povdoigt/SP-02/PMI/repport_FinalVersion/PMI_ET2_rapport.tex

\documentclass{article}

\usepackage{graphicx}
\usepackage[a4paper, total={6.5in, 10in}, margin=2cm]{geometry}
\usepackage{tgpagella}
\usepackage[T1]{fontenc}
\usepackage[french]{babel}
\usepackage{hyphenat}
\usepackage{fancybox}
\usepackage{fancyhdr}
\usepackage{float}
\hyphenation{mate-mática recu-perar}
\usepackage{pifont}
\usepackage{tikz,tikz-3dplot}
\usepackage{listings}
\usepackage{etoolbox}
\usepackage{lmodern}
% \usepackage{array}
\usepackage[table]{xcolor}
\usepackage[utf8]{inputenc}
% \usepackage[dvipsnames]{xcolor}
\usepackage{transparent}
\usetikzlibrary{shapes.geometric}
\usetikzlibrary{shapes.symbols}
\usetikzlibrary{decorations.pathreplacing}
\usepackage{caption}
\usepackage{subcaption}
\usepackage{cprotect}
\usepackage{tabularx}
\usepackage{pdfpages}
\usepackage{lastpage}
\usepackage{titlesec}
\usepackage[colorlinks=true, linkcolor=black, citecolor=black]{hyperref}
\usepackage{dirtree}
\usepackage{wrapfig}
\usepackage{lipsum}
\usepackage{cancel}
\usepackage{chngcntr}
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
        {Ä}{{\"A}}1  {Ë}{{\"E}}1  {Ï}{{\"I}}1 {Ö}{{\"O}}1  {Ü}{{\"U}}1
        {â}{{\^a}}1  {ê}{{\^e}}1  {î}{{\^i}}1 {ô}{{\^o}}1  {û}{{\^u}}1
        {Â}{{\^A}}1  {Ê}{{\^E}}1  {Î}{{\^I}}1 {Ô}{{\^O}}1  {Û}{{\^U}}1
        {œ}{{\oe}}1  {Œ}{{\OE}}1  {æ}{{\ae}}1 {Æ}{{\AE}}1  {ß}{{\ss}}1
        {ç}{{\c c}}1 {Ç}{{\c C}}1 {ø}{{\o}}1  {Ø}{{\O}}1   {å}{{\r a}}1
        {Å}{{\r A}}1 {ã}{{\~a}}1  {õ}{{\~o}}1 {Ã}{{\~A}}1  {Õ}{{\~O}}1
        {ñ}{{\~n}}1  {Ñ}{{\~N}}1  {¿}{{?`}}1  {¡}{{!`}}1
        {°}{{\textdegree}}1 {º}{{\textordmasculine}}1 {ª}{{\textordfeminine}}1
        % {0}{{{\color{F}0}}}1
        % {1}{{{\color{F}1}}}1 {2}{{{\color{F}2}}}1 {3}{{{\color{F}3}}}1
        % {4}{{{\color{F}4}}}1 {5}{{{\color{F}5}}}1 {6}{{{\color{F}6}}}1
        % {7}{{{\color{F}7}}}1 {8}{{{\color{F}8}}}1 {9}{{{\color{F}9}}}1
        {=}{{{\color{A}$=$}}}1
        {==}{{{\color{A}$=\joinrel=$}}}1
        {<=}{{{\color{A}$\leq$}}}1
        {>=}{{{\color{A}$\geq$}}}1
        {!=}{{{\color{A}$\neq$}}}1
        {:=}{{{\color{A}:=}}}1
    }
}

\newtcbox{\mybox}[1][black]{
    on line, 
    arc=0pt, 
    outer arc=0pt, 
    colback=white,
    colframe=#1,
    boxsep=0pt, left=2pt, right=2pt, top=2pt, bottom=2pt, boxrule=2pt
}

% glossary
\makenoidxglossaries

\input{glossary.tex}

% \addbibresource{biblio.bib}

\titleclass{\subsubsubsection}{straight}[\subsection]

\newcounter{subsubsubsection}[subsubsection]
\renewcommand\thesubsubsubsection{\thesubsubsection.\arabic{subsubsubsection}}
\renewcommand\theparagraph{\thesubsubsubsection.\arabic{paragraph}} % optional; useful if paragraphs are to be numbered

\titleformat{\subsubsubsection}
  {\normalfont\normalsize\bfseries}{\thesubsubsubsection}{1em}{}
\titlespacing*{\subsubsubsection}
{0pt}{3.25ex plus 1ex minus .2ex}{1.5ex plus .2ex}

\title{
    \huge \textbf{ET2} : Perspective d'expérience d'un système de séparation d'étages de fusée par
    aérofreinage \\ \vspace{0.2cm}
    \large Projet \textbf{SP-02}, fusée bi-étage, AéroIPSA 2025-2026 \\
}

\makeatletter
\newcommand\footnoteref[1]{\protected@xdef\@thefnmark{\ref{#1}}\@footnotemark}
\def\toclevel@subsubsubsection{4}
\def\l@subsubsubsection{\@dottedtocline{4}{7em}{4em}}
\def\@maketitle{
    \begin{center}
    \begin{tabular}{>{\raggedright\arraybackslash}m{0.5\textwidth}
        >{\raggedleft\arraybackslash}m{0.5\textwidth}}
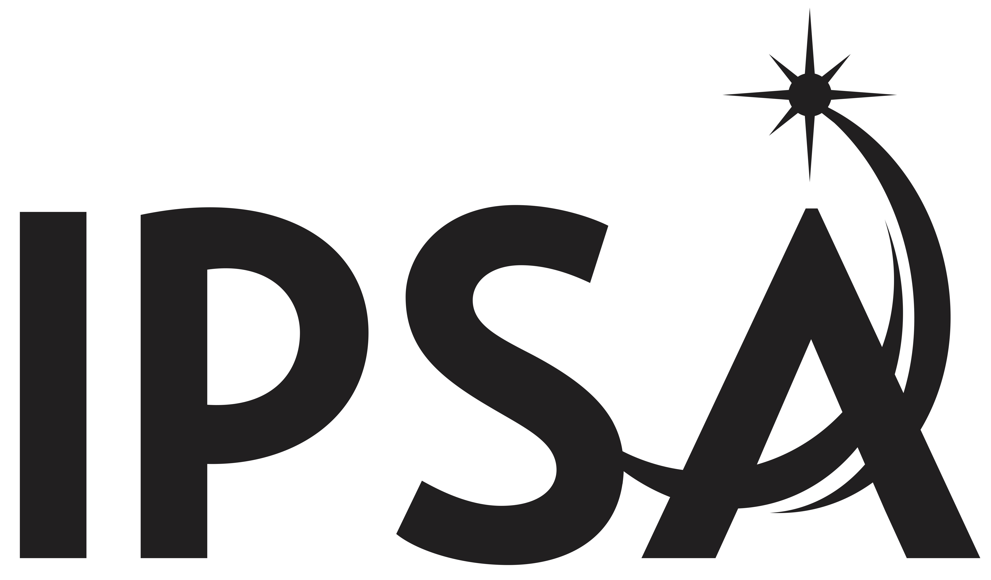
[picture p1: PMI/repport_FinalVersion/figures/IPSA_LOGO_SS-BASELINE-2021_NOIR.png]
        \vspace{-2cm} &
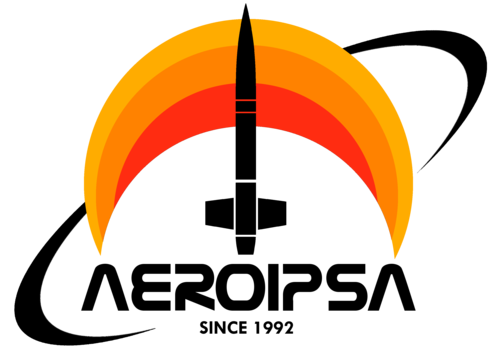
[picture p2: PMI/repport_FinalVersion/figures/AEROIPSA.png]
        \vspace{-2cm}
    \end{tabular}
    \begin{tabular}{m{0.6\textwidth}>{\raggedleft\arraybackslash}m{0.4\textwidth}}
        \acrlong{IPSA} & AéroIPSA \\
        63 bvd de Brandbourg & 63 bvd de Brandbourg \\
        94200 Ivry-sur-Seine & 94200 Ivry-sur-Seine
    \end{tabular}
    \end{center}
    \begin{flushright}
        {\rule{\larg}{1mm}}\\
        \vspace{3mm}
        \@title
        \vspace{2mm}
        {\rule{\larg}{1mm}}\\
    \end{flushright}
    \vspace{-2cm}
    \begin{figure}[h]
        \centering
        \rotatebox{-75}{
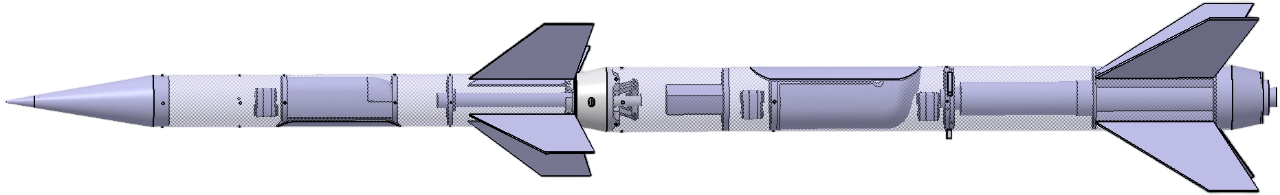
[picture p3: PMI/repport_FinalVersion/figures/catia_alpha_beta.png]
            
        }
        % \caption{Image to be placed on the title page}
    \end{figure}
    \vspace{-2.5cm}
    \begin{tabular}{>{\raggedright\arraybackslash}m{0.5\textwidth}
        >{\raggedleft\arraybackslash}m{0.5\textwidth}}
        Rédacteurs du document :        & \\
        % \hspace{1cm} - AMARANTI Malo    & \\
        \hspace{1cm} - PAILLARD Alexis  & \\
        \hspace{1cm} - PICHON Lucas     & \\
        \hspace{1cm} - LE CAM Maxens    & \\
        \hspace{1cm} - PEIX Guillaume   & \\
        Tuteur :                        & \\
        \hspace{1cm} - ABASSI Wafik     & Janvier 2025 \\
        \hline
    \end{tabular}
}
\makeatother

\setcounter{secnumdepth}{4}
\setcounter{tocdepth}{4}

\counterwithin{figure}{section}
\AtBeginDocument{\numberwithin{lstlisting}{section}}

\pagenumbering{gobble}

\begin{document}

\pagestyle{fancy}
\pagenumbering{arabic}
\fancyhf{} % sets both header and footer to nothing
\renewcommand{\headrulewidth}{0pt} % removes horizontal line
\renewcommand{\sectionmark}[1]{\markright{#1}}
\renewcommand{\subsectionmark}[1]{}
% \fancyhead[R]{\vspace{2cm}\rightmark}
% \fancyhead[R]{\vspace{2cm}\rightmark}
\fancyfoot[L]{\thepage/\pageref{LastPage}} 

%Header and footer images
\AddToShipoutPictureBG{%
  \AtPageUpperLeft{%
    \makebox(\paperwidth,0)[lt]{}%
  }
  \AtPageLowerLeft{%
    \makebox(\paperwidth,0)[rb]{}%
  }%
}

\maketitle
\thispagestyle{empty}

\newpage

\

\newpage

\input{sections/remerciement.tex}

\newpage
\tableofcontents
\newpage

\input{sections/synthese.tex}
\input{sections/Introduction.tex}
\input{sections/1_Contexte/main.tex}
\input{sections/2_Conception/main.tex}
\input{sections/3_Methode/main.tex}
\input{sections/4_Resultas/main.tex}
\input{sections/5_Realisation/main.tex}
\input{sections/Conclusion.tex}
\input{sections/resume.tex}

\newpage

\addcontentsline{toc}{section}{\protect\numberline{}Liste des figures}
\listoffigures

\addcontentsline{toc}{section}{\protect\numberline{}Liste des tableaux}
\listoftables

\newpage

\addcontentsline{toc}{section}{\protect\numberline{}Références}
\bibliographystyle{ieeetr}
\bibliography{biblio}

\newpage

\addcontentsline{toc}{section}{\protect\numberline{}Glossaires et acronymes}
\setglossarystyle{listgroup}
\printnoidxglossaries

\newpage

\appendix
\input{sections/annexe.tex}

\newpage

\end{document}
