povdoigt/SP-02/RAPPORT/DOSSIER SUIVI/sections/annexe.tex

\includepdf[page=-, angle=90, scale=2, offset=0 -100, pagecommand={
    \section{Synoptique de l'ensemble de la fusée}
    \label{subsec:synoptique_fusee}
    \subsection{Deuxième étage}
}]{figures/annexe/SP02_2_STAGE_2.drawio.pdf}

\includepdf[page=-, angle=90, scale=2, offset=0 -20, pagecommand={
    \subsection{Premier étage}
}]{figures/annexe/SP02_2_STAGE_1.drawio.pdf}

\includepdf[page=1, angle=90, scale=.75, offset=0 -20, pagecommand={
    \section{Plan mécaniques}
    \label{subsec:plan_aerofreins}
    \subsection{Plan mécanique de l'ensemble aérofreins}
}]{figures/annexe/MECA/SP02_ALPHA_AF_BLOC_DRAW.pdf}
\includepdf[page=2-, angle=90, scale=.85, pagecommand={}]{figures/annexe/MECA/SP02_ALPHA_AF_BLOC_DRAW.pdf}

\includepdf[page=1, angle=90, scale=.75, offset=0 -20, pagecommand={
    \subsection{Plan mécanique de la séparation inter-étage}
    \label{subsec:plan_separation}
    \subsubsection{Deuxième étage}
}]{figures/annexe/MECA/Beta_sepa_principale.pdf}
\includepdf[page=2-, angle=90, scale=.85, pagecommand={}]{figures/annexe/MECA/Beta_sepa_principale.pdf}

\includepdf[page=-, angle=90, scale=.75, offset=0 -20, pagecommand={
    \subsection{Plan mécanique du crochet de trappe}
    \label{subsec:plan_crochet_trappe}
}]{figures/annexe/MECA/Beta_crochet_trappe.pdf}

\includepdf[page=-, angle=180, scale=.75, offset=0 -20, pagecommand={
    \subsection{Plan mécanique du système de maintien de la pointe de coiffe}
    \label{subsec:plan_maintien_pointe_coiffe}
}]{figures/annexe/MECA/Beta_maintien_pointe_coiffe.pdf}

\includepdf[page=-, angle=90, scale=.75, offset=0 -20, pagecommand={
    \subsection{Plan mécanique de la pointe de coiffe}
    \label{subsec:plan_pointe_coiffe}
}]{figures/annexe/MECA/Beta_pointe_coiffe.pdf}

\includepdf[page=1, angle=90, scale=.8, offset=0 -10, pagecommand={
    \section{Schématiques électriques}
    \label{subsec:schema_elecs}
}]{figures/annexe/ELEC/Schematic_APEX_LE_RETOUR_2026-03-23.pdf}
\includepdf[page=2-, angle=90, scale=.85, pagecommand={}]{figures/annexe/ELEC/Schematic_APEX_LE_RETOUR_2026-03-23.pdf}
\includepdf[page=-, angle=90, scale=.85, pagecommand={}]{figures/annexe/ELEC/Schematic_SP02_APEX_EX_2026-03-23.pdf}
\includepdf[page=-, angle=90, scale=.85, pagecommand={}]{figures/annexe/ELEC/Schematic_SP02_PITOT_2026-03-23.pdf}
\includepdf[page=-, angle=90, scale=.85, pagecommand={}]{figures/annexe/ELEC/Schematic_SP02_CAMERA_2026-03-23.pdf}
\includepdf[page=-, angle=90, scale=.85, pagecommand={}]{figures/annexe/ELEC/Schematic_SP02_sequenceur_Maxou_2026-03-23.pdf}
\includepdf[page=-, angle=90, scale=.85, pagecommand={}]{figures/annexe/ELEC/Schematic_SP02_IHM_2_2026-03-23.pdf}
\includepdf[page=-, angle=90, scale=.85, pagecommand={}]{figures/annexe/ELEC/Schematic_SP02_Allumage_4_main_2026-04-27.pdf}
\includepdf[page=-, angle=90, scale=.85, pagecommand={}]{figures/annexe/ELEC/Schematic_SP02_Allumage_2_Condo_2026-03-23.pdf}
\includepdf[page=-, angle=90, scale=.85, pagecommand={}]{figures/annexe/ELEC/Schematic_SP02_CONNECTION_SEPA_2026-03-23.pdf}
\includepdf[page=-, angle=90, scale=.85, pagecommand={}]{figures/annexe/ELEC/Schematic_SP02_ROUTEUR_2026-03-23.pdf}
