povdoigt/SP-02/PMI/repport_FinalVersion/sections/2_Conception/3_Electroniques.tex

\subsection{Système de séquencement et de commandes électroniques}

\subsubsection{Choix des actionneurs}

Les fonctions de commande liées au déploiement des aérofreins et à l’actionnement des mécanismes du lanceur SP-02 reposent sur
l’utilisation de servomoteurs. Le choix de ces actionneurs conditionne directement l’architecture d’alimentation, la précision
de commande et la robustesse globale du système.\\

\begin{minipage}{0.3\textwidth}
    \centering
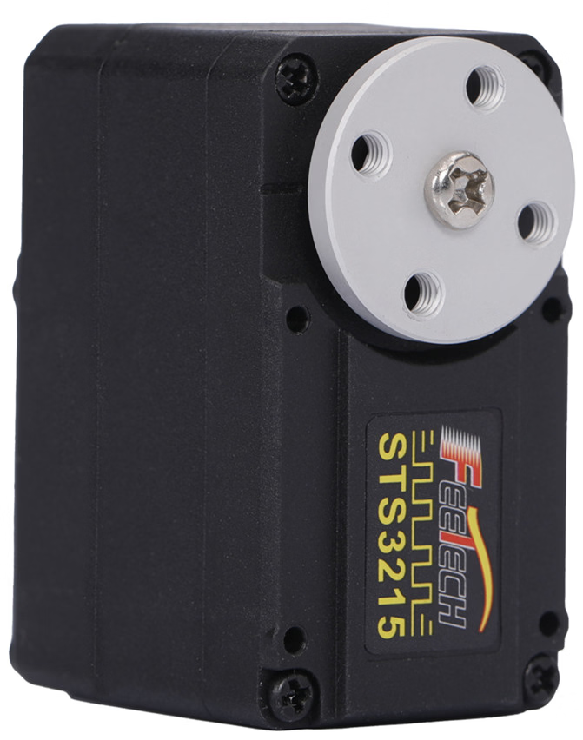
[picture p4: PMI/repport_FinalVersion/figures/Sts3215.png]
    
    \captionof{figure}{Servomoteur STS3215}
    \label{fig:sts3215}
\end{minipage}
\hfill
\begin{minipage}{0.65\textwidth}
    Les servomoteurs STS3215 ont été retenus comme un compromis adapté aux besoins du projet en termes de coût, de couple
    disponible et de capacités de contrôle. Leur couple maximal de 19,5 kg.cm offre une marge confortable vis-à-vis des efforts
    attendus, tout en autorisant différents modes de fonctionnement.\\

    Les STS3215 intègrent une électronique de commande avancée incluant des capteurs internes de tension, de courant et de
    température, permettant la surveillance de leur état de fonctionnement et l’estimation indirecte du couple fourni et donc
    également du couple résistant. Cette fonctionnalité permet notamment de détecter les blocage. Par exemple, pour le cas des
    aérofreins, la détection d'un blocage lors de l'initialisation de la fusée permettrait de détecter la plage de déploiement
    minimal et maximal des aérofreins et donc d'étalonner le système.\\

    La communication s’effectue via une interface numérique de type Half-\acrshort{UART} \footnotemark basée sur
    des registres internes, les servomoteurs étant adressables et pouvant ainsi être chaînés sur une même ligne de communication.
\end{minipage}

\vspace{0.5cm}

Enfin, ces servomoteurs proposent plusieurs modes de fonctionnement, notamment un mode de contrôle en position basé sur un
encodeur magnétique multi-tours offrant une précision inférieure au degré, ainsi qu’un mode de contrôle en vitesse permettant
un fonctionnement en rotation continue. Cette polyvalence en fait une solution particulièrement adaptée aux exigences du projet.

\footnotetext{Le Half-\acrshort{UART} est une interface série asynchrone utilisant une seule ligne de données pour la
transmission et la réception de données.}

\subsubsection{Séquenceurs}

Les deux étages de la fusée SP-02 sont chacun équipés d’un séquenceur embarqué identique, développé pour gérer de manière
autonome l’ensemble des événements critiques du vol et assurer la conformité au \acrshort{CDC}\cite{CDC_BiEtage}. Cette
architecture commune facilite la fabrication, les essais et la maintenance, tout en permettant une configuration logicielle
propre à chaque étage.\\

\begin{minipage}{0.45\textwidth}
    Chaque séquenceur assure notamment :
    \begin{itemize}
        \item la détection du décollage via la coupure de la boucle \textit{jack} ;
        \item le démarrage du chronomètre interne servant de référence aux fenêtres temporelles ;
        \item le pilotage du système de récupération (parachute, trappe) ;
        \item la supervision de la séparation inter-étage et l’inhibition des actions en cas d’anomalie.
    \end{itemize}

    Le séquenceurs du première étage devra en plus se charger :
    \begin{itemize}
        \item du pilotage du système d'aérofreins ;
        \item du déverrouillage du mécanisme de séparation ;
    \end{itemize}

    Le séquenceur du second étage devra quant à lui gérer :
    \begin{itemize}
        \item de la détection de l'attitude de la fusée ;
        \item de l'allumage du moteur du second étage.
    \end{itemize}
\end{minipage}
\hfill
\begin{minipage}{0.5\textwidth}
    \centering
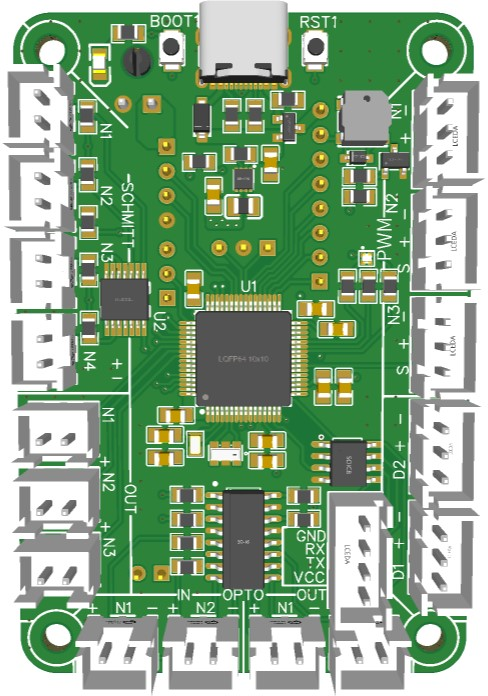
[picture p5: PMI/repport_FinalVersion/figures/sequenceur_easyeda.jpg]
    
    \captionof{figure}{Prototype de séquenceur embarqué}
    \label{fig:sequenceur_photo}
\end{minipage}

\newpage

\subsubsubsection{Architecture matérielle}

Les séquenceurs s’appuient sur une carte électronique dédiée intégrant un microcontrôleur STM32F072R8T6, choisi pour sa
robustesse, sa faible consommation et la variété de ses interfaces (UART, timers, GPIO). \\

La carte intègre :
\begin{itemize}
    \item un régulateur abaisseur 3,3~V (TPS62172) alimentant l’ensemble de la logique~;
    \item une liaison UART dédiée à la centrale inertielle WT901B ;
    \item une ligne half-duplex pour le pilotage des servomoteurs Feetech\footnote{La communication est réalisée sur une ligne
    \textit{DATA} unique, protégée par buffers SN74LVC1G125/126 pour la commutation TX/RX. Trois sorties PWM restent
    disponibles en cas d’utilisation de servomoteurs classiques.} ;
    \item plusieurs sorties logiques optocouplées destinées aux déclenchements sécurisés (caméras, cartes expériences) ;
    \item une entrée isolée assurant la détection du décollage via la boucle \textit{jack} ;
    \item un connecteur dédié à la carte IHM (commande d’alimentation, armement, indicateurs RGB) ;
    \item six entrées conditionnées par portes à hystérésis de type \textit{Schmitt trigger}, utilisées pour la détection
    d’événements discrets tels que décollage, séparation et signaux de capteurs mécaniques.
\end{itemize}

\subsubsubsection*{Choix du microcontrôleur}
Le STM32F072R8T6 a été sélectionné pour ses caractéristiques techniques adaptées aux exigences du projet :
\begin{itemize}
    \item architecture ARM Cortex-M0 32 bits, offrant une puissance de calcul suffisante pour la gestion des séquences et
    le traitement des données inertielle ;
    \item faible consommation énergétique, essentielle pour les opérations prolongées en vol ;
    \item large gamme d’interfaces de communication (UART, SPI, I2C, GPIO), facilitant l’intégration avec les capteurs et
    actionneurs embarqués ;
    \item 64~kB de mémoire flash et 16~kB de RAM, permettant le stockage du firmware et des données critiques. \\
\end{itemize}

Aussi, ayant déjà travaillé avec cette famille de microcontrôleurs sur des projets antérieurs, l’équipe dispose d’une expertise
solide pour le développement et le débogage du firmware.

\subsubsubsection*{Portes à hystérésis}
Les portes à hystérésis permettent de stabiliser les signaux provenant des capteurs sujets aux rebonds ou aux perturbations
(vibrations, variations rapides de tension). Elles assurent également la mise en forme des signaux transmis d’un étage à
l’autre, notamment via les connecteurs intégrés dans le mécanisme de séparation.

\subsubsubsection*{Boucles électriques inter-étages}
Chaque étage intègre une boucle électrique traversant physiquement l’autre étage. Lors de la séparation mécanique, ces deux
boucles sont automatiquement rompues, fournissant une confirmation physique et indépendante de la séparation. L’état de ces
boucles est traité par des portes à hystérésis, garantissant une détection franche et insensible aux vibrations ou aux
micro-perturbations rencontrées durant le vol.

\subsubsubsection*{Double circuit de détection de décollage}
Les deux séquenceurs sont connectés au même connecteur \textit{jack} 4-pins de décollage, mais sur deux circuits indépendants,
afin d’assurer une synchronisation parfaite tout en préservant l’isolation électrique entre étages. Ce choix permet de limiter
les risques de défaillance croisée et garantit que les deux chronomètres internes démarrent à $t=0$ exactement au même instant.

\newpage

\subsubsubsection{Principes de fonctionnement}

Le fonctionnement repose sur une succession d’états décrits dans le logigramme de chaque séquenceur, cadencés par un
chronomètre démarré au décollage.

\begin{figure}[h!]
    \centering
    \begin{subfigure}{0.48\linewidth}
        \centering
        
        \caption{1er étage}
    \end{subfigure}
    \begin{subfigure}{0.48\linewidth}
        \centering
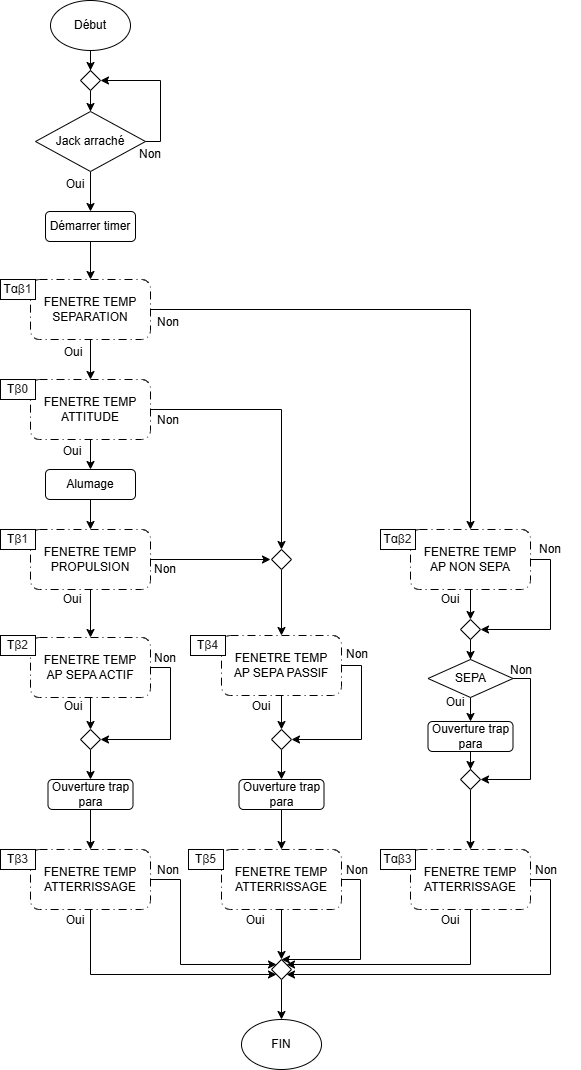
[picture p6: PMI/repport/figures/Sequenceur2.drawio.png]
        
        \caption{2e étage}
    \end{subfigure}
    \caption{Schémas fonctionnels des séquenceurs des deux étages}
\end{figure}

Une grande partie des événements critiques sont mesurés en utilisant une technique de fenêtrage temporelle. Chaque événement
est associé à une fenêtre temporelle définie par deux bornes ($T_{min}$, $T_{max}$). Si l’événement attendu n’est pas détecté
avant la fin de la fenêtre alors une procédure différente de celle nominale sera emprunter. Par exemple, si la séparation
inter-étage n’est pas détectée avant $T_{\alpha\beta1_{max}}$, le séquenceur du second étage n’allumera pas son moteur.\\

Voici les principaux évènements surveillés et partagés par les deux séquenceurs :
\begin{itemize}
    \item $T_0$ : instant du décollage ;
    \item $T_{\alpha\beta0}$ : fin de la propulsion du premier étage ;
    \item $T_{\alpha\beta1}$ : séparation inter-étage ;
    \item $T_{\alpha\beta2}$ : apogée de l'ensemble du lanceur sans séparation ;
    \item $T_{\alpha\beta3}$ : atterrissage de l'ensemble du lanceur sans séparation.\\
\end{itemize}

Voici les principaux évènements surveillés par le séquenceur du premier étage :
\begin{itemize}
    \item $T_{\alpha0}$ : apogée du premier étage seul si séparation ;
    \item $T_{\alpha1}$ : atterrissage du premier étage seul si séparation.\\
\end{itemize}

Voici les principaux évènements surveillés par le séquenceur du second étage :
\begin{itemize}
    \item $T_{\beta0}$ : allumage du moteur du second étage si séparation ;
    \item $T_{\beta1}$ : date de mesure de la confirmation d’allumage du moteur du second étage ;
    \item $T_{\beta2}$ : apogée du second étage seul si séparation et allumage confirmé ;
    \item $T_{\beta3}$ : atterrissage du second étage seul si séparation et allumage confirmé ;
    \item $T_{\beta4}$ : apogée du second étage seul si séparation et allumage non confirmé ;
    \item $T_{\beta5}$ : atterrissage du second étage seul si séparation et allumage non confirmé.\\
\end{itemize}

\subsubsubsection{Robustesse du système et immunité aux perturbations}

Les entrées critiques sont isolées et conditionnées (optocoupleurs, portes à hystérésis), garantissant la stabilité des signaux
malgré les vibrations, les parasites haute fréquence et les variations rapides de tension.

Les masses numérique, analogique et puissance sont séparées, et les sorties critiques isolées empêchent tout retour de
perturbation vers le microcontrôleur. Cette architecture assure une excellente fiabilité des déclenchements durant les phases
de propulsion, de séparation et de récupération.

\subsubsubsection{Conception PCB}

La conception du PCB suit une méthodologie stricte destinée à minimiser les effets EMI : séparation des plans de masse numérique
et de puissance, retour de courant maîtrisé, longueurs de pistes critiques réduites, boucles de masse minimisées, et isolements
renforcés autour des signaux sensibles. Les composants de commutation (buffers, optocoupleurs, transistors) sont positionnés de
manière à réduire les couplages parasites et à garantir une immunité maximale.

\newpage
