povdoigt/SP-02/RAPPORT/DOSSIER SUIVI/sections/ch4_meca/subsec3_premier_etage.tex

\subsection{Structure du premier étage}
\label{subsec:premier_etage}

\subsubsection{Flèche}
\label{subsubsec:premier_etage}
À la suite de la conception, nous avons pu réaliser les tubes de la structure porteuse de la fusée. Nous avons procédé à un test
de flèche sur les tubes afin de nous assurer de la bonne tenue mécanique de ces derniers. Pour le tube du premier étage, nous
avons encastré le tube comme si tenu par le propulseur et réalisé les tests comme au \gls{C'Space}.\\

Afin de déterminer la force à appliquer à un mètre, on calcule le couple créé par le poids de la fusée au niveau de la base de
l’étage inférieur.

\begin{figure}[h!]
    \centering
    \begin{tikzpicture}
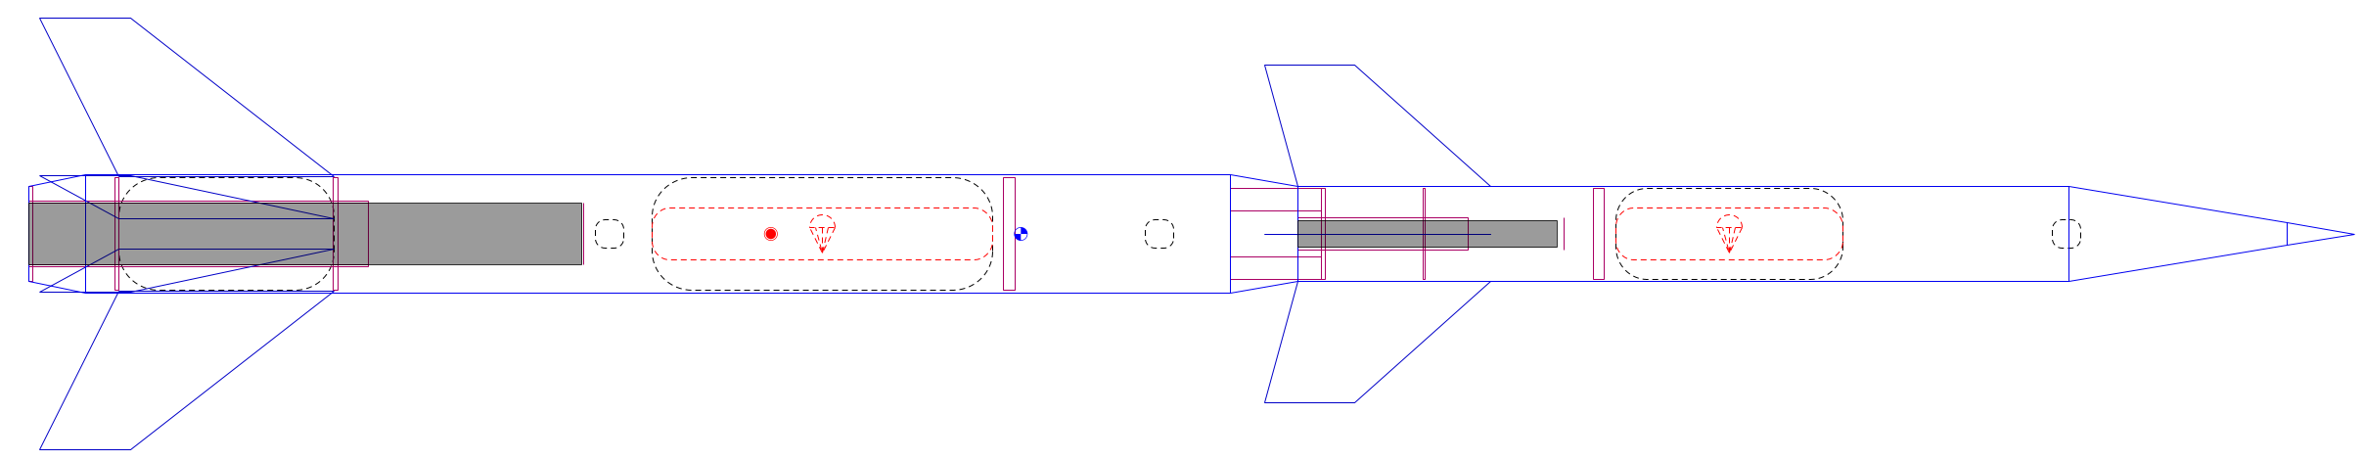
[picture p7: RAPPORT/DOSSIER SUIVI/figures/SP_ork_malo.png]
        \node at (0,0) {};

        \node (y_lbl)  at (-6.95, +0.500) {\textbf{y}};
        \node (x_lbl)  at (-6.70, -0.205) {\textbf{x}};
        \node (Cz_fbl) at (-6.60, +0.250) {\textbf{$C_z$}};
        \node (P_lbl)  at (-0.85, +1.000) {\textbf{P}};
        \node (F_lbl)  at (+6.00, +1.000) {\textbf{F}};

        \draw[red, <-, line width=1] (-7.200, +0.5) -- (-7.200, +0.0);
        \draw[red, <-, line width=1] (x_lbl.north)  -- (-7.200, +0.0);
        \draw[red, ->, line width=1] (+5.800, +1.0) -- (+5.800, +0.3);
        \draw[red, ->, line width=1] (-1.080, +1.0) -- (-1.080, +0.3);
        \draw[red, ->] (-6.7, 0) arc (0:90:.5cm);
        \draw [<->, > = stealth, black] (-7.2, -0.75) -- (-1.080, -0.75) node [midway, fill = white] {0,880m} ;
        \draw [<->, > = stealth, black] (-7.2, -1.25) -- (+5.800, -1.25) node [midway, fill = white] {1,800m} ;
    \end{tikzpicture}
    \caption{Schéma de calcul du couple exercé au niveau de la base du premier étage}
    \label{fig:placeholder}
\end{figure}

\begin{align*}
    P &= 9,81 \times 7,327 = 71,878\ N \\
    F &= 9,81 \times 0,8 = 7,848\ N\\
    \\
    C_Z &= 0,880 \times  (- P) + 1,800 \times (- F) \\
    &= 0,880 \times (- 71,878) + 1,800 \times (-7,848) \\
    &= -77,379\ N\cdotp m
\end{align*}
On a donc un couple de $-77,379\ N\cdotp m$, ce qui équivaut a :
$$\frac{|-77,379|}{9,81} = m_{test} \approx 7,888\ kg$$
$m_{test}$ étant la valeur de la masse à appliqués à un mètre du point d'encastrement pour reproduire le même couple.
Notre estimation de masse étant approximative, nous avons décidé d’arrondir la charge $m_{test}$ à $10\ kg$.

\begin{table}[h!]
    \centering
    \begin{tabular}{|c|c|c|}
        \hline
        Positionnement & Flèche statique & Flèche dynamique \\ \hline
        Patins à 0° & 0mm & 1mm \\ \hline
        Patins à 90° & 0mm & 1,5mm \\ \hline
        Patins à 180° & 0mm & 1mm \\ \hline
        Patins à 270° & 0mm & 2mm \\ \hline
        \end{tabular}
    \caption{Résultats des tests de flèche du tube du premier étage}
\end{table}

Les résultats montrent une flèche maximale de 0 mm en statique et 2 mm en dynamique pour une longueur de 1 m de tube. Cela 
correspond à une flèche relative de 0 \% en statique et 0,2 \% en dynamique, ce qui est largement en dessous de la limite de
1 \% imposée par le \gls{CDC} \cite[p.~32]{CDC_BiEtage}

\newpage

\subsubsection{Fabrication et collage du bloc propulsion avec ailerons}
Le bloc propulsion de SP-02 reprend la même architecture générale que celle définie pour SP-01, à savoir quatre ailerons en
fibre de verre fixés sur un tube porte-moteur intégré dans le fuselage. Le rétreint arrière est de nouveau utilisé pour
optimiser la réduction de traînée, mais le système de maintien du propulseur évolue : la vis latérale utilisée sur SP-01 est
remplacée par une bague filetée venant se visser à l’arrière du tube porte-moteur, assurant un appui axial direct sur le
propulseur. Cette modification permet de conserver la même géométrie extérieure tout en simplifiant la transmission des efforts
axiaux et en maintenant la compatibilité avec le format moteur retenu.\\

\begin{figure}[h!]
    \centering
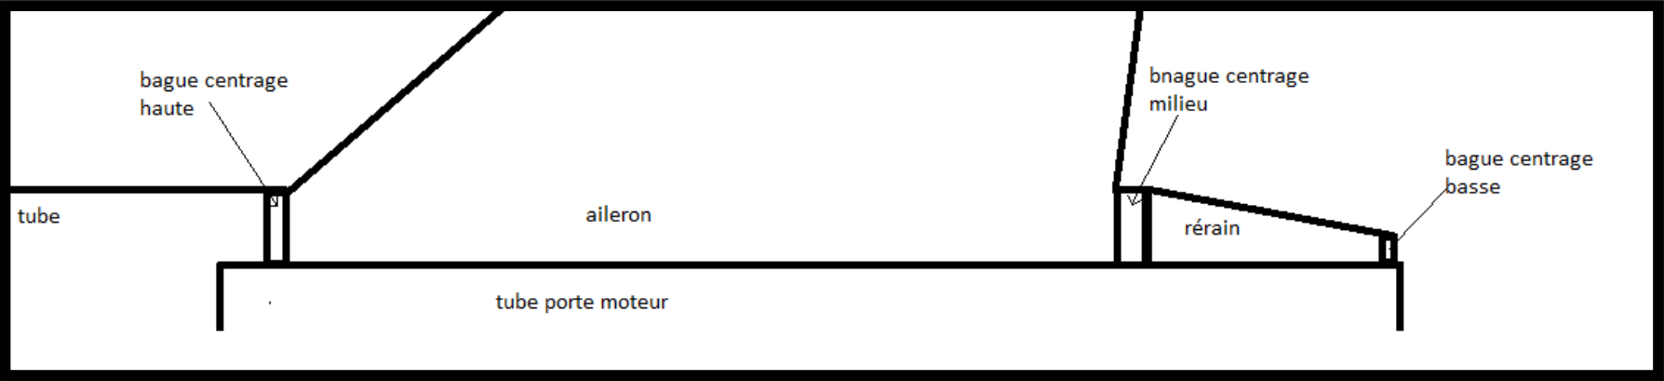
[picture p8: RAPPORT/DOSSIER SUIVI/figures/schema1_SP-01.PNG]
    
    \caption{Procédé de collage ailerons/tube porte-moteur}
    \label{fig:collage_aileronsSP01}
\end{figure}

Le tube porte-moteur de SP-02, déjà fabriqué, reprend exactement le même principe de géométrie et de construction que celui
utilisé pour SP-01. Réalisé à partir d’un moulage sur casing Pro-54, il possède un diamètre identique au standard attendu et
conserve une longueur réduite par rapport au casing d’origine afin d’optimiser la masse tout en maintenant une rigidité
suffisante pour supporter l’ensemble du bloc propulsion. Les ailerons seront ensuite collés à la résine époxy sur ce tube déjà
réalisé, ainsi que sur les deux bagues de centrage, de manière à reproduire fidèlement la configuration mécanique utilisée
précédemment et à assurer une continuité dans l’intégration structurelle du bloc propulsion.\\

\begin{figure}[h!]
    \centering
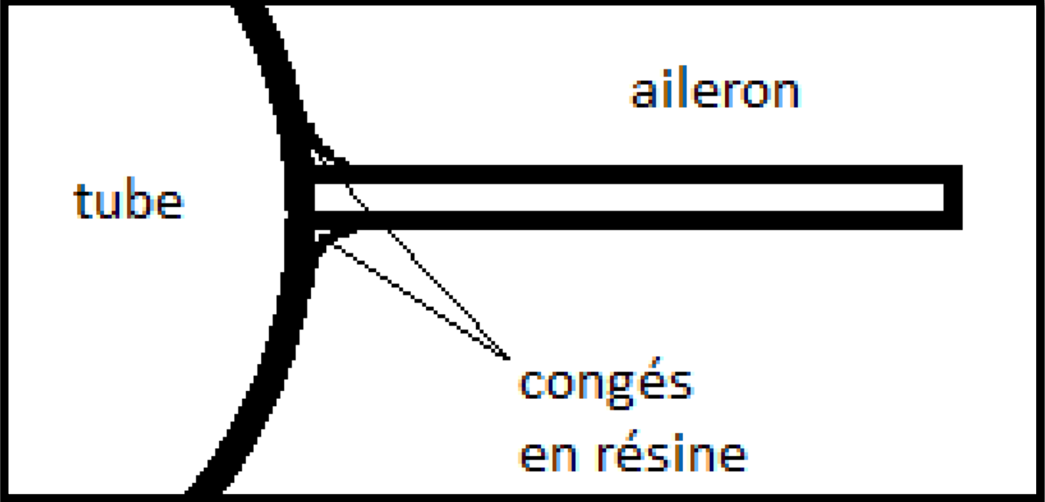
[picture p9: RAPPORT/DOSSIER SUIVI/figures/schema3_SP-01.PNG]
    
    \caption{Procédé de collage ailerons/structure avec congés en résine}
    \label{fig:collage2_aileronsSP01}
\end{figure}

Enfin, SP-02 reprend également la logique de finition appliquée sur SP-01 : des perçages seront réalisés en amont et en aval
des ailerons afin de garantir une diffusion homogène de la résine dans la zone d’assemblage, et des congés en résine seront
appliqués sur les jonctions extérieures pour assurer une transition aérodynamique lisse. Cette étape permet également de fermer
proprement les points d’injection tout en assurant une finition aérodynamique cohérente avec le modèle précédent.\\

\newpage

\subsubsection{Maintien du Pro54}
À la suite de discussions en \acrshort{RCE}-1 et \acrshort{RCE}-2, nous avions conçu deux méthodes de fixation pour le Pro54 pour laisser le choix
aux pyrotechniciens selon leur préférence (dépendamment de la rampe utilisée pour le lancement):
\begin{itemize}
    \item Une bague se vissant autour du propulseur (pas de vis 62mm) avec un serrage à la main (et clé si nécessaire) -- et
    visible en bleu sur l'image,
    \item Deux loquets à tourner à la main pour le maintien du propulseur -- visibles en rouge sur l'image.\\
\end{itemize}

Pour des raisons de faisabilité et de robustesse, nous avons opté pour la seconde méthode -- les deux loquets -- facilitant 
l'opérabilité du système. En effet, cette dernière ne nécessite pas de devoir tenir une pièce devant la tuyère du propulseur, mais 
également toutes les pièces du système sont déjà en position sur la structure de l'étage, et sont plus simples à usiner.
Les deux loquets devront être vissés si utilisés, mais ne requièrent pas de changement de pièce dans l'assemblage.
\begin{figure}[H]
    \centering
    \begin{subfigure}{0.38\textwidth} % Réduire légèrement pour éviter le débordement
        \centering
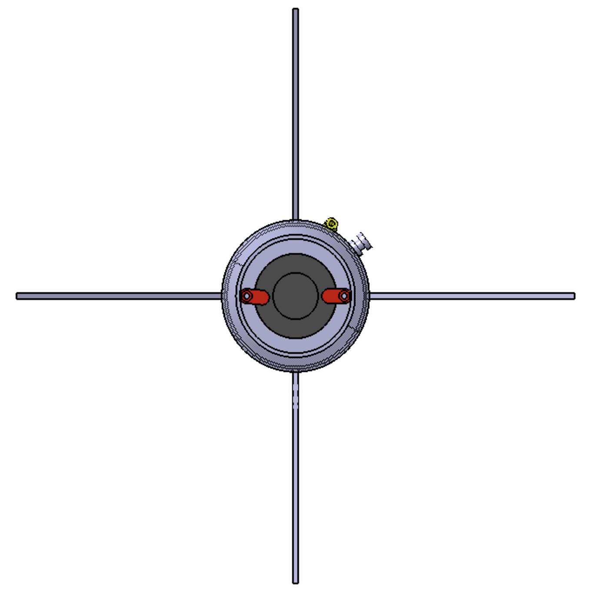
[picture p10: RAPPORT/DOSSIER SUIVI/figures/maintien3_pro54.png]
        
        \caption{Vue de dessous} % Ajoute une légende si nécessaire
        \label{fig:maintien3}
    \end{subfigure}
    \begin{subfigure}{0.38\textwidth}
        \centering
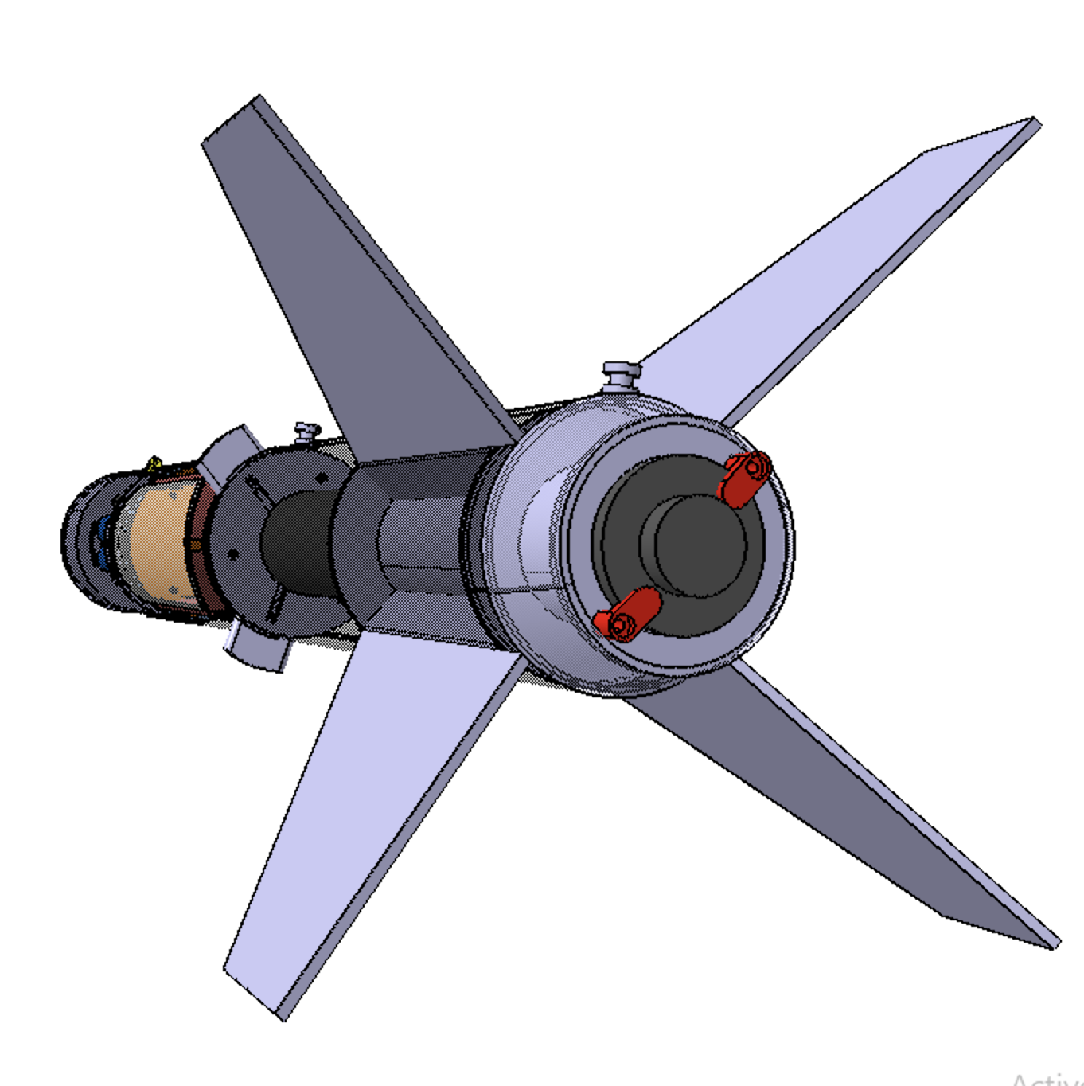
[picture p11: RAPPORT/DOSSIER SUIVI/figures/maintien4_pro54.png]
        
        \caption{Vue trimétrique} % Ajoute une légende si nécessaire
        \label{fig:maintien4}
    \end{subfigure}
    \caption{Méthodes de fixation du Pro54}
    \label{fig:fixation_pro54}
\end{figure}

\subsubsection{Aérofreins}
La place disponible dans le premier étage étant très limitée, nous avons opté pour un système d'aérofreins de type "plaque
déployable". Ce système est composé de deux bagues en aluminium 7075 de 7 mm d'épaisseur et du même diamètre que l'intérieur du
fuselage. Entre les deux plaques, un système de bielles permet de déployer les aérofreins à l'aide d'un servo-moteur.\\

\begin{minipage}{0.5\textwidth}
    \centering
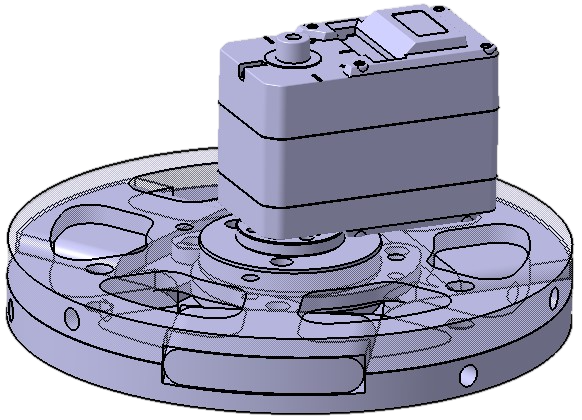
[picture p12: RAPPORT/DOSSIER SUIVI/figures/Catia_AF_1.png]
    
    \captionof{figure}{Système d'aérofrein d'SP-02 sur \acrshort{CATIA}}
    \label{fig:aerofrein_SP02}
\end{minipage}
\hfill
\begin{minipage}{0.4\textwidth}
    Une vue du système d'aérofreins d'SP-02 est présentée à la figure \ref{fig:aerofrein_SP02}. Chaque bague est vissée au corps
    de la fusée par 4 vis M4, soit 8 vis M4 pour le système complet tout, réparties uniformément. Les deux bagues sont vissées
    entre elles par 3 vis M5. Cela permet de maximiser la rigidité du système et de transmettre les efforts aérodynamiques à la
    structure principale de la fusée. Les aérofreins à proprement parler sont constitués de plaques en \gls{POMc} de 7 mm
    d'épaisseur fixés entre les deux bagues à l'intéreur de rainures usinées dans chaque bague.
\end{minipage}

\begin{minipage}{0.34\textwidth}
    La figure \ref{fig:aerofrein_SP02_ouvert_ferme} montre les deux positions possibles des aérofreins. Le déploiement se fait à
    l'aide d'un servo-moteur placé à l'intérieur du fuselage et relié aux plaques par des bièles. Une rotation de 120° des plaques
    permet de passer de la position fermée à la position ouverte.
\end{minipage}
\hfill
\begin{minipage}{0.65\textwidth}
    \begin{figure}[H]
        \centering
        \begin{subfigure}{.49\textwidth}
            \centering
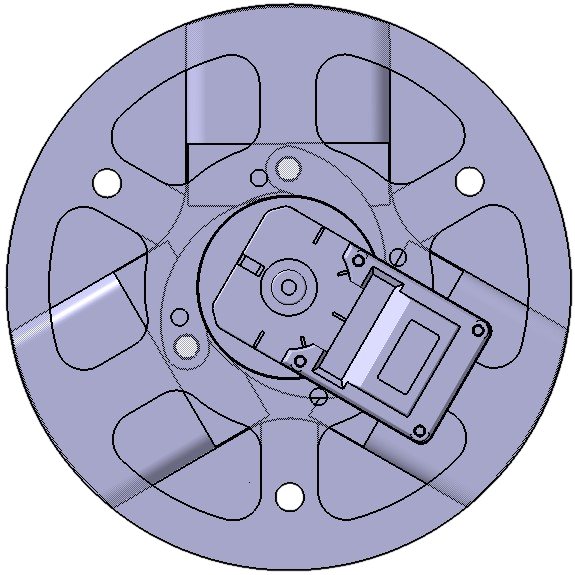
[picture p13: RAPPORT/DOSSIER SUIVI/figures/Catia_AF_2.png]
            
            \caption{fermé}
        \end{subfigure}
        \begin{subfigure}{.49\textwidth}
            \centering
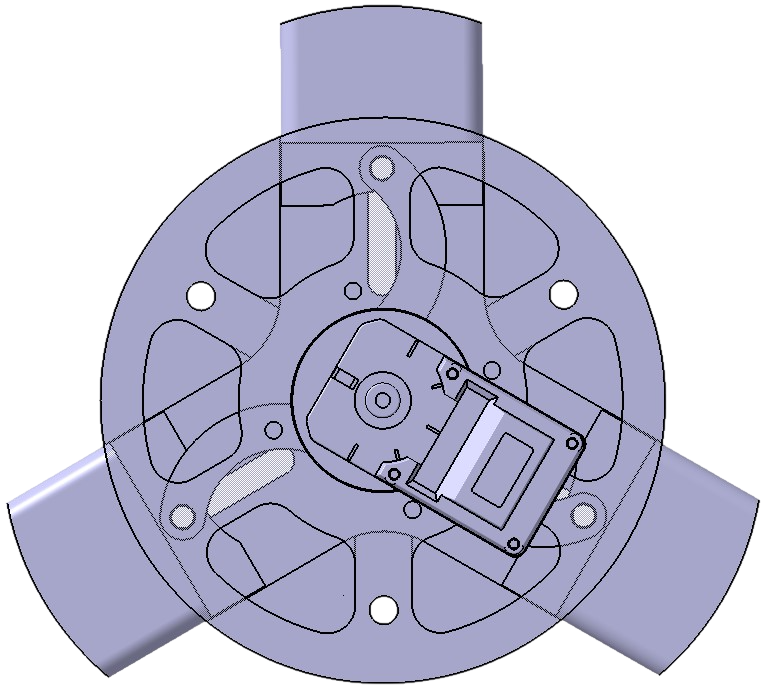
[picture p14: RAPPORT/DOSSIER SUIVI/figures/Catia_AF_3.png]
            
            \caption{ouvert}
        \end{subfigure}
        \caption{Position des aérofreins d'SP-02}
        \label{fig:aerofrein_SP02_ouvert_ferme}
    \end{figure}
\end{minipage}

\vfill

\begin{minipage}{0.55\textwidth}
    \centering
    \begin{tikzpicture}
        
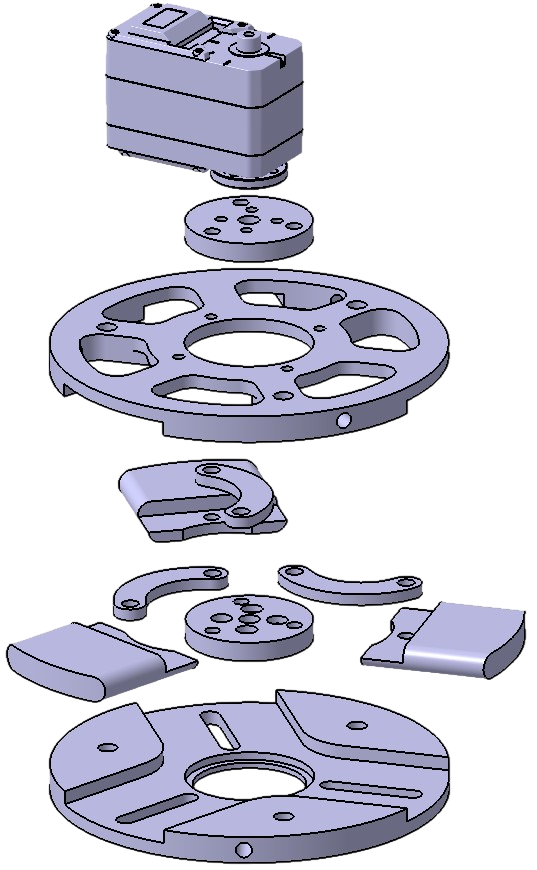
[picture p15: RAPPORT/DOSSIER SUIVI/figures/Catia_AF_4.png]
        \node at (0, 0) {};

        % \draw[help lines, step=1cm] (-3.5,-6) grid (6, 6);
        % \draw[help lines, step=0.5cm, lightgray] (-3.5,-6) grid (6, 6);
        % \draw[line width=2] (-3.5, +0.0) -- (+6.0, +0.0);
        % \draw[line width=2] (+0.0, -6.0) -- (+0.0, +6.0);

        \node (moteur_lbl)      at (+4.50, +4.50) {\textbf{Servo-moteur}};
        \node (rondelle1_lbl)   at (+4.50, +2.75) {\textbf{Rondelle 1}};
        \node (bague_haut_lbl)  at (+4.50, +1.75) {\textbf{Bague supérieure}};
        \node (rondelle2_lbl)   at (+4.50, +0.00) {\textbf{Rondelle 2}};
        \node (bielle_lbl)      at (+4.50, -1.00) {\textbf{Bielles (x3)}};
        \node (aerofrein_lbl)   at (+4.50, -2.00) {\textbf{Aérofreins (x3)}};
        \node (bague_bas_lbl)   at (+4.50, -4.00) {\textbf{Bague inférieure}};

        \draw [red, ->, line width=1.5] (moteur_lbl.west)     -- (-0.50, +4.50);
        \draw [red, ->, line width=1.5] (rondelle1_lbl.west)  -- (-0.25, +2.75);
        \draw [red, ->, line width=1.5] (bague_haut_lbl.west) -- (+1.50, +1.75);
        \draw [red, ->, line width=1.5] (rondelle2_lbl.west)  -- (+0.00, -1.50) -- (-0.25, -2.25);
        \draw [red, ->, line width=1.5] (bielle_lbl.west)     -- (+1.50, -2.00);
        \draw [red, ->, line width=1.5] (aerofrein_lbl.west)  -- (+2.50, -2.50);
        \draw [red, ->, line width=1.5] (bague_bas_lbl.west)  -- (+2.00, -4.00);

    \end{tikzpicture}
    \captionof{figure}{Vu éclatée du système d'aérofrein d'SP-02}
    \label{fig:aerofrein_SP02_eclate}
\end{minipage}
\hfill
\begin{minipage}{0.35\textwidth}
    La figure \ref{fig:aerofrein_SP02_eclate} présente une vue éclatée du système d'aérofrein. On y distingue les deux bagues
    en aluminium, les aérofreins en \gls{POMc}, les bielles de liaison en aluminium, les rondelles de maintien en \gls{POMc} et
    le servo-moteur. Le choix du matériau pour les aérofreins et les rondelles s'est porté sur le \gls{POMc} en raison de sa
    forte résistance mécanique, de sa facilité d'usinage et de son faible coefficient de frottement avec l'aluminium, ce qui
    réduit l'effort nécessaire pour le déploiement des aérofreins.\\

    La \acrshort{CAO} sur \acrshort{CATIA} nous indique une masse totale du système (servo-moteur inclus) de 360 g. Ce poids
    a été pris en compte dans la masse totale du premier étage tout comme dans le calcul de son centre de masse.\\
    
    La plus grande partie des pièces seront usinées au \gls{Skylab}. Seuls les aérofreins seront commandés à un fournisseur
    externe au vu de la complexité de leur forme nécessitant une fraiseuse 5 axes.
\end{minipage}

\vfill

\newpage

\subsubsection{Définition du système d'ouverture/parachute}
\label{subsec:defpara}

Dans l'objectif de récupération de chaque étage, nous devons définir et valider nos deux systèmes de sauvegarde des lanceurs.
Ceux-ci sont définis par des trappes latérales actionnées par un servomoteur chacun.\\

Le tableau suivant récapitule les règles du \acrshort{CDC} nous concernant (règles concernant les ralentisseurs pilotés non
présentes) et devant faire l'objet d'une validation technique.

\begin{table}[h!]
    \centering
    \begin{tabular}{|p{1.2cm}|p{4cm}|p{10cm}|}
        \hline
        Règles & Type & Détails du \acrshort{CDC} \\ \hline
        REC1  & Système récupération & Chaque étage doit être équipé d’un système ralentisseur fiable permettant de réduire sa vitesse de descente. L’éjection du/des ralentisseurs doit être franche. \\ \hline
        REC2  & Système récupération & Les systèmes ralentisseurs des étages et de tout autre élément éjecté doivent permettre une arrivée au sol à une vitesse verticale comprise entre 5 m/s et 15 m/s, y compris dans le cas dégradé où les deux étages ne se sont pas séparés. \\ \hline
        REC3  & Cohérence du système & Les instants de déploiement des systèmes ralentisseurs doivent être compatibles avec l’expérience menée par le club. \\ \hline
        REC4  & Séparation transversale & Non utilisé. \\ \hline
        REC5  & Séparation latérale & La case contenant le système de récupération doit rester opérationnelle lorsqu’elle supporte en compression longitudinale une force : $F = 2 \times \text{Accélération}{\text{Max}} \times M_{\text{sup}}$ (numériquement, l’accélération en m/s$^2$ et la masse en kg donnent $F$ en newtons). \\ \hline
        REC6  & Assemblage trappe & En position fermée, la porte latérale ne doit pas dépasser du profil de l’étage. \\ \hline
        REC7  & Tenue en torsion & La porte ne doit pas s’ouvrir ou se bloquer lorsqu’on applique un couple de torsion de 1 N·m entre le haut et le bas de l’étage. \\ \hline
        REC8  & Vibrations & L’accélération et les vibrations de la fusée ne doivent pas modifier le fonctionnement des systèmes de récupération. \\ \hline
        REC9  & Tenue mécanique globale & Les systèmes de récupération utilisés doivent auparavant avoir été testés avec succès. \\ \hline
        REC10 & Solidité du parachute & Les ralentisseurs doivent être suffisamment solides pour résister au choc à l’ouverture. \\ \hline
        REC11 & Anneau anti-torche & Dans le cas de l’utilisation d’un parachute, celui-ci doit être équipé d’un anneau anti-torche (également appelé glisseur). \\ \hline
    \end{tabular}
    \caption{Règles de dimensionnement des systèmes de récupération issues du \acrshort{CDC} \gls{Fusex} \cite[p.~36-42]{CDC_BiEtage}}
\end{table}

La contrainte imposée par le \acrshort{CDC} est une vitesse de redescente comprise entre 5 et 15m/s pour les trois
configurations (étage 1, étage 2 et non séparé). De par les dimensions des deux étages, le premier sera en charge du retour
sous parachute de l'ensemble non séparé.
\begin{equation}
\begin{aligned}
    V_d &= \sqrt{\frac{2 M g}{\rho_0 C_x S}} \
    %V_d &= \sqrt{\frac{2 \times 7.2 \times 9.81}{1.3 \times 1 \times 0.65}}
\end{aligned}
\end{equation}

Avec la règle REC2, nous devons dimensionner les deux parachutes pour les cas suivants :

\begin{table}[h!]
    \centering
    \begin{tabular}{|c|c|c|c|}
        \hline
        Cas d'étude & Pas de séparation & Étage 1 & Étage 2 \\ \hline
        Masse de l'ensemble & 7,327kg & 4,431kg & 2,895kg \\ \hline
        Dimensions du parachute utilisé & a=b=360mm & a=b=360mm & a=b=310mm \\ \hline
        Vitesse sous parachute & 13,1 m/s & 9,2 m/s & 10,7 m/s \\ \hline
    \end{tabular}
\end{table}

La forme des parachutes utilisés sera de type croix, avec a et b les valeurs d'un carré de la croix. De plus, l'ensemble du
parachute devra résister à l'ouverture.
\begin{equation}
\begin{aligned}
    F &= 2 \times Acc{max} \times K{safety} \times M_{sup} \\
    F &= 2 \times 9,7 \times 1,5 \times 3,055 \\
    F &= 88,90 N \\
\end{aligned}
\end{equation}

Le parachute sera fixé à la bague principale du bloc parachute dont cette dernière sera réalisée en aluminium 7075-T6 et fixée
au tube par 3 vis CBLX M5x12mm, qui, d'après nos tests, restent conformes à REC5. L'ensemble des règles REC6 à REC8 concernant la
bonne tenue de la trappe latérale seront confirmées de par la forme du réceptacle du parachute avec des rebords pour le bon
maintien de la trappe avec le tube ainsi que son usinage pour avoir aucun jeu lors du test en torsion. \\

L'utilisation d'un émérillon en acier inoxydable de diamètre 8mm permettra une tenue maximale en traction de 2943 N, pour être
conforme à REC10 et un anneau anti-torche pour confirmer REC11. Enfin, une batterie de tests (filmés) sera réalisée pour confirmer REC9.\\

Le système d’ouverture — une brique technologique déjà développée et validée sur SP-01 — se compose d’un servomoteur et d’un
crochet assurant le verrouillage de la trappe. En plaçant le servomoteur à la verticale, avec un axe de rotation aligné sur
l’axe de roulis de la fusée, on améliore son efficacité au décollage : il est moins sollicité en cas d’infiltration d’air dans
la trappe et lors de l’ouverture.

\begin{figure}[H]
    \centering
    \begin{subfigure}{0.26\textwidth} % Réduire légèrement pour éviter le débordement
        \centering
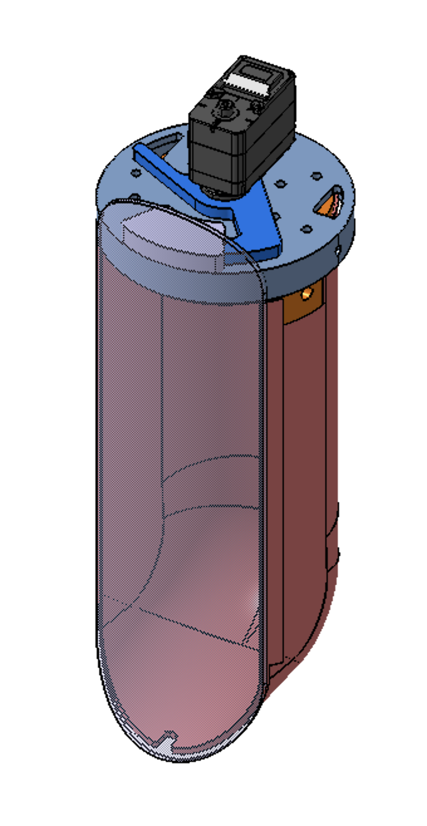
[picture p16: RAPPORT/DOSSIER SUIVI/figures/para_etage1-1.png]
        
        \caption{Position verrouillée}
        \label{fig:para_etage1-1}
    \end{subfigure}
    \begin{subfigure}{0.26\textwidth}
        \centering
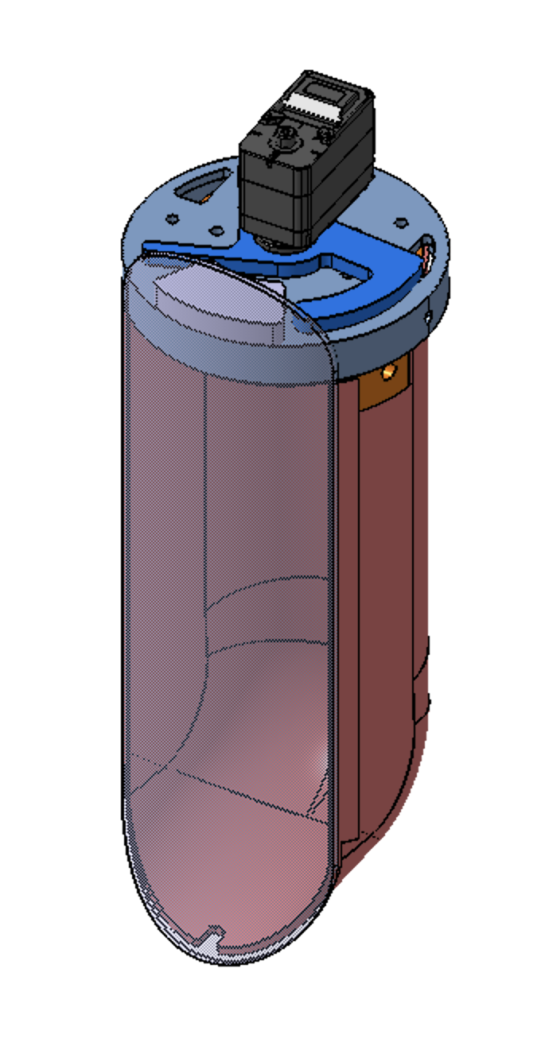
[picture p17: RAPPORT/DOSSIER SUIVI/figures/para_etage1-2.png]
        
        \caption{Servomoteur à mi-course}
        \label{fig:para_etage1-2}
    \end{subfigure}
    \begin{subfigure}{0.26\textwidth} % Réduire légèrement pour éviter le débordement
        \centering
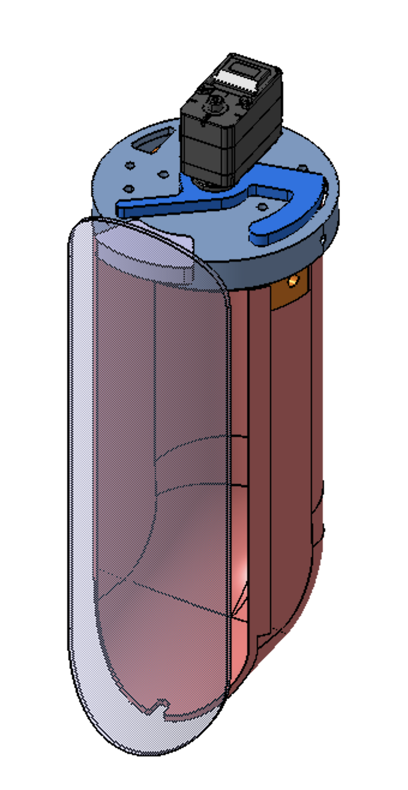
[picture p18: RAPPORT/DOSSIER SUIVI/figures/para_etage1-3.png]
        
        \caption{Position ouverte}
        \label{fig:para_etage1-3}
    \end{subfigure}
    \caption{Bloc parachute du premier étage sur \acrshort{CATIA}}
    \label{fig:para_etage1_SP02}
\end{figure}

\newpage
