povdoigt/SP-02/RAPPORT/DOSSIER SUIVI/sections/ch5_elec/subsec2_sequenceurs.tex

\subsection{Séquenceurs}

Les deux étages de la fusée SP-02 sont chacun équipés d’un séquenceur embarqué identique, développé pour gérer de manière
autonome l’ensemble des événements critiques du vol et assurer la conformité au \acrshort{CDC} Fusex. Cette architecture
commune facilite la fabrication, les essais et la maintenance, tout en permettant une configuration logicielle propre à chaque
étage.\\

\begin{figure}[h!]
    \centering
    \begin{subfigure}{0.45\textwidth}
        \centering
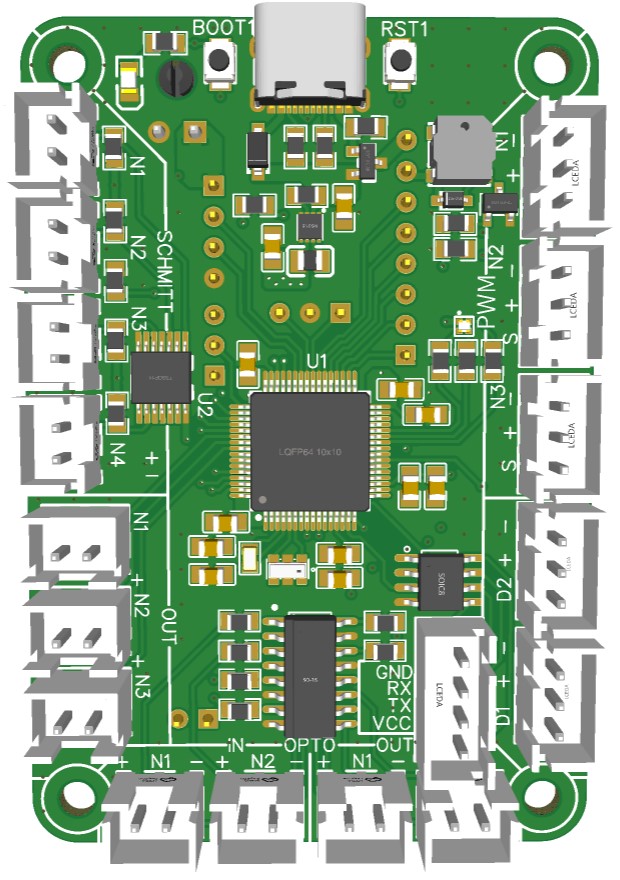
[picture p19: RAPPORT/DOSSIER SUIVI/figures/PCB_Sequenceur_front.jpg]
        
        \caption{face avant}
    \end{subfigure}
    \hfill
    \begin{subfigure}{0.45\textwidth}
        \centering
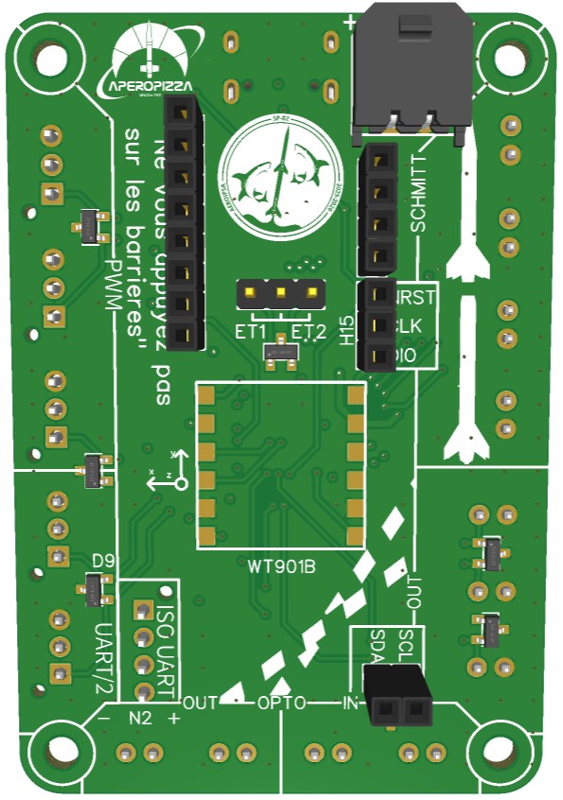
[picture p20: RAPPORT/DOSSIER SUIVI/figures/PCB_Sequenceur_back.jpg]
        
        \caption{face arrière}
    \end{subfigure}
    \caption{Rendu 3D de la carte séquenceur}
\end{figure}

\hspace*{-\parindent}%
\begin{minipage}{0.60\textwidth}
    \noindent Chaque séquenceur assure notamment :
    \begin{itemize}
        \item la détection du décollage via la coupure de la boucle \textit{jack} ;
        \item le démarrage du chronomètre interne servant de référence aux fenêtres temporelles ;
        \item le pilotage du système de récupération (parachute, trappe) ;
        \item la supervision de la séparation inter-étage et l’inhibition des actions en cas d’anomalie. \\
    \end{itemize}

    Le séquenceurs du première étage devra en plus se charger :
    \begin{itemize}
        \item du pilotage du système d'aérofreins ;
        \item du déverrouillage du mécanisme de séparation. \\
    \end{itemize}

    Le séquenceur du second étage devra quant à lui gérer :
    \begin{itemize}
        \item de la détection de l'attitude de la fusée ;
        \item de l'allumage du moteur du second étage.
    \end{itemize}
\end{minipage}
\hfill
\begin{minipage}{0.4\textwidth}
    \begin{figure}[H]
        \centering
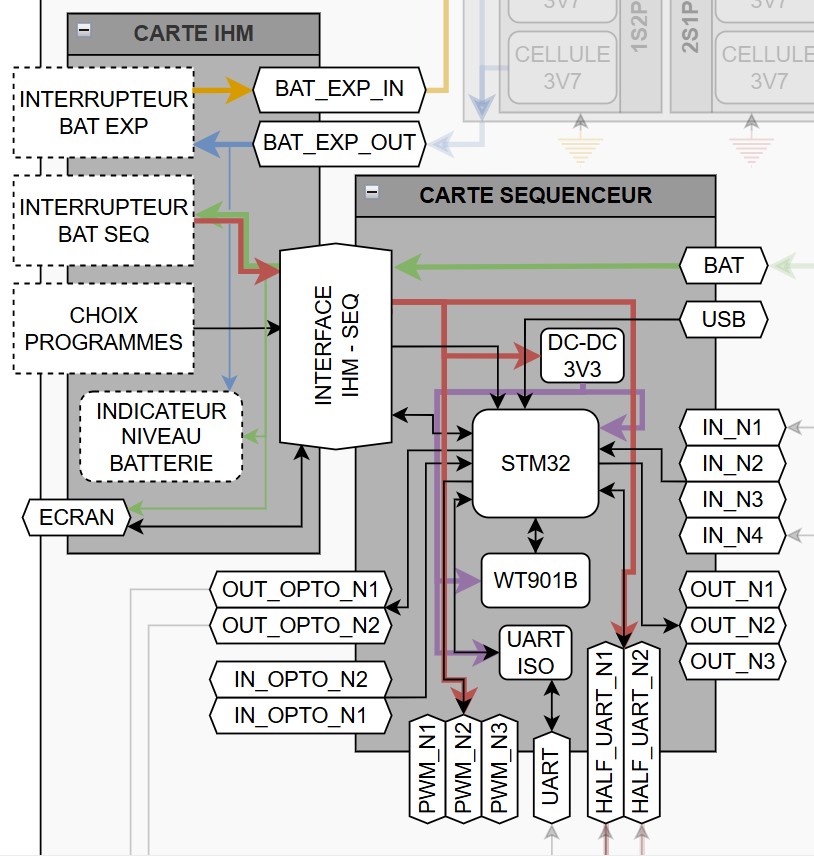
[picture p21: RAPPORT/DOSSIER SUIVI/figures/synopsis_sequ.jpg]
        
        \caption{Zoom sur le séquenceur et interface}
        \label{fig:schema_synopsis}
    \end{figure}
\end{minipage}

\vspace{0.5cm}

[TEXT EXPLICATIF DU SYNOPTIQUE]

\newpage

\subsubsection{Architecture matérielle}

Les séquenceurs s’appuient sur une carte électronique dédiée intégrant un microcontrôleur STM32F072R8T6, choisi pour sa
robustesse, sa faible consommation et la variété de ses interfaces (UART, timers, GPIO). \\

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

\subsubsubsection*{Choix du microcontrôleur}
Le STM32F072R8T6 a été sélectionné pour ses caractéristiques techniques adaptées aux exigences du projet :
\begin{itemize}
    \item architecture ARM Cortex-M0 32 bits, offrant une puissance de calcul suffisante pour la gestion des séquences et
    le traitement des données inertielle ;
    \item faible consommation énergétique, essentielle pour les opérations prolongées en vol ;
    \item large gamme d’interfaces de communication (UART, SPI, I2C, GPIO), facilitant l’intégration avec les capteurs et
    actionneurs embarqués ;
    \item 64~kB de mémoire flash et 16~kB de RAM, permettant le stockage du firmware et des données critiques. \\
\end{itemize}

Aussi, ayant déjà travaillé avec cette famille de microcontrôleurs sur des projets antérieurs, l’équipe dispose d’une expertise
solide pour le développement et le débogage du firmware.

\subsubsubsection*{Portes à hystérésis}
Les portes à hystérésis permettent de stabiliser les signaux provenant des capteurs sujets aux rebonds ou aux perturbations
(vibrations, variations rapides de tension). Elles assurent également la mise en forme des signaux transmis d’un étage à
l’autre, notamment via les connecteurs intégrés dans le mécanisme de séparation.

\subsubsubsection*{Boucles électriques inter-étages}
Chaque étage intègre une boucle électrique traversant physiquement l’autre étage. Lors de la séparation mécanique, ces deux
boucles sont automatiquement rompues, fournissant une confirmation physique et indépendante de la séparation. L’état de ces
boucles est traité par des portes à hystérésis, garantissant une détection franche et insensible aux vibrations ou aux
micro-perturbations rencontrées durant le vol.

\subsubsubsection*{Double circuit de détection de décollage}
Les deux séquenceurs sont connectés au même connecteur \textit{jack} 4-pins de décollage, mais sur deux circuits indépendants,
afin d’assurer une synchronisation parfaite tout en préservant l’isolation électrique entre étages. Ce choix permet de limiter
les risques de défaillance croisée et garantit que les deux chronomètres internes démarrent à $t=0$ exactement au même instant.

\subsubsection{Principes de fonctionnement}

Le fonctionnement repose sur une succession d’états décrits dans le logigramme de chaque séquenceur, cadencés par un
chronomètre démarré au décollage.

\begin{figure}[h!]
    \centering
    \begin{subfigure}{0.48\linewidth}
        \centering
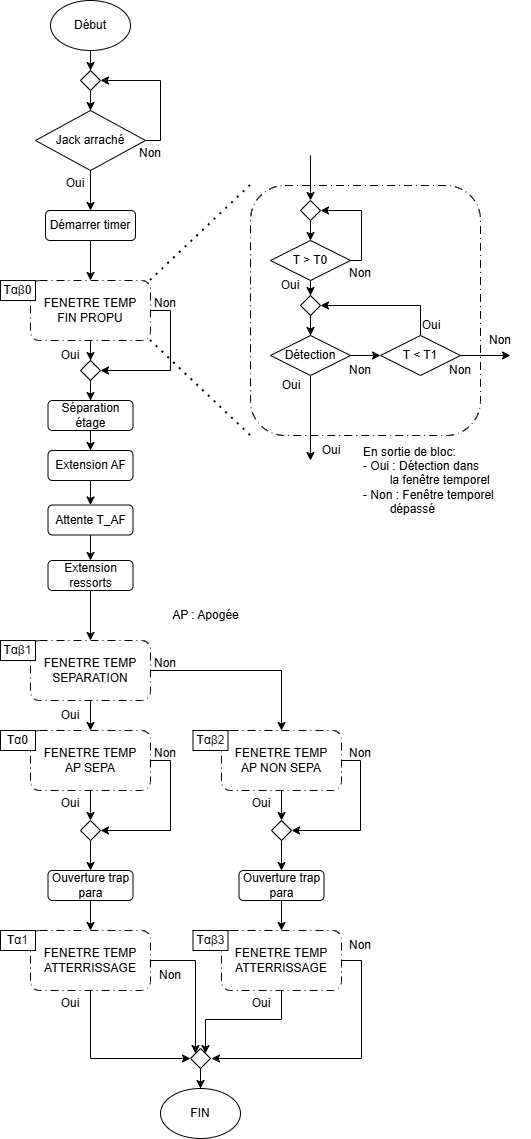
[picture p22: RAPPORT/DOSSIER SUIVI/figures/Sequenceur1.drawio.png]
        
        \caption{1er étage}
    \end{subfigure}
    \begin{subfigure}{0.48\linewidth}
        \centering
        
        \caption{2e étage}
    \end{subfigure}
    \caption{Schémas fonctionnels des séquenceurs des deux étages}
\end{figure}

\newpage

Voici les principaux évènements surveillés et partagés par les deux séquenceurs :
\begin{itemize}
    \item $T0$ : instant du décollage ;
    \item $T_{\alpha\beta0}$ : fin de la propulsion du premier étage ;
    \item $T_{\alpha\beta1}$ : séparation inter-étage ;
    \item $T_{\alpha\beta2}$ : apogée de l'ensemble du lanceur sans séparation ;
    \item $T_{\alpha\beta3}$ : atterrissage de l'ensemble du lanceur sans séparation.\\
\end{itemize}

Voici les principaux évènements surveillés par le séquenceur du premier étage :
\begin{itemize}
    \item $T_{\alpha0}$ : apogée du premier étage seul si séparation ;
    \item $T_{\alpha1}$ : atterrissage du premier étage seul si séparation.\\
\end{itemize}

Voici les principaux évènements surveillés par le séquenceur du second étage :
\begin{itemize}
    \item $T_{\beta0}$ : allumage du moteur du second étage si séparation ;
    \item $T_{\beta1}$ : date de mesure de la confirmation d’allumage du moteur du second étage ;
    \item $T_{\beta2}$ : apogée du second étage seul si séparation et allumage confirmé ;
    \item $T_{\beta3}$ : atterrissage du second étage seul si séparation et allumage confirmé ;
    \item $T_{\beta4}$ : apogée du second étage seul si séparation et allumage non confirmé ;
    \item $T_{\beta5}$ : atterrissage du second étage seul si séparation et allumage non confirmé.\\
\end{itemize}

\subsubsection{Robustesse du système et immunité aux perturbations}

Les entrées critiques sont isolées et conditionnées (optocoupleurs, portes à hystérésis), garantissant la stabilité des signaux
malgré les vibrations, les parasites haute fréquence et les variations rapides de tension.

Les masses numérique, analogique et puissance sont séparées, et les sorties critiques isolées empêchent tout retour de
perturbation vers le microcontrôleur. Cette architecture assure une excellente fiabilité des déclenchements durant les phases
de propulsion, de séparation et de récupération.

\subsubsection{Conception PCB}

La conception du PCB suit une méthodologie stricte destinée à minimiser les effets EMI : séparation des plans de masse numérique
et de puissance, retour de courant maîtrisé, longueurs de pistes critiques réduites, boucles de masse minimisées, et isolements
renforcés autour des signaux sensibles. Les composants de commutation (buffers, optocoupleurs, transistors) sont positionnés de
manière à réduire les couplages parasites et à garantir une immunité maximale.

\newpage
