povdoigt/SP-02/RAPPORT/DOSSIER SUIVI/sections/ch5_elec/subsec5_camera.tex

\subsection{Caméra embarquée}
\label{subsec:camera}

\newpage
