povdoigt/SP-02/PMI/repport/sections/ch4_meca/subsec3_premier_etage.tex

\subsection{Structure du premier étage}
\label{subsec:premier_etage}

\subsubsection{Flèche}
\label{subsubsec:premier_etage}
À la suite de la conception, nous avons pu réaliser les tubes de la structure porteuse de la fusée. Nous avons procédé à un test
de flèche sur les tubes afin de nous assurer de la bonne tenue mécanique de ces derniers. Pour le tube du premier étage, nous
avons encastré le tube comme si tenu par le propulseur et réalisé les tests comme au \gls{C'Space}.\\

Afin de déterminer la force à appliquer à un mètre, on calcule le couple créé par le poids de la fusée au niveau de la base de
l’étage inférieur.

\begin{figure}[h!]
    \centering
    \begin{tikzpicture}
        \node at (0,0) {};

        \node (y_lbl)  at (-6.95, +0.500) {\textbf{y}};
        \node (x_lbl)  at (-6.70, -0.205) {\textbf{x}};
        \node (Cz_fbl) at (-6.60, +0.250) {\textbf{$C_z$}};
        \node (P_lbl)  at (-0.85, +1.000) {\textbf{P}};
        \node (F_lbl)  at (+6.00, +1.000) {\textbf{F}};

        \draw[red, <-, line width=1] (-7.200, +0.5) -- (-7.200, +0.0);
        \draw[red, <-, line width=1] (x_lbl.north)  -- (-7.200, +0.0);
        \draw[red, ->, line width=1] (+5.800, +1.0) -- (+5.800, +0.3);
        \draw[red, ->, line width=1] (-1.080, +1.0) -- (-1.080, +0.3);
        \draw[red, ->] (-6.7, 0) arc (0:90:.5cm);
        \draw [<->, > = stealth, black] (-7.2, -0.75) -- (-1.080, -0.75) node [midway, fill = white] {0,880m} ;
        \draw [<->, > = stealth, black] (-7.2, -1.25) -- (+5.800, -1.25) node [midway, fill = white] {1,800m} ;
    \end{tikzpicture}
    \caption{Schéma de calcul du couple exercé au niveau de la base du premier étage}
    \label{fig:placeholder}
\end{figure}

\begin{align*}
    P &= 9,81 \times 7,327 = 71,878\ N \\
    F &= 9,81 \times 0,8 = 7,848\ N\\
    \\
    C_Z &= 0,880 \times  (- P) + 1,800 \times (- F) \\
    &= 0,880 \times (- 71,878) + 1,800 \times (-7,848) \\
    &= -77,379\ N\cdotp m
\end{align*}
On a donc un couple de $-77,379\ N\cdotp m$, ce qui équivaut a :
$$\frac{|-77,379|}{9,81} = m_{test} \approx 7,888\ kg$$
$m_{test}$ étant la valeur de la masse à appliqués à un mètre du point d'encastrement pour reproduire le même couple.
Notre estimation de masse étant approximative, nous avons décidé d’arrondir la charge $m_{test}$ à $10\ kg$.

\begin{table}[h!]
    \centering
    \begin{tabular}{|c|c|c|}
        \hline
        Positionnement & Flèche statique & Flèche dynamique \\ \hline
        Patins à 0° & 0mm & 1mm \\ \hline
        Patins à 90° & 0mm & 1,5mm \\ \hline
        Patins à 180° & 0mm & 1mm \\ \hline
        Patins à 270° & 0mm & 2mm \\ \hline
        \end{tabular}
    \caption{Résultats des tests de flèche du tube du premier étage}
\end{table}

Les résultats montrent une flèche maximale de 0 mm en statique et 2 mm en dynamique pour une longueur de 1 m de tube. Cela 
correspond à une flèche relative de 0 \% en statique et 0,2 \% en dynamique, ce qui est largement en dessous de la limite de
1 \% imposée par le \gls{CDC} \cite[p.~32]{CDC_BiEtage}

\newpage

\subsubsection{Fabrication et collage du bloc propulsion avec ailerons}
Le bloc propulsion de SP-02 reprend la même architecture générale que celle définie pour SP-01, à savoir quatre ailerons en
fibre de verre fixés sur un tube porte-moteur intégré dans le fuselage. Le rétreint arrière est de nouveau utilisé pour
optimiser la réduction de traînée, mais le système de maintien du propulseur évolue : la vis latérale utilisée sur SP-01 est
remplacée par une bague filetée venant se visser à l’arrière du tube porte-moteur, assurant un appui axial direct sur le
propulseur. Cette modification permet de conserver la même géométrie extérieure tout en simplifiant la transmission des efforts
axiaux et en maintenant la compatibilité avec le format moteur retenu.\\

\begin{figure}[h!]
    \centering
    
    \caption{Procédé de collage ailerons/tube porte-moteur}
    \label{fig:collage_aileronsSP01}
\end{figure}

Le tube porte-moteur de SP-02, déjà fabriqué, reprend exactement le même principe de géométrie et de construction que celui
utilisé pour SP-01. Réalisé à partir d’un moulage sur casing Pro-54, il possède un diamètre identique au standard attendu et
conserve une longueur réduite par rapport au casing d’origine afin d’optimiser la masse tout en maintenant une rigidité
suffisante pour supporter l’ensemble du bloc propulsion. Les ailerons seront ensuite collés à la résine époxy sur ce tube déjà
réalisé, ainsi que sur les deux bagues de centrage, de manière à reproduire fidèlement la configuration mécanique utilisée
précédemment et à assurer une continuité dans l’intégration structurelle du bloc propulsion.\\

\begin{figure}[h!]
    \centering
    
    \caption{Procédé de collage ailerons/structure avec congés en résine}
    \label{fig:collage2_aileronsSP01}
\end{figure}

Enfin, SP-02 reprend également la logique de finition appliquée sur SP-01 : des perçages seront réalisés en amont et en aval
des ailerons afin de garantir une diffusion homogène de la résine dans la zone d’assemblage, et des congés en résine seront
appliqués sur les jonctions extérieures pour assurer une transition aérodynamique lisse. Cette étape permet également de fermer
proprement les points d’injection tout en assurant une finition aérodynamique cohérente avec le modèle précédent.\\

\newpage

\subsubsection{Maintien du Pro54}
Nous avons opté pour deux méthodes de fixation pour le Pro54 -- après discussion en \acrshort{RCE}-1 -- pour laisser le choix
aux pyrotechniciens selon leur préférence (dépendamment de la rampe utilisée pour le lancement):
\begin{itemize}
    \item Une bague se vissant autour du propulseur (pas de vis 62mm) avec un serrage à la main (et clé si nécessaire) -- et
    visible en bleu sur l'image,
    \item Deux loquets à tourner à la main pour le maintien du propulseur -- visibles en rouge sur l'image.
\end{itemize}

Les deux loquets devront être vissés si utilisés, mais ne requièrent pas de changement de pièce dans l'assemblage.
\begin{figure}[h!]
    \centering
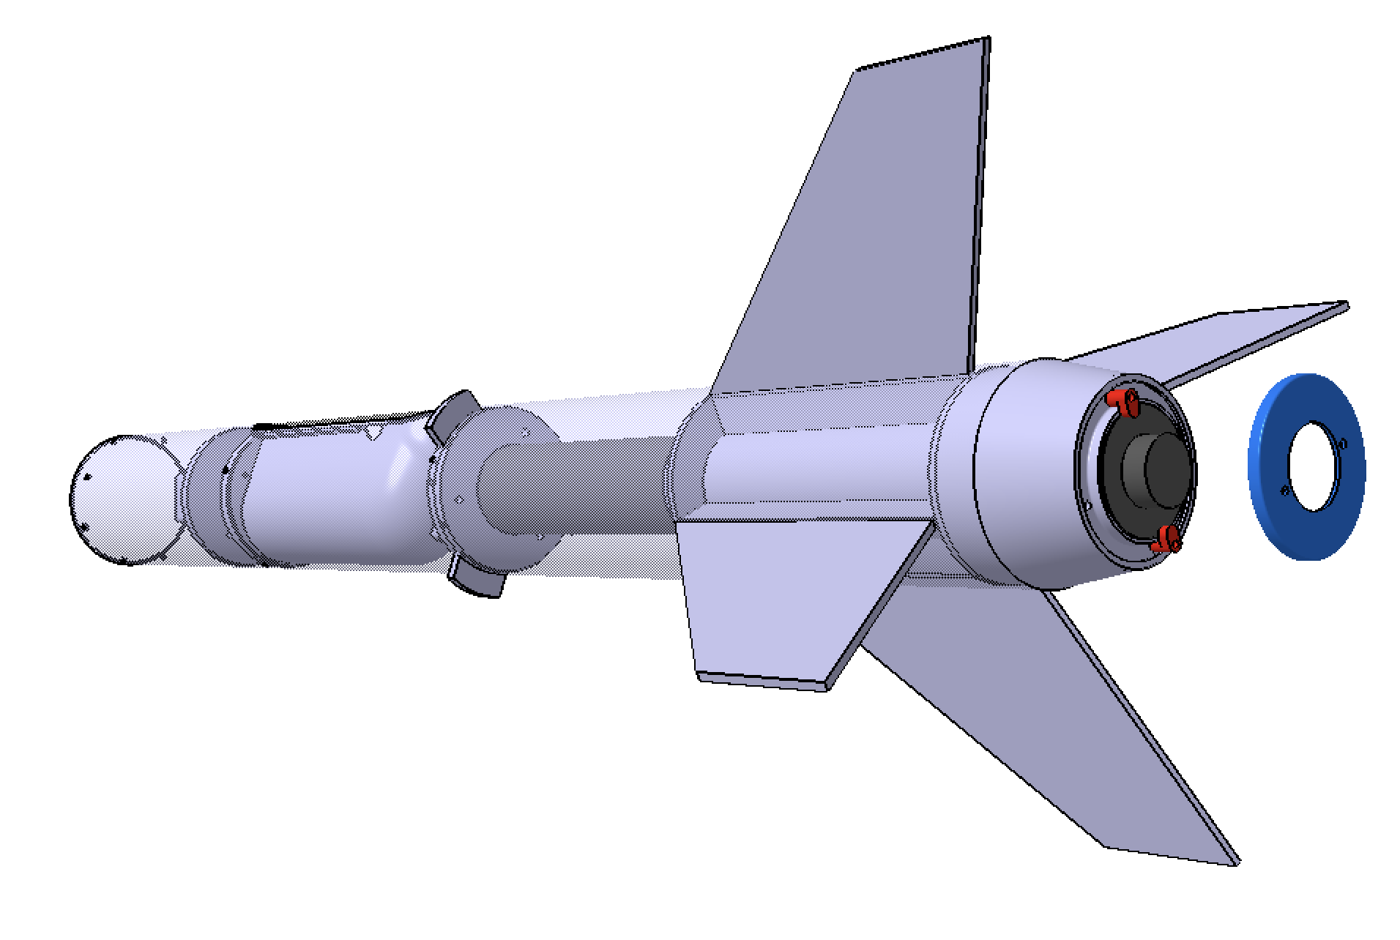
[picture p35: PMI/repport/figures/maintien2_pro54.png]
    
    \caption{Méthodes de fixation du Pro54}
    \label{fig:fixation_pro54}
\end{figure}

\subsubsection{Aérofreins}

\subsubsubsection{Définition du système d'aérofreins}

La place disponible dans le premier étage étant très limitée, nous avons opté pour un système d'aérofreins de type "plaque
déployable". Ce système est composé de deux bagues en aluminium 7075 de 7 mm d'épaisseur et du même diamètre que l'intérieur du
fuselage. Entre les deux plaques, un système de bielles permet de déployer les aérofreins à l'aide d'un servo-moteur.\\

\begin{minipage}{0.5\textwidth}
    \centering
    
    \captionof{figure}{Système d'aérofrein d'SP-02 sur \acrshort{CATIA}}
    \label{fig:aerofrein_SP02}
\end{minipage}
\hfill
\begin{minipage}{0.4\textwidth}
    Une vue du système d'aérofreins d'SP-02 est présentée à la figure \ref{fig:aerofrein_SP02}. Chaque bague est vissée au corps
    de la fusée par 4 vis M4, soit 8 vis M4 pour le système complet tout, réparties uniformément. Les deux bagues sont vissées
    entre elles par 3 vis M5. Cela permet de maximiser la rigidité du système et de transmettre les efforts aérodynamiques à la
    structure principale de la fusée. Les aérofreins à proprement parler sont constitués de plaques en \gls{POMc} de 7 mm
    d'épaisseur fixés entre les deux bagues à l'intéreur de rainures usinées dans chaque bague.
\end{minipage}

\begin{minipage}{0.34\textwidth}
    La figure \ref{fig:aerofrein_SP02_ouvert_ferme} montre les deux positions possibles des aérofreins. Le déploiement se fait à
    l'aide d'un servo-moteur placé à l'intérieur du fuselage et relié aux plaques par des bièles. Une rotation de 120° des plaques
    permet de passer de la position fermée à la position ouverte.
\end{minipage}
\hfill
\begin{minipage}{0.65\textwidth}
    \begin{figure}[H]
        \centering
        \begin{subfigure}{.49\textwidth}
            \centering
            
            \caption{fermé}
        \end{subfigure}
        \begin{subfigure}{.49\textwidth}
            \centering
            
            \caption{ouvert}
        \end{subfigure}
        \caption{Position des aérofreins d'SP-02}
        \label{fig:aerofrein_SP02_ouvert_ferme}
    \end{figure}
\end{minipage}

\vfill

\begin{minipage}{0.55\textwidth}
    \centering
    \begin{tikzpicture}
        
        \node at (0, 0) {};

        % \draw[help lines, step=1cm] (-3.5,-6) grid (6, 6);
        % \draw[help lines, step=0.5cm, lightgray] (-3.5,-6) grid (6, 6);
        % \draw[line width=2] (-3.5, +0.0) -- (+6.0, +0.0);
        % \draw[line width=2] (+0.0, -6.0) -- (+0.0, +6.0);

        \node (moteur_lbl)      at (+4.50, +4.50) {\textbf{Servo-moteur}};
        \node (rondelle1_lbl)   at (+4.50, +2.75) {\textbf{Rondelle 1}};
        \node (bague_haut_lbl)  at (+4.50, +1.75) {\textbf{Bague supérieure}};
        \node (rondelle2_lbl)   at (+4.50, +0.00) {\textbf{Rondelle 2}};
        \node (bielle_lbl)      at (+4.50, -1.00) {\textbf{Bielles (x3)}};
        \node (aerofrein_lbl)   at (+4.50, -2.00) {\textbf{Aérofreins (x3)}};
        \node (bague_bas_lbl)   at (+4.50, -4.00) {\textbf{Bague inférieure}};

        \draw [red, ->, line width=1.5] (moteur_lbl.west)     -- (+1.50, +4.50);
        \draw [red, ->, line width=1.5] (rondelle1_lbl.west)  -- (-0.25, +2.75);
        \draw [red, ->, line width=1.5] (bague_haut_lbl.west) -- (+1.50, +1.75);
        \draw [red, ->, line width=1.5] (rondelle2_lbl.west)  -- (+0.00, -1.25) -- (-0.25, -2.00);
        \draw [red, ->, line width=1.5] (bielle_lbl.west)     -- (+1.50, -1.50);
        \draw [red, ->, line width=1.5] (aerofrein_lbl.west)  -- (+2.00, -2.50);
        \draw [red, ->, line width=1.5] (bague_bas_lbl.west)  -- (+2.00, -4.00);

    \end{tikzpicture}
    \captionof{figure}{Vu éclatée du système d'aérofrein d'SP-02}
    \label{fig:aerofrein_SP02_eclate}
\end{minipage}
\hfill
\begin{minipage}{0.35\textwidth}
    La figure \ref{fig:aerofrein_SP02_eclate} présente une vue éclatée du système d'aérofrein. On y distingue les deux bagues
    en aluminium, les aérofreins en \gls{POMc}, les bielles de liaison en aluminium, les rondelles de maintien en \gls{POMc} et
    le servo-moteur. Le choix du matériau pour les aérofreins et les rondelles s'est porté sur le \gls{POMc} en raison de sa
    forte résistance mécanique, de sa facilité d'usinage et de son faible coefficient de frottement avec l'aluminium, ce qui
    réduit l'effort nécessaire pour le déploiement des aérofreins.\\

    La \acrshort{CAO} sur \acrshort{CATIA} nous indique une masse totale du système (servo-moteur inclus) de 360 g. Ce poids
    a été pris en compte dans la masse totale du premier étage tout comme dans le calcul de son centre de masse.\\
    
    La plus grande partie des pièces seront usinées au \gls{Skylab}. Seuls les aérofreins seront commandés à un fournisseur
    externe au vu de la complexité de leur forme nécessitant une fraiseuse 5 axes.
\end{minipage}

\vspace{1cm}

L'ensemble des plans mécaniques du système d'aérofreins est disponible en annexe \ref{subsec:plan_aerofreins}.

\vfill

\newpage

\subsubsubsection{Modélisation de la cinématique des aérofreins}

La figure \ref{fig:cinematique_aerofrein} illustre la cinématique du système d'aérofreins.

\vfill

\begin{figure}[h!]
    \centering
    \begin{tikzpicture}
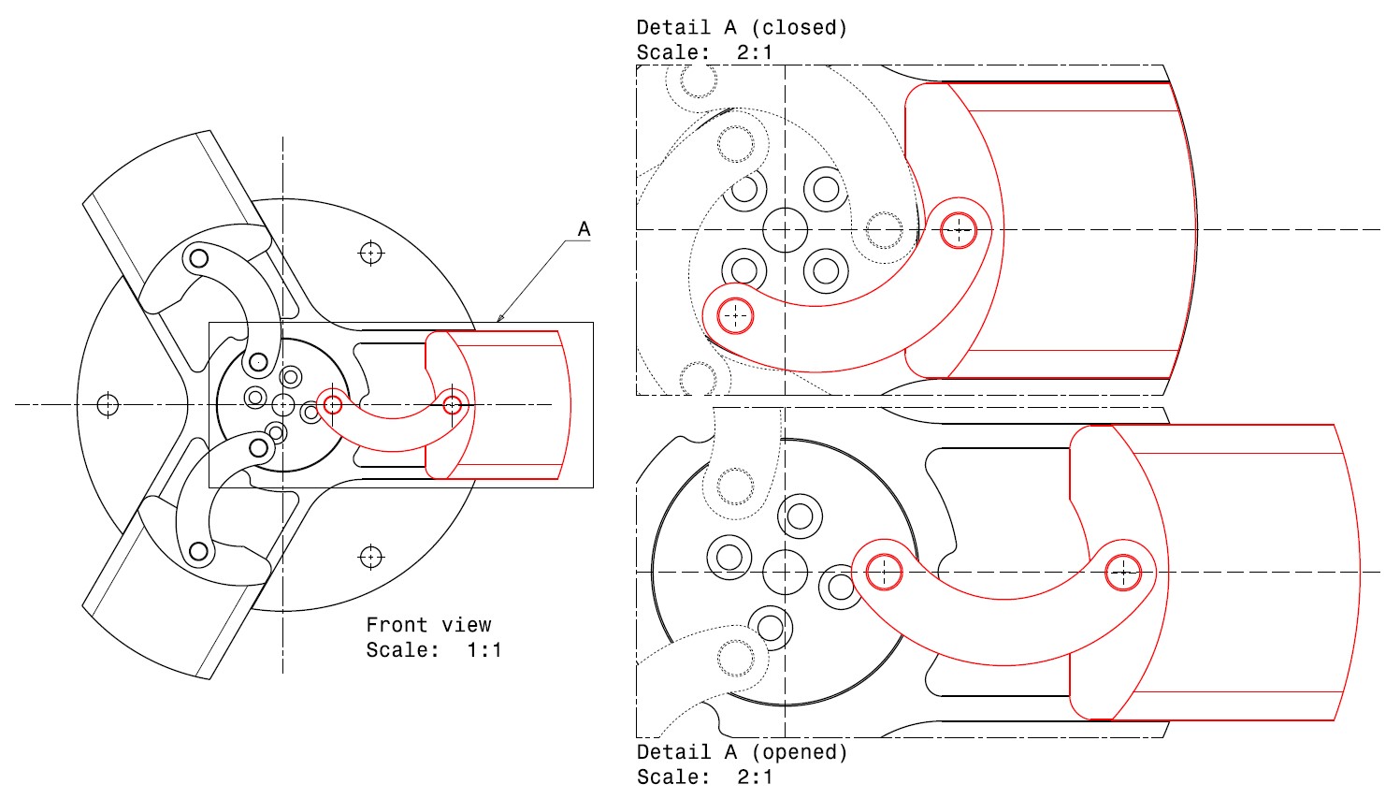
[picture p36: PMI/repport/figures/Schema_AF.jpg]
        \node at (0, 0) {};

        % \draw[help lines, step=1cm] (-8, -4) grid (8, 4);
        % \draw[help lines, step=0.5cm, lightgray] (-8, -4) grid (8, 4);
        % \draw[line width=2] (-8.0, +0.0) -- (+8.0, +0.0);
        % \draw[line width=2] (+0.0, -4.0) -- (+0.0, +4.0);

        % Add half of transparency to the background image
        \filldraw[white, opacity=0.6] (-1, -4.5) rectangle (8, 4.5);

        \node (OA) at (0.98, 1.94) {};
        \node (OA_lbl) at (1.25, 2.25) {\textbf{O}};

        \node (AA) at (0.405, 0.955) {};
        \node (AA_lbl) at (0.25, 0.75) {\textbf{A}};

        \node (BA) at (2.965, 1.94) {};
        \node (BA_lbl) at (3.25, 2.25) {\textbf{B}};

        \draw[circle, dotted, line width=1.5] (OA) circle (1.1405);

        \draw[line width=1.5, red, <->] (OA.center) -- (AA.center) node [midway, above left] {\textbf{R}};
        \draw[line width=1.5, blue, <->] (AA.center) -- (BA.center) node [midway, below] {\textbf{L}};

        \draw (1.3, 1.94) arc (0:-120:0.3cm) node [midway, right] {\textbf{$\theta$}};

        \node (OB) at (0.965, -1.97) {};
        \node (OB_lbl) at (0.75, -1.75) {\textbf{O}};

        \node (AB) at (2.11, -1.97) {};
        \node (AB_lbl) at (2.5, -1.5) {\textbf{A}};

        \node (BB) at (4.845, -1.97) {};
        \node (BB_lbl) at (5.15, -1.75) {\textbf{B}};

        \draw[circle, dotted, line width=1.5] (OB) circle (1.145);

        \draw[line width=1.5, red, <->] (OB.center) -- (AB.center) node [midway, below] {\textbf{R}};
        \draw[line width=1.5, blue, <->] (AB.center) -- (BB.center) node [midway, below] {\textbf{L}};

        \draw[line width=1.5, <->] (5.4, -3.8) -- (7.4, -3.8) node [midway, below] {\textbf{D}};

        % Add i, j units vectors
        \draw[->, line width=1.5] (-1.0, -3.5) -- (-0.0, -3.5) node [midway, above] {\textbf{i}};
        \draw[->, line width=1.5] (-1.0, -3.5) -- (-1.0, -2.5) node [midway, left] {\textbf{j}};

    \end{tikzpicture}
    \caption{Schéma de la cinématique des aérofreins}
    \label{fig:cinematique_aerofrein}
\end{figure}

\vfill

La cinématique du système d'aérofreins est définie par trois paramètres principaux : la longueur caractéristique des bielles
($AB = L$), la distance entre l'axe de rotation des aérofreins et le point de fixation des bielles ($OA = R$), et l'angle de
rotation de ce point ($\widehat{AOB}=\theta$).\\

\vfill

D'après la formule d'Al Kashi, on peut exprimer la distance $OB$ en fonction de ces paramètres :
\begin{align}
    AB^2    &= OA^2 + OB^2 - 2 \cdot OA \cdot OB \cdot \cos(\theta) \\
    L^2     &= R^2 + OB^2 - 2 R \cdot OB \cdot \cos(\theta) \\
    0       &= OB^2 - 2 R \cos(\theta) \cdot OB + (R^2 - L^2) \\
    OB      &= \frac{2 R \cos(\theta) \pm \sqrt{(2 R \cos(\theta))^2 - 4 (R^2 - L^2)}}{2} \\
            &= R \cos(\theta) \pm \sqrt{R^2 \cos^2(\theta) - (R^2 - L^2)} \\
            &= R \cos(\theta) \pm \sqrt{L^2 - R^2 \sin^2(\theta)}
\end{align}

\vfill

\newpage

Pour le cas $OB = R \cos(\theta) - \sqrt{L^2 - R^2 \sin^2(\theta)}$, on remarque que:
\begin{align}
    0 &\leq OB\\
    0 &\leq R \cos(\theta) - \sqrt{L^2 - R^2 \sin^2(\theta)}\\
    \sqrt{L^2 - R^2 \sin^2(\theta)} &\leq R \cos(\theta) \\
    L^2 - R^2 \sin^2(\theta) &\leq R^2 \cos^2(\theta) \\
    L^2 &\leq R^2 (\sin^2(\theta) + \cos^2(\theta)) \\
    L^2 &\leq R^2 \\
    L &\leq R
\end{align}

Or, dans notre cas, $L > R$. Nous rejetons donc cette solution et retenons :

\begin{equation}
    OB = R \cos(\theta) + \sqrt{L^2 - R^2 \sin^2(\theta)}
\end{equation}

La distance $D$ est donnée par la différence entre $OB$ et le rayon de l'extérieur de la fusée $R_{fusee}$ :

\begin{equation}
    \boxed{D = R \cos(\theta) + \sqrt{L^2 - R^2 \sin^2(\theta)} - R_{fusee}}
\end{equation}

\subsubsubsection{Simulation de résistance mécanique des aérofreins}

\newpage

\subsubsubsection{Performance aérodynamique des aérofreins}

\newpage

\subsubsection{Définition du système d'ouverture/parachute}
\label{subsec:defpara}

Dans l'objectif de récupération de chaque étage, nous devons définir et valider nos deux systèmes de sauvegarde des lanceurs.
Ceux-ci sont définis par des trappes latérales actionnées par un servomoteur chacun.\\

Le tableau suivant récapitule les règles du \acrshort{CDC} nous concernant (règles concernant les ralentisseurs pilotés non
présentes) et devant faire l'objet d'une validation technique.

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

La contrainte imposée par le \acrshort{CDC} est une vitesse de redescente comprise entre 5 et 15m/s pour les trois
configurations (étage 1, étage 2 et non séparé). De par les dimensions des deux étages, le premier sera en charge du retour
sous parachute de l'ensemble non séparé.
\begin{equation}
\begin{aligned}
    V_d &= \sqrt{\frac{2 M g}{\rho_0 C_x S}} \
    %V_d &= \sqrt{\frac{2 \times 7.2 \times 9.81}{1.3 \times 1 \times 0.65}}
\end{aligned}
\end{equation}

Avec la règle REC2, nous devons dimensionner les deux parachutes pour les cas suivants :

\begin{table}[h!]
    \centering
    \begin{tabular}{|c|c|c|c|}
        \hline
        Cas d'étude & Pas de séparation & Étage 1 & Étage 2 \\ \hline
        Masse de l'ensemble & 7,327kg & 4,431kg & 2,895kg \\ \hline
        Dimensions du parachute utilisé & a=b=360mm & a=b=360mm & a=b=310mm \\ \hline
        Vitesse sous parachute & 13,1 m/s & 9,2 m/s & 10,7 m/s \\ \hline
    \end{tabular}
\end{table}

La forme des parachutes utilisés sera de type croix, avec a et b les valeurs d'un carré de la croix. De plus, l'ensemble du
parachute devra résister à l'ouverture.
\begin{equation}
\begin{aligned}
    F &= 2 \times Acc{max} \times K{safety} \times M_{sup} \\
    F &= 2 \times 9,7 \times 1,5 \times 3,055 \\
    F &= 88,90 N \\
\end{aligned}
\end{equation}

Le parachute sera fixé à la bague principale du bloc parachute dont cette dernière sera réalisée en aluminium 7075-T6 et fixée
au tube par 3 vis CBLX M5x12mm, qui, d'après nos tests, restent conformes à REC5. L'ensemble des règles REC6 à REC8 concernant la
bonne tenue de la trappe latérale seront confirmées de par la forme du réceptacle du parachute avec des rebords pour le bon
maintien de la trappe avec le tube ainsi que son usinage pour avoir aucun jeu lors du test en torsion. \\

L'utilisation d'un émérillon en acier inoxydable de diamètre 8mm permettra une tenue maximale en traction de 2943 N, pour être
conforme à REC10 et un anneau anti-torche pour confirmer REC11. Enfin, une batterie de tests (filmés) sera réalisée pour confirmer REC9.\\

Le système d’ouverture — une brique technologique déjà développée et validée sur SP-01 — se compose d’un servomoteur et d’un
crochet assurant le verrouillage de la trappe. En plaçant le servomoteur à la verticale, avec un axe de rotation aligné sur
l’axe de roulis de la fusée, on améliore son efficacité au décollage : il est moins sollicité en cas d’infiltration d’air dans
la trappe et lors de l’ouverture.

\begin{figure}[h!]
    \centering
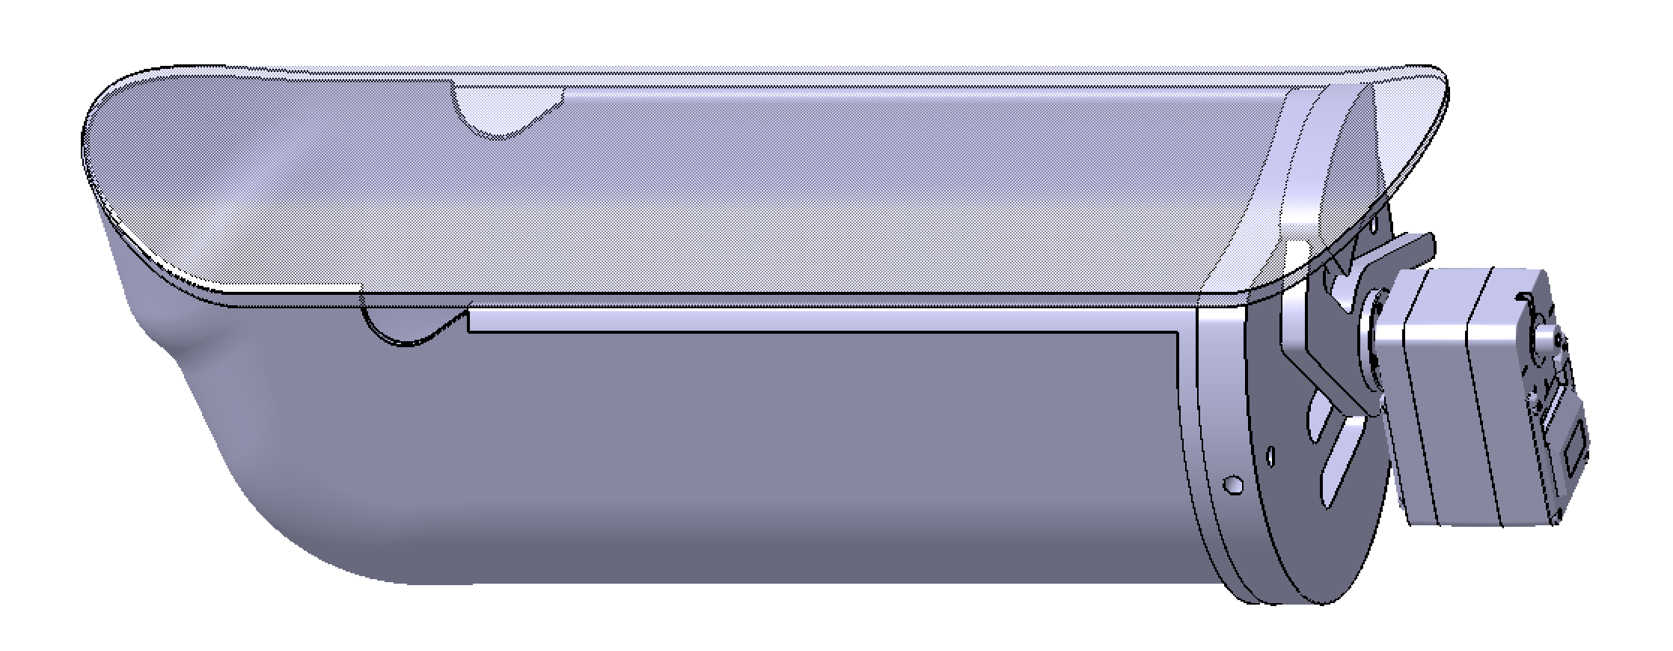
[picture p37: PMI/repport/figures/para_etage1.png]
    
    \caption{Bloc parachute du premier étage sur \acrshort{CATIA}}
    \label{fig:para1_SP02}
\end{figure} 

\newpage
