povdoigt/SP-02/PMI/repport/sections/ch6_experience/subsec3_elec.tex

\subsection{Intrumentalisation de SP-02}

\subsubsection{Détail de la chaine de mesure}

\subsubsection{Test de la chaine de mesure}
