povdoigt/SP-02/PMI/repport/sections/ch4_meca/subsec5_second_etage.tex

\subsection{Structure du second étage}
\label{subsec:second_etage}

\subsubsection{Flèche}
\label{subsubsec:second_etage}
Pour le tube du second étage de 80mm interne et 2mm d'épaisseur, nous avons mesuré une petite flèche sur deux côtés opposés mais
assez négligeable.\\

Le test dynamique sera réalisé dès que possible.

\begin{table}[h!]
\centering
\begin{tabular}{|c|c|c|}
\hline
Positionnement & Flèche statique & Flèche dynamique \\ \hline
Patins à 0° & 0mm & À tester \\ \hline
Patins à 90° & 0.5mm & À tester \\ \hline
Patins à 180° & 0mm & À tester \\ \hline
Patins à 270° & -0.5mm & À tester \\ \hline
\end{tabular}
\end{table}

\subsubsection{Fabrication et collage des ailerons}
Les ailerons sont fabriqués à partir d'une plaque de fibre de verre achetée dans le commerce, dans laquelle il est possible de
découper les 4 ailerons aux dimensions souhaitées à la \acrshort{CNC}, afin d'obtenir des ailerons strictement identiques. Un
ponçage méticuleux est ensuite réalisé sur les surfaces des 4 pièces et accroître l'adhérence de la fibre résinée et donc
l'efficacité du collage.\\

La méthode a été testée et approuvée sur la \gls{Minif} \textit{Arcturus} lancée au \gls{C'Space} 2024 et sur la \gls{Fusex}
\textit{Fast Forward} \cite{FF} lancée à \acrshort{FAR} aux États-Unis. Celle-ci consite à coller nos ailerons sur la surface
extérieur du tube de l'étage à l'aide de résine époxy, puis de la création des congés pour accroître la tenue sans découper de
fentes dans ce dernier. Cette méthode présente l'avantage de ne pas fragiliser la structure du tube. Cependant, elle nécessite
de renforcer la fixation des ailerons sur le tube en ajoutant des renforts en composite, sous forme de couches supplémentaires
de fibre de verre.

\begin{figure}[h!]
    \centering
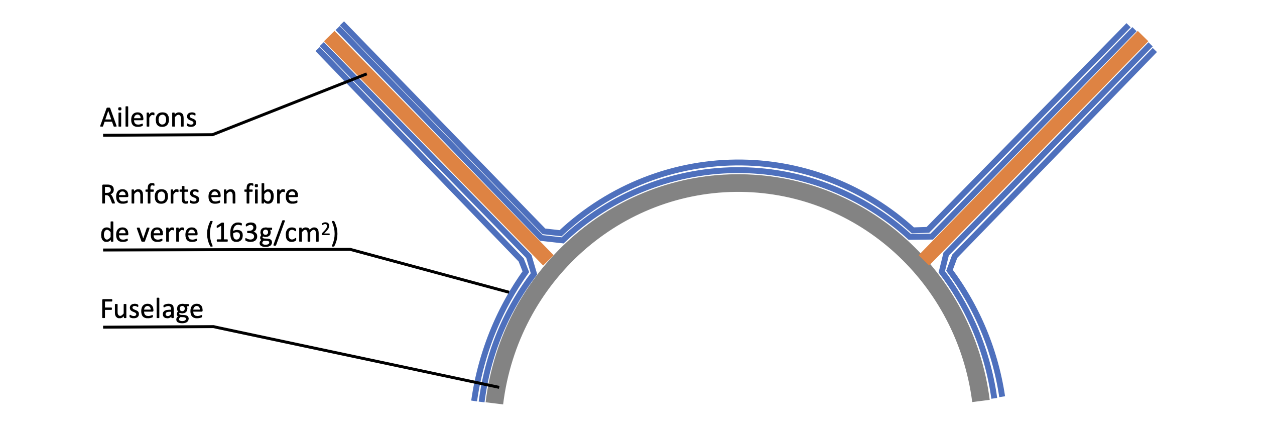
[picture p38: PMI/repport/figures/collage_ailerons_arcturus.png]
     % Remplacez par le nom de votre fichier image
    \caption{Illustration du collage des ailerons sur le tube de la mini-fusée \textit{Arcturus}.}
    \label{fig:collage_ailerons_arcturus}
\end{figure}

\newpage

\subsubsection{Définition du système d'ouverture/parachute}
\label{subsec:def_para2}
En suivant les mêmes contraintes du \acrshort{CDC}, la définition du bloc parachute du second étage reprend les mêmes principes
que celui du premier. Toutefois, seulement la taille et la fixation du parachute changera :

\begin{table}[h!]
\centering
\begin{tabular}{|c|c|c|c|}
\hline
Cas d'étude &  Étage 2 passif & Étage 2 actif \\ \hline
Masse de l'ensemble & 2,895kg & 3,055kg \\ \hline
Dimensions du parachute utilisé & a=b=310mm &a=b=310mm \\ \hline
Vitesse sous parachute & 9,7 m/s & 10,0 m/s\\ \hline
\end{tabular}
\end{table}

Le parachute sera accroché sur la bague inférieure du bloc parachute afin que la fusée retombe sur la coiffe et non directement 
sur les ailerons et le système de séparation afin de limiter certains dégâts lors de la redescente.
\begin{figure}[h!]
    \centering
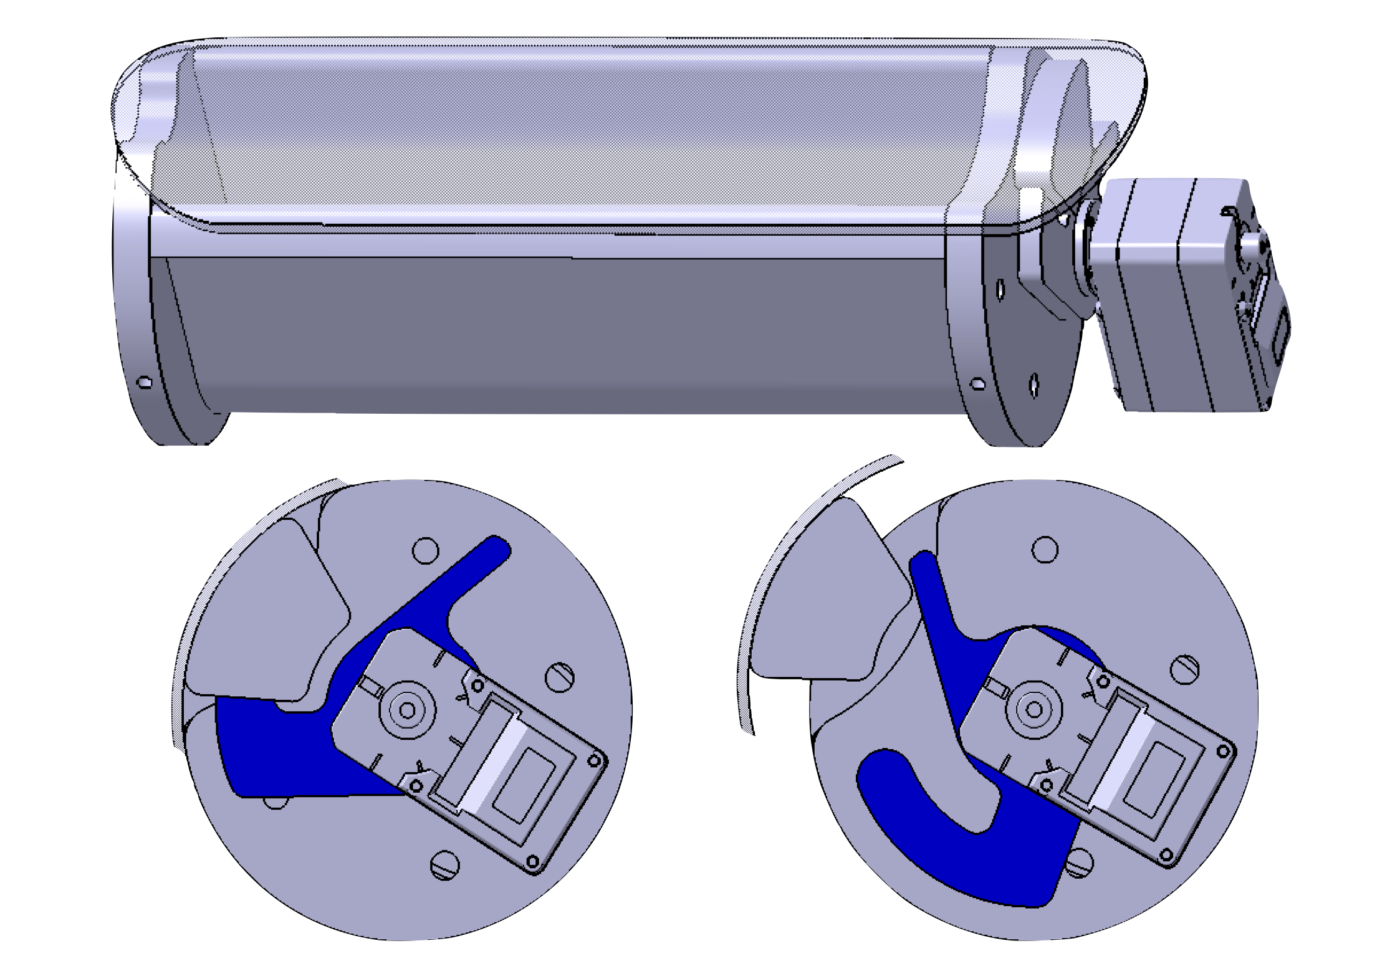
[picture p39: PMI/repport/figures/para_etage2.png]
    
    \caption{Bloc parachute du second étage sur \acrshort{CATIA}}
    \label{fig:para_etage2}
\end{figure}

\newpage
