povdoigt/SP-02/RAPPORT/PRESENTATION PROJET/Présentation-SP02-AGO2025 (1).pptx

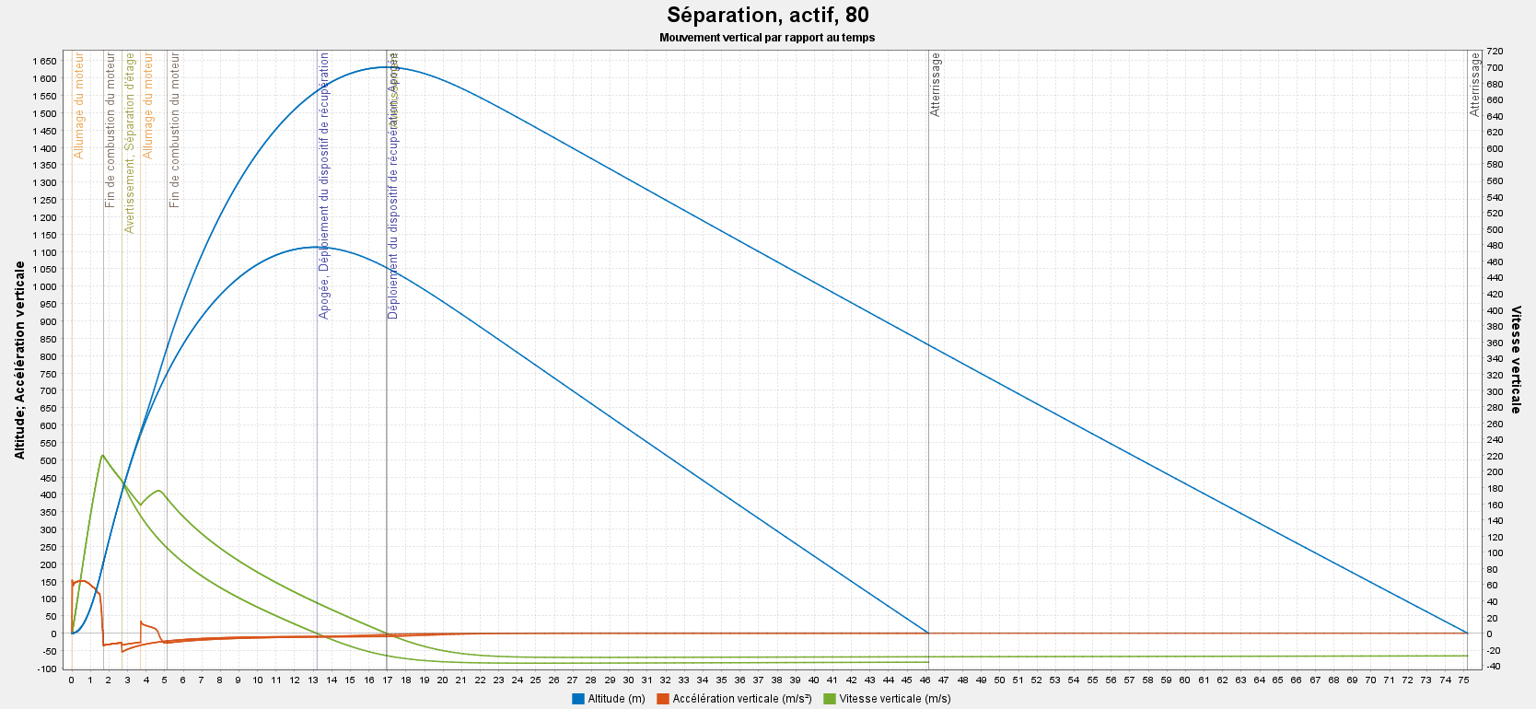
[picture p40: figure]

SP-02

- Fusée expérimentale biétage
  1. Module de séparation avec aérofreins réalisé en PMI (Projet Master Innovation)
  2. Réalisation de deux fusées avec Pro-54/Pro-24
  3. Capteurs, électronique embarquée…
  4. Cansat : former les nouveaux membres

2,10m

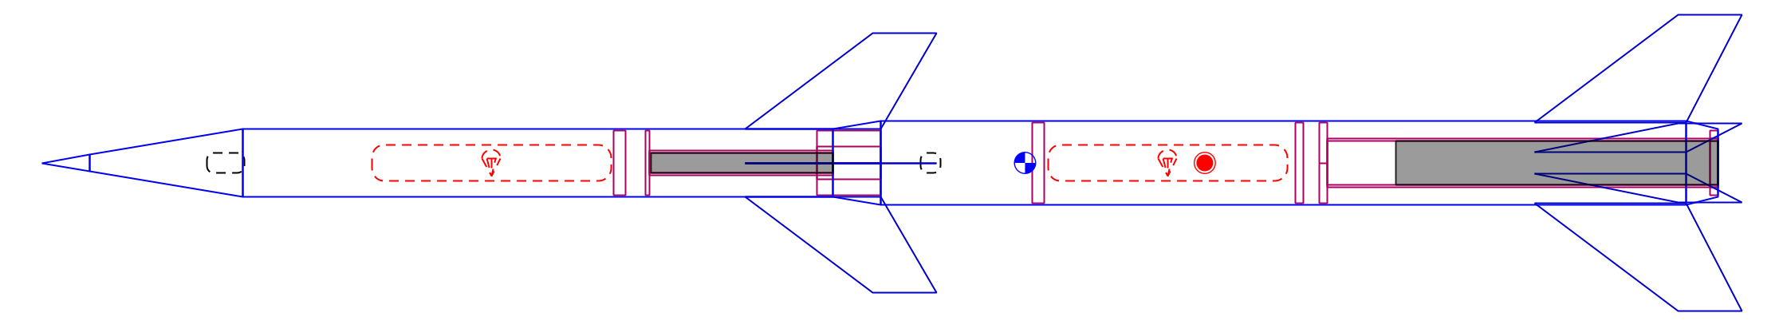
[picture p41: figure]
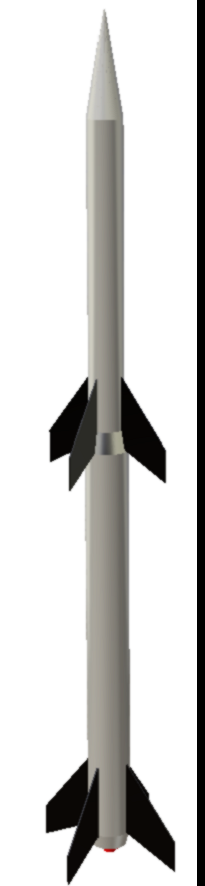
[picture p42: figure]
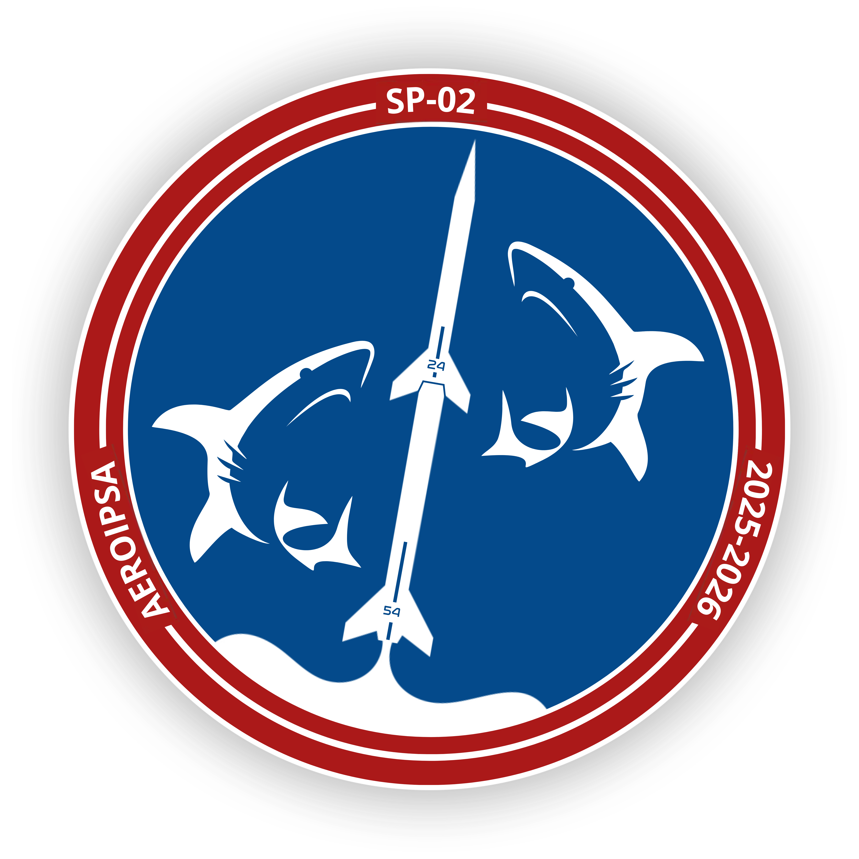
[picture p43: figure]

- 2-stage experimental rocket
  1. Separation module with airbrakes built in PMI (Master Innovation Project)
  2. Realization of two rockets with Pro-54/Pro-24
  3. Sensors, on-board electronics...
  4. Cansat: Training new members

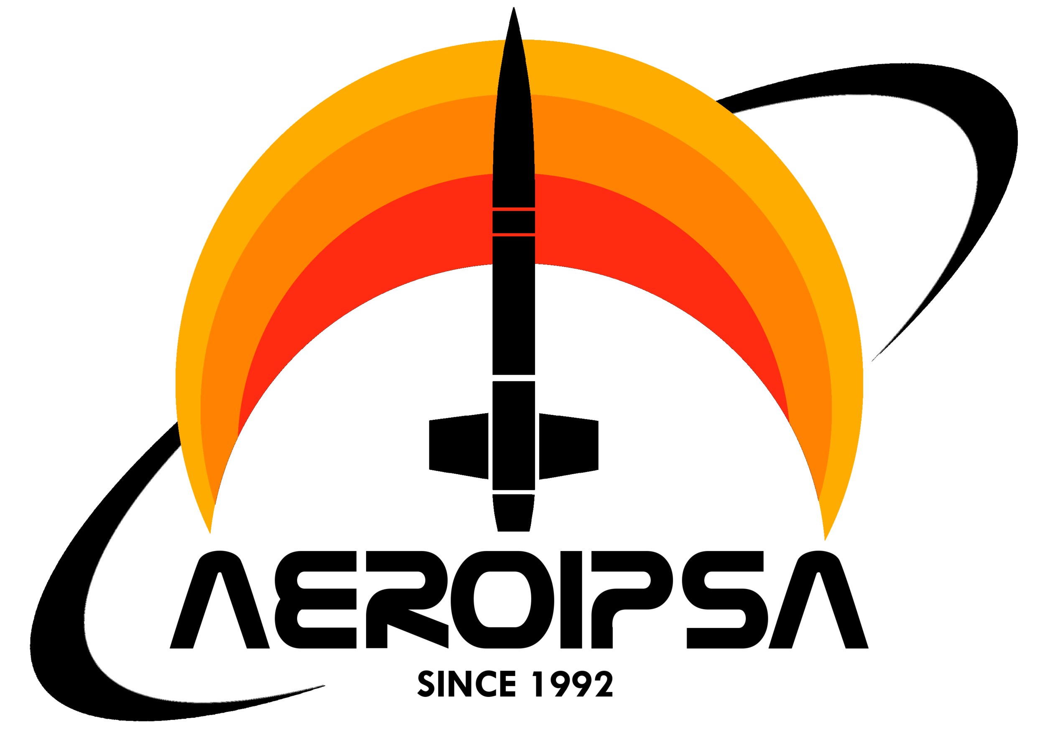
[picture p44: figure]

## SP-02

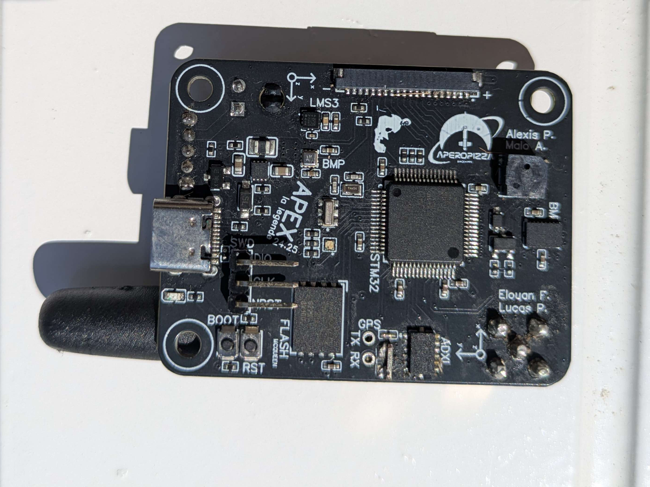
[picture p45: figure]

- Réalisation du projet
  - Tâches sur l’ensemble de l’année pour tout le monde
  - Projet ouvert à toutes et tous
  - Équipe complète entre 15 et 20 membres

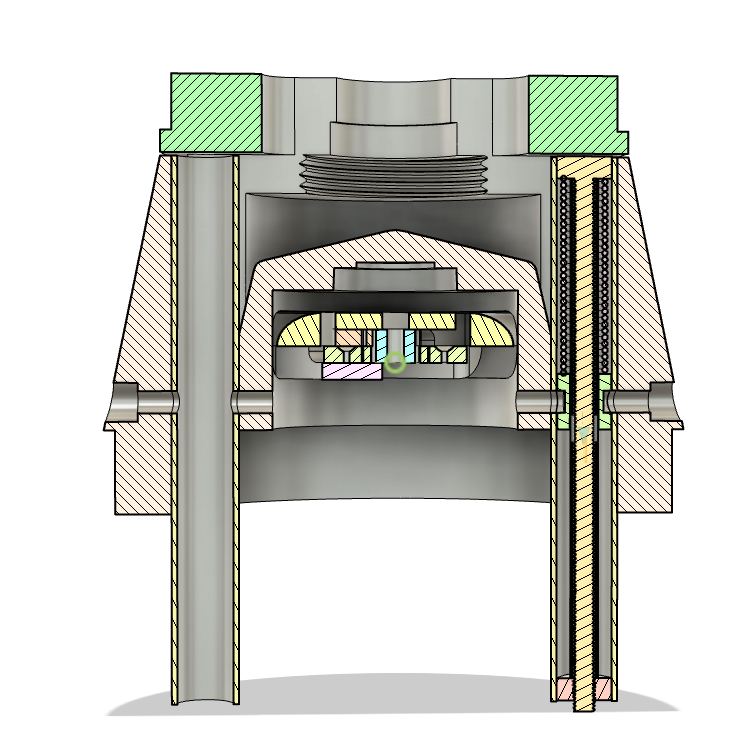
[picture p46: figure]

- Project implementation
  - Year-round tasks for everyone
  - Project open to all students
  - Full team of 15 to 20 members

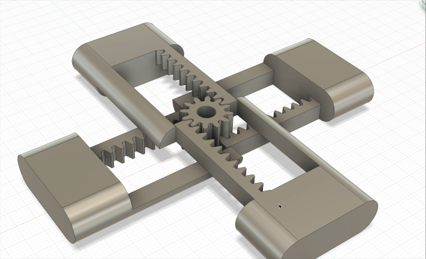
[picture p47: figure]
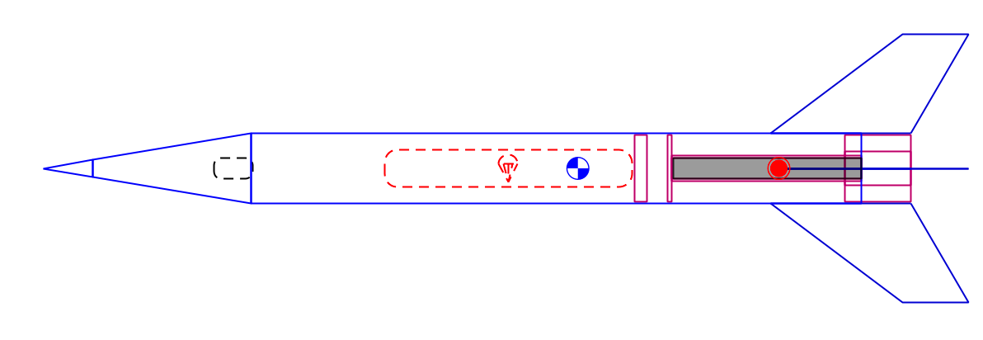
[picture p48: figure]
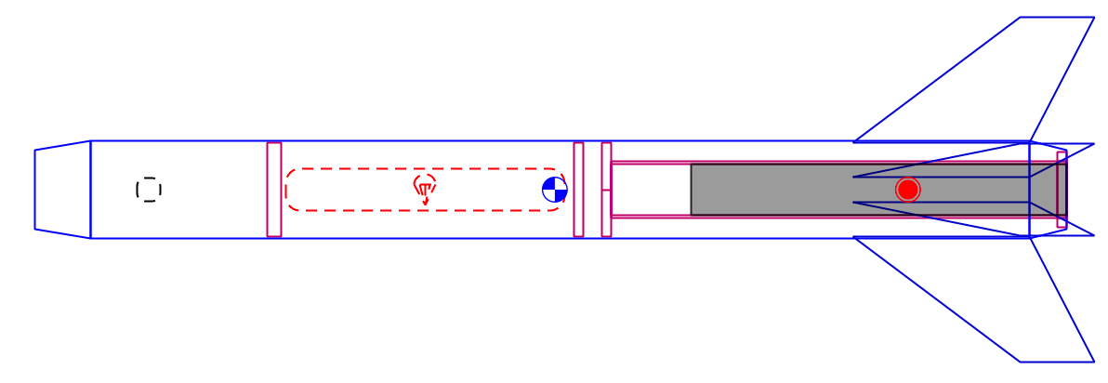
[picture p49: figure]
