povdoigt/SP-02/SYSTEME.pptx

CANSAT

MESURES

CTRL AF

CAMERA

SEQUENCEUR

TRAPPE PARA

(jack)

MOTEUR

ALLUMEUR

SEQUENCEUR

SEPA CANSAT

INTERFACE CANSAT

CAMERA

MESURES

AERO
FREIN

SEPA

TRAPPE PARA

## Slide 2

SEQ_2E

SEQ_2E
