povdoigt/SP-02/PMI/PMI_ET2_pres.pdf

# PMI

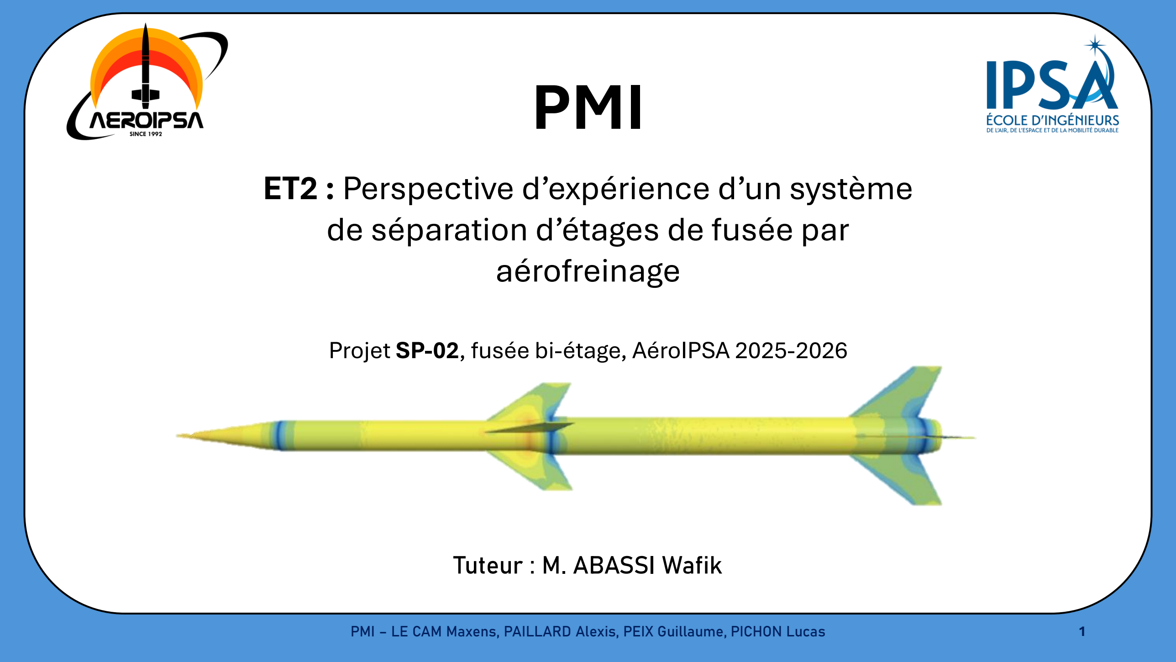
[picture p62: page 1]

## Tuteur : M. ABASSI Wafik

PMI – LE CAM Maxens, PAILLARD Alexis, PEIX Guillaume, PICHON Lucas | 1

# ET2 : Perspective d’expérience d’un système de séparation d’étages de fusée par aérofreinage

# Projet SP-02, fusée bi-étage, AéroIPSA 2025-2026

# Contexte - État de l’art - Notre proposition - Le projet SP-02 Objectifs Conception - Aérofreins - Séparation APEX Études - Aérodynamique CFD - Structurelle FEM

2

# Sommaire

PMI – LE CAM Maxens, PAILLARD Alexis, PEIX Guillaume, PICHON Lucas

# Contexte État de l’art

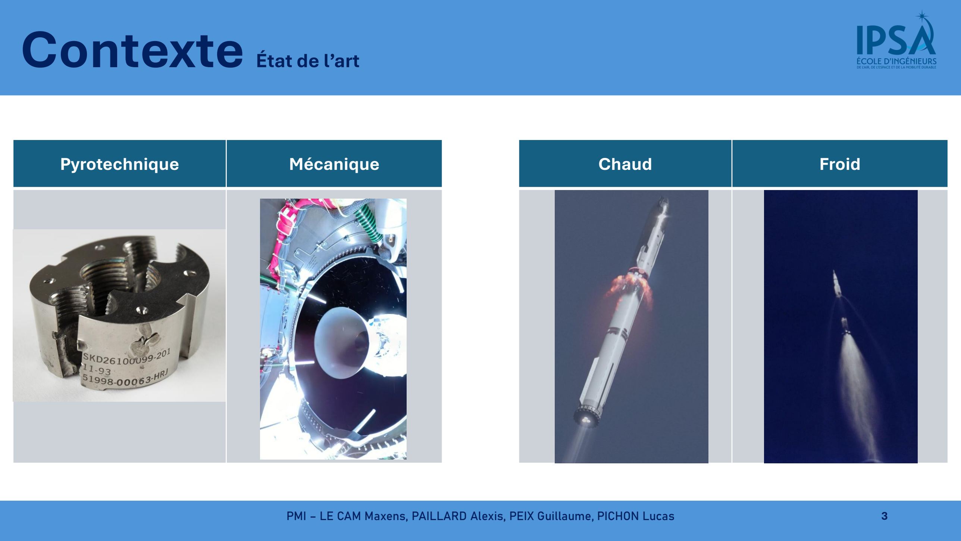
[picture p63: page 3]

3

Pyrotechnique | Mécanique | Chaud | Froid

5

# Contexte Notre proposition

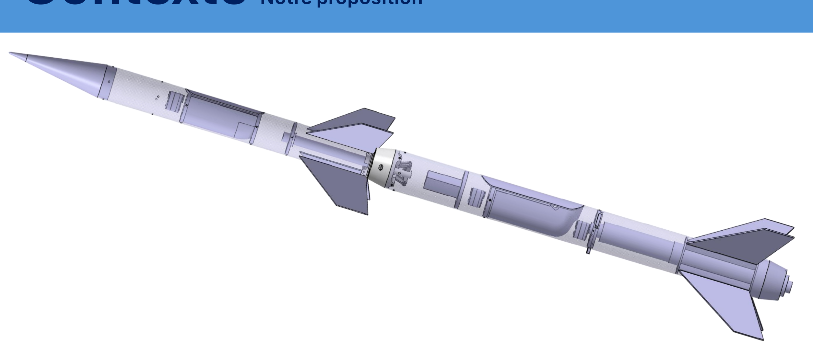
[picture p64: figure]

6

# Contexte Notre proposition

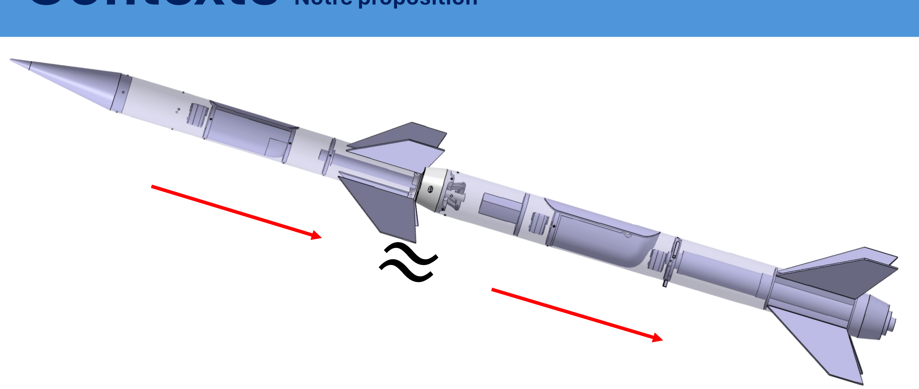
[picture p65: figure]

7

# Contexte Notre proposition

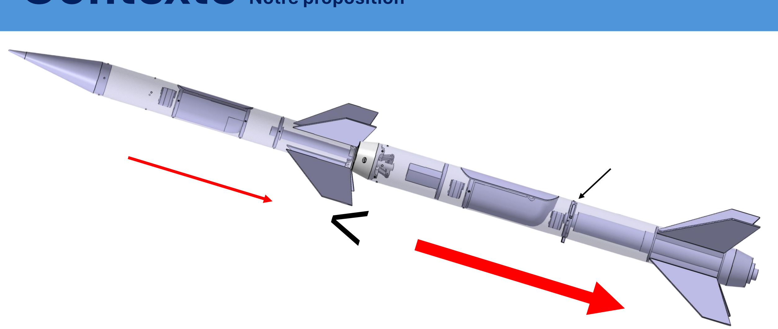
[picture p66: figure]

# Contexte Notre proposition

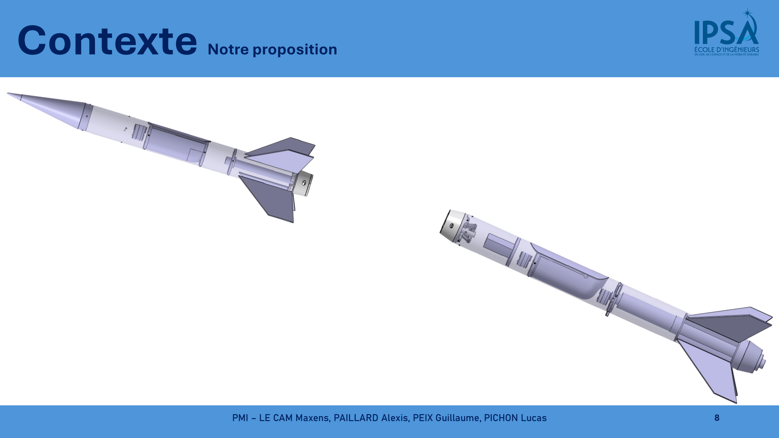
[picture p67: page 7]

PMI – LE CAM Maxens, PAILLARD Alexis, PEIX Guillaume, PICHON Lucas | 8

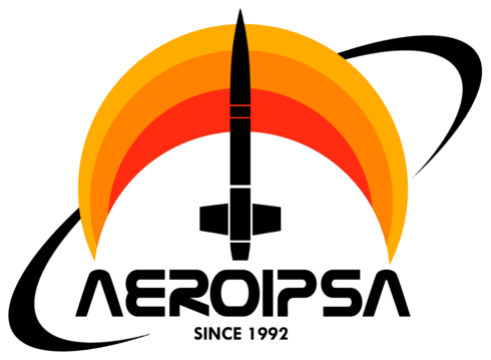
[picture p68: figure]
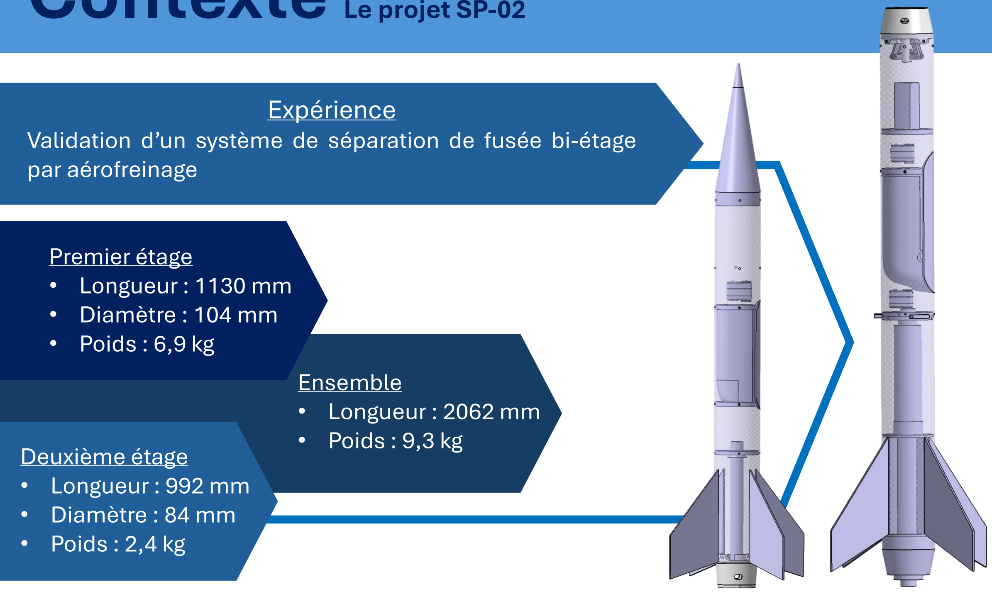
[picture p69: figure]
Expérience; par aérofreinage; Ensemble • Longueur : 2062 mm • Poids : 9,3 kg; Premier étage • Longueur : 1130 mm • Diamètre : 104 mm • Poids : 6,9 kg; Deuxième étage • Longueur : 992 mm • Diamètre : 84 mm • Poids : 2,4 kg

# Validation d’un système de séparation de fusée bi-étage

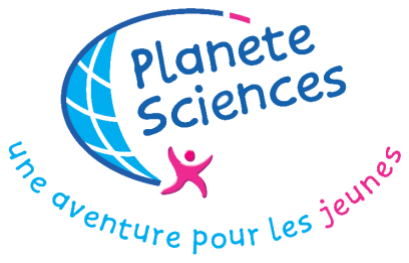
[picture p70: figure]
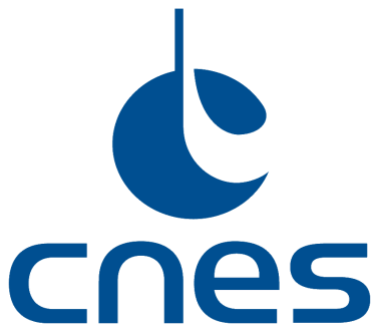
[picture p71: figure]

9

# Contexte Le projet SP-02

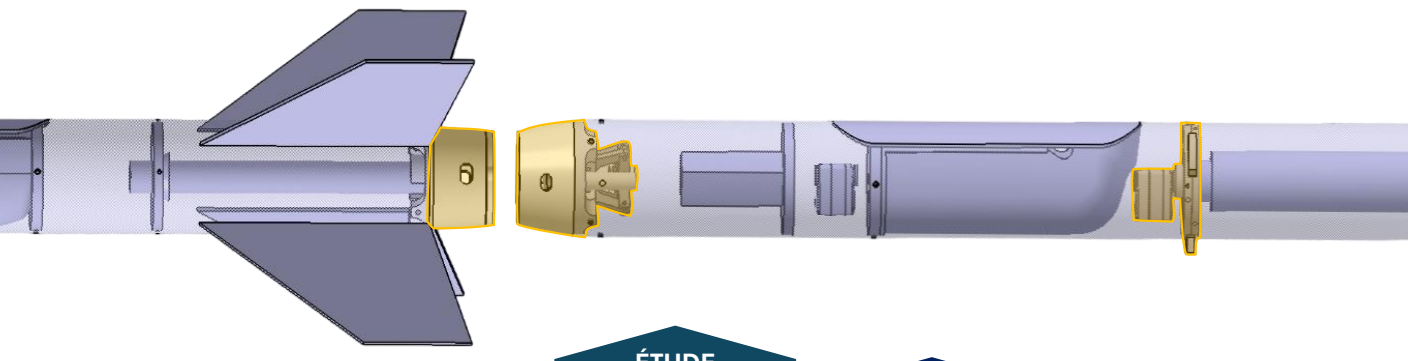
[picture p72: figure]

# CONCEPTION ELECTRONIQUE

# ÉTUDE AERODYNAMIQUE

# Objectifs

# CONCEPTION

MECANIQUE | ÉTUDE
| STRUCTURELLE
PMI – LE CAM Maxens, PAILLARD Alexis, PEIX Guillaume, PICHON Lucas | 10

# CONCEPTION Aérofreins

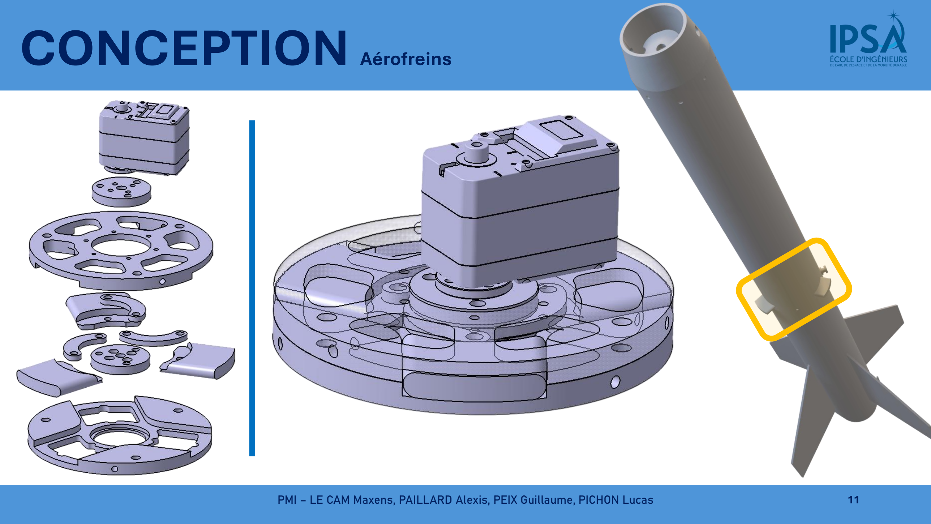
[picture p73: page 10]

PMI – LE CAM Maxens, PAILLARD Alexis, PEIX Guillaume, PICHON Lucas | 11

# CONCEPTION Aérofreins

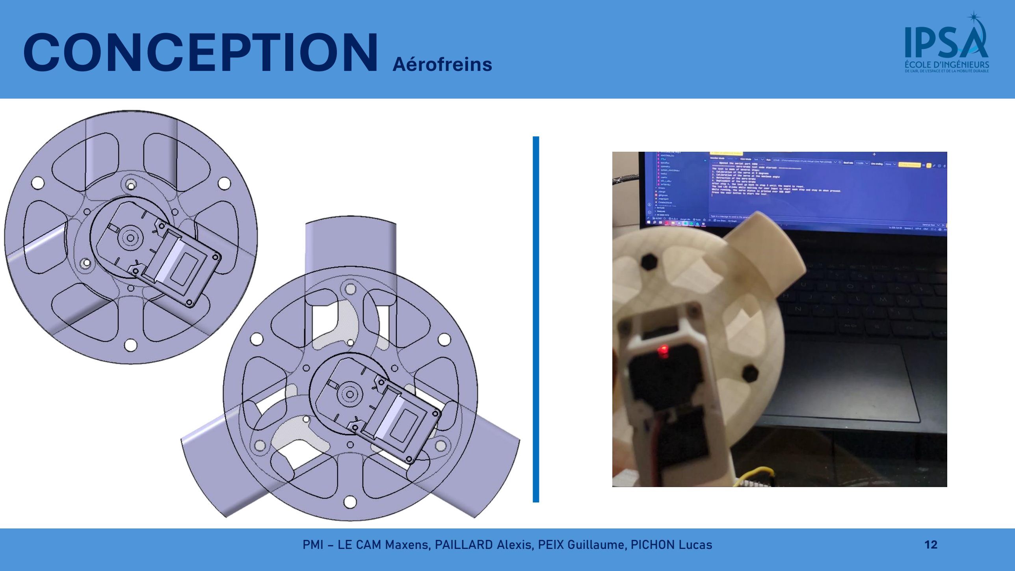
[picture p74: page 11]

PMI – LE CAM Maxens, PAILLARD Alexis, PEIX Guillaume, PICHON Lucas | 12

# CONCEPTION Séparation

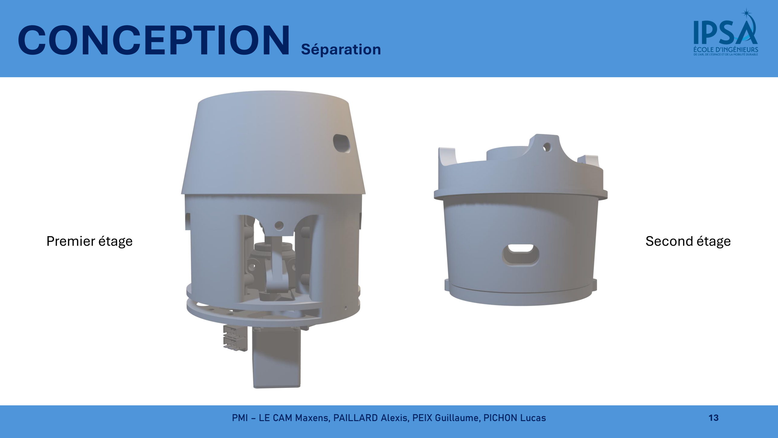
[picture p75: page 12]

PMI – LE CAM Maxens, PAILLARD Alexis, PEIX Guillaume, PICHON Lucas | 13
Premier étage | Second étage

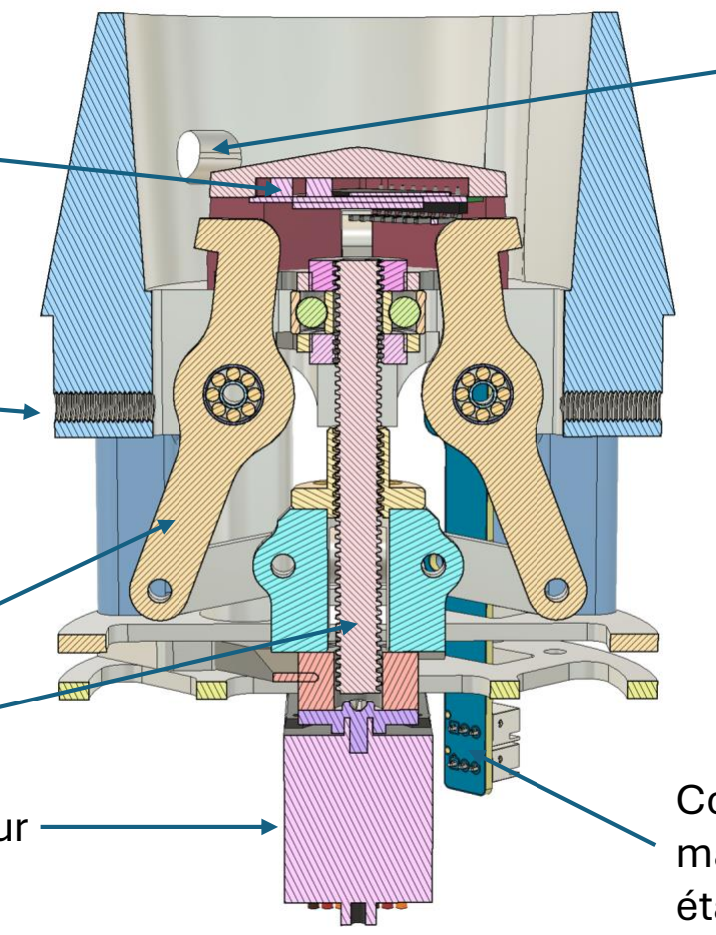
[picture p76: figure]
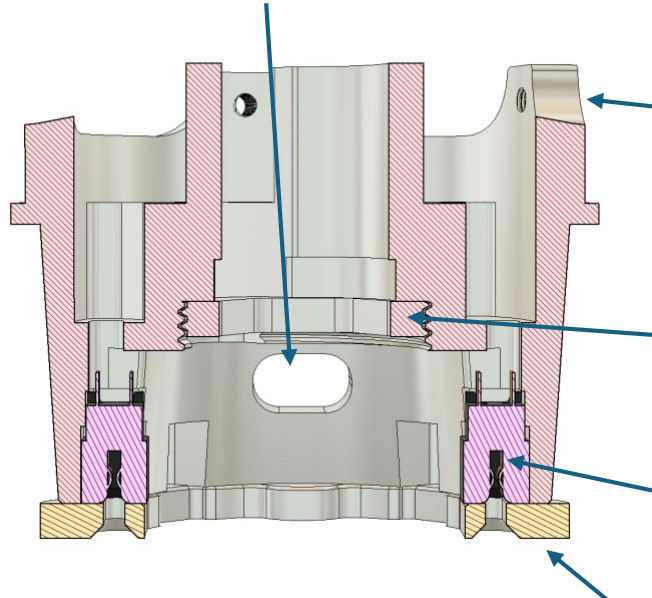
[picture p77: figure]

PMI – LE CAM Maxens, PAILLARD Alexis, PEIX Guillaume, PICHON Lucas | 14

# CONCEPTION Séparation

## Points d’attaches avec la structure

## Servo moteur

## Loquets

## Bague de retenue des étages

## Bague de retenue moteur

## Points d’attaches avec la structure

## Connecteurs femelle élec inter-étages

## Caméra

## Connecteurs males élec inter-étages

## Vis sans fin

## Évent en cas d’allumage intempestif du moteur

# APEX

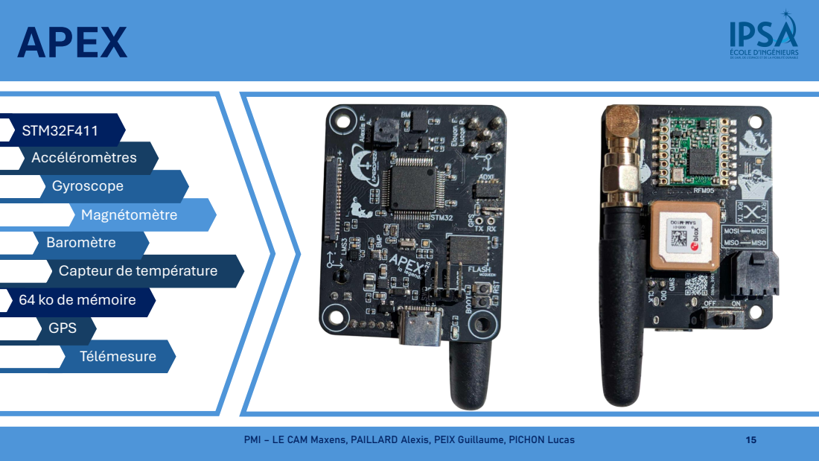
[picture p78: page 14]
Télémesure; GPS; 64 ko de mémoire; Capteur de température; Baromètre; Magnétomètre; Gyroscope; PMI – LE CAM Maxens, PAILLARD Alexis, PEIX Guillaume, PICHON Lucas; Accéléromètres; STM32F411

# APEX

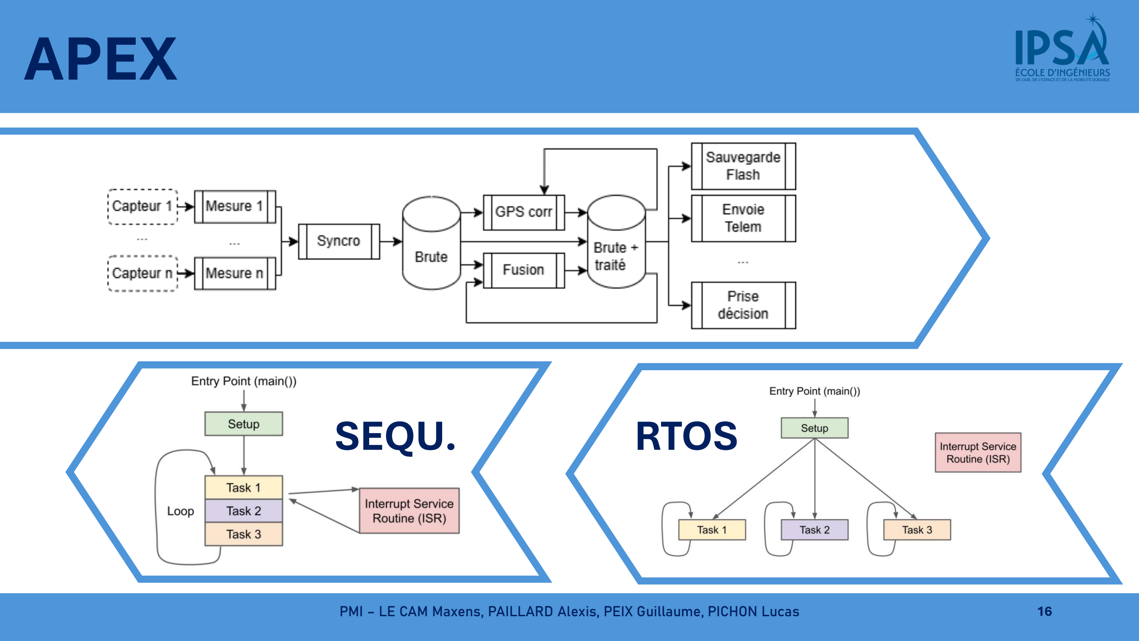
[picture p79: page 15]

PMI – LE CAM Maxens, PAILLARD Alexis, PEIX Guillaume, PICHON Lucas | 16
SEQU. | RTOS

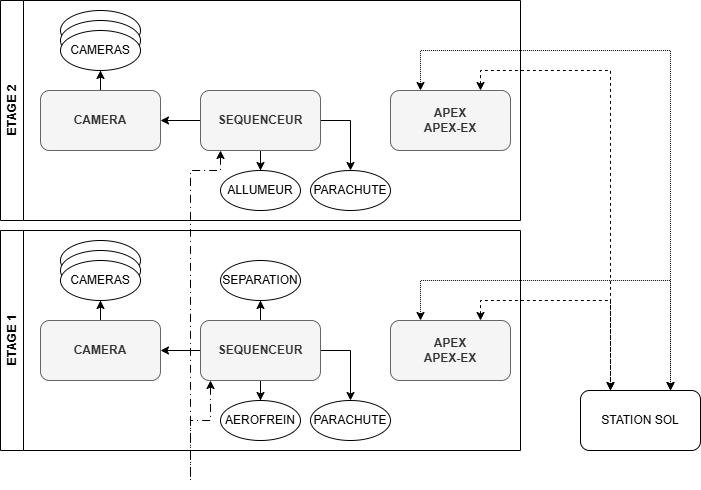
[picture p80: figure]
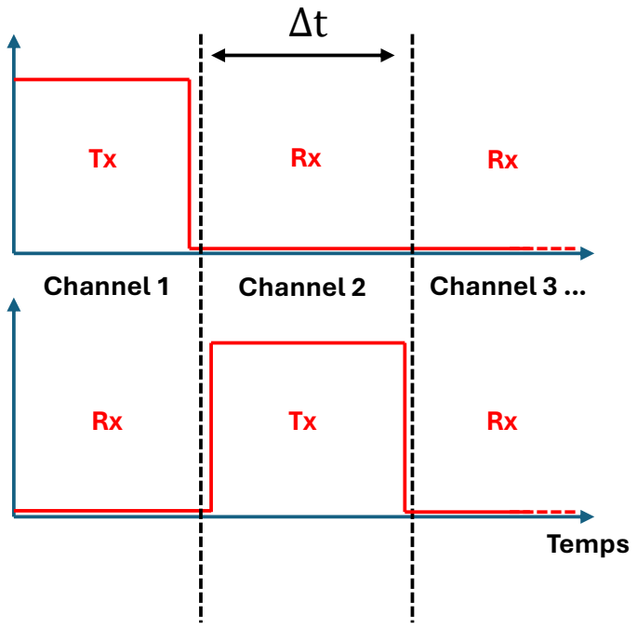
[picture p81: figure]
Channel 1; Channel 2; Channel 3 …; Temps

PMI – LE CAM Maxens, PAILLARD Alexis, PEIX Guillaume, PICHON Lucas | 17

# APEX

### Puissance

# APEX

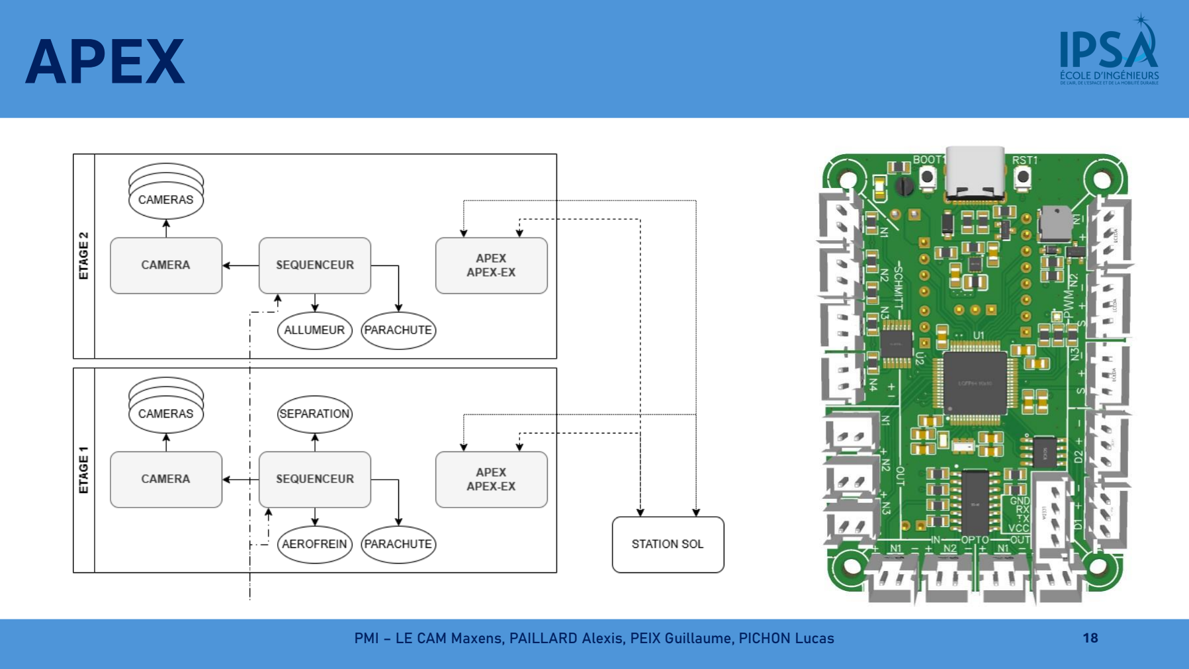
[picture p82: page 17]

PMI – LE CAM Maxens, PAILLARD Alexis, PEIX Guillaume, PICHON Lucas | 18

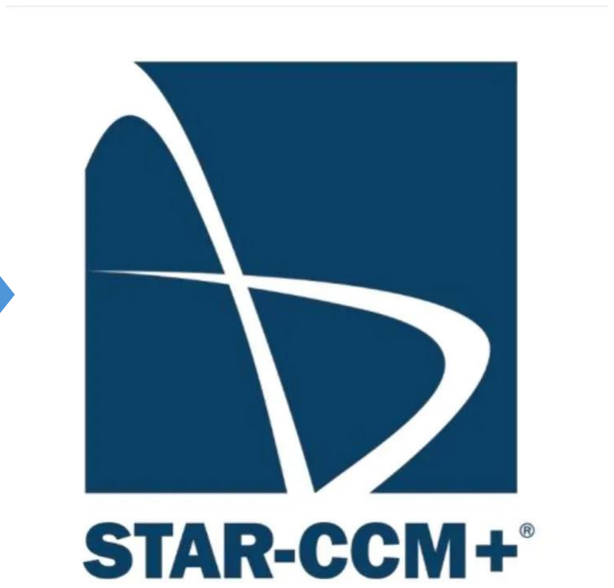
[picture p83: figure]

19

# Pourquoi réaliser une analyse CFD ?

# Nous voulons : - Évaluer le comportement aérodynamique - Quantifier l’effet des aérofreins - Valider la faisabilité avant expérimentation

# Comment ? En analysant l’influence du taux d’ouverture des AF sur la traînée

# La CFD est un outil de validation de concept

# ÉTUDE Aérodynamique

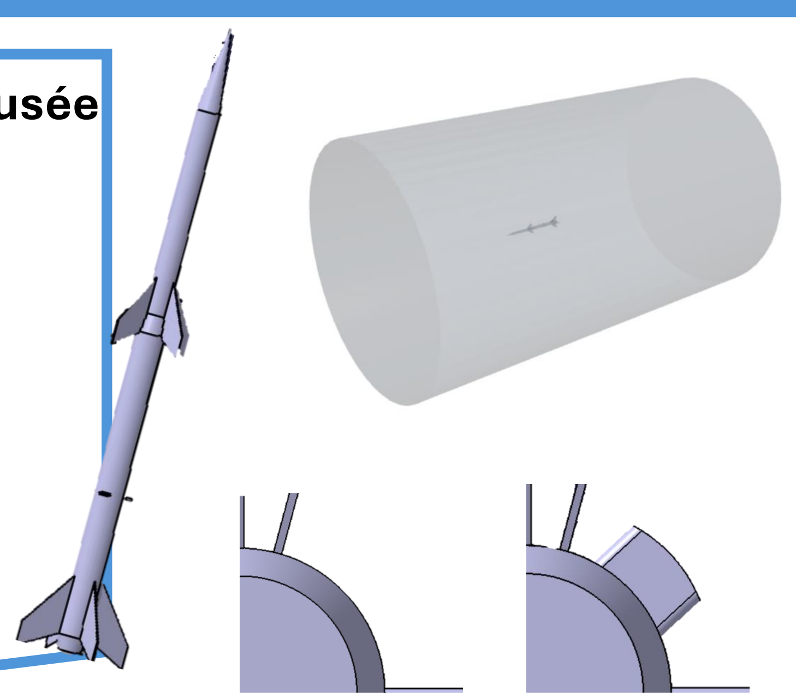
[picture p84: figure]

20

# - Maquette CAO simplifiée

# - Suppression des irrégularités (sillons, défauts de fabrication)

# - Géométrie fidèle aux dimensions globales

# - Réduction du temps de calcul

# - Résultats aérodynamiques non dénaturés

# Modélisation de la maquette de la fusée

# ÉTUDE Aérodynamique

21

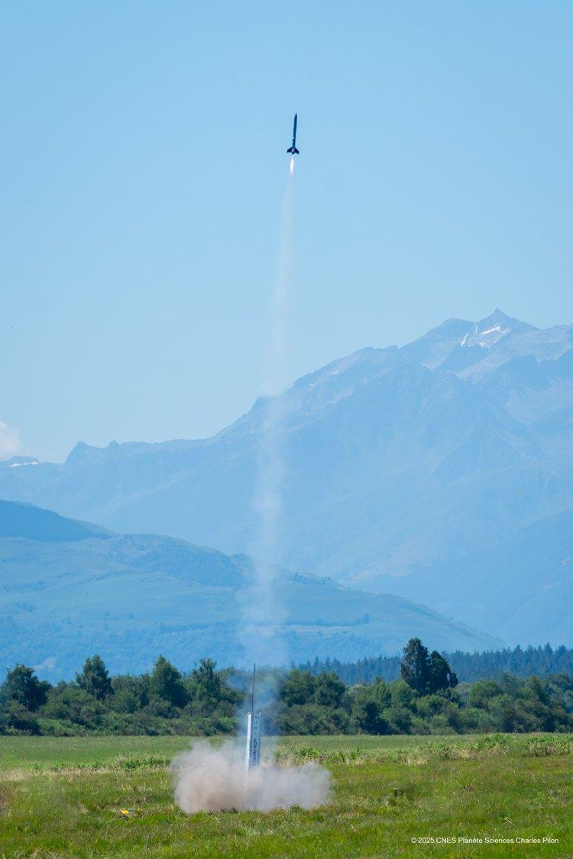
[picture p85: figure]

# Hypothèses de vol : Vitesse : 191,9 m/s Régime subsonique

# Conditions atmosphériques : Pression : 0,915 bar Densité atmosphérique : 1,12 kg·m⁻³ Température : 282,15 K

# Modélisation de l’environnement et conditions de vol

# ÉTUDE Aérodynamique

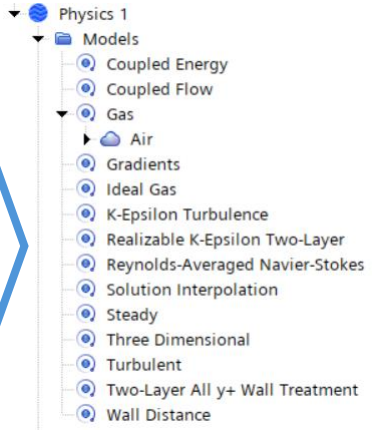
[picture p86: figure]

22

# Équations résolues : - Navier–Stokes moyennées (RANS)

# Hypothèses : - écoulement turbulent - incompressible / faiblement compressible

# Modèle de turbulence : - k–ε réalisable, two-layer

# Choix d’un calcul stationnaire (steady) :

- recherche d’efforts moyens,

# - non prise en compte des fluctuations instationnaires

# Description du modèle physique CFD

# ÉTUDE Aérodynamique

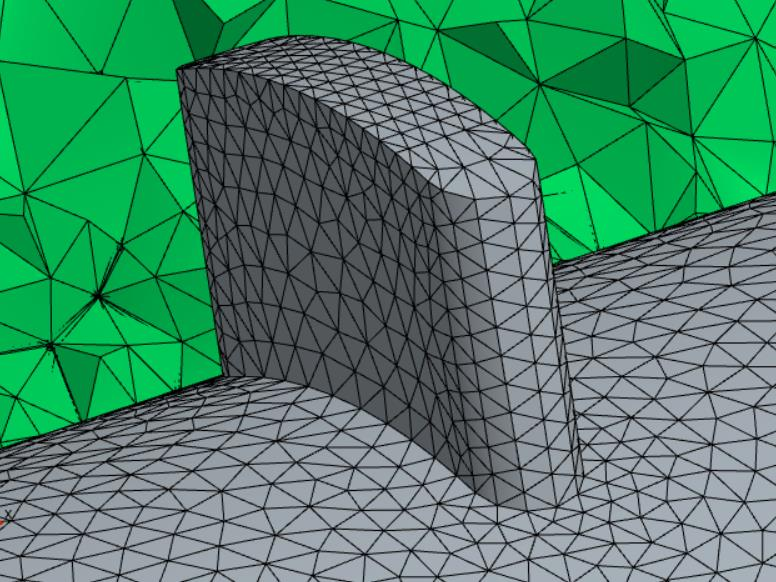
[picture p87: figure]
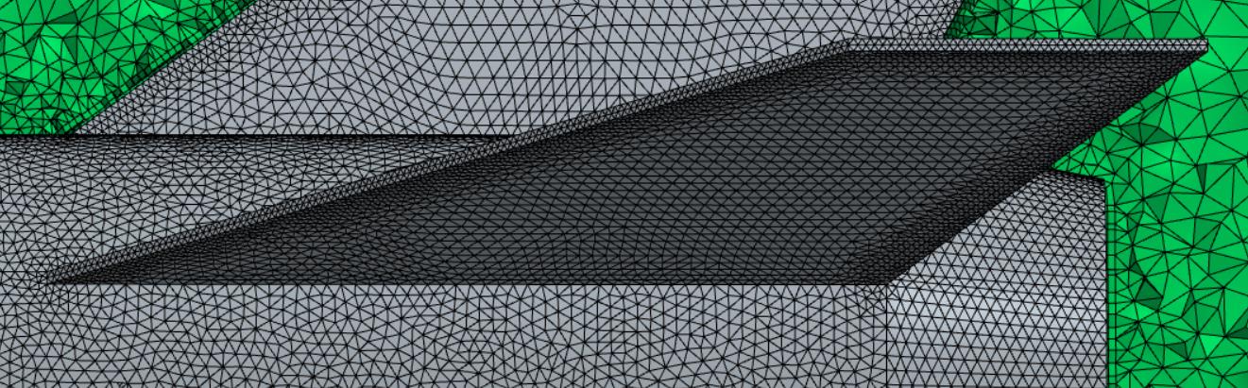
[picture p88: figure]

23

# Domaine d’étude : - cylindre (14 m de long, 4 m de rayon) - taille suffisante pour éviter l’influence des bords

# Maillage : - raffinement local autour de la fusée - maillage plus fin au niveau des aérofreins et des ailerons

# Custom Controls : - contrôle de la taille des mailles - surface growth rate = 1,15

# Nombre total de cellules ≈ 4,6 millions

# Géométrie du domaine et stratégie de maillage

# ÉTUDE Aérodynamique

# Résultats et Interprétation

# ÉTUDE Aérodynamique

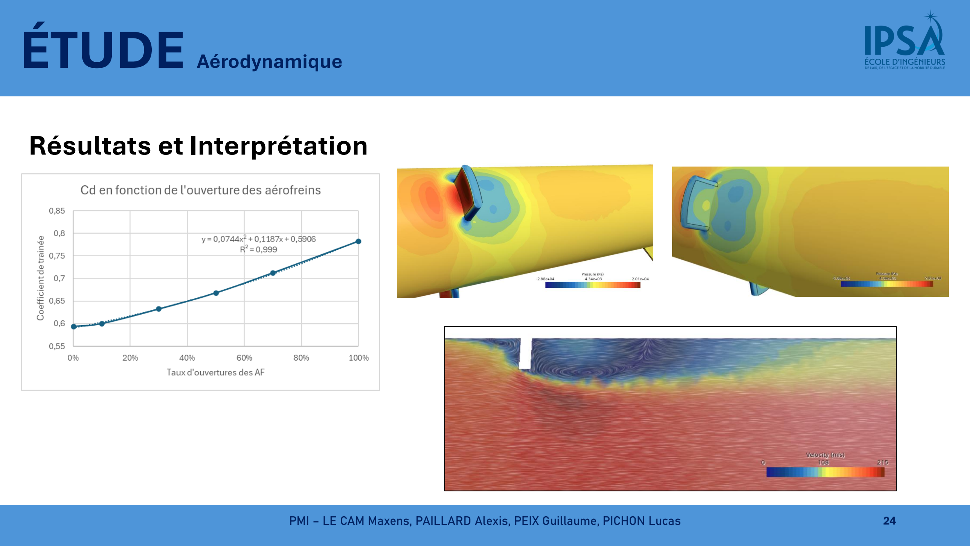
[picture p89: page 23]

24

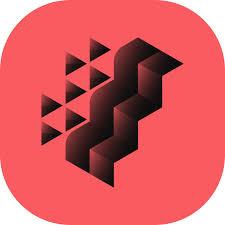
[picture p90: figure]

25

# Pourquoi réaliser une étude FEM ?

# Nous voulons : - Déterminer les zones susceptibles de casser - Valider la conception du système

# Comment ? En définissant les forces appliquées et vérification par simulation numérique

# ÉTUDE Structurelle

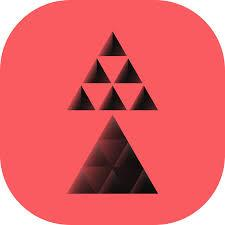
[picture p91: figure]

Patran | Nastran

# Définition des pièces d’étude

# ÉTUDE Structurelle

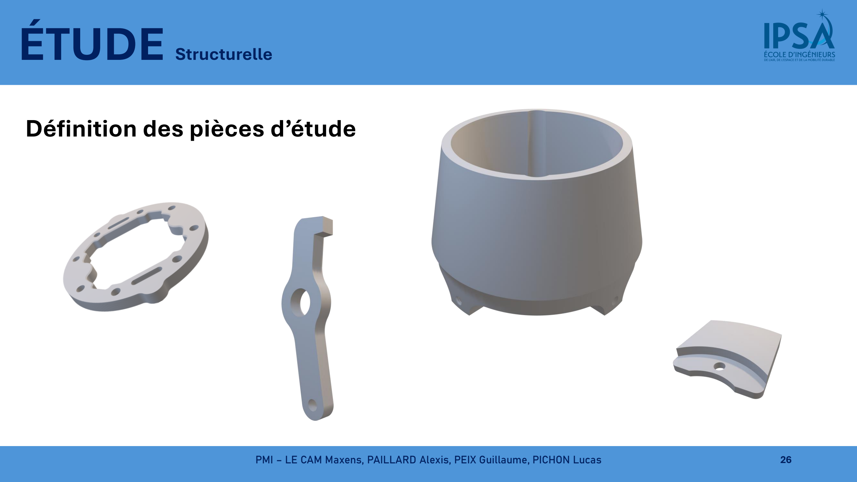
[picture p92: page 25]

26

# Définition des paramètres de simulation

# ÉTUDE Structurelle

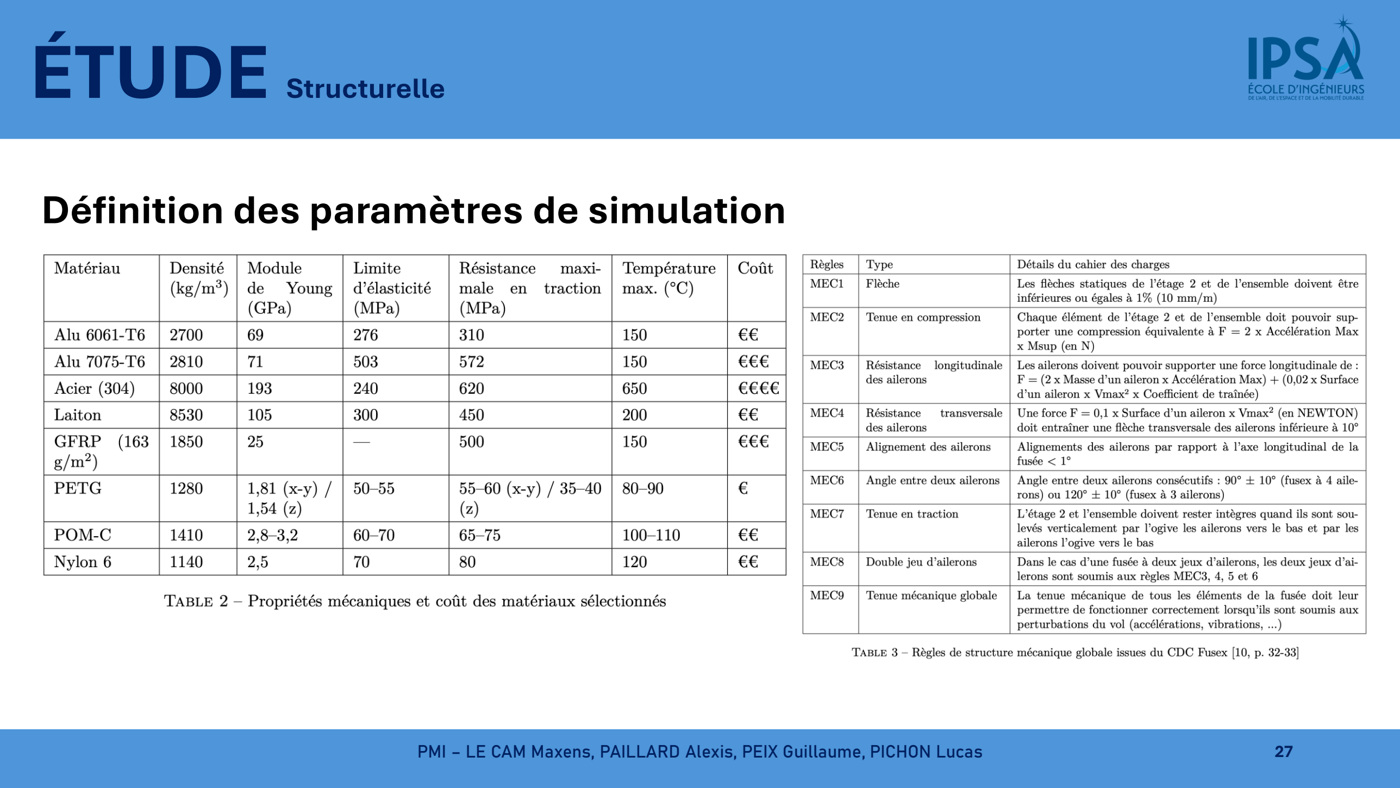
[picture p93: page 26]

27

# Simulations numériques

# ÉTUDE Structurelle

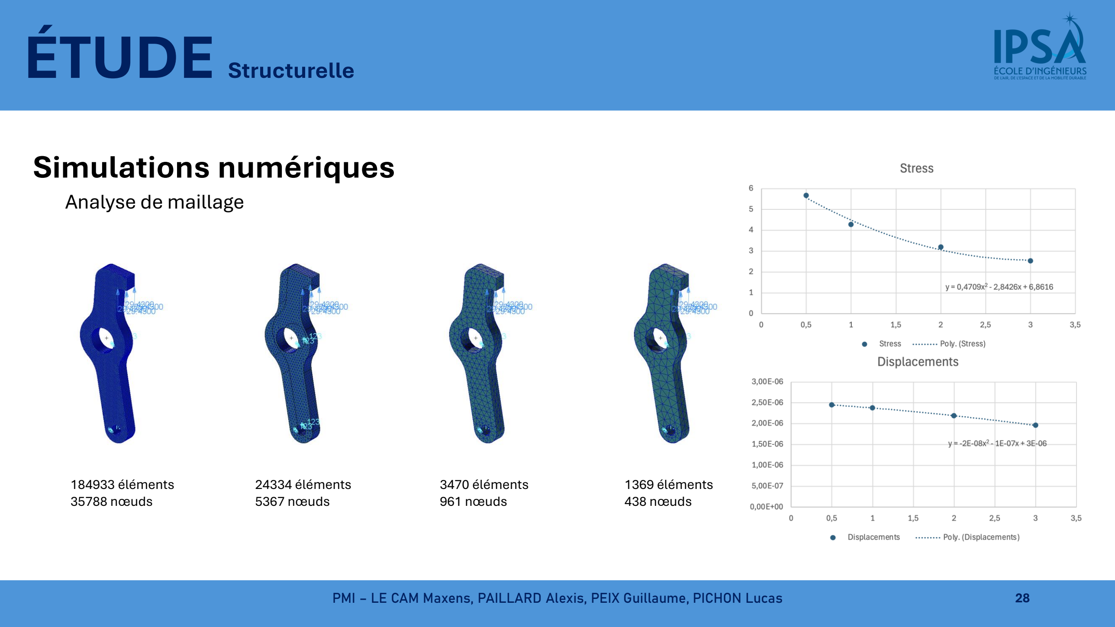
[picture p94: page 27]

28

### 3470 éléments 961 nœuds

### 24334 éléments 5367 nœuds

### 1369 éléments 438 nœuds

# Analyse de maillage

### 184933 éléments 35788 nœuds

# Simulations numériques

# ÉTUDE Structurelle

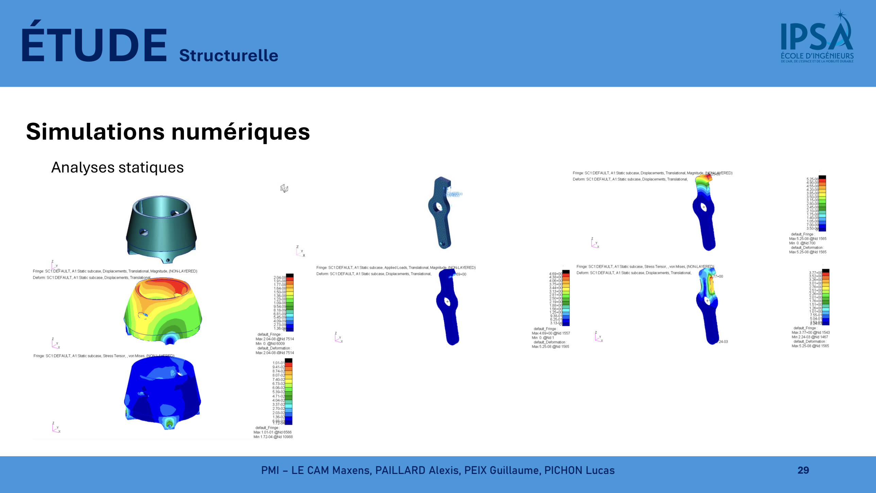
[picture p95: page 28]

29

# Analyses statiques

30

# Simulations numériques

# ÉTUDE Structurelle

# Analyses modales

fm,n =

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
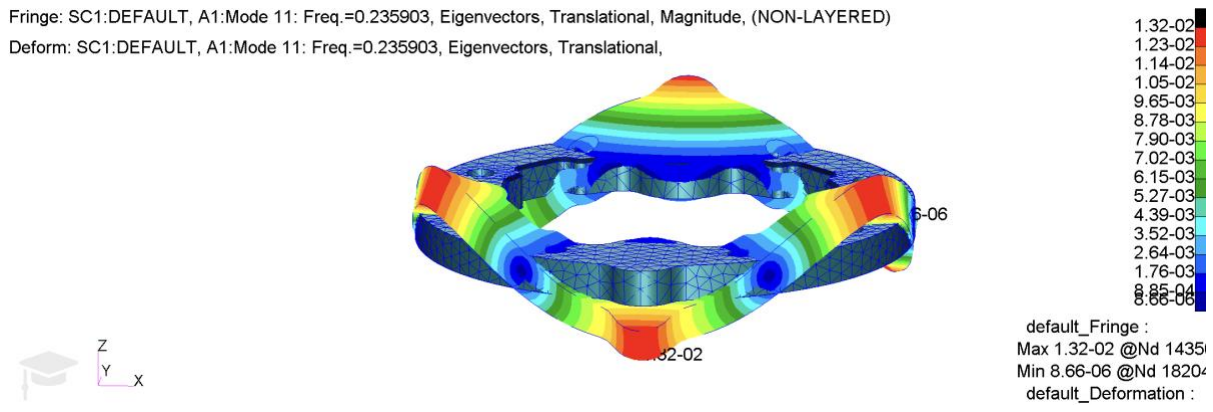
[picture p96: figure]

# Conclusion

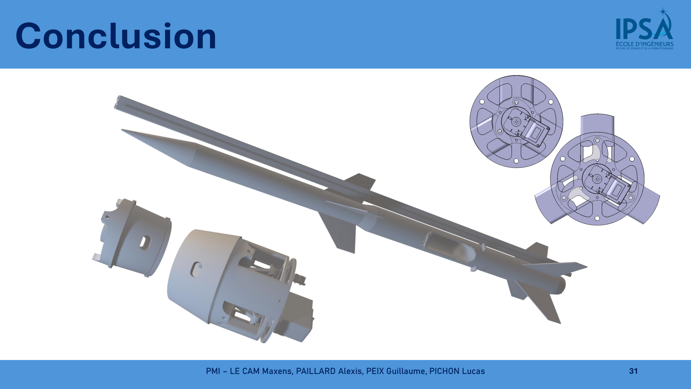
[picture p97: page 30]

PMI – LE CAM Maxens, PAILLARD Alexis, PEIX Guillaume, PICHON Lucas | 31
