povdoigt/SP-02/RAPPORT/PRESENTATION PROJET/alpha.xlsx

Sheet: Stabilito
 |  | STABILITO |  |  |  |  |  |  |  | Language/Langue | Français
 |  | Stabilité de fusée à ailerons |  |  |  |  |  |  |  |  | Plusieurs diamètres.
 |  |  |  |  |  |  |  |  |  |  | Transition A |  | Transition B
 |  | Remplir les cases jaunes |  |  |  |  |  |  |  | Longueur 'L' | 60 mm |  | 40 mm
 |  | Fusée |  |  |  |  |  |  |  | Diamètre 'D1' | 84 mm |  | 104 mm
 | Nom | SP02 |  |  |  |  |  |  |  | Diamètre 'D2' | 104 mm |  | 84 mm
 | Club | L'AéroIPSA |  |  |  |  |  |  |  | Implantation 'x' | 1 mm |  | 1060 mm
 | Matricule | FX | 0 | FX0
 | Type | Fusée expérimentale. |  |  |  |  |  |  |  |  | Propu plein | Propu vide |  | Sans propu |  |  | Propulseur
 | Masse | 4759 g | avec propu vide |  |  |  |  |  |  | Masse propu | 1.632 kg | 0.65 kg |  | - |  | Haut | 612 mm
 | Centre de Masse | 368 mm | avec propu vide |  |  |  |  |  |  | CdM propu | 250 mm | 240 mm |  | - |  | Longueur | 488 mm
 | Longueur totale | 1110 mm |  |  |  |  |  |  |  | Masse fusée | 5.741 kg | 4.759 kg |  | 4.109 kg |  | Bas | 1100 mm
 | Diamètre Réf. | 104 mm |  |  |  |  |  |  |  | CdM fusée | 453.6310747 mm | 368 mm |  | 291.4363592 mm
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
