povdoigt/SP-02/RAPPORT/PRESENTATION PROJET/alpha_beta.xlsx

Sheet: Stabilito
 |  | STABILITO |  |  |  |  |  |  |  | Language/Langue | Français
 |  | Stabilité de fusée à ailerons |  |  |  |  |  |  |  |  | Plusieurs diamètres.
 |  |  |  |  |  |  |  |  |  |  | Transition A |  | Transition B
 |  | Remplir les cases jaunes |  |  |  |  |  |  |  | Longueur 'L' | 60 mm |  | 40 mm
 |  | Fusée |  |  |  |  |  |  |  | Diamètre 'D1' | 84 mm |  | 104 mm
 | Nom | SP02 |  |  |  |  |  |  |  | Diamètre 'D2' | 104 mm |  | 84 mm
 | Club | L'AéroIPSA |  |  |  |  |  |  |  | Implantation 'x' | 990 mm |  | 2060 mm
 | Matricule | FX | 0 | FX0
 | Type | Fusée expérimentale. |  |  |  |  |  |  |  |  | Propu plein | Propu vide |  | Sans propu |  |  | Propulseur
 | Masse | 8080 g | sans propu |  |  |  |  |  |  | Masse propu | 1.632 kg | 0.65 kg |  | - |  | Haut | 1602 mm
 | Centre de Masse | 1100 mm | sans propu |  |  |  |  |  |  | CdM propu | 250 mm | 240 mm |  | - |  | Longueur | 488 mm
 | Longueur totale | 2100 mm |  |  |  |  |  |  |  | Masse fusée | 9.712 kg | 8.73 kg |  | 8.08 kg |  | Bas | 2090 mm
 | Diamètre Réf. | 97.33333333 mm |  |  |  |  |  |  |  | CdM fusée | 1226.365733 mm | 1155.246277 mm |  | 1100 mm
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
