povdoigt/SP-02/RAPPORT/PRESENTATION PROJET/beta.xlsx

Sheet: Stabilito
 |  | STABILITO |  |  |  |  |  |  |  | Language/Langue | Français
 |  | Stabilité de fusée à ailerons |  |  |  |  |  |  |  |  | Plusieurs diamètres.
 |  |  |  |  |  |  |  |  |  |  | Transition A |  | Transition B
 |  | Remplir les cases jaunes |  |  |  |  |  |  |  | Longueur 'L' | 0 mm |  | 0 mm
 |  | Fusée |  |  |  |  |  |  |  | Diamètre 'D1' | 0 mm |  | 0 mm
 | Nom | SP02-Alpha |  |  |  |  |  |  |  | Diamètre 'D2' | 0 mm |  | 0 mm
 | Club | L'AéroIPSA |  |  |  |  |  |  |  | Implantation 'x' | 0 mm |  | 0 mm
 | Matricule | MF | 0 | MF0
 | Type | Minifusée |  |  |  |  |  |  |  |  | Propu plein | Propu vide |  | Sans propu |  |  | Propulseur
 | Masse | 3321 g | sans propu |  |  |  |  |  |  | Masse propu | 0.1599 kg | 0.0843 kg |  | - |  | Haut | 762 mm
 | Centre de Masse | 645 mm | sans propu |  |  |  |  |  |  | CdM propu | 114 mm | 114 mm |  | - |  | Longueur | 228 mm
 | Longueur totale | 1050 mm |  |  |  |  |  |  |  | Masse fusée | 3.4809 kg | 3.4053 kg |  | 3.321 kg |  | Bas | 990 mm
 | Diamètre Réf. | 84 mm |  |  |  |  |  |  |  | CdM fusée | 655.6113074 mm | 650.718527 mm |  | 645 mm
 |  |  |  |  |  |  |  |  |  |  |  |  |  |  |  |  | Ailerons bas
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
