povdoigt/SP-02/IMPRESSION/impression_top_secret _V2/README.txt

Il faut imprimer :
- x1 SP02_ALPHA_SEPA_PRINCIPAL
- x2 SP02_ALPHA_SEPA_ROULETTE
- x1 SP02_ALPHA_SEPA_COUPLEUR
- x3 SP02_ALPHA_SEPA_LOQUET_PRINCIPAL
- x3 SP02_ALPHA_SEPA_LOQUET_RESSORT
- x3 SP02_ALPHA_SEPA_TIGE_RESSORT
- x3 SP02_ALPHA_SEPA_RONDELLE_RESSORT
- x1 SP02_BETA_SEPA_PRINCIPAL_v2
- x1 SP02_BETA_BAGUE_PROPU

le tout en une fois, 10% de remplissage "grille" et avec supports et bordures

j'ai fait un g_code aussi, normalement il est bon maiiiiiiiiis on ne sait jamais
