povdoigt/SP-02/RAPPORT/DOSSIER SUIVI/sections/Introduction.tex

\section*{Introduction}
\addcontentsline{toc}{section}{\protect\numberline{}Introduction}
\label{sec:introduction}

Ce document constitue le document de définition du projet SP-02, développé par l’association AéroIPSA au sein de l’école
d’ingénieurs \acrshort{IPSA}. Il s’inscrit dans le cadre de la participation de l’association à la campagne nationale de
lancements \gls{C'Space} 2026, organisée par le \acrfull{CNES} et l’association \gls{Planète Sciences}, et répond aux exigences
du \acrfull{CDC} applicable aux \gls{Fusex} bi-étages \cite{CDC_BiEtage}.\\

Le projet SP-02 a pour objectif la conception, la réalisation, la qualification et le lancement d’une \gls{Fusex} bi-étage
intégrant deux axes principaux :
\begin{itemize}
    \item La mise en œuvre et la caractérisation d’une séparation inter-étage par freinage aérodynamique, envisagée comme
    alternative aux systèmes pyrotechniques ou autre mécanisme lourd comme des ressorts ou des systèmes pnematiques.
    \item La validation d’une architecture avionique embarquée dédiée à la mesure et à la télémesure des paramètres de vol
    (accélération, attitude, pression, altitude), ainsi qu’à la gestion des séquences critiques du lanceur.\\
\end{itemize}

Ce projet s’inscrit également dans un cadre académique : une partie de ses travaux est menée dans le cadre du \acrfull{PMI}
intitulé « Perspective d’expérience d’un système de séparation d’étages de fusée par aérofreinage ». Ce volet, encadré par
l'\acrshort{IPSA}, se concentre sur la conception, la modélisation et la validation expérimentale du système de séparation et
d’aérofreinage. Il constitue la composante scientifique et pédagogique du projet, tandis que le programme associatif SP-02 en
assure l’intégration globale et la mise en œuvre expérimentale jusqu’au vol.\\

Au-delà de la démonstration technique en vol, SP-02 constitue un support de formation et de mise en pratique des compétences des
étudiants dans les domaines de la mécanique, de l’électronique, du logiciel embarqué et de la gestion de projet. Le développement
du lanceur suit une démarche d’ingénierie système complète : définition des besoins, analyse fonctionnelle, conception mécanique
et électronique, intégration logicielle, essais et validation. Cette approche permet d’aborder l’ensemble des aspects techniques
du développement d’un lanceur bi-étage — structure, propulsion, récupération, avionique et sécurité — tout en respectant les
procédures de sûreté et de qualité imposées par le \acrshort{CNES} et \gls{Planète Sciences}.\\

L'association AéroIPSA a choisi ce projet comme projet de \gls{Fusex} principale pour la campagne 2026.\\

Le présent dossier synthétise l’état d’avancement du projet à la date de rédaction. Il est organisé comme suit :
\begin{enumerate}
    \item Présentation du contexte général du projet, le club AéroIPSA, l’équipe, le financement et la planification.
    \item Détail de l’analyse de sûreté de fonctionnement, la méthodologie retenue et les actions correctives associées.
    \item Description de la structure mécanique des deux étages et des systèmes de récupération.
    \item Description des systèmes électroniques présents tels que les séquenceurs, la ligne de mise à feu et l’expérience
    embarquée.
    \item Présentation de la matrice de validation vis-à-vis du \acrshort{CDC} et du registre des tests réalisés ou
    prévus.
\end{enumerate}

\newpage
