povdoigt/SP-02/RAPPORT/DOSSIER SUIVI/sections/ch5_elec/main.tex

\section{Electronique}
\label{sec:electronique}

Cette section présente les différents éléments électroniques embarqués à bord de la fusée SP-02. Nous y aborderons :
\begin{enumerate}
    \item La présentation générale du système électronique.
    \item Les séquenceurs.
    \item La ligne de mise à feu du moteur du deuxième étage.
    \item Les cartes d'expérience APEX et APEXeX.
    \item Le système de caméras embarquées.
    \item Les systèmes d'alimentation électriques.
\end{enumerate}

\input{sections/ch5_elec/subsec1_presentation.tex}
\input{sections/ch5_elec/subsec2_sequenceurs.tex}
\input{sections/ch5_elec/subsec3_ligne_mise_a_feu.tex}
\input{sections/ch5_elec/subsec4_apex.tex}
\input{sections/ch5_elec/subsec5_camera.tex}
\input{sections/ch5_elec/subsec6_Alimentation.tex}

\newpage
