povdoigt/SP-02/PMI/repport_FinalVersion/sections/2_Conception/main.tex

\section{Conception des systèmes de séparation et d’aérofrein}
\label{sec:conception}

\input{sections/2_Conception/1_Aerofrein.tex}
\input{sections/2_Conception/2_Separation.tex}
\input{sections/2_Conception/3_Electroniques.tex}
