povdoigt/SP-02/RAPPORT/DOSSIER SUIVI/sections/ch3_meca/subsec4_sys_sepa.tex

\subsection{Système de séparation}
\label{sec:sys_sepa}
