povdoigt/SP-02/PMI/repport/sections/annexe.tex

\includepdf[page=1, angle=90, scale=.75, offset=0 -40, pagecommand={
    \section{Annexes}
    \label{sec:annexes}
    \subsection{Plan mécaniques}
    \label{subsec:plan_aerofreins}
    \subsubsection{Plan mécanique de l'ensemble aérofreins}
}]{figures/SP02_ALPHA_AF_BLOC_DRAW.pdf}
\includepdf[page=2-, angle=90, scale=.85, pagecommand={}]{figures/SP02_ALPHA_AF_BLOC_DRAW.pdf}

\includepdf[page=1, angle=90, scale=.75, offset=0 -20, pagecommand={
    \subsubsection{Plan mécanique de la séparation inter-étage}
    \label{subsec:plan_separation}
}]{figures/Beta_sepa_principale_Calque_1.pdf}
\includepdf[page=2-, angle=90, scale=.85, pagecommand={}]{figures/Beta_sepa_principale_Calque_1.pdf}

\includepdf[page=-, angle=90, scale=.75, offset=0 -20, pagecommand={
    \subsubsection{Plan mécanique du crochet de trappe}
    \label{subsec:plan_crochet_trappe}
}]{figures/Beta_crochet_trappe.pdf}

\includepdf[page=-, angle=180, scale=.75, offset=0 -20, pagecommand={
    \subsubsection{Plan mécanique du système de maintien de la pointe de coiffe}
    \label{subsec:plan_maintien_pointe_coiffe}
}]{figures/Beta_maintien_pointe_coiffe.pdf}

\includepdf[page=-, angle=90, scale=.75, offset=0 -20, pagecommand={
    \subsubsection{Plan mécanique de la pointe de coiffe}
    \label{subsec:plan_pointe_coiffe}
}]{figures/Beta_pointe_coiffe.pdf}
