povdoigt/SP-02/PMI/repport_FinalVersion/sections/1_Contexte/3_Presentation_SP02.tex

\subsection{Présentation du lanceur SP02}
\label{sec:presentation_SP02}

\subsubsection{Cadre de lancement : le C’Space et ses contraintes}

Le développement du lanceur SP-02 s’inscrit dans le cadre de la campagne nationale \gls{C'Space}, organisée par
\gls{Planète Sciences} avec le soutien du \acrfull{CNES}. Cette campagne constitue aujourd’hui le principal, et pratiquement
l’unique, cadre de lancement accessible en France pour des projets de fusées expérimentales étudiantes. Elle fournit un
environnement réglementé permettant la réalisation d’essais en vol, sous réserve du respect d’un cahier des charges technique et
de sûreté particulièrement structurant.\\

La participation au \gls{C'Space} implique la conformité à un \acrfull{CDC} exigeant, couvrant notamment les aspects de sécurité
sol et vol, la robustesse des architectures retenues, la maîtrise des risques et la justification détaillée des choix techniques.
Les systèmes critiques du lanceur, en particulier ceux liés à la séparation d’étages, doivent ainsi faire l’objet d’analyses
documentées, d’essais préalables et d’une traçabilité complète. Certaines solutions, bien que pertinentes d’un point de vue
théorique ou industriel, peuvent se révéler difficilement compatibles avec ce cadre, notamment en raison des contraintes
réglementaires associées à l’utilisation de dispositifs pyrotechniques ou de mécanismes complexes.\\

Ce contexte impose également des contraintes fortes sur la philosophie de conception du lanceur. Le véhicule doit être
suffisamment simple et robuste pour garantir un niveau de sûreté acceptable, tout en restant instrumentable et exploitable du
point de vue expérimental. La reproductibilité des essais, la capacité à analyser les événements de vol et la récupération des
données constituent des critères déterminants dans l’évaluation des projets par les instances de suivi.\\

Ainsi, le cadre du \gls{C'Space} ne se limite pas à une opportunité de lancement, mais constitue un élément structurant de la
conception du lanceur SP-02. Les choix architecturaux retenus résultent directement de ce compromis entre exigences
réglementaires, contraintes opérationnelles et objectifs expérimentaux. La section suivante présente l’architecture générale du
lanceur SP-02, telle qu’elle a été définie pour répondre à ces contraintes tout en servant de support à l’étude de la séparation
d’étages assistée par aérofreinage.

\begin{figure}[h!]
    \centering
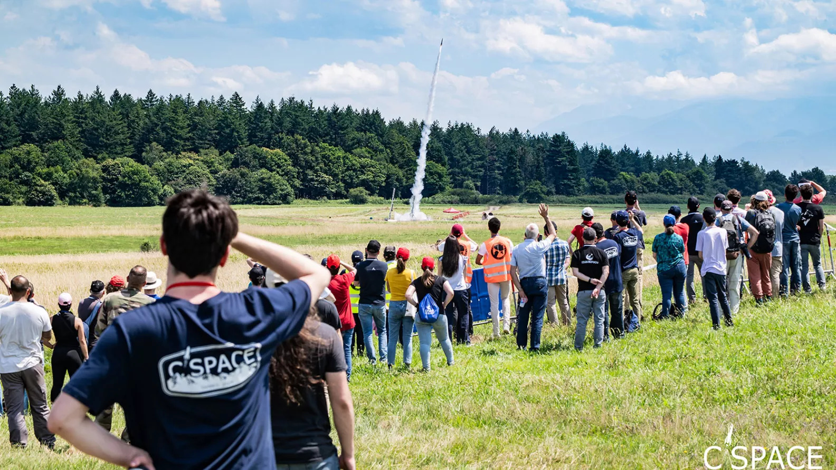
[picture p106: PMI/repport_FinalVersion/figures/cspace-2024-1.jpg]
    
    \caption{Décollage d'une fusée expérimentale au C'Space 2024. \copyright CNES/C'Space/Thomas Labois}
\end{figure}

\subsubsection{Objectif du lanceur SP-02}

La fusée SP-02 a été conçue comme un vecteur expérimental dédié, dont l’objectif principal est de générer des conditions de vol
représentatives d’un lanceur expérimental multi-étages, tout en permettant l’intégration, l’activation et l’observation de
plusieurs expériences embarquées directement liées à la séparation d’étages. À ce jour, l’association AéroIPSA dispose d’une
expérience limitée dans le domaine des lanceurs multi-étages. Le développement de SP-02 constitue ainsi un premier jalon visant
à acquérir des connaissances techniques et méthodologiques dans ce domaine, au bénéfice des membres de l’association.\\

Les expériences embarquées ont pour objectif principal de caractériser la séparation et d’en évaluer l’efficacité. Elles incluent
notamment la mise en place d’une capacité de mesure de la dynamique de séparation au moyen d’accéléromètres embarqués sur chaque
étage, complétée par une caméra embarquée permettant une observation visuelle de l’événement. Ces dispositifs s’inscrivent dans
une chaîne de mesure plus globale, intégrant un ensemble de capteurs distribués et reposant sur des fréquences d’acquisition
élevées et maîtrisées, afin de garantir la cohérence temporelle des données enregistrées et leur exploitation en temps réel.\\

Par ailleurs, SP-02 intègre une chaîne de télécommunication inter-étages et sol, destinée à assurer le suivi de l’état de chaque
étage durant le vol. Cette chaîne repose sur deux technologies complémentaires : une liaison à haut débit utilisant une
modulation \acrshort{GFSK}, destinée au transfert d’un volume important de données, et une liaison à plus bas débit basée sur la
technologie \acrshort{LORA}, principalement dédiée à la transmission de la dernière position \acrshort{GPS} de chaque étage. Les
deux systèmes de communication s’appuient sur le \acrfull{TDMP}, permettant l’utilisation d’une même fréquence par technologie
pour les deux étages, tout en garantissant une synchronisation temporelle et une absence de collision.\\

Dans le cadre du présent PMI, SP-02 constitue ainsi un support expérimental réaliste et instrumenté, permettant d’évaluer non
seulement la faisabilité d’un système de séparation par aérofreinage, mais également la capacité à mesurer, synchroniser et
transmettre des données exploitables lors d’un événement critique du vol, sans faire de la fusée elle-même l’objet central de
l’étude.

\subsubsection{Architecture générale du lanceur SP-02}

L’architecture repose sur une organisation claire en deux étages. Le premier étage assure la phase propulsive initiale et
constitue le support principal de l’expérience de séparation, en embarquant les dispositifs aérodynamiques étudiés. Le second
étage est un étage propulsif à part entière, permettant à la fois l’étude du comportement relatif lors de la séparation et la
poursuite du vol après celle-ci. Son intégration implique des fonctions spécifiques de commande et de sécurité liées à l’allumage
moteur, qui seront détaillées ultérieurement. Les architectures mécanique et électronique du lanceur SP-02 sont présentées dans
les sections suivantes, dans la mesure strictement nécessaire à la compréhension du principe étudié et des analyses menées par
la suite.

\subsubsubsection{Architecture mécanique}

Le premier étage du lanceur SP-02, d’une longueur totale de 1130 mm et d’un diamètre de 104 mm, est propulsé par un moteur
à ergole solide K570 - Pro54-5G, d'une poussée moyenne de 572 N, d'temps de combustion de 3.61~s et donc d'une impulsion totale de
2070 Ns, c'est un moteur de classe K. Le premier étage intègre également 4 surfaces aérodynamiques (ailerons) pour la stabilité en
vol, ainsi que 3 aérofreins déployables destinés à générer l’effort de séparation placé au dessus du moteur. Viens ensuite le bloc
de parachute assurant la récupération du premier étage, suivi du bloc électronique contenant l’ensemble des cartes de commande et
d’acquisition. Enfin, la partie haute du premier étage se caractérise par le système de séparation.

\begin{figure}[h!]
    \centering
    \begin{tikzpicture}
    
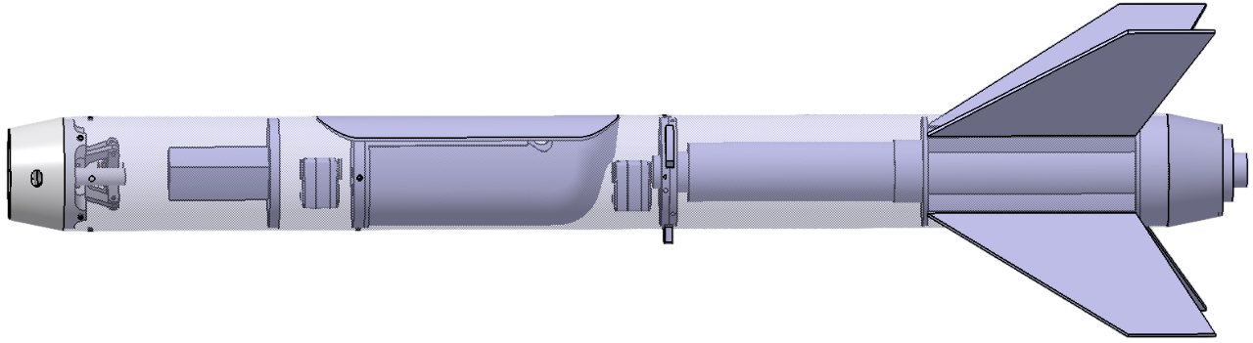
[picture p107: PMI/repport/figures/catia_alpha.png]
        \node at (0, 0) {};
        
        \node (retreint_lbl)   at (+8.00, +2.5) {\textbf{Rétreint}};
        \node (bloc_propu_lbl) at (+4.30, +2.3) {\textbf{Bloc propulsion}};
        \node (propu_lbl)      at (+2.00, +1.5) {\textbf{Pro54-5G}};
        \node (aileron_lbl)    at (+2.00, -1.5) {\textbf{Ailerons (x4)}};
        \node (af_lbl)         at (+0.00, +2.3) {\textbf{Aérofreins (x3)}};
        \node (bloc_para_lbl)  at (-2.00, +1.5) {\textbf{Bloc parachute}};
        \node (bloc_elec_lbl)  at (-6.00, +2.3) {\textbf{Bloc électronique}};
        \node (bloc_sepa_lbl)  at (-6.00, -1.5) {\textbf{Bloc séparation}};

        \node (bloc_propu_box) at (+5.10, 0.00) [minimum width=35mm, minimum height=18mm, rectangle, line width=2, draw=red] {};
        
        \draw[red, ->, line width=1.5] (retreint_lbl.south)   -- (+7.20, +0.60);
        \draw[red, ->, line width=1.5] (bloc_propu_lbl.south) -- (bloc_propu_box.140);
        \draw[red, ->, line width=1.5] (propu_lbl.south)      -- (+2.20, +0.00);
        \draw[red, ->, line width=1.5] (aileron_lbl.east)     -- (+6.50, -1.50);
        \draw[red, ->, line width=1.5] (af_lbl.south)         -- (+0.30, +0.60);
        \draw[red, ->, line width=1.5] (bloc_para_lbl.south)  -- (-2.00, +0.00);
        \draw[red, ->, line width=1.5] (bloc_elec_lbl.south)  -- (-5.30, +0.00);
        \draw[red, ->, line width=1.5] (bloc_sepa_lbl.north)  -- (-7.30, +0.00);

    \end{tikzpicture}
    \caption{Vue du premier étage sur \acrshort{CATIA}}
    \label{fig:sp02_s1_ork}
\end{figure}

\newpage

Le second étage, d’une longueur totale de 992 mm et d’un diamètre de 84 mm, est propulsé par un moteur 144G150 - Pro24-6G de la
même gamme que le moteur du premier étage. Il développe une poussée moyenne de 147~N pour un temps de combustion de 0.969~s, soit
une poussée totale de 144~Ns, c'est un moteur de classe G. Le second étage intègre une coiffe conique en tête faite en fibre de
verre et une pointe en aluminium, ainsi que 4 ailerons pour la stabilité en vol. Le bloc parachute assure la récupération de
l’étage, tandis que le bloc électronique contient les mêmes cartes que le premier étage afin de faciliter le développement. La
partie basse du second étage est quant à elle dédiée à l’interface de séparation avec le premier étage.

\begin{figure}[h]
    \centering
    \begin{tikzpicture}
    
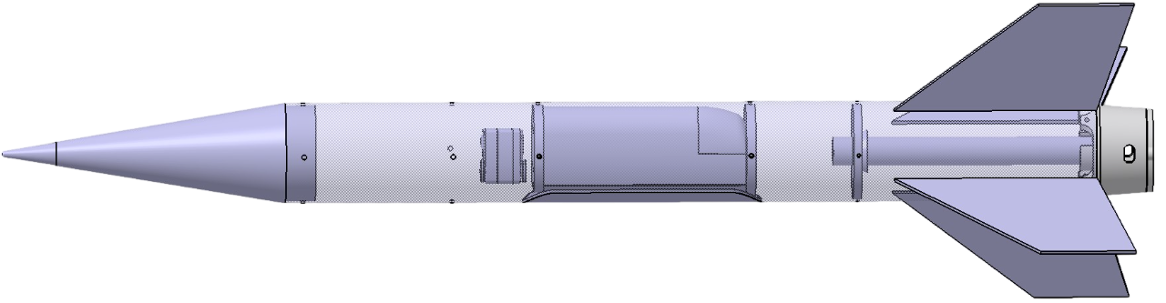
[picture p108: PMI/repport/figures/catia_beta.png]
        \node at (0, 0) {};
        
        \node (bloc_sepa_lbl)   at (+8.00, +2.5) {\textbf{Interface de séparation}};
        \node (propu_lbl)       at (+4.30, +2.3) {\textbf{Pro24-6G}};
        \node (bague_propu_lbl) at (+3.00, +1.5) {\textbf{bague de centrage}};
        \node (aileron_lbl)     at (+2.00, -1.5) {\textbf{Ailerons (x4)}};
        \node (bloc_para_lbl)   at (+1.00, +2.3) {\textbf{Bloc parachute}};
        \node (bloc_elec_lbl)   at (-2.00, +1.5) {\textbf{Bloc électronique}};
        \node (coiffe_lbl)      at (-5.00, +2.3) {\textbf{Coiffe conique}};
        \node (pointe_alu_lbl)  at (-6.00, -1.5) {\textbf{Pointe aluminium}};

        \draw[red, ->, line width=1.5] (bloc_sepa_lbl.south)    -- (+7.40, +0.60);
        \draw[red, ->, line width=1.5] (propu_lbl.south)        -- (+5.20, +0.00);
        \draw[red, ->, line width=1.5] (bague_propu_lbl.south)  -- (+3.70, +0.00);
        \draw[red, ->, line width=1.5] (aileron_lbl.east)       -- (+6.50, -1.00);
        \draw[red, ->, line width=1.5] (bloc_para_lbl.south)    -- (+0.30, +0.60);
        \draw[red, ->, line width=1.5] (bloc_elec_lbl.south)    -- (-2.50, +0.00);
        \draw[red, ->, line width=1.5] (coiffe_lbl.south)       -- (-5.30, +0.00);
        \draw[red, ->, line width=1.5] (pointe_alu_lbl.north)   -- (-7.30, +0.00);

    \end{tikzpicture}
    \caption{Vue du second étage sur \acrshort{CATIA}}
    \label{fig:sp02_s2_ork}
\end{figure}

L'ensemble du lanceur SP-02 présente une longueur totale de 2062 mm et une masse théorique au décollage d'environs 9.3 kg, dont
6.9 kg pour le premier étage et 2.4 kg pour le second étage. 

\begin{figure}[h!]
    \centering
    \rotatebox{-45}{}
    \caption{Vue d'ensemble du lanceur SP-02 sur \acrshort{CATIA}}
    \label{fig:sp02_ork}
\end{figure}

\newpage

\subsubsubsection{Architecture électronique et instrumentation}

Le système électronique embarqué du lanceur SP-02 est conçu pour assurer la gestion des fonctions critiques de vol, la collecte
et la transmission des données expérimentales, ainsi que la synchronisation temporelle entre les différents capteurs et modules
de communication. L’architecture électronique repose sur la répartition des différentes fonctions en trois modules principaux
par étage :

\begin{itemize}
    \item \textbf{Séquenceur de vol :} Responsable de la gestion des phases de vol, du déclenchement des événements critiques
    (séparation, ouverture des aérofreins, allumage moteur du second étage, déploiement des parachutes) et de la supervision
    globale du système.
    \item \textbf{APEX / APEX-EX :} Cartes d’acquisition de données embarquées, assurant la collecte des mesures issues des
    capteurs (inertiels, pression, température, GPS, etc.) ainsi que la télécommunication avec le sol et entre les étages.
    \item \textbf{Module caméra :} Système permettant la gestion des différentes caméras embarquées, incluant la caméra
    permettant l’observation visuelle de la séparation d’étages.
\end{itemize}

\begin{figure}[h!]
    \centering
    
    \caption{Schéma fonctionnel simplifié du système électroniques de la fusée SP-02}
    \label{fig:SP02_electroniques_simple}
\end{figure}

Attardons-nous plus en détail sur le module APEX / APEX-EX, qui constitue le cœur du système de validation expérimentale de la
séparation d’étages.\\

Le projet APEX\cite{APEX} correspond à une plateforme électronique développée au sein de l’association AéroIPSA afin de fournir
une solution générique et réutilisable pour l’acquisition de données, la gestion temporelle des mesures et la télécommunication
dans le cadre de projets de fusées expérimentales. Son développement a débuté l’année précédente, avec pour objectif de disposer
d’une architecture modulaire, robuste et adaptée aux contraintes d'un vol de fusée expérimentale.\\

APEX s’inscrit dans la continuité d’un projet plus ancien, nommé \emph{Unknown}\footnote{Le rapport du projet Unknown est
dispon en annexe du rapport dU projet de fusée expérimental SP-01\cite{SP01}}, qui constituait une première tentative de
centralisation des fonctions d’acquisition et de communication embarquées. Les retours d’expérience issus de ce projet ont
permis d’orienter la conception d’APEX vers une architecture plus structurée, mieux instrumentée et pensée dès l’origine pour la
synchronisation temporelle des données et l’intégration de multiples capteurs dans le but d'un vecteur d'expérience
multi-étages.\\

\newpage

Dans le cadre du projet SP-02, la carte APEX est complétée par une extension spécifique, nommée APEX-EX. Cette extension a
été développée afin de répondre aux besoins expérimentaux propres à la séparation d’étages. Elle permet notamment
l’intégration d’un module de communication à plus haute puissance dédié à la liaison \acrshort{GFSK}, ainsi que l’ajout de ports
de connexion supplémentaires pour des capteurs spécifiques ou des modules annexes. L’ensemble APEX / APEX-EX forme ainsi une
chaîne cohérente d’acquisition, de synchronisation et de transmission des données, spécifiquement adaptée aux objectifs
expérimentaux du lanceur SP-02.\\

Dans le cadre du présent \acrshort{PMI}, l’accent sera mis sur l'architecture logiciel, les différents cartes électroniques
étant vu, analogue à ce que la fusée représente pour les différens livrables mécaniques, comme un support d'expérimentation pour
les logiciels développés.

\subsubsection{Phase de vol}

Le vol de la fusée SP-02 se déroule selon six phases successives représentées dans la figure suivante. Ce découpage permet
d’identifier clairement les séquences critiques du lanceur et de situer la phase de séparation d’étages dans le contexte global
du vol.

\begin{figure}[h!]
    \centering
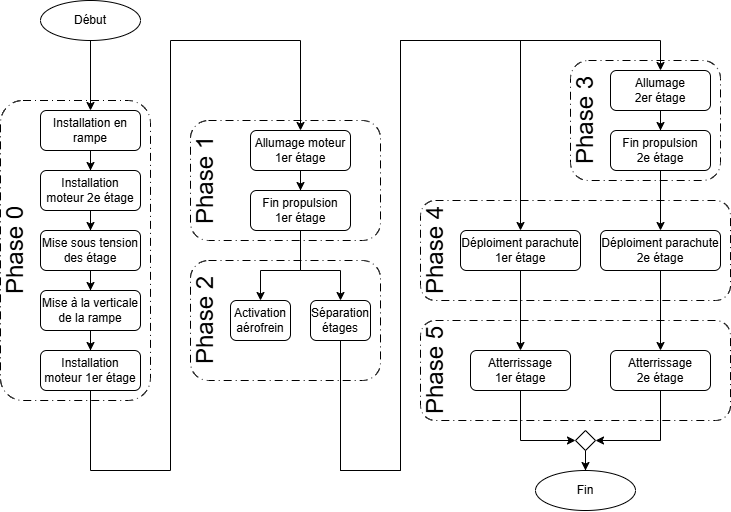
[picture p109: PMI/repport_FinalVersion/figures/Phase_vol.drawio.png]
    
    \caption{Phases de vol du lanceur SP-02}
    \label{fig:phases_vol_sp02}
\end{figure}

On distingue ainsi les phases suivantes :
\begin{itemize}
    \item \textbf{Phase 0 :} Préparation et mise en condition du système.
    \item \textbf{Phase 1 :} Propulsion et ascension du premier étage.
    \item \textbf{Phase 2 :} Séparation des étages.
    \item \textbf{Phase 3 :} Allumage et propulsion du second étage.
    \item \textbf{Phase 4 :} Ouverture des parachutes et descente des étages.
    \item \textbf{Phase 5 :} Atterrissage et récupération des étages.
\end{itemize}

\newpage
