povdoigt/SP-02/PMI/repport_FinalVersion/sections/3_Methode/3_Elec.tex

\subsection{Processus expérimental physique}

\subsubsection{Chaîne de mesure APEX : Acquisition et transmission de données inertielle}

Le module APEX est composé d’une seule carte électronique de forme rectangulaire sur laquelle sont soudés tous les composants
nécessaires à son fonctionnement. Il est conçu pour être compact permettant une intégration facile dans une fusée ou cansat et
est alimenté par une batterie LiPo 3.7V. Il est équipé de plusieurs capteurs dont un \acrshort{GPS}, d’une interfaces de
communication physique, d’une mémoire flash pour le stockage des données, d’un module de télécommunication compatible avec les
protocole \acrshort{LORA} et \acrshort{GFSK} ainsi que d’un microcontrôleur STM32F411RETx de STMicroelectronics. Le module est
programmé en C.

\begin{figure}[h]
    \centering
    \begin{subfigure}{0.48\textwidth}
        \centering
\begin{tikzpicture}
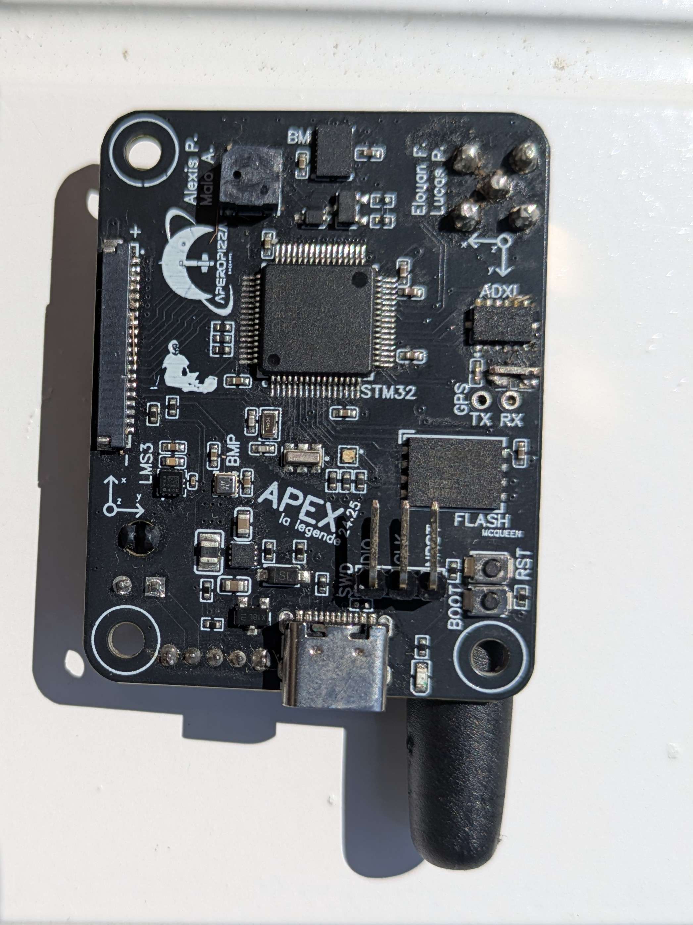
[picture p123: PMI/repport/figures/APEX_FRONT.jpg]
    \node at (0, 0) {};

    \node (BMI_lbl) at (-4.00, +3.5) {BMI088};
    \node (Buz_lbl) at (-3.90, +3.0) {Buzzer};
    \node (ADX_lbl) at (-4.10, +2.5) {ADXL370};
    \node (STM_lbl) at (-3.90, +2.0) {STM32};
    \node (Con_lbl) at (-4.25, +1.5) {Connecteur};
    \node (W25_lbl) at (-4.30, +1.0) {W25Q512JV};
    \node (RGB_lbl) at (-4.30, +0.5) {LED RGB 0};
    \node (LSM_lbl) at (-4.35,  0.0) {LSM303AGR};
    \node (BMP_lbl) at (-4.00, -0.5) {BMP380};
    \node (SWD_lbl) at (-4.05, -1.0) {Pin SWD};
    \node (PW0_lbl) at (-4.15, -1.6) {Régulateur};
    \node (PW1_lbl) at (-4.10, -1.9) {de tension};
    \node (USB_lbl) at (-3.85, -2.5) {USB C};
    \node (LED_lbl) at (-4.15, -3.0) {LED PWR};
    \node (ATN_lbl) at (-4.00, -3.5) {Antenne};

    \node (BMI_box) at (-0.10, +2.50) [minimum width=03mm, minimum height=05mm, rectangle, fill=red, fill opacity=0.2] {};
    \node (Buz_box) at (-0.75, +2.30) [minimum width=05mm, minimum height=05mm, rectangle, fill=red, fill opacity=0.2] {};
    \node (ADX_box) at (+1.20, +1.10) [minimum width=05mm, minimum height=04mm, rectangle, fill=red, fill opacity=0.2] {};
    \node (STM_box) at (-0.25, +1.15) [minimum width=10mm, minimum height=10mm, rectangle, fill=red, fill opacity=0.2] {};
    \node (Con_box) at (-1.80, +0.95) [minimum width=04mm, minimum height=18mm, rectangle, fill=red, fill opacity=0.2] {};
    \node (W25_box) at (+0.90, -0.10) [minimum width=09mm, minimum height=06mm, rectangle, fill=red, fill opacity=0.2] {};
    \node (RGB_box) at (+0.01, +0.05) [minimum width=01mm, minimum height=01mm, rectangle, fill=red, fill opacity=0.2] {};
    \node (LSM_box) at (-1.40, -0.15) [minimum width=01mm, minimum height=01mm, rectangle, fill=red, fill opacity=0.2] {};
    \node (BMP_box) at (-0.97, -0.18) [minimum width=01mm, minimum height=01mm, rectangle, fill=red, fill opacity=0.2] {};
    \node (SWD_box) at (+0.45, -0.70) [minimum width=08mm, minimum height=08mm, rectangle, fill=red, fill opacity=0.2] {};
    \node (PW0_box) at (-0.70, -0.88) [minimum width=12mm, minimum height=10mm, rectangle, fill=red, fill opacity=0.2] {};
    \node (USB_box) at (-0.08, -1.60) [minimum width=09mm, minimum height=08mm, rectangle, fill=red, fill opacity=0.2] {};
    \node (LED_box) at (+0.60, -1.62) [minimum width=01mm, minimum height=05mm, rectangle, fill=red, fill opacity=0.2] {};
    \node (ATN_box) at (+0.90, -2.60) [minimum width=08mm, minimum height=13mm, rectangle, fill=red, fill opacity=0.2] {};

    \draw[red, ->] (BMI_lbl.0) -- (BMI_box.center);
    \draw[red, ->] (Buz_lbl.0) -- (Buz_box.center);
    \draw[red, ->] (ADX_lbl.0) -- (ADX_box.center);
    \draw[red, ->] (STM_lbl.0) -- (STM_box.center);
    \draw[red, ->] (Con_lbl.0) -- (Con_box.center);
    \draw[red, ->] (W25_lbl.0) -- (W25_box.center);
    \draw[red, ->] (RGB_lbl.0) -- (RGB_box.center);
    \draw[red, ->] (LSM_lbl.0) -- (LSM_box.center);
    \draw[red, ->] (BMP_lbl.0) -- (BMP_box.center);
    \draw[red, ->] (SWD_lbl.0) -- (SWD_box.center);
    \draw[red, ->] (PW0_lbl.-10) -- (PW0_box.center);
    \draw[red, ->] (USB_lbl.0) -- (USB_box.center);
    \draw[red, ->] (LED_lbl.0) -- (LED_box.center);
    \draw[red, ->] (ATN_lbl.0) -- (ATN_box.center);

\end{tikzpicture}
        \caption{Face avant du module APEX}
        \label{fig:apex_front}
    \end{subfigure}
    \begin{subfigure}{0.48\textwidth}
        \centering
\begin{tikzpicture}
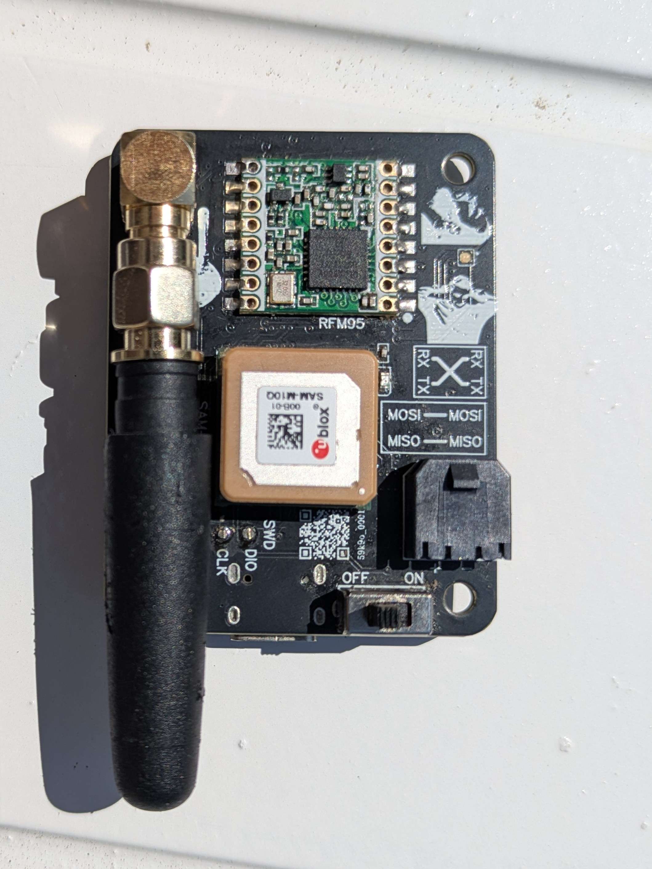
[picture p124: PMI/repport/figures/APEX_BACK.jpg]
    \node at (0, 0) {};

    \node (RFM_lbl) at (3.80, +3.0) {RFM95W};
    \node (RBG_lbl) at (4.00, +2.0) {LED RGB 1};
    \node (GPS_lbl) at (3.95, +1.0) {SAM M10Q};
    \node (ANT_lbl) at (3.65,  0.0) {Antenne};
    \node (BT0_lbl) at (3.85, -0.8) {Connecteur};
    \node (BT1_lbl) at (3.60, -1.2) {batterie};
    \node (SW0_lbl) at (3.50, -2.0) {Switch};
    \node (SW1_lbl) at (4.10, -2.4) {d'alimentation};
    \node (SW2_lbl) at (3.60, -2.8) {batterie};

    \node (RFM_box) at (-0.05, +1.70) [minimum width=15mm, minimum height=15mm, rectangle, fill=red, fill opacity=0.2] {};
    \node (RBG_box) at (+1.19, +1.51) [minimum width=01mm, minimum height=01mm, rectangle, fill=red, fill opacity=0.2] {};
    \node (GPS_box) at (-0.23, +0.06) [minimum width=14mm, minimum height=14mm, rectangle, fill=red, fill opacity=0.2] {};
    \node (ANT_box) at (-1.40, -0.30) [minimum width=10mm, minimum height=60mm, rectangle, fill=red, fill opacity=0.2] {};
    \node (BT0_box) at (+1.16, -0.65) [minimum width=10mm, minimum height=10mm, rectangle, fill=red, fill opacity=0.2] {};
    \node (SW0_box) at (+0.55, -1.50) [minimum width=09mm, minimum height=05mm, rectangle, fill=red, fill opacity=0.2] {};

    \draw[red, ->] (RFM_lbl.180) -- (RFM_box.center);
    \draw[red, ->] (RBG_lbl.180) -- (RBG_box.center);
    \draw[red, ->] (GPS_lbl.180) -- (GPS_box.center);
    \draw[red, ->] (ANT_lbl.180) -- (ANT_box.center);
    \draw[red, ->] (BT0_lbl.-170) -- (BT0_box.center);
    \draw[red, ->] (SW1_lbl.180) -- (SW0_box.center);
\end{tikzpicture}
        \caption{Face arrière du module APEX}
        \label{fig:apex_back}
    \end{subfigure}
    \caption{Module APEX}
    \label{fig:apex}
\end{figure}

\subsubsubsection{Architecture logicielle de la chaîne de mesure}

L’architecture logicielle retenue pour la chaîne de mesure APEX repose sur une approche de type \emph{pipeline orienté données}
(\emph{data-driven}), conçue pour garantir la robustesse du système sous contraintes temps réel et faciliter l’intégration
progressive de nouveaux capteurs ou traitements. Le principe général de circulation des données est illustré par le logigramme
présenté en figure~\ref{fig:APEX_pipeline}.

\begin{figure}[h!]
    \centering
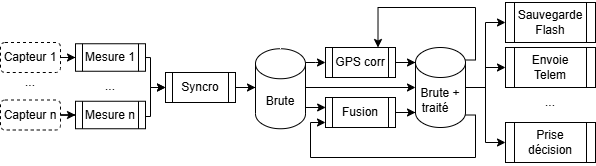
[picture p125: PMI/repport_FinalVersion/figures/apex_bes/APX_algo_simplifie.drawio.png]
    
    \caption{Architecture logicielle de la chaîne de mesure APEX}
    \label{fig:APEX_pipeline}
\end{figure}

Les différents capteurs embarqués sont acquis de manière indépendante, puis leurs mesures sont synchronisées temporellement
afin de produire des données brutes cohérentes. Cette synchronisation s’appuie sur un mécanisme d’horodatage commun,
garantissant l’alignement temporel entre capteurs hétérogènes et assurant la traçabilité des données lors des phases dynamiques
du vol, en particulier au moment de la séparation.\\

L’architecture distingue ensuite deux niveaux fonctionnels. Un premier niveau correspond à l’acquisition et à la mise à
disposition de données brutes synchronisées. Un second niveau, optionnel, regroupe des traitements de plus haut niveau tels que
des corrections, des filtrages ou des opérations de fusion multi-capteurs, produisant des données dites traitées, destinées à
l’exploitation, à l’enregistrement ou à la transmission.\\

Les échanges de données entre les différentes briques logicielles reposent sur le concept de \emph{data topics}. Chaque tâche
publie ses résultats dans un topic dédié, tandis que les tâches consommatrices accèdent aux données sans dépendance directe
vis-à-vis de l’exécution du producteur. Cette approche permet de découpler fortement les fonctions d’acquisition, de traitement
et de sortie, limitant les effets du jitter temporel et améliorant la robustesse globale du système.\\

L’architecture autorise ainsi la coexistence de plusieurs sorties en parallèle, telles que l’enregistrement en mémoire non
volatile et la transmission par télécommunication, sans perturber la chaîne d’acquisition principale. Un bloc de prise de
décision est également représenté comme une extension possible de l’architecture, notamment pour le déclenchement d’événements
ou l’activation d’actionneurs. Toutefois, dans le cadre du projet SP-02, APEX est principalement utilisé comme une chaîne
d’acquisition et de télémesure, et non comme un système de contrôle autonome.\\

Les fréquences d’exécution des différentes tâches sont paramétrables, avec une cadence d’acquisition inertielle cible de l’ordre
de 100~Hz et une fréquence de mise à jour des données transmises supérieure à 10~Hz, assurant un compromis entre finesse de
mesure et suivi temps réel depuis le segment sol.

\subsubsubsection{Choix d’une approche temps réel embarquée}

\subsubsubsection*{Justification d’une approche temps réel}
La chaîne de mesure APEX repose sur une approche logicielle temps réel afin de garantir un comportement
prévisible lors d’événements dynamiques critiques, tels que la séparation d’étages. Dans un système
séquentiel classique basé sur une boucle principale monolithique, l’exécution d’une opération lente peut
retarder l’ensemble des fonctions et introduire des variations temporelles difficiles à maîtriser. Une
approche temps réel permet au contraire de structurer l’exécution autour de contraintes temporelles
explicites.

\subsubsubsection*{Décomposition fonctionnelle en tâches}
Le recours à un système d’exploitation temps réel (RTOS) permet de décomposer l’application en tâches
indépendantes correspondant aux principales fonctions du système : acquisition des capteurs,
traitement des données, enregistrement et télécommunication. Chaque tâche dispose de son propre
contexte d’exécution et est planifiée selon des règles de priorité et de périodicité. Cette organisation
facilite l’exécution concurrente des fonctions et s’inscrit naturellement dans une architecture orientée
données, où les blocs fonctionnels échangent des informations sans dépendre directement de leur ordre
d’exécution.

\subsubsubsection*{Gestion des cadences et du jitter}
L’approche temps réel permet de dissocier les cadences d’exécution des différentes fonctions du système.
Les tâches d’acquisition inertielle sont exécutées de manière périodique à une fréquence élevée,
typiquement de l’ordre de 100~Hz, afin de capturer les phénomènes transitoires associés à la séparation.
Les tâches de télécommunication sont quant à elles exécutées à une fréquence plus faible, supérieure à
10~Hz, suffisante pour assurer un suivi temps réel depuis le sol. Cette dissociation permet de limiter
l’impact du jitter temporel et d’éviter qu’une tâche lente ne perturbe l’acquisition des données critiques.

\subsubsubsection*{Contraintes d’accès aux périphériques}
Certaines contraintes matérielles imposent l’utilisation de mécanismes de type \emph{polling} pour l’accès
à certains périphériques, en l’absence de lignes d’interruption dédiées. Dans ce contexte, l’ordonnancement
temps réel permet d’en borner l’impact en maîtrisant la durée et la fréquence des accès. L’utilisation de
ressources partagées, telles que les bus de communication, est explicitement coordonnée afin de garantir
l’intégrité des transactions et la cohérence des échanges avec les périphériques critiques.

\subsubsubsection*{Gestion déterministe des ressources}
Afin de préserver un comportement prévisible, la gestion des ressources logicielles repose sur des
allocations principalement statiques. Les tâches et leurs contextes d’exécution sont associés à des
ressources mémoire préallouées, garantissant une empreinte mémoire bornée et reproductible. Des
mécanismes de réservoirs d’objets préalloués permettent de conserver une certaine flexibilité dans la
création et la terminaison des tâches, sans introduire d’allocation dynamique non maîtrisée. Cette
approche contribue à la robustesse du système dans un contexte de vol expérimental à tentative unique.

\subsubsubsection*{Apports et compromis de l’approche retenue}
L’adoption d’une approche temps réel constitue un compromis entre complexité logicielle et maîtrise du
comportement temporel. Elle permet de structurer la chaîne de mesure APEX de manière robuste et
prévisible, tout en offrant la flexibilité nécessaire à l’intégration de nouvelles fonctions expérimentales
et à l’évolution du système.

\subsubsubsection{Gestion des flux de données et concept de data topics}

La chaîne de mesure APEX repose sur une gestion structurée des flux de données, visant à découpler les
fonctions d’acquisition, de traitement et de sortie, tout en garantissant la cohérence temporelle et
l’exploitabilité des mesures. Cette organisation est fondée sur le concept de \emph{data topics}, qui
constitue un élément central de l’architecture logicielle retenue.\\

Un data topic peut être défini comme un conteneur de données partagé, représentant une grandeur ou un
ensemble cohérent de grandeurs mesurées ou calculées à un instant donné. Chaque tâche productrice
publie ses résultats dans un topic dédié, tandis que les tâches consommatrices accèdent aux données sans
dépendance directe vis-à-vis de l’exécution du producteur. Ce mécanisme permet de dissocier
temporellement les différentes briques fonctionnelles du système.\\

Dans le cadre de la chaîne de mesure inertielle, les données issues des capteurs sont ainsi publiées sous
forme de topics correspondant aux mesures brutes synchronisées. Ces topics peuvent ensuite être
consommés par des tâches de traitement appliquant des corrections, des filtrages ou des opérations de
fusion multi-capteurs, produisant à leur tour des topics de données traitées. Cette structuration explicite
des flux facilite la compréhension, l’évolution et la validation de la chaîne de mesure.\\

\begin{figure}[h!]
    \centering
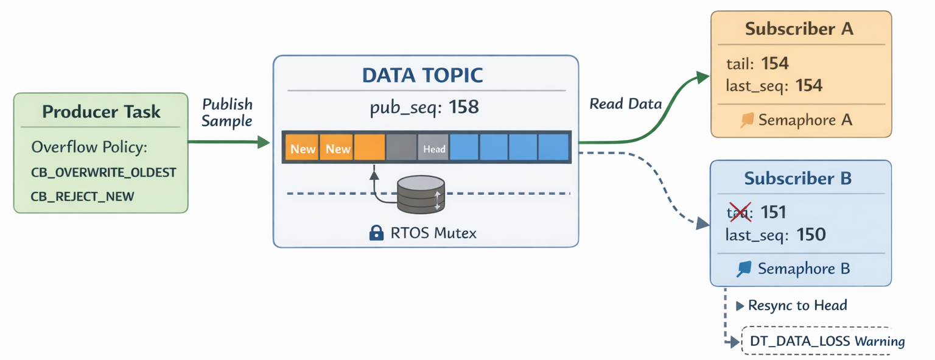
[picture p126: PMI/repport_FinalVersion/figures/Schema_datatopic.png]
    
    \caption{Concept de data topics dans la chaîne de mesure APEX}
    \label{fig:data_topics}
\end{figure}

Sur le plan de l’exécution, les data topics sont implémentés de manière à permettre un accès non bloquant
aux données les plus récentes. Les consommateurs peuvent ainsi récupérer le dernier échantillon
disponible, indépendamment des éventuelles variations de fréquence ou de jitter des tâches productrices.
Cette propriété est particulièrement importante dans un contexte temps réel, où la priorité est donnée à
la continuité de l’acquisition et à la robustesse globale du système.\\

L’utilisation de data topics contribue également à la scalabilité de l’architecture. De nouvelles tâches
peuvent être ajoutées en s’abonnant à des topics existants, sans modification de la chaîne d’acquisition
initiale. Cette approche facilite l’intégration progressive de nouvelles fonctions expérimentales, telles
que des traitements supplémentaires ou des sorties spécifiques, tout en limitant les risques de
régression sur les fonctions existantes.\\

Enfin, cette gestion des flux de données constitue un prérequis pour la mise en œuvre des sorties
multiples de la chaîne de mesure, qu’il s’agisse de l’enregistrement en mémoire non volatile, de la
télécommunication ou de l’exploitation ultérieure des données. Elle assure la continuité entre
l’acquisition des phénomènes physiques, leur structuration logicielle et leur transmission vers les
différents moyens d’analyse.

\subsubsubsection{Chaîne de télécommunication et synchronisation inter-étages}

La chaîne de télécommunication constitue l’interface entre la chaîne de mesure embarquée et le segment
sol, ainsi qu’un moyen d’échange d’informations entre les deux étages du lanceur après la séparation.
Son rôle principal est d’assurer la transmission de données exploitables en vol, tout en garantissant une
robustesse suffisante face aux contraintes radio et aux incertitudes liées au déroulement de la mission.\\

Afin de répondre à des besoins de nature différente, deux modes de communication complémentaires
sont mis en œuvre. Une liaison à plus haut débit, basée sur une modulation de type GFSK, est utilisée
pour la transmission de données expérimentales nécessitant une bande passante plus importante. En
parallèle, une liaison à plus bas débit reposant sur la technologie LoRa est dédiée à la transmission
d’informations essentielles, telles que la dernière position GPS connue de chaque étage, dans une
logique de robustesse et de portée maximale.\\

Ces deux modes de communication sont implémentés à partir d’un même transcepteur radio, permettant
de basculer dynamiquement entre les technologies selon les besoins expérimentaux. Cette approche
limite la complexité matérielle tout en offrant une grande flexibilité dans la gestion des flux de données
transmis.\\

La gestion des échanges radio s’appuie sur un protocole de type \acrfull{TDMP}, assurant une synchronisation
temporelle des communications entre les différents nœuds du
système. Ce protocole permet l’utilisation d’une même fréquence par technologie pour les deux étages,
tout en évitant les collisions et en garantissant une répartition maîtrisée des fenêtres de transmission.
Il s’inscrit dans la continuité de la synchronisation temporelle mise en œuvre au niveau de la chaîne de
mesure, et contribue à la cohérence globale des données transmises.\\

La chaîne de télécommunication est ainsi conçue comme une extension naturelle de la chaîne de mesure
APEX. Elle permet d’assurer un suivi temps réel de l’expérience depuis le sol, tout en sécurisant la
récupération des informations critiques. Dans le cadre du projet SP-02, elle participe pleinement à la
validation expérimentale du principe de séparation étudié, sans constituer un objectif de performance
radio en tant que tel.

\newpage

\subsubsection{Caméra embarquée}
\label{sec:camera_embarquee}

% \providecommand{\remarqueicon}{%
% \tikz[baseline=-0.7ex]\node[draw=blue, fill=blue!10, circle, line width=0.6pt, inner sep=1.1pt]
% {\textcolor{blue}{\scriptsize\bfseries !}};%
% }
% \providecommand{\remarque}[1]{\noindent\remarqueicon\ \textbf{Remarque :} #1\par\vspace{0.15cm}}

Afin d’exploiter la phase de séparation inter-étages et de faciliter l’analyse post-vol, une instrumentation vidéo
redondante est intégrée à bord. La stratégie retenue combine des caméras autonomes dédiées à la captation
multi-angles et une caméra orientée vers la zone de séparation, visant l’extraction d’une information cinématique
simple lors des premières secondes de divergence relative.

\subsubsubsection{Caméra orientée séparation (Arducam).}
L’étage inférieur embarque une caméra \textit{Arducam 12 MP} dédiée à l’observation de la zone de séparation,
orientée vers le moteur du deuxième étage. Cette caméra est exploitée comme un capteur d’analyse : l’objectif
est d’estimer, de façon approchée, la vitesse relative entre les deux étages au moment de la séparation tant que
le deuxième étage reste dans le champ de vision.

Le microntroleur\textit{XIAO ESP32-C3} de l’étage inférieur assure l’acquisition et l’enregistrement du flux vidéo sur carte
microSD en temps réel, est n'est pas stockée dans la mémoire vive limitée du micocontroleur. Cette architecture vise à garantir
la récupération des données même en
cas de vol balistique.

\begin{figure}[H]
    \centering
    \begin{subfigure}[b]{0.62\textwidth}
        \centering
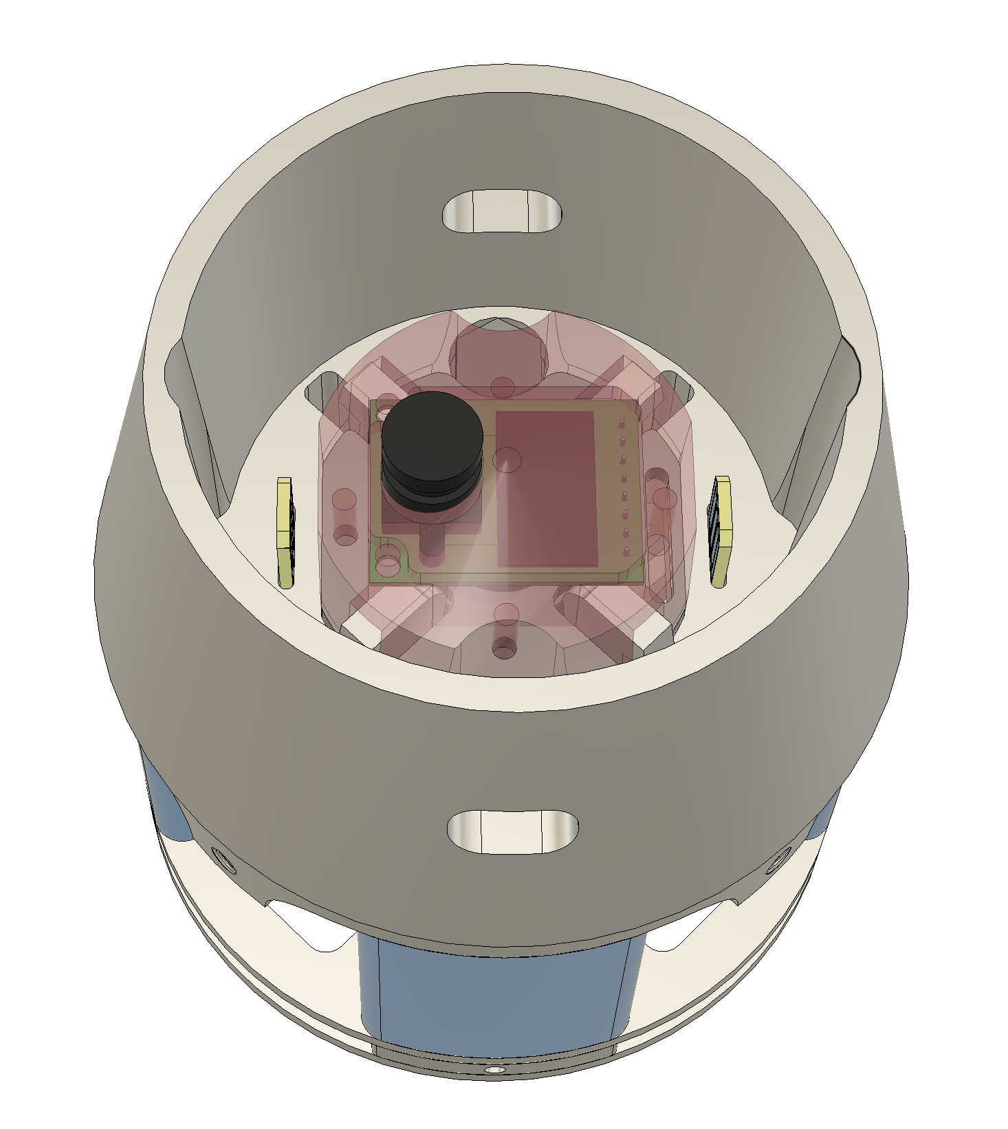
[picture p127: PMI/repport_FinalVersion/figures/Capture_decran_2026-01-23_a_14.50.47.png]
        
        \caption{Intégration de la caméra Arducam et de son support dans la structure.}
        \label{fig:arducam_integration_cao}
    \end{subfigure}
    \hfill
    \begin{subfigure}[b]{0.34\textwidth}
        \centering
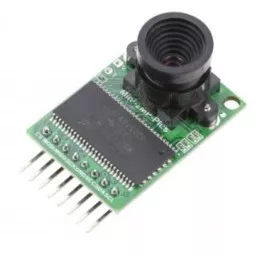
[picture p128: PMI/repport_FinalVersion/figures/mini-module-camera-arducam-shield-ov2640-2mp-kubii.png]
        
        \caption{Module caméra Arducam.}
        \label{fig:arducam_module}
    \end{subfigure}
    \caption{Caméra dédiée séparation : intégration et module.}
    \label{fig:arducam_sep}
\end{figure}

\subsubsubsection{Principe d’estimation de la vitesse relative.}
L’exploitation repose sur un calcul d’ordre 1 à partir de la vidéo :
\begin{itemize}
    \item la fréquence d’enregistrement ($f_{\mathrm{img}}$) est connue ;
    \item des éléments de dimensions connues visibles dans la jupe du deuxième étage servent de référence d’échelle
    (conversion pixels $\rightarrow$ longueur) ;
    \item le déplacement apparent d’un motif (ou d’un bord) entre deux images successives fournit une distance
    $\Delta s$ sur l’intervalle $\Delta t = 1/f_{\mathrm{img}}$ ;
    \item l’estimation de la vitesse relative s’écrit alors $v_{\mathrm{rel}} \approx \Delta s \, f_{\mathrm{img}}$.
\end{itemize}
Cette méthode vise un ordre de grandeur exploitable pour qualifier la cinématique de séparation (cohérence et
répétabilité), sans chercher une reconstruction complète de trajectoire.

\subsubsubsection{RunCam embarquées (multi-angles).}
Chaque étage embarque deux caméras \textit{RunCam Thumb Pro} afin de multiplier les points de vue et de sécuriser l’exploitation
vidéo en cas d’occultation partielle (rotation, vibrations, masquage local). Les RunCam enregistrent directement sur carte
microSD, rendant la captation indépendante de la télémétrie. Le déclenchement et le pilotage (démarrage/arrêt, modes) sont
réalisés par une liaison UART, commandée par un microcontrôleur \textit{XIAO ESP32-C3} présent dans chaque étage. qui recoit un
ordre de délanchement depuis le séquanceur par un changment d'état sur, cette ligne ed commade du séquenceur est protégé grace à
l'utilisation d'un optoculoupleur pour que la xiao  ne puisse pas atteindre le séquenceur lors d'un dysfonctionnement où de
surtension.

\begin{figure}[H]
    \centering
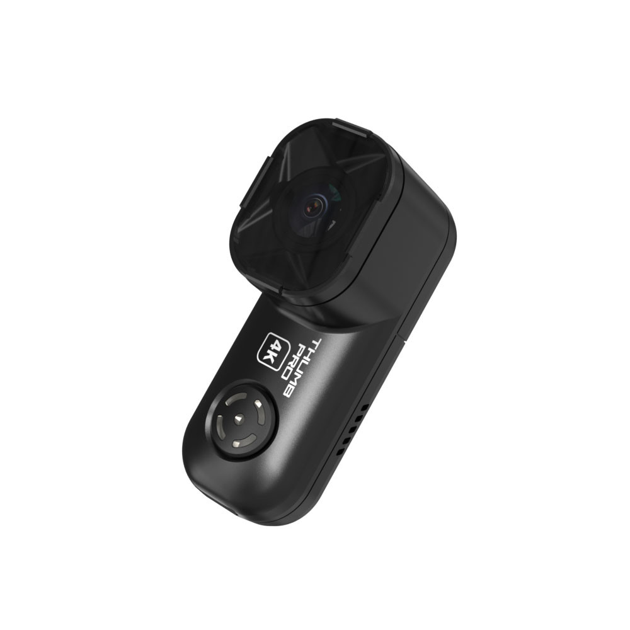
[picture p129: PMI/repport_FinalVersion/figures/002__91896.jpg]
    
    \caption{Caméra RunCam Thumb Pro utilisée pour la captation embarquée.}
    \label{fig:runcam_thumb_pro}
\end{figure}

\subsubsection{APEX BES : Banc d’essai pour la validation de la chaîne APEX}
\label{sec:333_banc_test_apex}

La validation de la chaîne de mesure et de transmission d’APEX s’appuie sur un banc d’essai dédié, développé pour reproduire au
sol des profils de mouvement représentatifs et répétables. Le cœur de ce travail est la conception et la fabrication de deux
véhicules d’essai capables d’exécuter une trajectoire de type parabolique (au sens du profil cinématique visé), afin de
solliciter l’acquisition inertielle et la transmission radio dans un cadre maîtrisé. La capture vidéo en vue zénithale est
utilisée comme \textit{référence externe} pour comparer et interpréter les mesures issues d’APEX. Le proejt APEX BES (Banc d’Essai
SP-02) constitue ainsi un sous-système d’essai complet, permettant de valider la chaîne APEX dans des conditions proches de celles
rencontrées en vol.

\subsubsubsection*{Objectif de l’essai}
Le banc vise à :
\begin{itemize}
    \item \textbf{générer une cinématique reproductible} (profil de déplacement et changements de régime identifiables),
    \item \textbf{valider la chaîne APEX} (acquisition \acrshort{IMU}, enregistrement, transmission et affichage station sol),
    \item \textbf{corréler les mesures} APEX avec une trajectoire « vraie » reconstruite par suivi vidéo, afin de disposer
    d’un outil d’analyse pour qualifier la cohérence globale (ordre de grandeur, synchronisation, détectabilité).
\end{itemize}

\subsubsubsection*{Conception et réalisation des véhicules d’essai}
Deux véhicules ont été conçus et fabriqués spécifiquement pour ce banc. Ils servent de supports instrumentés pour embarquer
l’électronique APEX, tout en permettant d’imposer une trajectoire et des excitations dynamiques contrôlées. Les choix de
conception visent à garantir :
\begin{itemize}
    \item une \textbf{répétabilité} des essais (géométrie et masse connues, comportement stable),
    \item une \textbf{facilité d’intégration} des cartes (fixations, accessibilité, protection),
    \item une \textbf{cinématique exploitable} (accélérations et rotations suffisamment marquées pour émerger du bruit).
\end{itemize}
Au-delà d’un simple support, ces véhicules constituent un sous-système d’essai à part entière : leur fabrication a permis de
maîtriser les interfaces mécaniques (montage des cartes, passage câbles, rigidité locale) et de disposer d’un moyen autonome
pour reproduire des scénarios de mouvement.

\begin{figure}[h!]
    \centering
    \begin{subfigure}{0.48\linewidth}
        \centering
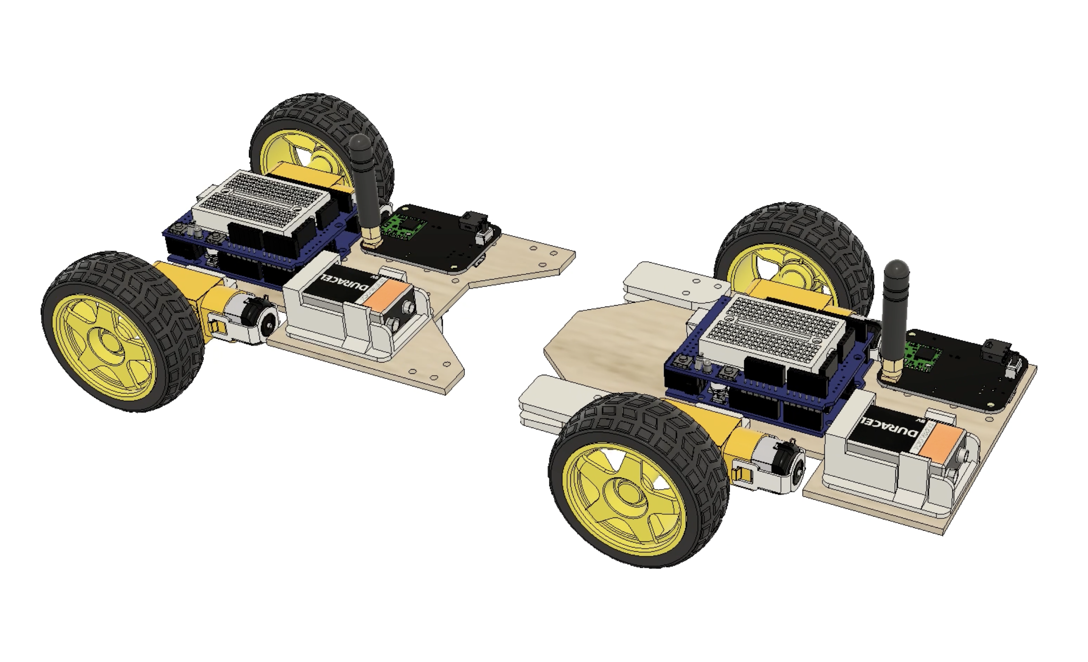
[picture p130: PMI/repport_FinalVersion/figures/apex_bes/Capture d’écran 2026-01-17 à 10.09.12.png]
        
        \caption{Vue de dessus (séparés)}
    \end{subfigure}
    \hfill
    \begin{subfigure}{0.48\linewidth}
        \centering
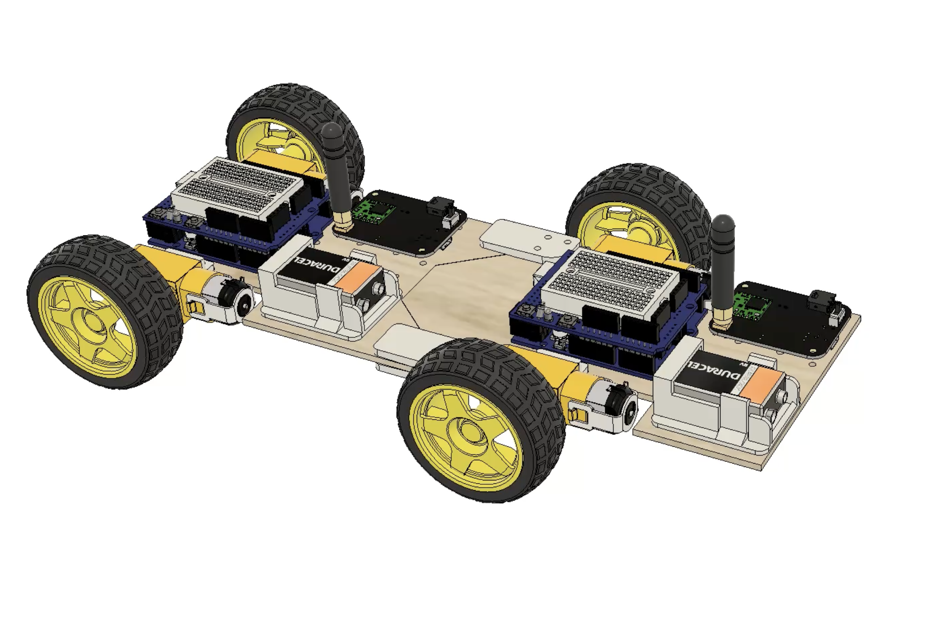
[picture p131: PMI/repport_FinalVersion/figures/Capture d’écran 2026-01-17 à 14.48.38.png]
        
        \caption{Vue de dessus (assemblée)}
    \end{subfigure}
    \begin{subfigure}{0.48\linewidth}
        \centering
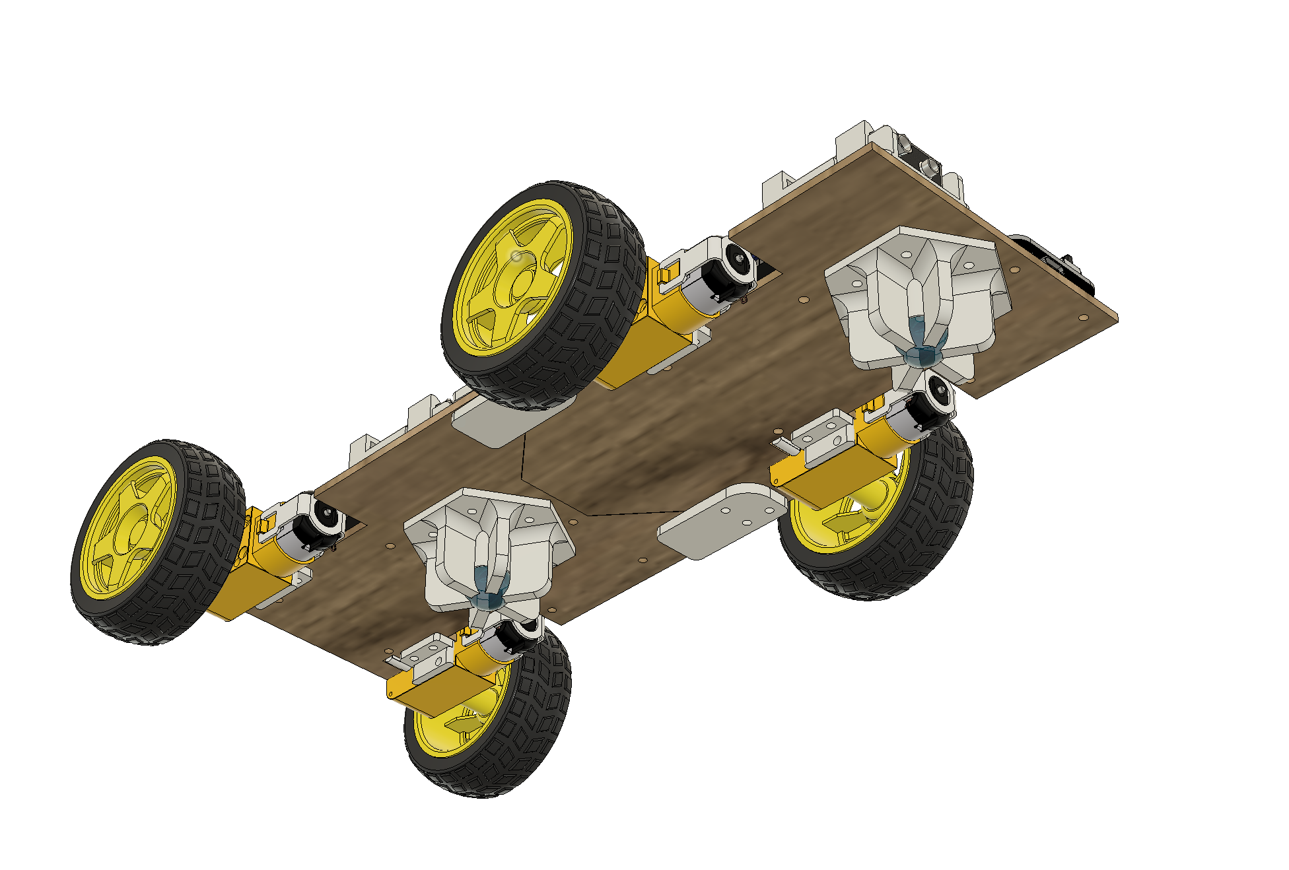
[picture p132: PMI/repport_FinalVersion/figures/apex_bes/Capture d’écran 2026-01-17 à 10.29.32.png]
        
        \caption{Vues de dessus, bille utilisé pour avoir une liverté de mouvement sur l’axe gauche droite.}
    \end{subfigure}
    \caption{Vues de la modélisation 3D des véhicules d’essai APEX BES}
    \label{fig:vessels_cad_views}
\end{figure}

\newpage

\subsubsubsection*{Protocole d’essai}
Les essais sont conduits sur une fenêtre temporelle commune en enregistrant simultanément : (i) les données APEX (\acrshort{IMU},
télémesure) et (ii) une vidéo zénithale permettant de reconstruire la trajectoire. Le déroulement est le suivant :
\begin{enumerate}
    \item mise en place des véhicules et vérification des intégrations APEX,
    \item calibration de la scène (repère sol et échelle pixel $\rightarrow$ mètre),
    \item exécution de la trajectoire par les véhicules (profil parabolique visé) et enregistrement,
    \item traitement des données vidéo (trajectoire puis dérivation) et extraction des courbes APEX,
    \item alignement temporel et comparaison des grandeurs.
\end{enumerate}

\subsubsubsection*{Trajectoire de référence par capture vidéo}
La capture vidéo (vue zénithale) fournit une référence géométrique externe. La trajectoire est obtenue en suivant les positions
$(x(t),y(t))$ des véhicules puis en appliquant la conversion d’échelle. Les vitesses et accélérations sont calculées par
dérivation numérique sur un pas $\Delta t$ correspondant à la cadence caméra :
\[
v_x(t) \simeq \frac{x(t+\Delta t)-x(t)}{\Delta t}, \qquad
a_x(t) \simeq \frac{v_x(t+\Delta t)-v_x(t)}{\Delta t}
\]
(analogues pour $y$). Un lissage léger peut être appliqué à la trajectoire avant dérivation afin de limiter l’amplification du
bruit, tout en conservant la dynamique utile.

\subsubsubsection*{Alignement temporel}
Les données APEX et la vidéo ne partagent pas la même horloge. L’alignement est réalisé à partir d’un événement commun
identifiable (démarrage de mouvement, arrêt net, ou excitation volontaire générant un pic). Cette étape conditionne la lisibilité
des comparaisons, en particulier sur les dérivées (accélérations).

\newpage

\begin{figure}[h!]
    \begin{subfigure}{0.48\linewidth}
        \centering
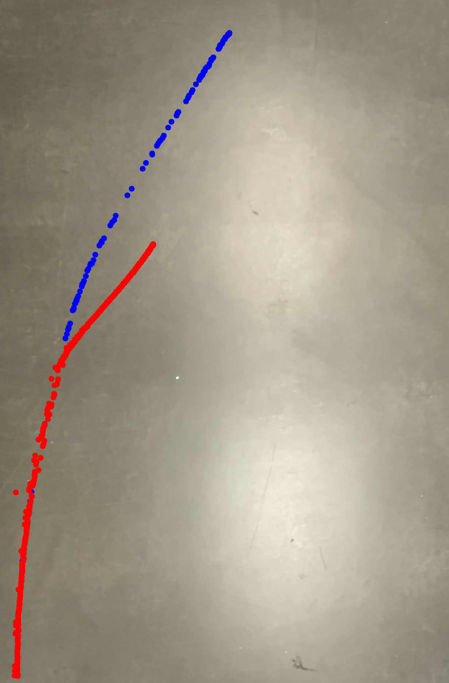
[picture p133: PMI/repport_FinalVersion/figures/apex_bes/debug_overlay.png]
        
        \caption{Superposition de suivi sur la vidéo enregistrée. Les points colorés correspondent aux positions de marqueur détectées utilisées pour reconstruire les trajectoires.}
        \label{fig:traj_xy}        
    \end{subfigure}
    \hfill
    \begin{subfigure}{0.48\linewidth}
        \centering
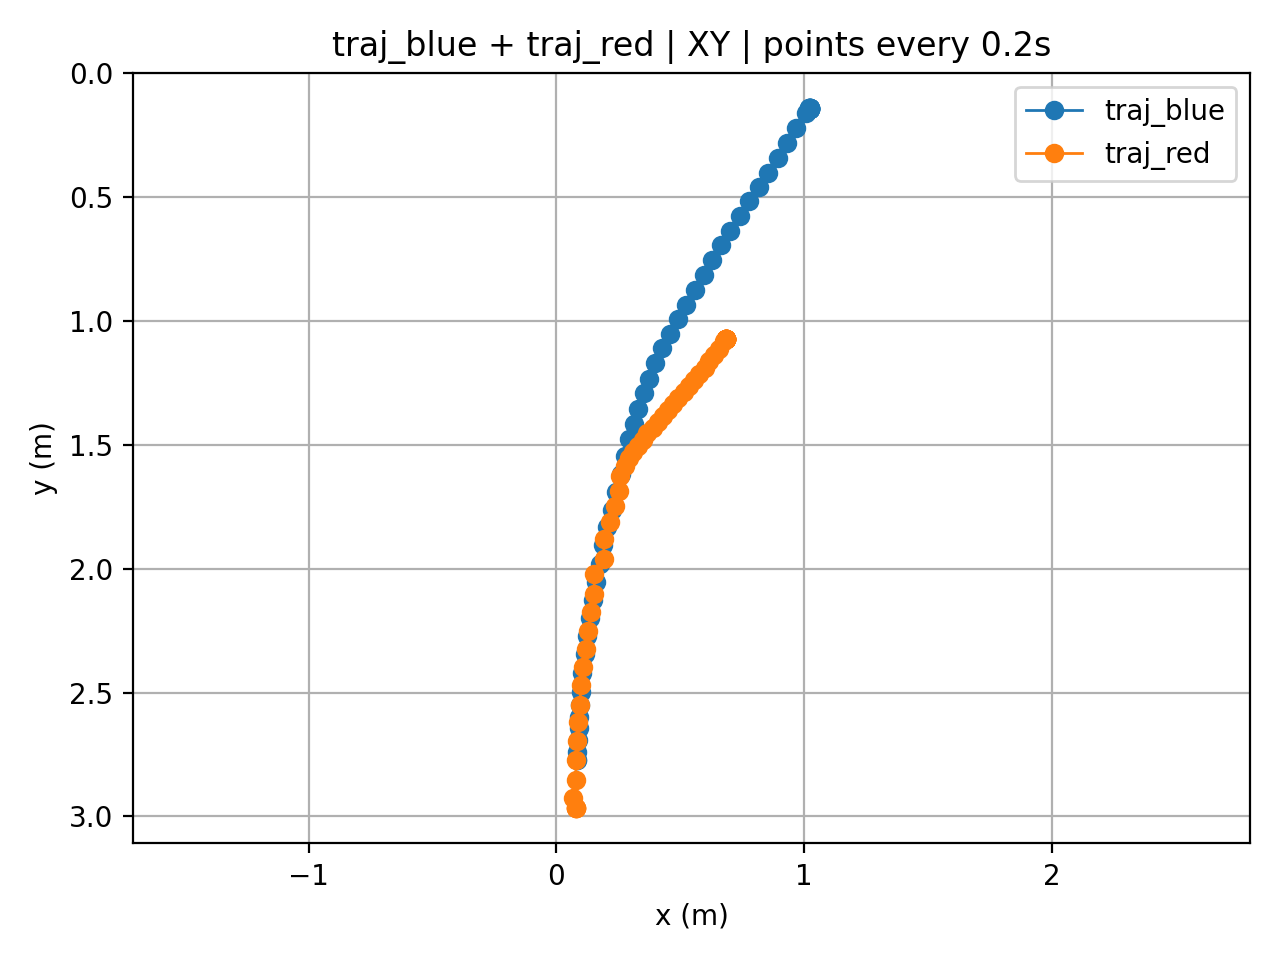
[picture p134: PMI/repport_FinalVersion/figures/apex_bes/traj_blue_traj_red_xy_dt0.200.png]
        
        \caption{Trajectoires XY reconstruites des deux véhicules dans le cadre de référence du sol (points tous les 0,2~s). La divergence après la séparation est clairement visible.}
        \label{fig:overlay_video}
    \end{subfigure}
    \caption{Extrait des résultats d’analyse vidéo pour la reconstruction des trajectoires de référence}
\end{figure}

\newpage
