povdoigt/SP-02/PMI/repport/sections/ch3_stabilite_gabarits/main.tex

\section{Stabilité et gabarits}
\label{sec:stabilite}

L'analyse de la stabilité de la fusée est cruciale pour garantir un vol sûr, prévisible et contrôlé. Dans cette section, nous
détaillerons l'étude effectuée pour évaluer les marges de stabilité de l'ensemble de SP-02 et de chaque étage individuellement.

\input{sections/ch3_stabilite_gabarits/subsec1_stabilite.tex}
\input{sections/ch3_stabilite_gabarits/subsec2_gabarits.tex}
\input{sections/ch3_stabilite_gabarits/subsec3_simulation.tex}

\newpage
