povdoigt/SP-02/PMI/repport/sections/ch3_stabilite_gabarits/subsec3_simulation.tex

\subsection{Simulation de la performance aérodynamique de la fusée}
\label{subsec:simulation_performance}
