povdoigt/SP-02/PMI/repport/sections/ch6_experience/main.tex

\section{Expérience du projet SP-02}

L'expérience du projet SP-02 se concentre sur l'étude aérodynamique de la séparation inter-étages par aérofreinage d'une
fusée bi-étage ainsi que de la tenue mécanique de plusieurs de ses sous-systèmes critiques. Deux volets d'étude principaux
sont abordés dans cette section :
\begin{itemize}
    \item la prédiction pré-vol des grandeurs aérodynamiques et mécaniques par simulation numérique \acrshort{CFD} et
    \acrshort{FEM},
    \item la construction de l'expérience embarquée destinée à valider ces prédictions en vol réel,
\end{itemize} 

\input{sections/ch6_experience/subsec1_aero.tex}
\input{sections/ch6_experience/subsec2_meca.tex}
\input{sections/ch6_experience/subsec3_elec.tex}

\newpage
