povdoigt/SP-02/PMI/repport/sections/ch6_experience/subsec1_aero.tex

\subsection{Prédiction des performances aérodynamiques}

\newpage
