povdoigt/SP-02/PMI/repport/sections/ch6_experience/subsec2_meca.tex

\subsection{Prédiction des performances mécaniques}

\newpage
