povdoigt/SP-02/PMI/repport_FinalVersion/sections/1_Contexte/main.tex

\section{Contexte et cadre de l'étude}
\label{sec:context}

La séparation d’étages constitue un événement critique du vol d’un lanceur multi-étages, dont la réussite conditionne directement
la poursuite nominale de la mission. Dans le cas des lanceurs expérimentaux et des fusées sondes, cette problématique s’inscrit
dans un contexte spécifique, marqué par des contraintes fortes de simplicité, de fiabilité, de coût et de cadre réglementaire,
qui distinguent ces systèmes des lanceurs orbitaux industriels.\\

Cette première partie vise à établir le cadre technique et conceptuel nécessaire à l’étude menée dans le cadre du PMI. Elle
présente tout d’abord les enjeux généraux liés à la séparation d’étages, puis propose une synthèse des principaux principes et
solutions existantes, afin de situer l’approche explorée au regard de l’état de l’art. Les limites rencontrées par ces solutions
dans le contexte des lanceurs expérimentaux sont ensuite discutées, permettant de justifier l’intérêt d’une étude dédiée à une
séparation assistée par l’aérofreinage.\\

Enfin, cette partie introduit le lanceur SP-02 en tant que système hôte de l’étude. Cette présentation est volontairement
synthétique et se limite aux éléments géométriques, structurels et aérodynamiques nécessaires à la compréhension des hypothèses
de modélisation retenues. Elle ne constitue pas une description exhaustive du projet SP-02, mais définit le cadre réaliste dans
lequel s’insèrent les analyses développées dans les sections suivantes.

\input{sections/1_Contexte/1_Problematique.tex}
\input{sections/1_Contexte/2_Etat_art.tex}
\input{sections/1_Contexte/3_Presentation_SP02.tex}
\input{sections/1_Contexte/4_Objectifs.tex}
