povdoigt/SP-02/PMI/repport/sections/ch1_generalites/subsec2_pres_equipe.tex

\subsection{Présentation de l'équipe}
\label{subsec:pres_equipe}

Le projet SP-02 réunit une équipe multidisciplinaire issue de plusieurs promotions de l’\acrshort{IPSA}, associant des étudiants
de niveaux Bachelor 1, 2, 3, cycle préparatoire A1, et cycle ingénieur A3, 4 et 5. Elle combine des compétences en mécanique,
électronique et logiciel embarqué, des étudiants inscrits au \acrshort{PMI}, des membres du club ayant déjà participé à des
projets de fusées expérimentales et des nouveaux arrivants motivés par le défi technique et humain que représente SP-02.\\

Parmi les 17 membres inscrits au projet, on compte :
\begin{itemize}
    \item 1 chef de projet : Malo Amaranti ;
    \item 2 co-chefs de projet : Lucas Pichon et Alexis Paillard ;
    \item 6 membres expérimentés du club AéroIPSA, ayant déjà participé à des projets ;
\end{itemize}
