povdoigt/SP-02/PMI/repport/sections/ch5_elec/subsec2_ligne_mise_a_feu.tex

\subsection{Ligne de mise à feu}
\label{subsec:ligne_mise_a_feu}

La ligne de mise à feu est conçue pour assurer l'allumage fiable et sécurisé du moteur de la fusée SP-02. Elle comprend
deux optocoupleurs servant à isolé chaque partie de la ligne de mise à feu, ainsi qu'un système de sécurité "shunt" pour éviter
tout allumage accidentel.\\

\begin{figure}[h!]
    \centering
    
    \caption{Schéma électrique de la ligne de mise à feu}
    \label{fig:schema_ligne_mise_a_feu}
\end{figure}

\newpage
