povdoigt/SP-02/PMI/repport/sections/ch1_generalites/subsec5_financement_partenaires.tex

\subsection{Financement et partenaires}
\label{subsec:financement_partenaires}

Le financement du projet repose sur plusieurs contributions :
\begin{itemize}
    \item AéroIPSA : budget associatif alloué aux projets techniques ;
    \item \acrshort{IPSA} : soutien académique via la demande de budget \acrshort{PMI} couvrant les dépenses liées à la
    conception et à l’usinage du système de séparation ;
    \item Partenaires industriels : entreprises de fabrication de pièces usinées et fournisseurs de composants électroniques ;
    \item Contributions internes : mise à disposition d’équipements et de consommables par le laboratoire \gls{Skylab}.\\
\end{itemize}

Le budget global estimé du projet SP-02 s’élève à $\approx 3\ 000$ €, dont $\approx600$ € spécifiquement dédiés au volet
académique \acrshort{PMI}. Les dépenses sont réparties entre les composants structurels (tubes, bagues, pièces CAO usinées),
électroniques (capteurs, alimentation, télémesure) et actionneurs (servomoteurs, système aérofrein).
