povdoigt/SP-02/PMI/repport/sections/ch4_meca/main.tex

\section{Structure mécanique}
\label{sec:structure_meca}

% Le projet SP-02 a été défini comme une fusée bi-étage avec réduction de diamètre -- passant de 104mm pour notre premier étage à
% 84mm pour le second -- pour accroître notre stabilité globale. La longueur totale de la fusée est 2,10 m.\\

% En souhaitant développer ce nouveau lanceur bi-étage, nous avons pour objectif de pérenniser nos processus de fabrication et de
% validation menés au cours de nos précédents projets, et améliorés depuis. L'objectif de cette partie est donc de démontrer
% l'efficience de nos procédés tout en expliquant l'architecture définie pour nos deux étages.

\input{sections/ch4_meca/subsec1_generalite.tex}
\input{sections/ch4_meca/subsec2_choix_materiaux.tex}
\input{sections/ch4_meca/subsec3_premier_etage.tex}
\input{sections/ch4_meca/subsec4_sys_sepa.tex}
\input{sections/ch4_meca/subsec5_second_etage.tex}
\input{sections/ch4_meca/subsec6_rampe.tex}
\newpage
