povdoigt/SP-02/PMI/repport/sections/ch5_elec/main.tex

\section{Electronique}
\label{sec:electronique}

Voici le schéma fonctionnel de l'électronique embarquée à bord de la fusée SP-02 :

\begin{figure}[h]
    \centering
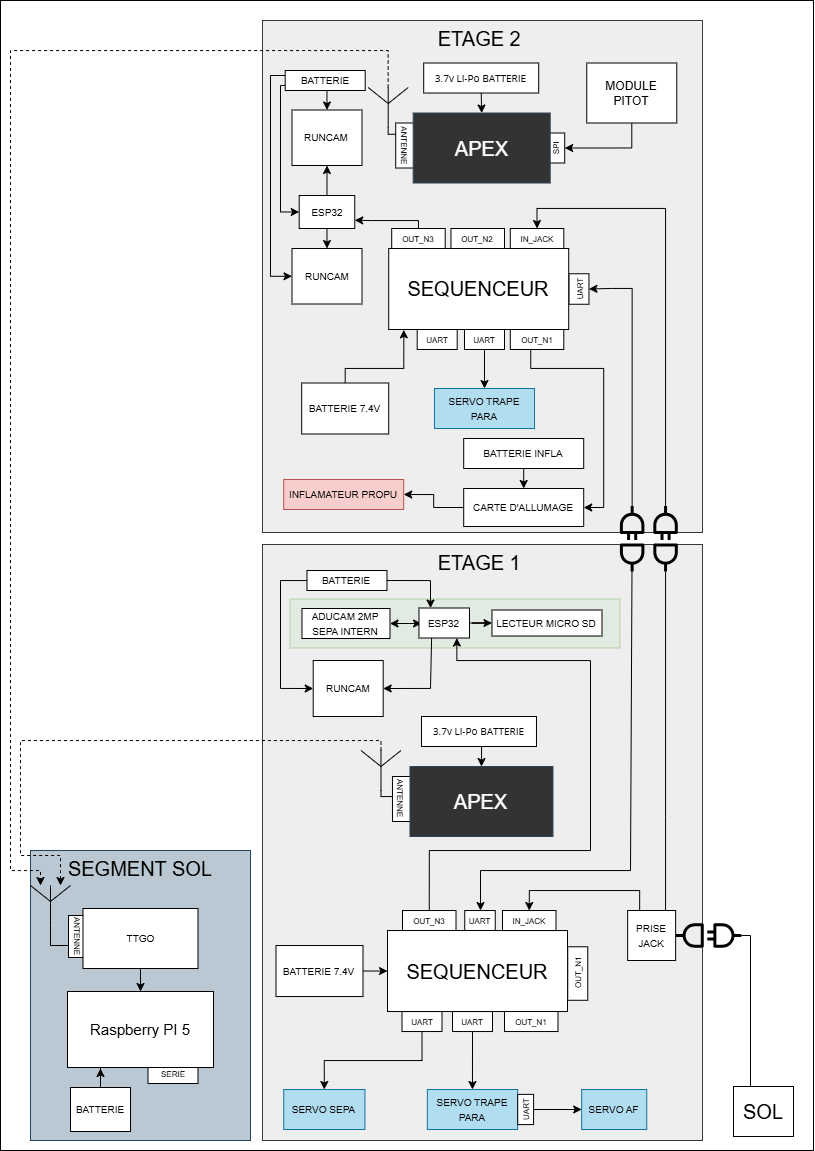
[picture p158: PMI/repport/figures/SP02.drawio.png]
    
    \caption{Schéma fonctionnel de l'électronique embarquée}
    \label{fig:schema_fonctionnel_electronique}
\end{figure}

\input{sections/ch5_elec/subsec1_sequenceurs.tex}
\input{sections/ch5_elec/subsec2_ligne_mise_a_feu.tex}
\input{sections/ch5_elec/subsec3_experience.tex}

\newpage
