povdoigt/SP-02/PMI/repport/sections/ch1_generalites/main.tex

\section{Généralités}
\label{sec:generalites}

Ce chapitre présente le cadre général du projet SP-02, depuis l’organisation du club AéroIPSA jusqu’à la planification des
travaux. Il expose la structure de l’équipe, les objectifs techniques et académiques, les moyens de financement et la
répartition des responsabilités nécessaires à la bonne conduite du projet.\\

\input{sections/ch1_generalites/subsec1_pres_club.tex}
\input{sections/ch1_generalites/subsec2_pres_equipe.tex}
\input{sections/ch1_generalites/subsec3_def_projet.tex}
\input{sections/ch1_generalites/subsec4_retour_exp.tex}
\input{sections/ch1_generalites/subsec5_financement_partenaires.tex}
\input{sections/ch1_generalites/subsec6_planification.tex}

\newpage
