povdoigt/SP-02/PMI/repport_FinalVersion/PMI_ET2_rapport.pdf

Institut Polytechnique des Sciences Avancées | AéroIPSA
63 bvd de Brandbourg | 63 bvd de Brandbourg
94200 Ivry-sur-Seine | 94200 Ivry-sur-Seine

# ET2 : Perspective d’expérience d’un système de séparation d’étages de fusée par aérofreinage


Projet SP-02, fusée bi-étage, AéroIPSA 2025-2026

Rédacteurs du document :
- PAILLARD Alexis
- PICHON Lucas
- LE CAM Maxens
- PEIX Guillaume
Tuteur :
- ABASSI Wafik | Janvier 2025

## Remerciements

TABLE DES MATIÈRES

## Table des matières

Introduction | 7
1 Contexte et cadre de l’étude | 8
2 Conception des systèmes de séparation et d’aérofrein | 19
3 Méthodologie | 22
4 Résultat | 23
5 Emsemble des réalisations | 25
Conclusion | 28
Liste des figures | 29
Liste des tableaux | 29
Références | 30
Glossaires et acronymes | 31
A Annexes | 32

TABLE DES MATIÈRES

TABLE DES MATIÈRES
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
