povdoigt/SP-02/ARCHI/SP02_2.drawio.png

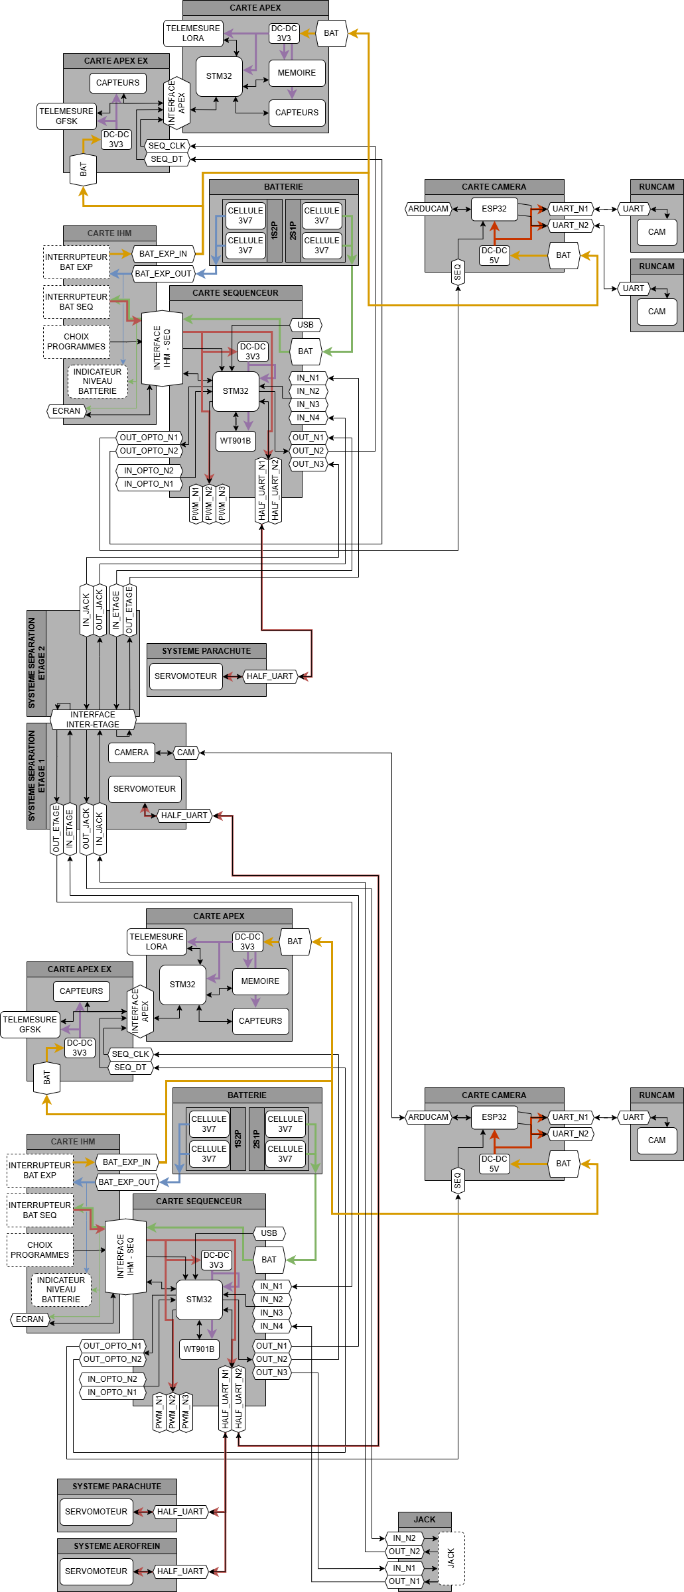
ARCHI/SP02_2.drawio.png
