povdoigt/SP-02/ARCHI/SP02_system.jpg

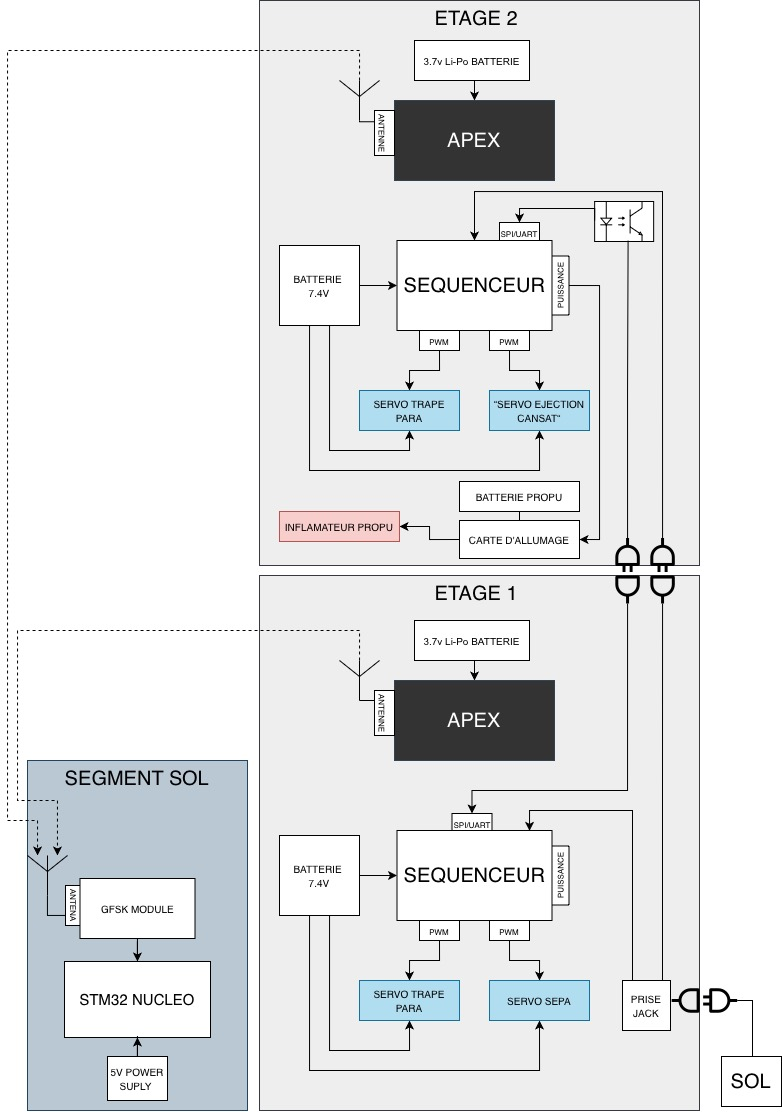
ARCHI/SP02_system.jpg
