povdoigt/SP-02/ELEC/OSKOUR.png

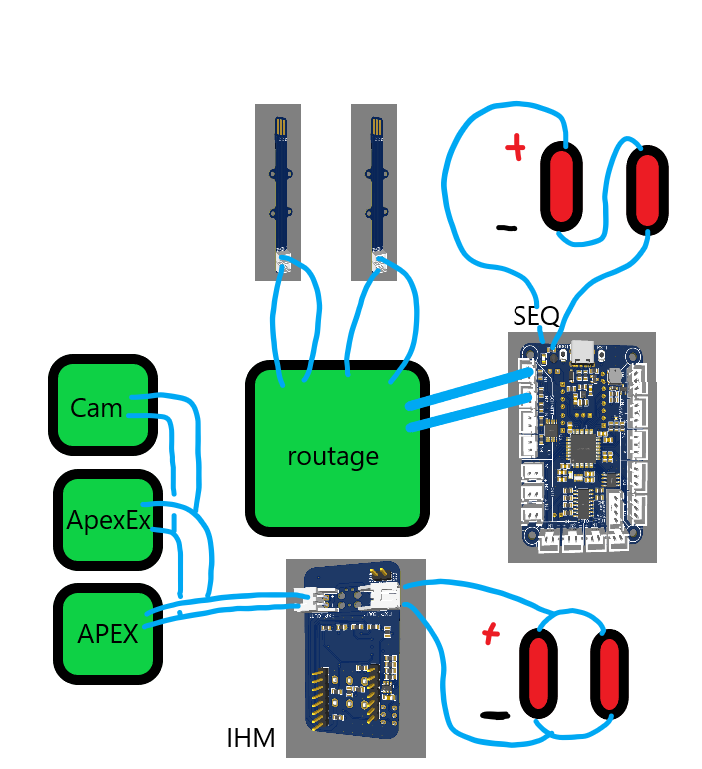
ELEC/OSKOUR.png
