povdoigt/SP-02/OPENROCKET/simu/sp02_v3_24_3g.png

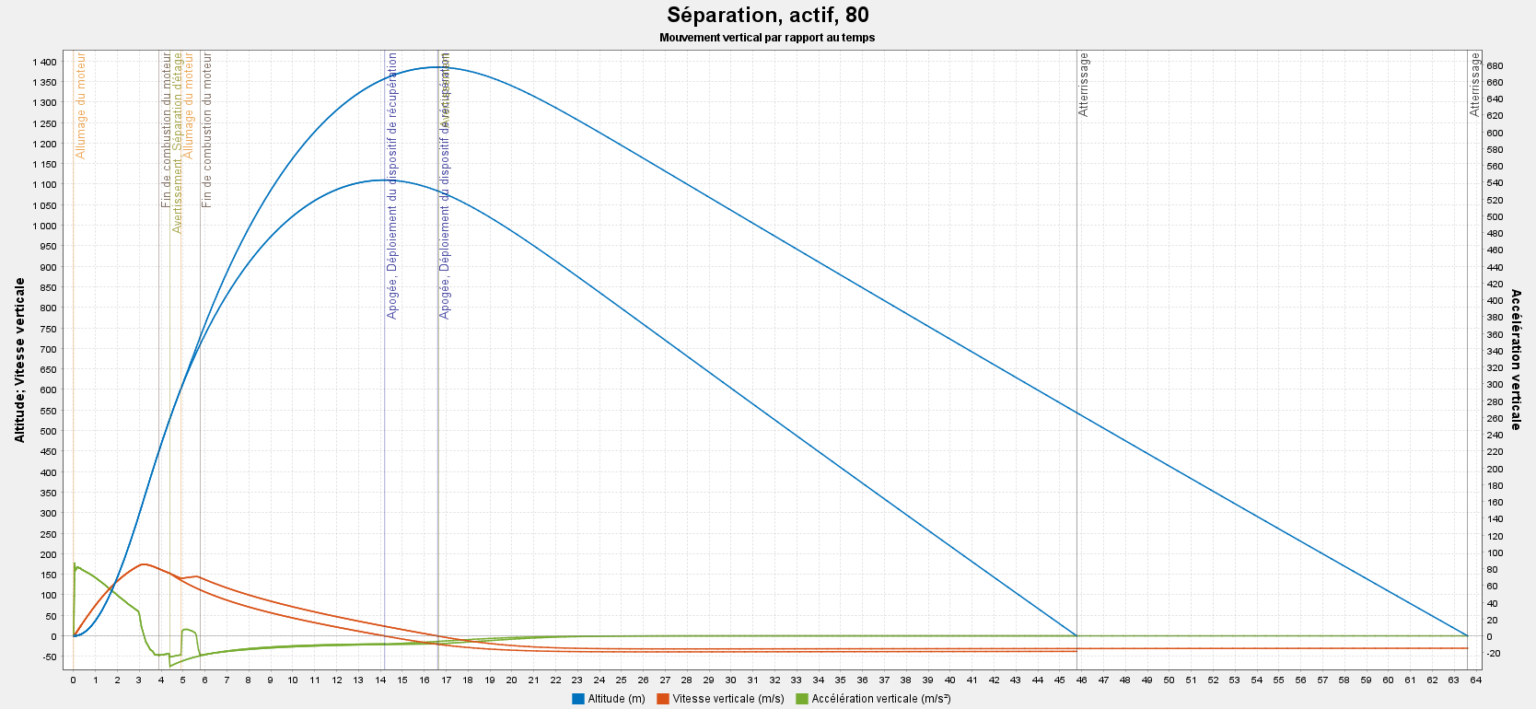
OPENROCKET/simu/sp02_v3_24_3g.png
