povdoigt/SP-02/OPENROCKET/simu/sp02_v3_38.png

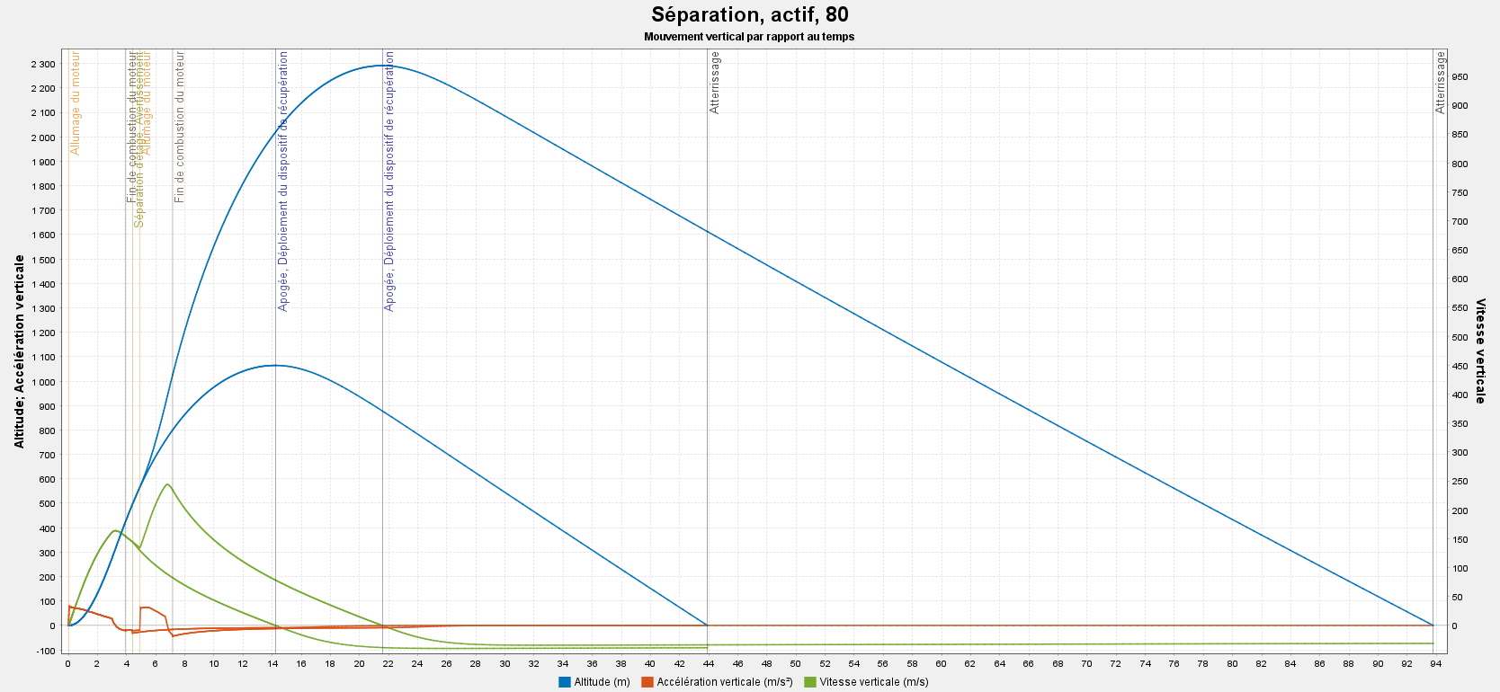
OPENROCKET/simu/sp02_v3_38.png
