povdoigt/SP-02/OPENROCKET/simu/sp02_v3_54_570.png

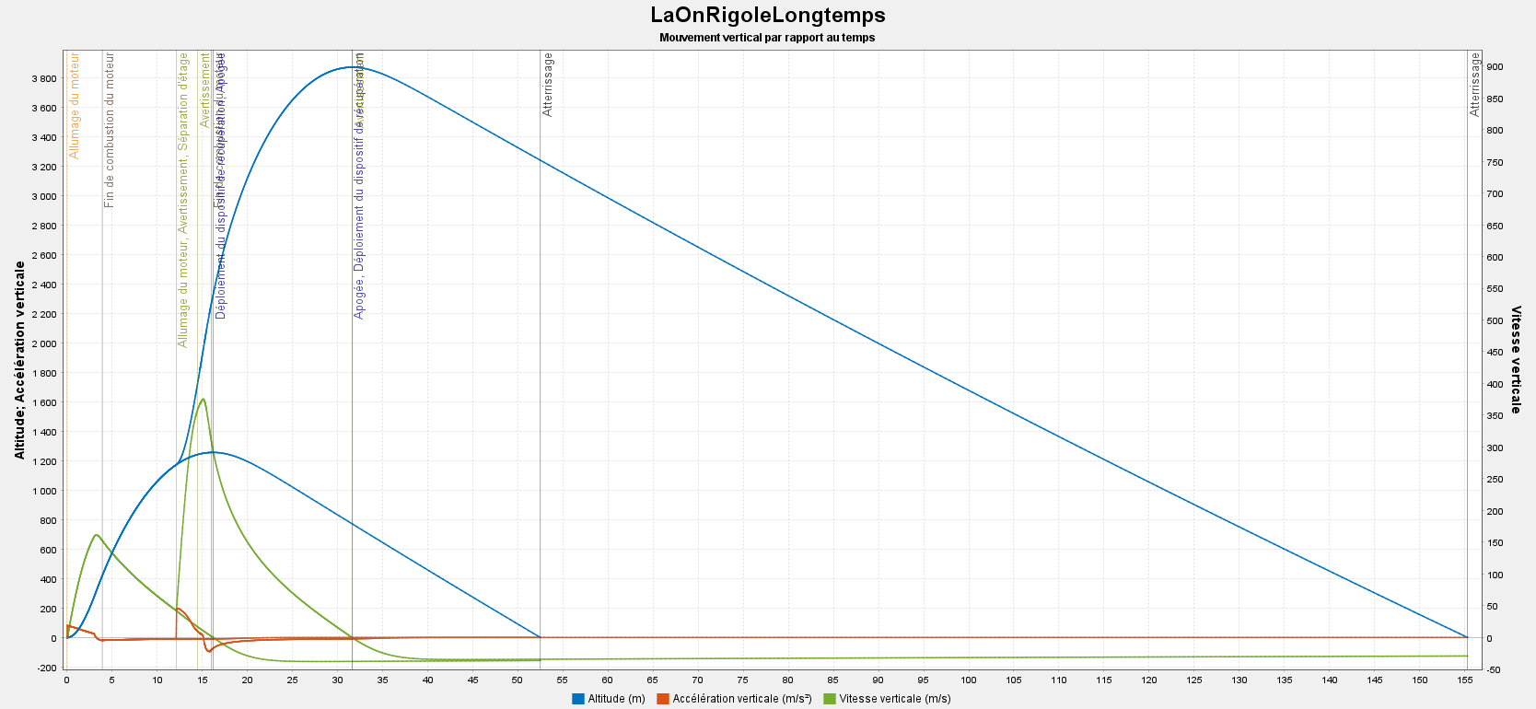
OPENROCKET/simu/sp02_v3_54_570.png
