povdoigt/SP-02/OPENROCKET/simu/sp02_v3_54_1200.png

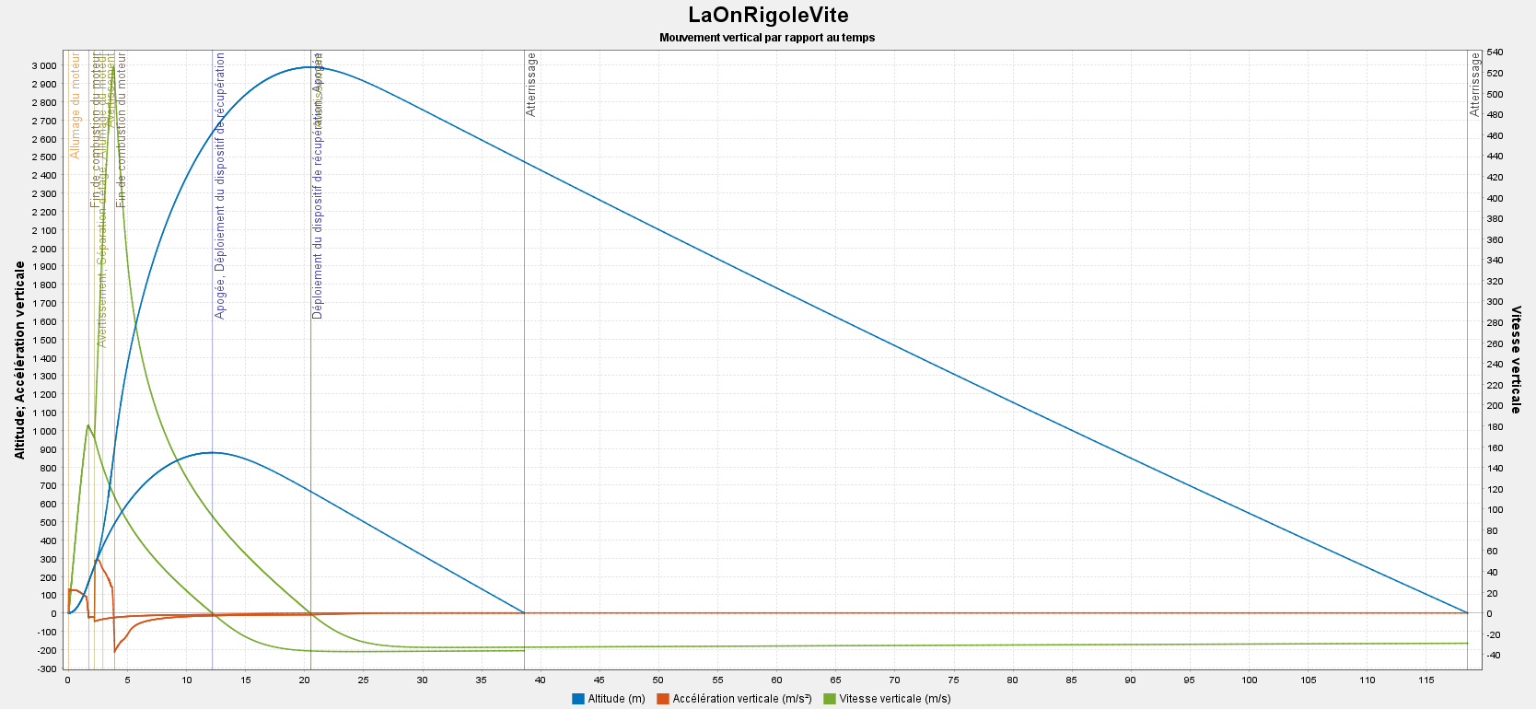
OPENROCKET/simu/sp02_v3_54_1200.png
