povdoigt/SP-02/PMI/repport/figures/alpha.png

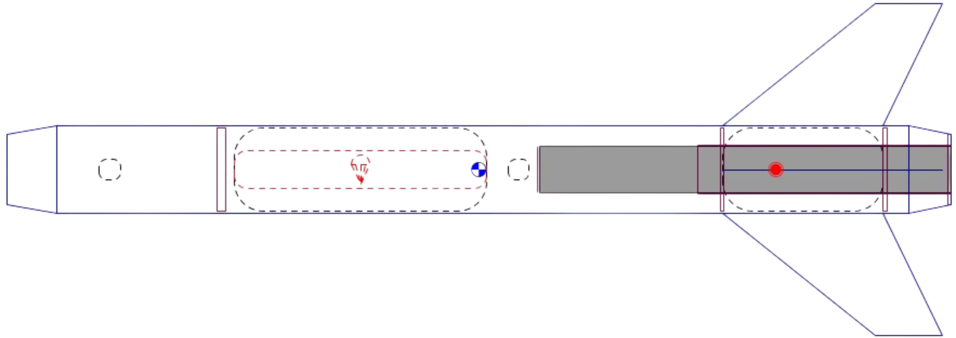
PMI/repport/figures/alpha.png
