povdoigt/SP-02/PMI/repport/figures/beta.jpg

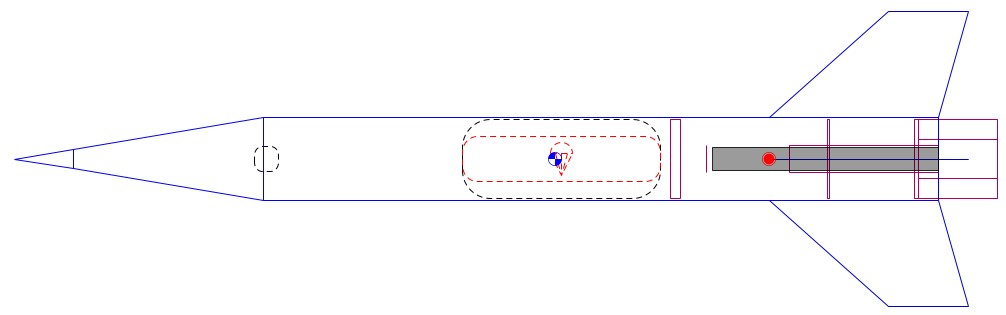
PMI/repport/figures/beta.jpg
