povdoigt/SP-02/PMI/repport/figures/beta.png

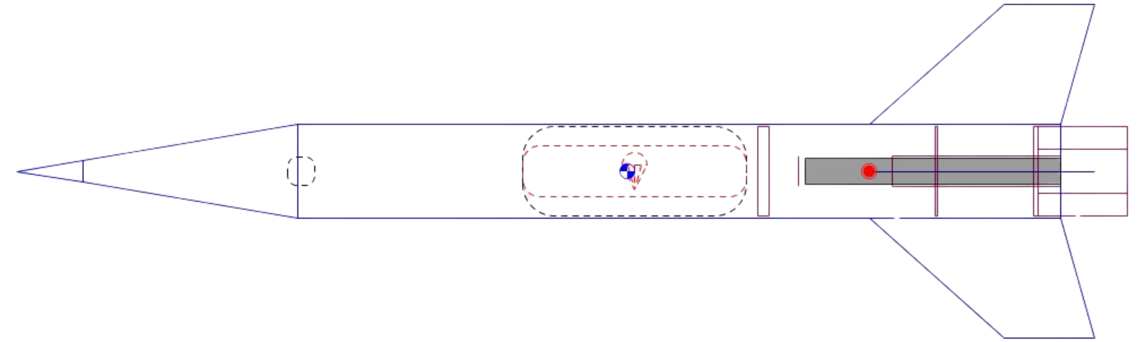
PMI/repport/figures/beta.png
