povdoigt/SP-02/PMI/repport/figures/IMG_2012.png

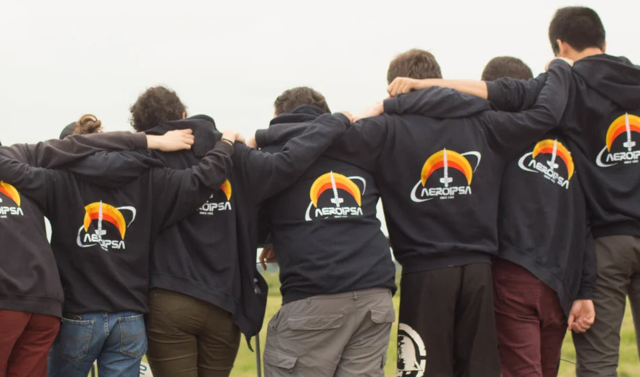
PMI/repport/figures/IMG_2012.png
