povdoigt/SP-02/PMI/repport/figures/Schematic_SP02_Allumage_2025-11-30.png

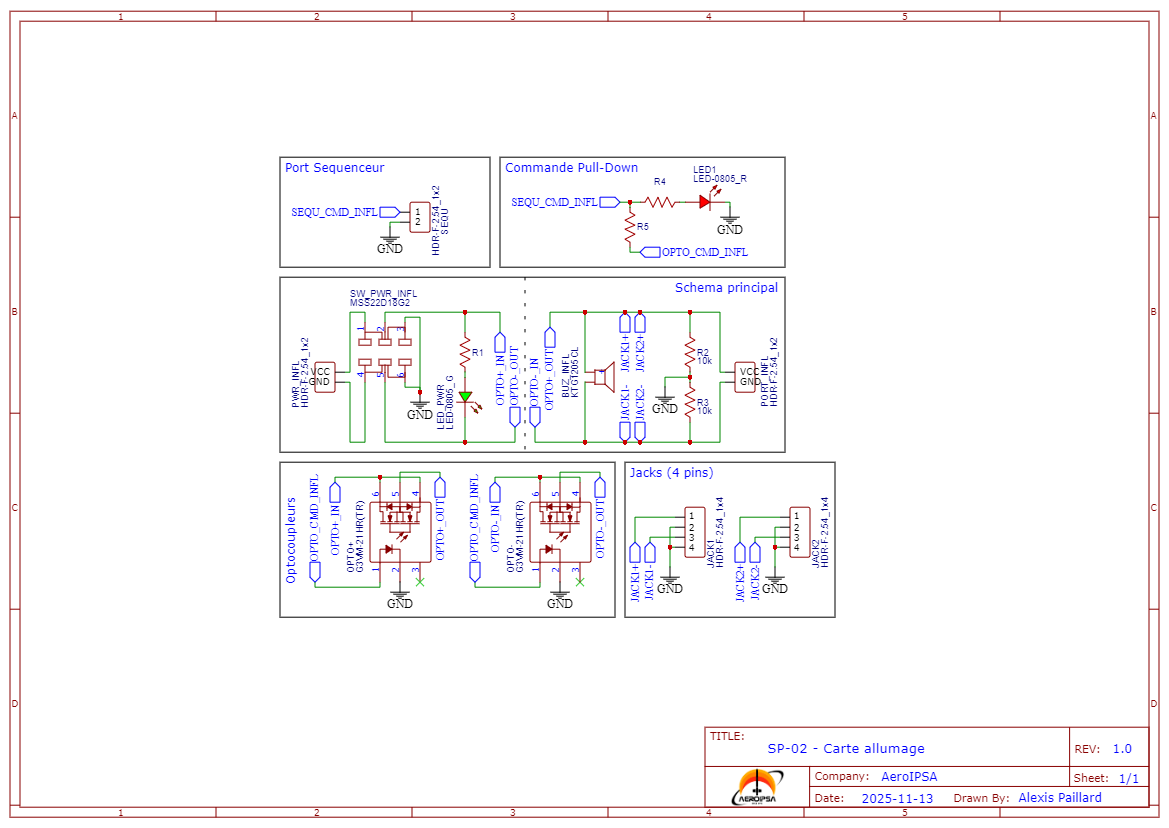
PMI/repport/figures/Schematic_SP02_Allumage_2025-11-30.png
