povdoigt/SP-02/PMI/repport/figures/SP01.png

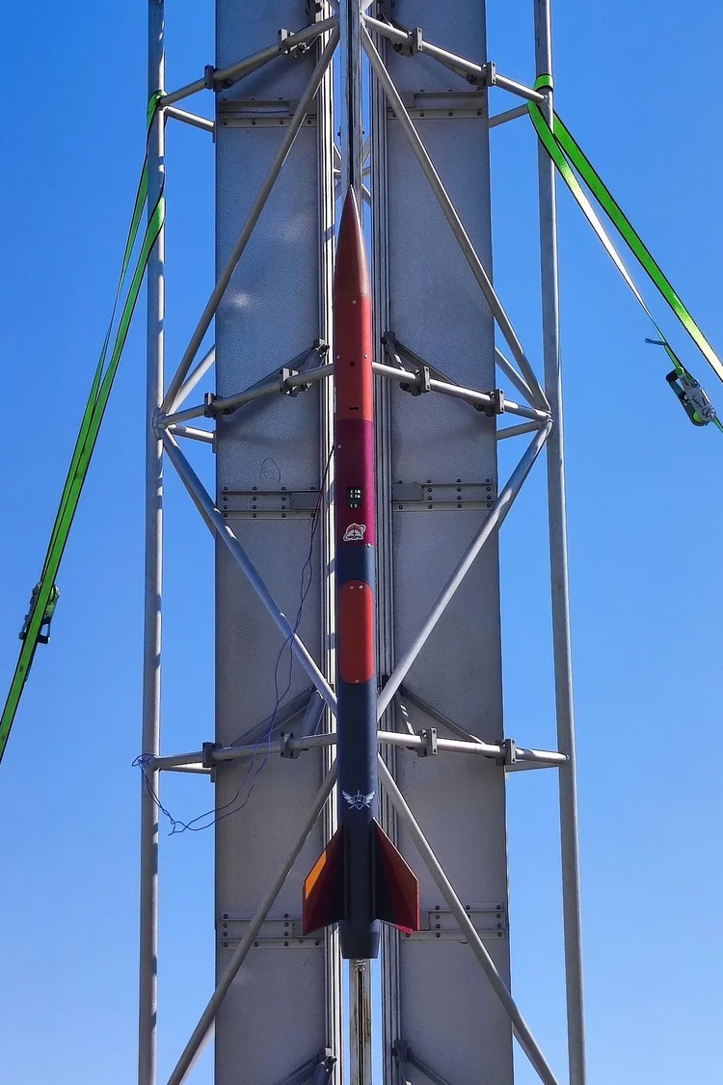
PMI/repport/figures/SP01.png
