povdoigt/SP-02/PMI/repport_FinalVersion/figures/20260126_120936.jpg

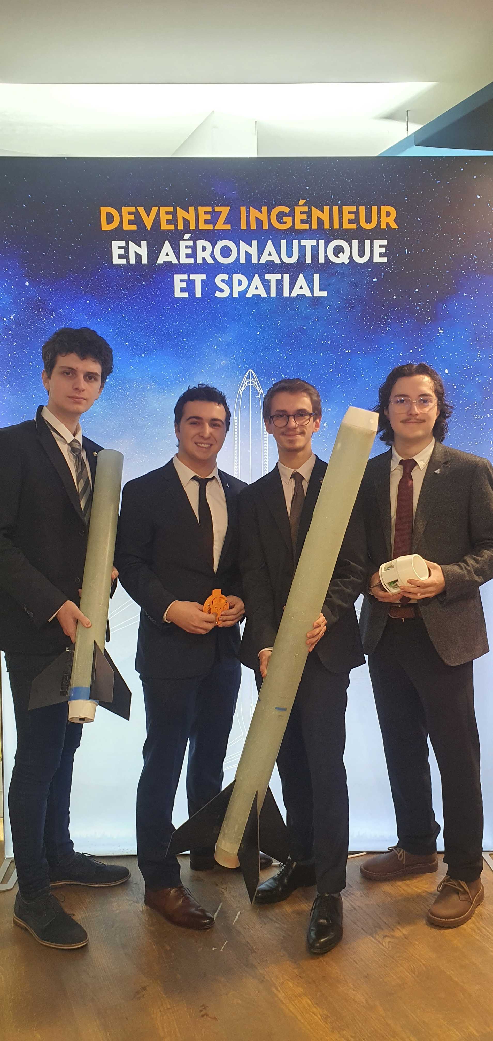
PMI/repport_FinalVersion/figures/20260126_120936.jpg
