povdoigt/SP-02/PMI/repport_FinalVersion/figures/20260128_190731.jpg

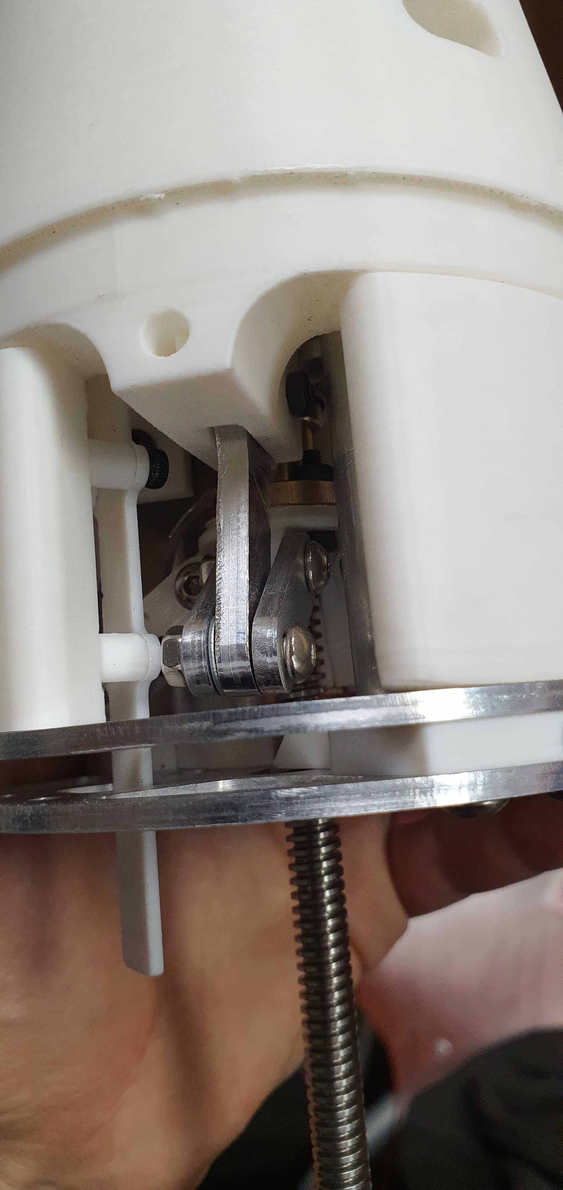
PMI/repport_FinalVersion/figures/20260128_190731.jpg
