povdoigt/SP-02/PMI/repport_FinalVersion/figures/20260128_190736.jpg

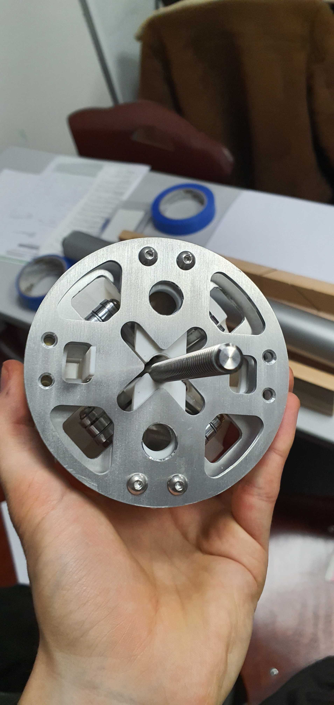
PMI/repport_FinalVersion/figures/20260128_190736.jpg
