povdoigt/SP-02/PMI/repport_FinalVersion/figures/allpied_loades.png

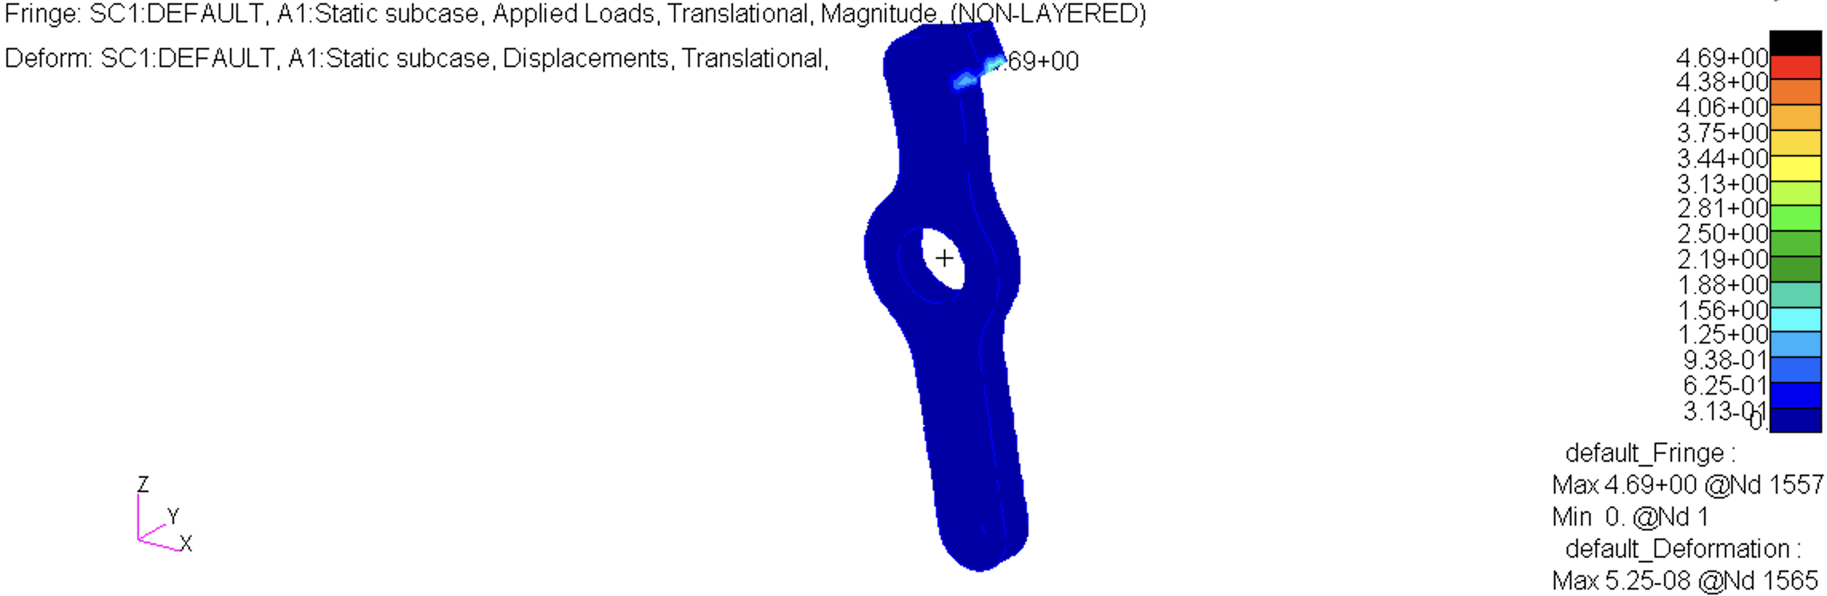
PMI/repport_FinalVersion/figures/allpied_loades.png
