povdoigt/SP-02/PMI/repport_FinalVersion/figures/apex_bes/APEX_BACK.png

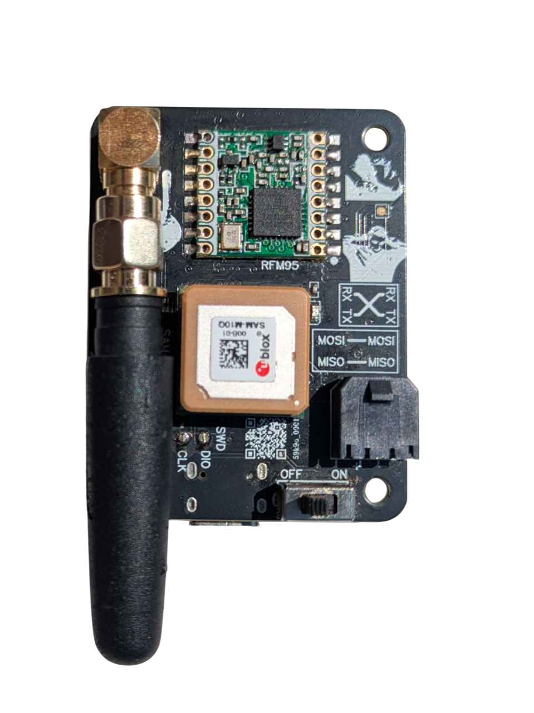
PMI/repport_FinalVersion/figures/apex_bes/APEX_BACK.png
