povdoigt/SP-02/PMI/repport_FinalVersion/figures/apex_bes/APEX_FRONT.png

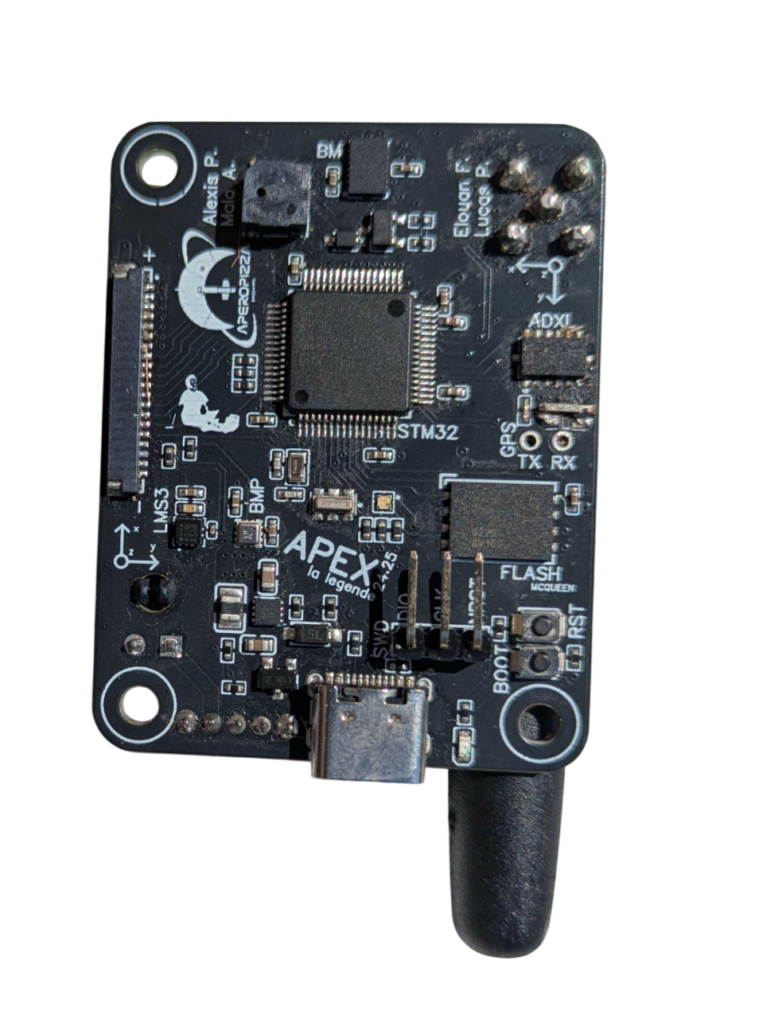
PMI/repport_FinalVersion/figures/apex_bes/APEX_FRONT.png
