povdoigt/SP-02/PMI/repport_FinalVersion/figures/apex_bes/Capture d’écran 2026-01-08 à 18.46.22.png

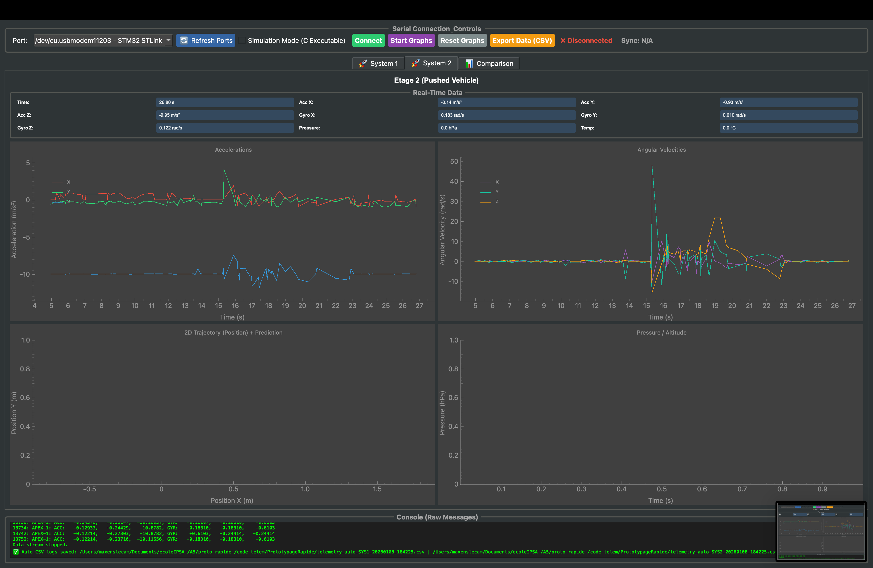
PMI/repport_FinalVersion/figures/apex_bes/Capture d’écran 2026-01-08 à 18.46.22.png
