povdoigt/SP-02/PMI/repport_FinalVersion/figures/apex_bes/Capture d’écran 2026-01-17 à 10.32.52.png

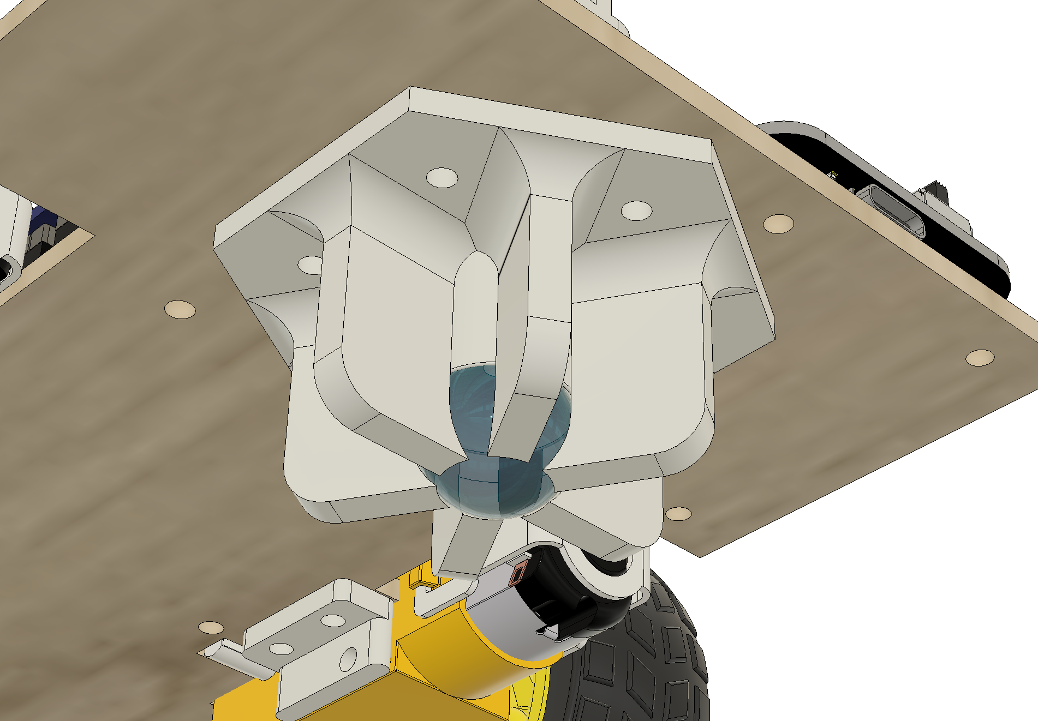
PMI/repport_FinalVersion/figures/apex_bes/Capture d’écran 2026-01-17 à 10.32.52.png
