povdoigt/SP-02/PMI/repport_FinalVersion/figures/apex_bes/robot_proto_draw.png

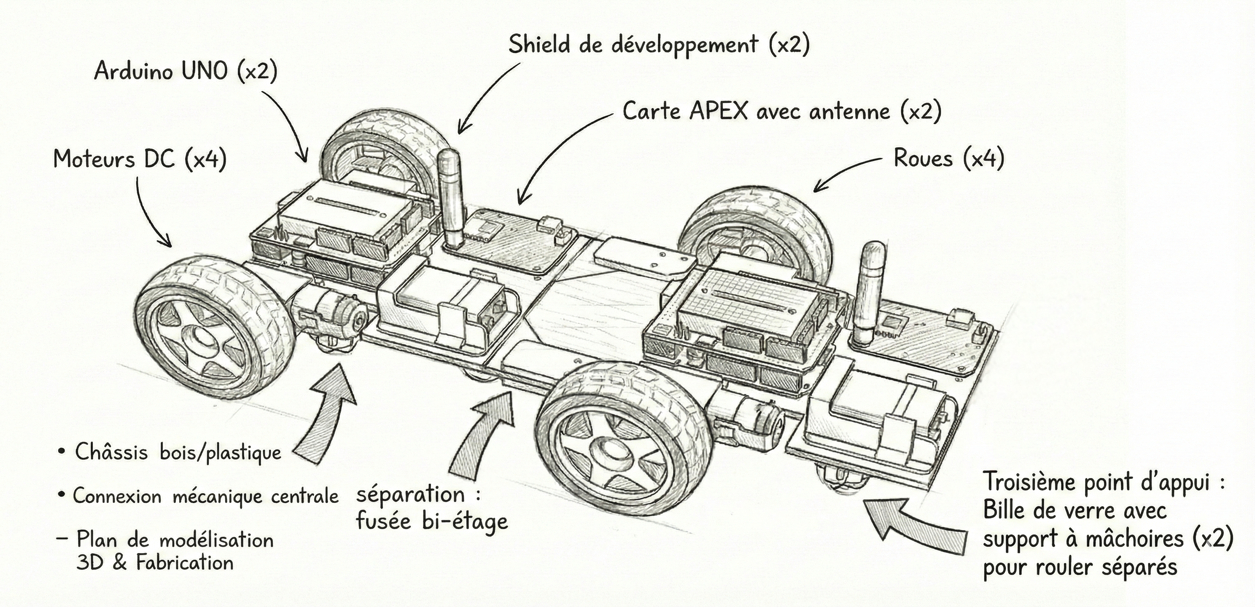
PMI/repport_FinalVersion/figures/apex_bes/robot_proto_draw.png
