povdoigt/SP-02/PMI/repport_FinalVersion/figures/apex_bes/superposition_temps.png

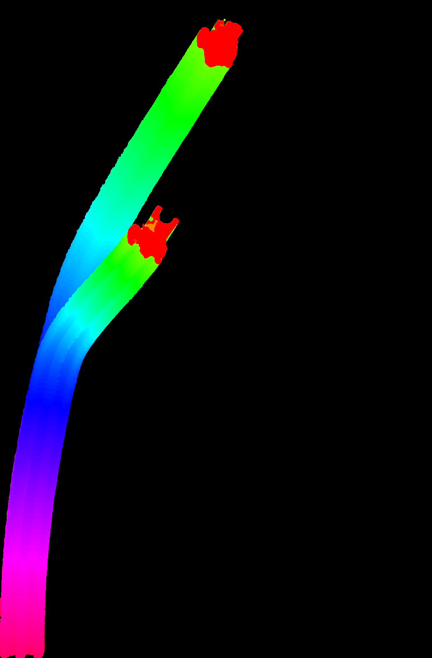
PMI/repport_FinalVersion/figures/apex_bes/superposition_temps.png
