povdoigt/SP-02/PMI/repport_FinalVersion/figures/APX_algo_simplifie.jpg

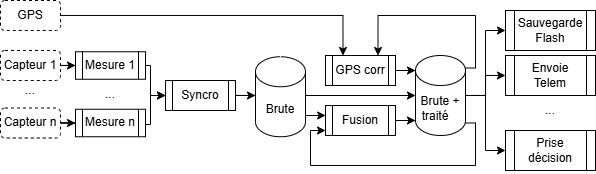
PMI/repport_FinalVersion/figures/APX_algo_simplifie.jpg
