povdoigt/SP-02/RAPPORT/DOSSIER SUIVI/figures/allumage_matlab.jpg

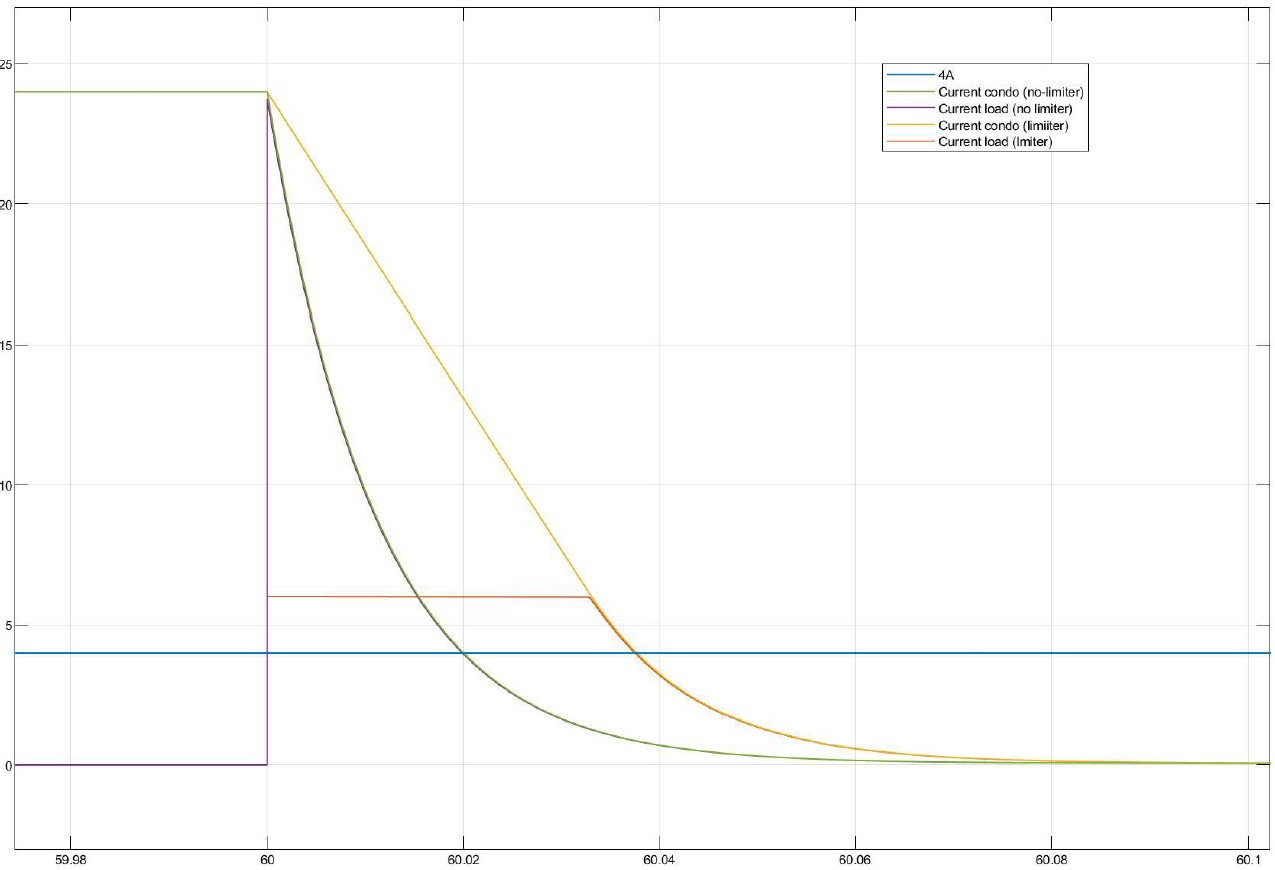
RAPPORT/DOSSIER SUIVI/figures/allumage_matlab.jpg
