povdoigt/SP-02/RAPPORT/DOSSIER SUIVI/figures/matlab_allumage.jpg

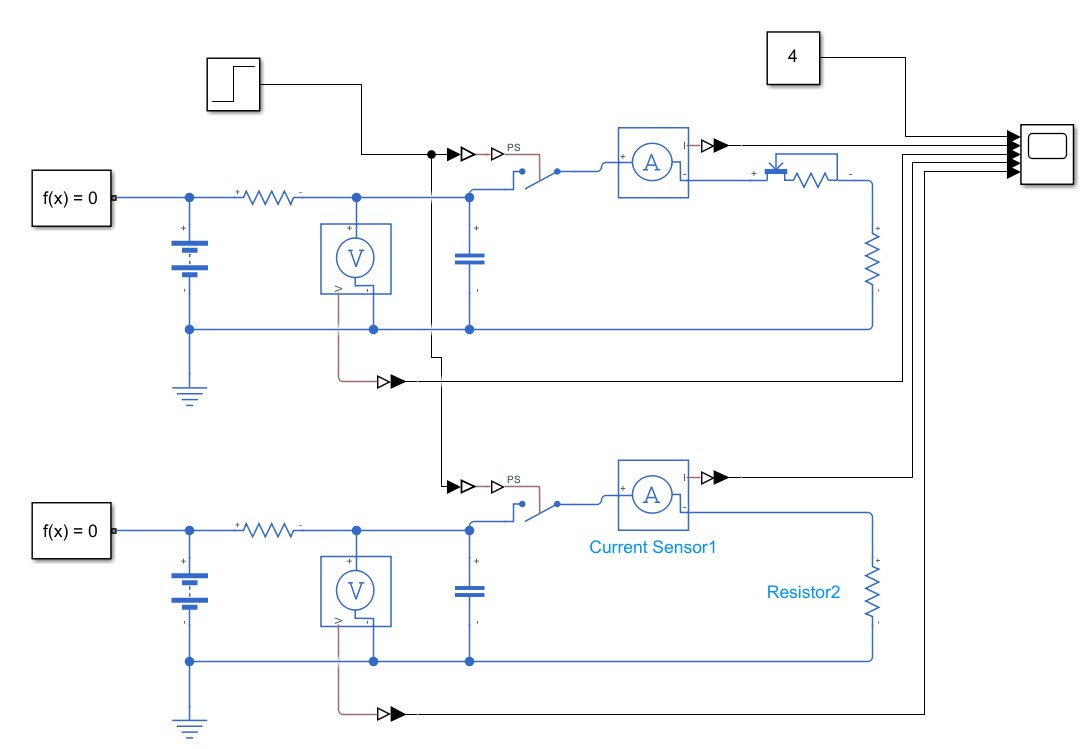
RAPPORT/DOSSIER SUIVI/figures/matlab_allumage.jpg
