povdoigt/SP-02/RAPPORT/DOSSIER SUIVI/figures/PCB_Alumage_condo.jpg

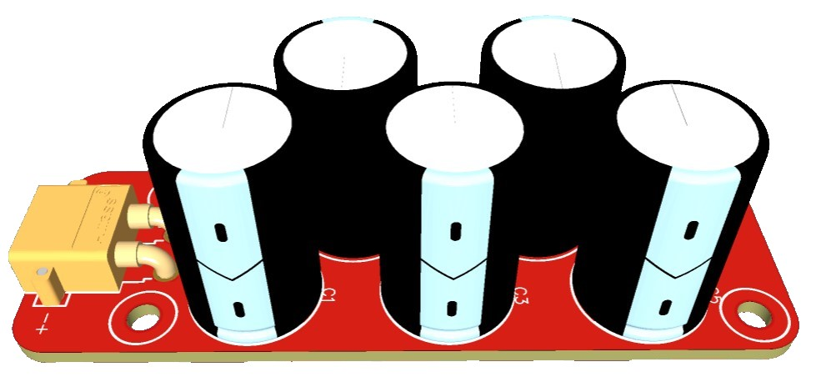
RAPPORT/DOSSIER SUIVI/figures/PCB_Alumage_condo.jpg
