povdoigt/SP-02/RAPPORT/PRESENTATION PROJET/balistico.png

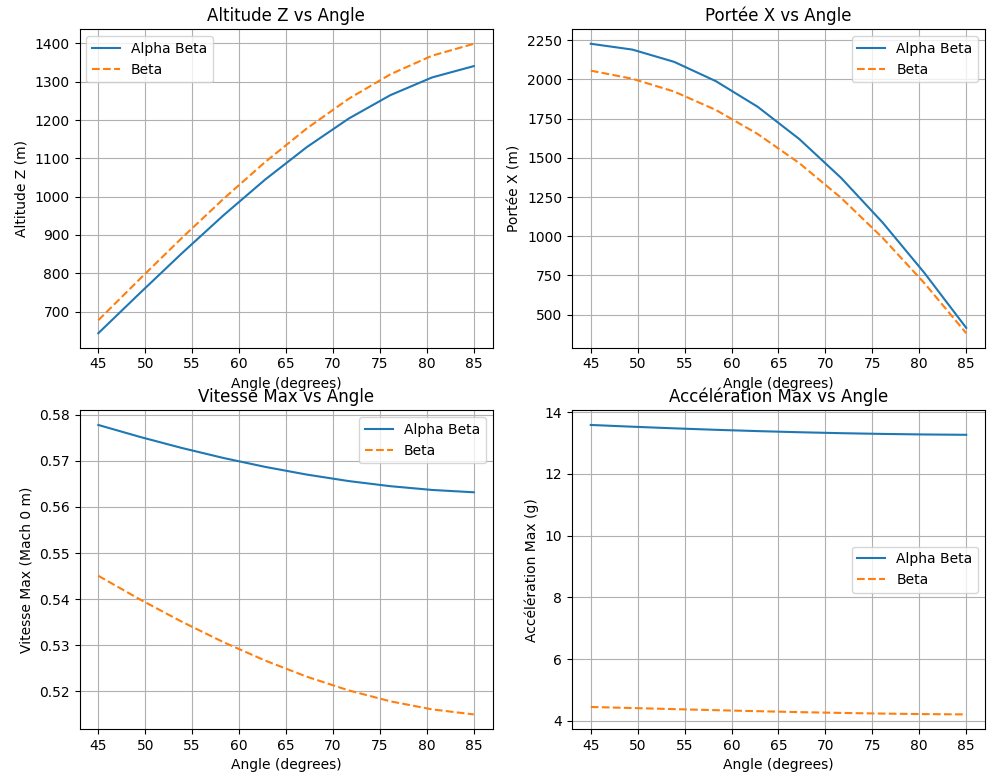
RAPPORT/PRESENTATION PROJET/balistico.png
