povdoigt/SP-02/STABTRAJ/sp02_v3_38/porteex_vs_angle_rampe.png

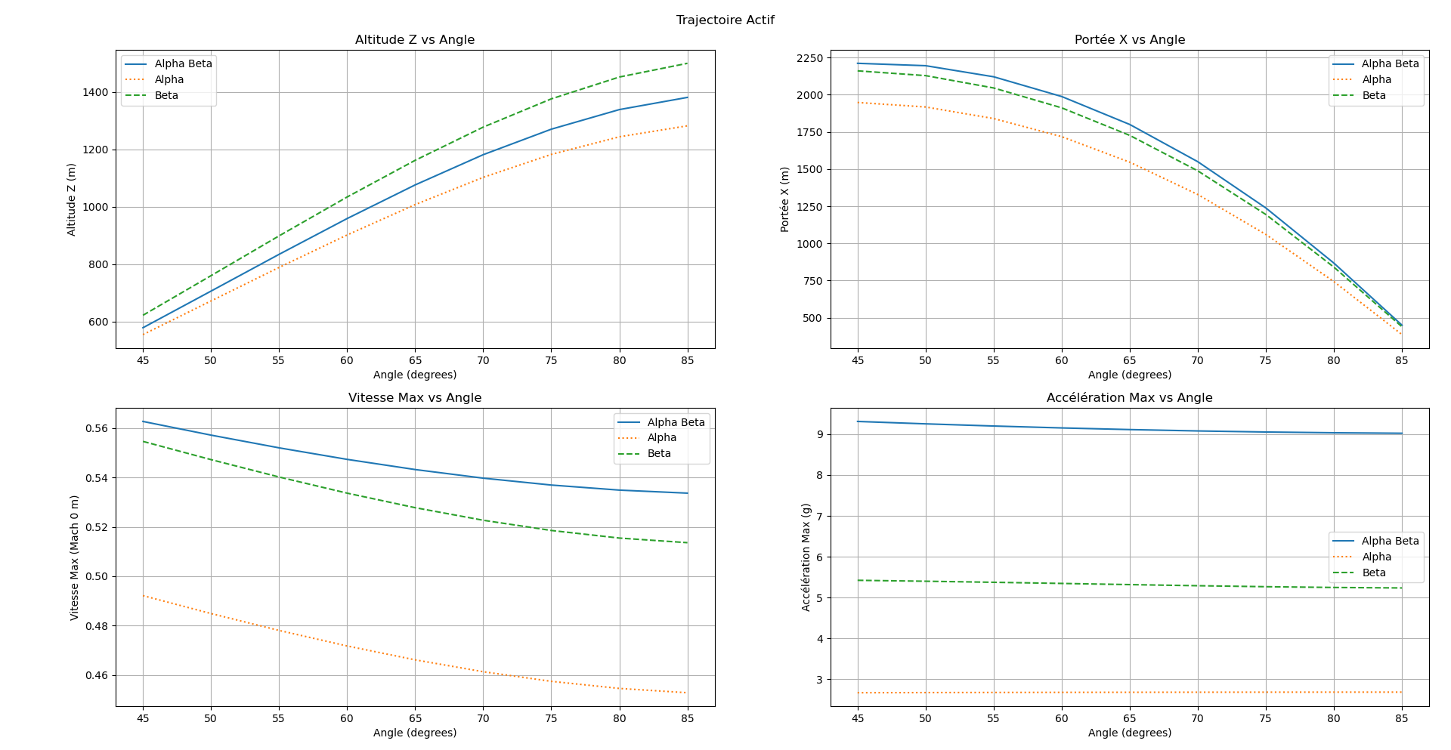
STABTRAJ/sp02_v3_38/porteex_vs_angle_rampe.png
