povdoigt/SP-02/STABTRAJ/sp02_v3_38/stabilite_DREF.png

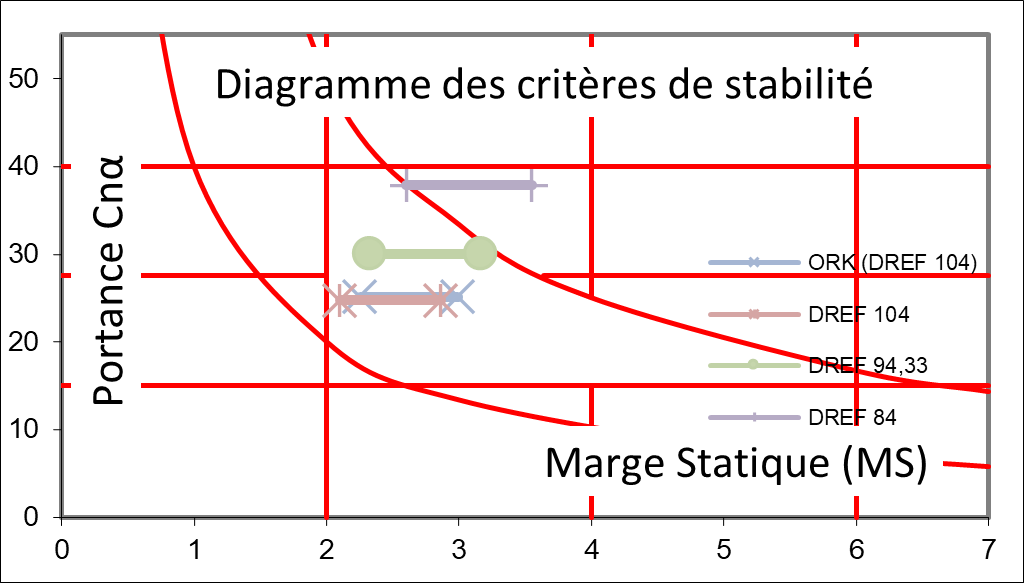
STABTRAJ/sp02_v3_38/stabilite_DREF.png
