povdoigt/SP-02/STABTRAJ/sp02_v3_38/traj.jpg

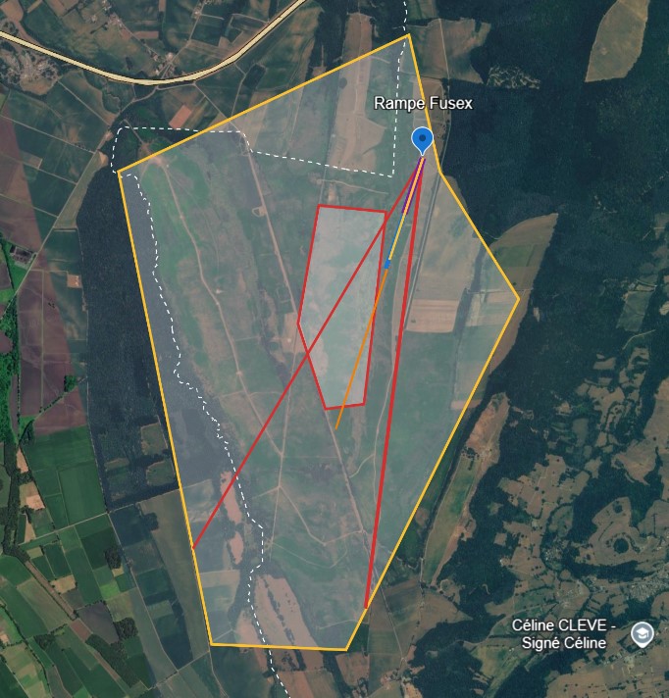
STABTRAJ/sp02_v3_38/traj.jpg
