povdoigt/SP-02/STABTRAJ/sp02_v3_38/Alpha/alpha.xlsx

Sheet: Stabilito
 |  | STABILITO |  |  |  |  |  |  |  | Language/Langue | Français
 |  | Stabilité de fusée à ailerons |  |  |  |  |  |  |  |  | Plusieurs diamètres.
 |  |  |  |  |  |  |  |  |  |  | Transition A |  | Transition B
 |  | Remplir les cases jaunes |  |  |  |  |  |  |  | Longueur 'L' | 60 mm |  | 50 mm
 |  | Fusée |  |  |  |  |  |  |  | Diamètre 'D1' | 84 mm |  | 104 mm
 | Nom | SP02 |  |  |  |  |  |  |  | Diamètre 'D2' | 104 mm |  | 84 mm
 | Club | L'AéroIPSA |  |  |  |  |  |  |  | Implantation 'x' | 1 mm |  | 1070 mm
 | Matricule | FX | 0 | FX0
 | Type | Fusée expérimentale. |  |  |  |  |  |  |  |  | Propu plein | Propu vide |  | Sans propu |  |  | Propulseur
 | Masse | 4341 g | sans propu |  |  |  |  |  |  | Masse propu | 1.685 kg | 0.652 kg |  | - |  | Haut | 632 mm
 | Centre de Masse | 493 mm | sans propu |  |  |  |  |  |  | CdM propu | 250 mm | 240 mm |  | - |  | Longueur | 488 mm
 | Longueur totale | 1120 mm |  |  |  |  |  |  |  | Masse fusée | 6.026 kg | 4.993 kg |  | 4.341 kg |  | Bas | 1120 mm
 | Diamètre Réf. | 104 mm |  |  |  |  |  |  |  | CdM fusée | 601.7728178 mm | 542.4908872 mm |  | 493 mm
 |  |  |  |  |  |  |  |  |  |  |  |  |  |  |  |  | Ailerons bas
 |  | Propulseur |  |  |  |  |  |  |  |  | XCp |  | Cnα |  |  | Haut | 860 mm
 | Type | Barasinga (Pro54-5G C) |  |  |  |  |  |  |  | Coiffe | 0.6666666667 mm |  | 1.3 |  |  | Emplanture | 210 mm
 | Position du bas | 1120 mm |  |  |  |  |  |  |  | Ailerons | 977.3563218 mm |  | 14.9 |  |  | Bas | 1070 mm
 |  |  |  |  |  |  |  |  |  | Ail bas entier | 977.3563218 mm |  | 14.9
 |  | Coiffe |  |  |  |  |  |  |  | Ailerons haut | 0 mm |  | 0.0
 | Forme | Conique (droite) |  |  |  |  |  |  |  | Partie masquée | 0 mm |  | 0.0
 | Hauteur | 1 mm |  |  |  |  |  |  |  | Transition A | 32.06382979 mm |  | 0.7
 | Diamètre | 84 mm |  |  |  |  |  |  |  | Transition B | 1094.113475 mm |  | -0.7
 |  |  |  | M
 |  | Ailerons | Ailerons haut |  | 2026-04-04 | Min | Résultats |  | Max
 |  | Mono-empennage |  | 210 | Finesse | 10 | 10.8 |  | 35
 | Emplanture 'm' | 210 mm | 180 mm | 111.3793103 | Portance | 15 | 16.2 | 16.2 | 40
 | Saumon 'n' | 80 mm | 80 mm | 140.3448276 | MargeStat. | 2 D | 2.42 D | 2.99 D | 6 D
 | Flèche 'p' | 185 mm | 160 mm | 110 | Couple | 40 | 39.2 | 48.4 | 100 |  |  |  |  |  |  | Ailerons trop petits ou trop haut /CdM !
 | Envergure 'E' | 145 mm | 110 mm | 4 | XCp |  | 853.1418257 mm | 853.1418257 mm
 | Epaisseur 'ep' | 4 mm | 4 mm | 4 | MS /L |  | 22.44366142% L | 27.73669094% L
 | Nombre | 4 | 4 | 1070 |  |  | INSTABLE
 | Position du bas | 1070 mm | 1250 mm | 104
 | Diamètre | 104 mm | 104 mm | 142.7840224
 | Ligne mi-corde f | 188.2153022 mm | 155.5634919 mm
 | Commentaire libre : |  |  |  |  |  |  |  |  | Checksum : | propu OK | fichier initial |  |  | v3.4.5
 |  |  |  |  |  |  |  |  |  | Maintenant que votre fusée est stable, vérifiez sa trajectoire via la feuille | Trajecto
 | Textes pour les listes déroulantes et graphiques :
 | Français
 | English
 | Fusée à eau
 | Microfusée
 | Minifusée
 | Fusée expérimentale.
 | ,Minif Tests
 | sans propu
 | avec propu vide
 | avec propu plein
 | Parabolique (arrondie)
 | Ogivale (pointue)
 | Conique (droite)
 | Mono-empennage
 | Bi-empennage
 | Fusée mono-diamètre,
 | Plusieurs diamètres.
 | Diagramme des critères de stabilité
 | Marge Statique (MS)
 | Portance Cnα
 | Données pour les graphiques :
 |  | X longi | Y latéral | - Y latéral
 | Ogive | -1 | 0 | 0
 | Ogive | -1 | 42 | -42
 | chmt1 pt1 | -1 | 42 | -42
 | chmt1 pt2 | -61 | 52 | -52
 | chmt2 pt1 | -1070 | 52 | -52
 | chmt2 pt2 | -1120 | 42 | -42
 | culot | -1120 | 42 | -42
 | culot | -1120 | 0 | 0
 | aileron pt1 | -860 | 52 | -52
 | aileron pt2 | -1045 | 197 | -197
 | aileron pt3 | -1125 | 197 | -197
 | aileron pt4 | -1070 | 52 | -52
 | aileron pt1 | -860 | 52 | -52
 | Envergure | -1162.333333 | -197
 | env milieu | -1162.333333 | -124.5
 | env pt4 | -1162.333333 | -52
 | Emplanture | -860 | 253
 | empl milieu | -965 | 253
 | empl pt4 | -1070 | 253
 | Flèche | -860 | -234.3333333
 | flèche milieu | -952.5 | -234.3333333
 | flèche pt2 | -1045 | -234.3333333
 | Saumon | -1045 | -253
 | saumon milieu | -1085 | -253
 | saumon pt3 | -1125 | -253
 | Xcg plein | -601.7728178 | 0
 | Xcg vide | -542.4908872 | 0
 | Xcp | -853.1418257 | 0
 | Xcp | -853.1418257 | 112.3452515
 | Xcp0 | -853.1418257 | 112.3452515
 | Xcp0 | -853.1418257 | 0
 | Marge Statique | -572.1318525 | -253
 | MS milieu | -712.6368391 | -253
 | MS Xcp | -853.1418257 | -253
 | canard pt1 | 0 | 0 | 0
 | canard pt2 | 0 | 0 | 0
 | canard pt3 | 0 | 0 | 0
 | canard pt4 | 0 | 0 | 0
 | canard pt1 | 0 | 0 | 0
 | masquage pt1 | 0 | 0 | 0
 | masquage pt2 | 0 | 0 | 0
 | masquage pt3 | 0 | 0 | 0
 | masquage pt4 | 0 | 0 | 0
 | masquage pt1 | 0 | 0 | 0
 | cadre | -1136.25 | 373.3333333
 | cadre | -1136.25 | -373.3333333
 | propu pt1 | -632 | -27
 | propu pt2 | -632 | 27
 | propu pt3 | -1120 | 27
 | propu pt4 | -1120 | -27
 | propu pt5 | -632 | -27 |  | conique | ogive | parabole
 | Pointe | 0 | 0 | 0 | 0 | 0 | 0
 | Ogive | -0.1 | 4.2 | -4.2 | 4.2 | 8.4 | 21
 | Ogive | -0.25 | 10.5 | -10.5 | 10.5 | 21 | 29.4
 | Ogive | -0.5 | 21 | -21 | 21 | 31.5 | 36.96
 | Ogive | -0.75 | 31.5 | -31.5 | 31.5 | 37.8 | 39.9
 | Ogive | -1 | 42 | -42 | 42 | 42 | 42
 | MS (X) | Cna (Y) | MS (X) | Cna (Y)
 | 0 | 15 | 0.5 | 80
 | 7 | 15 | 1 | 40
 | 0 | 40 | 2 | 20
 | 7 | 40 | 3 | 13.33333333
 | 2 | 0 | 5 | 8
 | 2 | 55 | 7 | 5.714285714
 | 6 | 0 | 1 | 100
 | 6 | 55 | 2 | 50
 | 2.42 | 16.20 | 3 | 33.33333333
 | 2.42 | 16.20 | 4 | 25
 | 2.99 | 16.20 | 6 | 16.66666667
 | 2.99 | 16.20 | 7 | 14.28571429
 | 2.42 | 16.20
 | 0 | 27.5
 | 2 | 27.5
 | 3.636363636 | 27.5
 | 7 | 27.5
 | 4 | 0
 | 4 | 15
 | 4 | 25
 | 4 | 55
 | Verification moteur | TRUE
 | H20 | FALSE
 | Fusex | TRUE
 | micro | FALSE
 | minif N | FALSE
 | Minif RC | FALSE
 | Minif Test | FALSE
module rocket(){
module aileron(diam, m, n, p, e, ep, nb, pos, masque = true){
depha = masque ? 0 : 45 ;
for (angle = [0 : 360/nb : 360] ){
translate ([-diam*sin(angle+depha), diam*cos(angle+depha), pos-m]) {
rotate( [0, 0, angle+depha] ){
polyhedron
(points = [
[+ep, 0, 0], [+ep, 0, m], [+ep, e, p+n], [+ep, e, p],
[-ep, 0, 0], [-ep, 0, m], [-ep, e, p+n], [-ep, e, p]
],
triangles = [
[0, 2, 1], [0, 2, 3], //carre +
[4, 6, 5], [4, 6, 7], //carre -
[0, 5, 1], [0, 5, 4],
[1, 6, 2], [1, 6, 5],
[2, 7, 3], [2, 7, 6],
[0, 7, 3], [0, 7, 4]
]
);
}
}
}
}
module coiffe(diam, hauteur, resolution = 20.0){
pas = hauteur/resolution;
for (x = [0: pas : hauteur] ){
translate( [0, 0, x+pas] ){
cylinder(pas, pow(x, 1.0/2.0), pow(x+pas, 1.0/2.0), false);
}
}
}
//--------------------------------coiffe
if (coiffe_type == "conique"){
cylinder(coiffe_hauteur, 0, coiffe_diametre, false);
}
//--------------------------------corps
if (plusieur_diametres == false){
translate ([0, 0, coiffe_hauteur]) {
cylinder(longeur_total-coiffe_hauteur, coiffe_diametre, coiffe_diametre, false);
}
} else {
//Premier cylindre
translate ([0, 0, coiffe_hauteur]) {
cylinder(diam_A_X_implantation-coiffe_hauteur, coiffe_diametre, coiffe_diametre, false);
}
//Premier chanvrin
translate ([0, 0, diam_A_X_implantation]) {
cylinder(diam_A_L_longeur, diam_A_D1_diametre, diam_A_D2_diametre, false);
}
//Second cylindre
translate ([0, 0, diam_A_X_implantation+diam_A_L_longeur]) {
cylinder(diam_B_X_implantation-(diam_A_X_implantation+diam_A_L_longeur), diam_A_D2_diametre, diam_B_D1_diametre, false);
}
//Second chanvrin
translate ([0, 0, diam_B_X_implantation]) {
cylinder(diam_B_L_longeur, diam_B_D1_diametre, diam_B_D2_diametre, false);
}
//Troisieme cylindre
translate ([0, 0, diam_B_X_implantation + diam_B_L_longeur]) {
cylinder(longeur_total-(diam_B_X_implantation + diam_B_L_longeur), diam_B_D2_diametre, diam_B_D2_diametre, false);
}
}
//--------------------------------ailerons
aileron(coiffe_diametre, aileron_m_emplature,
aileron_n_saumon,
aileron_p_fleche,
aileron_e_envergure,
aileron_epaisseur,
aileron_nombre,
aileron_position_bas);
if (bi_empennage == true){
aileron(coiffe_diametre, aileron_sup_m_emplature,
aileron_sup_n_saumon,
aileron_sup_p_fleche,
aileron_sup_e_envergure,
aileron_sup_epaisseur,
aileron_sup_nombre,
aileron_sup_position_bas,
aileron_sup_masque);
}
}
rocket();

Sheet: Trajecto
 |  | TRAJECTO
 |  | Trajectographie de fusée
 |  | Remplir les cases jaunes
 |  | Fusée
 | Nom | SP02
 | Club | L'AéroIPSA
 | Matricule | FX0
 | Masse totale | 6.026 kg
 | Propulseur | Barasinga (Pro54-5G C)
 |  | Traînée Aérdynamique
 | Surface Réf. | 0.010815 m²
 | Cx | 0.6
 |  | Rampe de Lancement
 | Longueur | 4 m
 | Élévation | 80 °
 | Altitude | 0 m
 |  | DescenteSousParachute |  |  |  | 2026-04-04 | Temps | Altitude z | Portée x | Vitesse | Accélération | Efforts
 |  | Fusée | 0 satellite |  | Sortie de Rampe |  |  |  |  | 100.8 m/s
 | Masse | 4.993 kg | 1 kg |  | Vit max & Acc max |  |  |  |  | 302.0454776 m/s | 131.7551938 m/s²
 | Dépotage | N/A |  |  | Largage du satellite |  | 4.7 s | 1120.967521 m | 223.0394183 m | 219.1268438 m/s |  | 2941.0 N
 | Ouverture para | 16.4 s | 4.7 s |  | Culmination, Apogée |  | 17.4 s | 2142.363162 m | 581.9257827 m | 21.71381107 m/s
 | Type de para | Croix |  |  | Ouverture parachute fusée |  | 16.4 s | 2137.256866 m | 560.0563181 m | 24.22333924 m/s |  | 172.7 N
 | Surface para | 0.48 m² | 0.1 m² |  | Impact balistique |  | 43.9 s | ~0 m | 928.2092619 m | 111.6 m/s |  | 31077.82774 J
 | Cx parachute | 1 | 1
 | Vitesse du vent | 5 m/s | 5 m/s
 | Vitesse descente | 12.9 m/s | 12.7 m/s
 | Durée descente | 165.6689717 s | 88.57508388 s |  |  |  | Pour localiser la fusée
 | Durée du vol | 182.0689717 s | 93.27508388 s |  | Couleur fuselage/coiffe |  | Brun/Orange…
 | Déport latéral | ±828.3448586 m | ±442.8754194 m |  | Couleur parachute fusée |  | Rouge… |  |  |  |  |  | fichier initial
 |  |  |  |  | Couleur parachute satellite |  | Jaune |  |  |  |  |  | propu OK
 | Commentaire libre : |  |  |  |  |  |  |  |  |  |  |  | v3.4.5
Calcul de la surface d'un parachute |  |  |  |  | Résultats détaillés |  | Temps | Altitude z | Portée x | Vitesse | Accélération | Angle
 |  |  |  |  |  |  | s | m | m | m/s | m/s² | °
 |  |  |  |  | Décollage |  | 0 | 0 | 0 | 100 | - | 80
 | Bord 'a' |  |  |  | Sortie de Rampe |  | 0.03 | 2.96 | 0.52 | 100.8 | 57.9 | 80.0
 | 310 mm |  |  |  | Vit max & Acc max |  | - | - | - | 302.0454776 | 131.8 | -
 | Coté 'b' |  |  |  | Fin de Propulsion |  | 3.6 | 854.9765422 | 166.9475166 | 279.0773742 | 66.8 | 78.3
 | 310 mm |  |  |  | Culmination, Apogée |  | 17.4 | 2142.363162 | 581.9257827 | 21.71381107 | 9.8 | 0.5
 | Surface para |  |  |  | Impact balistique |  | 43.9 | ~0 | 928.2092619 | 111.5731109 | 0.4 | -87.7
 | 0.48 m² |  |  |  | Ouverture parachute fusée |  | 16.4 | 2137.256866 | 560.0563181 | 24.22333924 | 10.0 | 24.6
 |  |  |  |  | Impact fusée sous para. |  | 182.0689717 | ~0 | -268 | 1388 | 12.90076738 | 9.8 | -
 |  |  |  |  | Largage du satellite |  | 4.7 | 1120.967521 | 223.0394183 | 219.1268438 | 45.3 | 77.8
 | Rayon exterieur |  |  |  | Impact du satellite |  | 93.27508388 | ~0 | -220 | 666 | 12.65556262 | 9.8 | -
 | 299 mm
 | Rayon intérieur
 | 29 mm
 | Surface para
 | 0.28 m²
 | Vitesse de descente sous parachute :
 | Textes pour les listes déroulantes et graphiques :
 |  |  |  |  | N/A | Délais dépotage |  | Rond
 | 0 satellite |  |  |  | -9.0 s | -9 |  | Croix
 | 1 satellite |  |  |  | -7.0 s | -7 |  | Autre
 | Phase ascendante |  |  |  | -5.0 s | -5
 | Descente balistique |  |  |  | -3.0 s | -3
 | Fusée sous parachute |  |  |  | 0.0 s | -0
 |  |  |  |  | autre
 | Trajectoire (x z)
 | Portée x [m]
 | Temps [s]
 | Altitude z / Temps | 16.4
 | T_para =
 | Données pour les graphiques :
 | xz max | xz max
 | 2142.363162 | 2142.363162
 | x para | z para
 | 560.0563181 | 2137.256866
 | 560.0563181 | 1068.628433
 | 560.0563181 | 0
 | 613.4877397 | 106.8628433
 | 560.0563181 | 0
 | 506.6248964 | 106.8628433
 | 560.0563181 | 0
 | t para | z para
 | 16.4 | 2137.256866
 | 99.2 | 1068.628433 |  | 1 | vertical
 | 182.1 | 0 |  | 1 | horizontal
 | 180.3 | 75.15767907 |  |  | flèches
 | 182.1 | 0 |  | 1s | 4.39
 | 175.9 | 28.1545349 |  | t/T | 0.91
 | 182.1 | 0 |  | z/Z | 1.00
 | x sat | z sat
 | FALSE | FALSE
 | FALSE | FALSE
 | FALSE | FALSE
 | FALSE | FALSE
 | FALSE | FALSE
 | FALSE | FALSE
 | FALSE | FALSE
 | t sat | z sat
 | FALSE | FALSE
 | 0.0 | 0
 | FALSE | FALSE
 | FALSE | FALSE
 | FALSE | FALSE
 | FALSE | FALSE |  | t/T | 0.89
 | FALSE | FALSE |  | z/Z | 0.44
 | t | z | x
 | 4.1 | 1068.628433 | 140.0140795
 | 30.65 | 1071.181581 | 812.7814355
 | z_triomphe | x_triomphe | Arc de triomphe
 | #N/A | 0 | 581.9257827 |  | Arc de triomphe
 | #N/A | 23 | 604.9257827 |  | 581.9257827
 | #N/A | 23 | 604.9257827 |  | 558.9257827
 | #N/A | 0 | 581.9257827 |  | 558.9257827
 | #N/A | 23 | 604.9257827 |  | 581.9257827
 | #N/A | 23 | 604.9257827 |  | 558.9257827
 | #N/A | 8 | 589.9257827 |  | 558.9257827
 | #N/A | 8 | 589.9257827 |  | 573.9257827
 | #N/A | 23 | 604.9257827 |  | 573.9257827
 | #N/A | 8 | 589.9257827 |  | 558.9257827
 | #N/A | 7.6 | 589.5257827 |  | 573.9257827
 | #N/A | 6.8 | 588.7257827 |  | 574.3257827
 | #N/A | 6 | 587.9257827 |  | 575.1257827
 | #N/A | 5 | 586.9257827 |  | 575.9257827
 | #N/A | 3.8 | 585.7257827 |  | 576.9257827
 | #N/A | 0 | 581.9257827 |  | 578.1257827
 |  |  |  |  | 581.9257827
 | z_Eiffel | x_Eiffel | Tour Eiffel
 | 324 | 0 | 581.9257827 |  | Tour Eiffel
 | 300 | 0 | 581.9257827 |  | 581.9257827
 | 280 | 10 | 591.9257827 |  | 581.9257827
 | 280 | 0 | 581.9257827 |  | 571.9257827
 | 280 | 10 | 591.9257827 |  | 581.9257827
 | 200 | 13 | 594.9257827 |  | 571.9257827
 | 160 | 17 | 598.9257827 |  | 568.9257827
 | 115 | 20 | 601.9257827 |  | 564.9257827
 | 90 | 25 | 606.9257827 |  | 561.9257827
 | 57 | 30 | 611.9257827 |  | 556.9257827
 | 40 | 36 | 617.9257827 |  | 551.9257827
 | 20 | 48 | 629.9257827 |  | 545.9257827
 | 0.5 | 62 | 643.9257827 |  | 533.9257827
 | 0.5 | 37 | 618.9257827 |  | 519.9257827
 | 15 | 30 | 611.9257827 |  | 544.9257827
 | 30 | 15 | 596.9257827 |  | 551.9257827
 | 37 | 0 | 581.9257827 |  | 566.9257827
 | 67 | 0 | 581.9257827 |  | 581.9257827
 | 67 | 17 | 598.9257827 |  | 581.9257827
 | 100 | 11 | 592.9257827 |  | 564.9257827
 | 100 | 0 | 581.9257827 |  | 570.9257827
 |  |  |  |  | 581.9257827

Sheet: Courbes
Notes :
Ces courbes représentent la trajectoire de la fusée dans l'hypothèse d'une descente balistique (sans ouverture du parachute).
L'accélération longitudinale gravitationnelle définit le mouvement (dérivée de la vitesse) : Acc = (Poussee - Traînée ± Poids) / m
La charge ''non-gravitationnelle'' vue par un capteur d'accélération (masse-ressort) est : Charge = (Poussée - Traînée) / m
Exemples : Si Poussée = Poids, Vitesse constante, Acc nulle, Charge = 1G ; En chute libre, Acc = -1G, Charge = 0
Textes pour les graphiques :
Traînée
Poussée
Poids
Accélération longitudinale
Charge vue par un capteur
Vitesse
Vitesse [m/s]
Altitude
Portée
Temps [s]

Sheet: Propu
Moteur sélectionné | Ligne
Barasinga (Pro54-5G C) | 279 | I_total | 2058.4 N.s | ISP | 203.1206673 s | MpropuPlein | 1.685 kg | m_poudre | 1.033 kg | MpropuVide | 0.652 kg | XpropuPlein | 250 mm | XpropuVide | 240 mm | Longueur | 488 mm | Diamètre | 54 mm | Type | Fusex | Combustion | 0.0 s | Dépotage | 0
Temps (en s) | 0 | 0.05 | 0.5 | 1 | 1.5 | 2 | 2.5 | 2.97 | 3.2 | 3.47 | 3.59 | 3.59 | 3.59 | 3.59 | 3.59 | 3.59 | 3.59 | 3.59 | 3.59 | 3.59 | 3.59 | 3.59 | 3.59 | 1000
Poussée (en N) | 0 | 893 | 798 | 739 | 659 | 586 | 513 | 417 | 225 | 67 | 0 | 0 | 0 | 0 | 0 | 0 | 0 | 0 | 0 | 0 | 0 | 0 | 0 | 0
H2O
H2O 1.5L 300g 6bar | 26 | I_total | 9.8 N.s | ISP | 3.3 s | MpropuPlein | 0.3 kg | M_éjecté | 0.3 kg | M_burnout | 0 kg | XpropuPlein | 60 mm | XpropuVide | 150 mm | Longueur | 300 mm | Diamètre | 90 mm | Type | H2O
Temps (en s) | 0 | 0.001 | 0.02 | 0.038 | 0.04 | 0.04 | 0.04 | 0.04 | 0.04 | 0.04 | 0.04 | 0.04 | 0.04 | 0.04 | 0.04 | 0.04 | 0.04 | 0.04 | 0.04 | 0.04 | 0.04 | 0.04 | 0.04 | 1000
Poussée (en N) | 0 | 310 | 250 | 212 | 0 | 0 | 0 | 0 | 0 | 0 | 0 | 0 | 0 | 0 | 0 | 0 | 0 | 0 | 0 | 0 | 0 | 0 | 0 | 0
I_total_i (en N.s) | 0.2 | 5.3 | 4.2 | 0.2 | 0 | 0 | 0 | 0 | 0 | 0 | 0 | 0 | 0 | 0 | 0 | 0 | 0 | 0 | 0 | 0 | 0 | 0 | 0
H2O 1.5L 450g 6bar | 31 | I_total | 13.8 N.s | ISP | 3.1 s | MpropuPlein | 0.45 kg | M_éjecté | 0.45 kg | M_burnout | 0 kg | XpropuPlein | 90 mm | XpropuVide | 150 mm | Longueur | 300 mm | Diamètre | 90 mm | Type | H2O
Temps (en s) | 0 | 0.001 | 0.02 | 0.04 | 0.061 | 0.062 | 0.062 | 0.062 | 0.062 | 0.062 | 0.062 | 0.062 | 0.062 | 0.062 | 0.062 | 0.062 | 0.062 | 0.062 | 0.062 | 0.062 | 0.062 | 0.062 | 0.062 | 1000
Poussée (en N) | 0 | 310 | 245 | 200 | 167 | 0 | 0 | 0 | 0 | 0 | 0 | 0 | 0 | 0 | 0 | 0 | 0 | 0 | 0 | 0 | 0 | 0 | 0 | 0
I_total_i (en N.s) | 0.2 | 5.3 | 4.5 | 3.9 | 0.1 | 0 | 0 | 0 | 0 | 0 | 0 | 0 | 0 | 0 | 0 | 0 | 0 | 0 | 0 | 0 | 0 | 0 | 0
H2O 1.5L 600g 6bar | 36 | I_total | 17.1 N.s | ISP | 2.9 s | MpropuPlein | 0.6 kg | M_éjecté | 0.6 kg | M_burnout | 0 kg | XpropuPlein | 120 mm | XpropuVide | 150 mm | Longueur | 300 mm | Diamètre | 90 mm | Type | H2O
Temps (en s) | 0 | 0.001 | 0.02 | 0.04 | 0.06 | 0.08 | 0.088 | 0.089 | 0.089 | 0.089 | 0.089 | 0.089 | 0.089 | 0.089 | 0.089 | 0.089 | 0.089 | 0.089 | 0.089 | 0.089 | 0.089 | 0.089 | 0.089 | 1000
Poussée (en N) | 0 | 310 | 240 | 190 | 157 | 133 | 125 | 0 | 0 | 0 | 0 | 0 | 0 | 0 | 0 | 0 | 0 | 0 | 0 | 0 | 0 | 0 | 0 | 0
I_total_i (en N.s) | 0.2 | 5.2 | 4.3 | 3.5 | 2.9 | 1 | 0.1 | 0 | 0 | 0 | 0 | 0 | 0 | 0 | 0 | 0 | 0 | 0 | 0 | 0 | 0 | 0 | 0
H2O 1.5L 750g 6bar | 41 | I_total | 19.4 N.s | ISP | 2.6 s | MpropuPlein | 0.75 kg | M_éjecté | 0.75 kg | M_burnout | 0 kg | XpropuPlein | 150 mm | XpropuVide | 150 mm | Longueur | 300 mm | Diamètre | 90 mm | Type | H2O
Temps (en s) | 0 | 0.001 | 0.02 | 0.04 | 0.06 | 0.08 | 0.1 | 0.123 | 0.124 | 0.124 | 0.124 | 0.124 | 0.124 | 0.124 | 0.124 | 0.124 | 0.124 | 0.124 | 0.124 | 0.124 | 0.124 | 0.124 | 0.124 | 1000
Poussée (en N) | 0 | 310 | 230 | 175 | 140 | 118 | 100 | 85 | 0 | 0 | 0 | 0 | 0 | 0 | 0 | 0 | 0 | 0 | 0 | 0 | 0 | 0 | 0 | 0
I_total_i (en N.s) | 0.2 | 5.1 | 4 | 3.1 | 2.6 | 2.2 | 2.1 | 0.0425 | 0 | 0 | 0 | 0 | 0 | 0 | 0 | 0 | 0 | 0 | 0 | 0 | 0 | 0 | 0
H2O 2.0L 400g 6bar | 46 | I_total | 12.9 N.s | ISP | 3.3 s | MpropuPlein | 0.5 kg | M_éjecté | 0.4 kg | M_burnout | 0.1 kg | XpropuPlein | 60 mm | XpropuVide | 150 mm | Longueur | 300 mm | Diamètre | 98 mm | Type | H2O
Temps (en s) | 0 | 0.001 | 0.02 | 0.04 | 0.05 | 0.051 | 0.051 | 0.051 | 0.051 | 0.051 | 0.051 | 0.051 | 0.051 | 0.051 | 0.051 | 0.051 | 0.051 | 0.051 | 0.051 | 0.051 | 0.051 | 0.051 | 0.051 | 1000
Poussée (en N) | 0 | 310 | 264 | 230 | 213 | 0 | 0 | 0 | 0 | 0 | 0 | 0 | 0 | 0 | 0 | 0 | 0 | 0 | 0 | 0 | 0 | 0 | 0 | 0
I_total_i (en N.s) | 0.2 | 5.5 | 4.9 | 2.2 | 0.1 | 0 | 0 | 0 | 0 | 0 | 0 | 0 | 0 | 0 | 0 | 0 | 0 | 0 | 0 | 0 | 0 | 0 | 0
H2O 2.0L 600g 6bar | 51 | I_total | 18.1 N.s | ISP | 3.1 s | MpropuPlein | 0.7 kg | M_éjecté | 0.6 kg | M_burnout | 0.1 kg | XpropuPlein | 90 mm | XpropuVide | 150 mm | Longueur | 300 mm | Diamètre | 98 mm | Type | H2O
Temps (en s) | 0 | 0.001 | 0.02 | 0.04 | 0.06 | 0.08 | 0.081 | 0.081 | 0.081 | 0.081 | 0.081 | 0.081 | 0.081 | 0.081 | 0.081 | 0.081 | 0.081 | 0.081 | 0.081 | 0.081 | 0.081 | 0.081 | 0.081 | 1000
Poussée (en N) | 0 | 310 | 260 | 220 | 190 | 167 | 0 | 0 | 0 | 0 | 0 | 0 | 0 | 0 | 0 | 0 | 0 | 0 | 0 | 0 | 0 | 0 | 0 | 0
I_total_i (en N.s) | 0.2 | 5.4 | 4.8 | 4.1 | 3.6 | 0.1 | 0 | 0 | 0 | 0 | 0 | 0 | 0 | 0 | 0 | 0 | 0 | 0 | 0 | 0 | 0 | 0 | 0
H2O 2.0L 800g 6bar | 56 | I_total | 22.6 N.s | ISP | 2.9 s | MpropuPlein | 0.9 kg | M_éjecté | 0.8 kg | M_burnout | 0.1 kg | XpropuPlein | 120 mm | XpropuVide | 150 mm | Longueur | 300 mm | Diamètre | 98 mm | Type | H2O
Temps (en s) | 0 | 0.001 | 0.02 | 0.04 | 0.06 | 0.08 | 0.1 | 0.117 | 0.118 | 0.118 | 0.118 | 0.118 | 0.118 | 0.118 | 0.118 | 0.118 | 0.118 | 0.118 | 0.118 | 0.118 | 0.118 | 0.118 | 0.118 | 1000
Poussée (en N) | 0 | 310 | 250 | 210 | 180 | 156 | 140 | 125 | 0 | 0 | 0 | 0 | 0 | 0 | 0 | 0 | 0 | 0 | 0 | 0 | 0 | 0 | 0 | 0
I_total_i (en N.s) | 0.2 | 5.3 | 4.6 | 3.9 | 3.4 | 3 | 2.3 | 0.1 | 0 | 0 | 0 | 0 | 0 | 0 | 0 | 0 | 0 | 0 | 0 | 0 | 0 | 0 | 0
H2O 2.0L 1000g 6bar | 61 | I_total | 25.9 N.s | ISP | 2.6 s | MpropuPlein | 1.1 kg | M_éjecté | 1 kg | M_burnout | 0.1 kg | XpropuPlein | 150 mm | XpropuVide | 150 mm | Longueur | 300 mm | Diamètre | 98 mm | Type | H2O
Temps (en s) | 0 | 0.001 | 0.02 | 0.04 | 0.06 | 0.08 | 0.1 | 0.12 | 0.14 | 0.164 | 0.165 | 0.165 | 0.165 | 0.165 | 0.165 | 0.165 | 0.165 | 0.165 | 0.165 | 0.165 | 0.165 | 0.165 | 0.165 | 1000
Poussée (en N) | 0 | 310 | 245 | 200 | 165 | 143 | 124 | 108 | 97 | 85 | 0 | 0 | 0 | 0 | 0 | 0 | 0 | 0 | 0 | 0 | 0 | 0 | 0 | 0
I_total_i (en N.s) | 0.2 | 5.3 | 4.5 | 3.6 | 3.1 | 2.7 | 2.3 | 2.1 | 2.2 | 0.0425 | 0 | 0 | 0 | 0 | 0 | 0 | 0 | 0 | 0 | 0 | 0 | 0 | 0
µ-propu
µ-propu A8-3 | 67 | I_total | 2.6 N.s | ISP | 54.02650357 s | MpropuPlein | 0.015 kg | M_éjecté | 0.005 kg | M_burnout | 0.01 kg | XpropuPlein | 30 mm | XpropuVide | 30 mm | Longueur | 70 mm | Diamètre | 15 mm | Type | Micro | Combustion | 0.32 s | Dépotage | 3
Temps (en s) | 0 | 0.2 | 0.3 | 0.4 | 0.5 | 0.55 | 0.6 | 0.6 | 0.6 | 0.6 | 0.6 | 0.6 | 0.6 | 0.6 | 0.6 | 0.6 | 0.6 | 0.6 | 0.6 | 0.6 | 0.6 | 0.6 | 0.6 | 1000
Poussée (en N) | 0 | 9 | 4.5 | 4 | 4 | 3 | 0 | 0 | 0 | 0 | 0 | 0 | 0 | 0 | 0 | 0 | 0 | 0 | 0 | 0 | 0 | 0 | 0 | 0
I_total_i (en N.s) | 0.9 | 0.7 | 0.4 | 0.4 | 0.2 | 0.1 | 0 | 0 | 0 | 0 | 0 | 0 | 0 | 0 | 0 | 0 | 0 | 0 | 0 | 0 | 0 | 0 | 0
µ-propu B4-4 | 72 | I_total | 5.2 N.s | ISP | 89.19469929 s | MpropuPlein | 0.02 kg | M_éjecté | 0.006 kg | M_burnout | 0.014 kg | XpropuPlein | 30 mm | XpropuVide | 30 mm | Longueur | 70 mm | Diamètre | 15 mm | Type | Micro | Combustion | 1.20 s | Dépotage | 4
Temps (en s) | 0 | 0.2 | 0.3 | 0.55 | 1.05 | 1.15 | 1.15 | 1.15 | 1.15 | 1.15 | 1.15 | 1.15 | 1.15 | 1.15 | 1.15 | 1.15 | 1.15 | 1.15 | 1.15 | 1.15 | 1.15 | 1.15 | 1.15 | 1000
Poussée (en N) | 0 | 10 | 6 | 4 | 4 | 0 | 0 | 0 | 0 | 0 | 0 | 0 | 0 | 0 | 0 | 0 | 0 | 0 | 0 | 0 | 0 | 0 | 0 | 0
I_total_i (en N.s) | 1 | 0.8 | 1.3 | 2 | 0.2 | 0 | 0 | 0 | 0 | 0 | 0 | 0 | 0 | 0 | 0 | 0 | 0 | 0 | 0 | 0 | 0 | 0 | 0
µ-propu C6-3 | 77 | I_total | 10.3 N.s | ISP | 80.45165843 s | MpropuPlein | 0.024 kg | M_éjecté | 0.013 kg | M_burnout | 0.011 kg | XpropuPlein | 30 mm | XpropuVide | 30 mm | Longueur | 70 mm | Diamètre | 15 mm | Type | Micro | Combustion | 1.70 s | Dépotage | 3
Temps (en s) | 0 | 0.2 | 0.3 | 0.6 | 0.8 | 2 | 2.1 | 2.1 | 2.1 | 2.1 | 2.1 | 2.1 | 2.1 | 2.1 | 2.1 | 2.1 | 2.1 | 2.1 | 2.1 | 2.1 | 2.1 | 2.1 | 2.1 | 1000
Poussée (en N) | 0 | 11 | 7 | 4 | 4.6 | 4.6 | 0 | 0 | 0 | 0 | 0 | 0 | 0 | 0 | 0 | 0 | 0 | 0 | 0 | 0 | 0 | 0 | 0 | 0
I_total_i (en N.s) | 1.1 | 0.9 | 1.6 | 0.9 | 5.5 | 0.2 | 0 | 0 | 0 | 0 | 0 | 0 | 0 | 0 | 0 | 0 | 0 | 0 | 0 | 0 | 0 | 0 | 0
µ-propu C6-3 x2 | 82 | I_total | 20.5 N.s | ISP | 80.45165843 s | MpropuPlein | 0.048 kg | M_éjecté | 0.026 kg | M_burnout | 0.022 kg | XpropuPlein | 30 mm | XpropuVide | 30 mm | Longueur | 70 mm | Diamètre | 30 mm | Type | Micro | Combustion | 1.70 s | Dépotage | 3
Temps (en s) | 0 | 0.2 | 0.3 | 0.6 | 0.8 | 2 | 2.1 | 2.1 | 2.1 | 2.1 | 2.1 | 2.1 | 2.1 | 2.1 | 2.1 | 2.1 | 2.1 | 2.1 | 2.1 | 2.1 | 2.1 | 2.1 | 2.1 | 1000
Poussée (en N) | 0 | 22 | 14 | 8 | 9.2 | 9.2 | 0 | 0 | 0 | 0 | 0 | 0 | 0 | 0 | 0 | 0 | 0 | 0 | 0 | 0 | 0 | 0 | 0 | 0
I_total_i (en N.s) | 2.2 | 1.8 | 3.3 | 1.7 | 11 | 0.5 | 0 | 0 | 0 | 0 | 0 | 0 | 0 | 0 | 0 | 0 | 0 | 0 | 0 | 0 | 0 | 0 | 0
µ-propu C6-3 x3 | 87 | I_total | 30.8 N.s | ISP | 80.45165843 s | MpropuPlein | 0.072 kg | M_éjecté | 0.039 kg | M_burnout | 0.033 kg | XpropuPlein | 30 mm | XpropuVide | 30 mm | Longueur | 70 mm | Diamètre | 40 mm | Type | Micro | Combustion | 1.70 s | Dépotage | 3
Temps (en s) | 0 | 0.2 | 0.3 | 0.6 | 0.8 | 2 | 2.1 | 2.1 | 2.1 | 2.1 | 2.1 | 2.1 | 2.1 | 2.1 | 2.1 | 2.1 | 2.1 | 2.1 | 2.1 | 2.1 | 2.1 | 2.1 | 2.1 | 1000
Poussée (en N) | 0 | 33 | 21 | 12 | 13.8 | 13.8 | 0 | 0 | 0 | 0 | 0 | 0 | 0 | 0 | 0 | 0 | 0 | 0 | 0 | 0 | 0 | 0 | 0 | 0
I_total_i (en N.s) | 3.3 | 2.7 | 5 | 2.6 | 16.6 | 0.7 | 0 | 0 | 0 | 0 | 0 | 0 | 0 | 0 | 0 | 0 | 0 | 0 | 0 | 0 | 0 | 0 | 0
Klima D9-7 | 92 | I_total | 20.0 N.s | ISP | 118.3058874 s | MpropuPlein | 0.0282 kg | M_éjecté | 0.0172 kg | M_burnout | 0.011 kg | XpropuPlein | 30 mm | XpropuVide | 30 mm | Longueur | 70 mm | Diamètre | 18 mm | Type | MiniN | Combustion | 2.10 s | Dépotage | 7
Temps (en s) | 0 | 0.04 | 0.116 | 0.213 | 0.286 | 0.329 | 0.369 | 0.42 | 0.495 | 0.597 | 1.711 | 1.826 | 1.917 | 1.975 | 2.206 | 2.242 | 2.5 | 2.5 | 2.5 | 2.5 | 2.5 | 2.5 | 2.5 | 1000
Poussée (en N) | 0 | 2.111 | 9.685 | 25 | 15.738 | 12.472 | 10.67 | 9.713 | 9.178 | 8.896 | 8.925 | 8.699 | 8.052 | 6.954 | 1.07 | 0 | 0 | 0 | 0 | 0 | 0 | 0 | 0 | 0
I_total_i (en N.s) | 0.04222 | 0.4 | 1.7 | 1.5 | 0.6 | 0.5 | 0.5 | 0.7 | 0.9 | 9.9 | 1 | 0.8 | 0.4 | 0.9 | 0.01926 | 0 | 0 | 0 | 0 | 0 | 0 | 0 | 0
Klima D9-7 x2 | 97 | I_total | 39.9 N.s | ISP | 118.3058874 s | MpropuPlein | 0.0564 kg | M_éjecté | 0.0344 kg | M_burnout | 0.022 kg | XpropuPlein | 30 mm | XpropuVide | 30 mm | Longueur | 70 mm | Diamètre | 30 mm | Type | MiniN | Combustion | 2.10 s | Dépotage | 7
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
Temps (en s) | 0 | 0.01 | 0.023 | 0.04 | 0.118 | 0.283 | 0.51 | 0.688 | 0.787 | 0.852 | 0.873 | 0.873 | 0.873 | 0.873 | 0.873 | 0.873 | 0.873 | 0.873 | 0.873 | 0.873 | 0.873 | 0.873 | 2 | 1000
Poussée (en N) | 0 | 76.07 | 100.19 | 92.42 | 100.88 | 102.40 | 96.44 | 87.44 | 25.91 | 7.21 | 0 | 0 | 0 | 0 | 0 | 0 | 0 | 0 | 0 | 0 | 0 | 0 | 0 | 0
I_total_i (en N.s) | 0.4 | 1.1 | 1.6 | 7.5 | 16.8 | 22.6 | 16.4 | 5.6 | 1.1 | 0.1 | 0 | 0 | 0 | 0 | 0 | 0 | 0 | 0 | 0 | 0 | 0 | 0 | 0
p24-3G 75F51 | 188 | I_total | 75.3 N.s | ISP | 232.4603342 s | MpropuPlein | 0.095 kg | M_éjecté | 0.033 kg | M_burnout | 0.062 kg | XpropuPlein | 66.5 mm | XpropuVide | 66.5 mm | Longueur | 133 mm | Diamètre | 24 mm | Type | MiniRN | Combustion | 1.50 s | Dépotage | 12
Temps (en s) | 0 | 0.02 | 0.031 | 0.062 | 0.117 | 1.211 | 1.376 | 1.456 | 1.532 | 1.577 | 2 | 2 | 2 | 2 | 2 | 2 | 2 | 2 | 2 | 2 | 2 | 2 | 2 | 1000
Poussée (en N) | 0 | 75.924 | 84.148 | 70.441 | 73.659 | 38.737 | 14.779 | 7.271 | 3.337 | 0 | 0 | 0 | 0 | 0 | 0 | 0 | 0 | 0 | 0 | 0 | 0 | 0 | 0 | 0
I_total_i (en N.s) | 0.8 | 0.9 | 2.4 | 4 | 61.5 | 4.4 | 0.9 | 0.4 | 0.1 | 0 | 0 | 0 | 0 | 0 | 0 | 0 | 0 | 0 | 0 | 0 | 0 | 0 | 0
MINIF PRO24-6G
p24-6G 140G145 PK | 193 | I_total | 141.0 N.s | ISP | 186.2459265 s | MpropuPlein | 0.1619 kg | M_éjecté | 0.0772 kg | M_burnout | 0.0847 kg | XpropuPlein | 114 mm | XpropuVide | 114 mm | Longueur | 228 mm | Diamètre | 24 mm | Type | Mini | Combustion | 0.96 s | Dépotage | 15
Temps (en s) | 0 | 0.02 | 0.03 | 0.05 | 0.6 | 0.67 | 0.7 | 0.8 | 0.9 | 1.05 | 1.05 | 1.05 | 1.05 | 1.05 | 1.05 | 1.05 | 1.05 | 1.05 | 1.05 | 1.05 | 1.05 | 1.05 | 2 | 1000
Poussée (en N) | 0 | 350 | 250 | 210 | 150 | 140 | 130 | 65 | 30 | 0 | 0 | 0 | 0 | 0 | 0 | 0 | 0 | 0 | 0 | 0 | 0 | 0 | 0 | 0
I_total_i (en N.s) | 3.5 | 3 | 4.6 | 99 | 10.2 | 4 | 9.8 | 4.7 | 2.3 | 0 | 0 | 0 | 0 | 0 | 0 | 0 | 0 | 0 | 0 | 0 | 0 | 0 | 0
143G150 BS
Pandora (Pro24-6G BS) | 198 | I_total | 142.4 N.s | ISP | 192.061874 s | MpropuPlein | 0.1599 kg | M_éjecté | 0.0756 kg | M_burnout | 0.0843 kg | XpropuPlein | 114 mm | XpropuVide | 114 mm | Longueur | 228 mm | Diamètre | 24 mm | Type | MiniN | Combustion | 0.97 s | Dépotage | 13
Temps (en s) | 0 | 0.02 | 0.04 | 0.62 | 0.66 | 0.68 | 0.8 | 0.84 | 0.88 | 0.92 | 0.96 | 1 | 1.08 | 2 | 2 | 2 | 2 | 2 | 2 | 2 | 2 | 2 | 2 | 1000
Poussée (en N) | 0 | 250 | 210 | 160 | 150 | 142 | 62 | 48 | 34 | 24 | 15 | 10 | 0 | 0 | 0 | 0 | 0 | 0 | 0 | 0 | 0 | 0 | 0 | 0
I_total_i (en N.s) | 2.5 | 4.6 | 107.3 | 6.2 | 2.9 | 12.2 | 2.2 | 1.6 | 1.2 | 0.8 | 0.5 | 0.4 | 0 | 0 | 0 | 0 | 0 | 0 | 0 | 0 | 0 | 0 | 0
p24-6G 142G117 WT | 203 | I_total | 143.1 N.s | ISP | 168.2350472 s | MpropuPlein | 0.1725 kg | M_éjecté | 0.0867 kg | M_burnout | 0.0858 kg | XpropuPlein | 114 mm | XpropuVide | 114 mm | Longueur | 228 mm | Diamètre | 24 mm | Type | Mini | Combustion | 0.97 s | Dépotage | 11
Temps (en s) | 0 | 0.008 | 0.013 | 0.022 | 0.035 | 0.063 | 0.103 | 0.196 | 0.311 | 0.474 | 0.564 | 0.762 | 0.858 | 0.928 | 1.038 | 1.08 | 1.131 | 1.185 | 1.224 | 1.258 | 1.4 | 1.441 | 2 | 1000
Poussée (en N) | 0 | 168.643 | 177.339 | 177.866 | 171.278 | 157.839 | 154.941 | 148.88 | 144.137 | 138.076 | 135.705 | 125.955 | 116.733 | 101.713 | 57.444 | 42.688 | 31.884 | 17.655 | 9.486 | 5.27 | 0.791 | 0 | 0 | 0
I_total_i (en N.s) | 0.7 | 0.9 | 1.6 | 2.3 | 4.6 | 6.3 | 14.1 | 16.8 | 23 | 12.3 | 25.9 | 11.6 | 7.6 | 8.8 | 2.1 | 1.9 | 1.3 | 0.5 | 0.3 | 0.4 | 0.0162155 | 0 | 0
p24-6G 139G107 DT | 208 | I_total | 139.4 N.s | ISP | 158.6202775 s | MpropuPlein | 0.1945 kg | M_éjecté | 0.0896 kg | M_burnout | 0.1049 kg | XpropuPlein | 114 mm | XpropuVide | 144 mm | Longueur | 228 mm | Diamètre | 24 mm | Type | Mini | Combustion | 1.30 s | Dépotage | 12
Temps (en s) | 0 | 0.011 | 0.022 | 0.046 | 0.081 | 0.219 | 0.253 | 0.274 | 0.305 | 0.412 | 0.789 | 0.899 | 0.953 | 0.999 | 1.03 | 1.057 | 1.102 | 1.154 | 1.197 | 1.277 | 1.335 | 1.451 | 2 | 1000
Poussée (en N) | 0 | 198.418 | 221.835 | 212.658 | 218.354 | 204.43 | 195.886 | 183.544 | 88.291 | 93.671 | 93.987 | 91.139 | 89.873 | 87.025 | 81.329 | 69.937 | 54.114 | 42.405 | 31.646 | 17.089 | 9.81 | 0 | 0 | 0
I_total_i (en N.s) | 1.1 | 2.3 | 5.2 | 7.5 | 29.2 | 6.8 | 4 | 4.2 | 9.7 | 35.4 | 10.2 | 4.9 | 4.1 | 2.6 | 2 | 2.8 | 2.5 | 1.6 | 1.9 | 0.8 | 0.6 | 0 | 0
MINIF PRO29-2G
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
Temps (en s) | 0 | 0.017 | 0.052 | 0.088 | 0.108 | 0.127 | 0.174 | 0.257 | 0.403 | 0.762 | 0.977 | 1.341 | 1.501 | 1.661 | 1.96 | 2.404 | 2.641 | 2.716 | 2.821 | 2.892 | 2.92 | 2.97 | 3 | 1000
Poussée (en N) | 0 | 329.847 | 1003.68 | 2346.62 | 2549.24 | 2605.79 | 2520.97 | 2516.26 | 2596.37 | 2808.41 | 2954.49 | 2959.2 | 2907.36 | 2869.67 | 2695.32 | 2351.34 | 2228.82 | 2007.35 | 1427.77 | 504.194 | 334.559 | 122.515 | 0 | 0
I_total_i (en N.s) | 2.8 | 23.3 | 60.3 | 49 | 49 | 120.5 | 209 | 373.2 | 970.2 | 619.5 | 1076.3 | 469.3 | 462.2 | 832 | 1120.4 | 542.7 | 158.9 | 180.3 | 68.6 | 11.7 | 11.4 | 1.8 | 0
Blastocerus (Pro98-6GXL RL) | 304 | I_total | 17735.0 N.s | ISP | 192.7342031 s | MpropuPlein | 14.748 kg | M_éjecté | 9.38 kg | M_burnout | 5.368 kg | XpropuPlein | 500 mm | XpropuVide | 500 mm | Longueur | 1046 mm | Diamètre | 98 mm | Type | Fusex
Temps (en s) | 0 | 0.003 | 0.05 | 0.078 | 0.121 | 0.652 | 1.123 | 1.655 | 2.353 | 3.035 | 3.7 | 3.733 | 3.887 | 4.036 | 4.197 | 4.262 | 4.3 | 5 | 5 | 5 | 5 | 5 | 5 | 1000
Poussée (en N) | 0 | 203.877 | 2362.879 | 3946.845 | 4281.412 | 4370.281 | 4453.923 | 4772.807 | 4621.206 | 4511.427 | 4375.509 | 4182.087 | 2969.282 | 1589.193 | 533.216 | 240.47 | 0 | 0 | 0 | 0 | 0 | 0 | 0 | 0
I_total_i (en N.s) | 0.3 | 60.3 | 88.3 | 176.9 | 2297 | 2078.1 | 2454.3 | 3278.5 | 3114.2 | 2954.9 | 141.2 | 550.7 | 339.6 | 170.9 | 25.1 | 4.6 | 0 | 0 | 0 | 0 | 0 | 0 | 0
Aucun (2e ét. inerte) | 309 | I_total | 0.001 N.s | ISP | 1.019367992 s | MpropuPlein | 0.0001 kg | M_éjecté | 0.0001 kg | M_burnout | 0 kg | XpropuPlein | 0 mm | XpropuVide | 0 mm | Longueur | 0 mm | Diamètre | 0 mm | Type | Fusex
Temps (en s) | 0 | 0.1 | 0.2 | 1 | 1 | 1 | 1 | 1 | 1 | 1 | 1 | 1 | 1 | 1 | 1 | 1 | 1 | 1 | 1 | 1 | 1 | 1 | 1 | 1000
Poussée (en N) | 0 | 0.01 | 0 | 0 | 0 | 0 | 0 | 0 | 0 | 0 | 0 | 0 | 0 | 0 | 0 | 0 | 0 | 0 | 0 | 0 | 0 | 0 | 0 | 0
I_total_i (en N.s) | 0.0005 | 0.0005 | 0 | 0 | 0 | 0 | 0 | 0 | 0 | 0 | 0 | 0 | 0 | 0 | 0 | 0 | 0 | 0 | 0 | 0 | 0 | 0 | 0
Liste des propu affichés : |  | H2O |  |  | µ-propu |  |  | Rocketry Challenge |  |  | Minif |  |  | Minif Test |  |  | Fusex
Pro54-5G WT |  | H2O 1.5L 300g 6bar |  |  | µ-propu A8-3 |  |  | p29-1G 56F31 |  |  | p29-1G 57F59 |  |  | p24-1G 24E22 |  |  | Pro54-5G WT
Barasinga (Pro54-5G C) |  | H2O 1.5L 450g 6bar |  |  | µ-propu B4-4 |  |  | p29-1G 56F120 |  |  | p24-3G 74F85 |  |  | p24-1G 25E75 (Rufina) |  |  | Barasinga (Pro54-5G C)
Orignal (Pro75-3G C) |  | H2O 1.5L 600g 6bar |  |  | µ-propu C6-3 |  |  | p29-1G 57F59 |  |  | p24-3G 75F51 |  |  | p24-1G 26E31 |  |  | Orignal (Pro75-3G C)
Pro98-6G Green |  | H2O 1.5L 750g 6bar |  |  | µ-propu C6-3 x2 |  |  | p24-3G 74F85 |  |  | p29-2G 116G126 |  |  | p24-2G 50E51 |  |  | Pro98-6G Green
 |  | H2O 2.0L 400g 6bar |  |  | µ-propu C6-3 x3 |  |  | p24-3G 75F51 |  |  | Pandora (Pro24-6G BS) |  |  | p24-1G 53E70
 |  | H2O 2.0L 600g 6bar |  |  |  |  |  |  |  |  | Klima D9-7 |  |  | p29-1G 41F36
 |  | H2O 2.0L 800g 6bar |  |  |  |  |  |  |  |  | Klima D9-7 x2 |  |  | p29-1G 51F36
 |  | H2O 2.0L 1000g 6bar |  |  |  |  |  |  |  |  | Klima D9-7 x3 |  |  | p29-1G 55F29
 |  |  |  |  |  |  |  |  |  |  |  |  |  | p29-1G 56F120
 |  |  |  |  |  |  |  |  |  |  |  |  |  | p29-1G 57F59
 |  |  |  |  |  |  |  |  |  |  |  |  |  | p24-3G 60F50
 |  |  |  |  |  |  |  |  |  |  |  |  |  | p24-3G 68F79
 |  |  |  |  |  |  |  |  |  |  |  |  |  | p24-3G 68F240
 |  |  |  |  |  |  |  |  |  |  |  |  |  | p24-3G 73F30
 |  |  |  |  |  |  |  |  |  |  |  |  |  | p24-3G 74F85
 |  |  |  |  |  |  |  |  |  |  |  |  |  | p24-3G 75F51
 |  |  |  |  |  |  |  |  |  |  |  |  |  | p29-2G 84G88
Isard |  |  |  |  |  |  |  |  |  |  |  |  |  | p29-2G 93G80 |  |  | Isard
Chamois |  |  |  |  |  |  |  |  |  |  |  |  |  | p29-2G 110G250 |  |  | Chamois
Pro54-5G WT |  |  |  |  |  |  |  |  |  |  |  |  |  | p29-2G 116G126 |  |  | Pro54-5G WT
Pro98-6G Green |  |  |  |  |  |  |  |  |  |  |  |  |  | p29-3G 125G131 |  |  | Pro98-6G Green
Pro98-3G WT |  |  |  |  |  |  |  |  |  |  |  |  |  | p38-1G 128G185 |  |  | Pro98-3G WT
Aucun (2e ét. inerte) |  |  |  |  |  |  |  |  |  |  |  |  |  | p38-1G 137G58 |  |  | Aucun (2e ét. inerte)
 |  |  |  |  |  |  |  |  |  |  |  |  |  | p38-1G 141G78
 |  |  |  |  |  |  |  |  |  |  |  |  |  | p24-6G 140G145 PK
 |  |  |  |  |  |  |  |  |  |  |  |  |  | Pandora (Pro24-6G BS)
 |  |  |  |  |  |  |  |  |  |  |  |  |  | p24-6G 142G117 WT
 |  |  |  |  |  |  |  |  |  |  |  |  |  | p24-6G 139G107 DT
 |  |  |  |  |  |  |  |  |  |  |  |  |  | Cariacou
 |  |  |  |  |  |  |  |  |  |  |  |  |  | Wapiti

Sheet: Calculs
 |  | Dynamique de la fusée (repère sol) |  |  |  |  |  |  |  |  |  |  | Forces |  |  |  |  |  |  |  |  |  |  | Sous-échantillon 1Hz |  |  | Accélération longitudinale
pas | t | acc_x | acc_z | acc_xz | vit_x | vit_z | vit_xz | pos_x | pos_z | pos_xz | Beta | BetaD | i_P | Poussée | Débit | m | Poids | R_rampe | Rho | Trainée | Événements |  |  | Temps | x | z | gravitationnelle | non-gravit.
s | s | m/s² | m/s² | m/s² | m/s | m/s | m/s | m | m | m | rad | ° | - | N | kg/s | kg | N | N | kg/m3 | N |  |  |  | s | m | m | m/s² | m/s²
- | 0.00 | - | - | - | 17.36 | 98.48 | 100.00 | 0.00 | 0.00 | 0.00 | 1.40 | 80.00 | - | - | - | 6.03 | 59.12 | 10.27 | 1.23 | 39.74 | - | - | - | 0 | 0 | 0 | - | -
0.01 | 0.01 | -0.25 | -1.41 | 1.44 | 17.36 | 98.47 | 99.99 | 0.17 | 0.98 | 1.00 | 1.40 | 80.00 | 1 | 89.30 | 0.04 | 6.03 | 59.11 | 10.26 | 1.22 | 39.73 |  |  |  | #N/A | #N/A | 0.9847370075 | -1.44 | 8.22
0.01 | 0.02 | 4.90 | 27.79 | 28.21 | 17.41 | 98.74 | 100.27 | 0.35 | 1.97 | 2.00 | 1.40 | 80.00 | 1 | 267.90 | 0.13 | 6.02 | 59.10 | 10.26 | 1.22 | 39.95 |  |  |  | #N/A | #N/A | 1.970792574 | 28.21 | 37.88
0.01 | 0.03 | 10.04 | 56.97 | 57.85 | 17.51 | 99.31 | 100.85 | 0.52 | 2.96 | 3.01 | 1.40 | 80.00 | 1 | 446.50 | 0.22 | 6.02 | 59.08 | 10.26 | 1.22 | 40.41 | Sortie de rampe |  |  | #N/A | #N/A | 2.961086018 | 57.85 | 67.51
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
0.01 | 2.24 | 8.92 | 35.45 | 36.56 | 55.40 | 280.88 | 286.29 | 87.52 | 461.44 | 469.66 | 1.38 | 78.84 | 6 | 551.69 | 0.28 | 5.23 | 51.32 | 0.00 | 1.17 | 311.07 |  |  |  | #N/A | #N/A | 461.4380465 | 36.51 | 46.13

Sheet: Abaco
 | ABACO
 | Abaques de performance
 | Calcul analytique simple
 | Fusée
Nom | SP02
Club | L'AéroIPSA
Matricule | FX0
Masse sans propu | 4.341 kg ±100%
Masse totale | 6,026 kg ±4,341 kg
Propulseur | Barasinga (Pro54-5G C)
 | Traînée Aérdynamique
Diamètre Ø | 104 mm ±50%
Cx | 0.6
Diamètre | 1/2.ρ.S.Cx | Masse totale | M ph prop | M ph bal | Accélération | Traînée prop | Traînée bal | Alt prop | V max | alt_culmi | t_culmi
D_var | Q_var | m_var | m_prop | m_bal | a_prop | b_prop | b_bal | alt_prop | V_prop
Ø =54 mm | 0.0008416562338 | 1.685 kg | 1.1685 kg | 0.652 kg | 480.8721712 m/s² | 0.0007202877483 kg | 0.001290883794 | 1991.12369 | 793.5341125 m/s | 3706.676556 m | 16.57627793 s
Ø =54 mm | 0.0008416562338 | 2.77025 kg | 2.25375 kg | 1.73725 kg | 244.5936015 m/s² | 0.0003734470256 | 0.0004844761743 | 1338.805367 | 643.4297643 m/s | 4502.565013 m | 23.21788193 s
Ø =54 mm | 0.0008416562338 | 3.8555 kg | 3.339 kg | 2.8225 kg | 161.9067167 m/s² | 0.000252068354 | 0.0002981952999 | 962.9493156 | 497.0148001 m/s | 4553.047322 m | 26.1629259 s
Ø =54 mm | 0.0008416562338 | 4.94075 kg | 4.42425 kg | 3.90775 kg | 119.7853251 m/s² | 0.0001902370422 | 0.0002153812894 | 736.8375218 | 392.3511819 m/s | 4165.638888 m | 26.92483046 s
Ø =54 mm | 0.0008416562338 | 6.026 kg | 5.5095 kg | 4.993 kg | 94.25790398 m/s² | 0.0001527645401 | 0.0001685672409 | 589.4960754 | 318.898715 m/s | 3587.351574 m | 26.29165456 s
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
Textes pour les graphiques :
Masse totale
Vitesse max
Vitesse max / Masse totale
Altitude max
Altitude max / Masse totale
Temps de culmination
Temps de culmination / Masse totale

Sheet: Info
StabTraj
Stabilité de fusée à ailerons
Calculs de Stabilité basés sur les équations de Barrowman

Sheet: Controle
 | Données au format des fiches de contrôles minif : |  |  |  |  |  |  |  |  |  |  | l = | 1
 | Matriucle | FX0
 | Propulseur | Barasinga (Pro54-5G C) |  | Masse sans prop. (kg) | 4.341
 | Couleur de la fusée | Brun/Orange… |  | Diamètre max (mm) | 104
 | Couleur du ralentisseur | Rouge… |  | Cx | 0.6
 | Surface ralentisseur (m²) | 0.4805 |  | Longeur de la rampe (m) | 4
 | Type d'éjection du para. |  |  | Type d'ogive | Conique (droite)
 | Masse sans propu (kg) | 4.341 | VL4 | 10 < finesse < 20 | 100.8 |  |  |  |  |  |  |  |  |  | 1
 |  |  | VL4 | 15 < Cn < 30 | 10.8 |  |  |  |  |  |  | D = | 84
 | Cx | 0.6 | VL4 | 1,5.D < Ms < 6.D | 16.2 |  |  |  |  |  |  |  |  |  | 1070
 | Longueur rampe | 4 | VL4 | 30 < Ms x Cn < 100 | 2.4 | 3.0
 | Epaisseur ailerons | 4 | VL4 | Vsortie de rampe (> 18 m/s) | 39.2 | 48.4
 | Nombre ailerons | 4 | RC1 | 5 < Vc < 15 m/s | 12.9 | 12.7 |  |  |  |  |  |  |  |  | 60
 | Type d'ogive | Conique (droite) | RC2 | Temps de retard ralentisseur | 16.4 |  |  |  |  |  |  | Dj = | 104
 | Haut du propu "Prop" | 632 | RC2 | Indication dépotage lanceur | 16.4
 |  |  | RC5 | Portée balistique < 200 m | 928.2092619 m
 |  |  |  |  |  |  |  |  |  |  |  |  |  |  | 50
(mm) | Fusée |  | Ailerons | Bi empennage |  |  | Transition A | Transition B
X cg (sans) | 493 | m | 210 | 180 |  | L | 60 | 50
L tot | 1120 | n | 80 | 80 |  | D 1 | 84 | 104
X prop | 1120 | p | 185 | 160 |  | D 2 | 104 | 84
D | 104 | E | 145 | 110 |  | X | 1 | 1070
L ogive | 1 | X ail | 1070 | 1250
Inclinaison | Portée balistique (m) | Temps de vol avec parachute (s) |  |  | Culmination |  |  |  | Accélération max (m/s²) | Vmax (m/s) | n = | 80 |  |  | ailrons haut
 |  |  |  |  | Altitude (m) |  | Temps (s) | Vitesse (m/s) |  |  |  |  |  | p = | 160
80° | 928.2092619 | 182.1 |  |  | 2142.363162 |  | 17.4 | 21.7 | 131.7551938 | 302.0 | ep = | 4 |  | m = | 180
 |  |  |  |  |  |  |  |  |  |  | nombre | 4 |  | n = | 80
 |  |  |  |  |  |  |  |  |  |  |  |  |  | E = | 110
 |  |  |  |  |  |  |  |  |  |  |  | E = | 145 | ep = | 4
 |  |  |  |  |  |  |  |  |  |  |  |  |  | nombre | 4
 | Donneés au format des fiches de contrôles Fusex : |  |  |  | Matricule | FX0
 | Diamètre "D" | 104 |  |  | sans | vide | plein
 | Longueur ogive "l" | 1 |  | Masse | 4.341 | 4.993 | 6.026
 | Position ailerons "L" | 860 |  | CdG | 493 | 542.4908872 | 601.7728178
 | Emplanture 'm' | 210
 | Saumon 'n' | 80 | STAB 1 | Vsortie de rampe (> 20 m/s) | 100.8
 | Flèche 'p' | 185 | STAB 2 | 10 < finesse < 35 | 10.8
 | Envergure 'E' | 145 | STAB 3 | 15 < Portance < 40 | 16.2
 | Epaisseur ailerons | 4 | STAB 4 | 2*D < Ms < 6*D | 2.4 | 3.0
 | Nombre ailerons | 4 | STAB 5 | 40 < Ms x Cn < 100 | 39.2 | 48.4
 | Haut du propu "Prop" | 632
 | Type d'ogive | Conique (droite) |  | Cx | 0.6
 | Longueur totale | 1120 |  | Maître couple (m²) | 0.01081486654
 | Diamètre max | 104 |  | Site | 80 | 80 | 90
 | Envergure totale | 394 |  | Temps culmi (s) | 17.4
 |  |  |  | Altitude culmi (m) | 2142.363162
CR 1 | Longueur | 1120 |  | Vitesse culmi (m/s) | 21.7
 | Diamètre max (40à200) | 104 |  | Portée balistique (m) | 928.2092619
 | Envergure totale <720 | 394 |  | Temps balistique (s) | 43.9
 | Masse <15 | 6.026 |  | Vmax (m/s) | 302.0
CR 2 | Nombre ailerons | 4 |  | Accélération max (m/s²) | 131.7551938
 |  |  |  | Pensez à modifier l'inclinaison pour avoir les 2 valeurs.
 |  | N | kg
MEC 3 | Compression 2.Acc.M | 1587.913595 | 161.8668293
 | Resist long aileron | 44.32244718 | 4.5 | Masse aileron (kg) | 0.1682
 | Resist transv aileron | 199.4867334 | 20.3 | Surface aileron (m²) | 0.021025
REC 8 | Compression porte | 793.9567976 | 80.93341464 | Masse au-dessus porte | 3.013
 |  |  | SEQ 5 | T dépotage +/-2s /appogée | 16.4 | 17.4
 |  |  | REC 2 | 5 < Vc < 15 m/s | 12.9 | 12.7
 |  |  |  | Surface parachute m² | 0.5 | 0.1
 |  |  |  | Vitesse à l'ouverture m/s | 24.2 | 219.1
 |  |  |  | Masse | 5.0 | 1.0
 |  |  |  | Choc à l'ouverture N | 172.6901265 | 2941.015138
 |  |  |  | Choc à l'ouverture kg | 17.6 | 299.8
 | Donneés au format des fiches de lancement Fusex :
 |  |  |  | MECANIQUE
Projet | SP02
Club | L'AéroIPSA
Chef de projet | - | l = | 1
Date | 2026-04-04
 |  |  |  |  |  |  | 1
Moteur | Barasinga (Pro54-5G C) | D = | 84
Virole | - |  |  |  |  |  | 1070
 |  |  |  |  |  |  | 60
 |  | Dj = | 104 |  |  |  | 860
 |  |  |  |  |  |  | 50
 |  | Dr = | 84
 |  | m = | 210 |  |  |  | 185
 | Nb Aileron | 4
 | X_plaque de poussée | 632 |  |  |  |  | 80
 | Type ogive | 0 | ogivale
 |  | 1 | conique
 |  | 0 | parabolique |  |  |  | Epaisseur :
 |  |  |  |  | 145 |  | 4
 |  | Sans propu | Propu plein
 | Masse fusée | 4.341 | 6.026
 | X_CdG | 493 | 601.7728178
 | Masse avec propu vide | 4.993 |  | Simulation de vol
 |  |  |  | Site | 80 | 80 | 90
 |  |  |  | Temps culmi (s) | 17.4
 | Tenue mécanique |  |  | Altitude culmi (m) | 2142.363162
 |  |  |  | Vitesse culmi (m/s) | 21.7
masse d'un aileron |  | 0.100 KG |  | Portée balistique (m) | 928.2092619
superficie d'un aileron |  | 21025 mm² |  | Vmax (m/s) | 302.0
 |  |  |  | Accélération max (m/s²) | 131.7551938
fleche acceptable(mm) |  |  | 8.6 mm | Cx | 0.6
compression |  | 1143.9 N | 116.605 KG | Pensez à modifier l'inclinaison pour avoir les 2 valeurs.
Resistance longitudinale d'un aileron |  | 26.4 N | 2.686 KG
Resistance transversale d'un aileron |  | 199.5 N | 20.335 KG
 | Récupération
Ralentisseur
nombre de suspentes |  | 4
surface parachute |  | 0.48050 m²
force à tester totale |  | 138.8 N | 14.145 KG
force sur suspente |  | 69.4 N | 7.072 KG
Séparation latérale
masse au dessus case para |  | 1.000 KG
Force de compression |  | 26.9 kg
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
