povdoigt/SP-02/STABTRAJ/sp02_v3_38/Alpha_Beta/alpha_beta_actif.xlsx

Sheet: Stabilito
 |  | STABILITO |  |  |  |  |  |  |  | Language/Langue | Français
 |  | Stabilité de fusée à ailerons |  |  |  |  |  |  |  |  | Plusieurs diamètres.
 |  |  |  |  |  |  |  |  |  |  | Transition A |  | Transition B
 |  | Remplir les cases jaunes |  |  |  |  |  |  |  | Longueur 'L' | 60 mm |  | 50 mm
 |  | Fusée |  |  |  |  |  |  |  | Diamètre 'D1' | 84 mm |  | 104 mm
 | Nom | SP02 |  |  |  |  |  |  |  | Diamètre 'D2' | 104 mm |  | 84 mm
 | Club | L'AéroIPSA |  |  |  |  |  |  |  | Implantation 'x' | 1182 mm |  | 2252 mm
 | Matricule | FX | 5 | FX5
 | Type | Fusée expérimentale. |  |  |  |  |  |  |  |  | Propu plein | Propu vide |  | Sans propu |  |  | Propulseur
 | Masse | 8421 g | sans propu |  |  |  |  |  |  | Masse propu | 1.685 kg | 0.652 kg |  | - |  | Haut | 1814 mm
 | Centre de Masse | 1297 mm | sans propu |  |  |  |  |  |  | CdM propu | 250 mm | 240 mm |  | - |  | Longueur | 488 mm
 | Longueur totale | 2302 mm |  |  |  |  |  |  |  | Masse fusée | 10.106 kg | 9.073 kg |  | 8.421 kg |  | Bas | 2302 mm
 | Diamètre Réf. | 93.56632653 mm |  |  |  |  |  |  |  | CdM fusée | 1424.88393 mm | 1351.399206 mm |  | 1297 mm
 |  |  |  |  |  |  |  |  |  |  |  |  |  |  |  |  | Ailerons bas
 |  | Propulseur |  |  |  |  |  |  |  |  | XCp |  | Cnα |  |  | Haut | 2042 mm
 | Type | Barasinga (Pro54-5G C) |  |  |  |  |  |  |  | Coiffe | 168 mm |  | 1.6 |  |  | Emplanture | 210 mm
 | Position du bas | 2302 mm |  |  |  |  |  |  |  | Ailerons | 2159.356322 mm |  | 18.4 |  |  | Bas | 2252 mm
 |  |  |  |  |  |  |  |  |  | Ail bas entier | 2159.356322 mm |  | 18.4
 |  | Coiffe |  |  |  |  |  |  |  | Ailerons haut | 1097.4 mm |  | 10.6
 | Forme | Conique (droite) |  |  |  |  |  |  |  | Partie masquée | 2094.5 mm |  | 0.0
 | Hauteur | 252 mm |  |  |  |  |  |  |  | Transition A | 1213.06383 mm |  | 0.9
 | Diamètre | 84 mm |  |  |  |  |  |  |  | Transition B | 2276.113475 mm |  | -0.9
 |  |  |  | M
 |  | Ailerons bas | Ailerons haut |  | 2026-05-05 | Min | Résultats |  | Max
 |  | Bi-empennage |  | 210 | Finesse | 10 | 24.6 |  | 35
 | Emplanture 'm' | 210 mm | 170 mm | 210 | Portance | 15 | 30.6 | 30.6 | 40
 | Saumon 'n' | 80 mm | 80 mm | 0 | MargeStat. | 2 D | 2.48 D | 3.26 D | 6 D |  |  |  |  |  |  |  |  | ORK (DREF 104)
 | Flèche 'p' | 185 mm | 120 mm | 0 | Couple | 40 | 75.9 | 99.9 | 100 |  |  |  |  |  |  |  |  | MS | Cnalpha
 | Envergure 'E' | 145 mm | 105 mm | 4 | XCp |  | 1656.521044 mm | 1656.521044 mm |  |  |  |  |  |  |  |  |  | 2.25 | 25.11
 | Epaisseur 'ep' | 4 mm | 3 mm | 4 | MS /L |  | 10.06242891% L | 13.25464106% L |  |  |  |  |  |  |  |  |  | 2.99 | 25.11
 | Nombre | 4 | 4 | 2252 |  |  | STABLE
 | Position du bas | 2252 mm | 1182 mm | 104 |  |  |  |  |  |  |  |  |  |  |  |  |  | DREF 104
 | Diamètre | 104 mm | 84 mm | 0 |  |  |  |  |  |  |  |  |  |  |  |  |  | 2.1 | 24.71
 | Ligne mi-corde f | 188.2153022 mm | 129.034879 mm |  |  |  |  |  |  |  |  |  |  |  |  |  |  | 2.86 | 24.71
 | Commentaire libre : |  |  |  |  |  |  |  |  | Checksum : | propu OK | fichier initial |  |  | v3.4.5
 |  |  |  |  |  |  |  |  |  |  |  |  |  |  |  |  |  | DREF 94,33
 |  |  |  |  |  |  |  |  |  | Maintenant que votre fusée est stable, vérifiez sa trajectoire via la feuille | Trajecto |  |  |  |  |  |  | 2.32 | 30.03
 |  |  |  |  |  |  |  |  |  |  |  |  |  |  |  |  |  | 3.16 | 30.03
 |  |  |  |  |  |  |  |  |  |  |  |  |  |  |  |  |  | DREF 84
 |  |  |  |  |  |  |  |  |  |  |  |  |  |  |  |  |  | 2.6 | 37.87
 |  |  |  |  |  |  |  |  |  |  |  |  |  |  |  |  |  | 3.55 | 37.87
 | Textes pour les listes déroulantes et graphiques :
 | Français
 | English
 | Fusée à eau
 | Microfusée
 | Minifusée
 | Fusée expérimentale.
 | ,Minif Tests
 | sans propu
 | avec propu vide
 | avec propu plein
 | Parabolique (arrondie)
 | Ogivale (pointue)
 | Conique (droite)
 | Mono-empennage
 | Bi-empennage
 | Fusée mono-diamètre,
 | Plusieurs diamètres.
 | Diagramme des critères de stabilité
 | Marge Statique (MS)
 | Portance Cnα
 | Données pour les graphiques :
 |  | X longi | Y latéral | - Y latéral
 | Ogive | -252 | 0 | 0
 | Ogive | -252 | 42 | -42
 | chmt1 pt1 | -1182 | 42 | -42
 | chmt1 pt2 | -1242 | 52 | -52
 | chmt2 pt1 | -2252 | 52 | -52
 | chmt2 pt2 | -2302 | 42 | -42
 | culot | -2302 | 42 | -42
 | culot | -2302 | 0 | 0
 | aileron pt1 | -2042 | 52 | -52
 | aileron pt2 | -2227 | 197 | -197
 | aileron pt3 | -2307 | 197 | -197
 | aileron pt4 | -2252 | 52 | -52
 | aileron pt1 | -2042 | 52 | -52
 | Envergure | -2383.733333 | -197
 | env milieu | -2383.733333 | -124.5
 | env pt4 | -2383.733333 | -52
 | Emplanture | -2042 | 312.1
 | empl milieu | -2147 | 312.1
 | empl pt4 | -2252 | 312.1
 | Flèche | -2042 | -273.7333333
 | flèche milieu | -2134.5 | -273.7333333
 | flèche pt2 | -2227 | -273.7333333
 | Saumon | -2227 | -312.1
 | saumon milieu | -2267 | -312.1
 | saumon pt3 | -2307 | -312.1
 | Xcg plein | -1424.88393 | 0
 | Xcg vide | -1351.399206 | 0
 | Xcp | -1656.521044 | 0
 | Xcp | -1656.521044 | 191.1766504
 | Xcp0 | -1656.521044 | 191.1766504
 | Xcp0 | -1656.521044 | 0
 | Marge Statique | -1388.141568 | -312.1
 | MS milieu | -1522.331306 | -312.1
 | MS Xcp | -1656.521044 | -312.1
 | canard pt1 | -1012 | 52 | -52
 | canard pt2 | -1132 | 157 | -157
 | canard pt3 | -1212 | 157 | -157
 | canard pt4 | -1182 | 52 | -52
 | canard pt1 | -1012 | 52 | -52
 | masquage pt1 | -2042 | 52 | -52
 | masquage pt2 | -2042 | 52 | -52
 | masquage pt3 | -2252 | 52 | -52
 | masquage pt4 | -2252 | 52 | -52
 | masquage pt1 | -2042 | 52 | -52
 | cadre | -2330.07 | 767.3333333
 | cadre | -2330.07 | -767.3333333
 | propu pt1 | -1814 | -27
 | propu pt2 | -1814 | 27
 | propu pt3 | -2302 | 27
 | propu pt4 | -2302 | -27
 | propu pt5 | -1814 | -27 |  | conique | ogive | parabole
 | Pointe | 0 | 0 | 0 | 0 | 0 | 0
 | Ogive | -25.2 | 4.2 | -4.2 | 4.2 | 8.4 | 21
 | Ogive | -63 | 10.5 | -10.5 | 10.5 | 21 | 29.4
 | Ogive | -126 | 21 | -21 | 21 | 31.5 | 36.96
 | Ogive | -189 | 31.5 | -31.5 | 31.5 | 37.8 | 39.9
 | Ogive | -252 | 42 | -42 | 42 | 42 | 42
 | MS (X) | Cna (Y) | MS (X) | Cna (Y)
 | 0 | 15 | 0.5 | 80
 | 7 | 15 | 1 | 40
 | 0 | 40 | 2 | 20
 | 7 | 40 | 3 | 13.33333333
 | 2 | 0 | 5 | 8
 | 2 | 55 | 7 | 5.714285714
 | 6 | 0 | 1 | 100
 | 6 | 55 | 2 | 50
 | 2.48 | 30.65 | 3 | 33.33333333
 | 2.48 | 30.65 | 4 | 25
 | 3.26 | 30.65 | 6 | 16.66666667
 | 3.26 | 30.65 | 7 | 14.28571429
 | 2.48 | 30.65
 | 0 | 27.5
 | 2 | 27.5
 | 3.636363636 | 27.5
 | 7 | 27.5
 | 4 | 0
 | 4 | 15
 | 4 | 25
 | 4 | 55
 | Verification moteur | TRUE
 | H20 | FALSE
 | Fusex | TRUE
 | micro | FALSE
 | minif N | FALSE
 | Minif RC | FALSE
 | Minif Test | FALSE
module rocket(){
module aileron(diam, m, n, p, e, ep, nb, pos, masque = true){
depha = masque ? 0 : 45 ;
for (angle = [0 : 360/nb : 360] ){
translate ([-diam*sin(angle+depha), diam*cos(angle+depha), pos-m]) {
rotate( [0, 0, angle+depha] ){
polyhedron
(points = [
[+ep, 0, 0], [+ep, 0, m], [+ep, e, p+n], [+ep, e, p],
[-ep, 0, 0], [-ep, 0, m], [-ep, e, p+n], [-ep, e, p]
],
triangles = [
[0, 2, 1], [0, 2, 3], //carre +
[4, 6, 5], [4, 6, 7], //carre -
[0, 5, 1], [0, 5, 4],
[1, 6, 2], [1, 6, 5],
[2, 7, 3], [2, 7, 6],
[0, 7, 3], [0, 7, 4]
]
);
}
}
}
}
module coiffe(diam, hauteur, resolution = 20.0){
pas = hauteur/resolution;
for (x = [0: pas : hauteur] ){
translate( [0, 0, x+pas] ){
cylinder(pas, pow(x, 1.0/2.0), pow(x+pas, 1.0/2.0), false);
}
}
}
//--------------------------------coiffe
if (coiffe_type == "conique"){
cylinder(coiffe_hauteur, 0, coiffe_diametre, false);
}
//--------------------------------corps
if (plusieur_diametres == false){
translate ([0, 0, coiffe_hauteur]) {
cylinder(longeur_total-coiffe_hauteur, coiffe_diametre, coiffe_diametre, false);
}
} else {
//Premier cylindre
translate ([0, 0, coiffe_hauteur]) {
cylinder(diam_A_X_implantation-coiffe_hauteur, coiffe_diametre, coiffe_diametre, false);
}
//Premier chanvrin
translate ([0, 0, diam_A_X_implantation]) {
cylinder(diam_A_L_longeur, diam_A_D1_diametre, diam_A_D2_diametre, false);
}
//Second cylindre
translate ([0, 0, diam_A_X_implantation+diam_A_L_longeur]) {
cylinder(diam_B_X_implantation-(diam_A_X_implantation+diam_A_L_longeur), diam_A_D2_diametre, diam_B_D1_diametre, false);
}
//Second chanvrin
translate ([0, 0, diam_B_X_implantation]) {
cylinder(diam_B_L_longeur, diam_B_D1_diametre, diam_B_D2_diametre, false);
}
//Troisieme cylindre
translate ([0, 0, diam_B_X_implantation + diam_B_L_longeur]) {
cylinder(longeur_total-(diam_B_X_implantation + diam_B_L_longeur), diam_B_D2_diametre, diam_B_D2_diametre, false);
}
}
//--------------------------------ailerons
aileron(coiffe_diametre, aileron_m_emplature,
aileron_n_saumon,
aileron_p_fleche,
aileron_e_envergure,
aileron_epaisseur,
aileron_nombre,
aileron_position_bas);
if (bi_empennage == true){
aileron(coiffe_diametre, aileron_sup_m_emplature,
aileron_sup_n_saumon,
aileron_sup_p_fleche,
aileron_sup_e_envergure,
aileron_sup_epaisseur,
aileron_sup_nombre,
aileron_sup_position_bas,
aileron_sup_masque);
}
}
rocket();

Sheet: Trajecto
 |  | TRAJECTO
 |  | Trajectographie de fusée
 |  | Remplir les cases jaunes
 |  | Fusée
 | Nom | SP02
 | Club | L'AéroIPSA
 | Matricule | FX5
 | Masse totale | 10.106 kg
 | Propulseur | Barasinga (Pro54-5G C)
 |  | Traînée Aérdynamique
 | Surface Réf. | 0.009196 m²
 | Cx | 0.7
 |  | Rampe de Lancement
 | Longueur | 4 m
 | Élévation | 80 °
 | Altitude | 0 m
 |  | DescenteSousParachute |  |  |  | 2026-05-05 | Temps | Altitude z | Portée x | Vitesse | Accélération | Efforts
 |  | Fusée | 1 satellite |  | Sortie de Rampe |  |  |  |  | 23.8 m/s
 | Masse | 8.073 kg | 1 kg |  | Vit max & Acc max |  |  |  |  | 163.8197423 m/s | 78.73391106 m/s²
 | Dépotage | N/A |  |  | Largage du satellite |  | 4.6 s | 511.698102 m | 122.1833998 m | 141.21421 m/s |  | 1221.4 N
 | Ouverture para | 16.2 s | 4.6 s |  | Culmination, Apogée |  | 15.8 s | 1202.82154 m | 459.6843015 m | 26.77348739 m/s
 | Type de para | Rond |  |  | Ouverture parachute fusée |  | 16.2 s | 1202.253415 m | 470.3694516 m | 26.87109852 m/s |  | 255.6 N
 | Surface para | 0.58 m² | 0.1 m² |  | Impact balistique |  | 32.9 s | ~0 m | 839.6394906 m | 122.7 m/s |  | 60734.13065 J
 | Cx parachute | 1 | 1
 | Vitesse du vent | 5 m/s | 5 m/s
 | Vitesse descente | 15.0 m/s | 12.7 m/s
 | Durée descente | 80.38609533 s | 40.43266327 s |  |  |  | Pour localiser la fusée
 | Durée du vol | 96.58609533 s | 45.03266327 s |  | Couleur fuselage/coiffe |  | Brun/Orange…
 | Déport latéral | ±401.9304767 m | ±202.1633163 m |  | Couleur parachute fusée |  | Rouge… |  |  |  |  |  | fichier initial
 |  |  |  |  | Couleur parachute satellite |  | Jaune |  |  |  |  |  | propu OK
 | Commentaire libre : |  |  |  |  |  |  |  |  |  |  |  | v3.4.5
Calcul de la surface d'un parachute |  |  |  |  | Résultats détaillés |  | Temps | Altitude z | Portée x | Vitesse | Accélération | Angle
 |  |  |  |  |  |  | s | m | m | m/s | m/s² | °
 |  |  |  |  | Décollage |  | 0 | 0 | 0 | 0 | - | 80
 | Bord 'a' |  |  |  | Sortie de Rampe |  | 0.34 | 3.71 | 0.65 | 23.8 | 73.7 | 80.0
 | 340 mm |  |  |  | Vit max & Acc max |  | - | - | - | 163.8197423 | 78.7 | -
 | Coté 'b' |  |  |  | Fin de Propulsion |  | 3.6 | 366.0559633 | 84.19397224 | 160.2194169 | 20.4 | 75.8
 | 340 mm |  |  |  | Culmination, Apogée |  | 15.8 | 1202.82154 | 459.6843015 | 26.77348739 | 9.8 | 1.2
 | Surface para |  |  |  | Impact balistique |  | 32.9 | ~0 | 839.6394906 | 122.6630986 | 3.5 | -82.6
 | 0.58 m² |  |  |  | Ouverture parachute fusée |  | 16.2 | 1202.253415 | 470.3694516 | 26.87109852 | 9.8 | -7.2
 |  |  |  |  | Impact fusée sous para. |  | 96.58609533 | ~0 | 68 | 872 | 14.95598723 | 9.8 | -
 |  |  |  |  | Largage du satellite |  | 4.6 | 511.698102 | 122.1833998 | 141.21421 | 18.1 | 74.9
 | Rayon exterieur |  |  |  | Impact du satellite |  | 45.03266327 | ~0 | -80 | 324 | 12.65556262 | 9.8 | -
 | 430 mm
 | Rayon intérieur
 | 30 mm
 | Surface para
 | 0.58 m²
 | Vitesse de descente sous parachute :
 | Textes pour les listes déroulantes et graphiques :
 |  |  |  |  | N/A | Délais dépotage |  | Rond
 | 0 satellite |  |  |  | -9.0 s | -9 |  | Croix
 | 1 satellite |  |  |  | -7.0 s | -7 |  | Autre
 | Phase ascendante |  |  |  | -5.0 s | -5
 | Descente balistique |  |  |  | -3.0 s | -3
 | Fusée sous parachute |  |  |  | 0.0 s | -0
 | Satellite sous parachute |  |  |  | autre
 | Trajectoire (x z)
 | Portée x [m]
 | Temps [s]
 | Altitude z / Temps | 16.2
 | T_para =
 | Données pour les graphiques :
 | xz max | xz max
 | 1202.82154 | 1202.82154
 | x para | z para
 | 470.3694516 | 1202.253415
 | 470.3694516 | 601.1267075
 | 470.3694516 | 0
 | 500.4257869 | 60.11267075
 | 470.3694516 | 0
 | 440.3131162 | 60.11267075
 | 470.3694516 | 0
 | t para | z para
 | 16.2 | 1202.253415
 | 56.4 | 601.1267075 |  | 1 | vertical
 | 96.6 | 0 |  | 1 | horizontal
 | 95.5 | 58.02134001 |  |  | flèches
 | 96.6 | 0 |  | 1s | 3.29
 | 92.2 | 23.92177726 |  | t/T | 0.83
 | 96.6 | 0 |  | z/Z | 1.00
 | x sat | z sat
 | 122.1833998 | 511.698102
 | 122.1833998 | 127.9245255
 | 122.1833998 | 0
 | 134.9758524 | 25.5849051
 | 122.1833998 | 0
 | 109.3909473 | 25.5849051
 | 122.1833998 | 0
 | t sat | z sat
 | 4.6 | 511.698102
 | 24.8 | 255.849051
 | 45.0 | 0
 | 43.4 | 99.30148086
 | 45.0 | 0
 | 41.1 | 23.71223714 |  | t/T | 0.86
 | 45.0 | 0 |  | z/Z | 0.70
 | t | z | x
 | 4.05 | 601.1267075 | 117.5923629
 | 24.35 | 601.4107702 | 712.9877609
 | z_triomphe | x_triomphe | Arc de triomphe
 | #N/A | 0 | 459.6843015 |  | Arc de triomphe
 | #N/A | 23 | 482.6843015 |  | 459.6843015
 | #N/A | 23 | 482.6843015 |  | 436.6843015
 | #N/A | 0 | 459.6843015 |  | 436.6843015
 | #N/A | 23 | 482.6843015 |  | 459.6843015
 | #N/A | 23 | 482.6843015 |  | 436.6843015
 | #N/A | 8 | 467.6843015 |  | 436.6843015
 | #N/A | 8 | 467.6843015 |  | 451.6843015
 | #N/A | 23 | 482.6843015 |  | 451.6843015
 | #N/A | 8 | 467.6843015 |  | 436.6843015
 | #N/A | 7.6 | 467.2843015 |  | 451.6843015
 | #N/A | 6.8 | 466.4843015 |  | 452.0843015
 | #N/A | 6 | 465.6843015 |  | 452.8843015
 | #N/A | 5 | 464.6843015 |  | 453.6843015
 | #N/A | 3.8 | 463.4843015 |  | 454.6843015
 | #N/A | 0 | 459.6843015 |  | 455.8843015
 |  |  |  |  | 459.6843015
 | z_Eiffel | x_Eiffel | Tour Eiffel
 | 324 | 0 | 459.6843015 |  | Tour Eiffel
 | 300 | 0 | 459.6843015 |  | 459.6843015
 | 280 | 10 | 469.6843015 |  | 459.6843015
 | 280 | 0 | 459.6843015 |  | 449.6843015
 | 280 | 10 | 469.6843015 |  | 459.6843015
 | 200 | 13 | 472.6843015 |  | 449.6843015
 | 160 | 17 | 476.6843015 |  | 446.6843015
 | 115 | 20 | 479.6843015 |  | 442.6843015
 | 90 | 25 | 484.6843015 |  | 439.6843015
 | 57 | 30 | 489.6843015 |  | 434.6843015
 | 40 | 36 | 495.6843015 |  | 429.6843015
 | 20 | 48 | 507.6843015 |  | 423.6843015
 | 0.5 | 62 | 521.6843015 |  | 411.6843015
 | 0.5 | 37 | 496.6843015 |  | 397.6843015
 | 15 | 30 | 489.6843015 |  | 422.6843015
 | 30 | 15 | 474.6843015 |  | 429.6843015
 | 37 | 0 | 459.6843015 |  | 444.6843015
 | 67 | 0 | 459.6843015 |  | 459.6843015
 | 67 | 17 | 476.6843015 |  | 459.6843015
 | 100 | 11 | 470.6843015 |  | 442.6843015
 | 100 | 0 | 459.6843015 |  | 448.6843015
 |  |  |  |  | 459.6843015

Sheet: Courbes
Notes :
Ces courbes représentent la trajectoire de la fusée dans l'hypothèse d'une descente balistique (sans ouverture du parachute).
L'accélération longitudinale gravitationnelle définit le mouvement (dérivée de la vitesse) : Acc = (Poussee - Traînée ± Poids) / m
La charge ''non-gravitationnelle'' vue par un capteur d'accélération (masse-ressort) est : Charge = (Poussée - Traînée) / m
Exemples : Si Poussée = Poids, Vitesse constante, Acc nulle, Charge = 1G ; En chute libre, Acc = -1G, Charge = 0
Textes pour les graphiques :
Traînée
Poussée
Poids
Accélération longitudinale
Charge vue par un capteur
Vitesse
Vitesse [m/s]
Altitude
Portée
Temps [s]

Sheet: Propu
Moteur sélectionné | Ligne
Barasinga (Pro54-5G C) | 279 | I_total | 2058.4 N.s | ISP | 203.1206673 s | MpropuPlein | 1.685 kg | m_poudre | 1.033 kg | MpropuVide | 0.652 kg | XpropuPlein | 250 mm | XpropuVide | 240 mm | Longueur | 488 mm | Diamètre | 54 mm | Type | Fusex | Combustion | 0.0 s | Dépotage | 0
Temps (en s) | 0 | 0.05 | 0.5 | 1 | 1.5 | 2 | 2.5 | 2.97 | 3.2 | 3.47 | 3.59 | 3.59 | 3.59 | 3.59 | 3.59 | 3.59 | 3.59 | 3.59 | 3.59 | 3.59 | 3.59 | 3.59 | 3.59 | 1000
Poussée (en N) | 0 | 893 | 798 | 739 | 659 | 586 | 513 | 417 | 225 | 67 | 0 | 0 | 0 | 0 | 0 | 0 | 0 | 0 | 0 | 0 | 0 | 0 | 0 | 0
H2O
H2O 1.5L 300g 6bar | 26 | I_total | 9.8 N.s | ISP | 3.3 s | MpropuPlein | 0.3 kg | M_éjecté | 0.3 kg | M_burnout | 0 kg | XpropuPlein | 60 mm | XpropuVide | 150 mm | Longueur | 300 mm | Diamètre | 90 mm | Type | H2O
Temps (en s) | 0 | 0.001 | 0.02 | 0.038 | 0.04 | 0.04 | 0.04 | 0.04 | 0.04 | 0.04 | 0.04 | 0.04 | 0.04 | 0.04 | 0.04 | 0.04 | 0.04 | 0.04 | 0.04 | 0.04 | 0.04 | 0.04 | 0.04 | 1000
Poussée (en N) | 0 | 310 | 250 | 212 | 0 | 0 | 0 | 0 | 0 | 0 | 0 | 0 | 0 | 0 | 0 | 0 | 0 | 0 | 0 | 0 | 0 | 0 | 0 | 0
I_total_i (en N.s) | 0.2 | 5.3 | 4.2 | 0.2 | 0 | 0 | 0 | 0 | 0 | 0 | 0 | 0 | 0 | 0 | 0 | 0 | 0 | 0 | 0 | 0 | 0 | 0 | 0
H2O 1.5L 450g 6bar | 31 | I_total | 13.8 N.s | ISP | 3.1 s | MpropuPlein | 0.45 kg | M_éjecté | 0.45 kg | M_burnout | 0 kg | XpropuPlein | 90 mm | XpropuVide | 150 mm | Longueur | 300 mm | Diamètre | 90 mm | Type | H2O
Temps (en s) | 0 | 0.001 | 0.02 | 0.04 | 0.061 | 0.062 | 0.062 | 0.062 | 0.062 | 0.062 | 0.062 | 0.062 | 0.062 | 0.062 | 0.062 | 0.062 | 0.062 | 0.062 | 0.062 | 0.062 | 0.062 | 0.062 | 0.062 | 1000
Poussée (en N) | 0 | 310 | 245 | 200 | 167 | 0 | 0 | 0 | 0 | 0 | 0 | 0 | 0 | 0 | 0 | 0 | 0 | 0 | 0 | 0 | 0 | 0 | 0 | 0
I_total_i (en N.s) | 0.2 | 5.3 | 4.5 | 3.9 | 0.1 | 0 | 0 | 0 | 0 | 0 | 0 | 0 | 0 | 0 | 0 | 0 | 0 | 0 | 0 | 0 | 0 | 0 | 0
H2O 1.5L 600g 6bar | 36 | I_total | 17.1 N.s | ISP | 2.9 s | MpropuPlein | 0.6 kg | M_éjecté | 0.6 kg | M_burnout | 0 kg | XpropuPlein | 120 mm | XpropuVide | 150 mm | Longueur | 300 mm | Diamètre | 90 mm | Type | H2O
Temps (en s) | 0 | 0.001 | 0.02 | 0.04 | 0.06 | 0.08 | 0.088 | 0.089 | 0.089 | 0.089 | 0.089 | 0.089 | 0.089 | 0.089 | 0.089 | 0.089 | 0.089 | 0.089 | 0.089 | 0.089 | 0.089 | 0.089 | 0.089 | 1000
Poussée (en N) | 0 | 310 | 240 | 190 | 157 | 133 | 125 | 0 | 0 | 0 | 0 | 0 | 0 | 0 | 0 | 0 | 0 | 0 | 0 | 0 | 0 | 0 | 0 | 0
I_total_i (en N.s) | 0.2 | 5.2 | 4.3 | 3.5 | 2.9 | 1 | 0.1 | 0 | 0 | 0 | 0 | 0 | 0 | 0 | 0 | 0 | 0 | 0 | 0 | 0 | 0 | 0 | 0
H2O 1.5L 750g 6bar | 41 | I_total | 19.4 N.s | ISP | 2.6 s | MpropuPlein | 0.75 kg | M_éjecté | 0.75 kg | M_burnout | 0 kg | XpropuPlein | 150 mm | XpropuVide | 150 mm | Longueur | 300 mm | Diamètre | 90 mm | Type | H2O
Temps (en s) | 0 | 0.001 | 0.02 | 0.04 | 0.06 | 0.08 | 0.1 | 0.123 | 0.124 | 0.124 | 0.124 | 0.124 | 0.124 | 0.124 | 0.124 | 0.124 | 0.124 | 0.124 | 0.124 | 0.124 | 0.124 | 0.124 | 0.124 | 1000
Poussée (en N) | 0 | 310 | 230 | 175 | 140 | 118 | 100 | 85 | 0 | 0 | 0 | 0 | 0 | 0 | 0 | 0 | 0 | 0 | 0 | 0 | 0 | 0 | 0 | 0
I_total_i (en N.s) | 0.2 | 5.1 | 4 | 3.1 | 2.6 | 2.2 | 2.1 | 0.0425 | 0 | 0 | 0 | 0 | 0 | 0 | 0 | 0 | 0 | 0 | 0 | 0 | 0 | 0 | 0
H2O 2.0L 400g 6bar | 46 | I_total | 12.9 N.s | ISP | 3.3 s | MpropuPlein | 0.5 kg | M_éjecté | 0.4 kg | M_burnout | 0.1 kg | XpropuPlein | 60 mm | XpropuVide | 150 mm | Longueur | 300 mm | Diamètre | 98 mm | Type | H2O
Temps (en s) | 0 | 0.001 | 0.02 | 0.04 | 0.05 | 0.051 | 0.051 | 0.051 | 0.051 | 0.051 | 0.051 | 0.051 | 0.051 | 0.051 | 0.051 | 0.051 | 0.051 | 0.051 | 0.051 | 0.051 | 0.051 | 0.051 | 0.051 | 1000
Poussée (en N) | 0 | 310 | 264 | 230 | 213 | 0 | 0 | 0 | 0 | 0 | 0 | 0 | 0 | 0 | 0 | 0 | 0 | 0 | 0 | 0 | 0 | 0 | 0 | 0
I_total_i (en N.s) | 0.2 | 5.5 | 4.9 | 2.2 | 0.1 | 0 | 0 | 0 | 0 | 0 | 0 | 0 | 0 | 0 | 0 | 0 | 0 | 0 | 0 | 0 | 0 | 0 | 0
H2O 2.0L 600g 6bar | 51 | I_total | 18.1 N.s | ISP | 3.1 s | MpropuPlein | 0.7 kg | M_éjecté | 0.6 kg | M_burnout | 0.1 kg | XpropuPlein | 90 mm | XpropuVide | 150 mm | Longueur | 300 mm | Diamètre | 98 mm | Type | H2O
Temps (en s) | 0 | 0.001 | 0.02 | 0.04 | 0.06 | 0.08 | 0.081 | 0.081 | 0.081 | 0.081 | 0.081 | 0.081 | 0.081 | 0.081 | 0.081 | 0.081 | 0.081 | 0.081 | 0.081 | 0.081 | 0.081 | 0.081 | 0.081 | 1000
Poussée (en N) | 0 | 310 | 260 | 220 | 190 | 167 | 0 | 0 | 0 | 0 | 0 | 0 | 0 | 0 | 0 | 0 | 0 | 0 | 0 | 0 | 0 | 0 | 0 | 0
I_total_i (en N.s) | 0.2 | 5.4 | 4.8 | 4.1 | 3.6 | 0.1 | 0 | 0 | 0 | 0 | 0 | 0 | 0 | 0 | 0 | 0 | 0 | 0 | 0 | 0 | 0 | 0 | 0
H2O 2.0L 800g 6bar | 56 | I_total | 22.6 N.s | ISP | 2.9 s | MpropuPlein | 0.9 kg | M_éjecté | 0.8 kg | M_burnout | 0.1 kg | XpropuPlein | 120 mm | XpropuVide | 150 mm | Longueur | 300 mm | Diamètre | 98 mm | Type | H2O
Temps (en s) | 0 | 0.001 | 0.02 | 0.04 | 0.06 | 0.08 | 0.1 | 0.117 | 0.118 | 0.118 | 0.118 | 0.118 | 0.118 | 0.118 | 0.118 | 0.118 | 0.118 | 0.118 | 0.118 | 0.118 | 0.118 | 0.118 | 0.118 | 1000
Poussée (en N) | 0 | 310 | 250 | 210 | 180 | 156 | 140 | 125 | 0 | 0 | 0 | 0 | 0 | 0 | 0 | 0 | 0 | 0 | 0 | 0 | 0 | 0 | 0 | 0
I_total_i (en N.s) | 0.2 | 5.3 | 4.6 | 3.9 | 3.4 | 3 | 2.3 | 0.1 | 0 | 0 | 0 | 0 | 0 | 0 | 0 | 0 | 0 | 0 | 0 | 0 | 0 | 0 | 0
H2O 2.0L 1000g 6bar | 61 | I_total | 25.9 N.s | ISP | 2.6 s | MpropuPlein | 1.1 kg | M_éjecté | 1 kg | M_burnout | 0.1 kg | XpropuPlein | 150 mm | XpropuVide | 150 mm | Longueur | 300 mm | Diamètre | 98 mm | Type | H2O
Temps (en s) | 0 | 0.001 | 0.02 | 0.04 | 0.06 | 0.08 | 0.1 | 0.12 | 0.14 | 0.164 | 0.165 | 0.165 | 0.165 | 0.165 | 0.165 | 0.165 | 0.165 | 0.165 | 0.165 | 0.165 | 0.165 | 0.165 | 0.165 | 1000
Poussée (en N) | 0 | 310 | 245 | 200 | 165 | 143 | 124 | 108 | 97 | 85 | 0 | 0 | 0 | 0 | 0 | 0 | 0 | 0 | 0 | 0 | 0 | 0 | 0 | 0
I_total_i (en N.s) | 0.2 | 5.3 | 4.5 | 3.6 | 3.1 | 2.7 | 2.3 | 2.1 | 2.2 | 0.0425 | 0 | 0 | 0 | 0 | 0 | 0 | 0 | 0 | 0 | 0 | 0 | 0 | 0
µ-propu
µ-propu A8-3 | 67 | I_total | 2.6 N.s | ISP | 54.02650357 s | MpropuPlein | 0.015 kg | M_éjecté | 0.005 kg | M_burnout | 0.01 kg | XpropuPlein | 30 mm | XpropuVide | 30 mm | Longueur | 70 mm | Diamètre | 15 mm | Type | Micro | Combustion | 0.32 s | Dépotage | 3
Temps (en s) | 0 | 0.2 | 0.3 | 0.4 | 0.5 | 0.55 | 0.6 | 0.6 | 0.6 | 0.6 | 0.6 | 0.6 | 0.6 | 0.6 | 0.6 | 0.6 | 0.6 | 0.6 | 0.6 | 0.6 | 0.6 | 0.6 | 0.6 | 1000
Poussée (en N) | 0 | 9 | 4.5 | 4 | 4 | 3 | 0 | 0 | 0 | 0 | 0 | 0 | 0 | 0 | 0 | 0 | 0 | 0 | 0 | 0 | 0 | 0 | 0 | 0
I_total_i (en N.s) | 0.9 | 0.7 | 0.4 | 0.4 | 0.2 | 0.1 | 0 | 0 | 0 | 0 | 0 | 0 | 0 | 0 | 0 | 0 | 0 | 0 | 0 | 0 | 0 | 0 | 0
µ-propu B4-4 | 72 | I_total | 5.2 N.s | ISP | 89.19469929 s | MpropuPlein | 0.02 kg | M_éjecté | 0.006 kg | M_burnout | 0.014 kg | XpropuPlein | 30 mm | XpropuVide | 30 mm | Longueur | 70 mm | Diamètre | 15 mm | Type | Micro | Combustion | 1.20 s | Dépotage | 4
Temps (en s) | 0 | 0.2 | 0.3 | 0.55 | 1.05 | 1.15 | 1.15 | 1.15 | 1.15 | 1.15 | 1.15 | 1.15 | 1.15 | 1.15 | 1.15 | 1.15 | 1.15 | 1.15 | 1.15 | 1.15 | 1.15 | 1.15 | 1.15 | 1000
Poussée (en N) | 0 | 10 | 6 | 4 | 4 | 0 | 0 | 0 | 0 | 0 | 0 | 0 | 0 | 0 | 0 | 0 | 0 | 0 | 0 | 0 | 0 | 0 | 0 | 0
I_total_i (en N.s) | 1 | 0.8 | 1.3 | 2 | 0.2 | 0 | 0 | 0 | 0 | 0 | 0 | 0 | 0 | 0 | 0 | 0 | 0 | 0 | 0 | 0 | 0 | 0 | 0
µ-propu C6-3 | 77 | I_total | 10.3 N.s | ISP | 80.45165843 s | MpropuPlein | 0.024 kg | M_éjecté | 0.013 kg | M_burnout | 0.011 kg | XpropuPlein | 30 mm | XpropuVide | 30 mm | Longueur | 70 mm | Diamètre | 15 mm | Type | Micro | Combustion | 1.70 s | Dépotage | 3
Temps (en s) | 0 | 0.2 | 0.3 | 0.6 | 0.8 | 2 | 2.1 | 2.1 | 2.1 | 2.1 | 2.1 | 2.1 | 2.1 | 2.1 | 2.1 | 2.1 | 2.1 | 2.1 | 2.1 | 2.1 | 2.1 | 2.1 | 2.1 | 1000
Poussée (en N) | 0 | 11 | 7 | 4 | 4.6 | 4.6 | 0 | 0 | 0 | 0 | 0 | 0 | 0 | 0 | 0 | 0 | 0 | 0 | 0 | 0 | 0 | 0 | 0 | 0
I_total_i (en N.s) | 1.1 | 0.9 | 1.6 | 0.9 | 5.5 | 0.2 | 0 | 0 | 0 | 0 | 0 | 0 | 0 | 0 | 0 | 0 | 0 | 0 | 0 | 0 | 0 | 0 | 0
µ-propu C6-3 x2 | 82 | I_total | 20.5 N.s | ISP | 80.45165843 s | MpropuPlein | 0.048 kg | M_éjecté | 0.026 kg | M_burnout | 0.022 kg | XpropuPlein | 30 mm | XpropuVide | 30 mm | Longueur | 70 mm | Diamètre | 30 mm | Type | Micro | Combustion | 1.70 s | Dépotage | 3
Temps (en s) | 0 | 0.2 | 0.3 | 0.6 | 0.8 | 2 | 2.1 | 2.1 | 2.1 | 2.1 | 2.1 | 2.1 | 2.1 | 2.1 | 2.1 | 2.1 | 2.1 | 2.1 | 2.1 | 2.1 | 2.1 | 2.1 | 2.1 | 1000
Poussée (en N) | 0 | 22 | 14 | 8 | 9.2 | 9.2 | 0 | 0 | 0 | 0 | 0 | 0 | 0 | 0 | 0 | 0 | 0 | 0 | 0 | 0 | 0 | 0 | 0 | 0
I_total_i (en N.s) | 2.2 | 1.8 | 3.3 | 1.7 | 11 | 0.5 | 0 | 0 | 0 | 0 | 0 | 0 | 0 | 0 | 0 | 0 | 0 | 0 | 0 | 0 | 0 | 0 | 0
µ-propu C6-3 x3 | 87 | I_total | 30.8 N.s | ISP | 80.45165843 s | MpropuPlein | 0.072 kg | M_éjecté | 0.039 kg | M_burnout | 0.033 kg | XpropuPlein | 30 mm | XpropuVide | 30 mm | Longueur | 70 mm | Diamètre | 40 mm | Type | Micro | Combustion | 1.70 s | Dépotage | 3
Temps (en s) | 0 | 0.2 | 0.3 | 0.6 | 0.8 | 2 | 2.1 | 2.1 | 2.1 | 2.1 | 2.1 | 2.1 | 2.1 | 2.1 | 2.1 | 2.1 | 2.1 | 2.1 | 2.1 | 2.1 | 2.1 | 2.1 | 2.1 | 1000
Poussée (en N) | 0 | 33 | 21 | 12 | 13.8 | 13.8 | 0 | 0 | 0 | 0 | 0 | 0 | 0 | 0 | 0 | 0 | 0 | 0 | 0 | 0 | 0 | 0 | 0 | 0
I_total_i (en N.s) | 3.3 | 2.7 | 5 | 2.6 | 16.6 | 0.7 | 0 | 0 | 0 | 0 | 0 | 0 | 0 | 0 | 0 | 0 | 0 | 0 | 0 | 0 | 0 | 0 | 0
Klima D9-7 | 92 | I_total | 20.0 N.s | ISP | 118.3058874 s | MpropuPlein | 0.0282 kg | M_éjecté | 0.0172 kg | M_burnout | 0.011 kg | XpropuPlein | 30 mm | XpropuVide | 30 mm | Longueur | 70 mm | Diamètre | 18 mm | Type | MiniN | Combustion | 2.10 s | Dépotage | 7
Temps (en s) | 0 | 0.04 | 0.116 | 0.213 | 0.286 | 0.329 | 0.369 | 0.42 | 0.495 | 0.597 | 1.711 | 1.826 | 1.917 | 1.975 | 2.206 | 2.242 | 2.5 | 2.5 | 2.5 | 2.5 | 2.5 | 2.5 | 2.5 | 1000
Poussée (en N) | 0 | 2.111 | 9.685 | 25 | 15.738 | 12.472 | 10.67 | 9.713 | 9.178 | 8.896 | 8.925 | 8.699 | 8.052 | 6.954 | 1.07 | 0 | 0 | 0 | 0 | 0 | 0 | 0 | 0 | 0
I_total_i (en N.s) | 0.04222 | 0.4 | 1.7 | 1.5 | 0.6 | 0.5 | 0.5 | 0.7 | 0.9 | 9.9 | 1 | 0.8 | 0.4 | 0.9 | 0.01926 | 0 | 0 | 0 | 0 | 0 | 0 | 0 | 0
Klima D9-7 x2 | 97 | I_total | 39.9 N.s | ISP | 118.3058874 s | MpropuPlein | 0.0564 kg | M_éjecté | 0.0344 kg | M_burnout | 0.022 kg | XpropuPlein | 30 mm | XpropuVide | 30 mm | Longueur | 70 mm | Diamètre | 30 mm | Type | MiniN | Combustion | 2.10 s | Dépotage | 7
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
Temps (en s) | 0 | 0.01 | 0.023 | 0.04 | 0.118 | 0.283 | 0.51 | 0.688 | 0.787 | 0.852 | 0.873 | 0.873 | 0.873 | 0.873 | 0.873 | 0.873 | 0.873 | 0.873 | 0.873 | 0.873 | 0.873 | 0.873 | 2 | 1000
Poussée (en N) | 0 | 76.07 | 100.19 | 92.42 | 100.88 | 102.40 | 96.44 | 87.44 | 25.91 | 7.21 | 0 | 0 | 0 | 0 | 0 | 0 | 0 | 0 | 0 | 0 | 0 | 0 | 0 | 0
I_total_i (en N.s) | 0.4 | 1.1 | 1.6 | 7.5 | 16.8 | 22.6 | 16.4 | 5.6 | 1.1 | 0.1 | 0 | 0 | 0 | 0 | 0 | 0 | 0 | 0 | 0 | 0 | 0 | 0 | 0
p24-3G 75F51 | 188 | I_total | 75.3 N.s | ISP | 232.4603342 s | MpropuPlein | 0.095 kg | M_éjecté | 0.033 kg | M_burnout | 0.062 kg | XpropuPlein | 66.5 mm | XpropuVide | 66.5 mm | Longueur | 133 mm | Diamètre | 24 mm | Type | MiniRN | Combustion | 1.50 s | Dépotage | 12
Temps (en s) | 0 | 0.02 | 0.031 | 0.062 | 0.117 | 1.211 | 1.376 | 1.456 | 1.532 | 1.577 | 2 | 2 | 2 | 2 | 2 | 2 | 2 | 2 | 2 | 2 | 2 | 2 | 2 | 1000
Poussée (en N) | 0 | 75.924 | 84.148 | 70.441 | 73.659 | 38.737 | 14.779 | 7.271 | 3.337 | 0 | 0 | 0 | 0 | 0 | 0 | 0 | 0 | 0 | 0 | 0 | 0 | 0 | 0 | 0
I_total_i (en N.s) | 0.8 | 0.9 | 2.4 | 4 | 61.5 | 4.4 | 0.9 | 0.4 | 0.1 | 0 | 0 | 0 | 0 | 0 | 0 | 0 | 0 | 0 | 0 | 0 | 0 | 0 | 0
MINIF PRO24-6G
p24-6G 140G145 PK | 193 | I_total | 141.0 N.s | ISP | 186.2459265 s | MpropuPlein | 0.1619 kg | M_éjecté | 0.0772 kg | M_burnout | 0.0847 kg | XpropuPlein | 114 mm | XpropuVide | 114 mm | Longueur | 228 mm | Diamètre | 24 mm | Type | Mini | Combustion | 0.96 s | Dépotage | 15
Temps (en s) | 0 | 0.02 | 0.03 | 0.05 | 0.6 | 0.67 | 0.7 | 0.8 | 0.9 | 1.05 | 1.05 | 1.05 | 1.05 | 1.05 | 1.05 | 1.05 | 1.05 | 1.05 | 1.05 | 1.05 | 1.05 | 1.05 | 2 | 1000
Poussée (en N) | 0 | 350 | 250 | 210 | 150 | 140 | 130 | 65 | 30 | 0 | 0 | 0 | 0 | 0 | 0 | 0 | 0 | 0 | 0 | 0 | 0 | 0 | 0 | 0
I_total_i (en N.s) | 3.5 | 3 | 4.6 | 99 | 10.2 | 4 | 9.8 | 4.7 | 2.3 | 0 | 0 | 0 | 0 | 0 | 0 | 0 | 0 | 0 | 0 | 0 | 0 | 0 | 0
143G150 BS
Pandora (Pro24-6G BS) | 198 | I_total | 142.4 N.s | ISP | 192.061874 s | MpropuPlein | 0.1599 kg | M_éjecté | 0.0756 kg | M_burnout | 0.0843 kg | XpropuPlein | 114 mm | XpropuVide | 114 mm | Longueur | 228 mm | Diamètre | 24 mm | Type | MiniN | Combustion | 0.97 s | Dépotage | 13
Temps (en s) | 0 | 0.02 | 0.04 | 0.62 | 0.66 | 0.68 | 0.8 | 0.84 | 0.88 | 0.92 | 0.96 | 1 | 1.08 | 2 | 2 | 2 | 2 | 2 | 2 | 2 | 2 | 2 | 2 | 1000
Poussée (en N) | 0 | 250 | 210 | 160 | 150 | 142 | 62 | 48 | 34 | 24 | 15 | 10 | 0 | 0 | 0 | 0 | 0 | 0 | 0 | 0 | 0 | 0 | 0 | 0
I_total_i (en N.s) | 2.5 | 4.6 | 107.3 | 6.2 | 2.9 | 12.2 | 2.2 | 1.6 | 1.2 | 0.8 | 0.5 | 0.4 | 0 | 0 | 0 | 0 | 0 | 0 | 0 | 0 | 0 | 0 | 0
p24-6G 142G117 WT | 203 | I_total | 143.1 N.s | ISP | 168.2350472 s | MpropuPlein | 0.1725 kg | M_éjecté | 0.0867 kg | M_burnout | 0.0858 kg | XpropuPlein | 114 mm | XpropuVide | 114 mm | Longueur | 228 mm | Diamètre | 24 mm | Type | Mini | Combustion | 0.97 s | Dépotage | 11
Temps (en s) | 0 | 0.008 | 0.013 | 0.022 | 0.035 | 0.063 | 0.103 | 0.196 | 0.311 | 0.474 | 0.564 | 0.762 | 0.858 | 0.928 | 1.038 | 1.08 | 1.131 | 1.185 | 1.224 | 1.258 | 1.4 | 1.441 | 2 | 1000
Poussée (en N) | 0 | 168.643 | 177.339 | 177.866 | 171.278 | 157.839 | 154.941 | 148.88 | 144.137 | 138.076 | 135.705 | 125.955 | 116.733 | 101.713 | 57.444 | 42.688 | 31.884 | 17.655 | 9.486 | 5.27 | 0.791 | 0 | 0 | 0
I_total_i (en N.s) | 0.7 | 0.9 | 1.6 | 2.3 | 4.6 | 6.3 | 14.1 | 16.8 | 23 | 12.3 | 25.9 | 11.6 | 7.6 | 8.8 | 2.1 | 1.9 | 1.3 | 0.5 | 0.3 | 0.4 | 0.0162155 | 0 | 0
p24-6G 139G107 DT | 208 | I_total | 139.4 N.s | ISP | 158.6202775 s | MpropuPlein | 0.1945 kg | M_éjecté | 0.0896 kg | M_burnout | 0.1049 kg | XpropuPlein | 114 mm | XpropuVide | 144 mm | Longueur | 228 mm | Diamètre | 24 mm | Type | Mini | Combustion | 1.30 s | Dépotage | 12
Temps (en s) | 0 | 0.011 | 0.022 | 0.046 | 0.081 | 0.219 | 0.253 | 0.274 | 0.305 | 0.412 | 0.789 | 0.899 | 0.953 | 0.999 | 1.03 | 1.057 | 1.102 | 1.154 | 1.197 | 1.277 | 1.335 | 1.451 | 2 | 1000
Poussée (en N) | 0 | 198.418 | 221.835 | 212.658 | 218.354 | 204.43 | 195.886 | 183.544 | 88.291 | 93.671 | 93.987 | 91.139 | 89.873 | 87.025 | 81.329 | 69.937 | 54.114 | 42.405 | 31.646 | 17.089 | 9.81 | 0 | 0 | 0
I_total_i (en N.s) | 1.1 | 2.3 | 5.2 | 7.5 | 29.2 | 6.8 | 4 | 4.2 | 9.7 | 35.4 | 10.2 | 4.9 | 4.1 | 2.6 | 2 | 2.8 | 2.5 | 1.6 | 1.9 | 0.8 | 0.6 | 0 | 0
MINIF PRO29-2G
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
Temps (en s) | 0 | 0.017 | 0.052 | 0.088 | 0.108 | 0.127 | 0.174 | 0.257 | 0.403 | 0.762 | 0.977 | 1.341 | 1.501 | 1.661 | 1.96 | 2.404 | 2.641 | 2.716 | 2.821 | 2.892 | 2.92 | 2.97 | 3 | 1000
Poussée (en N) | 0 | 329.847 | 1003.68 | 2346.62 | 2549.24 | 2605.79 | 2520.97 | 2516.26 | 2596.37 | 2808.41 | 2954.49 | 2959.2 | 2907.36 | 2869.67 | 2695.32 | 2351.34 | 2228.82 | 2007.35 | 1427.77 | 504.194 | 334.559 | 122.515 | 0 | 0
I_total_i (en N.s) | 2.8 | 23.3 | 60.3 | 49 | 49 | 120.5 | 209 | 373.2 | 970.2 | 619.5 | 1076.3 | 469.3 | 462.2 | 832 | 1120.4 | 542.7 | 158.9 | 180.3 | 68.6 | 11.7 | 11.4 | 1.8 | 0
Blastocerus (Pro98-6GXL RL) | 304 | I_total | 17735.0 N.s | ISP | 192.7342031 s | MpropuPlein | 14.748 kg | M_éjecté | 9.38 kg | M_burnout | 5.368 kg | XpropuPlein | 500 mm | XpropuVide | 500 mm | Longueur | 1046 mm | Diamètre | 98 mm | Type | Fusex
Temps (en s) | 0 | 0.003 | 0.05 | 0.078 | 0.121 | 0.652 | 1.123 | 1.655 | 2.353 | 3.035 | 3.7 | 3.733 | 3.887 | 4.036 | 4.197 | 4.262 | 4.3 | 5 | 5 | 5 | 5 | 5 | 5 | 1000
Poussée (en N) | 0 | 203.877 | 2362.879 | 3946.845 | 4281.412 | 4370.281 | 4453.923 | 4772.807 | 4621.206 | 4511.427 | 4375.509 | 4182.087 | 2969.282 | 1589.193 | 533.216 | 240.47 | 0 | 0 | 0 | 0 | 0 | 0 | 0 | 0
I_total_i (en N.s) | 0.3 | 60.3 | 88.3 | 176.9 | 2297 | 2078.1 | 2454.3 | 3278.5 | 3114.2 | 2954.9 | 141.2 | 550.7 | 339.6 | 170.9 | 25.1 | 4.6 | 0 | 0 | 0 | 0 | 0 | 0 | 0
Aucun (2e ét. inerte) | 309 | I_total | 0.001 N.s | ISP | 1.019367992 s | MpropuPlein | 0.0001 kg | M_éjecté | 0.0001 kg | M_burnout | 0 kg | XpropuPlein | 0 mm | XpropuVide | 0 mm | Longueur | 0 mm | Diamètre | 0 mm | Type | Fusex
Temps (en s) | 0 | 0.1 | 0.2 | 1 | 1 | 1 | 1 | 1 | 1 | 1 | 1 | 1 | 1 | 1 | 1 | 1 | 1 | 1 | 1 | 1 | 1 | 1 | 1 | 1000
Poussée (en N) | 0 | 0.01 | 0 | 0 | 0 | 0 | 0 | 0 | 0 | 0 | 0 | 0 | 0 | 0 | 0 | 0 | 0 | 0 | 0 | 0 | 0 | 0 | 0 | 0
I_total_i (en N.s) | 0.0005 | 0.0005 | 0 | 0 | 0 | 0 | 0 | 0 | 0 | 0 | 0 | 0 | 0 | 0 | 0 | 0 | 0 | 0 | 0 | 0 | 0 | 0 | 0
Liste des propu affichés : |  | H2O |  |  | µ-propu |  |  | Rocketry Challenge |  |  | Minif |  |  | Minif Test |  |  | Fusex
Pro54-5G WT |  | H2O 1.5L 300g 6bar |  |  | µ-propu A8-3 |  |  | p29-1G 56F31 |  |  | p29-1G 57F59 |  |  | p24-1G 24E22 |  |  | Pro54-5G WT
Barasinga (Pro54-5G C) |  | H2O 1.5L 450g 6bar |  |  | µ-propu B4-4 |  |  | p29-1G 56F120 |  |  | p24-3G 74F85 |  |  | p24-1G 25E75 (Rufina) |  |  | Barasinga (Pro54-5G C)
Orignal (Pro75-3G C) |  | H2O 1.5L 600g 6bar |  |  | µ-propu C6-3 |  |  | p29-1G 57F59 |  |  | p24-3G 75F51 |  |  | p24-1G 26E31 |  |  | Orignal (Pro75-3G C)
Pro98-6G Green |  | H2O 1.5L 750g 6bar |  |  | µ-propu C6-3 x2 |  |  | p24-3G 74F85 |  |  | p29-2G 116G126 |  |  | p24-2G 50E51 |  |  | Pro98-6G Green
 |  | H2O 2.0L 400g 6bar |  |  | µ-propu C6-3 x3 |  |  | p24-3G 75F51 |  |  | Pandora (Pro24-6G BS) |  |  | p24-1G 53E70
 |  | H2O 2.0L 600g 6bar |  |  |  |  |  |  |  |  | Klima D9-7 |  |  | p29-1G 41F36
 |  | H2O 2.0L 800g 6bar |  |  |  |  |  |  |  |  | Klima D9-7 x2 |  |  | p29-1G 51F36
 |  | H2O 2.0L 1000g 6bar |  |  |  |  |  |  |  |  | Klima D9-7 x3 |  |  | p29-1G 55F29
 |  |  |  |  |  |  |  |  |  |  |  |  |  | p29-1G 56F120
 |  |  |  |  |  |  |  |  |  |  |  |  |  | p29-1G 57F59
 |  |  |  |  |  |  |  |  |  |  |  |  |  | p24-3G 60F50
 |  |  |  |  |  |  |  |  |  |  |  |  |  | p24-3G 68F79
 |  |  |  |  |  |  |  |  |  |  |  |  |  | p24-3G 68F240
 |  |  |  |  |  |  |  |  |  |  |  |  |  | p24-3G 73F30
 |  |  |  |  |  |  |  |  |  |  |  |  |  | p24-3G 74F85
 |  |  |  |  |  |  |  |  |  |  |  |  |  | p24-3G 75F51
 |  |  |  |  |  |  |  |  |  |  |  |  |  | p29-2G 84G88
Isard |  |  |  |  |  |  |  |  |  |  |  |  |  | p29-2G 93G80 |  |  | Isard
Chamois |  |  |  |  |  |  |  |  |  |  |  |  |  | p29-2G 110G250 |  |  | Chamois
Pro54-5G WT |  |  |  |  |  |  |  |  |  |  |  |  |  | p29-2G 116G126 |  |  | Pro54-5G WT
Pro98-6G Green |  |  |  |  |  |  |  |  |  |  |  |  |  | p29-3G 125G131 |  |  | Pro98-6G Green
Pro98-3G WT |  |  |  |  |  |  |  |  |  |  |  |  |  | p38-1G 128G185 |  |  | Pro98-3G WT
Aucun (2e ét. inerte) |  |  |  |  |  |  |  |  |  |  |  |  |  | p38-1G 137G58 |  |  | Aucun (2e ét. inerte)
 |  |  |  |  |  |  |  |  |  |  |  |  |  | p38-1G 141G78
 |  |  |  |  |  |  |  |  |  |  |  |  |  | p24-6G 140G145 PK
 |  |  |  |  |  |  |  |  |  |  |  |  |  | Pandora (Pro24-6G BS)
 |  |  |  |  |  |  |  |  |  |  |  |  |  | p24-6G 142G117 WT
 |  |  |  |  |  |  |  |  |  |  |  |  |  | p24-6G 139G107 DT
 |  |  |  |  |  |  |  |  |  |  |  |  |  | Cariacou
 |  |  |  |  |  |  |  |  |  |  |  |  |  | Wapiti

Sheet: Calculs
 |  | Dynamique de la fusée (repère sol) |  |  |  |  |  |  |  |  |  |  | Forces |  |  |  |  |  |  |  |  |  |  | Sous-échantillon 1Hz |  |  | Accélération longitudinale
pas | t | acc_x | acc_z | acc_xz | vit_x | vit_z | vit_xz | pos_x | pos_z | pos_xz | Beta | BetaD | i_P | Poussée | Débit | m | Poids | R_rampe | Rho | Trainée | Événements |  |  | Temps | x | z | gravitationnelle | non-gravit.
s | s | m/s² | m/s² | m/s² | m/s | m/s | m/s | m | m | m | rad | ° | - | N | kg/s | kg | N | N | kg/m3 | N |  |  |  | s | m | m | m/s² | m/s²
- | 0.00 | - | - | - | 0.00 | 0.00 | 0.00 | 0.00 | 0.00 | 0.00 | 1.40 | 80.00 | - | - | - | 10.11 | 99.14 | 17.22 | 1.23 | 0.00 | - | - | - | 0 | 0 | 0 | - | -
0.01 | 0.01 | 0.00 | 0.00 | 0.00 | 0.00 | 0.00 | 0.00 | 0.00 | 0.00 | 0.00 | 1.40 | 80.00 | 1 | 89.30 | 0.04 | 10.11 | 99.14 | 17.21 | 1.23 | 0.00 |  |  |  | #N/A | #N/A | 0 | 0.00 | 9.66
0.01 | 0.02 | 2.93 | 16.60 | 16.85 | 0.03 | 0.17 | 0.17 | 0.0001463112491 | 0.0008298375931 | 0.0008426371773 | 1.40 | 80.00 | 1 | 267.90 | 0.13 | 10.10 | 99.12 | 17.21 | 1.22 | 0.0001119796686 |  |  |  | #N/A | #N/A | 0.0008298375931 | 16.85 | 26.51
0.01 | 0.03 | 6.00 | 34.01 | 34.54 | 0.09 | 0.51 | 0.51 | 0.0007387911267 | 0.004190197284 | 0.004254828505 | 1.40 | 80.00 | 1 | 446.50 | 0.22 | 10.10 | 99.10 | 17.21 | 1.22 | 0.001041293957 |  |  |  | #N/A | #N/A | 0.004190197284 | 34.54 | 44.20
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
0.01 | 2.25 | 11.59 | 40.34 | 41.97 | 30.60 | 132.31 | 135.80 | 34.78 | 162.15 | 165.84 | 1.34 | 76.98 | 6 | 550.23 | 0.28 | 9.31 | 91.31 | 0.00 | 1.21 | 71.54 |  |  |  | #N/A | #N/A | 162.1507379 | 41.91 | 51.47

Sheet: Abaco
 | ABACO
 | Abaques de performance
 | Calcul analytique simple
 | Fusée
Nom | SP02
Club | L'AéroIPSA
Matricule | FX5
Masse sans propu | 8.421 kg ±100%
Masse totale | 10,106 kg ±8,421 kg
Propulseur | Barasinga (Pro54-5G C)
 | Traînée Aérdynamique
Diamètre Ø | 93.56632653 mm ±50%
Cx | 0.7
Diamètre | 1/2.ρ.S.Cx | Masse totale | M ph prop | M ph bal | Accélération | Traînée prop | Traînée bal | Alt prop | V max | alt_culmi | t_culmi
D_var | Q_var | m_var | m_prop | m_bal | a_prop | b_prop | b_bal | alt_prop | V_prop
Ø =54 mm | 0.0009819322728 | 1.685 kg | 1.1685 kg | 0.652 kg | 480.8721712 m/s² | 0.0008403357063 kg | 0.001506031093 | 1903.194536 | 740.8649338 m/s | 3379.17816 m | 15.62042534 s
Ø =54 mm | 0.0009819322728 | 3.79025 kg | 3.27375 kg | 2.75725 kg | 165.3292492 m/s² | 0.0002999411295 | 0.0003561273997 | 968.1351061 | 492.7708958 m/s | 4174.741001 m | 24.66912317 s
Ø =54 mm | 0.0009819322728 | 5.8955 kg | 5.379 kg | 4.8625 kg | 96.78269697 m/s² | 0.0001825492234 | 0.000201939799 | 601.348606 | 323.2774947 m/s | 3443.33319 m | 25.43737299 s
Ø =54 mm | 0.0009819322728 | 8.00075 kg | 7.48425 kg | 6.96775 kg | 66.7991615 m/s² | 0.0001311998227 | 0.000140925302 | 422.5896587 | 231.1701381 m/s | 2443.770915 m | 22.94082301 s
Ø =54 mm | 0.0009819322728 | 10.106 kg | 9.5895 kg | 9.073 kg | 49.98061651 m/s² | 0.000102396608 | 0.0001082257547 | 318.5979792 | 175.5867563 m/s | 1671.172212 m | 19.79382979 s
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
Textes pour les graphiques :
Masse totale
Vitesse max
Vitesse max / Masse totale
Altitude max
Altitude max / Masse totale
Temps de culmination
Temps de culmination / Masse totale

Sheet: Controle
 | Données au format des fiches de contrôles minif : |  |  |  |  |  |  |  |  |  |  | l = | 252
 | Matriucle | FX5
 | Propulseur | Barasinga (Pro54-5G C) |  | Masse sans prop. (kg) | 8.421
 | Couleur de la fusée | Brun/Orange… |  | Diamètre max (mm) | 93.56632653
 | Couleur du ralentisseur | Rouge… |  | Cx | 0.7
 | Surface ralentisseur (m²) | 0.5780530483 |  | Longeur de la rampe (m) | 4
 | Type d'éjection du para. |  |  | Type d'ogive | Conique (droite)
 | Masse sans propu (kg) | 8.421 | VL4 | 10 < finesse < 20 | 23.8 |  |  |  |  |  |  |  |  |  | 1182
 |  |  | VL4 | 15 < Cn < 30 | 24.6 |  |  |  |  |  |  | D = | 84
 | Cx | 0.7 | VL4 | 1,5.D < Ms < 6.D | 30.6 |  |  |  |  |  |  |  |  |  | 2252
 | Longueur rampe | 4 | VL4 | 30 < Ms x Cn < 100 | 2.5 | 3.3
 | Epaisseur ailerons | 4 | VL4 | Vsortie de rampe (> 18 m/s) | 75.9 | 99.9
 | Nombre ailerons | 4 | RC1 | 5 < Vc < 15 m/s | 15.0 | 12.7 |  |  |  |  |  |  |  |  | 60
 | Type d'ogive | Conique (droite) | RC2 | Temps de retard ralentisseur | 16.2 |  |  |  |  |  |  | Dj = | 104
 | Haut du propu "Prop" | 1814 | RC2 | Indication dépotage lanceur | 16.2
 |  |  | RC5 | Portée balistique < 200 m | 839.6394906 m
 |  |  |  |  |  |  |  |  |  |  |  |  |  |  | 50
(mm) | Fusée |  | Ailerons | Bi empennage |  |  | Transition A | Transition B
X cg (sans) | 1297 | m | 210 | 170 |  | L | 60 | 50
L tot | 2302 | n | 80 | 80 |  | D 1 | 84 | 104
X prop | 2302 | p | 185 | 120 |  | D 2 | 104 | 84
D | 93.56632653 | E | 145 | 105 |  | X | 1182 | 2252
L ogive | 252 | X ail | 2252 | 1182
Inclinaison | Portée balistique (m) | Temps de vol avec parachute (s) |  |  | Culmination |  |  |  | Accélération max (m/s²) | Vmax (m/s) | n = | 80 |  |  | ailrons haut
 |  |  |  |  | Altitude (m) |  | Temps (s) | Vitesse (m/s) |  |  |  |  |  | p = | 120
80° | 839.6394906 | 96.6 |  |  | 1202.82154 |  | 15.8 | 26.8 | 78.73391106 | 163.8 | ep = | 4 |  | m = | 170
 |  |  |  |  |  |  |  |  |  |  | nombre | 4 |  | n = | 80
 |  |  |  |  |  |  |  |  |  |  |  |  |  | E = | 105
 |  |  |  |  |  |  |  |  |  |  |  | E = | 145 | ep = | 3
 |  |  |  |  |  |  |  |  |  |  |  |  |  | nombre | 4
 | Donneés au format des fiches de contrôles Fusex : |  |  |  | Matricule | FX5
 | Diamètre "D" | 93.56632653 |  |  | sans | vide | plein
 | Longueur ogive "l" | 252 |  | Masse | 8.421 | 9.073 | 10.106
 | Position ailerons "L" | 2042 |  | CdG | 1297 | 1351.399206 | 1424.88393
 | Emplanture 'm' | 210
 | Saumon 'n' | 80 | STAB 1 | Vsortie de rampe (> 20 m/s) | 23.8
 | Flèche 'p' | 185 | STAB 2 | 10 < finesse < 35 | 24.6
 | Envergure 'E' | 145 | STAB 3 | 15 < Portance < 40 | 30.6
 | Epaisseur ailerons | 4 | STAB 4 | 2*D < Ms < 6*D | 2.5 | 3.3
 | Nombre ailerons | 4 | STAB 5 | 40 < Ms x Cn < 100 | 75.9 | 99.9
 | Haut du propu "Prop" | 1814
 | Type d'ogive | Conique (droite) |  | Cx | 0.7
 | Longueur totale | 2302 |  | Maître couple (m²) | 0.009195891891
 | Diamètre max | 104 |  | Site | 80 | 80 | 90
 | Envergure totale | 394 |  | Temps culmi (s) | 15.8
 |  |  |  | Altitude culmi (m) | 1202.82154
CR 1 | Longueur | 2302 |  | Vitesse culmi (m/s) | 26.8
 | Diamètre max (40à200) | 104 |  | Portée balistique (m) | 839.6394906
 | Envergure totale <720 | 394 |  | Temps balistique (s) | 32.9
 | Masse <15 | 10.106 |  | Vmax (m/s) | 163.8
CR 2 | Nombre ailerons | 4 |  | Accélération max (m/s²) | 78.73391106
 |  |  |  | Pensez à modifier l'inclinaison pour avoir les 2 valeurs.
 |  | N | kg
MEC 3 | Compression 2.Acc.M | 1591.36981 | 162.2191448
 | Resist long aileron | 26.48608768 | 2.7 | Masse aileron (kg) | 0.1682
 | Resist transv aileron | 58.68158299 | 6.0 | Surface aileron (m²) | 0.021025
REC 8 | Compression porte | 795.6849052 | 81.10957239 | Masse au-dessus porte | 5.053
 |  |  | SEQ 5 | T dépotage +/-2s /appogée | 16.2 | 15.8
 |  |  | REC 2 | 5 < Vc < 15 m/s | 15.0 | 12.7
 |  |  |  | Surface parachute m² | 0.6 | 0.1
 |  |  |  | Vitesse à l'ouverture m/s | 26.9 | 141.2
 |  |  |  | Masse | 8.1 | 1.0
 |  |  |  | Choc à l'ouverture N | 255.6493137 | 1221.414003
 |  |  |  | Choc à l'ouverture kg | 26.1 | 124.5
 | Donneés au format des fiches de lancement Fusex :
 |  |  |  | MECANIQUE
Projet | SP02
Club | L'AéroIPSA
Chef de projet | - | l = | 252
Date | 2026-05-05
 |  |  |  |  |  |  | 1182
Moteur | Barasinga (Pro54-5G C) | D = | 84
Virole | - |  |  |  |  |  | 2252
 |  |  |  |  |  |  | 60
 |  | Dj = | 104 |  |  |  | 2042
 |  |  |  |  |  |  | 50
 |  | Dr = | 84
 |  | m = | 210 |  |  |  | 185
 | Nb Aileron | 4
 | X_plaque de poussée | 1814 |  |  |  |  | 80
 | Type ogive | 0 | ogivale
 |  | 1 | conique
 |  | 0 | parabolique |  |  |  | Epaisseur :
 |  |  |  |  | 145 |  | 4
 |  | Sans propu | Propu plein
 | Masse fusée | 8.421 | 10.106
 | X_CdG | 1297 | 1424.88393
 | Masse avec propu vide | 9.073 |  | Simulation de vol
 |  |  |  | Site | 80 | 80 | 90
 |  |  |  | Temps culmi (s) | 15.8
 | Tenue mécanique |  |  | Altitude culmi (m) | 1202.82154
 |  |  |  | Vitesse culmi (m/s) | 26.8
masse d'un aileron |  | 0.100 KG |  | Portée balistique (m) | 839.6394906
superficie d'un aileron |  | 21025 mm² |  | Vmax (m/s) | 163.8
 |  |  |  | Accélération max (m/s²) | 78.73391106
fleche acceptable(mm) |  |  | 20.42 mm | Cx | 0.7
compression |  | 1326.0 N | 135.172 KG | Pensez à modifier l'inclinaison pour avoir les 2 valeurs.
Resistance longitudinale d'un aileron |  | 15.7 N | 1.605 KG
Resistance transversale d'un aileron |  | 58.7 N | 5.982 KG
 | Récupération
Ralentisseur
nombre de suspentes |  | 4
surface parachute |  | 0.57805 m²
force à tester totale |  | 253.8 N | 25.871 KG
force sur suspente |  | 126.9 N | 12.936 KG
Séparation latérale
masse au dessus case para |  | 1.000 KG
Force de compression |  | 16.1 kg
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
