povdoigt/SP-02/STABTRAJ/sp02_v3_38/Alpha_Beta/alpha_beta_passif.xlsx

Sheet: Stabilito
 |  | STABILITO |  |  |  |  |  |  |  | Language/Langue | Français
 |  | Stabilité de fusée à ailerons |  |  |  |  |  |  |  |  | Plusieurs diamètres.
 |  |  |  |  |  |  |  |  |  |  | Transition A |  | Transition B
 |  | Remplir les cases jaunes |  |  |  |  |  |  |  | Longueur 'L' | 60 mm |  | 50 mm
 |  | Fusée |  |  |  |  |  |  |  | Diamètre 'D1' | 84 mm |  | 104 mm
 | Nom | SP02 |  |  |  |  |  |  |  | Diamètre 'D2' | 104 mm |  | 84 mm
 | Club | L'AéroIPSA |  |  |  |  |  |  |  | Implantation 'x' | 1182 mm |  | 2252 mm
 | Matricule | FX | 0 | FX0
 | Type | Fusée expérimentale. |  |  |  |  |  |  |  |  | Propu plein | Propu vide |  | Sans propu |  |  | Propulseur
 | Masse | 7473 g | sans propu |  |  |  |  |  |  | Masse propu | 1.685 kg | 0.652 kg |  | - |  | Haut | 1814 mm
 | Centre de Masse | 1297 mm | sans propu |  |  |  |  |  |  | CdM propu | 250 mm | 240 mm |  | - |  | Longueur | 488 mm
 | Longueur totale | 2302 mm |  |  |  |  |  |  |  | Masse fusée | 9.158 kg | 8.125 kg |  | 7.473 kg |  | Bas | 2302 mm
 | Diamètre Réf. | 93.7329888 mm |  |  |  |  |  |  |  | CdM fusée | 1438.12197 mm | 1357.746338 mm |  | 1297 mm
 |  |  |  |  |  |  |  |  |  |  |  |  |  |  |  |  | Ailerons bas
 |  | Propulseur |  |  |  |  |  |  |  |  | XCp |  | Cnα |  |  | Haut | 2042 mm
 | Type | Barasinga (Pro54-5G C) |  |  |  |  |  |  |  | Coiffe | 168 mm |  | 1.6 |  |  | Emplanture | 210 mm
 | Position du bas | 2302 mm |  |  |  |  |  |  |  | Ailerons | 2161.482759 mm |  | 18.2 |  |  | Bas | 2252 mm
 |  |  |  |  |  |  |  |  |  | Ail bas entier | 2161.482759 mm |  | 18.2
 |  | Coiffe |  |  |  |  |  |  |  | Ailerons haut | 1097.4 mm |  | 10.6
 | Forme | Conique (droite) |  |  |  |  |  |  |  | Partie masquée | 2094.5 mm |  | 0.0
 | Hauteur | 252 mm |  |  |  |  |  |  |  | Transition A | 1213.06383 mm |  | 0.9
 | Diamètre | 84 mm |  |  |  |  |  |  |  | Transition B | 2276.113475 mm |  | -0.9
 |  |  |  | M
 |  | Ailerons bas | Ailerons haut |  | 2026-04-30 | Min | Résultats |  | Max
 |  | Bi-empennage |  | 210 | Finesse | 10 | 24.6 |  | 35
 | Emplanture 'm' | 210 mm | 170 mm | 210 | Portance | 15 | 30.4 | 30.4 | 40
 | Saumon 'n' | 80 mm | 80 mm | 0 | MargeStat. | 2 D | 2.32 D | 3.18 D | 6 D |  |  |  |  |  |  |  |  | OpenRocket
 | Flèche 'p' | 190 mm | 120 mm | 0 | Couple | 40 | 70.6 | 96.7 | 100 |  |  |  |  |  |  |  |  | MS | Cnalpha
 | Envergure 'E' | 145 mm | 105 mm | 4 | XCp |  | 1655.776185 mm | 1655.776185 mm |  |  |  |  |  |  |  |  |  | 2.12 | 24.961
 | Epaisseur 'ep' | 4 mm | 3 mm | 4 | MS /L |  | 9.455005021% L | 12.94656155% L |  |  |  |  |  |  |  |  |  | 2.9 | 24.961
 | Nombre | 4 | 4 | 2252 |  |  | STABLE
 | Position du bas | 2252 mm | 1182 mm | 104
 | Diamètre | 104 mm | 84 mm | 0
 | Ligne mi-corde f | 191.4418972 mm | 129.034879 mm
 | Commentaire libre : |  |  |  |  |  |  |  |  | Checksum : | propu OK | fichier initial |  |  | v3.4.5
 |  |  |  |  |  |  |  |  |  | Maintenant que votre fusée est stable, vérifiez sa trajectoire via la feuille | Trajecto
 | Textes pour les listes déroulantes et graphiques :
 | Français
 | English
 | Fusée à eau
 | Microfusée
 | Minifusée
 | Fusée expérimentale.
 | ,Minif Tests
 | sans propu
 | avec propu vide
 | avec propu plein
 | Parabolique (arrondie)
 | Ogivale (pointue)
 | Conique (droite)
 | Mono-empennage
 | Bi-empennage
 | Fusée mono-diamètre,
 | Plusieurs diamètres.
 | Diagramme des critères de stabilité
 | Marge Statique (MS)
 | Portance Cnα
 | Données pour les graphiques :
 |  | X longi | Y latéral | - Y latéral
 | Ogive | -252 | 0 | 0
 | Ogive | -252 | 42 | -42
 | chmt1 pt1 | -1182 | 42 | -42
 | chmt1 pt2 | -1242 | 52 | -52
 | chmt2 pt1 | -2252 | 52 | -52
 | chmt2 pt2 | -2302 | 42 | -42
 | culot | -2302 | 42 | -42
 | culot | -2302 | 0 | 0
 | aileron pt1 | -2042 | 52 | -52
 | aileron pt2 | -2232 | 197 | -197
 | aileron pt3 | -2312 | 197 | -197
 | aileron pt4 | -2252 | 52 | -52
 | aileron pt1 | -2042 | 52 | -52
 | Envergure | -2388.733333 | -197
 | env milieu | -2388.733333 | -124.5
 | env pt4 | -2388.733333 | -52
 | Emplanture | -2042 | 312.1
 | empl milieu | -2147 | 312.1
 | empl pt4 | -2252 | 312.1
 | Flèche | -2042 | -273.7333333
 | flèche milieu | -2137 | -273.7333333
 | flèche pt2 | -2232 | -273.7333333
 | Saumon | -2232 | -312.1
 | saumon milieu | -2272 | -312.1
 | saumon pt3 | -2312 | -312.1
 | Xcg plein | -1438.12197 | 0
 | Xcg vide | -1357.746338 | 0
 | Xcp | -1655.776185 | 0
 | Xcp | -1655.776185 | 190.0737054
 | Xcp0 | -1655.776185 | 190.0737054
 | Xcp0 | -1655.776185 | 0
 | Marge Statique | -1397.934154 | -312.1
 | MS milieu | -1526.85517 | -312.1
 | MS Xcp | -1655.776185 | -312.1
 | canard pt1 | -1012 | 52 | -52
 | canard pt2 | -1132 | 157 | -157
 | canard pt3 | -1212 | 157 | -157
 | canard pt4 | -1182 | 52 | -52
 | canard pt1 | -1012 | 52 | -52
 | masquage pt1 | -2042 | 52 | -52
 | masquage pt2 | -2042 | 52 | -52
 | masquage pt3 | -2252 | 52 | -52
 | masquage pt4 | -2252 | 52 | -52
 | masquage pt1 | -2042 | 52 | -52
 | cadre | -2335.12 | 767.3333333
 | cadre | -2335.12 | -767.3333333
 | propu pt1 | -1814 | -27
 | propu pt2 | -1814 | 27
 | propu pt3 | -2302 | 27
 | propu pt4 | -2302 | -27
 | propu pt5 | -1814 | -27 |  | conique | ogive | parabole
 | Pointe | 0 | 0 | 0 | 0 | 0 | 0
 | Ogive | -25.2 | 4.2 | -4.2 | 4.2 | 8.4 | 21
 | Ogive | -63 | 10.5 | -10.5 | 10.5 | 21 | 29.4
 | Ogive | -126 | 21 | -21 | 21 | 31.5 | 36.96
 | Ogive | -189 | 31.5 | -31.5 | 31.5 | 37.8 | 39.9
 | Ogive | -252 | 42 | -42 | 42 | 42 | 42
 | MS (X) | Cna (Y) | MS (X) | Cna (Y)
 | 0 | 15 | 0.5 | 80
 | 7 | 15 | 1 | 40
 | 0 | 40 | 2 | 20
 | 7 | 40 | 3 | 13.33333333
 | 2 | 0 | 5 | 8
 | 2 | 55 | 7 | 5.714285714
 | 6 | 0 | 1 | 100
 | 6 | 55 | 2 | 50
 | 2.32 | 30.42 | 3 | 33.33333333
 | 2.32 | 30.42 | 4 | 25
 | 3.18 | 30.42 | 6 | 16.66666667
 | 3.18 | 30.42 | 7 | 14.28571429
 | 2.32 | 30.42
 | 0 | 27.5
 | 2 | 27.5
 | 3.636363636 | 27.5
 | 7 | 27.5
 | 4 | 0
 | 4 | 15
 | 4 | 25
 | 4 | 55
 | Verification moteur | TRUE
 | H20 | FALSE
 | Fusex | TRUE
 | micro | FALSE
 | minif N | FALSE
 | Minif RC | FALSE
 | Minif Test | FALSE
module rocket(){
module aileron(diam, m, n, p, e, ep, nb, pos, masque = true){
depha = masque ? 0 : 45 ;
for (angle = [0 : 360/nb : 360] ){
translate ([-diam*sin(angle+depha), diam*cos(angle+depha), pos-m]) {
rotate( [0, 0, angle+depha] ){
polyhedron
(points = [
[+ep, 0, 0], [+ep, 0, m], [+ep, e, p+n], [+ep, e, p],
[-ep, 0, 0], [-ep, 0, m], [-ep, e, p+n], [-ep, e, p]
],
triangles = [
[0, 2, 1], [0, 2, 3], //carre +
[4, 6, 5], [4, 6, 7], //carre -
[0, 5, 1], [0, 5, 4],
[1, 6, 2], [1, 6, 5],
[2, 7, 3], [2, 7, 6],
[0, 7, 3], [0, 7, 4]
]
);
}
}
}
}
module coiffe(diam, hauteur, resolution = 20.0){
pas = hauteur/resolution;
for (x = [0: pas : hauteur] ){
translate( [0, 0, x+pas] ){
cylinder(pas, pow(x, 1.0/2.0), pow(x+pas, 1.0/2.0), false);
}
}
}
//--------------------------------coiffe
if (coiffe_type == "conique"){
cylinder(coiffe_hauteur, 0, coiffe_diametre, false);
}
//--------------------------------corps
if (plusieur_diametres == false){
translate ([0, 0, coiffe_hauteur]) {
cylinder(longeur_total-coiffe_hauteur, coiffe_diametre, coiffe_diametre, false);
}
} else {
//Premier cylindre
translate ([0, 0, coiffe_hauteur]) {
cylinder(diam_A_X_implantation-coiffe_hauteur, coiffe_diametre, coiffe_diametre, false);
}
//Premier chanvrin
translate ([0, 0, diam_A_X_implantation]) {
cylinder(diam_A_L_longeur, diam_A_D1_diametre, diam_A_D2_diametre, false);
}
//Second cylindre
translate ([0, 0, diam_A_X_implantation+diam_A_L_longeur]) {
cylinder(diam_B_X_implantation-(diam_A_X_implantation+diam_A_L_longeur), diam_A_D2_diametre, diam_B_D1_diametre, false);
}
//Second chanvrin
translate ([0, 0, diam_B_X_implantation]) {
cylinder(diam_B_L_longeur, diam_B_D1_diametre, diam_B_D2_diametre, false);
}
//Troisieme cylindre
translate ([0, 0, diam_B_X_implantation + diam_B_L_longeur]) {
cylinder(longeur_total-(diam_B_X_implantation + diam_B_L_longeur), diam_B_D2_diametre, diam_B_D2_diametre, false);
}
}
//--------------------------------ailerons
aileron(coiffe_diametre, aileron_m_emplature,
aileron_n_saumon,
aileron_p_fleche,
aileron_e_envergure,
aileron_epaisseur,
aileron_nombre,
aileron_position_bas);
if (bi_empennage == true){
aileron(coiffe_diametre, aileron_sup_m_emplature,
aileron_sup_n_saumon,
aileron_sup_p_fleche,
aileron_sup_e_envergure,
aileron_sup_epaisseur,
aileron_sup_nombre,
aileron_sup_position_bas,
aileron_sup_masque);
}
}
rocket();

Sheet: Trajecto
 |  | TRAJECTO
 |  | Trajectographie de fusée
 |  | Remplir les cases jaunes
 |  | Fusée
 | Nom | SP02
 | Club | L'AéroIPSA
 | Matricule | FX0
 | Masse totale | 9.158 kg
 | Propulseur | Barasinga (Pro54-5G C)
 |  | Traînée Aérdynamique
 | Surface Réf. | 0.009220 m²
 | Cx | 0.7
 |  | Rampe de Lancement
 | Longueur | 4 m
 | Élévation | 80 °
 | Altitude | 0 m
 |  | DescenteSousParachute |  |  |  | 2026-04-30 | Temps | Altitude z | Portée x | Vitesse | Accélération | Efforts
 |  | Fusée | 1 satellite |  | Sortie de Rampe |  |  |  |  | 25.8 m/s
 | Masse | 7.125 kg | 1 kg |  | Vit max & Acc max |  |  |  |  | 180.876954 m/s | 87.89953736 m/s²
 | Dépotage | N/A |  |  | Largage du satellite |  | 4.6 s | 567.033041 m | 131.5652091 m | 154.0636793 m/s |  | 1453.8 N
 | Ouverture para | 15.6 s | 4.6 s |  | Culmination, Apogée |  | 16.3 s | 1333.953123 m | 485.8130053 m | 26.26167172 m/s
 | Type de para | Croix |  |  | Ouverture parachute fusée |  | 15.6 s | 1331.401959 m | 467.3573609 m | 27.40684994 m/s |  | 244.4 N
 | Surface para | 0.53 m² | 0.1 m² |  | Impact balistique |  | 34.6 s | ~0 m | 869.5436472 m | 122.8 m/s |  | 53706.76673 J
 | Cx parachute | 1 | 1
 | Vitesse du vent | 5 m/s | 5 m/s
 | Vitesse descente | 14.7 m/s | 12.7 m/s
 | Durée descente | 90.8458741 s | 44.80504406 s |  |  |  | Pour localiser la fusée
 | Durée du vol | 106.4458741 s | 49.40504406 s |  | Couleur fuselage/coiffe |  | Brun/Orange…
 | Déport latéral | ±454.2293705 m | ±224.0252203 m |  | Couleur parachute fusée |  | Rouge… |  |  |  |  |  | fichier initial
 |  |  |  |  | Couleur parachute satellite |  | Jaune |  |  |  |  |  | propu OK
 | Commentaire libre : |  |  |  |  |  |  |  |  |  |  |  | v3.4.5
Calcul de la surface d'un parachute |  |  |  |  | Résultats détaillés |  | Temps | Altitude z | Portée x | Vitesse | Accélération | Angle
 |  |  |  |  |  |  | s | m | m | m/s | m/s² | °
 |  |  |  |  | Décollage |  | 0 | 0 | 0 | 0 | - | 80
 | Bord 'a' |  |  |  | Sortie de Rampe |  | 0.33 | 3.90 | 0.69 | 25.8 | 82.6 | 80.0
 | 330 mm |  |  |  | Vit max & Acc max |  | - | - | - | 180.876954 | 87.9 | -
 | Coté 'b' |  |  |  | Fin de Propulsion |  | 3.6 | 407.111973 | 91.34649161 | 176.3097324 | 24.2 | 76.3
 | 320 mm |  |  |  | Culmination, Apogée |  | 16.3 | 1333.953123 | 485.8130053 | 26.26167172 | 9.8 | 0.4
 | Surface para |  |  |  | Impact balistique |  | 34.6 | ~0 | 869.5436472 | 122.7826683 | 2.7 | -83.6
 | 0.53 m² |  |  |  | Ouverture parachute fusée |  | 15.6 | 1331.401959 | 467.3573609 | 27.40684994 | 9.9 | 15.0
 |  |  |  |  | Impact fusée sous para. |  | 106.4458741 | ~0 | 13 | 922 | 14.65561284 | 9.8 | -
 |  |  |  |  | Largage du satellite |  | 4.6 | 567.033041 | 131.5652091 | 154.0636793 | 20.9 | 75.4
 | Rayon exterieur |  |  |  | Impact du satellite |  | 49.40504406 | ~0 | -92 | 356 | 12.65556262 | 9.8 | -
 | 299 mm
 | Rayon intérieur
 | 29 mm
 | Surface para
 | 0.28 m²
 | Vitesse de descente sous parachute :
 | Textes pour les listes déroulantes et graphiques :
 |  |  |  |  | N/A | Délais dépotage |  | Rond
 | 0 satellite |  |  |  | -9.0 s | -9 |  | Croix
 | 1 satellite |  |  |  | -7.0 s | -7 |  | Autre
 | Phase ascendante |  |  |  | -5.0 s | -5
 | Descente balistique |  |  |  | -3.0 s | -3
 | Fusée sous parachute |  |  |  | 0.0 s | -0
 | Satellite sous parachute |  |  |  | autre
 | Trajectoire (x z)
 | Portée x [m]
 | Temps [s]
 | Altitude z / Temps | 15.6
 | T_para =
 | Données pour les graphiques :
 | xz max | xz max
 | 1333.953123 | 1333.953123
 | x para | z para
 | 467.3573609 | 1331.401959
 | 467.3573609 | 665.7009793
 | 467.3573609 | 0
 | 500.6424098 | 66.57009793
 | 467.3573609 | 0
 | 434.0723119 | 66.57009793
 | 467.3573609 | 0
 | t para | z para
 | 15.6 | 1331.401959
 | 61.0 | 665.7009793 |  | 1 | vertical
 | 106.4 | 0 |  | 1 | horizontal
 | 105.2 | 61.86251825 |  |  | flèches
 | 106.4 | 0 |  | 1s | 3.46
 | 101.8 | 24.85719437 |  | t/T | 0.85
 | 106.4 | 0 |  | z/Z | 1.00
 | x sat | z sat
 | 131.5652091 | 567.033041
 | 131.5652091 | 141.7582602
 | 131.5652091 | 0
 | 145.7410352 | 28.35165205
 | 131.5652091 | 0
 | 117.3893831 | 28.35165205
 | 131.5652091 | 0
 | t sat | z sat
 | 4.6 | 567.033041
 | 27.0 | 283.5165205
 | 49.4 | 0
 | 47.6 | 103.0523012
 | 49.4 | 0
 | 45.2 | 22.05127297 |  | t/T | 0.87
 | 49.4 | 0 |  | z/Z | 0.67
 | t | z | x
 | 3.9 | 665.7009793 | 116.8393402
 | 25.45 | 666.9765615 | 741.6334332
 | z_triomphe | x_triomphe | Arc de triomphe
 | #N/A | 0 | 485.8130053 |  | Arc de triomphe
 | #N/A | 23 | 508.8130053 |  | 485.8130053
 | #N/A | 23 | 508.8130053 |  | 462.8130053
 | #N/A | 0 | 485.8130053 |  | 462.8130053
 | #N/A | 23 | 508.8130053 |  | 485.8130053
 | #N/A | 23 | 508.8130053 |  | 462.8130053
 | #N/A | 8 | 493.8130053 |  | 462.8130053
 | #N/A | 8 | 493.8130053 |  | 477.8130053
 | #N/A | 23 | 508.8130053 |  | 477.8130053
 | #N/A | 8 | 493.8130053 |  | 462.8130053
 | #N/A | 7.6 | 493.4130053 |  | 477.8130053
 | #N/A | 6.8 | 492.6130053 |  | 478.2130053
 | #N/A | 6 | 491.8130053 |  | 479.0130053
 | #N/A | 5 | 490.8130053 |  | 479.8130053
 | #N/A | 3.8 | 489.6130053 |  | 480.8130053
 | #N/A | 0 | 485.8130053 |  | 482.0130053
 |  |  |  |  | 485.8130053
 | z_Eiffel | x_Eiffel | Tour Eiffel
 | 324 | 0 | 485.8130053 |  | Tour Eiffel
 | 300 | 0 | 485.8130053 |  | 485.8130053
 | 280 | 10 | 495.8130053 |  | 485.8130053
 | 280 | 0 | 485.8130053 |  | 475.8130053
 | 280 | 10 | 495.8130053 |  | 485.8130053
 | 200 | 13 | 498.8130053 |  | 475.8130053
 | 160 | 17 | 502.8130053 |  | 472.8130053
 | 115 | 20 | 505.8130053 |  | 468.8130053
 | 90 | 25 | 510.8130053 |  | 465.8130053
 | 57 | 30 | 515.8130053 |  | 460.8130053
 | 40 | 36 | 521.8130053 |  | 455.8130053
 | 20 | 48 | 533.8130053 |  | 449.8130053
 | 0.5 | 62 | 547.8130053 |  | 437.8130053
 | 0.5 | 37 | 522.8130053 |  | 423.8130053
 | 15 | 30 | 515.8130053 |  | 448.8130053
 | 30 | 15 | 500.8130053 |  | 455.8130053
 | 37 | 0 | 485.8130053 |  | 470.8130053
 | 67 | 0 | 485.8130053 |  | 485.8130053
 | 67 | 17 | 502.8130053 |  | 485.8130053
 | 100 | 11 | 496.8130053 |  | 468.8130053
 | 100 | 0 | 485.8130053 |  | 474.8130053
 |  |  |  |  | 485.8130053

Sheet: Courbes
Notes :
Ces courbes représentent la trajectoire de la fusée dans l'hypothèse d'une descente balistique (sans ouverture du parachute).
L'accélération longitudinale gravitationnelle définit le mouvement (dérivée de la vitesse) : Acc = (Poussee - Traînée ± Poids) / m
La charge ''non-gravitationnelle'' vue par un capteur d'accélération (masse-ressort) est : Charge = (Poussée - Traînée) / m
Exemples : Si Poussée = Poids, Vitesse constante, Acc nulle, Charge = 1G ; En chute libre, Acc = -1G, Charge = 0
Textes pour les graphiques :
Traînée
Poussée
Poids
Accélération longitudinale
Charge vue par un capteur
Vitesse
Vitesse [m/s]
Altitude
Portée
Temps [s]

Sheet: Propu
Moteur sélectionné | Ligne
Barasinga (Pro54-5G C) | 279 | I_total | 2058.4 N.s | ISP | 203.1206673 s | MpropuPlein | 1.685 kg | m_poudre | 1.033 kg | MpropuVide | 0.652 kg | XpropuPlein | 250 mm | XpropuVide | 240 mm | Longueur | 488 mm | Diamètre | 54 mm | Type | Fusex | Combustion | 0.0 s | Dépotage | 0
Temps (en s) | 0 | 0.05 | 0.5 | 1 | 1.5 | 2 | 2.5 | 2.97 | 3.2 | 3.47 | 3.59 | 3.59 | 3.59 | 3.59 | 3.59 | 3.59 | 3.59 | 3.59 | 3.59 | 3.59 | 3.59 | 3.59 | 3.59 | 1000
Poussée (en N) | 0 | 893 | 798 | 739 | 659 | 586 | 513 | 417 | 225 | 67 | 0 | 0 | 0 | 0 | 0 | 0 | 0 | 0 | 0 | 0 | 0 | 0 | 0 | 0
H2O
H2O 1.5L 300g 6bar | 26 | I_total | 9.8 N.s | ISP | 3.3 s | MpropuPlein | 0.3 kg | M_éjecté | 0.3 kg | M_burnout | 0 kg | XpropuPlein | 60 mm | XpropuVide | 150 mm | Longueur | 300 mm | Diamètre | 90 mm | Type | H2O
Temps (en s) | 0 | 0.001 | 0.02 | 0.038 | 0.04 | 0.04 | 0.04 | 0.04 | 0.04 | 0.04 | 0.04 | 0.04 | 0.04 | 0.04 | 0.04 | 0.04 | 0.04 | 0.04 | 0.04 | 0.04 | 0.04 | 0.04 | 0.04 | 1000
Poussée (en N) | 0 | 310 | 250 | 212 | 0 | 0 | 0 | 0 | 0 | 0 | 0 | 0 | 0 | 0 | 0 | 0 | 0 | 0 | 0 | 0 | 0 | 0 | 0 | 0
I_total_i (en N.s) | 0.2 | 5.3 | 4.2 | 0.2 | 0 | 0 | 0 | 0 | 0 | 0 | 0 | 0 | 0 | 0 | 0 | 0 | 0 | 0 | 0 | 0 | 0 | 0 | 0
H2O 1.5L 450g 6bar | 31 | I_total | 13.8 N.s | ISP | 3.1 s | MpropuPlein | 0.45 kg | M_éjecté | 0.45 kg | M_burnout | 0 kg | XpropuPlein | 90 mm | XpropuVide | 150 mm | Longueur | 300 mm | Diamètre | 90 mm | Type | H2O
Temps (en s) | 0 | 0.001 | 0.02 | 0.04 | 0.061 | 0.062 | 0.062 | 0.062 | 0.062 | 0.062 | 0.062 | 0.062 | 0.062 | 0.062 | 0.062 | 0.062 | 0.062 | 0.062 | 0.062 | 0.062 | 0.062 | 0.062 | 0.062 | 1000
Poussée (en N) | 0 | 310 | 245 | 200 | 167 | 0 | 0 | 0 | 0 | 0 | 0 | 0 | 0 | 0 | 0 | 0 | 0 | 0 | 0 | 0 | 0 | 0 | 0 | 0
I_total_i (en N.s) | 0.2 | 5.3 | 4.5 | 3.9 | 0.1 | 0 | 0 | 0 | 0 | 0 | 0 | 0 | 0 | 0 | 0 | 0 | 0 | 0 | 0 | 0 | 0 | 0 | 0
H2O 1.5L 600g 6bar | 36 | I_total | 17.1 N.s | ISP | 2.9 s | MpropuPlein | 0.6 kg | M_éjecté | 0.6 kg | M_burnout | 0 kg | XpropuPlein | 120 mm | XpropuVide | 150 mm | Longueur | 300 mm | Diamètre | 90 mm | Type | H2O
Temps (en s) | 0 | 0.001 | 0.02 | 0.04 | 0.06 | 0.08 | 0.088 | 0.089 | 0.089 | 0.089 | 0.089 | 0.089 | 0.089 | 0.089 | 0.089 | 0.089 | 0.089 | 0.089 | 0.089 | 0.089 | 0.089 | 0.089 | 0.089 | 1000
Poussée (en N) | 0 | 310 | 240 | 190 | 157 | 133 | 125 | 0 | 0 | 0 | 0 | 0 | 0 | 0 | 0 | 0 | 0 | 0 | 0 | 0 | 0 | 0 | 0 | 0
I_total_i (en N.s) | 0.2 | 5.2 | 4.3 | 3.5 | 2.9 | 1 | 0.1 | 0 | 0 | 0 | 0 | 0 | 0 | 0 | 0 | 0 | 0 | 0 | 0 | 0 | 0 | 0 | 0
H2O 1.5L 750g 6bar | 41 | I_total | 19.4 N.s | ISP | 2.6 s | MpropuPlein | 0.75 kg | M_éjecté | 0.75 kg | M_burnout | 0 kg | XpropuPlein | 150 mm | XpropuVide | 150 mm | Longueur | 300 mm | Diamètre | 90 mm | Type | H2O
Temps (en s) | 0 | 0.001 | 0.02 | 0.04 | 0.06 | 0.08 | 0.1 | 0.123 | 0.124 | 0.124 | 0.124 | 0.124 | 0.124 | 0.124 | 0.124 | 0.124 | 0.124 | 0.124 | 0.124 | 0.124 | 0.124 | 0.124 | 0.124 | 1000
Poussée (en N) | 0 | 310 | 230 | 175 | 140 | 118 | 100 | 85 | 0 | 0 | 0 | 0 | 0 | 0 | 0 | 0 | 0 | 0 | 0 | 0 | 0 | 0 | 0 | 0
I_total_i (en N.s) | 0.2 | 5.1 | 4 | 3.1 | 2.6 | 2.2 | 2.1 | 0.0425 | 0 | 0 | 0 | 0 | 0 | 0 | 0 | 0 | 0 | 0 | 0 | 0 | 0 | 0 | 0
H2O 2.0L 400g 6bar | 46 | I_total | 12.9 N.s | ISP | 3.3 s | MpropuPlein | 0.5 kg | M_éjecté | 0.4 kg | M_burnout | 0.1 kg | XpropuPlein | 60 mm | XpropuVide | 150 mm | Longueur | 300 mm | Diamètre | 98 mm | Type | H2O
Temps (en s) | 0 | 0.001 | 0.02 | 0.04 | 0.05 | 0.051 | 0.051 | 0.051 | 0.051 | 0.051 | 0.051 | 0.051 | 0.051 | 0.051 | 0.051 | 0.051 | 0.051 | 0.051 | 0.051 | 0.051 | 0.051 | 0.051 | 0.051 | 1000
Poussée (en N) | 0 | 310 | 264 | 230 | 213 | 0 | 0 | 0 | 0 | 0 | 0 | 0 | 0 | 0 | 0 | 0 | 0 | 0 | 0 | 0 | 0 | 0 | 0 | 0
I_total_i (en N.s) | 0.2 | 5.5 | 4.9 | 2.2 | 0.1 | 0 | 0 | 0 | 0 | 0 | 0 | 0 | 0 | 0 | 0 | 0 | 0 | 0 | 0 | 0 | 0 | 0 | 0
H2O 2.0L 600g 6bar | 51 | I_total | 18.1 N.s | ISP | 3.1 s | MpropuPlein | 0.7 kg | M_éjecté | 0.6 kg | M_burnout | 0.1 kg | XpropuPlein | 90 mm | XpropuVide | 150 mm | Longueur | 300 mm | Diamètre | 98 mm | Type | H2O
Temps (en s) | 0 | 0.001 | 0.02 | 0.04 | 0.06 | 0.08 | 0.081 | 0.081 | 0.081 | 0.081 | 0.081 | 0.081 | 0.081 | 0.081 | 0.081 | 0.081 | 0.081 | 0.081 | 0.081 | 0.081 | 0.081 | 0.081 | 0.081 | 1000
Poussée (en N) | 0 | 310 | 260 | 220 | 190 | 167 | 0 | 0 | 0 | 0 | 0 | 0 | 0 | 0 | 0 | 0 | 0 | 0 | 0 | 0 | 0 | 0 | 0 | 0
I_total_i (en N.s) | 0.2 | 5.4 | 4.8 | 4.1 | 3.6 | 0.1 | 0 | 0 | 0 | 0 | 0 | 0 | 0 | 0 | 0 | 0 | 0 | 0 | 0 | 0 | 0 | 0 | 0
H2O 2.0L 800g 6bar | 56 | I_total | 22.6 N.s | ISP | 2.9 s | MpropuPlein | 0.9 kg | M_éjecté | 0.8 kg | M_burnout | 0.1 kg | XpropuPlein | 120 mm | XpropuVide | 150 mm | Longueur | 300 mm | Diamètre | 98 mm | Type | H2O
Temps (en s) | 0 | 0.001 | 0.02 | 0.04 | 0.06 | 0.08 | 0.1 | 0.117 | 0.118 | 0.118 | 0.118 | 0.118 | 0.118 | 0.118 | 0.118 | 0.118 | 0.118 | 0.118 | 0.118 | 0.118 | 0.118 | 0.118 | 0.118 | 1000
Poussée (en N) | 0 | 310 | 250 | 210 | 180 | 156 | 140 | 125 | 0 | 0 | 0 | 0 | 0 | 0 | 0 | 0 | 0 | 0 | 0 | 0 | 0 | 0 | 0 | 0
I_total_i (en N.s) | 0.2 | 5.3 | 4.6 | 3.9 | 3.4 | 3 | 2.3 | 0.1 | 0 | 0 | 0 | 0 | 0 | 0 | 0 | 0 | 0 | 0 | 0 | 0 | 0 | 0 | 0
H2O 2.0L 1000g 6bar | 61 | I_total | 25.9 N.s | ISP | 2.6 s | MpropuPlein | 1.1 kg | M_éjecté | 1 kg | M_burnout | 0.1 kg | XpropuPlein | 150 mm | XpropuVide | 150 mm | Longueur | 300 mm | Diamètre | 98 mm | Type | H2O
Temps (en s) | 0 | 0.001 | 0.02 | 0.04 | 0.06 | 0.08 | 0.1 | 0.12 | 0.14 | 0.164 | 0.165 | 0.165 | 0.165 | 0.165 | 0.165 | 0.165 | 0.165 | 0.165 | 0.165 | 0.165 | 0.165 | 0.165 | 0.165 | 1000
Poussée (en N) | 0 | 310 | 245 | 200 | 165 | 143 | 124 | 108 | 97 | 85 | 0 | 0 | 0 | 0 | 0 | 0 | 0 | 0 | 0 | 0 | 0 | 0 | 0 | 0
I_total_i (en N.s) | 0.2 | 5.3 | 4.5 | 3.6 | 3.1 | 2.7 | 2.3 | 2.1 | 2.2 | 0.0425 | 0 | 0 | 0 | 0 | 0 | 0 | 0 | 0 | 0 | 0 | 0 | 0 | 0
µ-propu
µ-propu A8-3 | 67 | I_total | 2.6 N.s | ISP | 54.02650357 s | MpropuPlein | 0.015 kg | M_éjecté | 0.005 kg | M_burnout | 0.01 kg | XpropuPlein | 30 mm | XpropuVide | 30 mm | Longueur | 70 mm | Diamètre | 15 mm | Type | Micro | Combustion | 0.32 s | Dépotage | 3
Temps (en s) | 0 | 0.2 | 0.3 | 0.4 | 0.5 | 0.55 | 0.6 | 0.6 | 0.6 | 0.6 | 0.6 | 0.6 | 0.6 | 0.6 | 0.6 | 0.6 | 0.6 | 0.6 | 0.6 | 0.6 | 0.6 | 0.6 | 0.6 | 1000
Poussée (en N) | 0 | 9 | 4.5 | 4 | 4 | 3 | 0 | 0 | 0 | 0 | 0 | 0 | 0 | 0 | 0 | 0 | 0 | 0 | 0 | 0 | 0 | 0 | 0 | 0
I_total_i (en N.s) | 0.9 | 0.7 | 0.4 | 0.4 | 0.2 | 0.1 | 0 | 0 | 0 | 0 | 0 | 0 | 0 | 0 | 0 | 0 | 0 | 0 | 0 | 0 | 0 | 0 | 0
µ-propu B4-4 | 72 | I_total | 5.2 N.s | ISP | 89.19469929 s | MpropuPlein | 0.02 kg | M_éjecté | 0.006 kg | M_burnout | 0.014 kg | XpropuPlein | 30 mm | XpropuVide | 30 mm | Longueur | 70 mm | Diamètre | 15 mm | Type | Micro | Combustion | 1.20 s | Dépotage | 4
Temps (en s) | 0 | 0.2 | 0.3 | 0.55 | 1.05 | 1.15 | 1.15 | 1.15 | 1.15 | 1.15 | 1.15 | 1.15 | 1.15 | 1.15 | 1.15 | 1.15 | 1.15 | 1.15 | 1.15 | 1.15 | 1.15 | 1.15 | 1.15 | 1000
Poussée (en N) | 0 | 10 | 6 | 4 | 4 | 0 | 0 | 0 | 0 | 0 | 0 | 0 | 0 | 0 | 0 | 0 | 0 | 0 | 0 | 0 | 0 | 0 | 0 | 0
I_total_i (en N.s) | 1 | 0.8 | 1.3 | 2 | 0.2 | 0 | 0 | 0 | 0 | 0 | 0 | 0 | 0 | 0 | 0 | 0 | 0 | 0 | 0 | 0 | 0 | 0 | 0
µ-propu C6-3 | 77 | I_total | 10.3 N.s | ISP | 80.45165843 s | MpropuPlein | 0.024 kg | M_éjecté | 0.013 kg | M_burnout | 0.011 kg | XpropuPlein | 30 mm | XpropuVide | 30 mm | Longueur | 70 mm | Diamètre | 15 mm | Type | Micro | Combustion | 1.70 s | Dépotage | 3
Temps (en s) | 0 | 0.2 | 0.3 | 0.6 | 0.8 | 2 | 2.1 | 2.1 | 2.1 | 2.1 | 2.1 | 2.1 | 2.1 | 2.1 | 2.1 | 2.1 | 2.1 | 2.1 | 2.1 | 2.1 | 2.1 | 2.1 | 2.1 | 1000
Poussée (en N) | 0 | 11 | 7 | 4 | 4.6 | 4.6 | 0 | 0 | 0 | 0 | 0 | 0 | 0 | 0 | 0 | 0 | 0 | 0 | 0 | 0 | 0 | 0 | 0 | 0
I_total_i (en N.s) | 1.1 | 0.9 | 1.6 | 0.9 | 5.5 | 0.2 | 0 | 0 | 0 | 0 | 0 | 0 | 0 | 0 | 0 | 0 | 0 | 0 | 0 | 0 | 0 | 0 | 0
µ-propu C6-3 x2 | 82 | I_total | 20.5 N.s | ISP | 80.45165843 s | MpropuPlein | 0.048 kg | M_éjecté | 0.026 kg | M_burnout | 0.022 kg | XpropuPlein | 30 mm | XpropuVide | 30 mm | Longueur | 70 mm | Diamètre | 30 mm | Type | Micro | Combustion | 1.70 s | Dépotage | 3
Temps (en s) | 0 | 0.2 | 0.3 | 0.6 | 0.8 | 2 | 2.1 | 2.1 | 2.1 | 2.1 | 2.1 | 2.1 | 2.1 | 2.1 | 2.1 | 2.1 | 2.1 | 2.1 | 2.1 | 2.1 | 2.1 | 2.1 | 2.1 | 1000
Poussée (en N) | 0 | 22 | 14 | 8 | 9.2 | 9.2 | 0 | 0 | 0 | 0 | 0 | 0 | 0 | 0 | 0 | 0 | 0 | 0 | 0 | 0 | 0 | 0 | 0 | 0
I_total_i (en N.s) | 2.2 | 1.8 | 3.3 | 1.7 | 11 | 0.5 | 0 | 0 | 0 | 0 | 0 | 0 | 0 | 0 | 0 | 0 | 0 | 0 | 0 | 0 | 0 | 0 | 0
µ-propu C6-3 x3 | 87 | I_total | 30.8 N.s | ISP | 80.45165843 s | MpropuPlein | 0.072 kg | M_éjecté | 0.039 kg | M_burnout | 0.033 kg | XpropuPlein | 30 mm | XpropuVide | 30 mm | Longueur | 70 mm | Diamètre | 40 mm | Type | Micro | Combustion | 1.70 s | Dépotage | 3
Temps (en s) | 0 | 0.2 | 0.3 | 0.6 | 0.8 | 2 | 2.1 | 2.1 | 2.1 | 2.1 | 2.1 | 2.1 | 2.1 | 2.1 | 2.1 | 2.1 | 2.1 | 2.1 | 2.1 | 2.1 | 2.1 | 2.1 | 2.1 | 1000
Poussée (en N) | 0 | 33 | 21 | 12 | 13.8 | 13.8 | 0 | 0 | 0 | 0 | 0 | 0 | 0 | 0 | 0 | 0 | 0 | 0 | 0 | 0 | 0 | 0 | 0 | 0
I_total_i (en N.s) | 3.3 | 2.7 | 5 | 2.6 | 16.6 | 0.7 | 0 | 0 | 0 | 0 | 0 | 0 | 0 | 0 | 0 | 0 | 0 | 0 | 0 | 0 | 0 | 0 | 0
Klima D9-7 | 92 | I_total | 20.0 N.s | ISP | 118.3058874 s | MpropuPlein | 0.0282 kg | M_éjecté | 0.0172 kg | M_burnout | 0.011 kg | XpropuPlein | 30 mm | XpropuVide | 30 mm | Longueur | 70 mm | Diamètre | 18 mm | Type | MiniN | Combustion | 2.10 s | Dépotage | 7
Temps (en s) | 0 | 0.04 | 0.116 | 0.213 | 0.286 | 0.329 | 0.369 | 0.42 | 0.495 | 0.597 | 1.711 | 1.826 | 1.917 | 1.975 | 2.206 | 2.242 | 2.5 | 2.5 | 2.5 | 2.5 | 2.5 | 2.5 | 2.5 | 1000
Poussée (en N) | 0 | 2.111 | 9.685 | 25 | 15.738 | 12.472 | 10.67 | 9.713 | 9.178 | 8.896 | 8.925 | 8.699 | 8.052 | 6.954 | 1.07 | 0 | 0 | 0 | 0 | 0 | 0 | 0 | 0 | 0
I_total_i (en N.s) | 0.04222 | 0.4 | 1.7 | 1.5 | 0.6 | 0.5 | 0.5 | 0.7 | 0.9 | 9.9 | 1 | 0.8 | 0.4 | 0.9 | 0.01926 | 0 | 0 | 0 | 0 | 0 | 0 | 0 | 0
Klima D9-7 x2 | 97 | I_total | 39.9 N.s | ISP | 118.3058874 s | MpropuPlein | 0.0564 kg | M_éjecté | 0.0344 kg | M_burnout | 0.022 kg | XpropuPlein | 30 mm | XpropuVide | 30 mm | Longueur | 70 mm | Diamètre | 30 mm | Type | MiniN | Combustion | 2.10 s | Dépotage | 7
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
Temps (en s) | 0 | 0.01 | 0.023 | 0.04 | 0.118 | 0.283 | 0.51 | 0.688 | 0.787 | 0.852 | 0.873 | 0.873 | 0.873 | 0.873 | 0.873 | 0.873 | 0.873 | 0.873 | 0.873 | 0.873 | 0.873 | 0.873 | 2 | 1000
Poussée (en N) | 0 | 76.07 | 100.19 | 92.42 | 100.88 | 102.40 | 96.44 | 87.44 | 25.91 | 7.21 | 0 | 0 | 0 | 0 | 0 | 0 | 0 | 0 | 0 | 0 | 0 | 0 | 0 | 0
I_total_i (en N.s) | 0.4 | 1.1 | 1.6 | 7.5 | 16.8 | 22.6 | 16.4 | 5.6 | 1.1 | 0.1 | 0 | 0 | 0 | 0 | 0 | 0 | 0 | 0 | 0 | 0 | 0 | 0 | 0
p24-3G 75F51 | 188 | I_total | 75.3 N.s | ISP | 232.4603342 s | MpropuPlein | 0.095 kg | M_éjecté | 0.033 kg | M_burnout | 0.062 kg | XpropuPlein | 66.5 mm | XpropuVide | 66.5 mm | Longueur | 133 mm | Diamètre | 24 mm | Type | MiniRN | Combustion | 1.50 s | Dépotage | 12
Temps (en s) | 0 | 0.02 | 0.031 | 0.062 | 0.117 | 1.211 | 1.376 | 1.456 | 1.532 | 1.577 | 2 | 2 | 2 | 2 | 2 | 2 | 2 | 2 | 2 | 2 | 2 | 2 | 2 | 1000
Poussée (en N) | 0 | 75.924 | 84.148 | 70.441 | 73.659 | 38.737 | 14.779 | 7.271 | 3.337 | 0 | 0 | 0 | 0 | 0 | 0 | 0 | 0 | 0 | 0 | 0 | 0 | 0 | 0 | 0
I_total_i (en N.s) | 0.8 | 0.9 | 2.4 | 4 | 61.5 | 4.4 | 0.9 | 0.4 | 0.1 | 0 | 0 | 0 | 0 | 0 | 0 | 0 | 0 | 0 | 0 | 0 | 0 | 0 | 0
MINIF PRO24-6G
p24-6G 140G145 PK | 193 | I_total | 141.0 N.s | ISP | 186.2459265 s | MpropuPlein | 0.1619 kg | M_éjecté | 0.0772 kg | M_burnout | 0.0847 kg | XpropuPlein | 114 mm | XpropuVide | 114 mm | Longueur | 228 mm | Diamètre | 24 mm | Type | Mini | Combustion | 0.96 s | Dépotage | 15
Temps (en s) | 0 | 0.02 | 0.03 | 0.05 | 0.6 | 0.67 | 0.7 | 0.8 | 0.9 | 1.05 | 1.05 | 1.05 | 1.05 | 1.05 | 1.05 | 1.05 | 1.05 | 1.05 | 1.05 | 1.05 | 1.05 | 1.05 | 2 | 1000
Poussée (en N) | 0 | 350 | 250 | 210 | 150 | 140 | 130 | 65 | 30 | 0 | 0 | 0 | 0 | 0 | 0 | 0 | 0 | 0 | 0 | 0 | 0 | 0 | 0 | 0
I_total_i (en N.s) | 3.5 | 3 | 4.6 | 99 | 10.2 | 4 | 9.8 | 4.7 | 2.3 | 0 | 0 | 0 | 0 | 0 | 0 | 0 | 0 | 0 | 0 | 0 | 0 | 0 | 0
143G150 BS
Pandora (Pro24-6G BS) | 198 | I_total | 142.4 N.s | ISP | 192.061874 s | MpropuPlein | 0.1599 kg | M_éjecté | 0.0756 kg | M_burnout | 0.0843 kg | XpropuPlein | 114 mm | XpropuVide | 114 mm | Longueur | 228 mm | Diamètre | 24 mm | Type | MiniN | Combustion | 0.97 s | Dépotage | 13
Temps (en s) | 0 | 0.02 | 0.04 | 0.62 | 0.66 | 0.68 | 0.8 | 0.84 | 0.88 | 0.92 | 0.96 | 1 | 1.08 | 2 | 2 | 2 | 2 | 2 | 2 | 2 | 2 | 2 | 2 | 1000
Poussée (en N) | 0 | 250 | 210 | 160 | 150 | 142 | 62 | 48 | 34 | 24 | 15 | 10 | 0 | 0 | 0 | 0 | 0 | 0 | 0 | 0 | 0 | 0 | 0 | 0
I_total_i (en N.s) | 2.5 | 4.6 | 107.3 | 6.2 | 2.9 | 12.2 | 2.2 | 1.6 | 1.2 | 0.8 | 0.5 | 0.4 | 0 | 0 | 0 | 0 | 0 | 0 | 0 | 0 | 0 | 0 | 0
p24-6G 142G117 WT | 203 | I_total | 143.1 N.s | ISP | 168.2350472 s | MpropuPlein | 0.1725 kg | M_éjecté | 0.0867 kg | M_burnout | 0.0858 kg | XpropuPlein | 114 mm | XpropuVide | 114 mm | Longueur | 228 mm | Diamètre | 24 mm | Type | Mini | Combustion | 0.97 s | Dépotage | 11
Temps (en s) | 0 | 0.008 | 0.013 | 0.022 | 0.035 | 0.063 | 0.103 | 0.196 | 0.311 | 0.474 | 0.564 | 0.762 | 0.858 | 0.928 | 1.038 | 1.08 | 1.131 | 1.185 | 1.224 | 1.258 | 1.4 | 1.441 | 2 | 1000
Poussée (en N) | 0 | 168.643 | 177.339 | 177.866 | 171.278 | 157.839 | 154.941 | 148.88 | 144.137 | 138.076 | 135.705 | 125.955 | 116.733 | 101.713 | 57.444 | 42.688 | 31.884 | 17.655 | 9.486 | 5.27 | 0.791 | 0 | 0 | 0
I_total_i (en N.s) | 0.7 | 0.9 | 1.6 | 2.3 | 4.6 | 6.3 | 14.1 | 16.8 | 23 | 12.3 | 25.9 | 11.6 | 7.6 | 8.8 | 2.1 | 1.9 | 1.3 | 0.5 | 0.3 | 0.4 | 0.0162155 | 0 | 0
p24-6G 139G107 DT | 208 | I_total | 139.4 N.s | ISP | 158.6202775 s | MpropuPlein | 0.1945 kg | M_éjecté | 0.0896 kg | M_burnout | 0.1049 kg | XpropuPlein | 114 mm | XpropuVide | 144 mm | Longueur | 228 mm | Diamètre | 24 mm | Type | Mini | Combustion | 1.30 s | Dépotage | 12
Temps (en s) | 0 | 0.011 | 0.022 | 0.046 | 0.081 | 0.219 | 0.253 | 0.274 | 0.305 | 0.412 | 0.789 | 0.899 | 0.953 | 0.999 | 1.03 | 1.057 | 1.102 | 1.154 | 1.197 | 1.277 | 1.335 | 1.451 | 2 | 1000
Poussée (en N) | 0 | 198.418 | 221.835 | 212.658 | 218.354 | 204.43 | 195.886 | 183.544 | 88.291 | 93.671 | 93.987 | 91.139 | 89.873 | 87.025 | 81.329 | 69.937 | 54.114 | 42.405 | 31.646 | 17.089 | 9.81 | 0 | 0 | 0
I_total_i (en N.s) | 1.1 | 2.3 | 5.2 | 7.5 | 29.2 | 6.8 | 4 | 4.2 | 9.7 | 35.4 | 10.2 | 4.9 | 4.1 | 2.6 | 2 | 2.8 | 2.5 | 1.6 | 1.9 | 0.8 | 0.6 | 0 | 0
MINIF PRO29-2G
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
Temps (en s) | 0 | 0.017 | 0.052 | 0.088 | 0.108 | 0.127 | 0.174 | 0.257 | 0.403 | 0.762 | 0.977 | 1.341 | 1.501 | 1.661 | 1.96 | 2.404 | 2.641 | 2.716 | 2.821 | 2.892 | 2.92 | 2.97 | 3 | 1000
Poussée (en N) | 0 | 329.847 | 1003.68 | 2346.62 | 2549.24 | 2605.79 | 2520.97 | 2516.26 | 2596.37 | 2808.41 | 2954.49 | 2959.2 | 2907.36 | 2869.67 | 2695.32 | 2351.34 | 2228.82 | 2007.35 | 1427.77 | 504.194 | 334.559 | 122.515 | 0 | 0
I_total_i (en N.s) | 2.8 | 23.3 | 60.3 | 49 | 49 | 120.5 | 209 | 373.2 | 970.2 | 619.5 | 1076.3 | 469.3 | 462.2 | 832 | 1120.4 | 542.7 | 158.9 | 180.3 | 68.6 | 11.7 | 11.4 | 1.8 | 0
Blastocerus (Pro98-6GXL RL) | 304 | I_total | 17735.0 N.s | ISP | 192.7342031 s | MpropuPlein | 14.748 kg | M_éjecté | 9.38 kg | M_burnout | 5.368 kg | XpropuPlein | 500 mm | XpropuVide | 500 mm | Longueur | 1046 mm | Diamètre | 98 mm | Type | Fusex
Temps (en s) | 0 | 0.003 | 0.05 | 0.078 | 0.121 | 0.652 | 1.123 | 1.655 | 2.353 | 3.035 | 3.7 | 3.733 | 3.887 | 4.036 | 4.197 | 4.262 | 4.3 | 5 | 5 | 5 | 5 | 5 | 5 | 1000
Poussée (en N) | 0 | 203.877 | 2362.879 | 3946.845 | 4281.412 | 4370.281 | 4453.923 | 4772.807 | 4621.206 | 4511.427 | 4375.509 | 4182.087 | 2969.282 | 1589.193 | 533.216 | 240.47 | 0 | 0 | 0 | 0 | 0 | 0 | 0 | 0
I_total_i (en N.s) | 0.3 | 60.3 | 88.3 | 176.9 | 2297 | 2078.1 | 2454.3 | 3278.5 | 3114.2 | 2954.9 | 141.2 | 550.7 | 339.6 | 170.9 | 25.1 | 4.6 | 0 | 0 | 0 | 0 | 0 | 0 | 0
Aucun (2e ét. inerte) | 309 | I_total | 0.001 N.s | ISP | 1.019367992 s | MpropuPlein | 0.0001 kg | M_éjecté | 0.0001 kg | M_burnout | 0 kg | XpropuPlein | 0 mm | XpropuVide | 0 mm | Longueur | 0 mm | Diamètre | 0 mm | Type | Fusex
Temps (en s) | 0 | 0.1 | 0.2 | 1 | 1 | 1 | 1 | 1 | 1 | 1 | 1 | 1 | 1 | 1 | 1 | 1 | 1 | 1 | 1 | 1 | 1 | 1 | 1 | 1000
Poussée (en N) | 0 | 0.01 | 0 | 0 | 0 | 0 | 0 | 0 | 0 | 0 | 0 | 0 | 0 | 0 | 0 | 0 | 0 | 0 | 0 | 0 | 0 | 0 | 0 | 0
I_total_i (en N.s) | 0.0005 | 0.0005 | 0 | 0 | 0 | 0 | 0 | 0 | 0 | 0 | 0 | 0 | 0 | 0 | 0 | 0 | 0 | 0 | 0 | 0 | 0 | 0 | 0
Liste des propu affichés : |  | H2O |  |  | µ-propu |  |  | Rocketry Challenge |  |  | Minif |  |  | Minif Test |  |  | Fusex
Pro54-5G WT |  | H2O 1.5L 300g 6bar |  |  | µ-propu A8-3 |  |  | p29-1G 56F31 |  |  | p29-1G 57F59 |  |  | p24-1G 24E22 |  |  | Pro54-5G WT
Barasinga (Pro54-5G C) |  | H2O 1.5L 450g 6bar |  |  | µ-propu B4-4 |  |  | p29-1G 56F120 |  |  | p24-3G 74F85 |  |  | p24-1G 25E75 (Rufina) |  |  | Barasinga (Pro54-5G C)
Orignal (Pro75-3G C) |  | H2O 1.5L 600g 6bar |  |  | µ-propu C6-3 |  |  | p29-1G 57F59 |  |  | p24-3G 75F51 |  |  | p24-1G 26E31 |  |  | Orignal (Pro75-3G C)
Pro98-6G Green |  | H2O 1.5L 750g 6bar |  |  | µ-propu C6-3 x2 |  |  | p24-3G 74F85 |  |  | p29-2G 116G126 |  |  | p24-2G 50E51 |  |  | Pro98-6G Green
 |  | H2O 2.0L 400g 6bar |  |  | µ-propu C6-3 x3 |  |  | p24-3G 75F51 |  |  | Pandora (Pro24-6G BS) |  |  | p24-1G 53E70
 |  | H2O 2.0L 600g 6bar |  |  |  |  |  |  |  |  | Klima D9-7 |  |  | p29-1G 41F36
 |  | H2O 2.0L 800g 6bar |  |  |  |  |  |  |  |  | Klima D9-7 x2 |  |  | p29-1G 51F36
 |  | H2O 2.0L 1000g 6bar |  |  |  |  |  |  |  |  | Klima D9-7 x3 |  |  | p29-1G 55F29
 |  |  |  |  |  |  |  |  |  |  |  |  |  | p29-1G 56F120
 |  |  |  |  |  |  |  |  |  |  |  |  |  | p29-1G 57F59
 |  |  |  |  |  |  |  |  |  |  |  |  |  | p24-3G 60F50
 |  |  |  |  |  |  |  |  |  |  |  |  |  | p24-3G 68F79
 |  |  |  |  |  |  |  |  |  |  |  |  |  | p24-3G 68F240
 |  |  |  |  |  |  |  |  |  |  |  |  |  | p24-3G 73F30
 |  |  |  |  |  |  |  |  |  |  |  |  |  | p24-3G 74F85
 |  |  |  |  |  |  |  |  |  |  |  |  |  | p24-3G 75F51
 |  |  |  |  |  |  |  |  |  |  |  |  |  | p29-2G 84G88
Isard |  |  |  |  |  |  |  |  |  |  |  |  |  | p29-2G 93G80 |  |  | Isard
Chamois |  |  |  |  |  |  |  |  |  |  |  |  |  | p29-2G 110G250 |  |  | Chamois
Pro54-5G WT |  |  |  |  |  |  |  |  |  |  |  |  |  | p29-2G 116G126 |  |  | Pro54-5G WT
Pro98-6G Green |  |  |  |  |  |  |  |  |  |  |  |  |  | p29-3G 125G131 |  |  | Pro98-6G Green
Pro98-3G WT |  |  |  |  |  |  |  |  |  |  |  |  |  | p38-1G 128G185 |  |  | Pro98-3G WT
Aucun (2e ét. inerte) |  |  |  |  |  |  |  |  |  |  |  |  |  | p38-1G 137G58 |  |  | Aucun (2e ét. inerte)
 |  |  |  |  |  |  |  |  |  |  |  |  |  | p38-1G 141G78
 |  |  |  |  |  |  |  |  |  |  |  |  |  | p24-6G 140G145 PK
 |  |  |  |  |  |  |  |  |  |  |  |  |  | Pandora (Pro24-6G BS)
 |  |  |  |  |  |  |  |  |  |  |  |  |  | p24-6G 142G117 WT
 |  |  |  |  |  |  |  |  |  |  |  |  |  | p24-6G 139G107 DT
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
