povdoigt/SP-02/CATIA/CATIA_vol/SP02_BETA/Beta_Maintien_Servo.stl

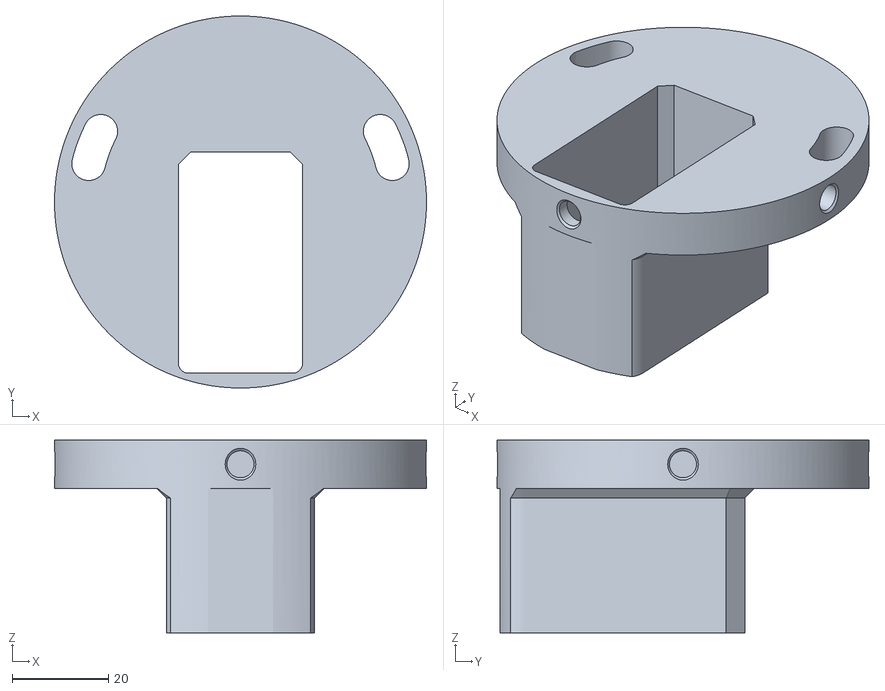
[picture p241: CAD file, 2026-07-09]
CATIA/CATIA_vol/SP02_BETA/Beta_Maintien_Servo.stl
77.2 x 77.2 x 40.0
