povdoigt/SP-02/CATIA/CATIA_vol/SP02_BETA/Beta_Maintien_Cable_Cage.stl

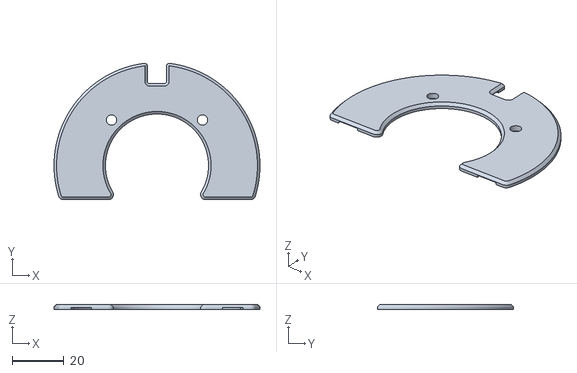
[picture p242: CAD file, 2026-07-09]
CATIA/CATIA_vol/SP02_BETA/Beta_Maintien_Cable_Cage.stl
80.0 x 53.0 x 2.00
