povdoigt/SP-02/CATIA/CATIA_vol/SP02_ALPHA/Maintien_Piles.stl

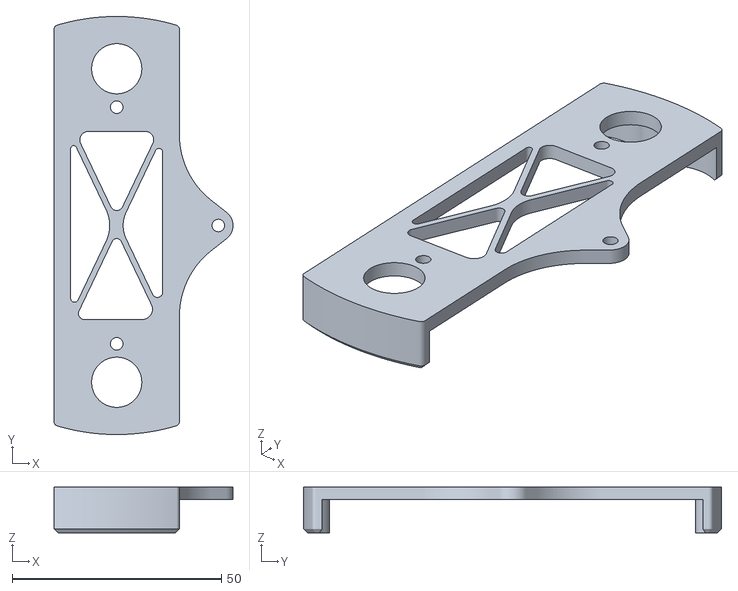
[picture p243: CAD file, 2026-07-09]
CATIA/CATIA_vol/SP02_ALPHA/Maintien_Piles.stl
42.8 x 100.0 x 11.0
