povdoigt/SP-02/CATIA/CATIA_vol/Usinage/Gabarit_trou_maintien_propu.3mf

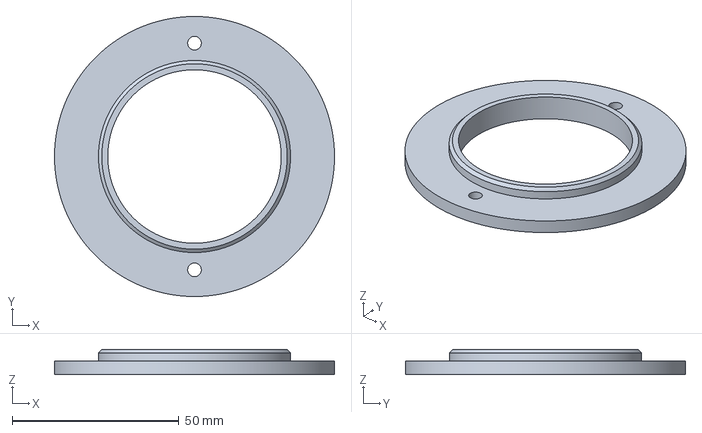
[picture p244: CAD file, 2026-07-09]
CATIA/CATIA_vol/Usinage/Gabarit_trou_maintien_propu.3mf
84.0 x 84.0 x 7.50 mm
