povdoigt/SP-02/CATIA/CATIA_vol/SP02_ALPHA/Alpha_Maintien_Cable_Cage.stl

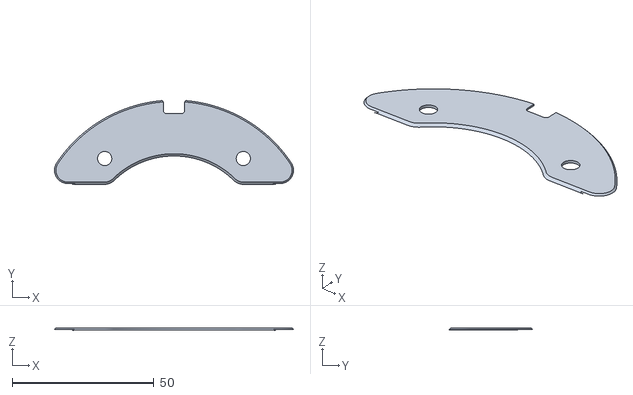
[picture p245: CAD file, 2026-07-09]
CATIA/CATIA_vol/SP02_ALPHA/Alpha_Maintien_Cable_Cage.stl
84.2 x 29.5 x 0.8
