povdoigt/SP-02/CATIA/CATIA_vol/Carte_elec_finales/Bloc_ELEC_Etage2.stl

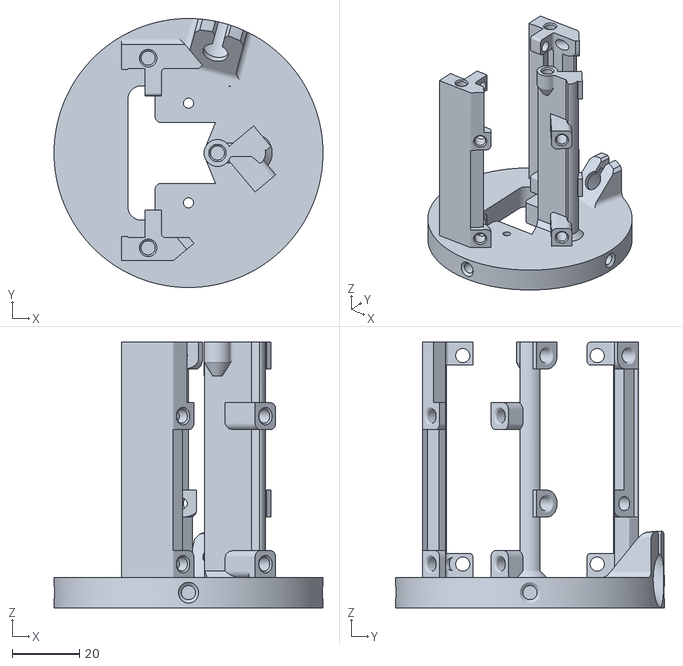
[picture p246: CAD file, 2026-07-09]
CATIA/CATIA_vol/Carte_elec_finales/Bloc_ELEC_Etage2.stl
80.0 x 80.0 x 79.0
