povdoigt/SP-02/CATIA/CATIA_vol/Cartes Electroniques/3D_PCB_PCB_SP02_Allumage_V2_2025-12-22_2025-12-22.step

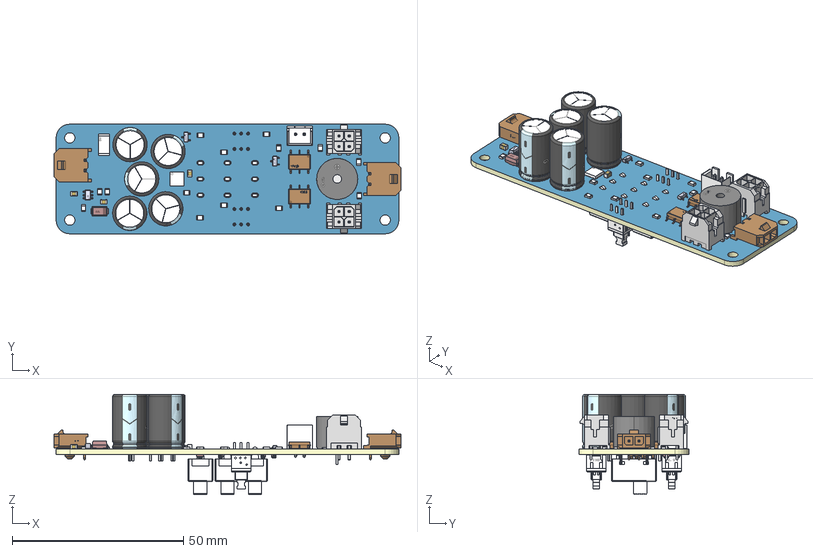
[picture p247: CAD file, 2026-07-09]
CATIA/CATIA_vol/Cartes Electroniques/3D_PCB_PCB_SP02_Allumage_V2_2025-12-22_2025-12-22.step
101.2 x 32.0 x 29.2 mm
Board~deSZ
TopCopper~deSZ
BottomCopper~deSZ
TopFpcStiffener~deSZ
BottomFpcStiffener~deSZ
CONN-TH_B2B-XH-A-LF-SN~XH2.5-2A~deSZ
C0805~C0805_L2.0-W1.3-H1.3~deSZ x 3
CONN-TH_2P-P3.00_MOLEX_436500200~CONN-TH_2P-P3.00_MOLEX_436500200~deSZ x 2
SOT-23_L2.9-W1.3-P1.90-LS2.4-BR~SOT-23-3P_ L2.9-W1.3-H1.0-LS2.4-P0.95~deSZ x 2
L0805~R0805_L2.0-W1.3-H0.6~deSZ
R0805~R0805_L2.0-W1.3-H0.6~deSZ x 13
CAP-TH_BD10.0-P5.00-D1.0-FD~CAP-TH_D10.0-H16.0-P5.00~deSZ x 5
R2512~R2512_L6.3-W3.2-H0.6~deSZ
LED0805-R-RD~LED0805-RD~deSZ x 6
SOT-23-6_L2.9-W1.6-P0.95-LS2.8-BR~SOT-23-6_ L2.9-W1.6-H1.5-LS2.8-P0.95~deSZ
SW-TH_XKB_SS-12M11XX~SW-TH_XKB_SS-12M11XX~deSZ x 3
SOP-6_L6.3-W4.4-P2.54-LS6.8-BL~SOP-6_L6.3-W4.4-P2.54-LS6.8-BL~deSZ x 2
SW-TH_6P-L5.8-W5.8-P2.00-LS4.5-BL_1~SW-TH_6P-L5.8-W5.8-P2.00-LS4.5-BL_ 1~deSZ x 2
BUZ-TH_BD12.0-P7.60-D0.6-FD~BUZ-TH_D12.0-H9.5-P7.60~deSZ
CONN-TH_4P-P3.00-S3.00_L7.4-W9.7-EH9.0~CONN-TH_4P-P3.00-S3.00_ L7.4-W9.7-EH9.0~deSZ x 2
VQFN-24_L4.0-W4.0-P0.50-TL-EP2.7~VQFN-24_L4.0-W4.0-P0.50-TL-EP2.7~deSZ
SMA_L4.3-W2.7-LS5.0-RD~SMA_L4.3-W2.7-LS5.0-RD~deSZ
