povdoigt/SP-02/CATIA/CATIA_vol/SP02_ALPHA/SP02_ALPHA_AF/STEP/SP02_ALPHA_AF_BLOC_BIELLE.stp

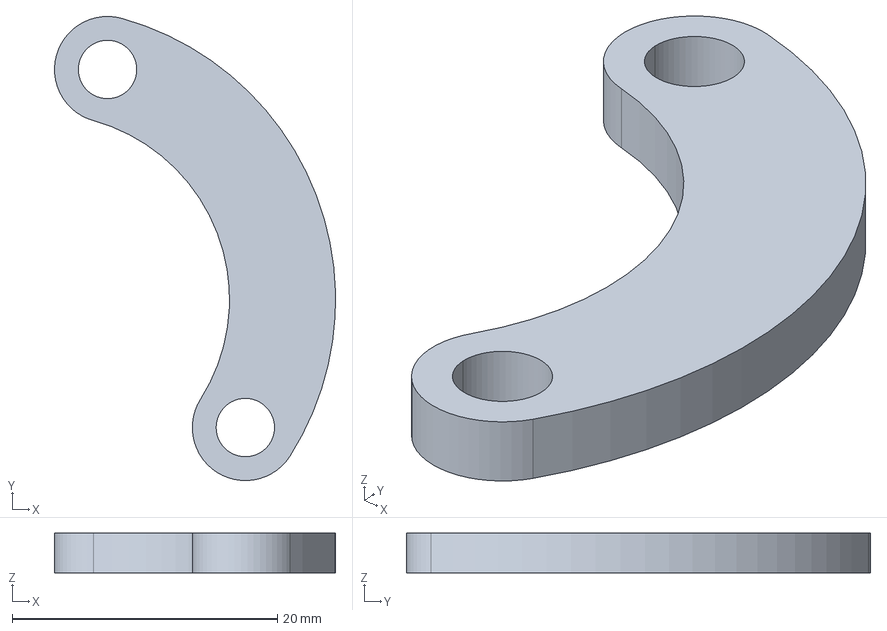
[picture p248: CAD file, 2026-07-09]
CATIA/CATIA_vol/SP02_ALPHA/SP02_ALPHA_AF/STEP/SP02_ALPHA_AF_BLOC_BIELLE.stp
21.2 x 35.0 x 3.00 mm
