povdoigt/SP-02/CATIA/CATIA_vol/SP02_ALPHA/SP02_ALPHA_Trappe_Parachute.stp

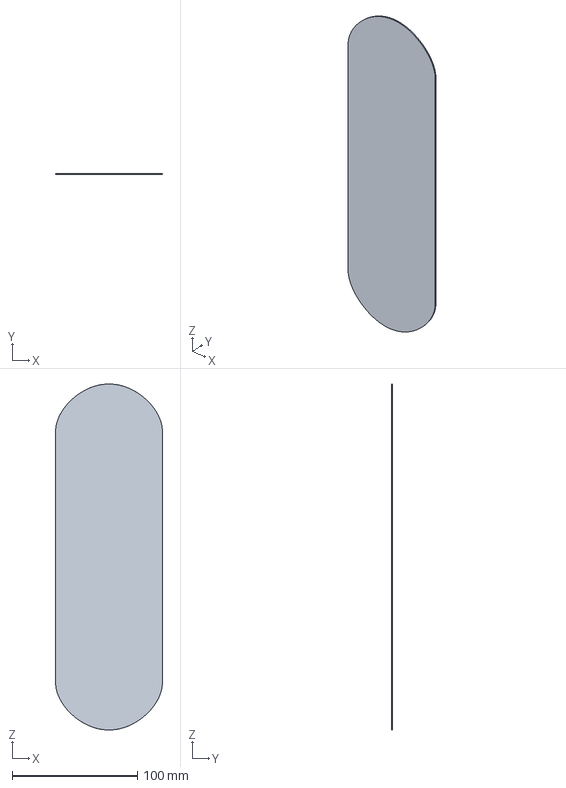
[picture p249: CAD file, 2026-07-09]
CATIA/CATIA_vol/SP02_ALPHA/SP02_ALPHA_Trappe_Parachute.stp
85.2 x 1.00 x 276.0 mm
