povdoigt/SP-02/CATIA/CATIA_vol/SP02_BETA/Beta_Fixation_Cage_Para.stl

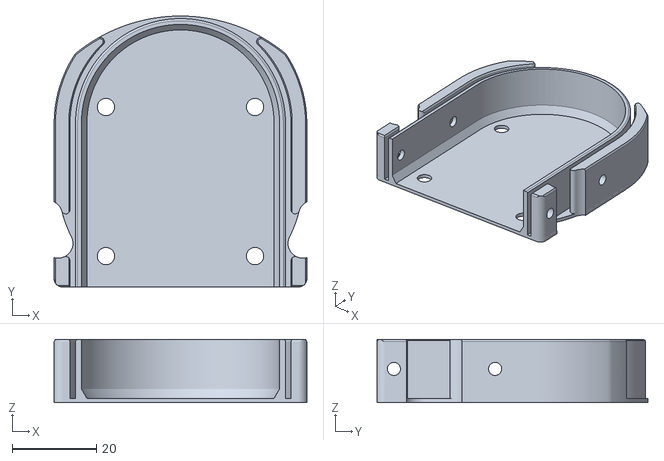
[picture p250: CAD file, 2026-07-09]
CATIA/CATIA_vol/SP02_BETA/Beta_Fixation_Cage_Para.stl
60.0 x 64.2 x 15.0
