povdoigt/SP-02/CATIA/CATIA_vol/SP02_BETA5_SEPA2_PALQUE-RETENUE.stl

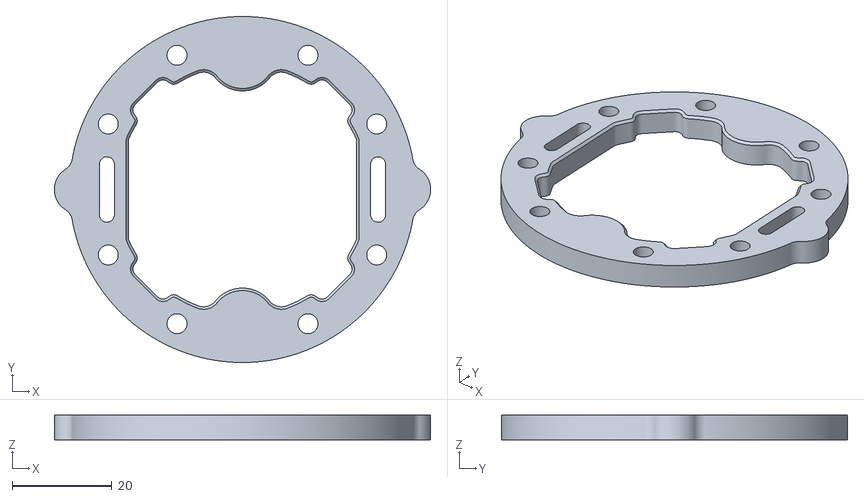
[picture p251: CAD file, 2026-07-09]
CATIA/CATIA_vol/SP02_BETA5_SEPA2_PALQUE-RETENUE.stl
75.6 x 69.5 x 5.00
