povdoigt/SP-02/CATIA/CATIA_vol/Usinage/Gabarit_trou_alu_beta.stl

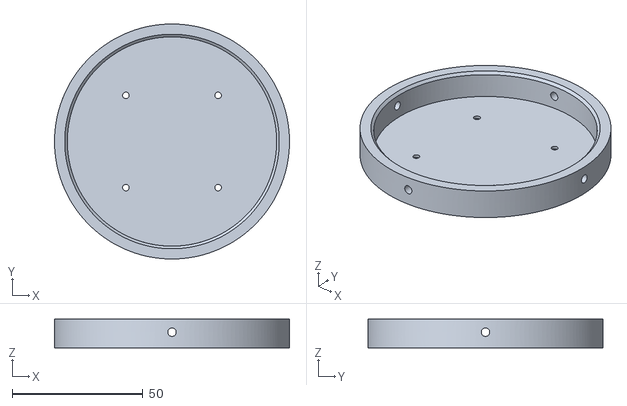
[picture p252: CAD file, 2026-07-09]
CATIA/CATIA_vol/Usinage/Gabarit_trou_alu_beta.stl
90.0 x 90.0 x 11.0
