povdoigt/SP-02/CATIA/new_catia/PONSEUR_AILERON_GUIDE_4.stp

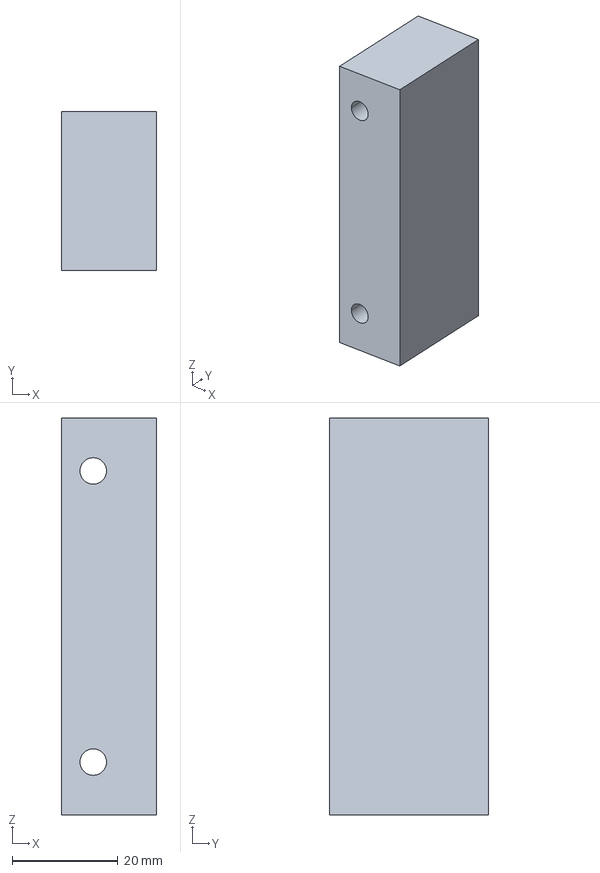
[picture p253: CAD file, 2026-06-02]
CATIA/new_catia/PONSEUR_AILERON_GUIDE_4.stp
17.9 x 30.0 x 75.0 mm
