povdoigt/SP-02/CATIA/SP02_BETA5_SEPA2_PRINCIPALE v10002.stp

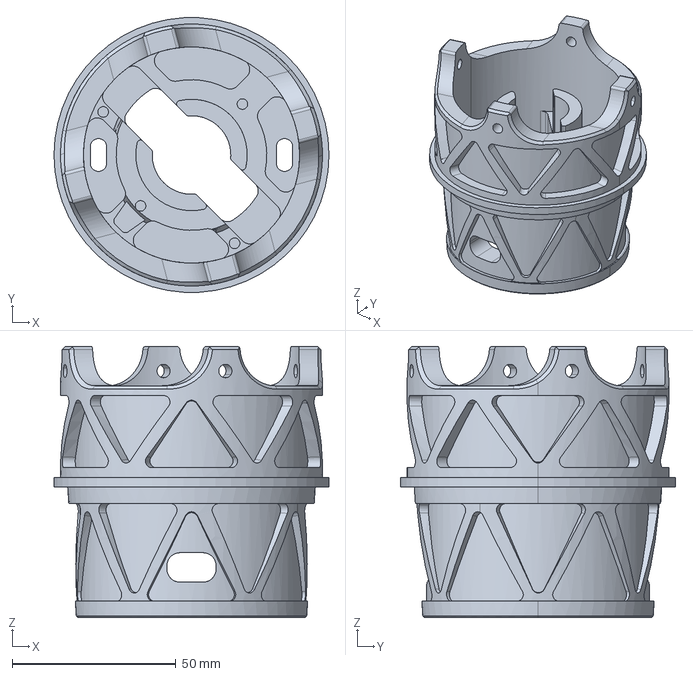
[picture p254: CAD file, 2026-06-02]
CATIA/SP02_BETA5_SEPA2_PRINCIPALE v10002.stp
84.0 x 83.9 x 82.8 mm
