povdoigt/SP-02/IMPRESSION/impression_top_secret _V2/SP02_ALPHA_SEPA_LOQUET_RESSORT.stp

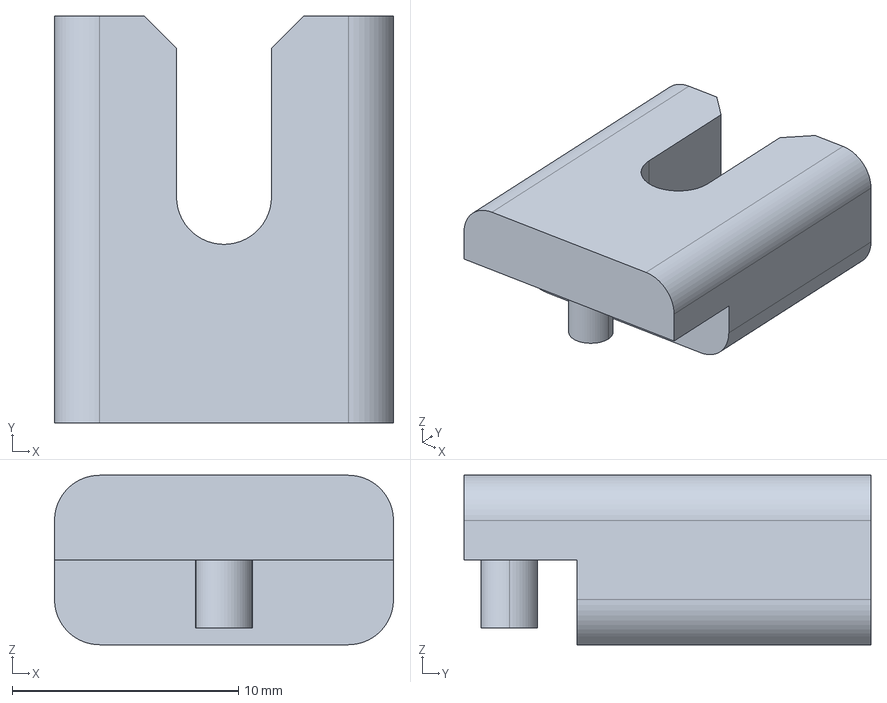
[picture p255: CAD file, 2025-10-19]
IMPRESSION/impression_top_secret _V2/SP02_ALPHA_SEPA_LOQUET_RESSORT.stp
15.0 x 18.0 x 7.50 mm
