povdoigt/SP-02/IMPRESSION/impression_top_secret/SP02_BETA_SEPA_PRINCIPALE_v2.stl

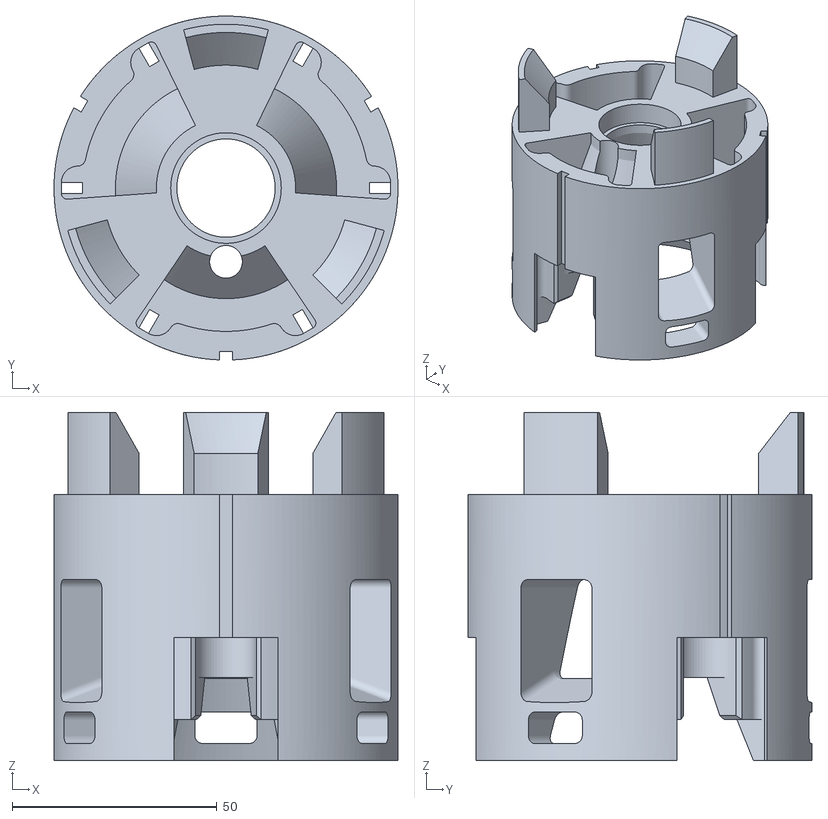
[picture p256: CAD file, 2025-10-19]
IMPRESSION/impression_top_secret/SP02_BETA_SEPA_PRINCIPALE_v2.stl
84.0 x 84.0 x 85.0
