povdoigt/SP-02/PMI/SEPA_Maxens/V0/STEP/SP02_ALPHAV3_SEPA_PRINCIPALE.step

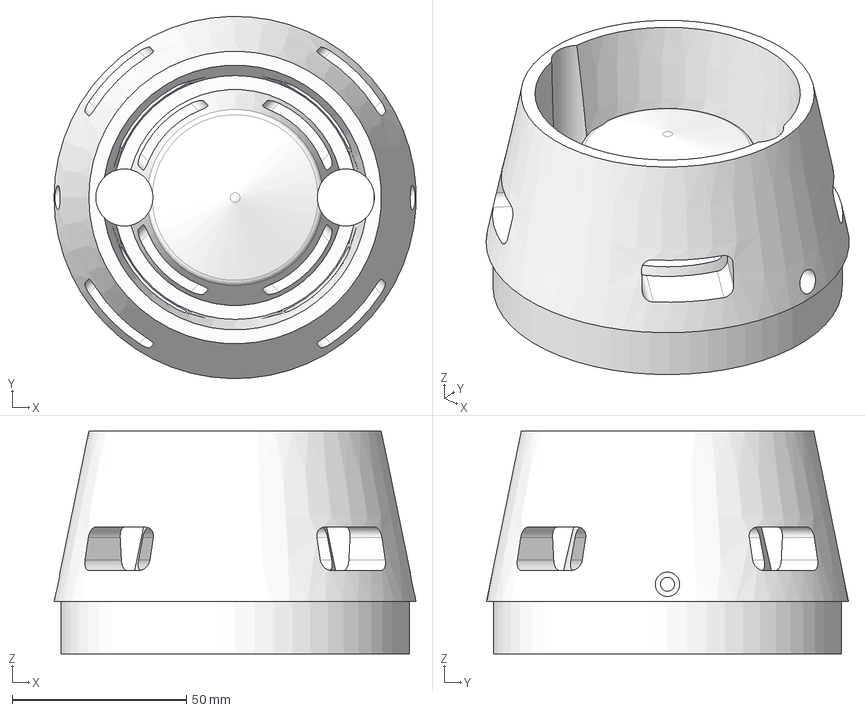
[picture p257: CAD file, 2025-10-19]
PMI/SEPA_Maxens/V0/STEP/SP02_ALPHAV3_SEPA_PRINCIPALE.step
103.9 x 104.0 x 64.0 mm
