povdoigt/SP-02/CATIA/CATIA_vol/Carte_elec_finales/Bloc_ELEC_Etage2_Batteries_v2.stl

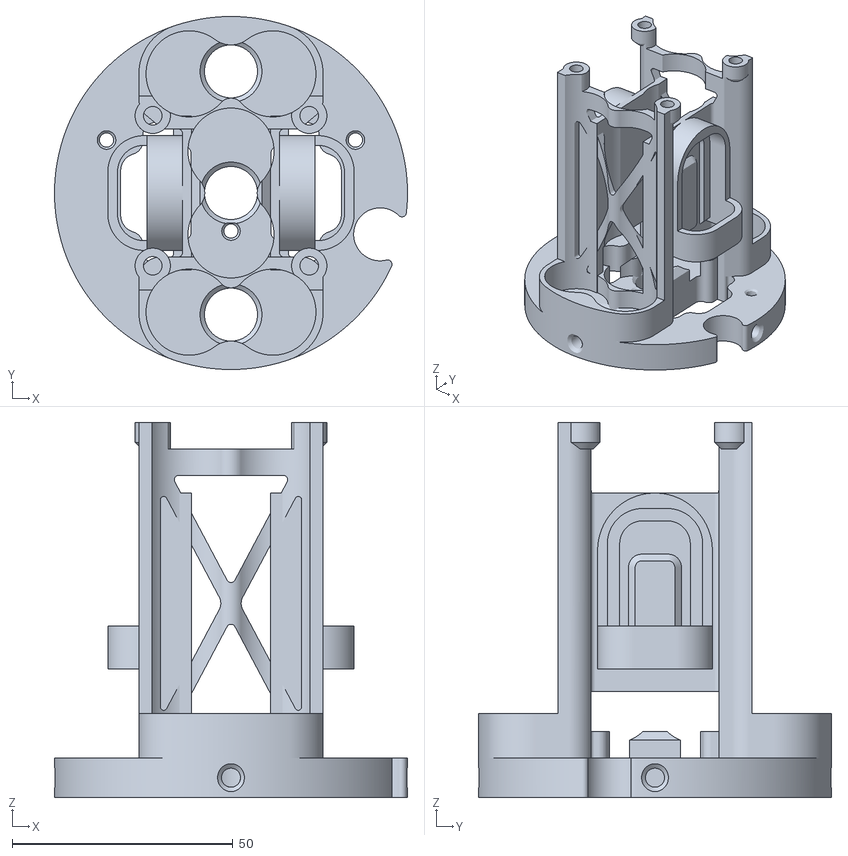
[picture p258: CAD file, 2026-07-09]
CATIA/CATIA_vol/Carte_elec_finales/Bloc_ELEC_Etage2_Batteries_v2.stl
80.0 x 80.0 x 85.0
