povdoigt/SP-02/CATIA/CATIA_vol/SP02.stp

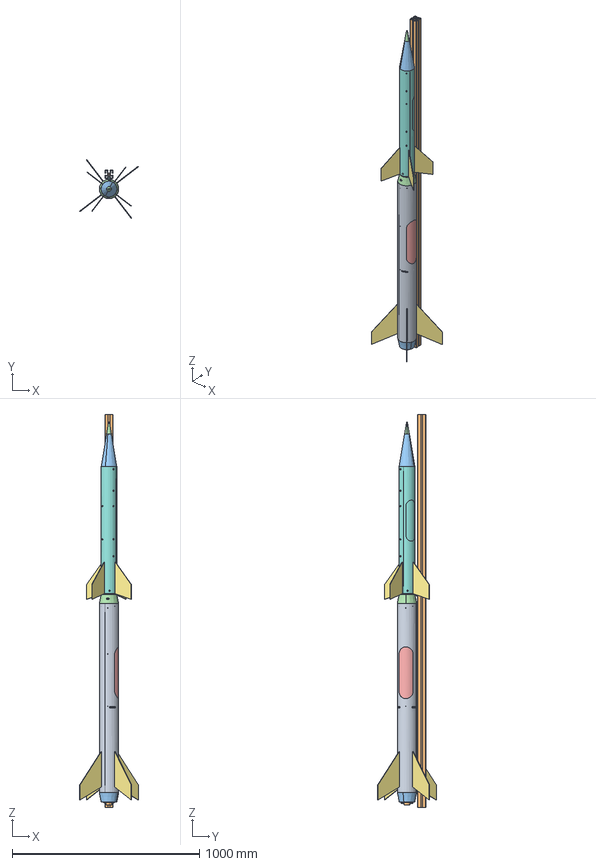
[picture p259: CAD file, 2026-07-09]
CATIA/CATIA_vol/SP02.stp
315.0 x 315.0 x 2100.0 mm
SP02_BETA_BLOC_ELEC
SP02_BETA_BLOC_MYSTERE
