povdoigt/SP-02/CATIA/CATIA_vol/SP02_ALPHA/Alpha_Support_Cage.3mf

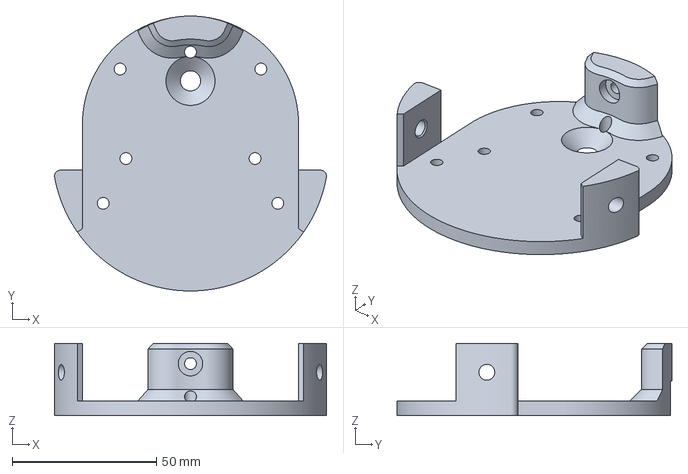
[picture p260: CAD file, 2026-07-09]
CATIA/CATIA_vol/SP02_ALPHA/Alpha_Support_Cage.3mf
94.4 x 95.4 x 25.0 mm
