povdoigt/SP-02/CATIA/CATIA_vol/SP02_ALPHA/SP02_ALPHA_AF/STEP/SP02_ALPHA_AF_BLOC_AF.stp

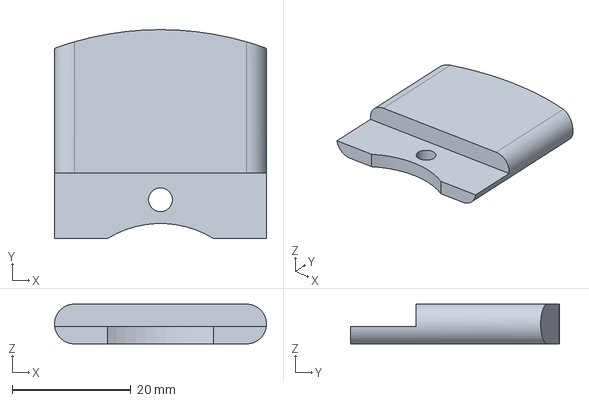
[picture p261: CAD file, 2026-07-09]
CATIA/CATIA_vol/SP02_ALPHA/SP02_ALPHA_AF/STEP/SP02_ALPHA_AF_BLOC_AF.stp
35.7 x 35.2 x 6.70 mm
