povdoigt/SP-02/CATIA/CATIA_vol/Usinage/Guide_trous_Interface_Etage2.stl

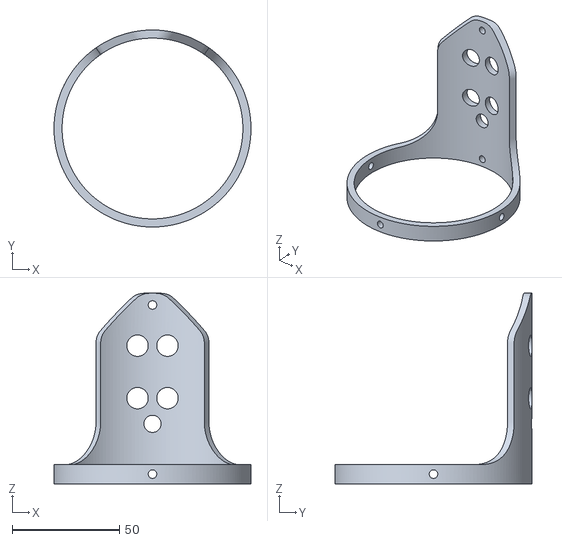
[picture p262: CAD file, 2026-07-09]
CATIA/CATIA_vol/Usinage/Guide_trous_Interface_Etage2.stl
92.0 x 92.0 x 89.0
