povdoigt/SP-02/CATIA/new_catia/bague1.stp

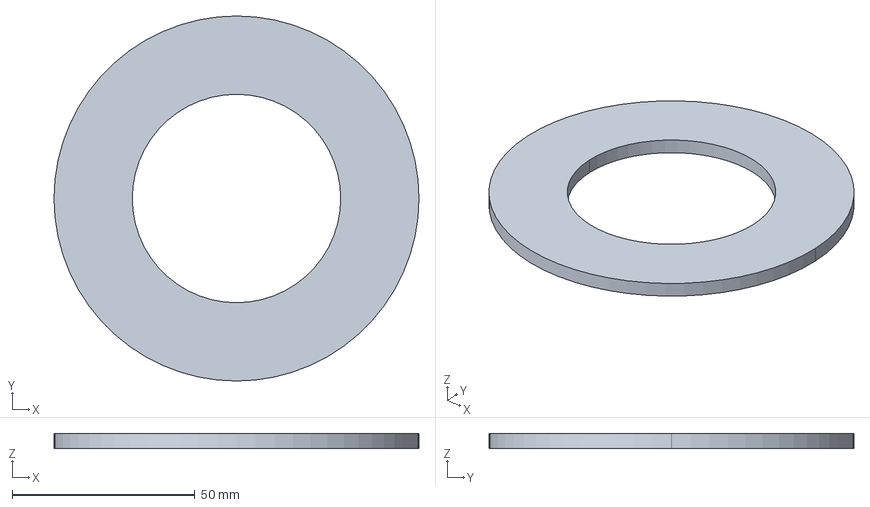
[picture p263: CAD file, 2026-06-02]
CATIA/new_catia/bague1.stp
100.0 x 100.0 x 4.00 mm
