povdoigt/SP-02/IMPRESSION/impression_top_secret _V2/SP02_ALPHA_SEPA_RONDELLE_RESSORT.stp

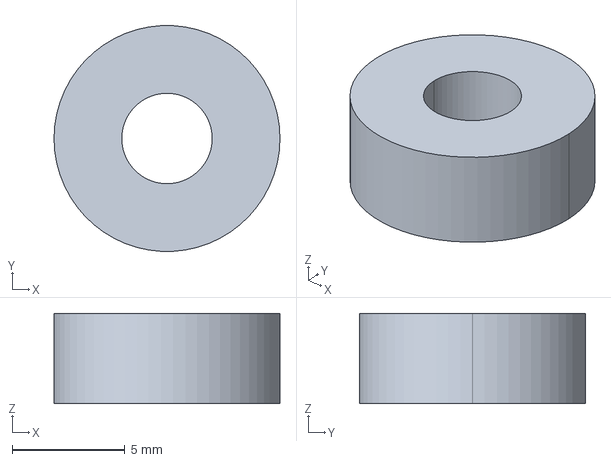
[picture p264: CAD file, 2025-10-19]
IMPRESSION/impression_top_secret _V2/SP02_ALPHA_SEPA_RONDELLE_RESSORT.stp
10.0 x 9.99 x 4.00 mm
