povdoigt/SP-02/IMPRESSION/impression_top_secret/SP02_ALPHA_SEPA_BIELLE_LOQUET_PRINCIPAL.stl

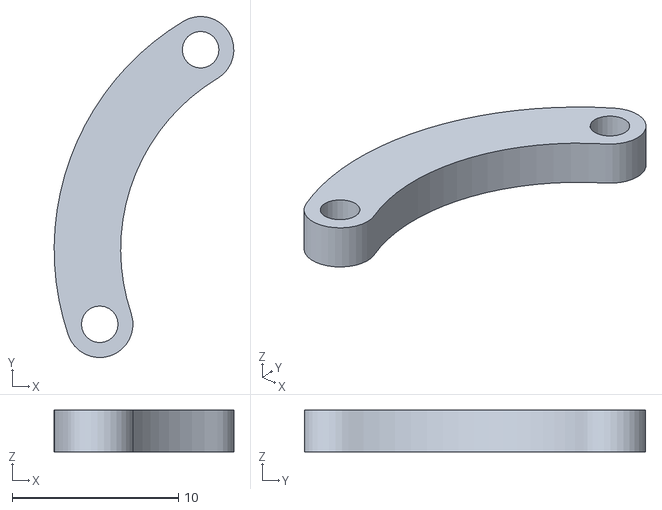
[picture p265: CAD file, 2025-10-19]
IMPRESSION/impression_top_secret/SP02_ALPHA_SEPA_BIELLE_LOQUET_PRINCIPAL.stl
10.8 x 20.5 x 2.50
