povdoigt/SP-02/PMI/SEPA_Maxens/V0/STEP/SP02_ALPHAV3_SEPA_VERROU.step

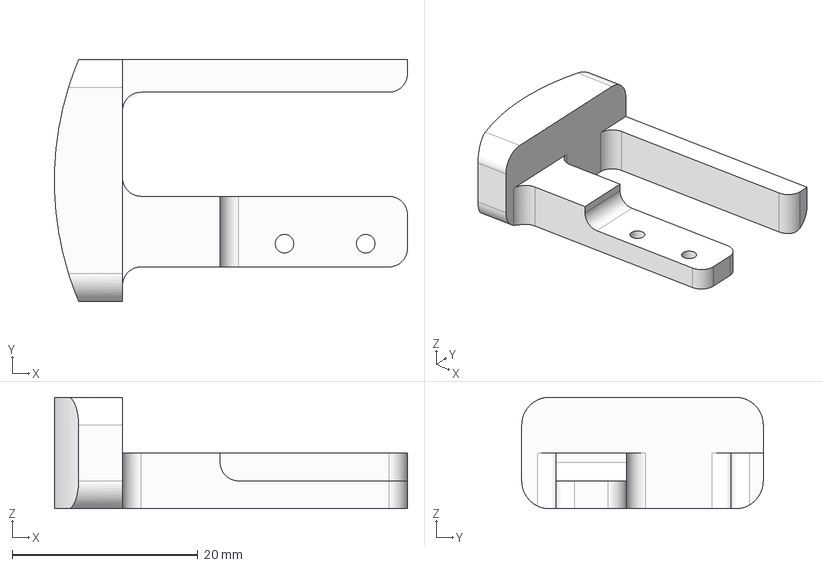
[picture p266: CAD file, 2025-10-19]
PMI/SEPA_Maxens/V0/STEP/SP02_ALPHAV3_SEPA_VERROU.step
38.0 x 26.0 x 12.0 mm
