povdoigt/SP-02/CATIA/CATIA_vol/Carte_elec_finales/3D_PCB_PCB_SP02_IHF_2_V1_2026-04-19_2026-04-19.step

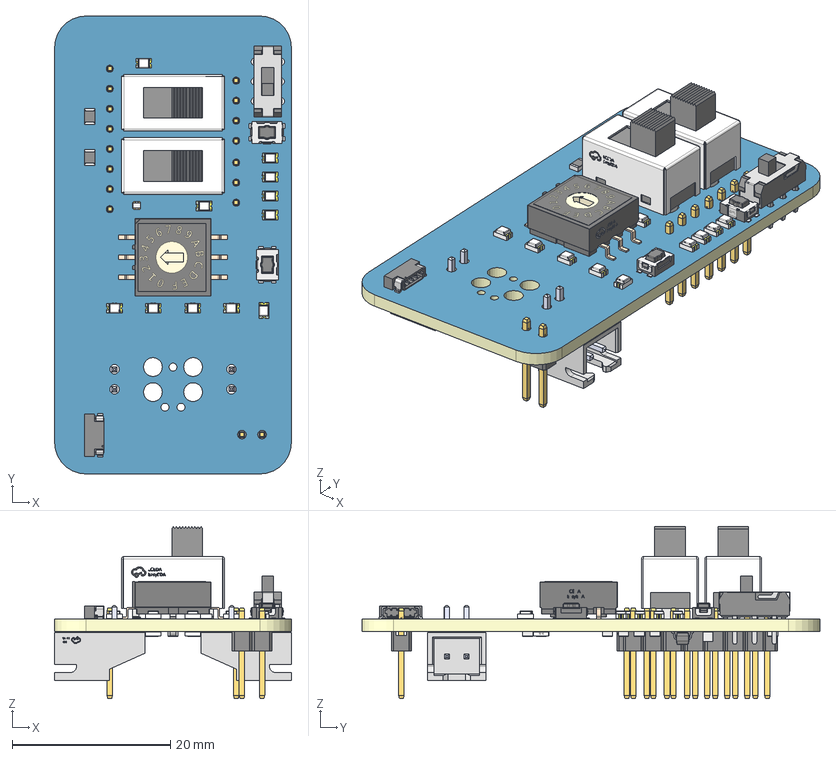
[picture p267: CAD file, 2026-07-09]
CATIA/CATIA_vol/Carte_elec_finales/3D_PCB_PCB_SP02_IHF_2_V1_2026-04-19_2026-04-19.step
30.0 x 58.0 x 21.8 mm
Board~iaXJ
TopCopper~iaXJ
BottomCopper~iaXJ
TopFpcStiffener~iaXJ
BottomFpcStiffener~iaXJ
R0805~R0805_L2.0-W1.3-H0.6~iaXJ x 16
C0805~C0805_L2.0-W1.3-H1.3~iaXJ
SOT-23-6_L2.9-W1.6-P0.95-LS2.8-BR~SOT-23-6_ L2.9-W1.6-H1.5-LS2.8-P0.95~iaXJ
LED0805-R-RD~LED0805-RD~iaXJ x 11
HDR-M-2.54_1X3~HDR-M-2.54_1x3~iaXJ
CONN-TH_S2B-XH-A-1-LF-SN~CONN-TH_S2B-XH-A-1-LF-SN~iaXJ x 2
HDR-M-2.54_1X4~HDR-M-2.54_1x4~iaXJ
HDR-M-2.54_1X8~HDR-M-2.54_1x8~iaXJ
SW-TH_XKB_SS-12M11XX~SW-TH_XKB_SS-12M11XX~iaXJ x 2
SW-SMD_RM3AF-16R-V-B~SW-SMD_RM3AF-16R-V-B~iaXJ
LED-ARRAY-SMD_4P-L1.00-W1.00-TR~LED1010-4P_L1.0-W1.0-H0.2-LS1.0~iaXJ
KEY-SMD_KMR2XXGXXX~KEY-SMD_5P-L4.2-W2.8-H1.9-LS4.6-P1.6~iaXJ x 2
HDR-M-2.54_1X2~HDR-M-2.54_1x2~iaXJ
SW-TH_MS-22D10-G020~SW-TH_MS-22D10-G020~iaXJ
CONN-SMD_2147210040~CONN-SMD_2147210040~iaXJ
