povdoigt/SP-02/CATIA/CATIA_vol/SP02_ALPHA/SP02_ALPHA_AF/STEP/SP02_ALPHA_AF_BLOC_RONDELLE.stp

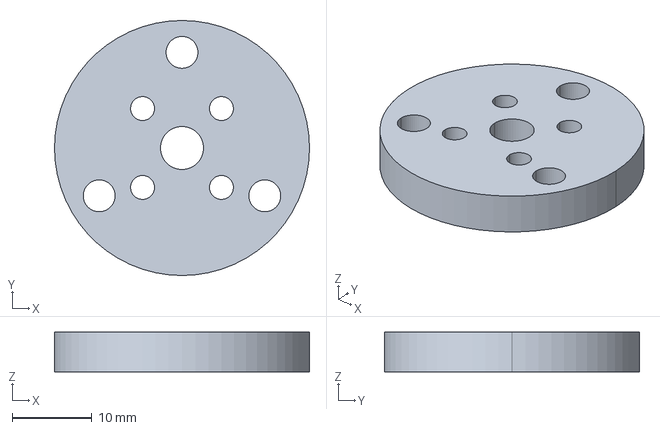
[picture p268: CAD file, 2026-07-09]
CATIA/CATIA_vol/SP02_ALPHA/SP02_ALPHA_AF/STEP/SP02_ALPHA_AF_BLOC_RONDELLE.stp
32.0 x 32.0 x 5.00 mm
