povdoigt/SP-02/CATIA/CATIA_vol/SP02_ALPHA5_SEPA2_LOQUET.stl

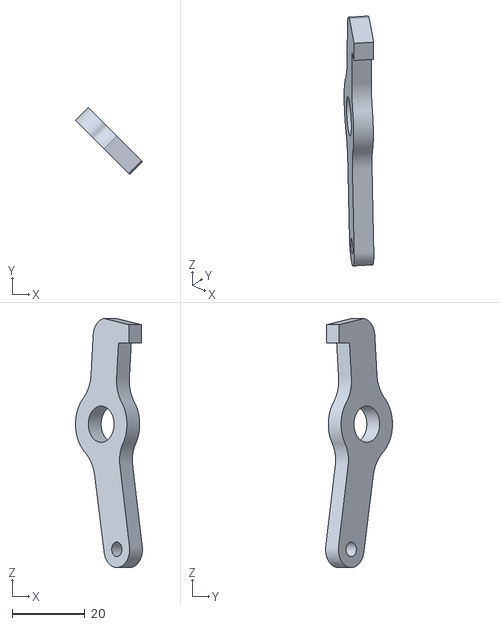
[picture p269: CAD file, 2026-07-09]
CATIA/CATIA_vol/SP02_ALPHA5_SEPA2_LOQUET.stl
18.4 x 18.4 x 68.6
