povdoigt/SP-02/CATIA/CATIA_vol/SP02_BETA/Bague_centrage_propu_24_v3.stl

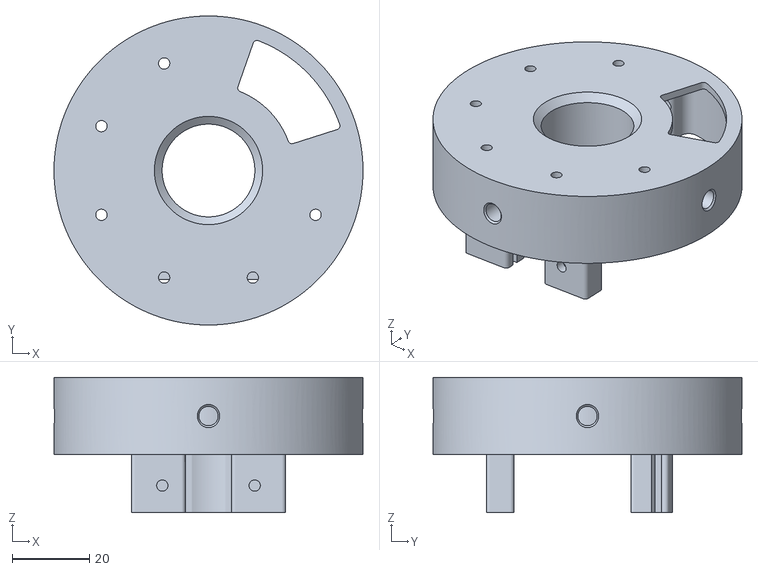
[picture p270: CAD file, 2026-07-09]
CATIA/CATIA_vol/SP02_BETA/Bague_centrage_propu_24_v3.stl
80.0 x 80.0 x 35.0
