povdoigt/SP-02/CATIA/CATIA_vol/Usinage/SP02_BETA_Moule-Negatif-Coupleur.3mf

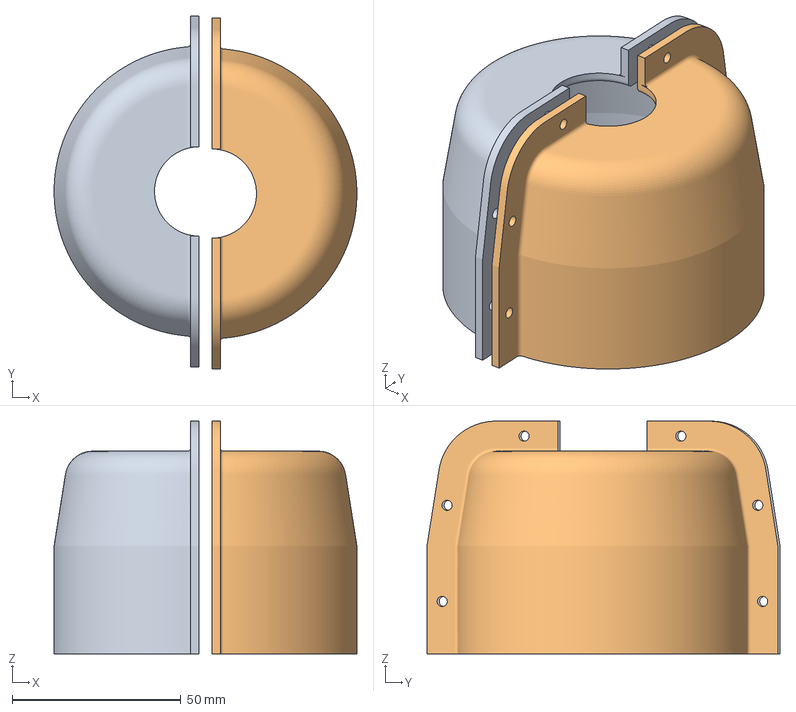
[picture p271: CAD file, 2026-07-09]
CATIA/CATIA_vol/Usinage/SP02_BETA_Moule-Negatif-Coupleur.3mf
89.6 x 104.5 x 68.9 mm
SP02_BETA_Moule-Negatif-Coupleur.stl x 2
