povdoigt/SP-02/CATIA/new_catia/PATANT2.stp

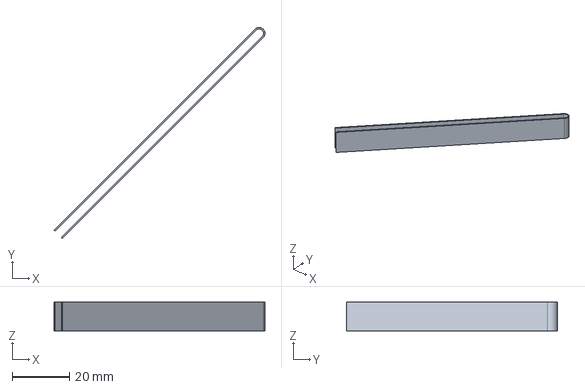
[picture p272: CAD file, 2026-06-02]
CATIA/new_catia/PATANT2.stp
73.9 x 73.9 x 10.0 mm
