povdoigt/SP-02/CATIA/new_catia/SP02_ALPHA/SP02_ALPHA_AF/STEP/SP02_ALPHA_AF_BLOC_SUPPORT_SERVO.stp

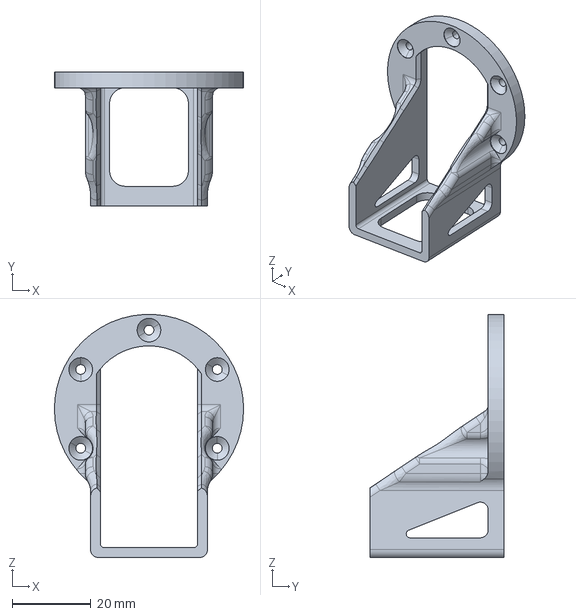
[picture p273: CAD file, 2026-06-02]
CATIA/new_catia/SP02_ALPHA/SP02_ALPHA_AF/STEP/SP02_ALPHA_AF_BLOC_SUPPORT_SERVO.stp
48.0 x 34.0 x 61.7 mm
