povdoigt/SP-02/IMPRESSION/impression_top_secret _V2/SP02_ALPHA_SEPA_COUPLEUR.stp

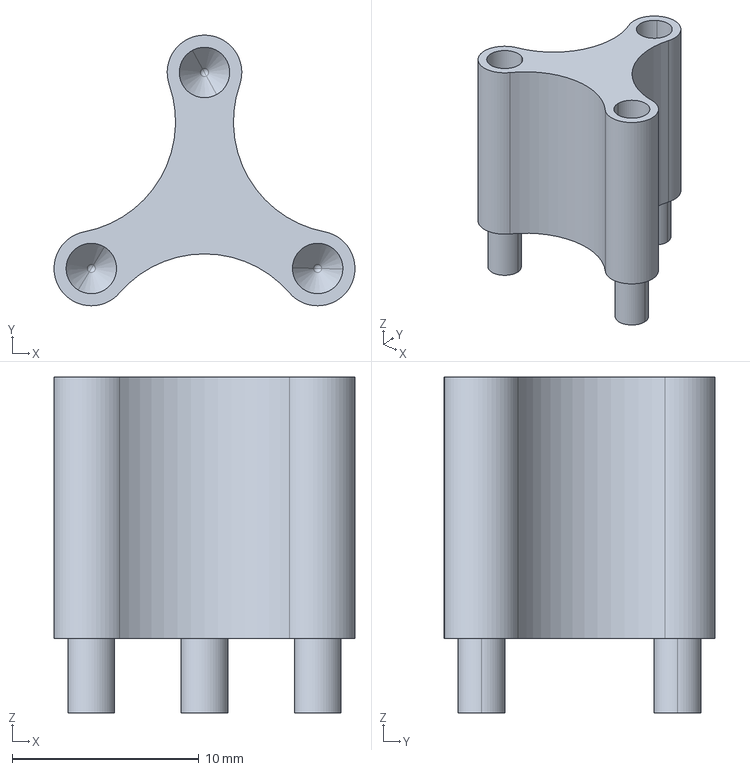
[picture p274: CAD file, 2025-10-19]
IMPRESSION/impression_top_secret _V2/SP02_ALPHA_SEPA_COUPLEUR.stp
16.1 x 14.5 x 18.0 mm
