povdoigt/SP-02/IMPRESSION/impression_top_secret/SP02_ALPHA_SEPA_TIGE_RESSORT.stl

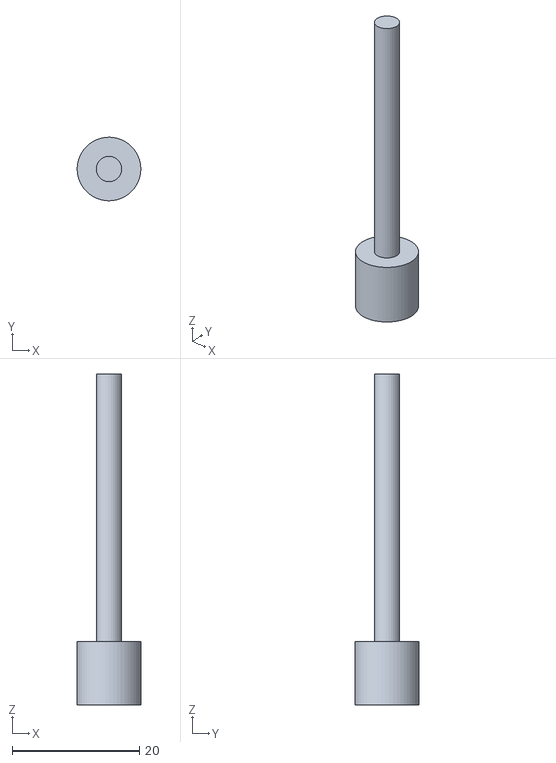
[picture p275: CAD file, 2025-10-19]
IMPRESSION/impression_top_secret/SP02_ALPHA_SEPA_TIGE_RESSORT.stl
9.98 x 10.00 x 52.0
