povdoigt/SP-02/PMI/SEPA_Maxens/V0/STEP/SP02_BETAV3_SPEA.step

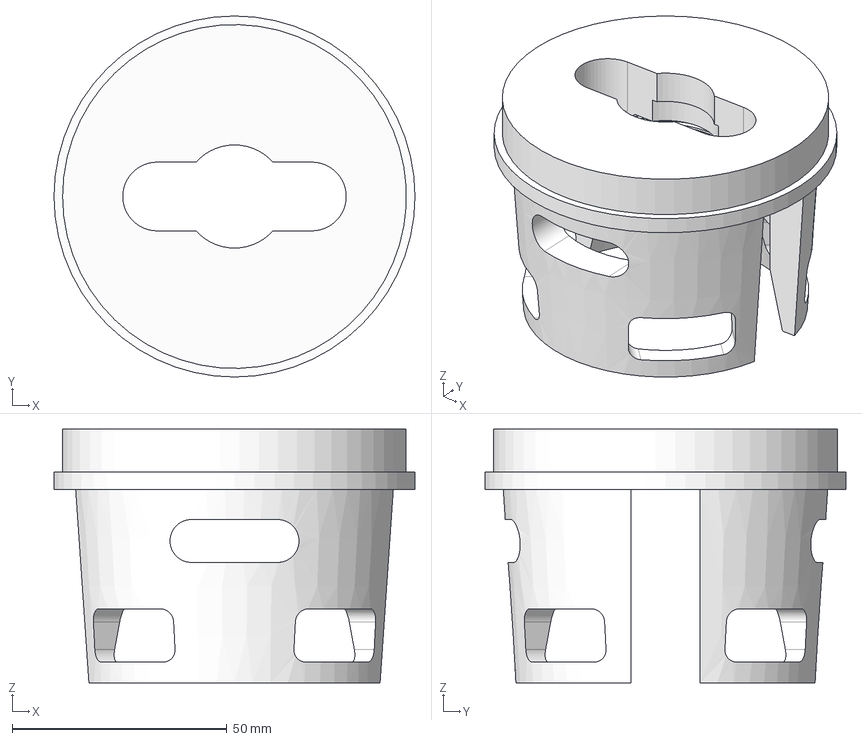
[picture p276: CAD file, 2025-10-19]
PMI/SEPA_Maxens/V0/STEP/SP02_BETAV3_SPEA.step
84.0 x 84.0 x 59.0 mm
