povdoigt/SP-02/CATIA/CATIA_vol/Carte_elec_finales/3D_PCB_PCB_SP02_APEX_EX_2026-04-20_2026-04-20.step

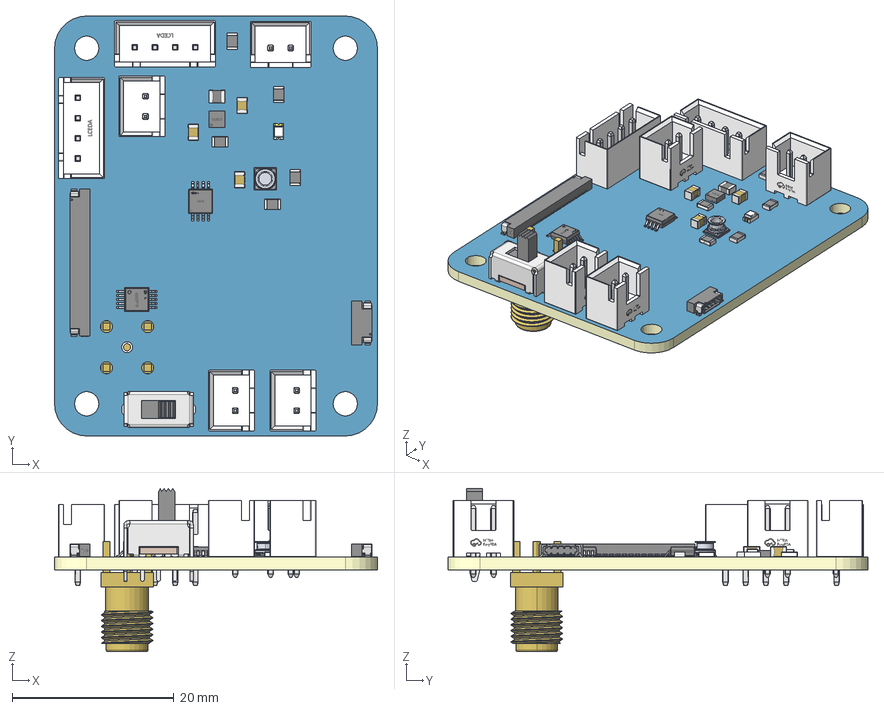
[picture p277: CAD file, 2026-07-09]
CATIA/CATIA_vol/Carte_elec_finales/3D_PCB_PCB_SP02_APEX_EX_2026-04-20_2026-04-20.step
40.0 x 52.0 x 20.2 mm
Board~7Q6T
TopCopper~7Q6T
BottomCopper~7Q6T
TopFpcStiffener~7Q6T
BottomFpcStiffener~7Q6T
CONN-TH_B2B-XH-A-LF-SN~XH2.5-2A~7Q6T x 4
R0805~R0805_L2.0-W1.3-H0.6~7Q6T x 5
CONN-SMD_2147210040~CONN-SMD_2147210040~7Q6T
LED0805-R-RD~LED0805-RD~7Q6T
CONN-TH_B4B-XH-AM-LF-SN~CONN-TH_XH2.50-LI-4P~7Q6T x 2
WSON-8_L2.0-W2.0-P0.50-TL-EP~WSON-8_L2.0-W2.0-H0.8-P0.50~7Q6T
C0805~C0805_L2.0-W1.3-H1.3~7Q6T x 3
VSSOP-10_L3.0-W3.0-P0.50-LS4.9-BL~VSSOP-10_ L3.0-W3.0-H1.1-LS4.9-P0.50~7Q6T
CONN-SMD_20P-P0.80_2147210200~CONN-SMD_20P-P0.80_2147210200~7Q6T
SMA-TH_BWSMA-KE-Z001~SMA-TH_5P-L6.5-W6.5-H9.8_BWSMA-KE-Z001~7Q6T
SMD_L2.8-W2.8_ILPS28QSWTR~SMD_L2.8-W2.8_ILPS28QSWTR~7Q6T
SW-TH_SS-12D07-X-X~SW-TH_SS-12D07-X-X~7Q6T x 2
TSSOP-8_L3.0-W3.0-P0.65-LS4.9-BL~TSSOP-8_ L3.0-W3.0-H1.1-LS4.9-P0.65~7Q6T
L0806~L0806_L2.0-W1.6-H1.0~7Q6T
