povdoigt/SP-02/CATIA/CATIA_vol/SP02_ALPHA/SP02_ALPHA_AF/STEP/SP02_ALPHA_AF_BLOC_BAGUE0.stp

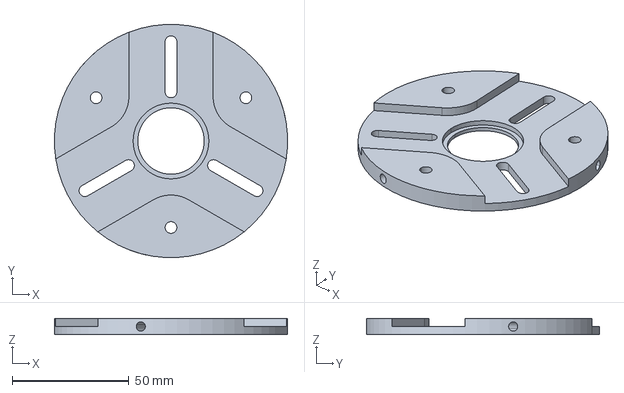
[picture p278: CAD file, 2026-07-09]
CATIA/CATIA_vol/SP02_ALPHA/SP02_ALPHA_AF/STEP/SP02_ALPHA_AF_BLOC_BAGUE0.stp
99.7 x 99.7 x 7.00 mm
