povdoigt/SP-02/CATIA/CATIA_vol/SP02_ALPHA/Support_Servo_Para_1_v9.stl

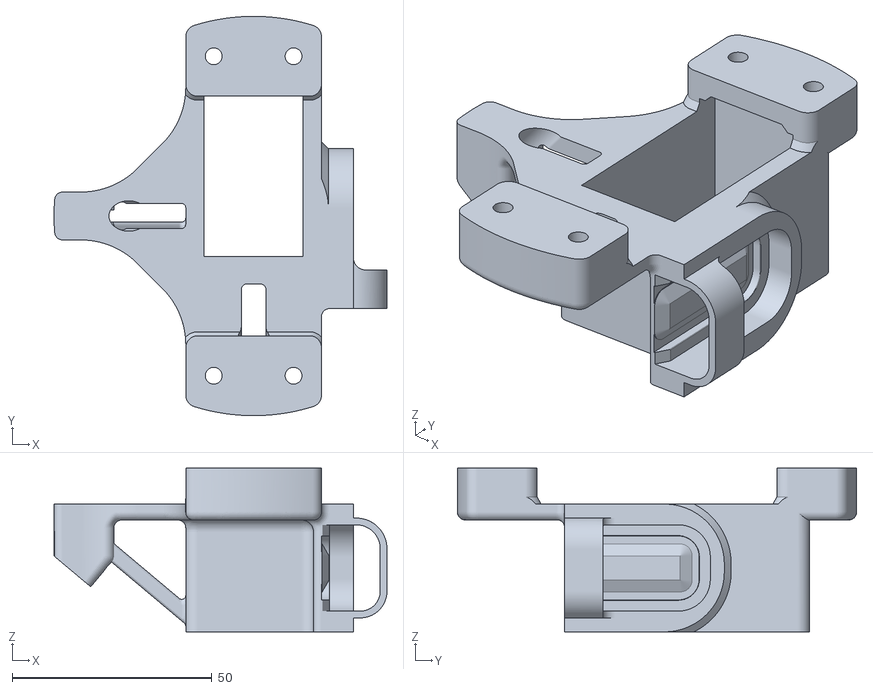
[picture p279: CAD file, 2026-07-09]
CATIA/CATIA_vol/SP02_ALPHA/Support_Servo_Para_1_v9.stl
83.4 x 100.0 x 41.0
