povdoigt/SP-02/CATIA/CATIA_vol/Usinage/coiffymin_sp.stl

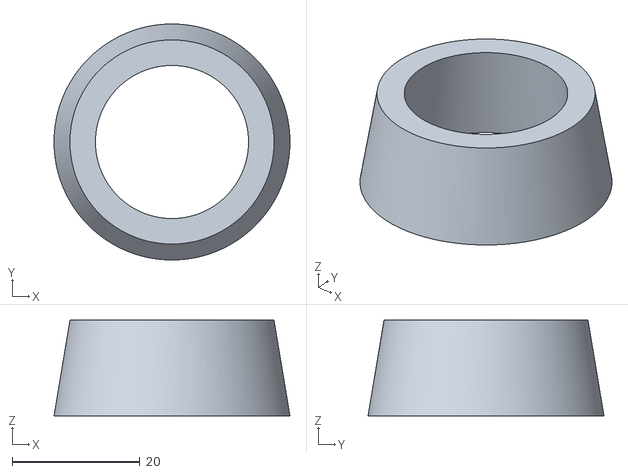
[picture p280: CAD file, 2026-07-09]
CATIA/CATIA_vol/Usinage/coiffymin_sp.stl
37.0 x 37.0 x 15.0
