povdoigt/SP-02/CATIA/new_catia/PONSEUR_AILERON.stp

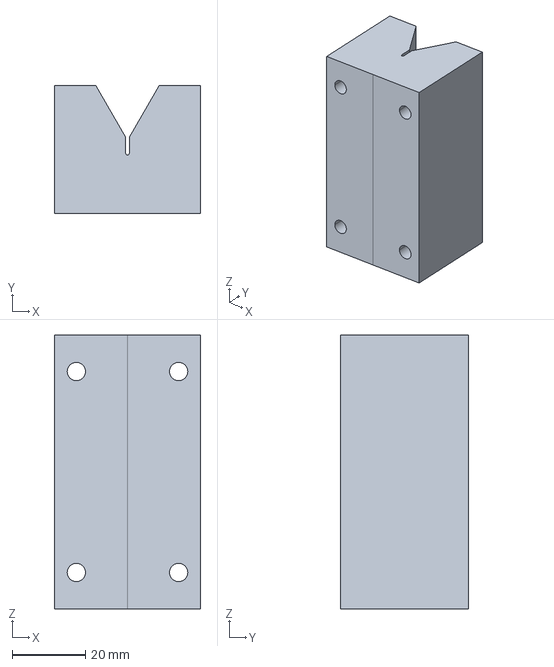
[picture p281: CAD file, 2026-06-02]
CATIA/new_catia/PONSEUR_AILERON.stp
40.0 x 35.0 x 75.0 mm
