povdoigt/SP-02/IMPRESSION/impression_top_secret _V2/SP02_BETA_BAGUE_PROPU.stl

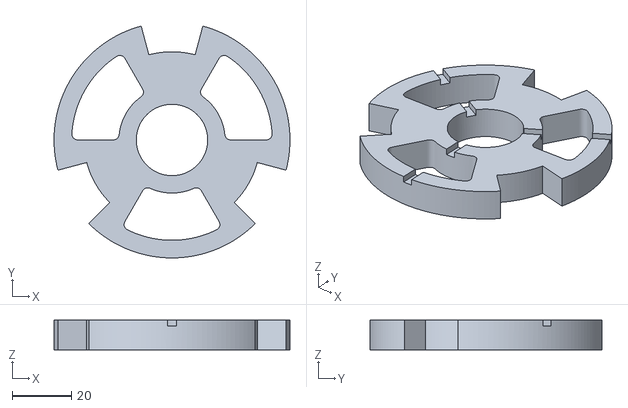
[picture p282: CAD file, 2025-10-19]
IMPRESSION/impression_top_secret _V2/SP02_BETA_BAGUE_PROPU.stl
80.0 x 78.6 x 10.0
