povdoigt/SP-02/IMPRESSION/impression_top_secret/SP02_ALPHA_SEPA_COUPLEUR.stl

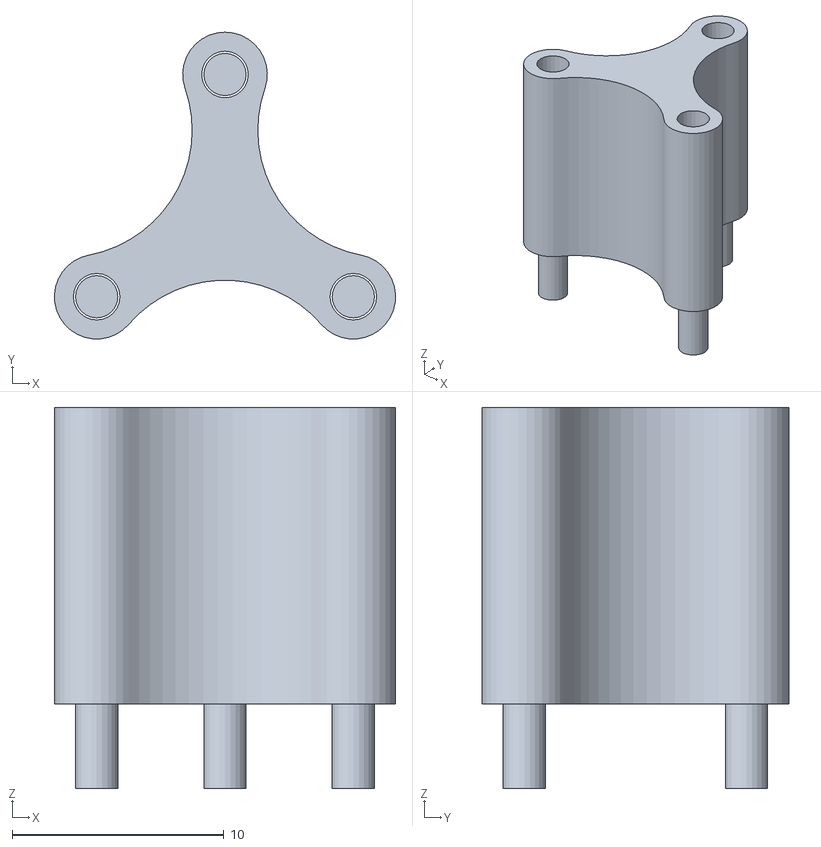
[picture p283: CAD file, 2025-10-19]
IMPRESSION/impression_top_secret/SP02_ALPHA_SEPA_COUPLEUR.stl
16.1 x 14.5 x 18.0
