povdoigt/SP-02/CATIA/CATIA_vol/SP02_BETA/SP02_BETA_COIFFE.3mf

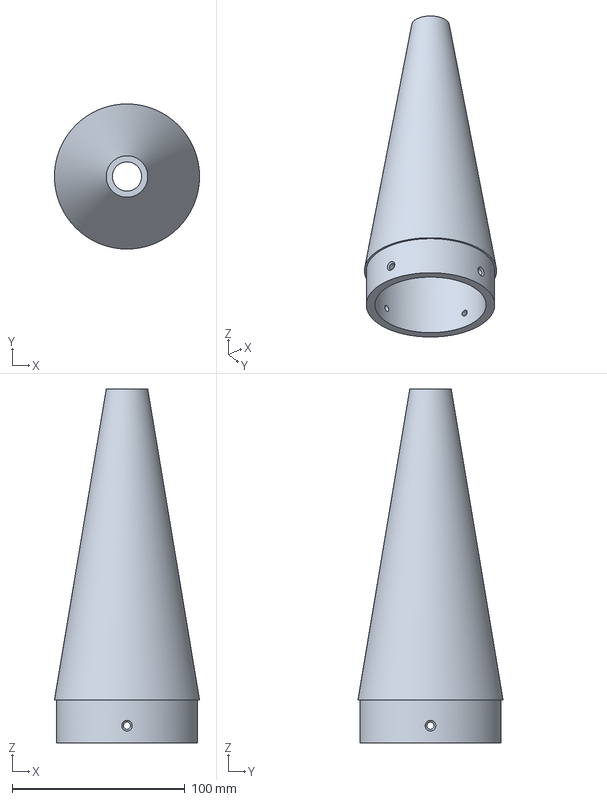
[picture p285: CAD file, 2026-07-09]
CATIA/CATIA_vol/SP02_BETA/SP02_BETA_COIFFE.3mf
84.0 x 84.0 x 205.0 mm
