povdoigt/SP-02/CATIA/CATIA_vol/Usinage/Moule coiffe SP.3mf

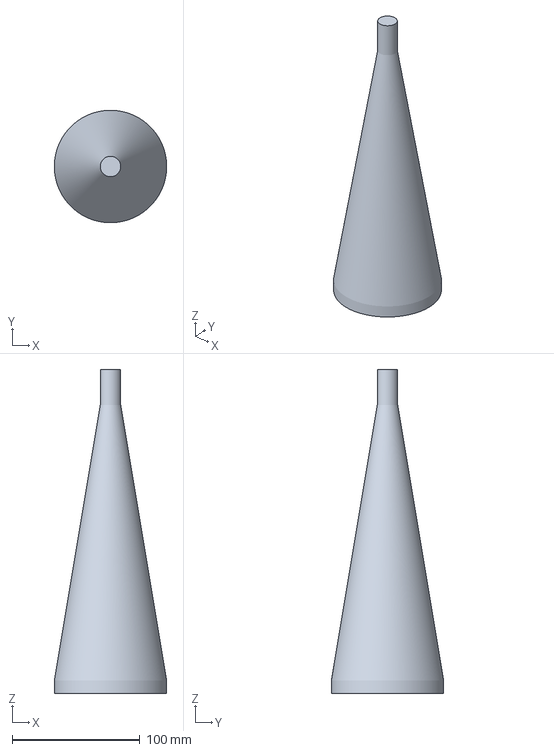
[picture p286: CAD file, 2026-07-09]
CATIA/CATIA_vol/Usinage/Moule coiffe SP.3mf
88.1 x 88.1 x 254.0 mm
