povdoigt/SP-02/CATIA/new_catia/PATANT.stp

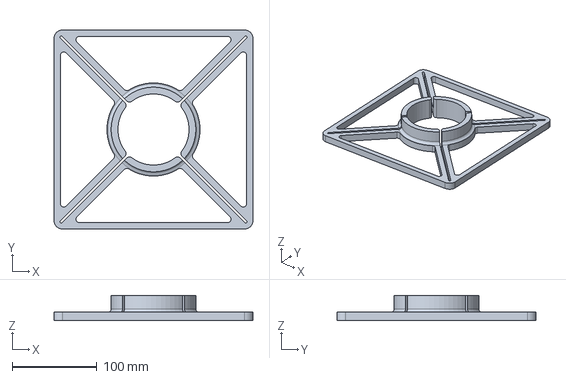
[picture p287: CAD file, 2026-06-02]
CATIA/new_catia/PATANT.stp
235.0 x 235.0 x 30.0 mm
