povdoigt/SP-02/IMPRESSION/impression_top_secret _V2/SP02_SEPA.3mf

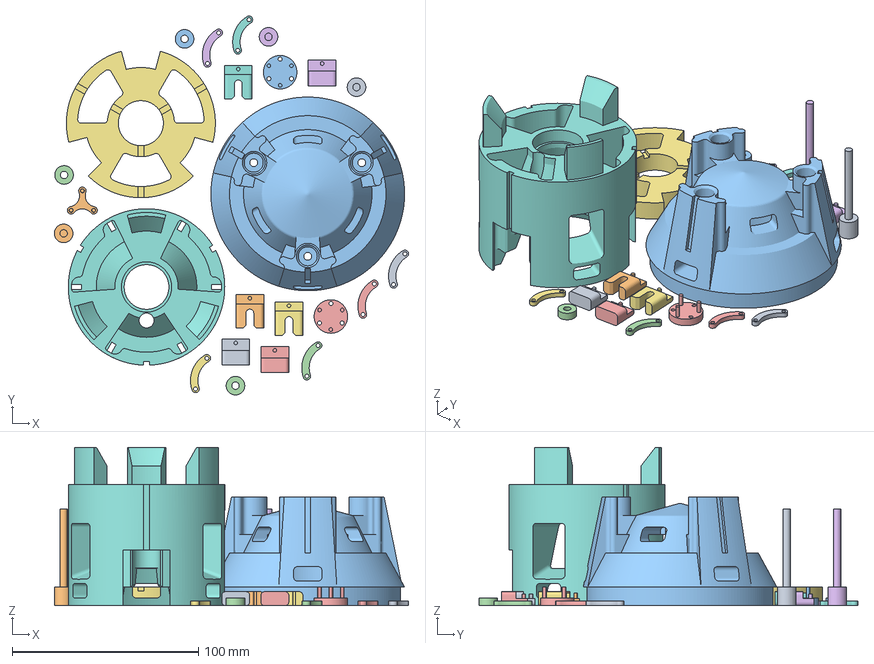
[picture p288: CAD file, 2025-10-19]
IMPRESSION/impression_top_secret _V2/SP02_SEPA.3mf
190.2 x 203.5 x 85.0 mm
SP02_ALPHA_SEPA_LOQUET_PRINCIPAL.stl x 3
SP02_ALPHA_SEPA_LOQUET_RESSORT.stl x 3
SP02_ALPHA_SEPA_PRINCIPALE.stl
SP02_ALPHA_SEPA_RONDELLE_RESSORT.stl x 3
SP02_ALPHA_SEPA_ROULETTE.stl x 2
SP02_ALPHA_SEPA_TIGE_RESSORT.stl x 3
SP02_BETA_BAGUE_PROPU.stl
SP02_BETA_SEPA_PRINCIPALE_v2.stl
SP02_ALPHA_SEPA_BIELLE_LOQUET_PRINCIPAL.stl x 6
SP02_ALPHA_SEPA_COUPLEUR.stl
