povdoigt/SP-02/CATIA/CATIA_vol/SP02_ALPHA/SP02_ALPHA_TUBEessai.stl

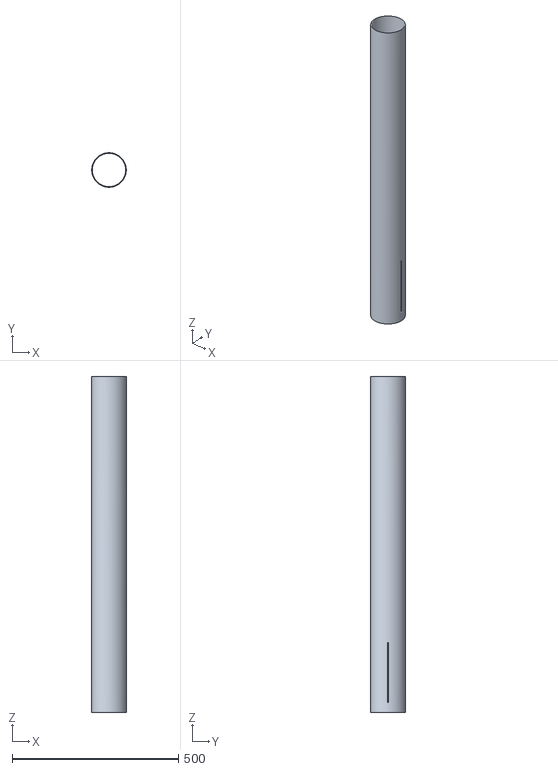
[picture p289: CAD file, 2026-07-09]
CATIA/CATIA_vol/SP02_ALPHA/SP02_ALPHA_TUBEessai.stl
104.0 x 104.0 x 1010.0
