povdoigt/SP-02/CATIA/CATIA_vol/Usinage/coiffymax_sp.stl

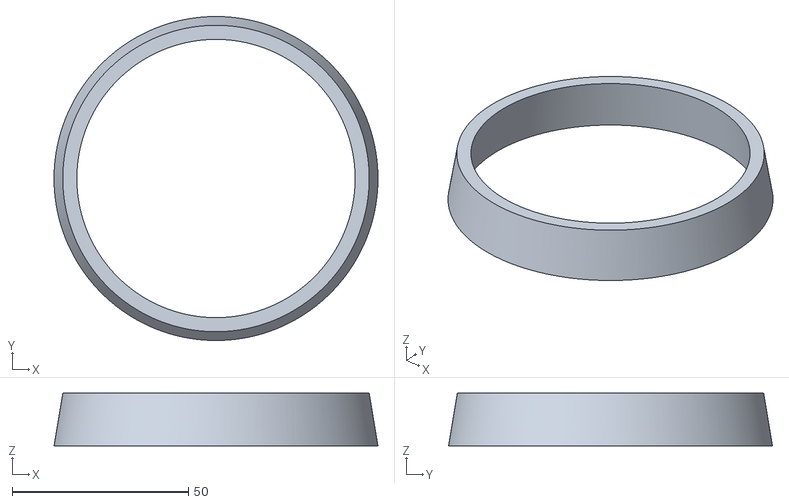
[picture p290: CAD file, 2026-07-09]
CATIA/CATIA_vol/Usinage/coiffymax_sp.stl
92.0 x 92.0 x 15.0
