povdoigt/SP-02/CATIA/new_catia/bague2.stp

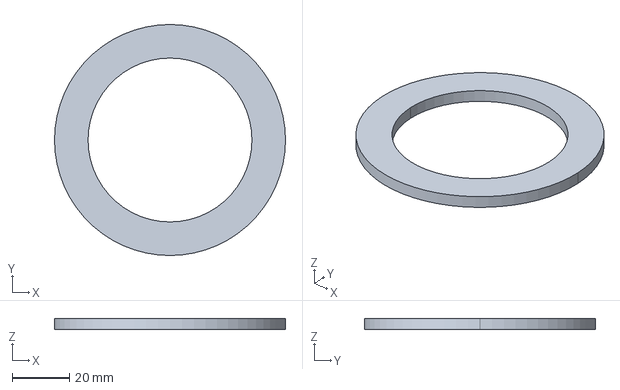
[picture p291: CAD file, 2026-06-02]
CATIA/new_catia/bague2.stp
80.5 x 80.5 x 4.00 mm
