povdoigt/SP-02/IMPRESSION/impression_top_secret _V2/SP02_ALPHA_SEPA_FAT_ROULETTE.stp

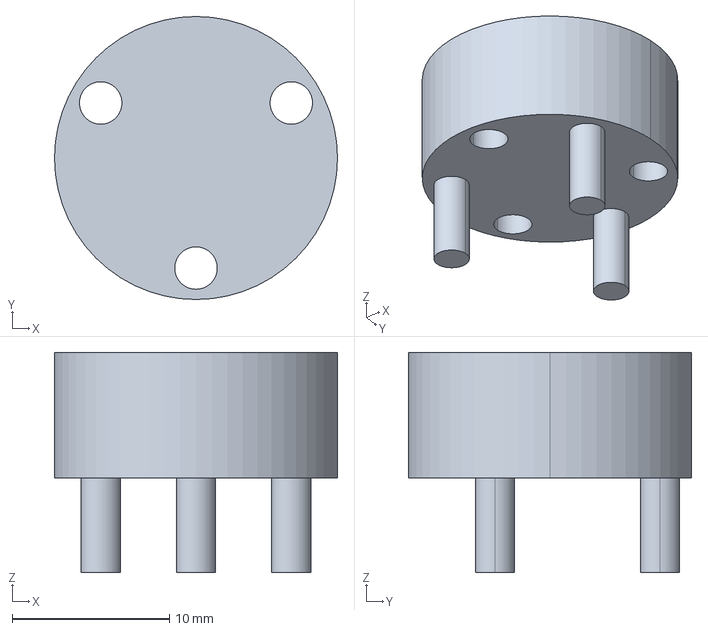
[picture p292: CAD file, 2025-10-19]
IMPRESSION/impression_top_secret _V2/SP02_ALPHA_SEPA_FAT_ROULETTE.stp
18.0 x 18.0 x 14.0 mm
