povdoigt/SP-02/IMPRESSION/impression_top_secret/SP02_ALPHA_SEPA_LOQUET_PRINCIPAL.stl

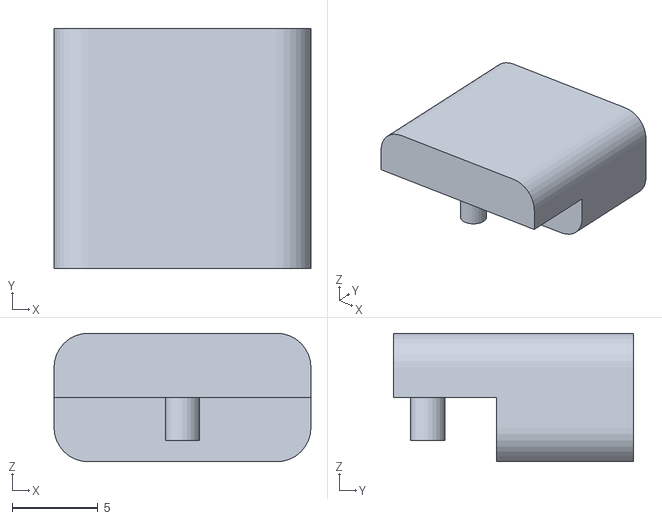
[picture p293: CAD file, 2025-10-19]
IMPRESSION/impression_top_secret/SP02_ALPHA_SEPA_LOQUET_PRINCIPAL.stl
15.0 x 14.0 x 7.50
