povdoigt/SP-02/CATIA/CATIA_vol/Carte_elec_finales/Bloc_ELEC_Etage1.3mf

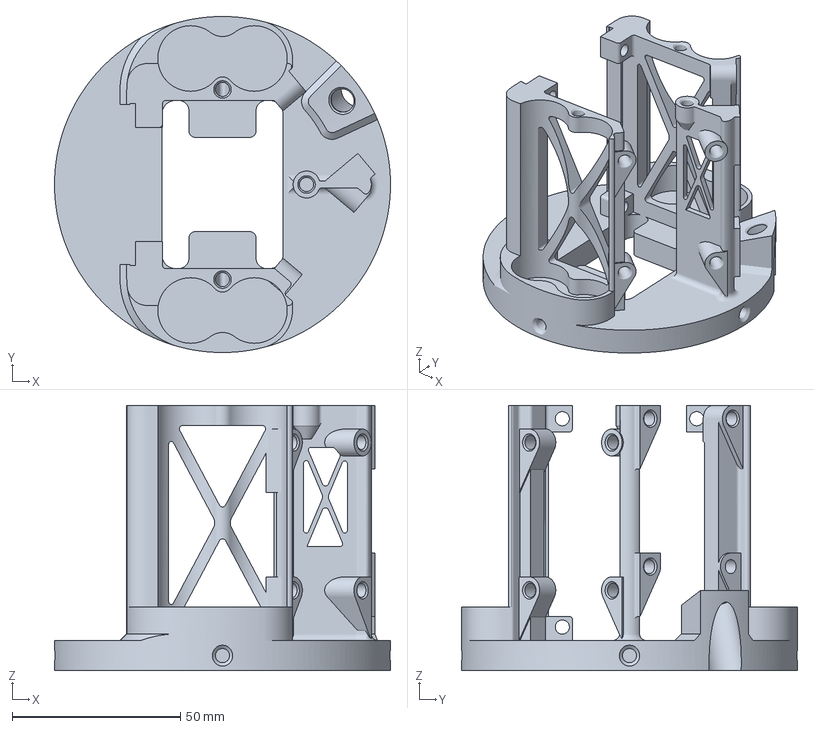
[picture p294: CAD file, 2026-07-09]
CATIA/CATIA_vol/Carte_elec_finales/Bloc_ELEC_Etage1.3mf
100.0 x 100.0 x 79.0 mm
