povdoigt/SP-02/CATIA/CATIA_vol/Usinage/SP02_BETA_Moule-Coupleur-v2.stl

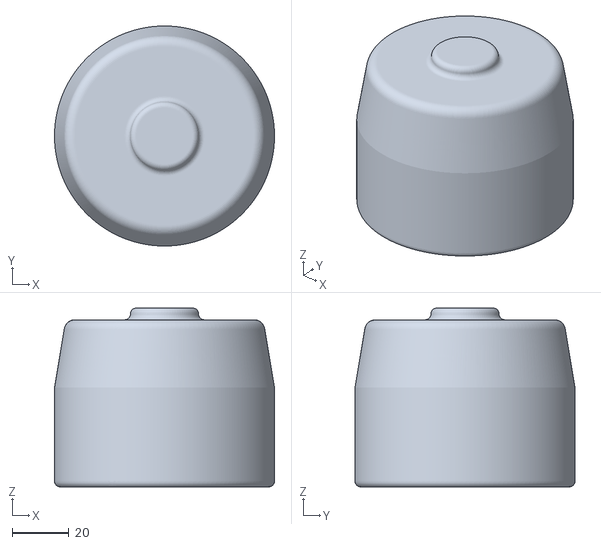
[picture p296: CAD file, 2026-07-09]
CATIA/CATIA_vol/Usinage/SP02_BETA_Moule-Coupleur-v2.stl
77.4 x 77.4 x 62.9
