povdoigt/SP-02/CATIA/new_catia/PONSEUR_AILERON_GUIDE_3.stp

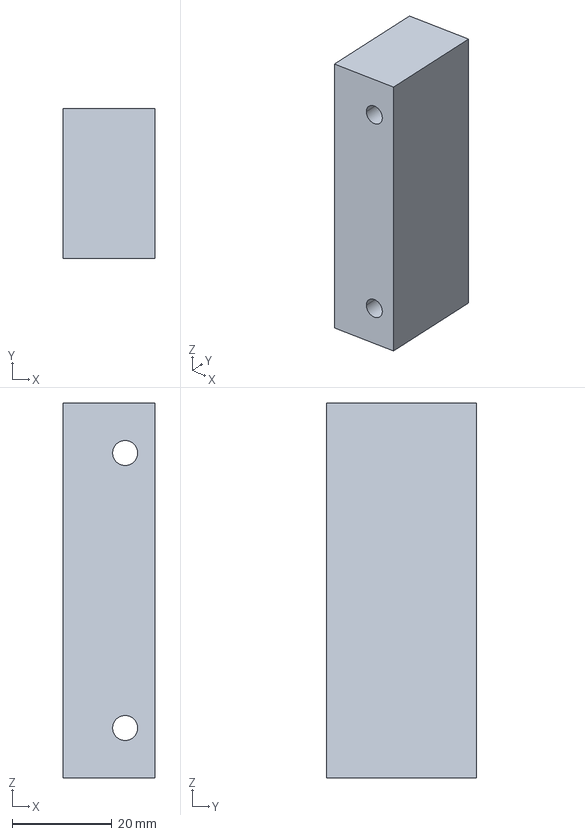
[picture p297: CAD file, 2026-06-02]
CATIA/new_catia/PONSEUR_AILERON_GUIDE_3.stp
18.4 x 30.0 x 75.0 mm
