povdoigt/SP-02/CATIA/new_catia/SP02_ALPHA/SP02_ALPHA_AF/STEP/flemdenommer.stp

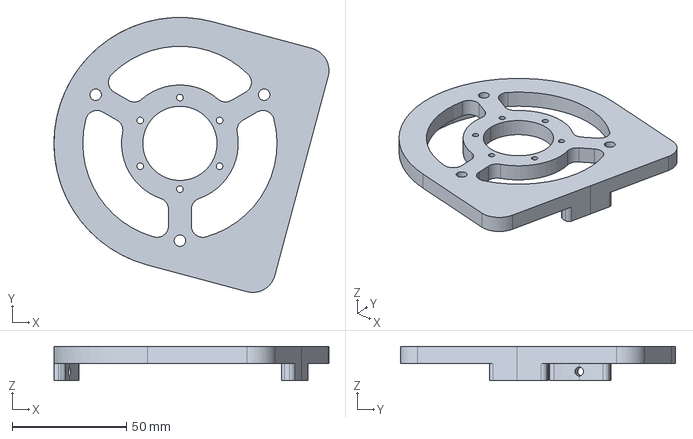
[picture p298: CAD file, 2026-01-20]
CATIA/new_catia/SP02_ALPHA/SP02_ALPHA_AF/STEP/flemdenommer.stp
120.1 x 120.1 x 15.0 mm
