povdoigt/SP-02/IMPRESSION/impression_top_secret _V2/SP02_ALPHA_SEPA_ROULETTE.stp

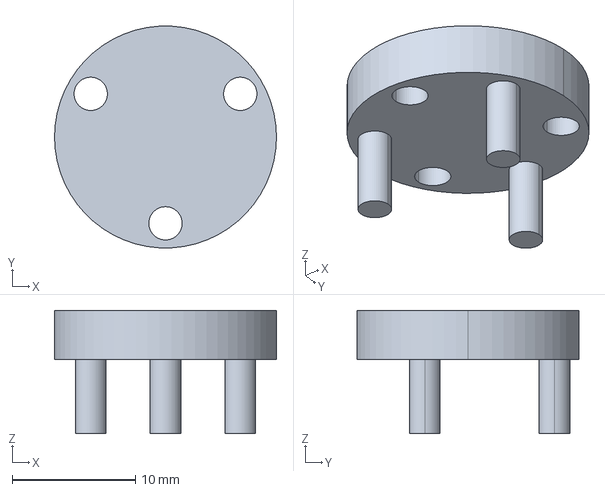
[picture p299: CAD file, 2025-10-19]
IMPRESSION/impression_top_secret _V2/SP02_ALPHA_SEPA_ROULETTE.stp
18.0 x 18.0 x 10.0 mm
