povdoigt/SP-02/CATIA/CATIA_vol/Carte_elec_finales/PCB_ROUTEUR.stp

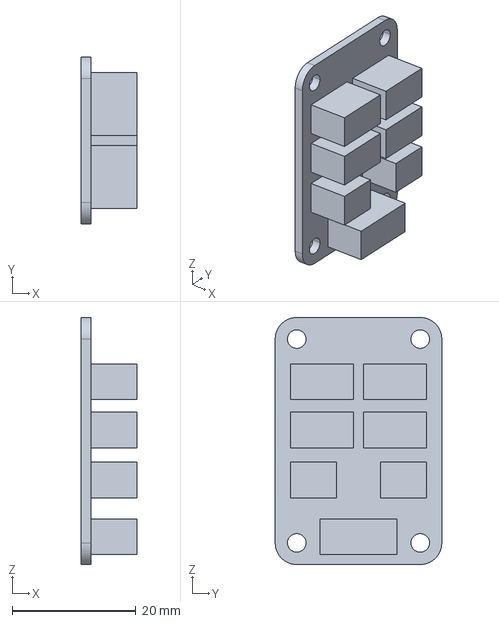
[picture p300: CAD file, 2026-07-09]
CATIA/CATIA_vol/Carte_elec_finales/PCB_ROUTEUR.stp
9.00 x 27.0 x 40.0 mm
