povdoigt/SP-02/CATIA/CATIA_vol/SP02_ALPHA/Support_Servo_Para_1.stl

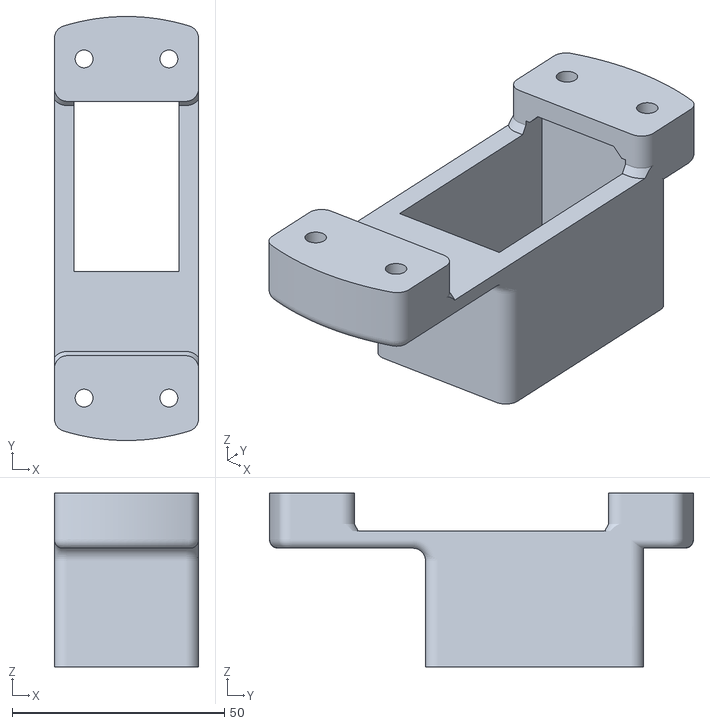
[picture p301: CAD file, 2026-07-09]
CATIA/CATIA_vol/SP02_ALPHA/Support_Servo_Para_1.stl
34.0 x 100.0 x 41.0
