povdoigt/SP-02/CATIA/CATIA_vol/SP02_BETA/Beta_Bague_Para_Sup_Pleine.stl

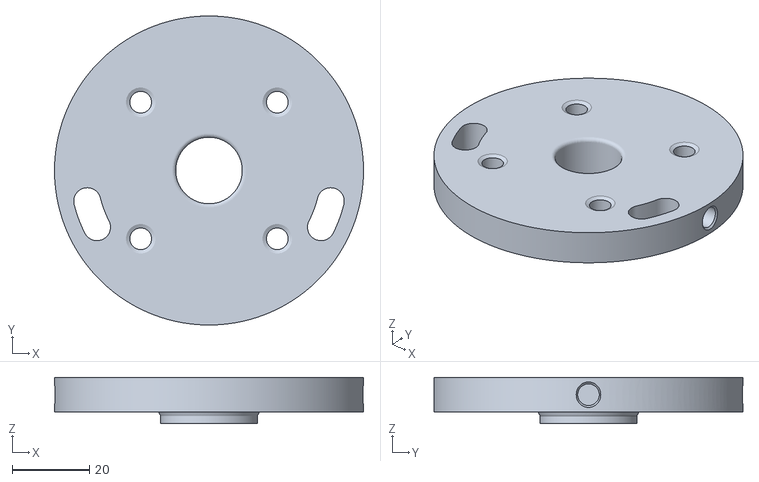
[picture p302: CAD file, 2026-07-09]
CATIA/CATIA_vol/SP02_BETA/Beta_Bague_Para_Sup_Pleine.stl
80.0 x 80.0 x 12.0
