povdoigt/SP-02/CATIA/CATIA_vol/Usinage/petits_trous_petit_tube_sp.stl

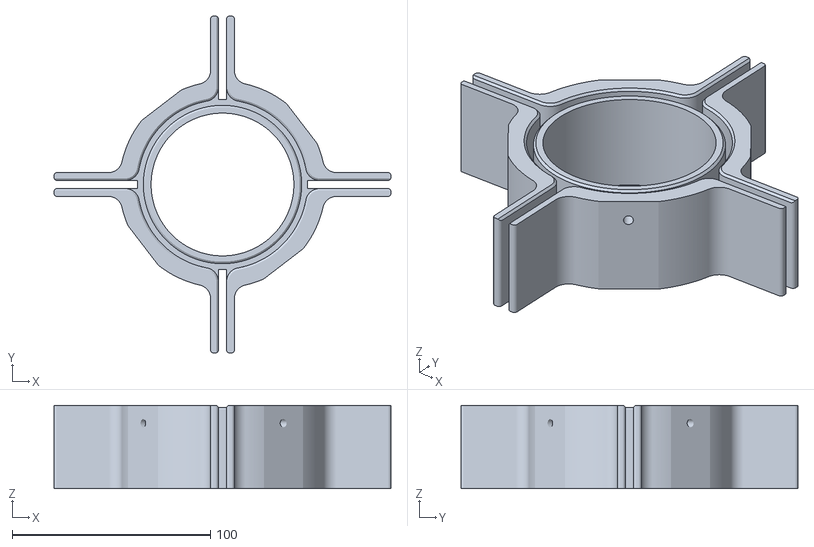
[picture p303: CAD file, 2026-07-09]
CATIA/CATIA_vol/Usinage/petits_trous_petit_tube_sp.stl
170.0 x 170.0 x 42.0
