povdoigt/SP-02/CATIA/new_catia/SP02_ALPHA5_PASDIDEEDENOM.stp

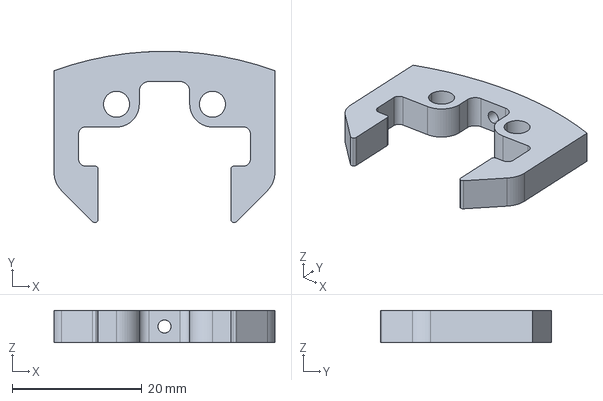
[picture p304: CAD file, 2026-06-02]
CATIA/new_catia/SP02_ALPHA5_PASDIDEEDENOM.stp
34.0 x 26.4 x 5.00 mm
