povdoigt/SP-02/IMPRESSION/impression_top_secret _V2/SP02_BETA_SEPA_PRINCIPALE_v2.stp

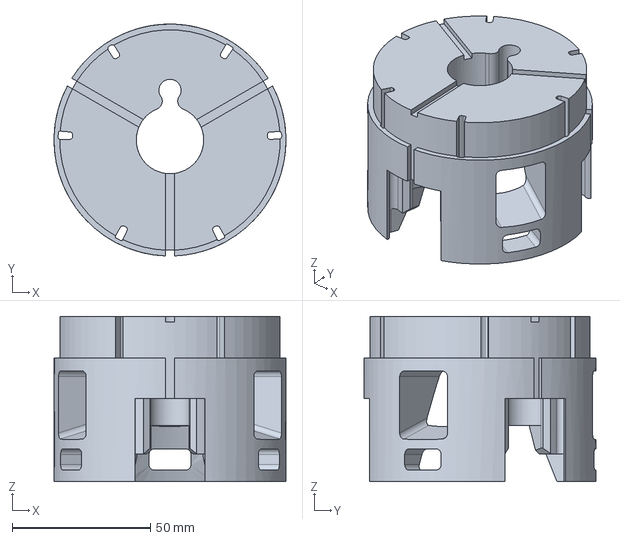
[picture p305: CAD file, 2025-10-19]
IMPRESSION/impression_top_secret _V2/SP02_BETA_SEPA_PRINCIPALE_v2.stp
84.0 x 84.0 x 59.8 mm
