povdoigt/SP-02/IMPRESSION/impression_top_secret/SP02_ALPHA_SEPA_ROULETTE.stl

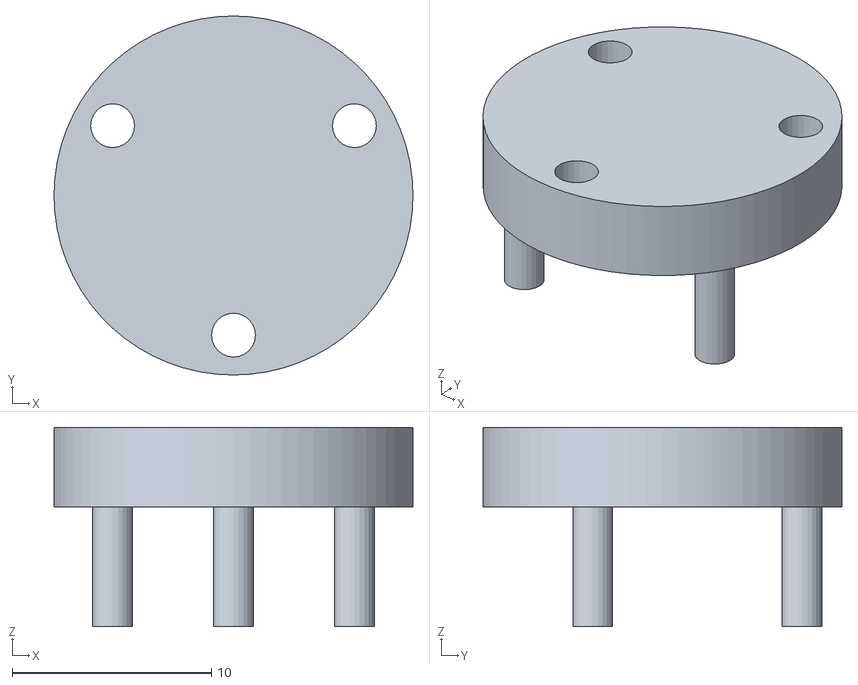
[picture p306: CAD file, 2025-10-19]
IMPRESSION/impression_top_secret/SP02_ALPHA_SEPA_ROULETTE.stl
18.0 x 18.0 x 10.0
