povdoigt/SP-02/CATIA/CATIA_vol/SP02_BETA/Bague_Para_2_etage-2.3mf

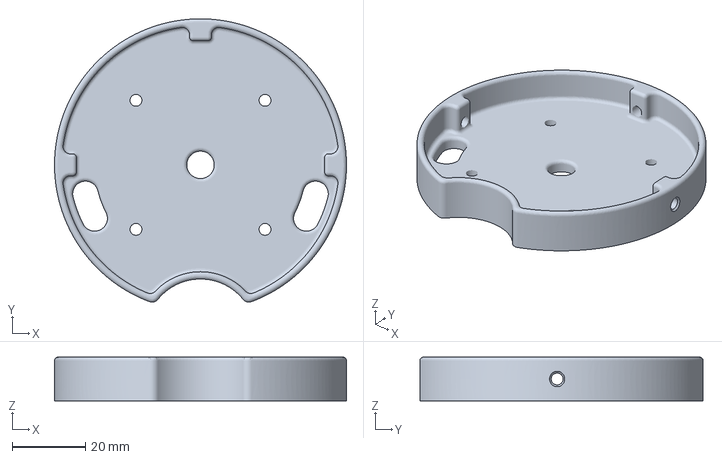
[picture p308: CAD file, 2026-07-09]
CATIA/CATIA_vol/SP02_BETA/Bague_Para_2_etage-2.3mf
80.0 x 77.6 x 12.0 mm
