povdoigt/SP-02/IMPRESSION/impression_top_secret _V2/SP02_ALPHA_SEPA_PRINCIPALE.stp

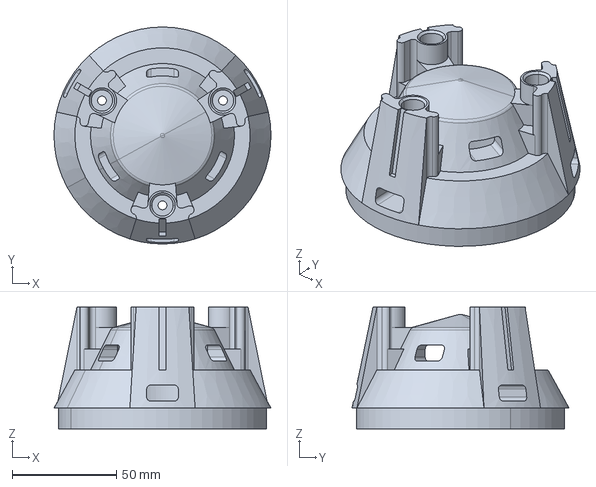
[picture p309: CAD file, 2025-10-19]
IMPRESSION/impression_top_secret _V2/SP02_ALPHA_SEPA_PRINCIPALE.stp
104.0 x 104.0 x 58.2 mm
