povdoigt/SP-02/CATIA/CATIA_vol/SP02_BETA/SP02_BETA_Capuchon-Moule-Cage-Para.stl

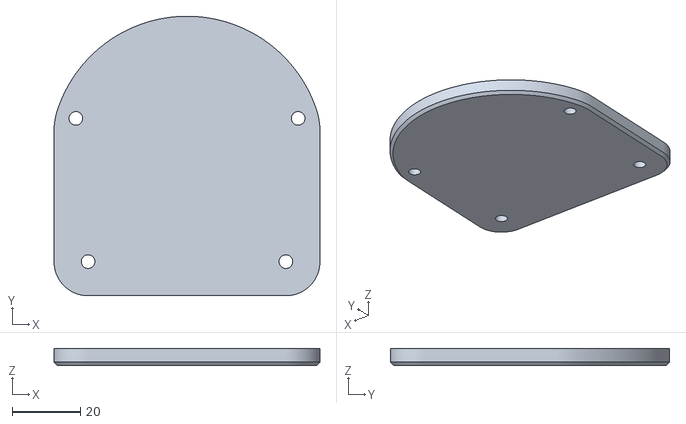
[picture p310: CAD file, 2026-07-09]
CATIA/CATIA_vol/SP02_BETA/SP02_BETA_Capuchon-Moule-Cage-Para.stl
78.0 x 82.0 x 5.00
