povdoigt/SP-02/CATIA/CATIA_vol/Usinage/Moule1.3mf

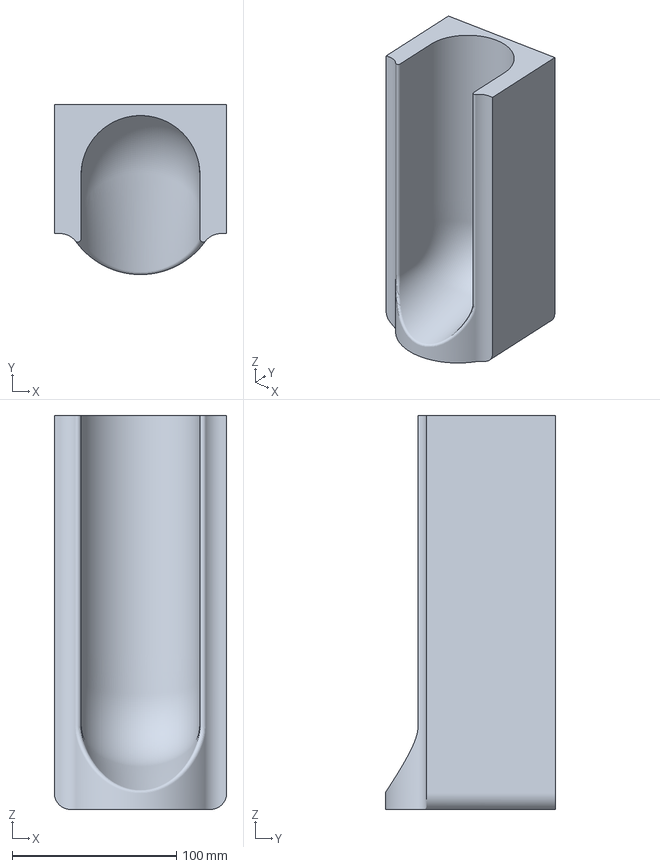
[picture p311: CAD file, 2026-07-09]
CATIA/CATIA_vol/Usinage/Moule1.3mf
105.0 x 103.6 x 240.0 mm
