povdoigt/SP-02/CATIA/CATIA_vol/SP02_ALPHA/SP02_ALPHA_Cage_Para.stl

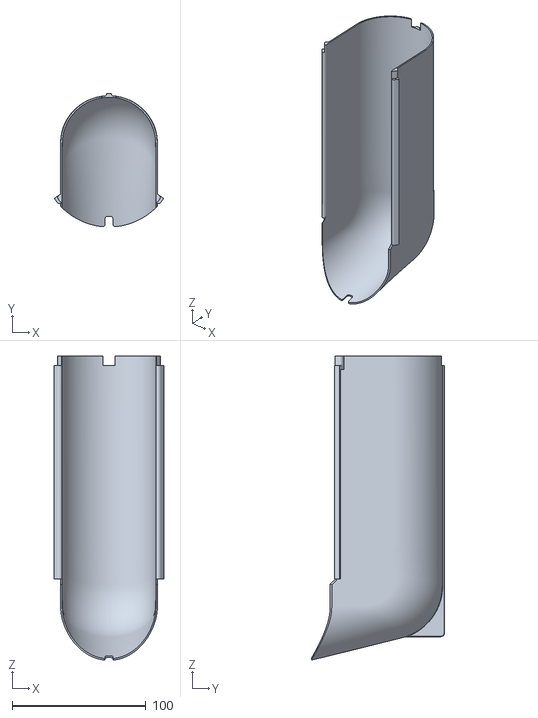
[picture p312: CAD file, 2026-07-09]
CATIA/CATIA_vol/SP02_ALPHA/SP02_ALPHA_Cage_Para.stl
81.9 x 99.8 x 227.4
