povdoigt/SP-02/CATIA/CATIA_vol/Usinage/petits_trous_gros_tube_sp.stl

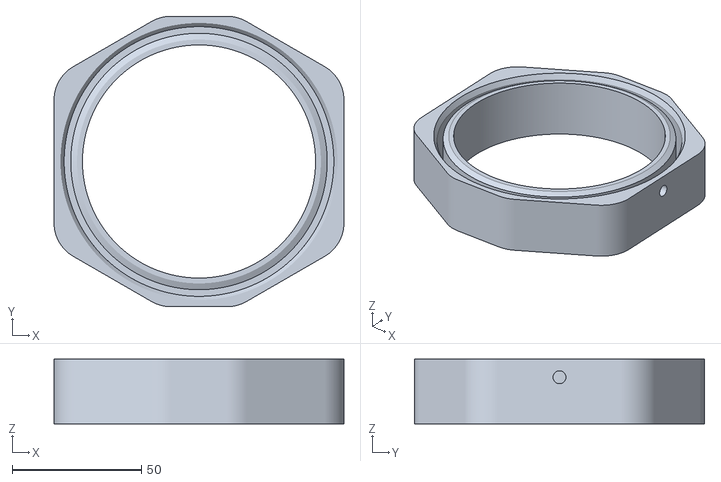
[picture p314: CAD file, 2026-07-09]
CATIA/CATIA_vol/Usinage/petits_trous_gros_tube_sp.stl
112.0 x 112.2 x 25.0
