povdoigt/SP-02/CATIA/CATIA_vol/SP02_BETA/SP02_BETA_Trappe_Parachute.stl

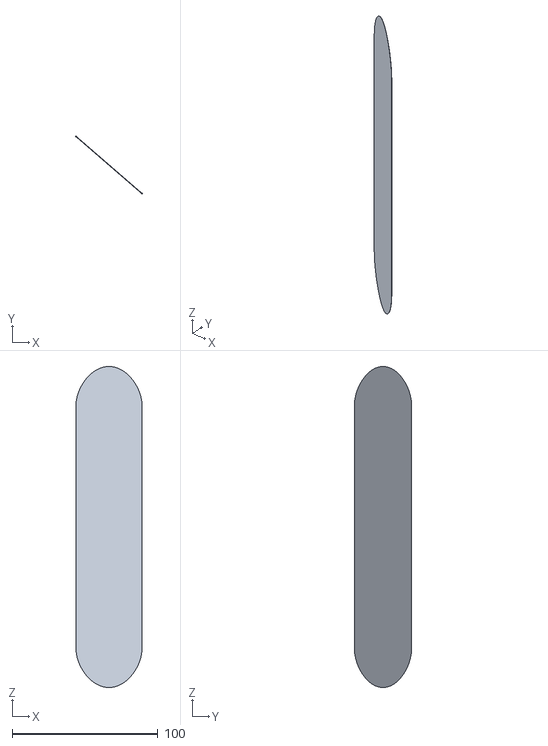
[picture p315: CAD file, 2026-07-09]
CATIA/CATIA_vol/SP02_BETA/SP02_BETA_Trappe_Parachute.stl
45.4 x 39.3 x 220.0
