povdoigt/SP-02/CATIA/CATIA_vol/Usinage/Guide_Trous_AF.stl

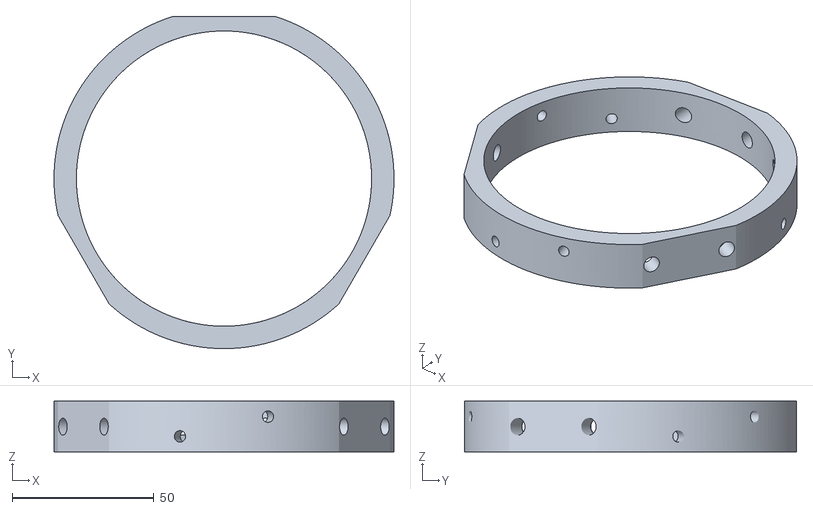
[picture p316: CAD file, 2026-07-09]
CATIA/CATIA_vol/Usinage/Guide_Trous_AF.stl
120.0 x 117.2 x 18.0
