povdoigt/SP-02/CATIA/CATIA_vol/Usinage/Gabarit_Trous_Beta.stl

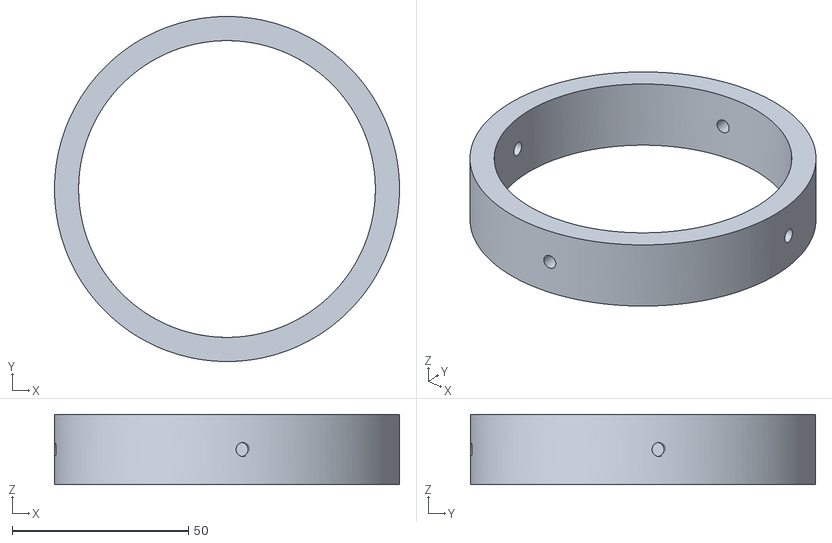
[picture p317: CAD file, 2026-07-09]
CATIA/CATIA_vol/Usinage/Gabarit_Trous_Beta.stl
98.0 x 98.0 x 20.0
