povdoigt/SP-02/CATIA/CATIA_vol/Usinage/Gabarit_trou_alu_alpha.stl

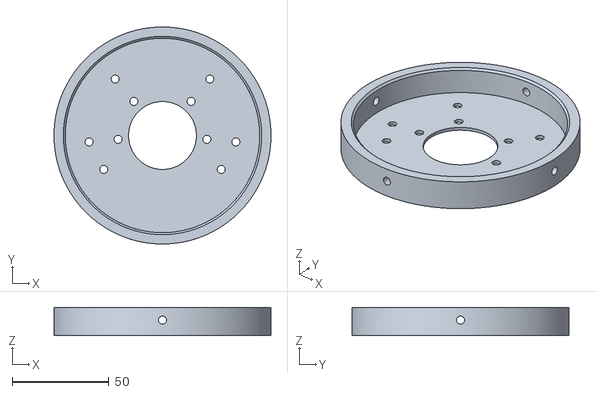
[picture p318: CAD file, 2026-07-09]
CATIA/CATIA_vol/Usinage/Gabarit_trou_alu_alpha.stl
112.0 x 112.0 x 14.5
