povdoigt/SP-02/CATIA/CATIA_vol/Usinage/Gabarit_Trous_Para_Elec_Alpha.stl

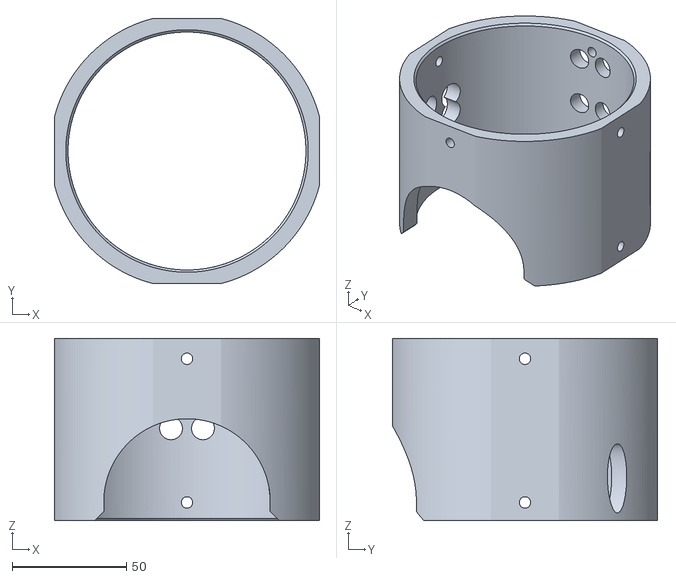
[picture p319: CAD file, 2026-07-09]
CATIA/CATIA_vol/Usinage/Gabarit_Trous_Para_Elec_Alpha.stl
116.2 x 116.2 x 80.0
