povdoigt/SP-02/CATIA/CATIA_vol/SP02_ALPHA/SP02_ALPHA.igs

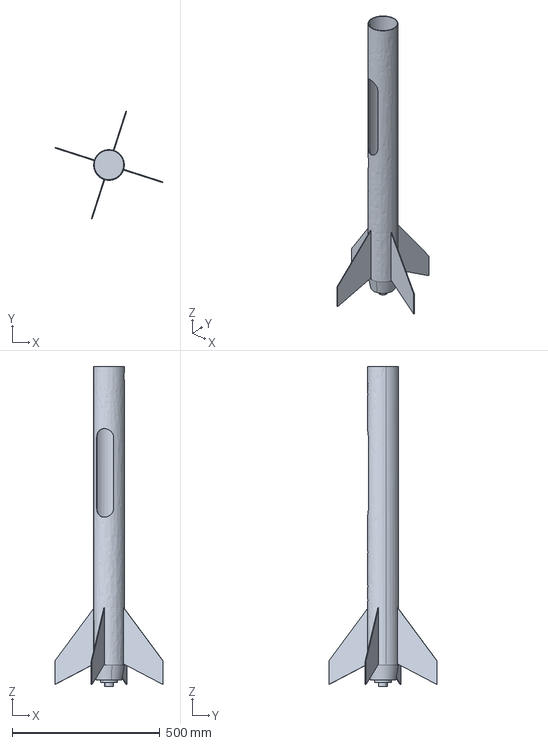
[picture p320: CAD file, 2025-11-20]
CATIA/CATIA_vol/SP02_ALPHA/SP02_ALPHA.igs
366.6 x 366.6 x 1082.7 mm
