povdoigt/SP-02/(list of files, cad)

Other CAD files:
IMPRESSION/impression_top_secret/SP02_ALPHA_SEPA_RONDELLE_RESSORT.stl
IMPRESSION/impression_top_secret/SP02_ALPHA_SEPA_LOQUET_RESSORT.stl
IMPRESSION/impression_top_secret _V2/SP02_ALPHA_SEPA_BIELLE_LOQUET_PRINCIPAL.stp
IMPRESSION/impression_top_secret _V2/SP02_ALPHA_SEPA_LOQUET_PRINCIPAL.stp
IMPRESSION/impression_top_secret/SP02_ALPHA_SEPA_PRINCIPALE.stl
CATIA/CATIA_vol/Carte_elec_finales/Bloc_ELEC_Etage2_v2.stl
IMPRESSION/impression_top_secret _V2/SP02_ALPHA_SEPA_TIGE_RESSORT.stp
CATIA/CATIA_vol/Usinage/SP02_BETA_Moule-Coupleur.3mf
CATIA/CATIA_vol/Bague centrale _1.CATPart
CATIA/CATIA_vol/Bague exeterieur.CATPart
CATIA/CATIA_vol/Bague exeterieur_1.CATPart
CATIA/CATIA_vol/Billes.CATPart
CATIA/CATIA_vol/Billes_1.CATPart
CATIA/CATIA_vol/Board~Of2H.CATPart
CATIA/CATIA_vol/BottomCopper~Of2H.CATPart
CATIA/CATIA_vol/BottomSilkscreen~Of2H.CATPart
CATIA/CATIA_vol/C-7-5530843-7.CATPart
CATIA/CATIA_vol/CONE.CATPart
CATIA/CATIA_vol/CONN-TH_3P-P2.50_B3B-XH-AM-LF-SN~CONN-TH_XH2.50-LI-3P~Of2H.CATPart
CATIA/CATIA_vol/Carte_elec_finales/2_Cellules_Li-ion.CATPart
CATIA/CATIA_vol/Carte_elec_finales/3D_PCB_PCB_SP02_APEX_EX_2026-04-20_2026-04-20.CATProduct
CATIA/CATIA_vol/Carte_elec_finales/3D_PCB_PCB_SP02_IHF_2_V1_2026-04-19_2026-04-19.CATProduct
CATIA/CATIA_vol/Carte_elec_finales/3D_PCB_PCB_SP02_sequenceur_Maxou_2026-04-19_2026-04-19.CATProduct
CATIA/CATIA_vol/Carte_elec_finales/BUZ-SMD_3P-L5.0-W5.0-BL~BUZ-SMD_3P-L5.0-W5.0-H3.0-BL~U5Q5.CATPart
CATIA/CATIA_vol/Carte_elec_finales/Bloc_ELEC_Etage1.CATPart
CATIA/CATIA_vol/Carte_elec_finales/Bloc_ELEC_Etage1.stl
CATIA/CATIA_vol/Carte_elec_finales/Bloc_ELEC_Etage1_v2.stl
CATIA/CATIA_vol/Carte_elec_finales/Bloc_ELEC_Etage1_v3.stl
CATIA/CATIA_vol/Carte_elec_finales/Bloc_ELEC_Etage1_v4.stl
CATIA/CATIA_vol/Carte_elec_finales/Bloc_ELEC_Etage2.CATPart
CATIA/CATIA_vol/Carte_elec_finales/Bloc_ELEC_Etage2_Batteries.CATPart
CATIA/CATIA_vol/Carte_elec_finales/Board~7Q6T.CATPart
CATIA/CATIA_vol/Carte_elec_finales/Board~U5Q5.CATPart
CATIA/CATIA_vol/Carte_elec_finales/Board~iaXJ.CATPart
CATIA/CATIA_vol/Carte_elec_finales/C0805~C0805_L2.0-W1.3-H1.3~7Q6T.CATPart
CATIA/CATIA_vol/Carte_elec_finales/C0805~C0805_L2.0-W1.3-H1.3~7Q6T_1.CATPart
CATIA/CATIA_vol/Carte_elec_finales/C0805~C0805_L2.0-W1.3-H1.3~U5Q5.CATPart
CATIA/CATIA_vol/Carte_elec_finales/C0805~C0805_L2.0-W1.3-H1.3~U5Q5_1.CATPart
CATIA/CATIA_vol/Carte_elec_finales/C0805~C0805_L2.0-W1.3-H1.3~iaXJ.CATPart
CATIA/CATIA_vol/Carte_elec_finales/CONN-SMD_20P-P0.80_2147210200~CONN-SMD_20P-P0.80_2147210200~7Q6T.CATPart
CATIA/CATIA_vol/Carte_elec_finales/CONN-SMD_2147210040~CONN-SMD_2147210040~7Q6T.CATPart
CATIA/CATIA_vol/Carte_elec_finales/CONN-SMD_2147210040~CONN-SMD_2147210040~iaXJ.CATPart
CATIA/CATIA_vol/Carte_elec_finales/CONN-TH_2P-P3.00_MOLEX_436500200~CONN-TH_2P-P3.00_MOLEX_436500200~U5Q5.CATPart
CATIA/CATIA_vol/Carte_elec_finales/CONN-TH_3P-P2.50_B3B-XH-AM-LF-SN~CONN-TH_XH2.50-LI-3P~U5Q5.CATPart
CATIA/CATIA_vol/Carte_elec_finales/CONN-TH_3P-P2.50_B3B-XH-AM-LF-SN~CONN-TH_XH2.50-LI-3P~U5Q5_1.CATPart
CATIA/CATIA_vol/Carte_elec_finales/CONN-TH_B2B-XH-A-LF-SN~XH2.5-2A~7Q6T.CATPart
CATIA/CATIA_vol/Carte_elec_finales/CONN-TH_B2B-XH-A-LF-SN~XH2.5-2A~U5Q5.CATPart
CATIA/CATIA_vol/Carte_elec_finales/CONN-TH_B2B-XH-A-LF-SN~XH2.5-2A~U5Q5_1.CATPart
CATIA/CATIA_vol/Carte_elec_finales/CONN-TH_B2B-XH-A-LF-SN~XH2.5-2A~U5Q5_2.CATPart
CATIA/CATIA_vol/Carte_elec_finales/CONN-TH_B2B-XH-A-LF-SN~XH2.5-2A~U5Q5_3.CATPart
CATIA/CATIA_vol/Carte_elec_finales/CONN-TH_B4B-XH-AM-LF-SN~CONN-TH_XH2.50-LI-4P~7Q6T.CATPart
CATIA/CATIA_vol/Carte_elec_finales/CONN-TH_B4B-XH-AM-LF-SN~CONN-TH_XH2.50-LI-4P~U5Q5.CATPart
CATIA/CATIA_vol/Carte_elec_finales/CONN-TH_S2B-XH-A-1-LF-SN~CONN-TH_S2B-XH-A-1-LF-SN~iaXJ.CATPart
CATIA/CATIA_vol/Carte_elec_finales/CRYSTAL-SMD_3P-L3.2-W1.3-P1.2-BL~CRYSTAL-SMD_3P-L3.2-W1.3-P1.2-BL~U5Q5.CATPart
CATIA/CATIA_vol/Carte_elec_finales/CRYSTAL-SMD_L2.0-W1.2~CRYSTAL-SMD_L2.0-W1.2~U5Q5.CATPart
CATIA/CATIA_vol/Carte_elec_finales/Carte_Condos.CATPart
CATIA/CATIA_vol/Carte_elec_finales/Etage1.CATPart
CATIA/CATIA_vol/Carte_elec_finales/HDR-F-2.54_1X2~HDR-F-2.54_1x2~U5Q5.CATPart
CATIA/CATIA_vol/Carte_elec_finales/HDR-F-2.54_1X3~HDR-F-2.54_1x3~U5Q5.CATPart
CATIA/CATIA_vol/Carte_elec_finales/HDR-F-2.54_1X3~HDR-M-2.54_1x3_1~U5Q5.CATPart
CATIA/CATIA_vol/Carte_elec_finales/HDR-F-2.54_1X4~HDR-F-2.54_1x4~U5Q5.CATPart
CATIA/CATIA_vol/Carte_elec_finales/HDR-F-2.54_1X8~HDR-F-2.54_1x8~U5Q5.CATPart
CATIA/CATIA_vol/Carte_elec_finales/HDR-M-2.54_1X2~HDR-M-2.54_1x2~iaXJ.CATPart
CATIA/CATIA_vol/Carte_elec_finales/HDR-M-2.54_1X3~HDR-M-2.54_1x3~iaXJ.CATPart
CATIA/CATIA_vol/Carte_elec_finales/HDR-M-2.54_1X4~HDR-M-2.54_1x4~iaXJ.CATPart
CATIA/CATIA_vol/Carte_elec_finales/HDR-M-2.54_1X8~HDR-M-2.54_1x8~iaXJ.CATPart
CATIA/CATIA_vol/Carte_elec_finales/Integration_elec_etage1.CATProduct
CATIA/CATIA_vol/Carte_elec_finales/KEY-SMD_B3U-1000PM~KEY-SMD_2P-L3.0-W2.5-H1.6-LS4.0~U5Q5.CATPart
CATIA/CATIA_vol/Carte_elec_finales/KEY-SMD_KMR2XXGXXX~KEY-SMD_5P-L4.2-W2.8-H1.9-LS4.6-P1.6~iaXJ.CATPart
CATIA/CATIA_vol/Carte_elec_finales/L0806~L0806_L2.0-W1.6-H1.0~7Q6T.CATPart
CATIA/CATIA_vol/Carte_elec_finales/L0806~L0806_L2.0-W1.6-H1.0~U5Q5.CATPart
CATIA/CATIA_vol/Carte_elec_finales/LED-ARRAY-SMD_4P-L1.00-W1.00-TR~LED1010-4P_L1.0-W1.0-H0.2-LS1.0~U5Q5.CATPart
CATIA/CATIA_vol/Carte_elec_finales/LED-ARRAY-SMD_4P-L1.00-W1.00-TR~LED1010-4P_L1.0-W1.0-H0.2-LS1.0~iaXJ.CATPart
CATIA/CATIA_vol/Carte_elec_finales/LED0805-R-RD~LED0805-RD~7Q6T.CATPart
CATIA/CATIA_vol/Carte_elec_finales/LED0805-R-RD~LED0805-RD~U5Q5.CATPart
CATIA/CATIA_vol/Carte_elec_finales/LED0805-R-RD~LED0805-RD~iaXJ.CATPart
CATIA/CATIA_vol/Carte_elec_finales/LQFP-64_L10.0-W10.0-P0.50-LS12.0-BL~LQFP-64_L10.0-W10.0-H1.4-LS12.0-P0.50~U5Q5.CATPart
CATIA/CATIA_vol/Carte_elec_finales/PCB_APEX-EX.CATPart
CATIA/CATIA_vol/Carte_elec_finales/PCB_APEX.CATPart
CATIA/CATIA_vol/Carte_elec_finales/PCB_CAMERAS.CATPart
CATIA/CATIA_vol/Carte_elec_finales/PCB_ROUTEUR.CATPart
CATIA/CATIA_vol/Carte_elec_finales/PCB_SEQUENCEUR_Simplifie.CATPart
CATIA/CATIA_vol/Carte_elec_finales/R0805~R0805_L2.0-W1.3-H0.6~7Q6T.CATPart
CATIA/CATIA_vol/Carte_elec_finales/R0805~R0805_L2.0-W1.3-H0.6~U5Q5.CATPart
CATIA/CATIA_vol/Carte_elec_finales/R0805~R0805_L2.0-W1.3-H0.6~iaXJ.CATPart
CATIA/CATIA_vol/Carte_elec_finales/R0805~R0805_L2.0-W1.3-H0.6~iaXJ_1.CATPart
CATIA/CATIA_vol/Carte_elec_finales/RunCam Thumb Pro V2.CATPart
CATIA/CATIA_vol/Carte_elec_finales/SMA-TH_BWSMA-KE-Z001~SMA-TH_5P-L6.5-W6.5-H9.8_BWSMA-KE-Z001~7Q6T.CATPart
CATIA/CATIA_vol/Carte_elec_finales/SMD_L2.8-W2.8_ILPS28QSWTR~SMD_L2.8-W2.8_ILPS28QSWTR~7Q6T.CATPart
CATIA/CATIA_vol/Carte_elec_finales/SO-16_L10.3-W4.4-P1.27-LS7.0-BL~SO-16_L10.3-W4.4-H2.1-P1.27~U5Q5.CATPart
CATIA/CATIA_vol/Carte_elec_finales/SOD-123_L2.7-W1.6-LS3.7-RD-1~SOD-123_L2.7-W1.6-LS3.7-RD-1~U5Q5.CATPart
CATIA/CATIA_vol/Carte_elec_finales/SOD-323_L1.8-W1.3-LS2.5-RD~SOD-323_L1.7-W1.3-H1.1-LS2.5~U5Q5.CATPart
CATIA/CATIA_vol/Carte_elec_finales/SOIC-8_L4.9-W3.9-P1.27-LS6.0-BL~SOIC-8_L4.9-W3.9-H1.7-LS6.0-P1.27~U5Q5.CATPart
CATIA/CATIA_vol/Carte_elec_finales/SOT-23-3_L2.9-W1.3-P1.90-LS2.4-BR~SOT-23-3P_L2.9-W1.3-H1.0-LS2.4-P0.95~U5Q5.CATPart
CATIA/CATIA_vol/Carte_elec_finales/SOT-23-3_L2.9-W1.6-P1.90-LS2.8-BR~SOT-23-3L_L2.9-W1.6-H1.1-LS2.8-P0.95~U5Q5.CATPart
CATIA/CATIA_vol/Carte_elec_finales/SOT-23-6_L2.9-W1.6-P0.95-LS2.8-BR~SOT-23-6_L2.9-W1.6-H1.5-LS2.8-P0.95~iaXJ.CATPart
CATIA/CATIA_vol/Carte_elec_finales/SOT-23_L2.9-W1.3-P1.90-LS2.4-BR~SOT-23-3P_L2.9-W1.3-H1.0-LS2.4-P0.95~U5Q5.CATPart
CATIA/CATIA_vol/Carte_elec_finales/SW-SMD_RM3AF-16R-V-B~SW-SMD_RM3AF-16R-V-B~iaXJ.CATPart
CATIA/CATIA_vol/Carte_elec_finales/SW-TH_MS-22D10-G020~SW-TH_MS-22D10-G020~iaXJ.CATPart
CATIA/CATIA_vol/Carte_elec_finales/SW-TH_SS-12D07-X-X~SW-TH_SS-12D07-X-X~7Q6T.CATPart
CATIA/CATIA_vol/Carte_elec_finales/SW-TH_SS-12D07-X-X~SW-TH_SS-12D07-X-X~7Q6T_1.CATPart
CATIA/CATIA_vol/Carte_elec_finales/SW-TH_XKB_SS-12M11XX~SW-TH_XKB_SS-12M11XX~iaXJ.CATPart
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
