povdoigt/SP-02/PMI/repport_FinalVersion/figures/apex_bes/ASSEMBLAGE.png

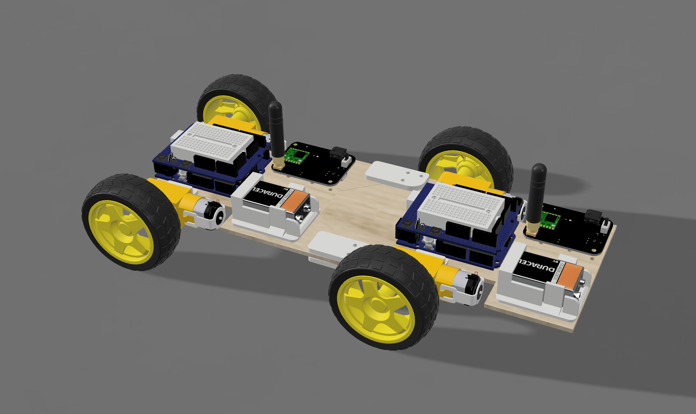
PMI/repport_FinalVersion/figures/apex_bes/ASSEMBLAGE.png
