povdoigt/SP-02/PMI/repport_FinalVersion/sections/4_Resultas/main.tex

\section{Résultat}
\label{sec:resultat}

\input{sections/4_Resultas/1_CFD.tex}
\input{sections/4_Resultas/2_FEM.tex}
\input{sections/4_Resultas/3_Elec.tex}
