povdoigt/SP-02/PMI/repport/sections/ch7_tests_et_validations/main.tex

\section{Tests et validations}
\label{sec:tests_et_validations}

\input{sections/ch6_tests_et_validations/subsec1_matrice_validation.tex}
\input{sections/ch6_tests_et_validations/subsec2_registre_tests.tex}
