povdoigt/SP-02/PMI/repport/sections/ch7_tests_et_validations/subsec1_matrice_validation.tex

\subsection{Matrice de validation}
\label{subsec:matrice_validation}
