povdoigt/SP-02/PMI/repport/sections/ch7_tests_et_validations/subsec2_registre_tests.tex

\subsection{Registre des tests}
\label{subsec:registre_tests}
