povdoigt/SP-02/test_flèche.xlsx

D1 | 84 | L | x | f | x | f
L_beta | 1000 | 1 | 25.00303038 | 2500.303% | 974.1981218 | 97.420%
delta | 0.1 | 2 | 9.268115956 | 463.406% | 968.2313034 | 96.823%
 |  | 3 | 4.710602964 | 157.020% | 838.760762 | 83.876%
 |  | 4 | 2.908029988 | 72.701% | 585.1233457 | 58.512%
 |  | 5 | 2.031223242 | 40.624% | 374.341568 | 37.434%
 |  | 6 | 1.542910398 | 25.715% | 247.5061925 | 24.751%
 |  | 7 | 1.244242532 | 17.775% | 173.7615628 | 17.376%
 |  | 8 | 1.048658356 | 13.108% | 128.921779 | 12.892%
 |  | 9 | 0.9137662874 | 10.153% | 100.0965359 | 10.010%
 |  | 10 | 0.8168760224 | 8.169% | 80.59953752 | 8.060%
 |  | 11 | 0.7449706567 | 6.772% | 66.82485315 | 6.682%
 |  | 12 | 0.6901563074 | 5.751% | 56.72798534 | 5.673%
 |  | 13 | 0.6474232179 | 4.980% | 49.09271778 | 4.909%
 |  | 14 | 0.6134692142 | 4.382% | 43.16375166 | 4.316%
 |  | 15 | 0.58604674 | 3.907% | 38.45395103 | 3.845%
 |  | 16 | 0.5635834074 | 3.522% | 34.6385482 | 3.464%
 |  | 17 | 0.5449526533 | 3.206% | 31.49462823 | 3.149%
 |  | 18 | 0.5293303307 | 2.941% | 28.86520303 | 2.887%
 |  | 19 | 0.5161023361 | 2.716% | 26.63716292 | 2.664%
 |  | 20 | 0.5048035343 | 2.524% | 24.72733718 | 2.473%
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
