povdoigt/SP-02/PMI/repport_FinalVersion/figures/apex_bes/debug_traces_transparent.png

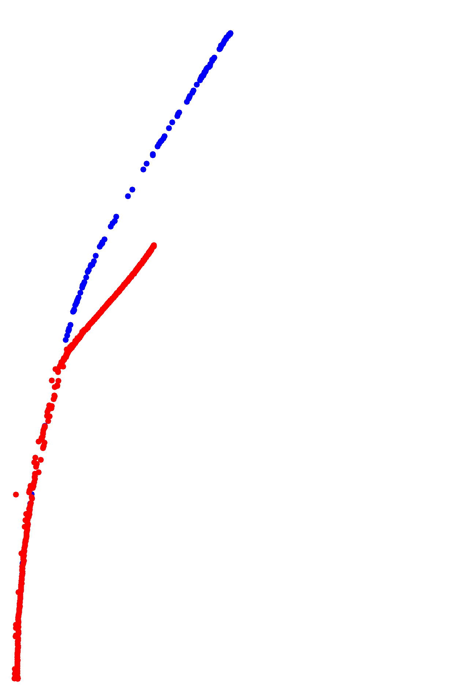
PMI/repport_FinalVersion/figures/apex_bes/debug_traces_transparent.png
