povdoigt/SP-02/ELEC/Schematics/Schematic_APEX_LE_RETOUR_2026-03-23.pdf

# LORA

# +3V3 SDA

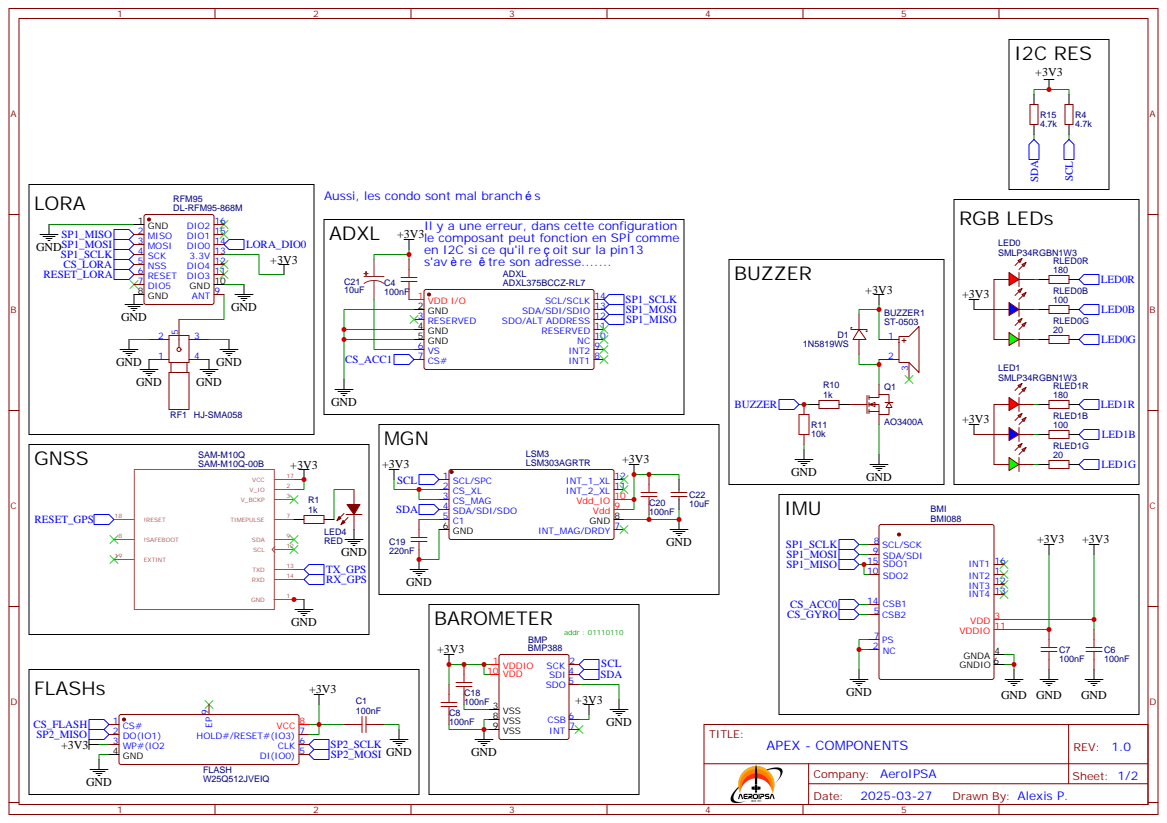
[picture p341: page 1]

Aussi, les condo sont mal branch s
ADXL

Il y a une erreur, dans cette configuration
le composant peut fonction en SPI comme
en I2C si ce qu'il re oit sur la pin13
s'av re tre son adresse.......

PA3 17 VSS 18 VDD 19 PA4 20 PA5 21 PA6 22 PA7 23 PC4 24 PC5 25 PB0 26 PB1 27 PB2 28 PB10 29 VCAP_1 30 VSS 31 VDD 32

# RESET

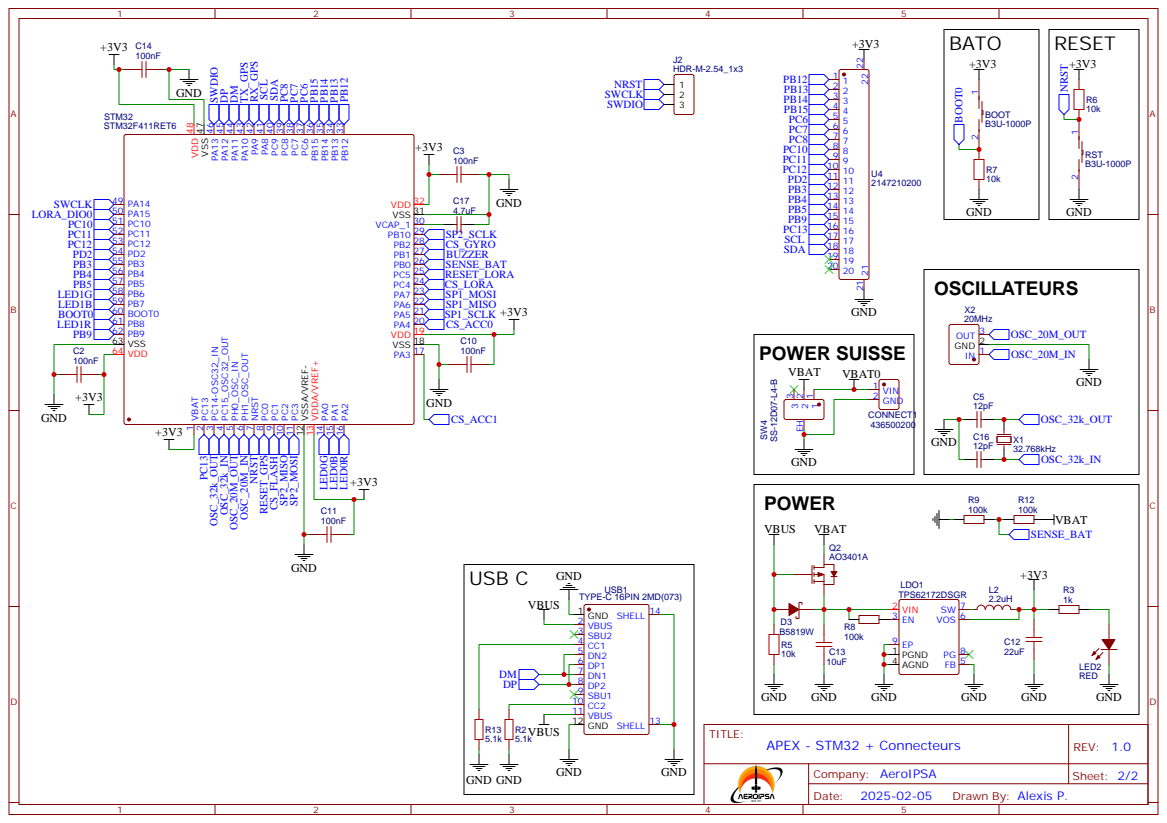
[picture p342: page 2]
