povdoigt/SP-02/ELEC/Schematics/Schematic_SP02_APEX_EX_2026-03-23.pdf

# GNDSPI3_CS GFSK_NRST

# SORTIE I2C

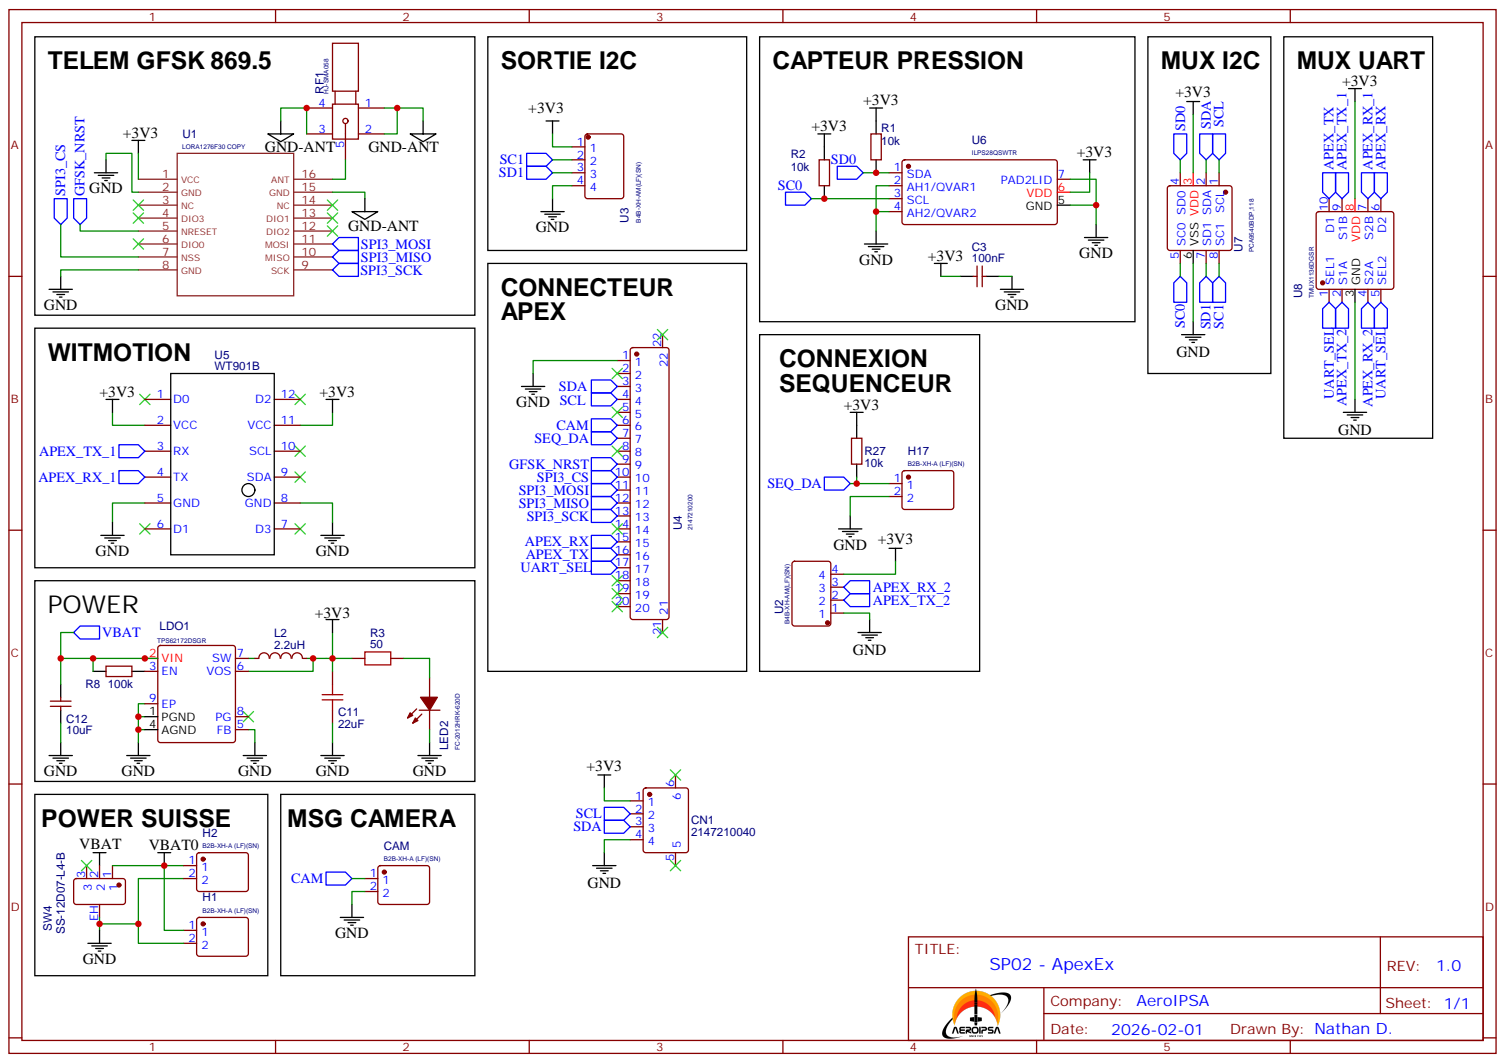
[picture p343: page 1]

MISO 10 MOSI 11 DIO2 12 DIO1 13 NC 14 GND 15 ANT 16
