povdoigt/SP-02/ELEC/Schematics/Schematic_SP02_IHM_2_2026-03-23.pdf

# INDICATEUR CHARGE BATTERIE

# INTERRUPTEURS ALIM

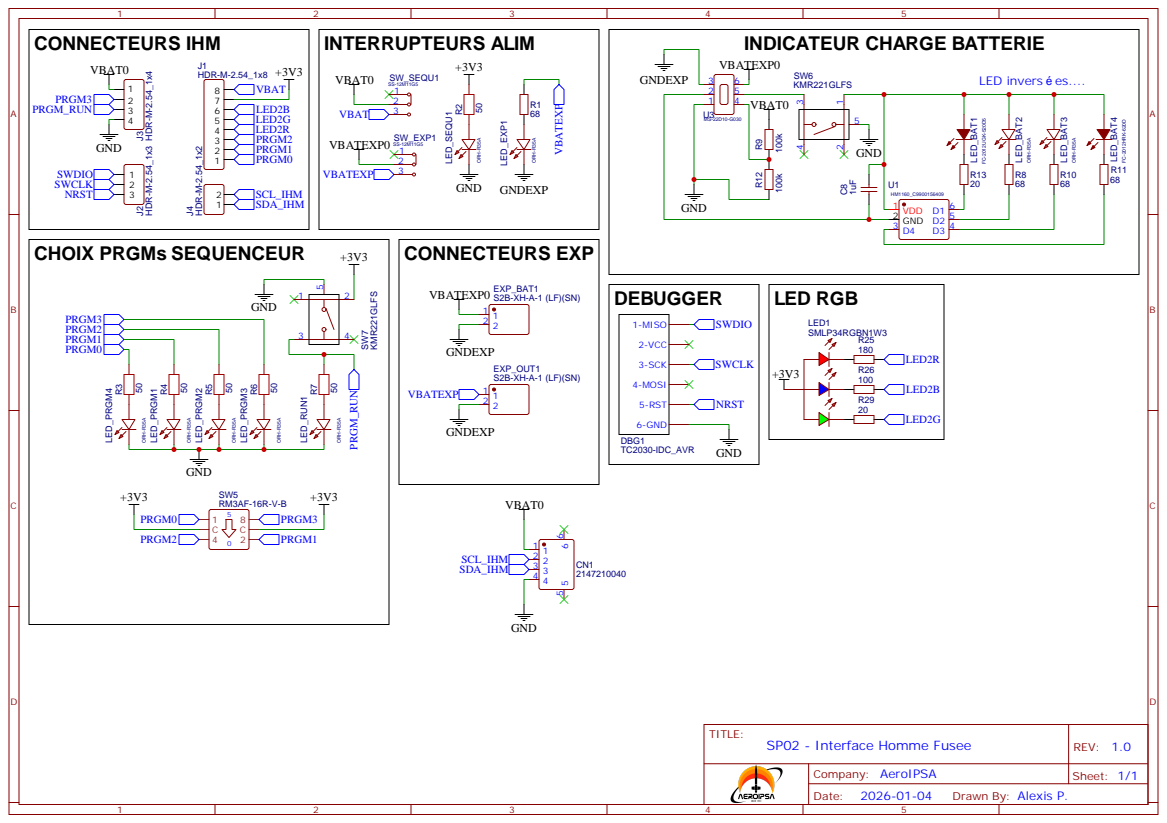
[picture p344: page 1]
