povdoigt/SP-02/ELEC/Schematics/Schematic_SP02_PITOT_2026-03-23.pdf

# SORTIE I2C

# CAPTEUR PRESSION

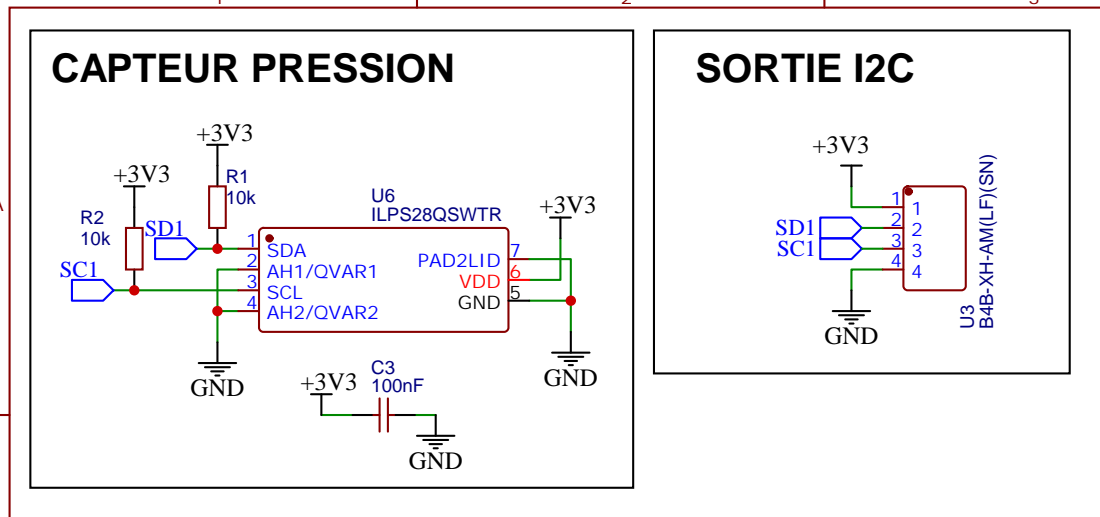
[picture p345: page 1]
