povdoigt/SP-02/ELEC/Schematics/Schematic_SP02_ROUTEUR_2026-03-23.pdf

A | A

1

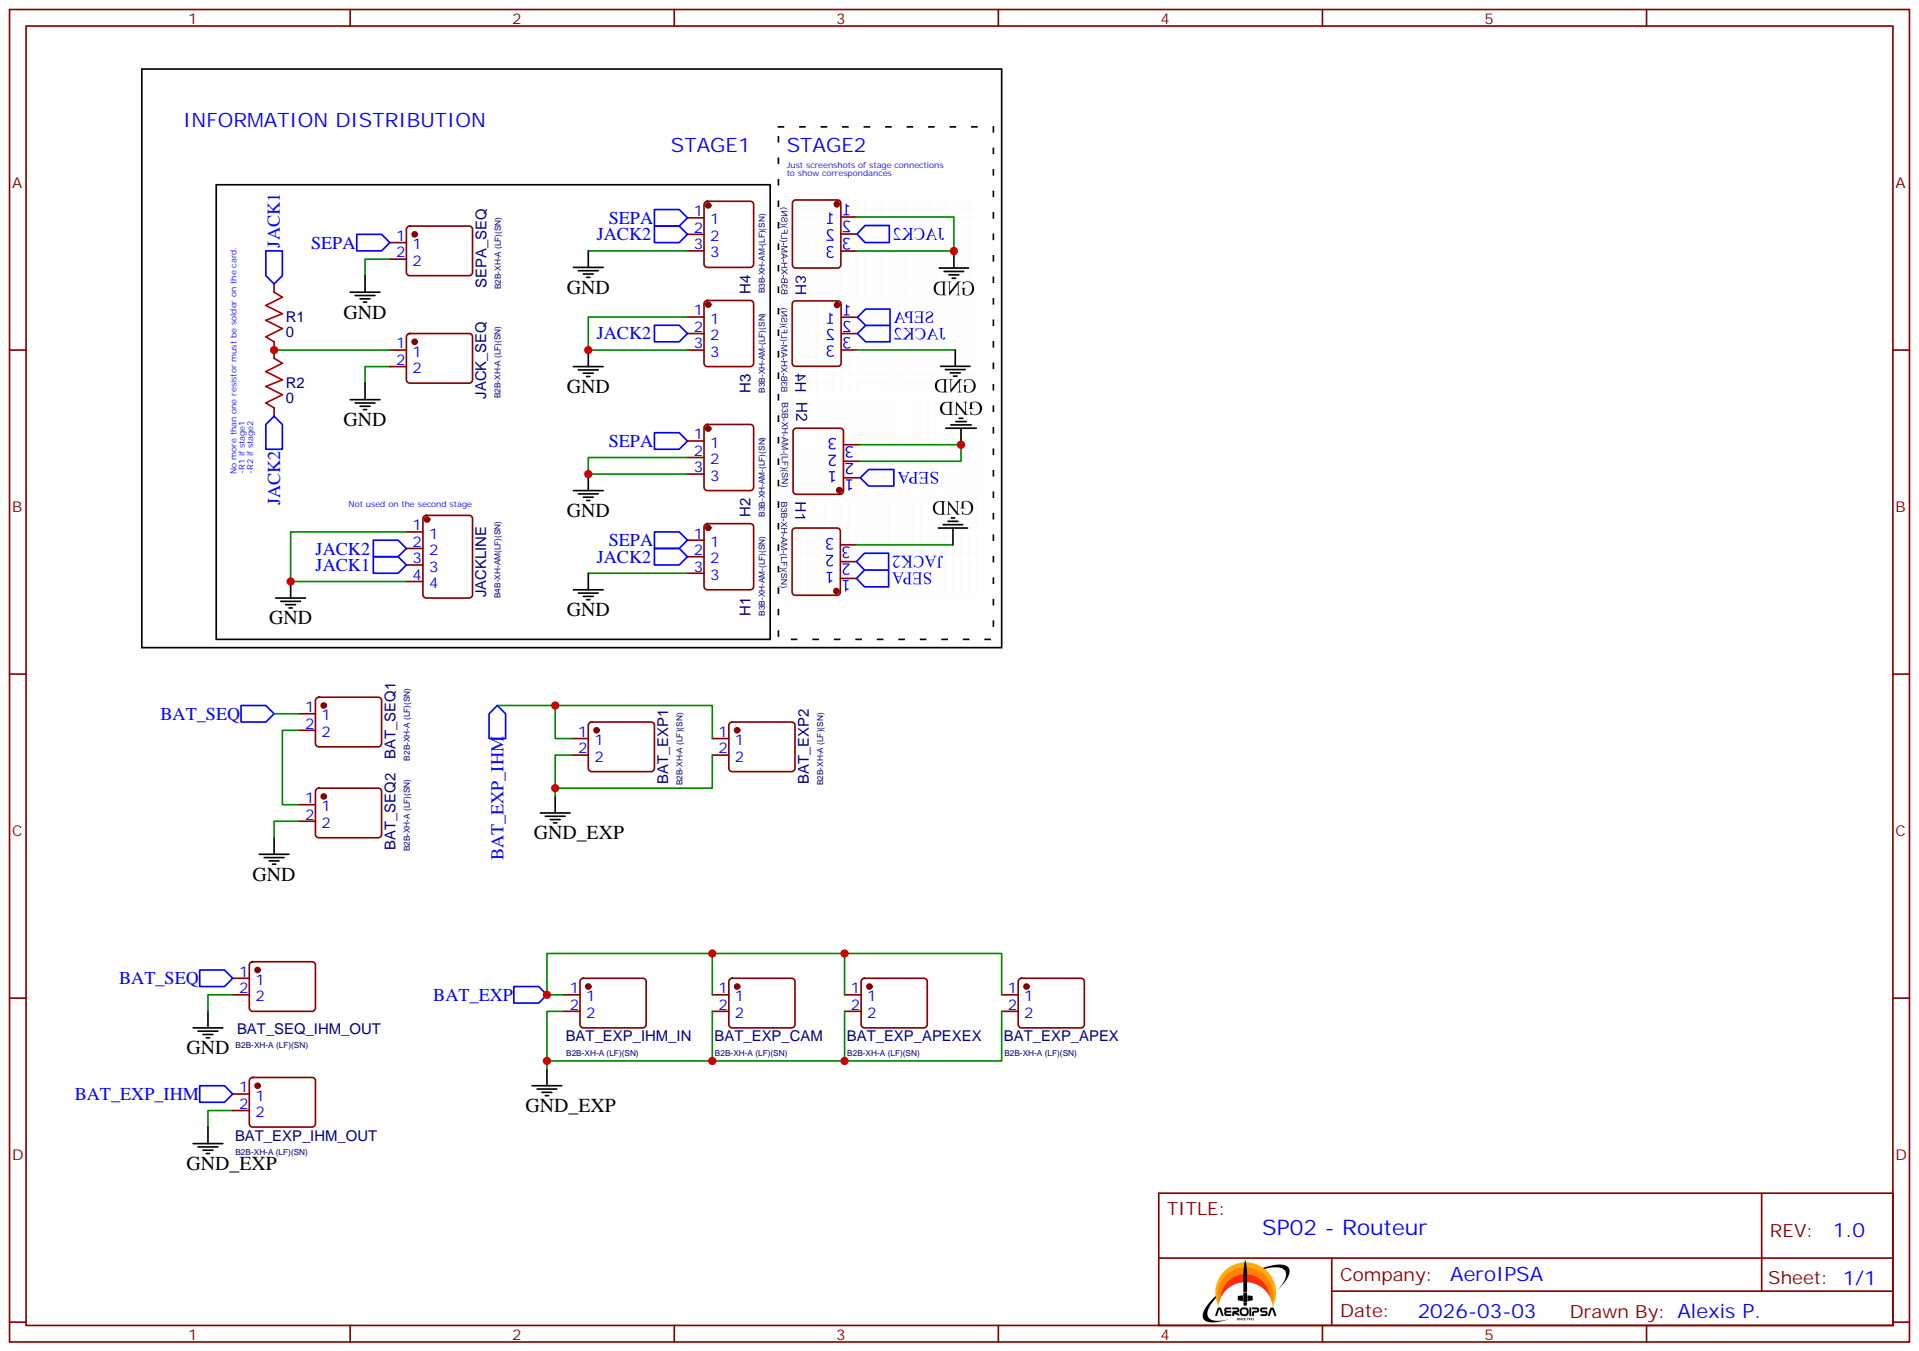
[picture p346: page 1]

Just screenshots of stage connections
to show correspondances

No more than one resistor must be solder on the card.

Not used on the second stage
