povdoigt/SP-02/ELEC/Schematics/Schematic_SP02_sequenceur_Maxou_2026-03-23.pdf

# USB C GND POWER

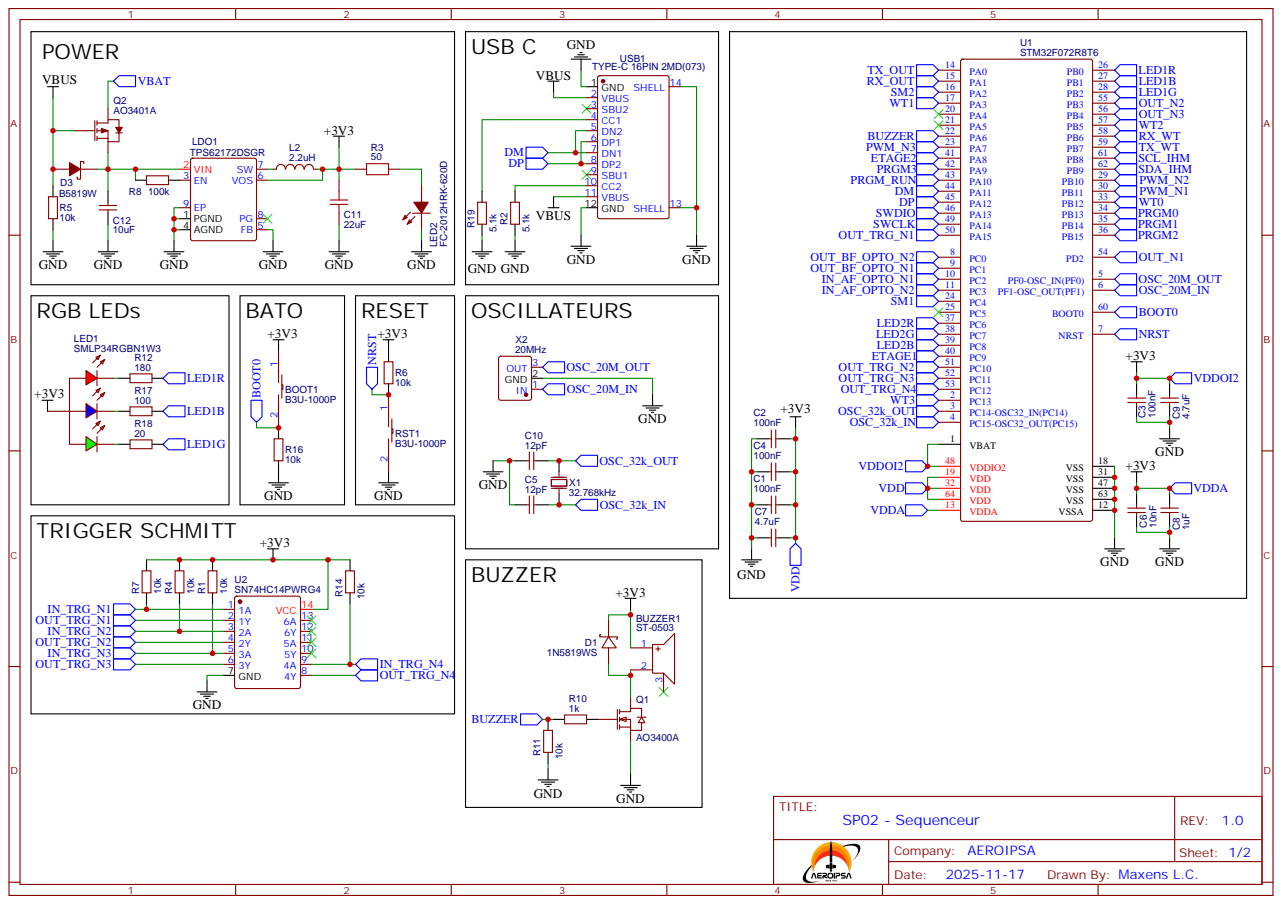
[picture p347: page 1]

WITMOTION | ISOLATION UART | SORTIE UART | CONNECTEURS IHM

# ENTREES TRIGGER SCHMITT

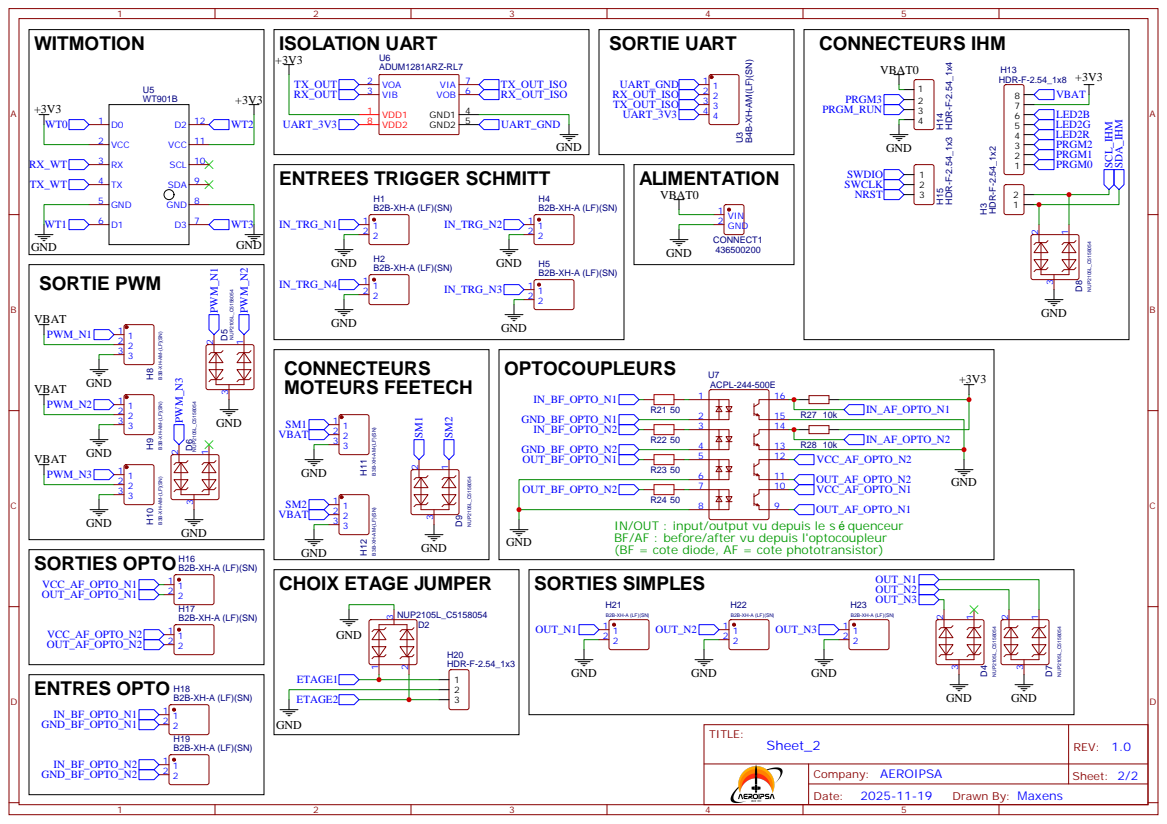
[picture p348: page 2]

IN/OUT : input/output vu depuis le s quenceur
BF/AF : before/after vu depuis l'optocoupleur
(BF = cote diode, AF = cote phototransistor)
