povdoigt/SP-02/PMI/repport/figures/Schematic_SP02_Allumage_2025-11-30.pdf

## LED1JACK¹

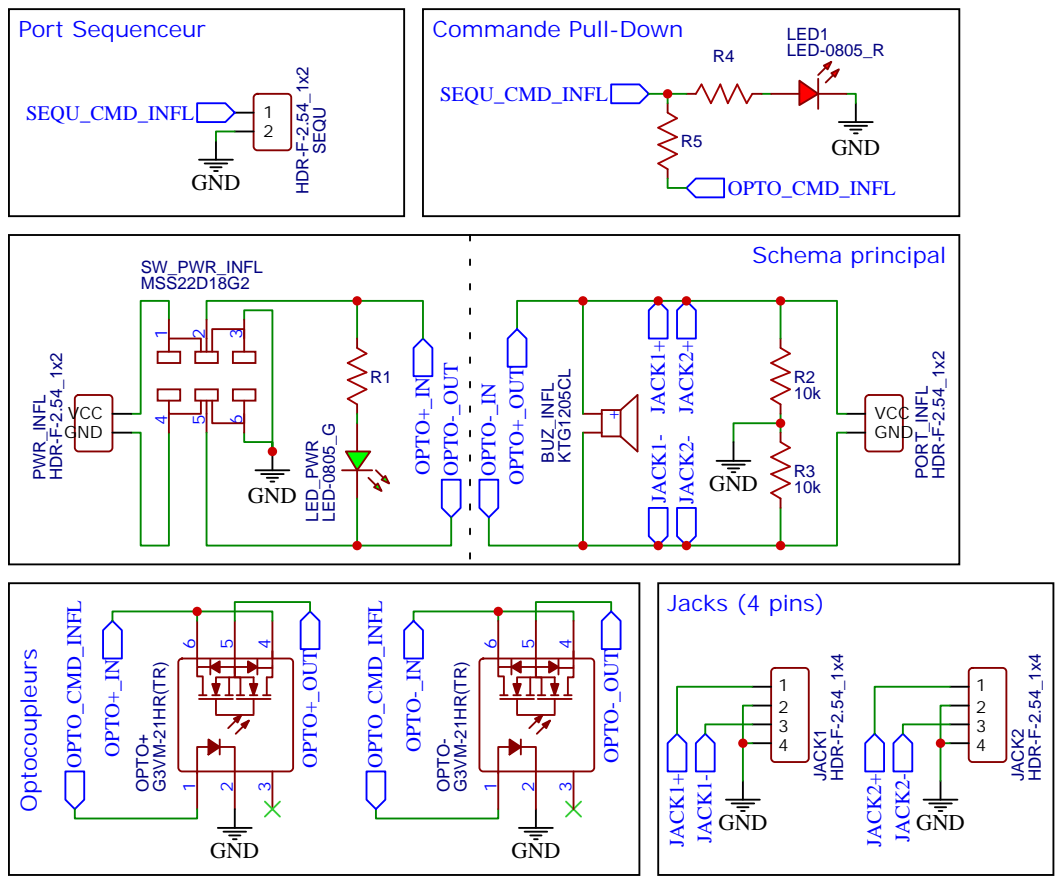
[picture p349: page 1]

Drawn By: Alexis Paillard
