povdoigt/SP-02/PMI/repport/figures/Schematic_SP02_sequenceur_Maxou_2025-11-30.pdf

# USB C GND

# POWER

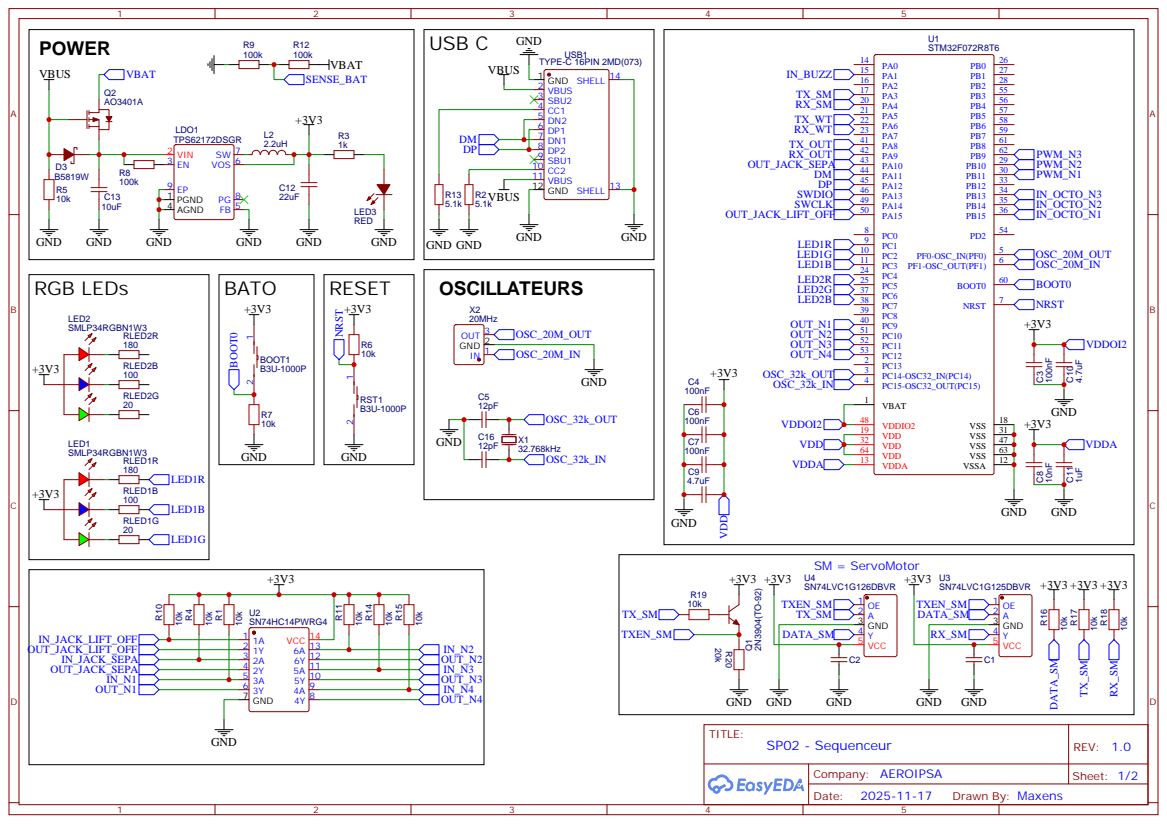
[picture p350: page 1]

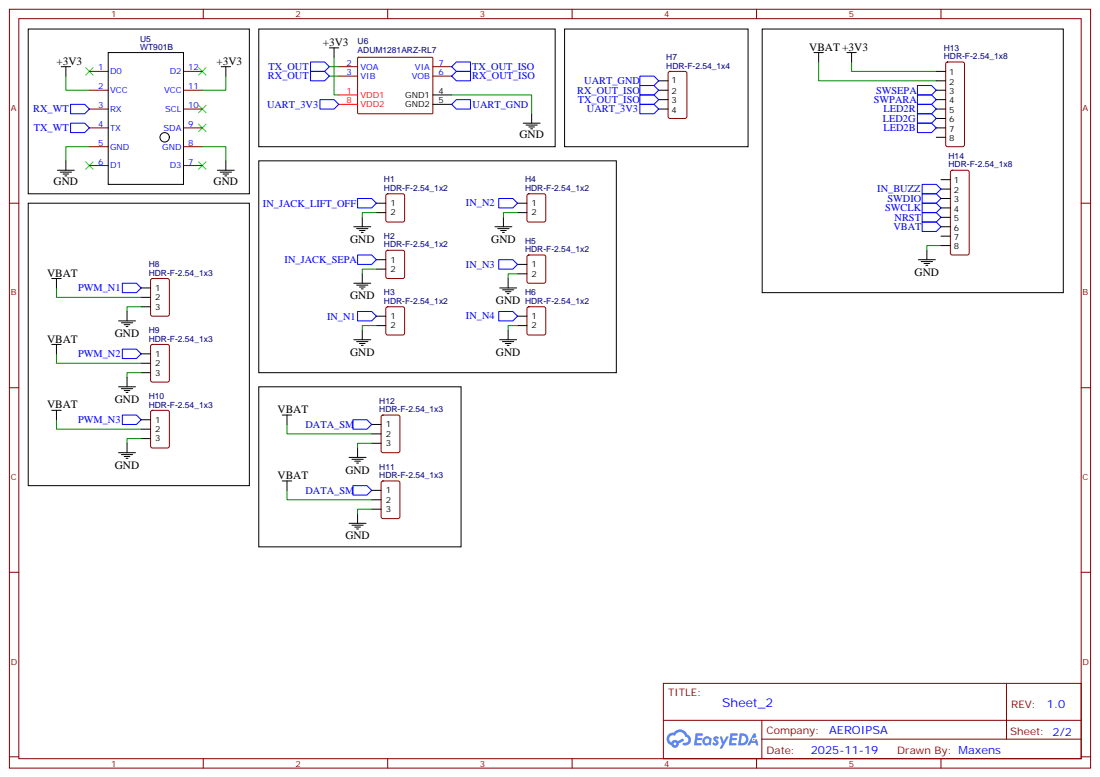
[picture p351: page 2]
