povdoigt/SP-02/RAPPORT/DOSSIER SUIVI/figures/annexe/SP02_2_STAGE_1.drawio.pdf

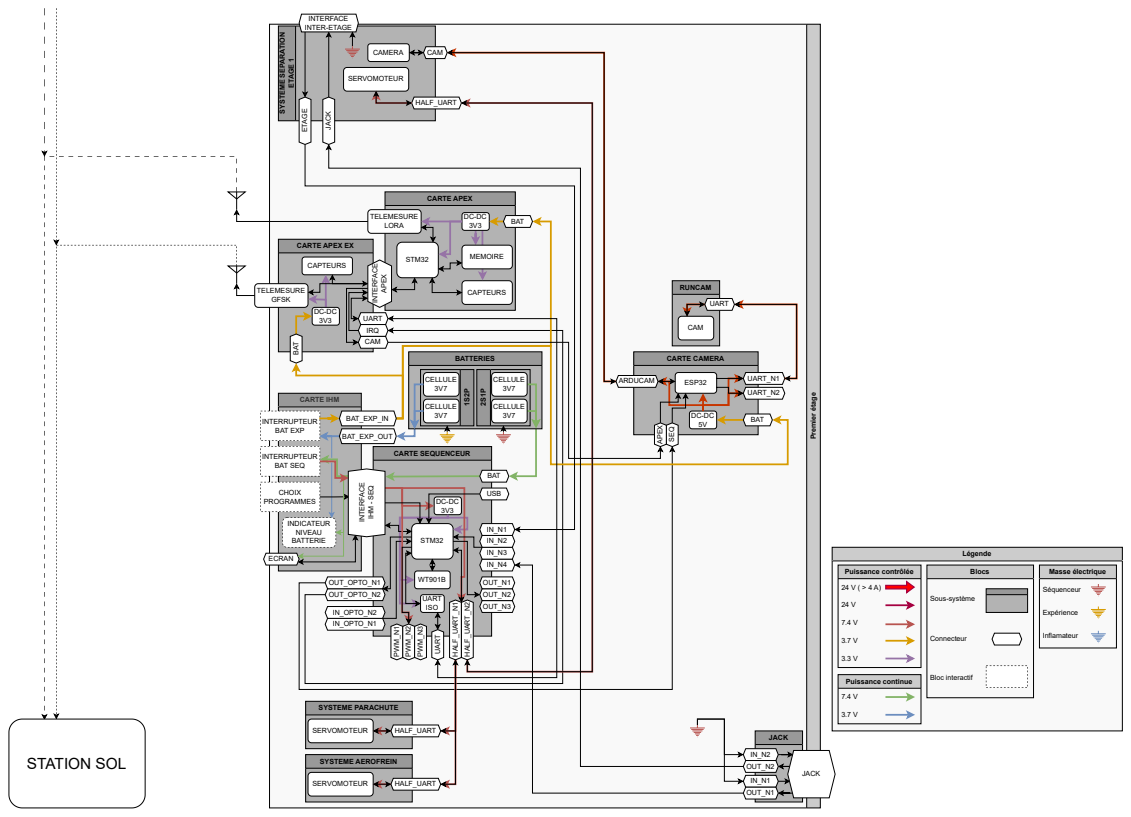
[picture p353: page 1]
Premier étage; SYSTEME SEPARATION; ETAGE 1; CAMERA; SERVOMOTEUR; JACK; CAM; HALF_UAR; CARTE CAMERA; ESP32; CARTE IHM; INDICATEUR NIVEAU BATTERIE; CHOIX PROGRAMMES; INTERRUPTEUR BAT SEQ; ECRAN; INTERRUPTEUR BAT EXP; CARTE SEQUENCEUR; STM32; UAR; T ISO; SYSTEME AEROFREIN; SYSTEME PARACHUTE; CARTE APEX; CAPTEURS; MEMOIRE; TELEMESURE GFSK; IN_OPTO_N1; IN_OPTO_N2; OUT_OPTO_N2; OUT_OPTO_N1; PWM_N1; PWM_N2; PWM_N3; HALF_UART_N1; HALF_UART_N2; OUT_N3; OUT_N2; OUT_N1; BAT; USB; INTERFACE; IHM - SEQ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

CARTE APEX EX
