povdoigt/SP-02/RAPPORT/DOSSIER SUIVI/figures/annexe/SP02_2_STAGE_2.drawio.pdf

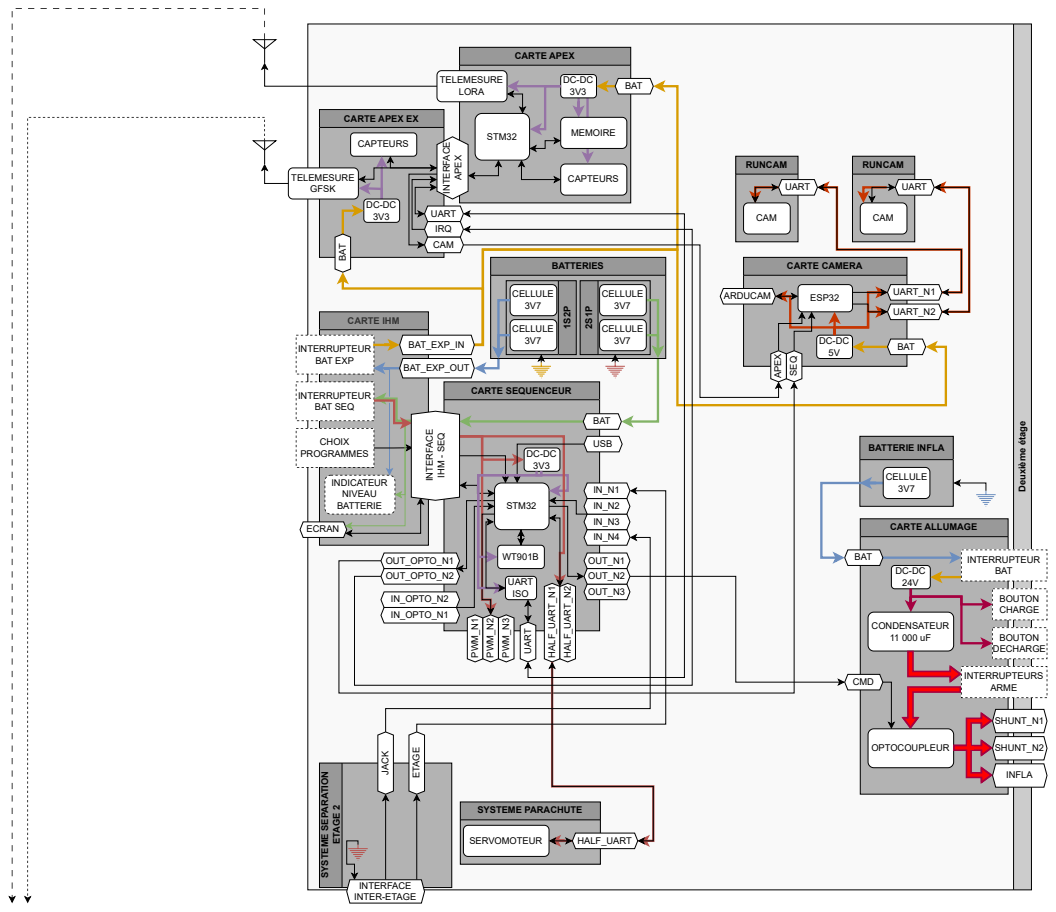
[picture p354: page 1]
Deuxième étage; CARTE IHM; INDICATEUR NIVEAU BATTERIE; CHOIX PROGRAMMES; INTERRUPTEUR BAT SEQ; ECRAN; INTERRUPTEUR BAT EXP; CARTE SEQUENCEUR; STM32; CARTE APEX; CAPTEURS; MEMOIRE; TELEMESURE GFSK; IN_OPTO_N1; IN_OPTO_N2; OUT_OPTO_N2; OUT_OPTO_N1; PWM_N1; PWM_N2; PWM_N3; HALF_UART_N1; HALF_UART_N2; OUT_N3; OUT_N2; OUT_N1; BAT; USB; INTERFACE; IHM - SEQ; BAT_EXP_IN; TELEMESURE; LORA; BAT_EXP_OUT; BATTERIES 1S²P; CELLULE 3V7; CARTE CAMERA; ESP32; UART_N1; UART_N2; ARDUCAM; RUNCAM; CAM; UART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

CARTE APEX EX
