povdoigt/SP-02/PMI/repport/figures/Sheet_1.pdf

# LORA

# I2C RES

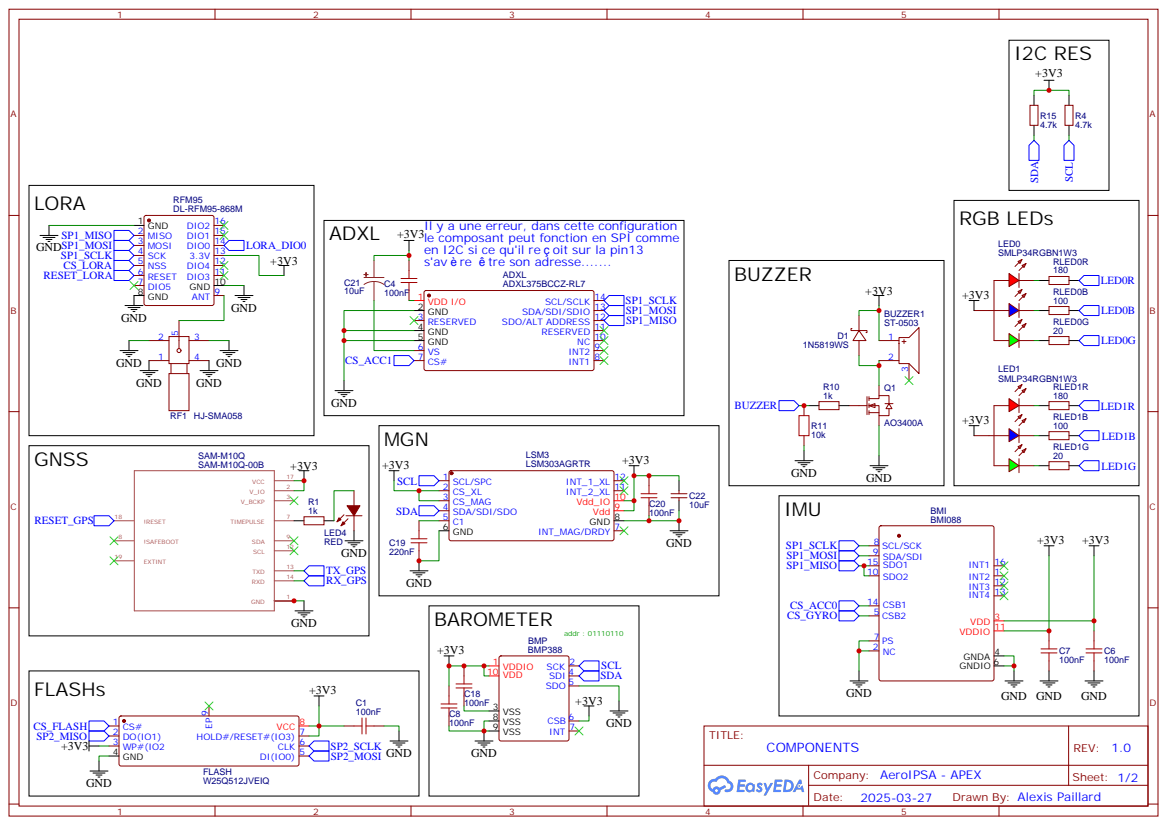
[picture p355: page 1]
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

ADXL
ADXL375BCCZ-RL7
NC 10 RESERVED 11 SDO/ALT ADDRESS 12 SDA/SDI/SDIO 13 SCL/SCLK 14

Drawn By: Alexis Paillard
