povdoigt/SP-02/CATIA/CATIA_vol/Drawings/Beta_maintien_pointe_coiffe.pdf

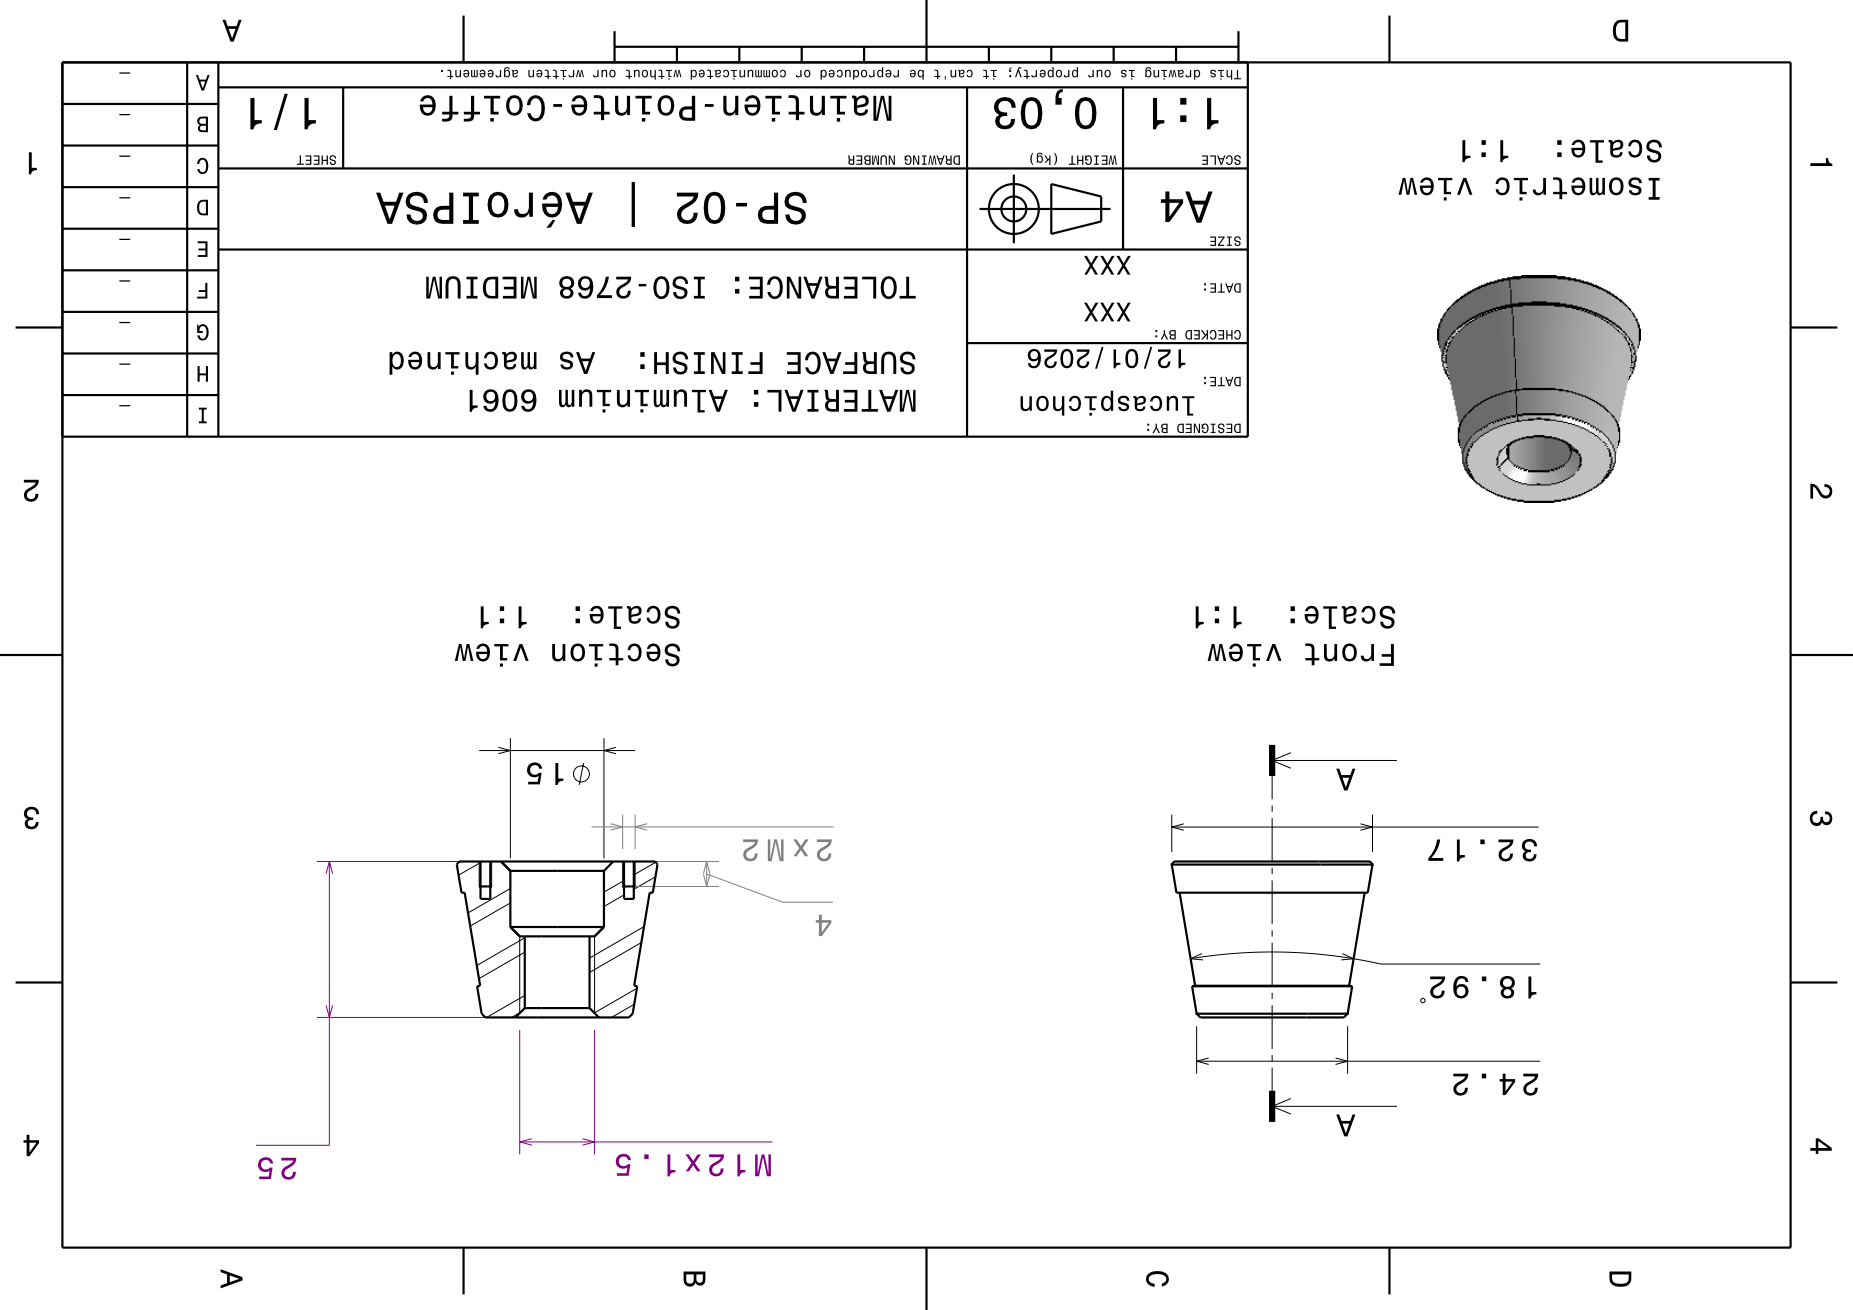
[picture p356: page 1]
