povdoigt/SP-02/ELEC/Schematics/Schematic_SP02_Allumage_2_Condo_2026-03-23.pdf

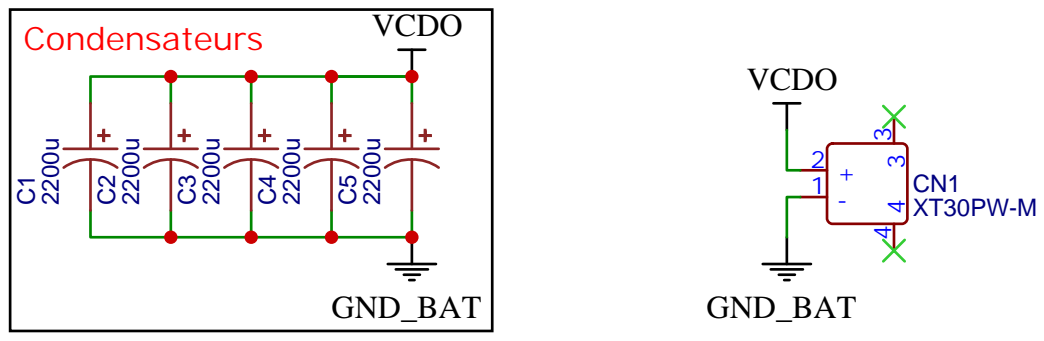
[picture p357: page 1]
