povdoigt/SP-02/ELEC/Schematics/Schematic_SP02_Allumage_2_main_2026-03-23.pdf

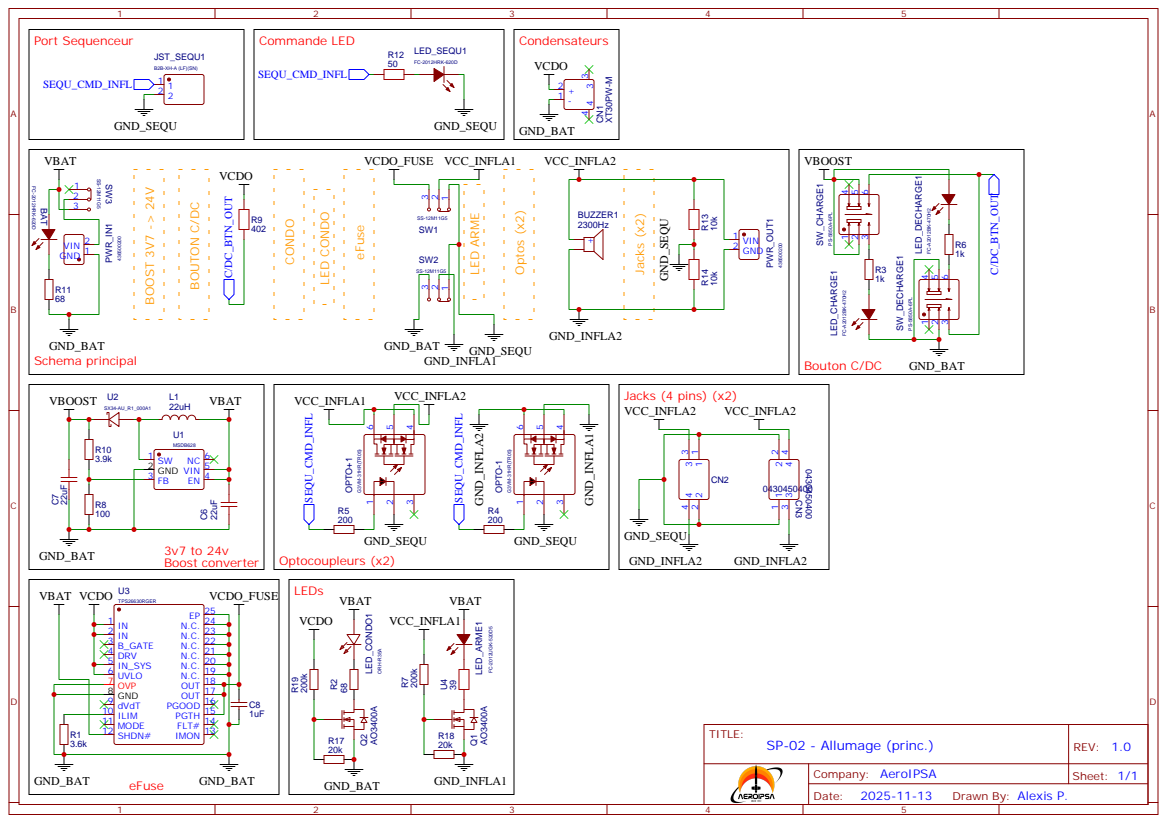
[picture p358: page 1]
