povdoigt/SP-02/ELEC/Schematics/Schematic_SP02_Allumage_4_main_2026-04-27.pdf

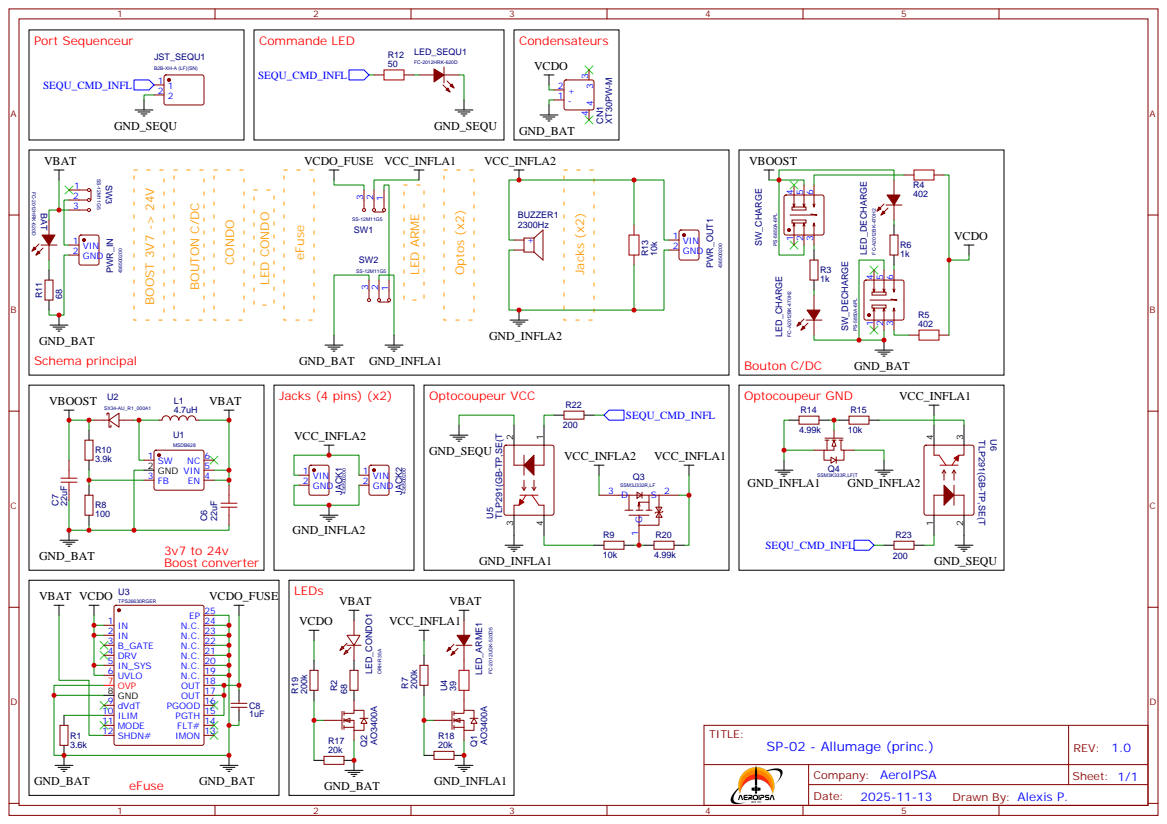
[picture p359: page 1]
