povdoigt/SP-02/ELEC/Schematics/Schematic_SP02_CAMERA_2026-03-23.pdf

# LECTEUR SD

# MICROCONTROLEUR

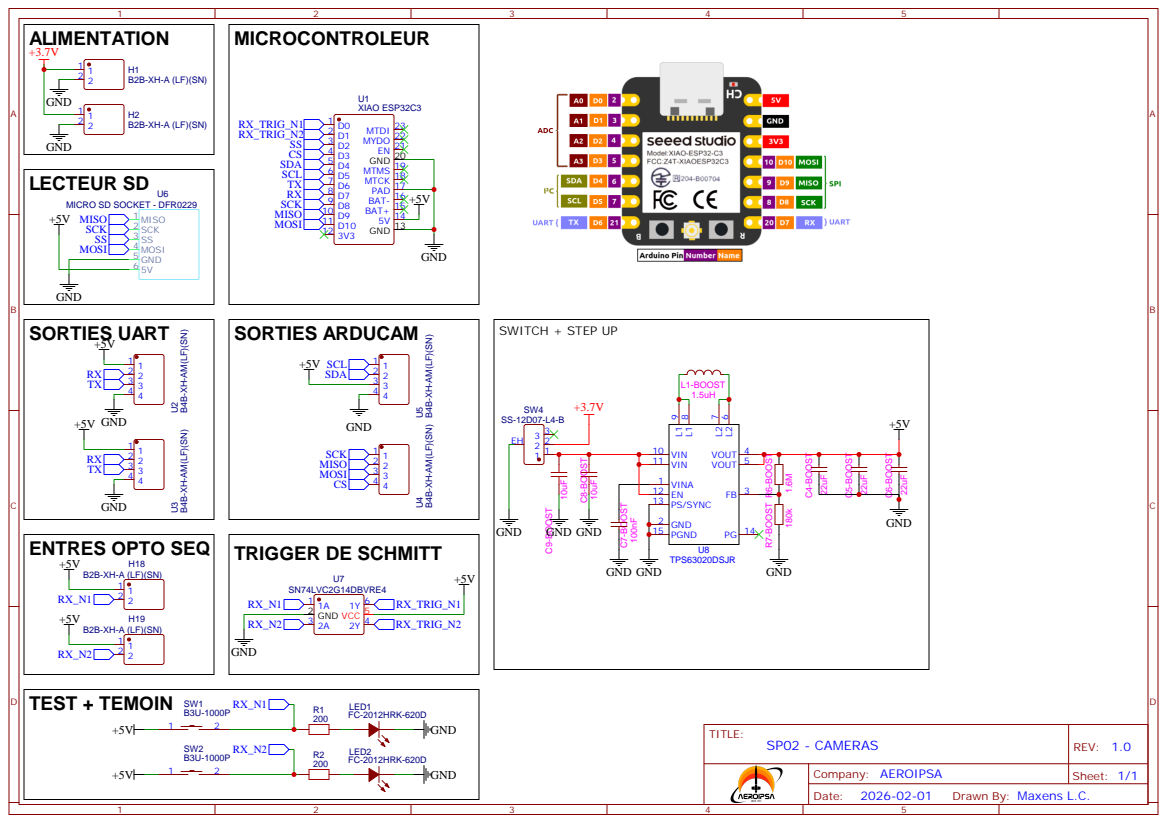
[picture p360: page 1]
