povdoigt/SP-02/ELEC/Schematics/Schematic_SP02_CONNECTION_SEPA_2026-03-23.pdf

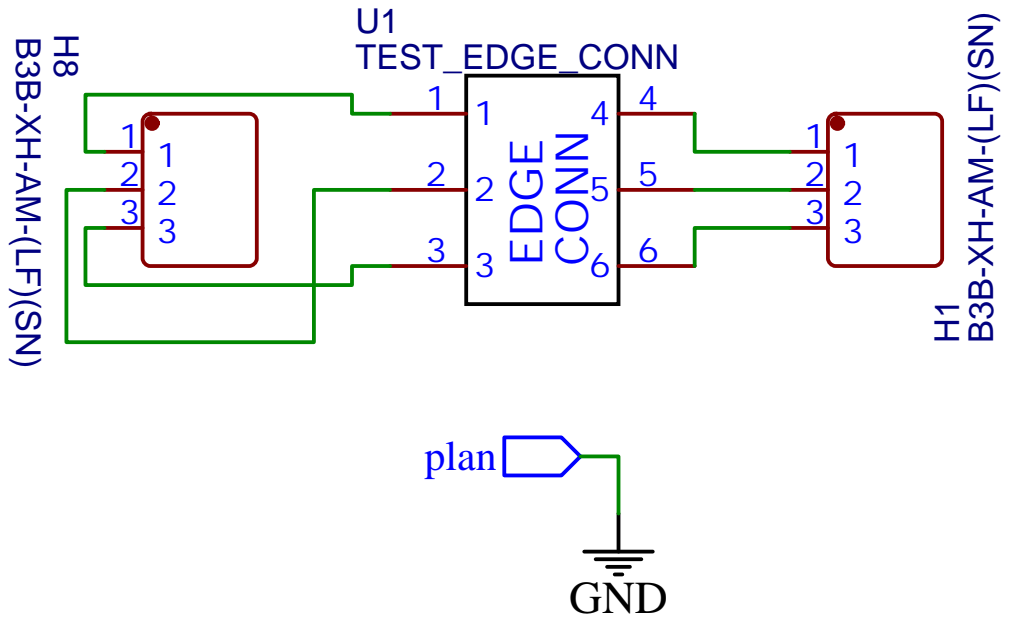
[picture p361: page 1]
