povdoigt/SP-02/RAPPORT/DOSSIER SUIVI/figures/annexe/MECA/Beta_sepa_principale.pdf

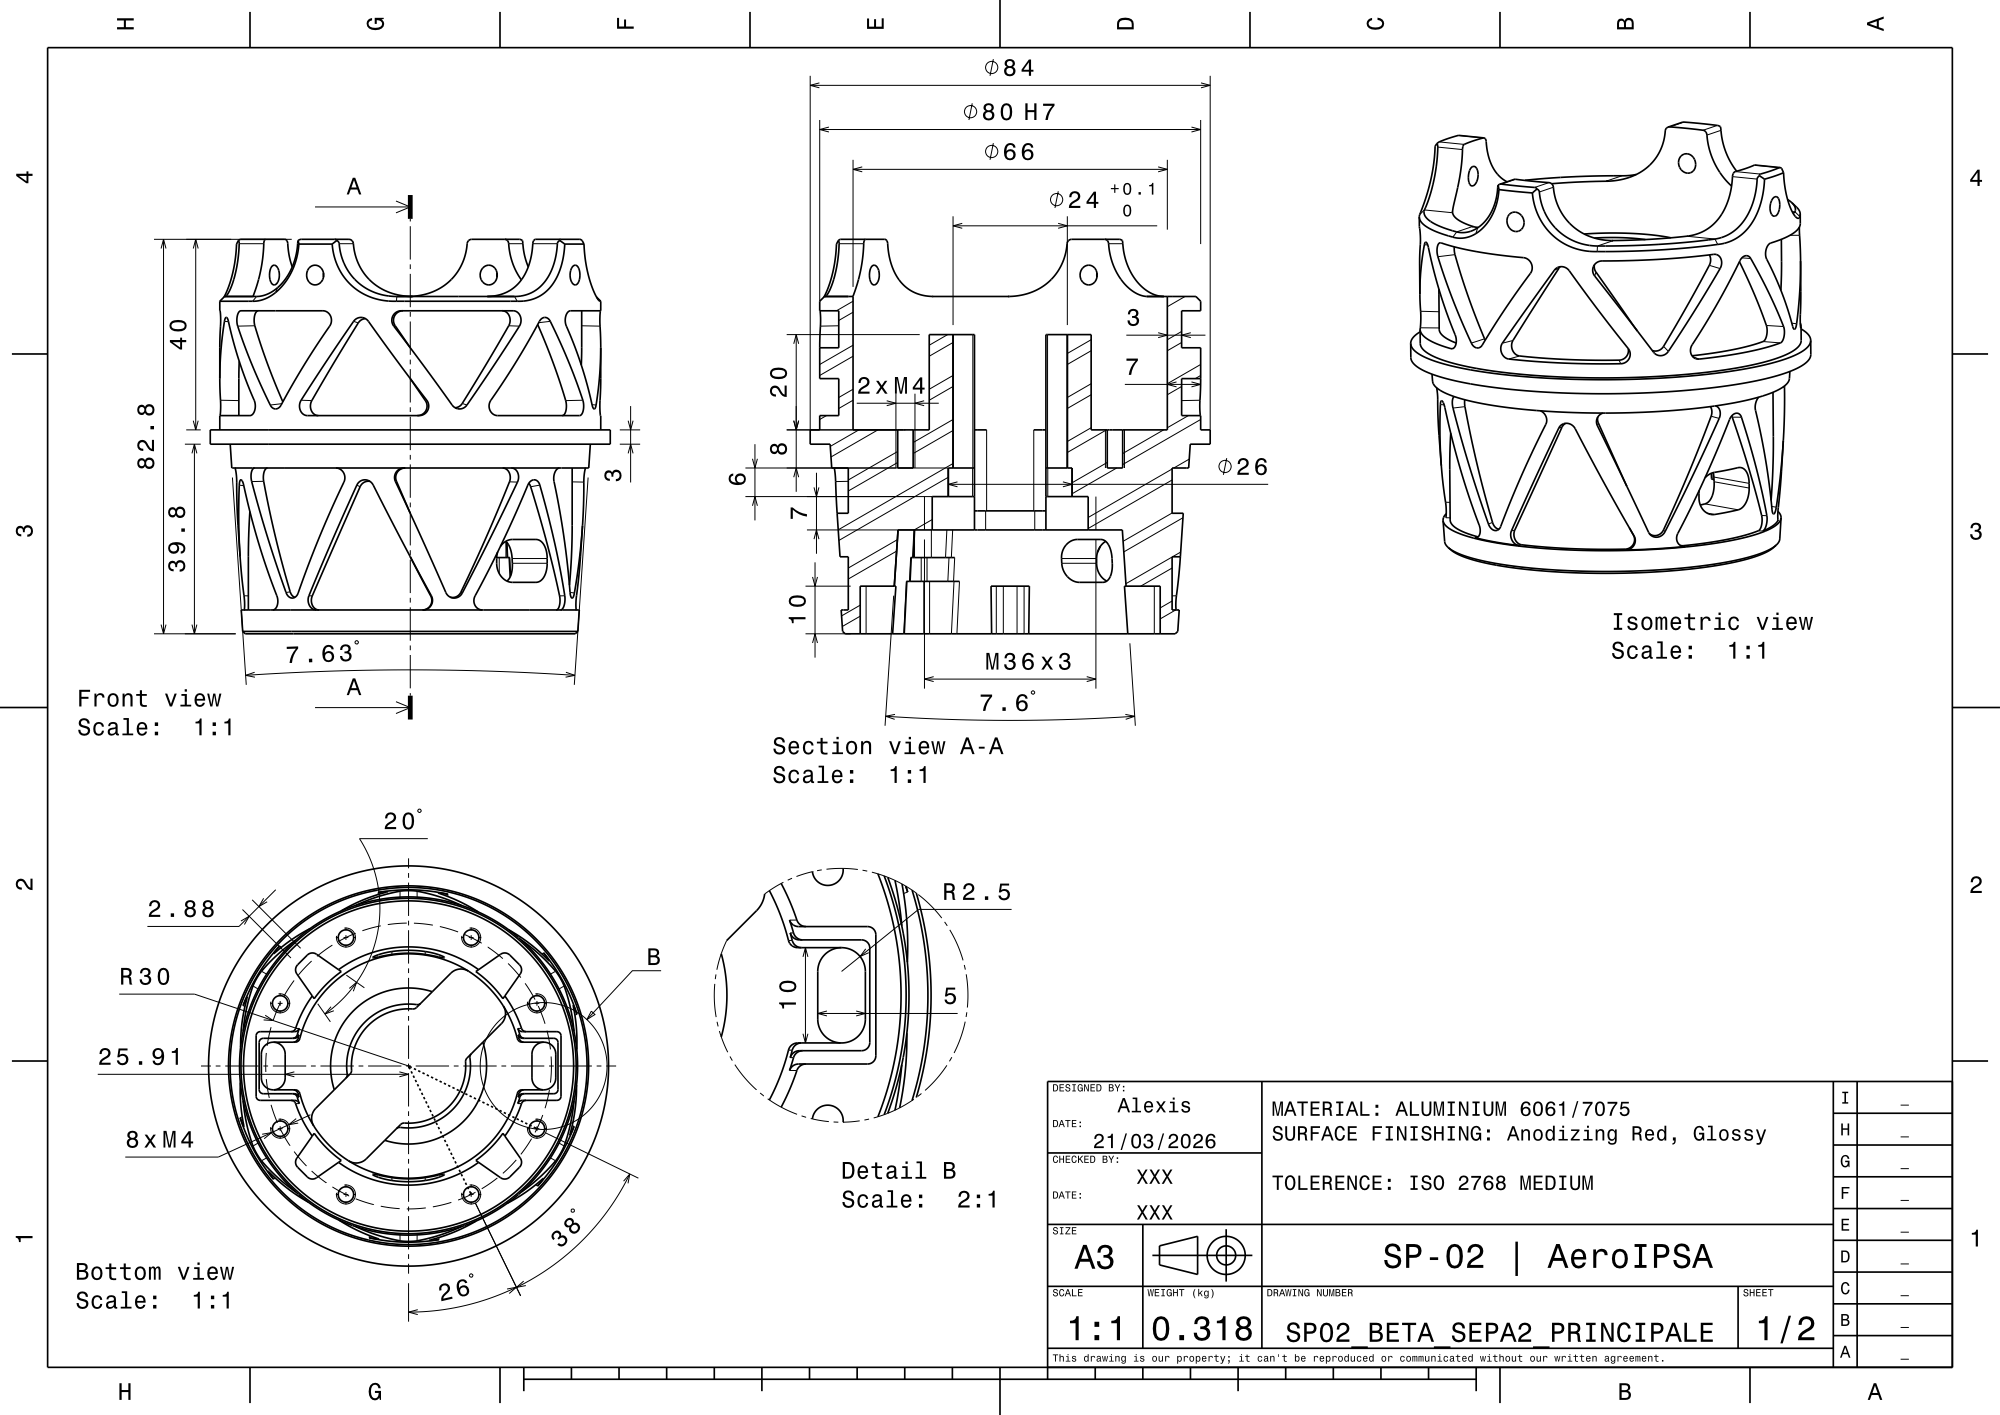
[picture p362: page 1]

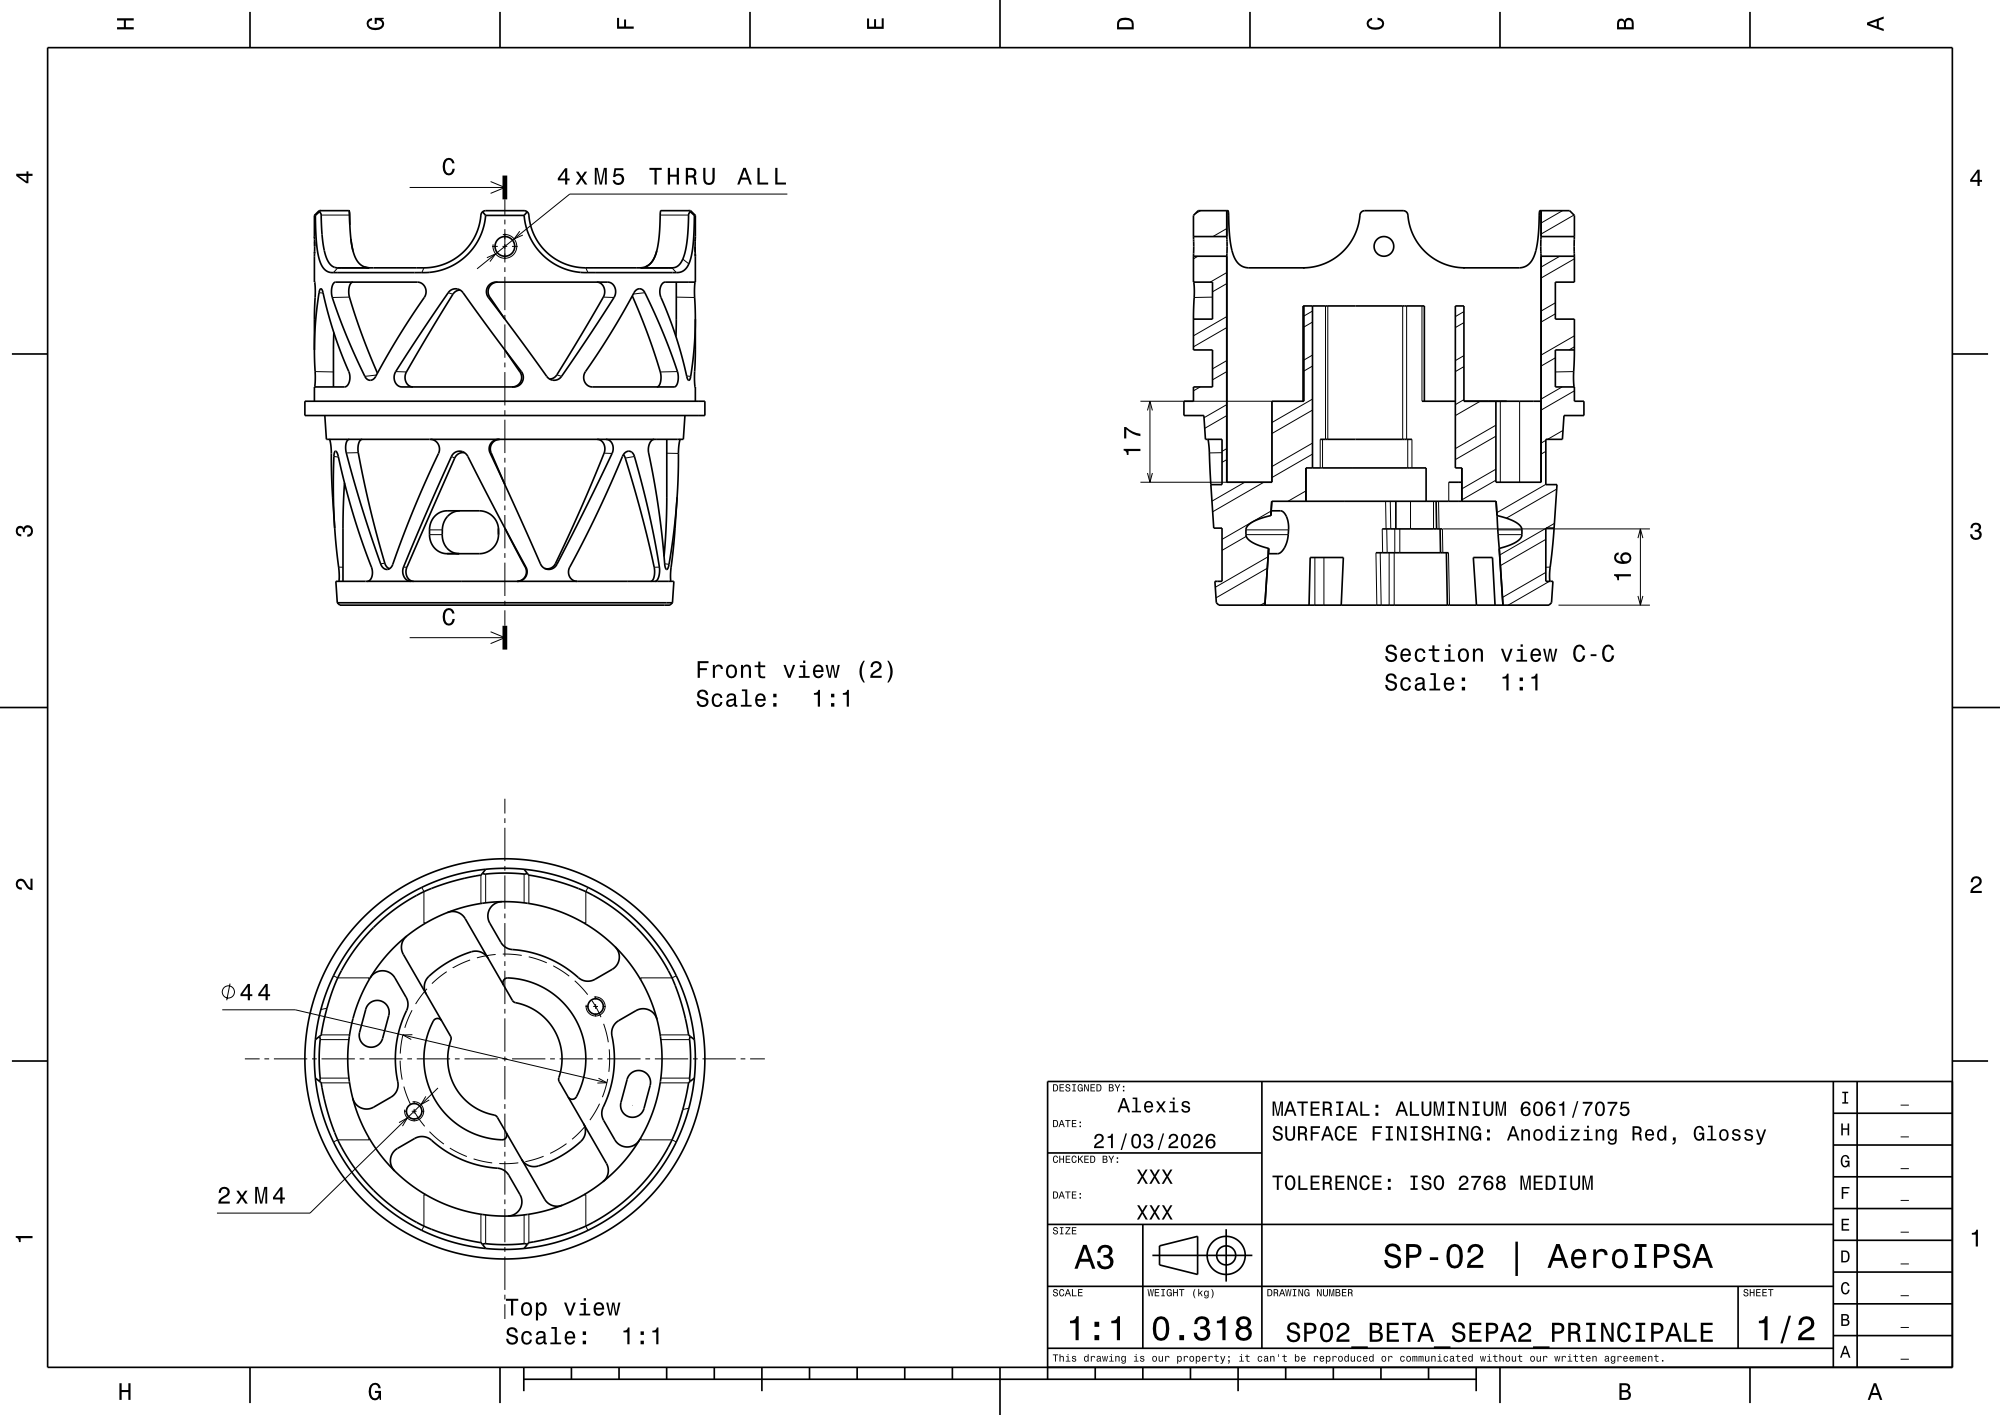
[picture p363: page 2]
