povdoigt/SP-02/RAPPORT/DOSSIER SUIVI/figures/annexe/MECA/SP02_ALPHA_AF_BLOC_DRAW.pdf

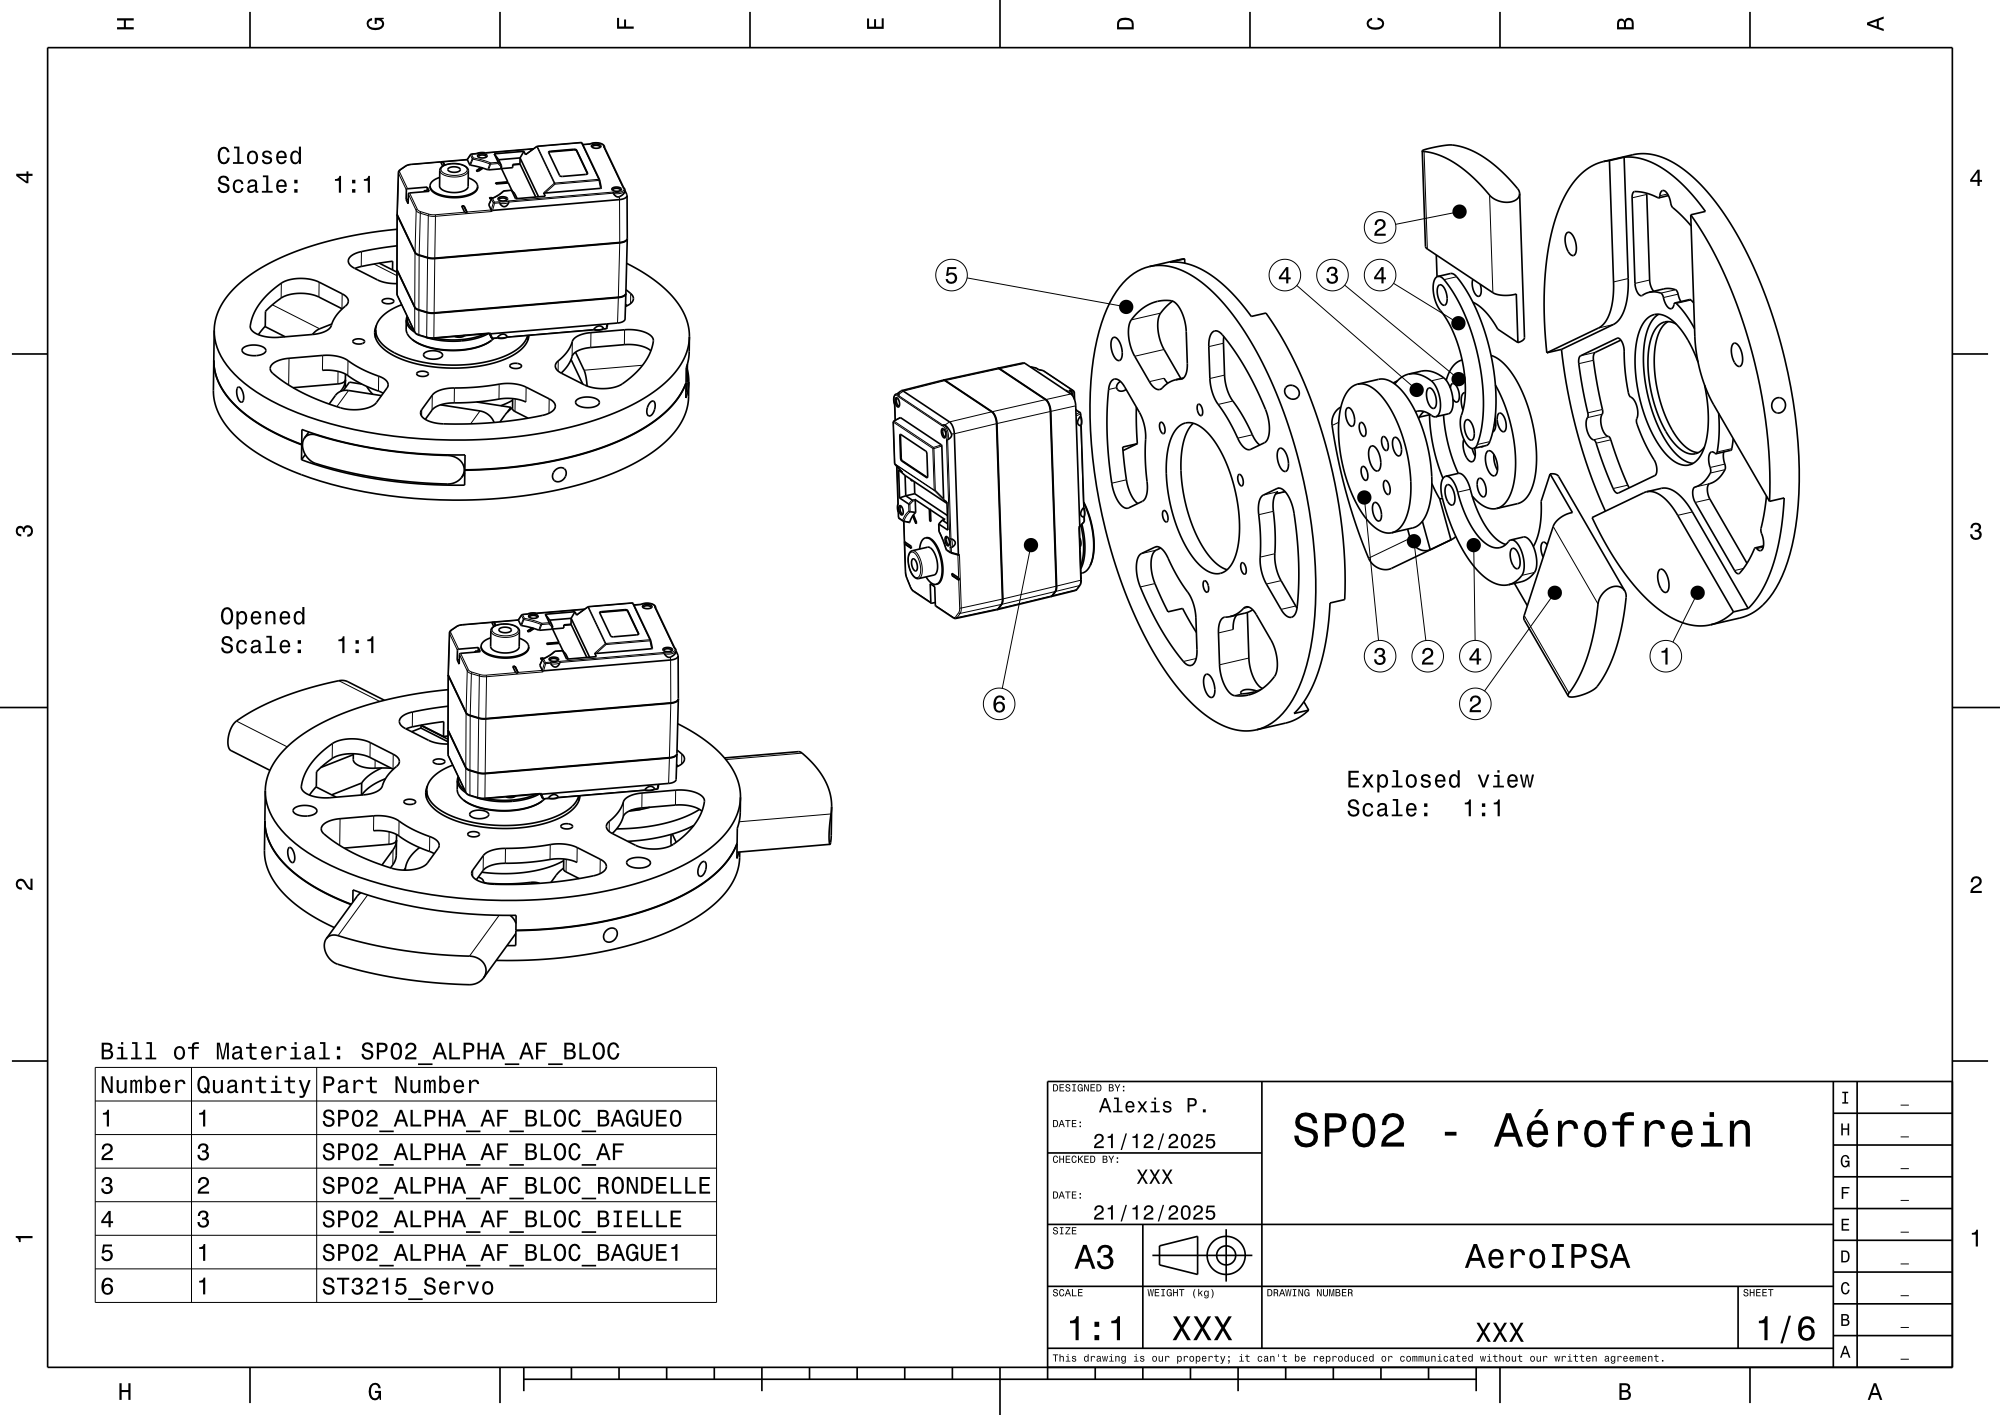
[picture p364: page 1]

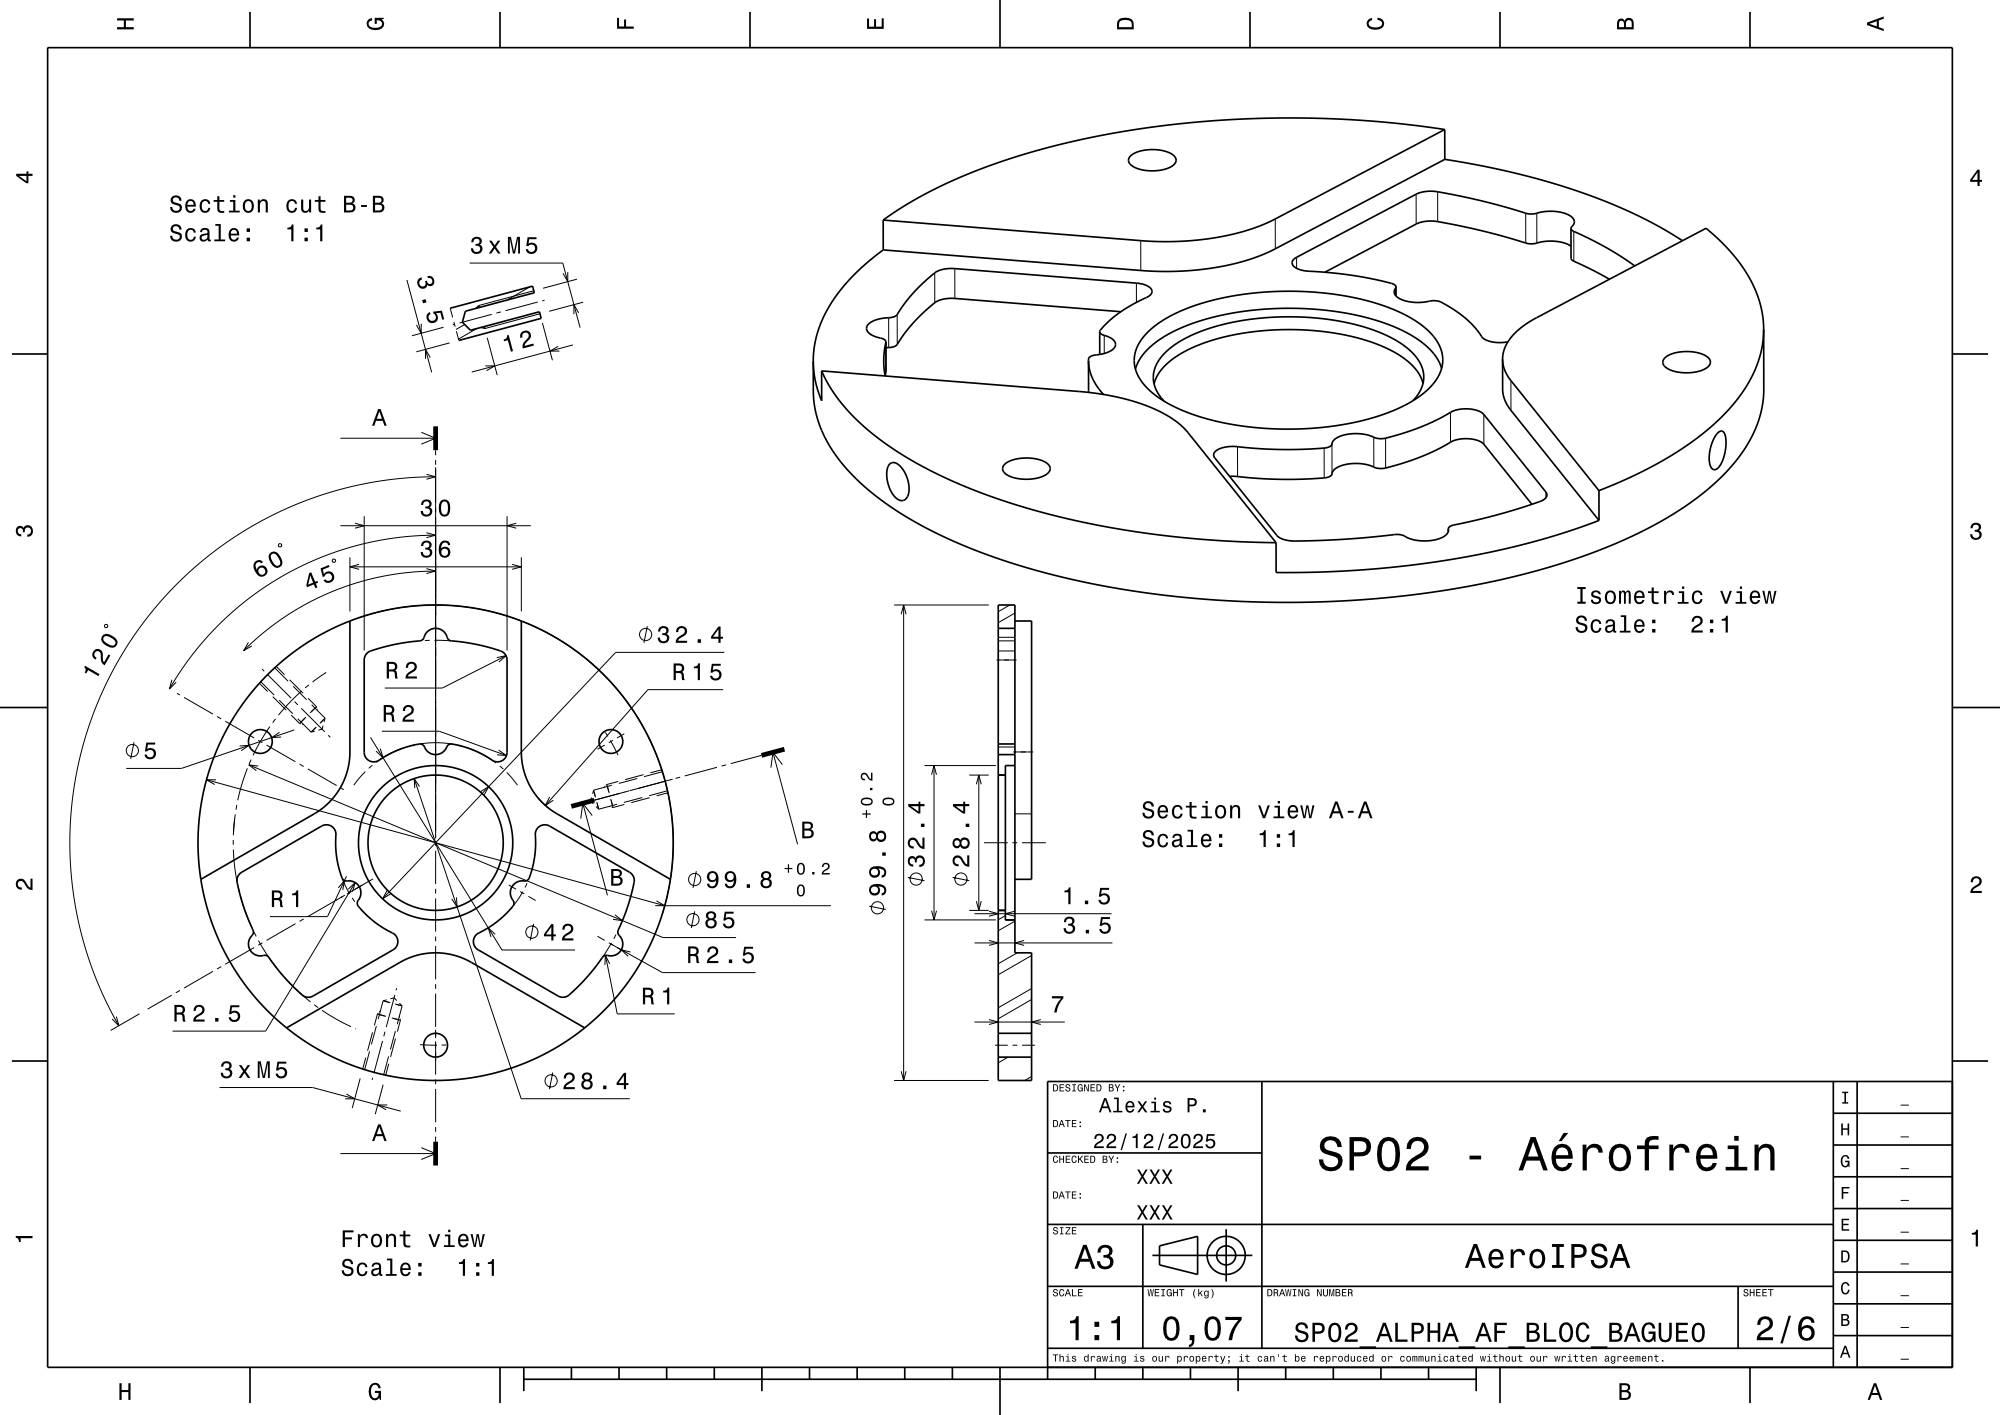
[picture p365: page 2]

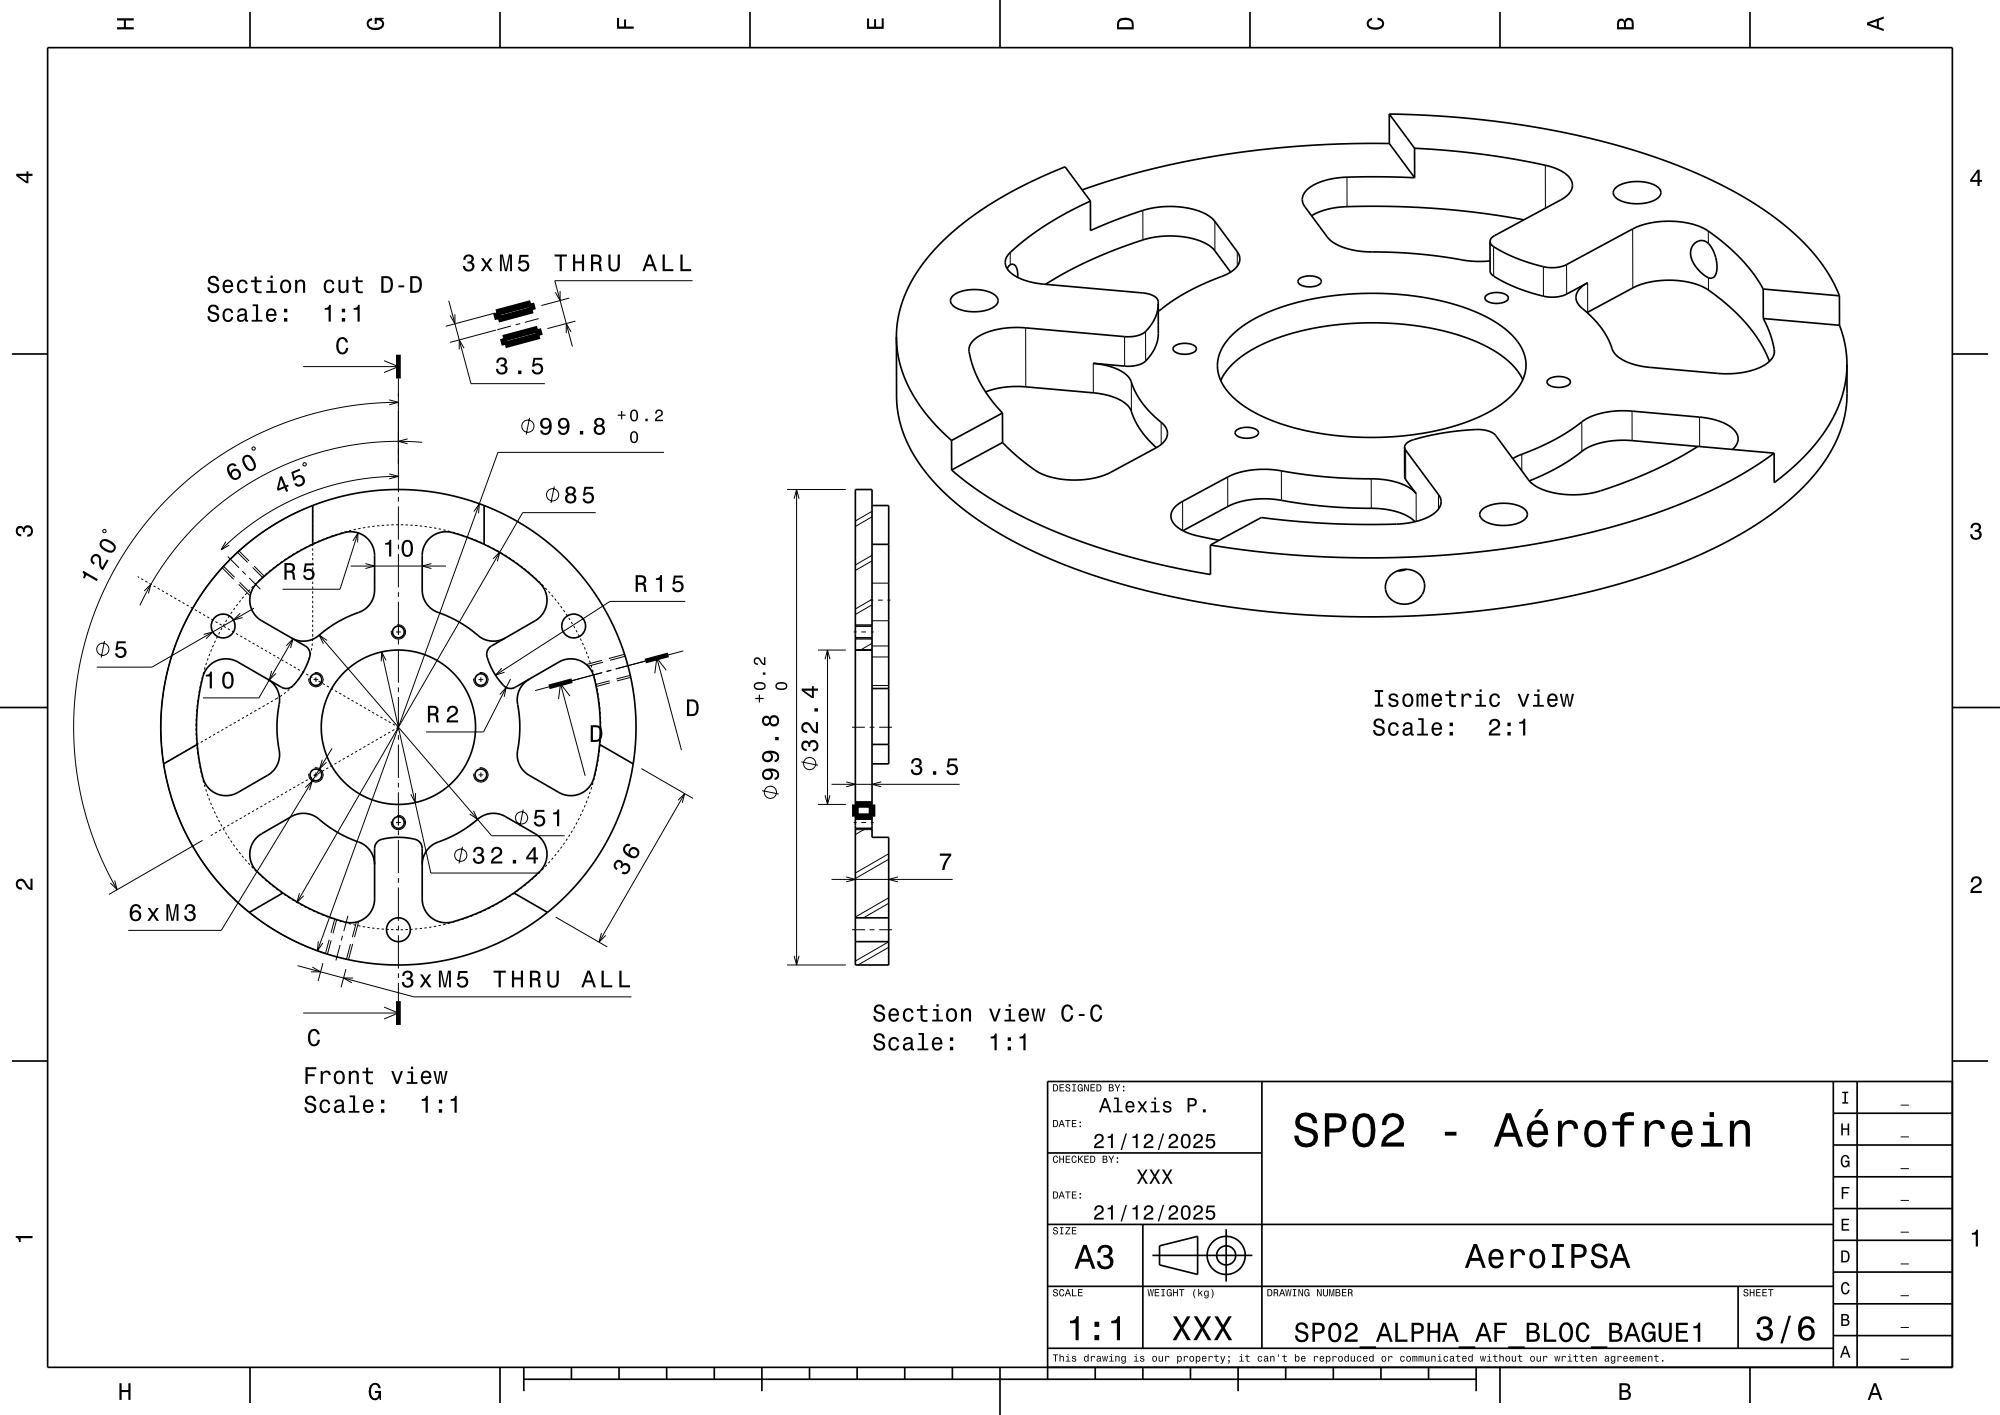
[picture p366: page 3]

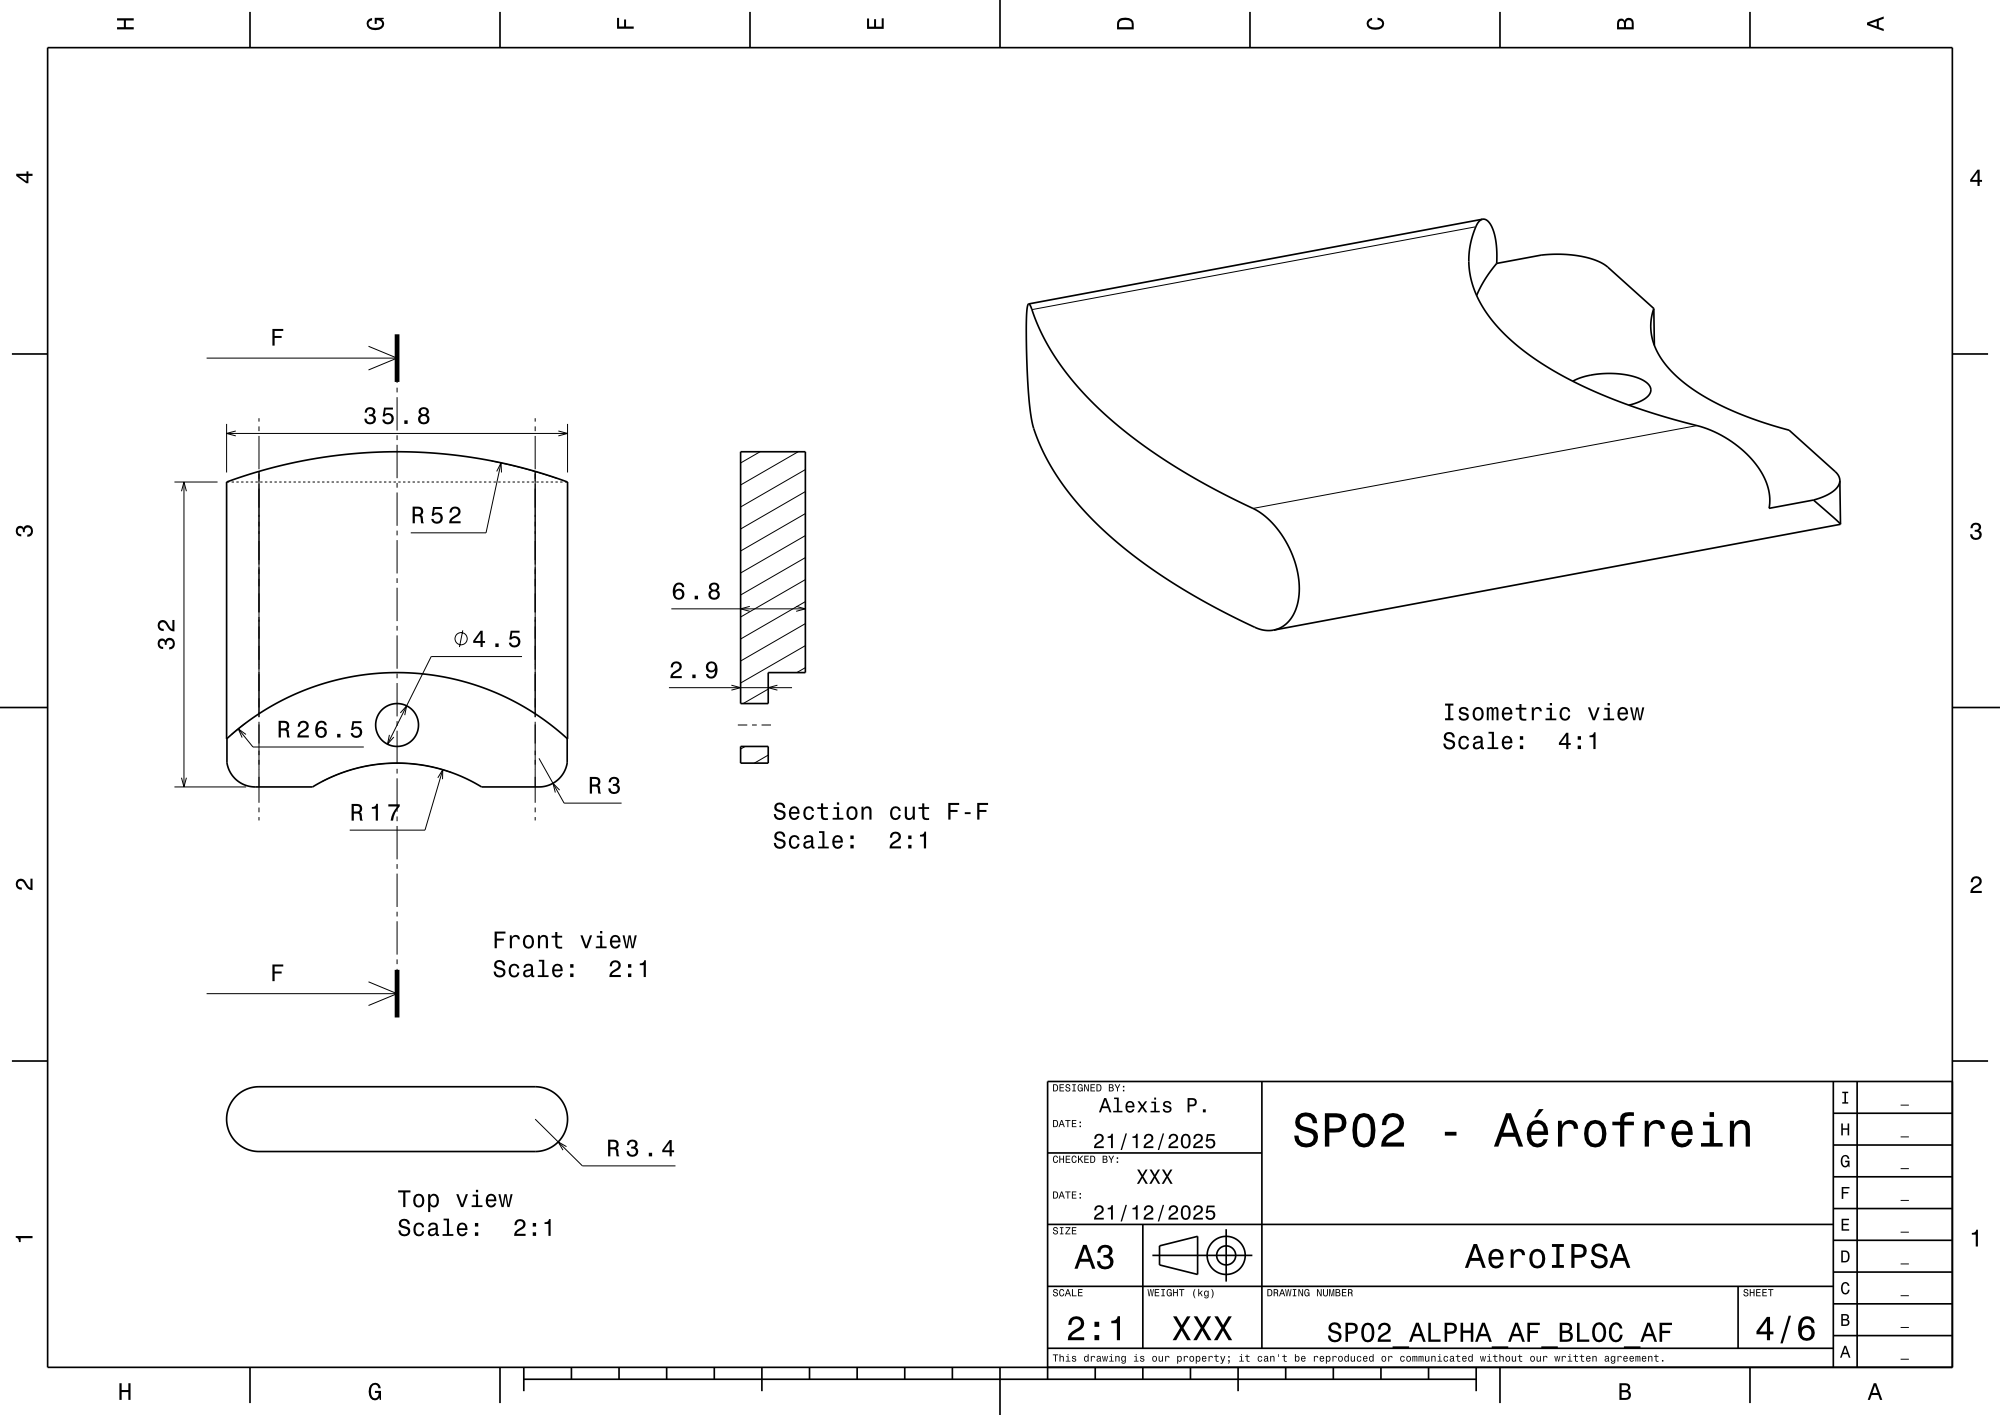
[picture p367: page 4]

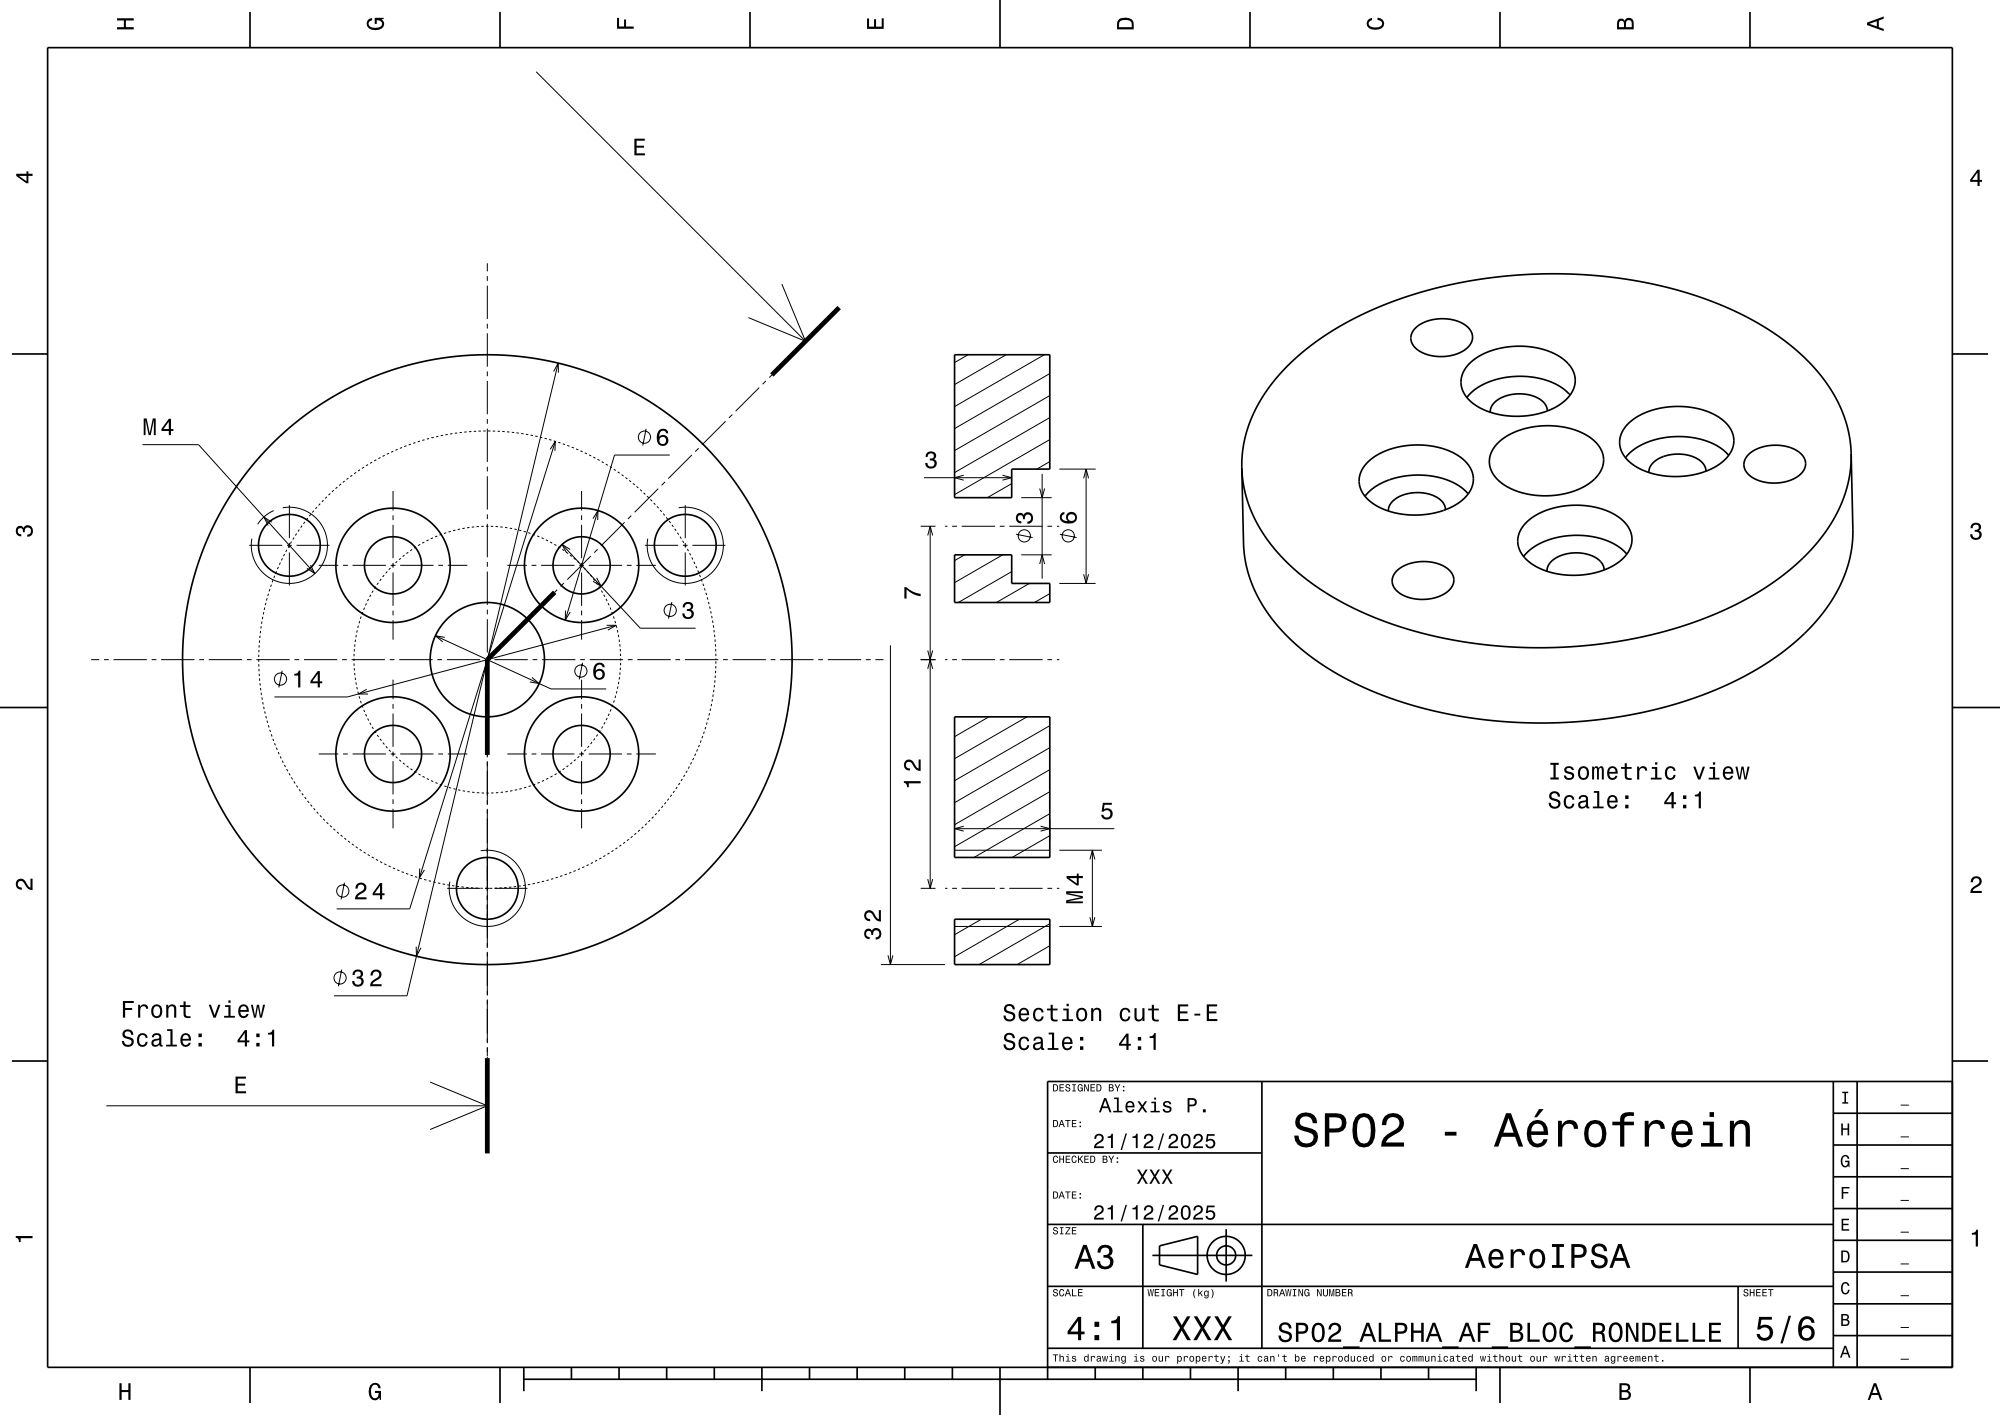
[picture p368: page 5]

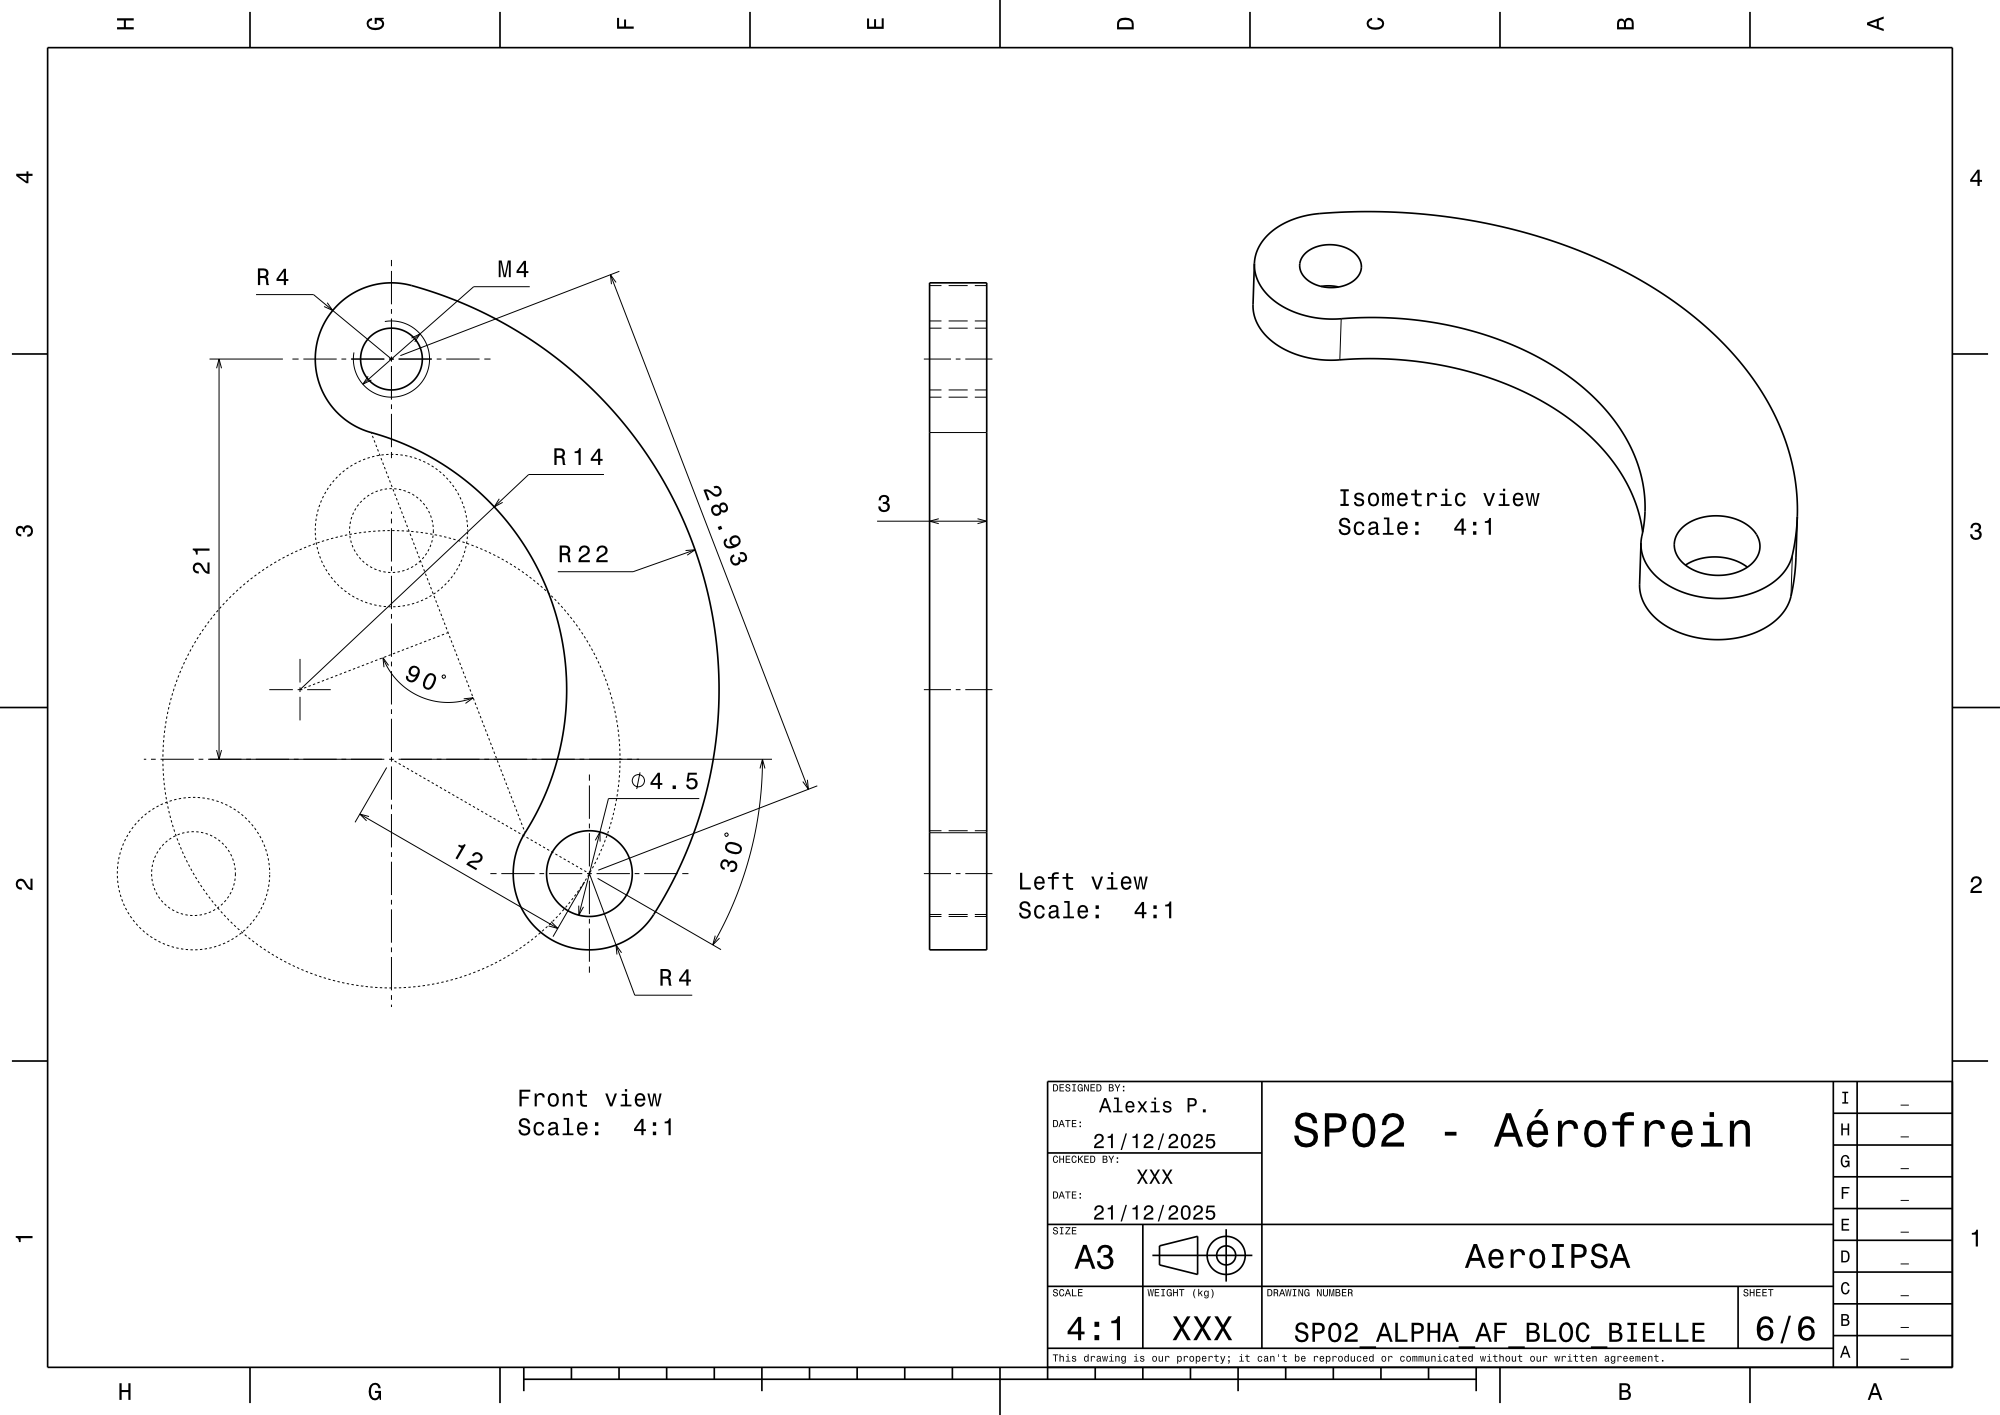
[picture p369: page 6]
