povdoigt/SP-02/ARCHI/LogiGramSP02.pdf

## Opération pyrotechnique

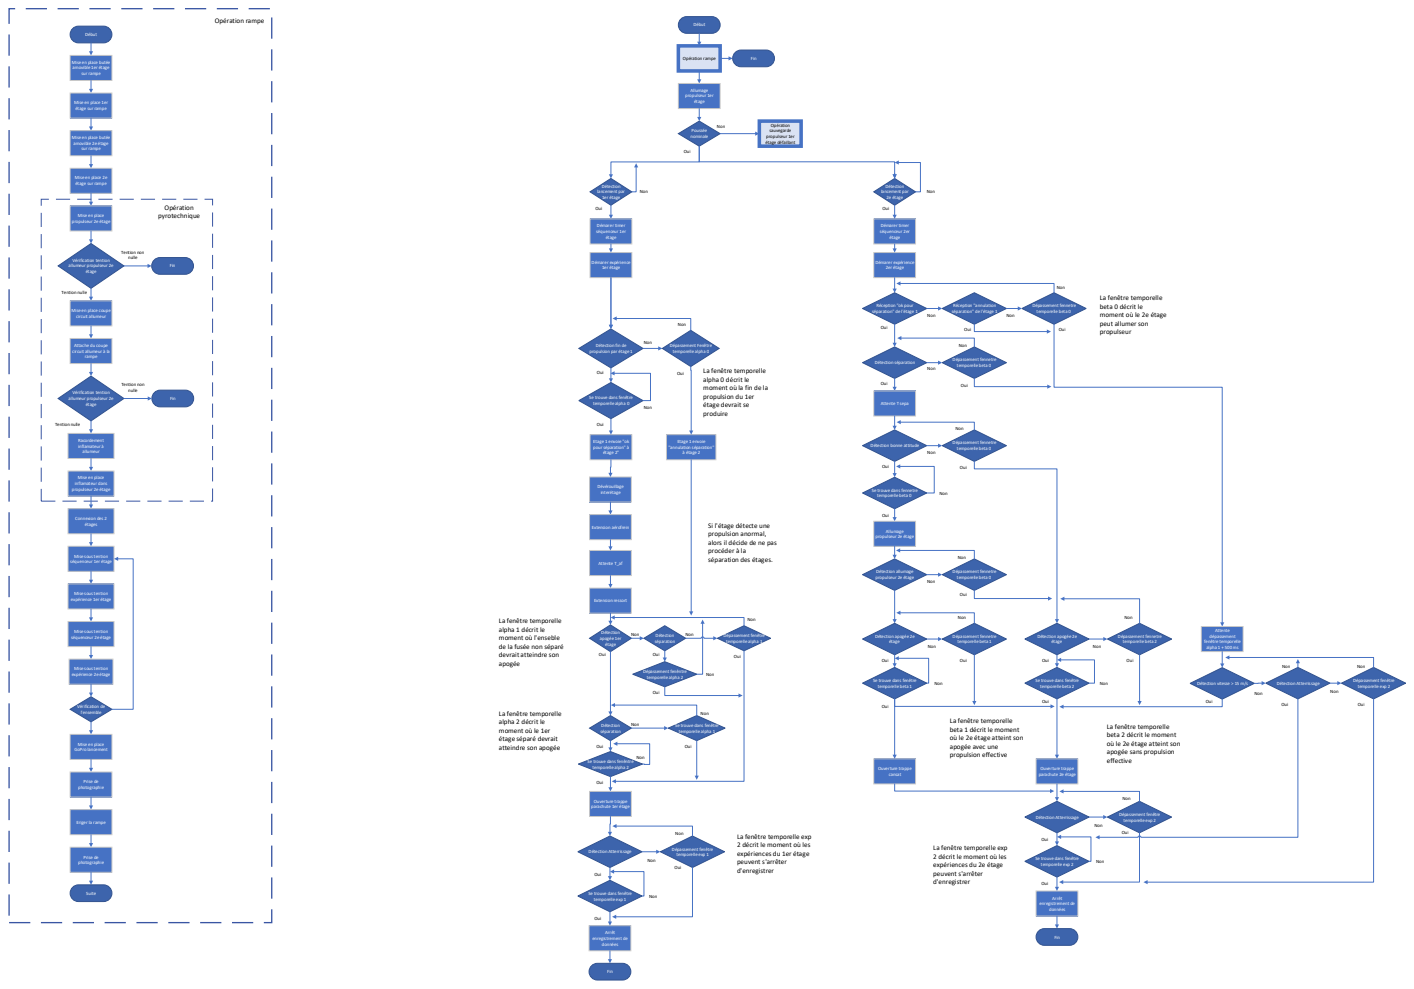
[picture p370: page 1]
Début; Vérification tention allumeur propulseur 2e étage; Fin; Tention non nulle; Tention nulle; Racordement inflamateur à allumeur; Connexion des 2 étages; Vérification de l'ensemble; Prise de photographie; Suite; Opération rampe; Allumage propulseur 1er étage; Démarer expérience 1er étage; Poussée nominale; Opération sauvegarde propulseur 1er étage défaillant; Non; Oui; Dépassement Fenêtre temporelle alpha 0; Dévérouillage interétage; Extension aérofrein; Détection lancement par 1er étage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

Mise en place butée
amovible 1er étage
sur rampe

Mise en place 1er
étage sur rampe

amovible 2e étage

Mise en place 2e

Mise en place
propulseur 2e étage

La fenêtre temporelle
beta 0 décrit le
moment où le 2e étage
peut allumer son
propulseur

Réception "ok pour
séparation" de l'étage 1

Réception "annulation

Mise en place coupe
circuit allumeur

Attache du coupe
circuit allumeur à la
rampe

Détection fin de
propulsion par étage 1

alpha 0 décrit le
moment où la fin de la
propulsion du 1er
étage devrait se
produire

Se trouve dans fenêtre
temporelle alpha 0

Etage 1 envoie "ok
pour séparation" à
étage 2"

Détection bonne attitude

inflamateur dans

Se trouve dans fennetre
temporelle beta 0

Si l'étage détecte une
propulsion anormal,
alors il décide de ne pas
procéder à la
séparation des étages.

Mise sous tention
séquenceur 1er étage

expérience 1er étage

alpha 1 décrit le
moment où l'enseble
de la fusée non séparé
devrait atteindre son
apogée

séquenceur 2e étage

expérience 2e étage

temporelle beta 1

temporelle beta 2

alpha 2 décrit le
moment où le 1er
étage séparé devrait
atteindre son apogée

beta 1 décrit le moment
où le 2e étage atteint son
apogée avec une
propulsion effective

temporelle alpha 1

beta 2 décrit le moment
apogée sans propulsion
effective

GoPro lancement

Se trouve dans fenêntre
temporelle alpha 2

Eriger la rampe

La fenêtre temporelle exp
2 décrit le moment où les
expériences du 1er étage
peuvent s'arrêter
d'enregistrer

expériences du 2e étage

temporelle exp 2

temporelle exp 1
