povdoigt/SP-02/CATIA/CATIA_vol/Drawing_ailerons.pdf

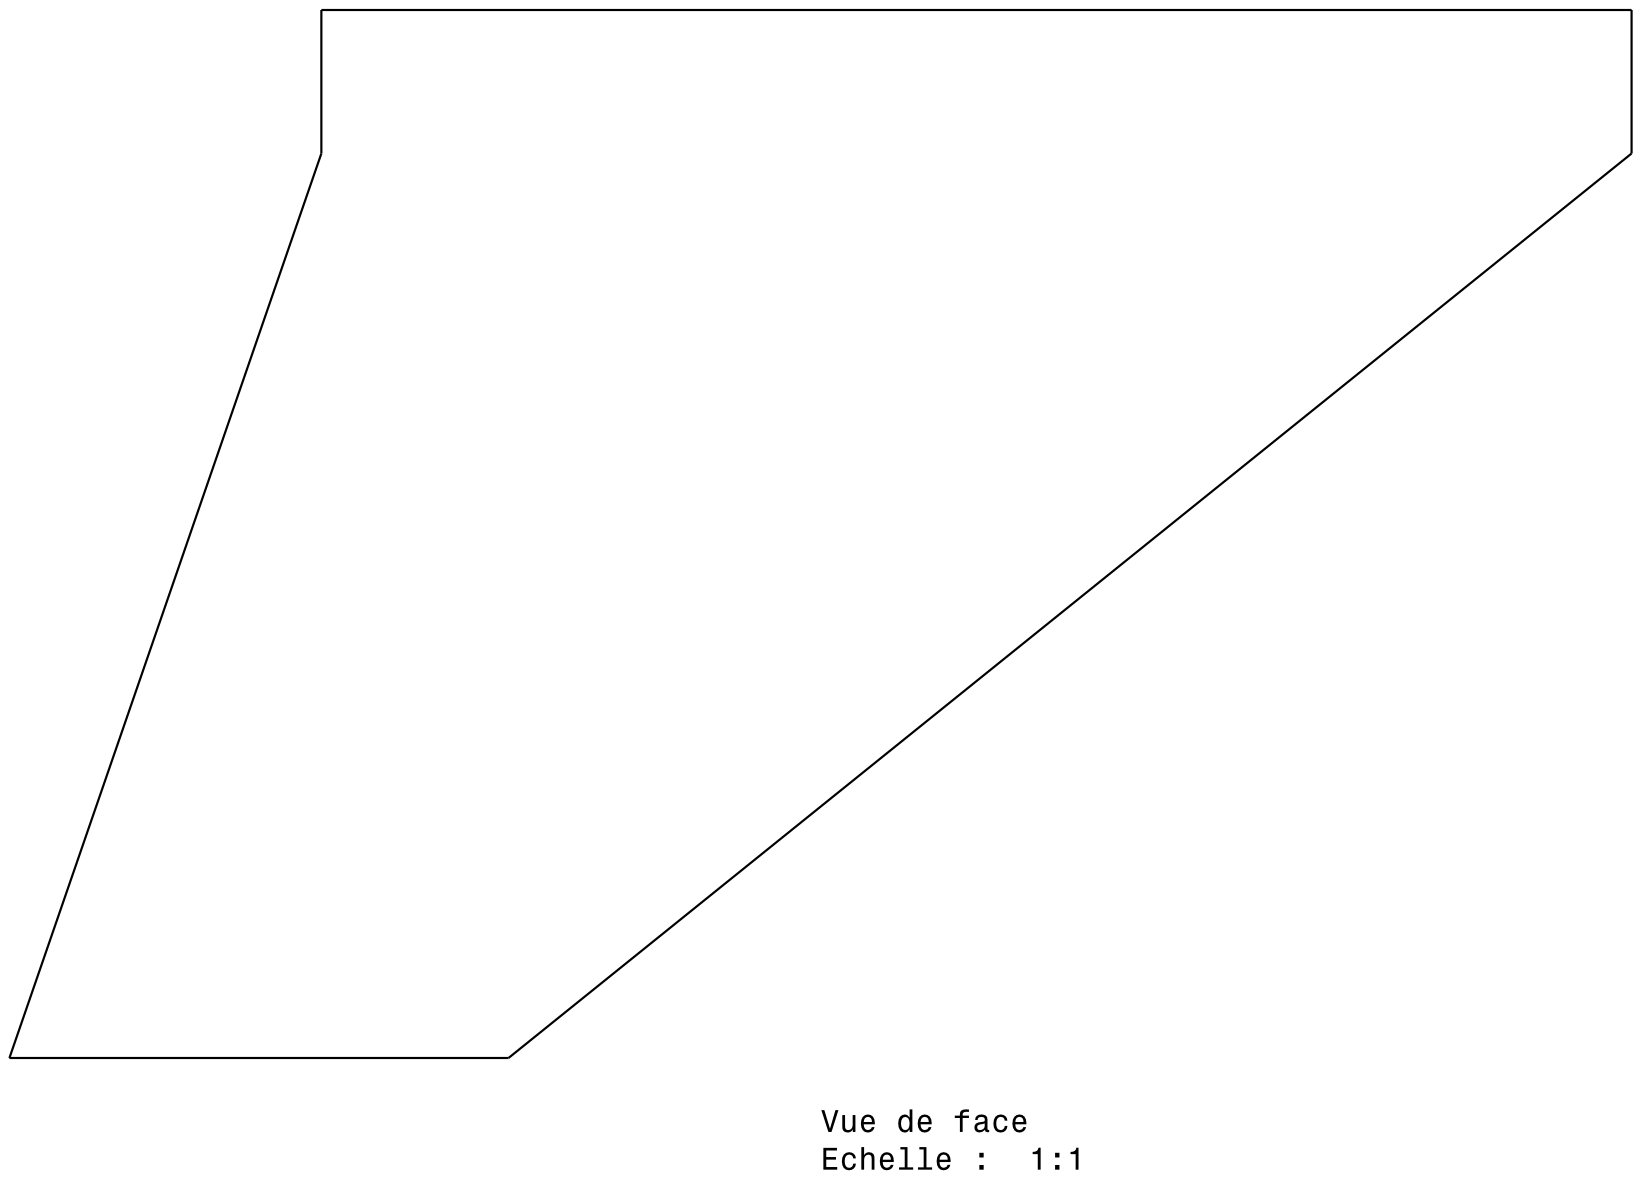
[picture p371: page 1]
