povdoigt/SP-02/CATIA/CATIA_vol/Drawings/ALPHA_Bague_Para_Etage_1.pdf

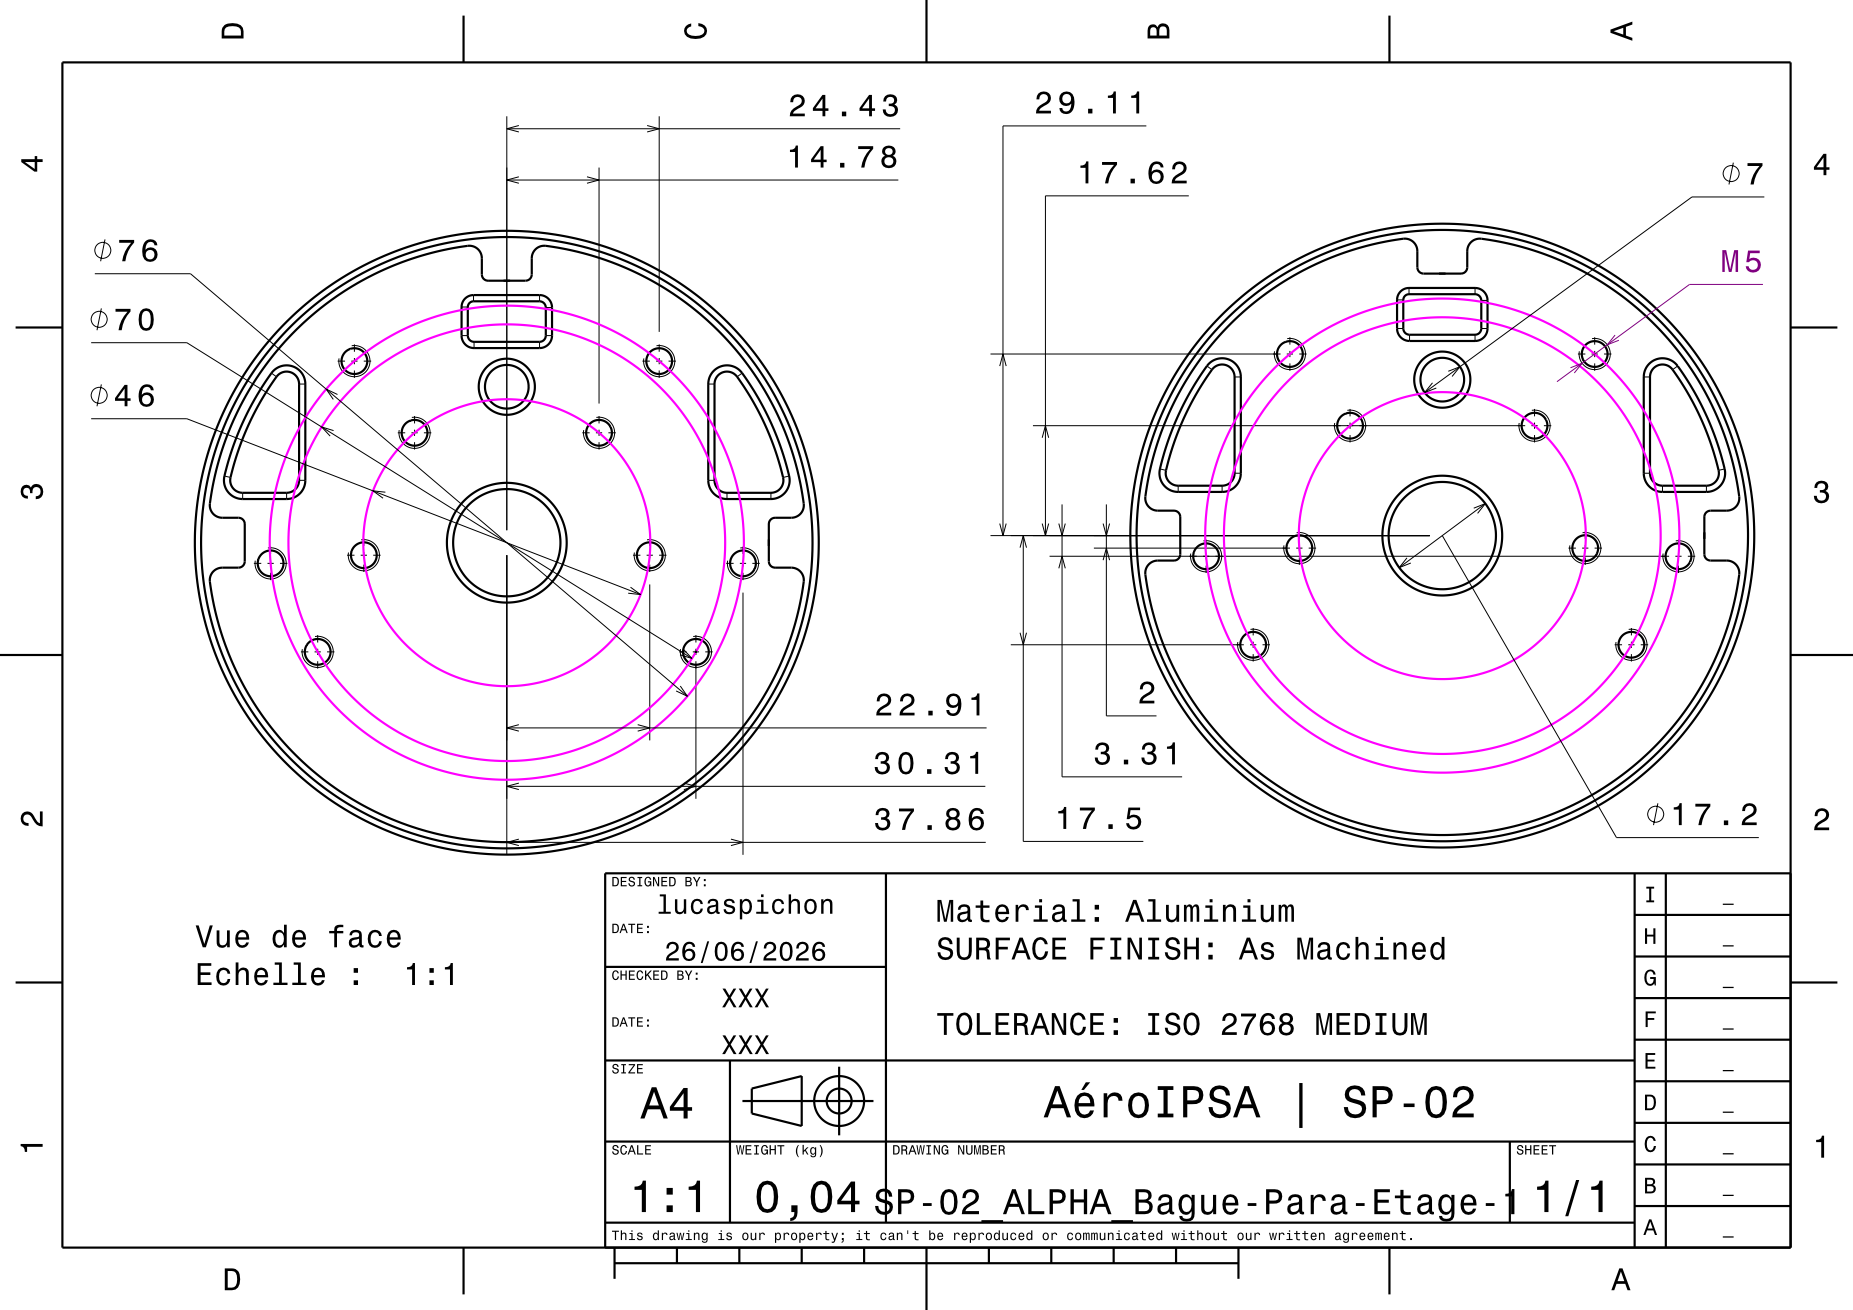
[picture p372: page 1]
