povdoigt/SP-02/CATIA/CATIA_vol/Drawings/Alpha_crochet_trappe.pdf

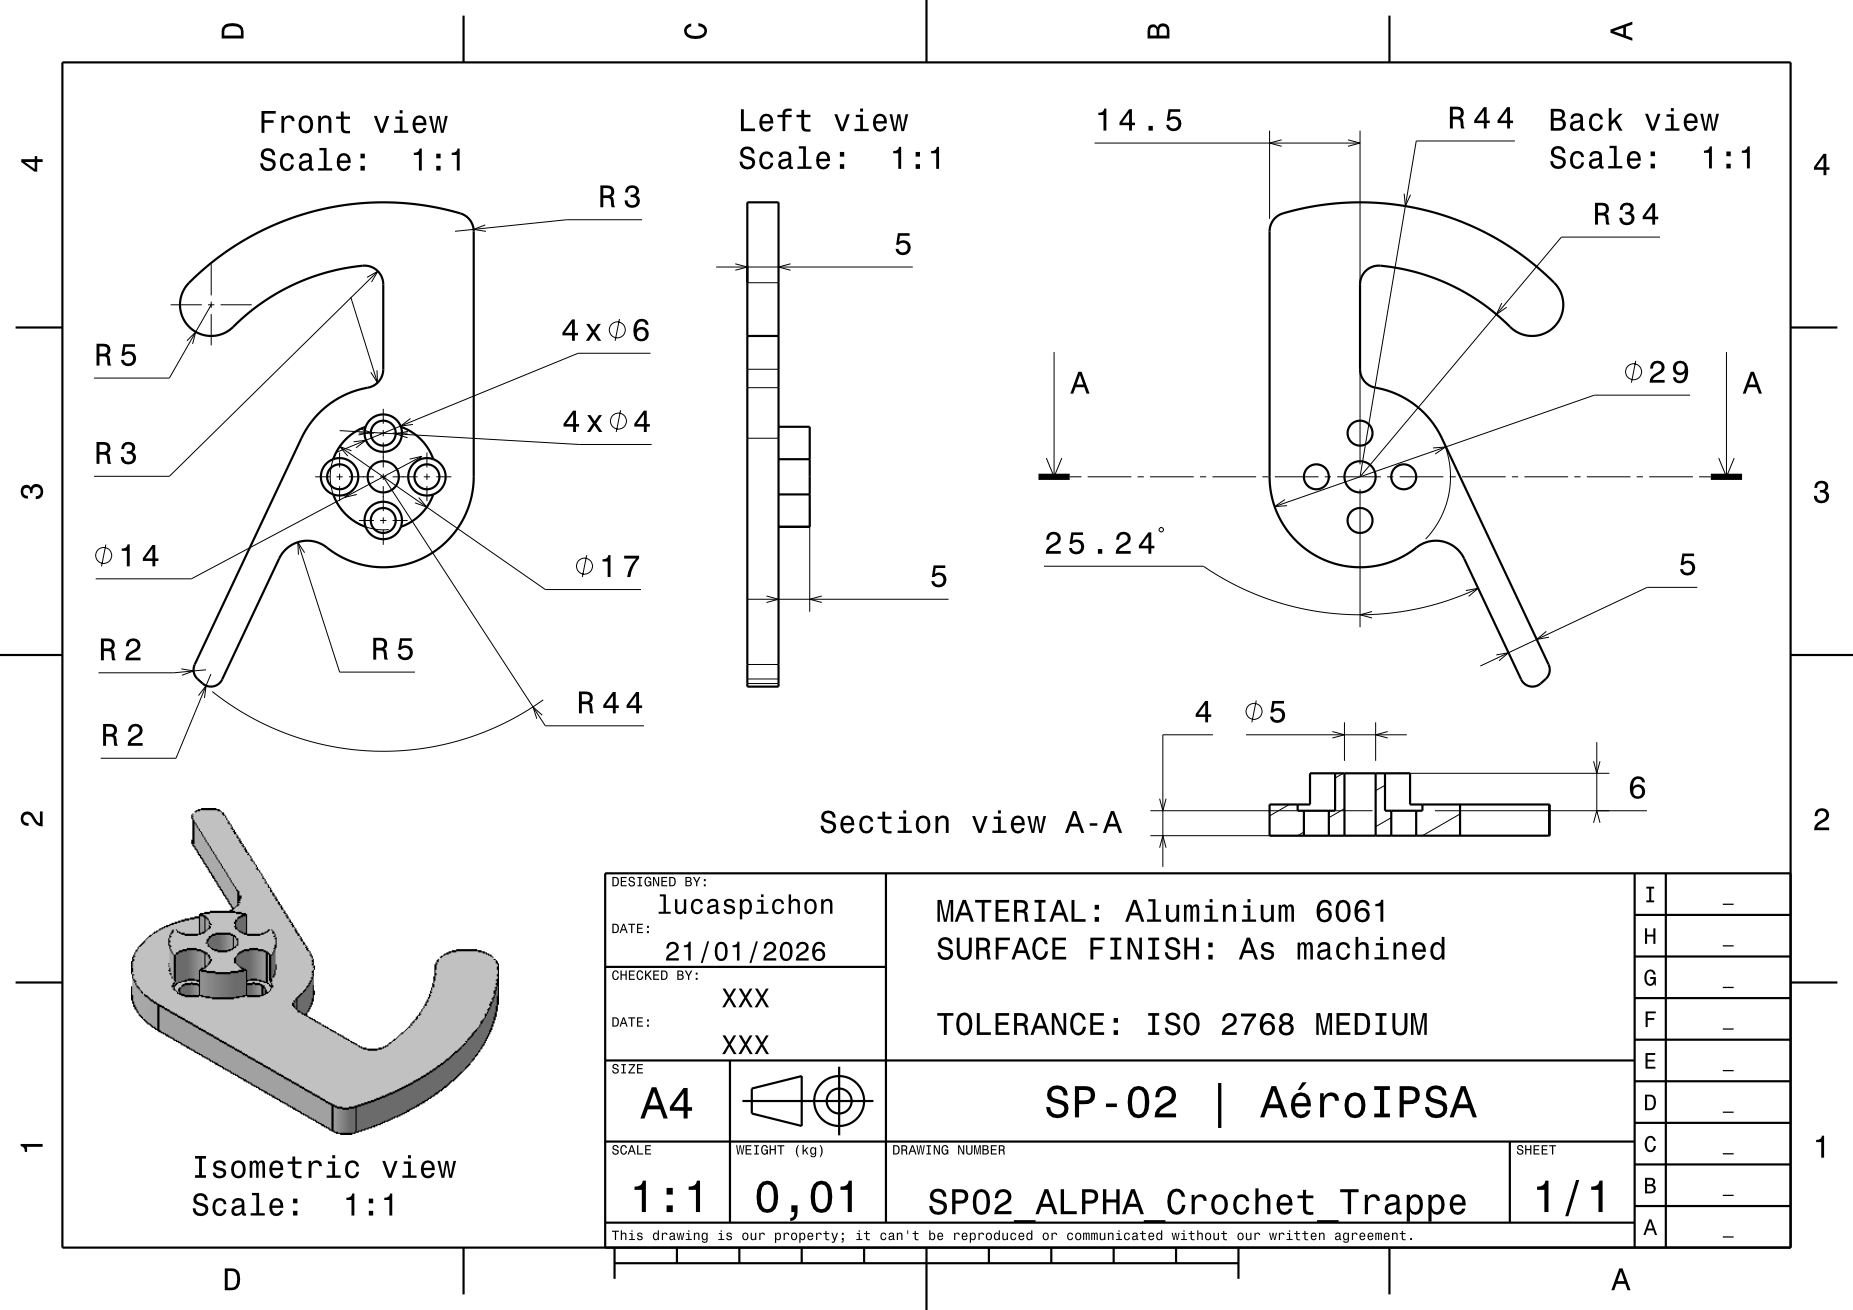
[picture p373: page 1]
