povdoigt/SP-02/CATIA/CATIA_vol/Drawings/Alpha_sepa_principale_Calque_1.pdf

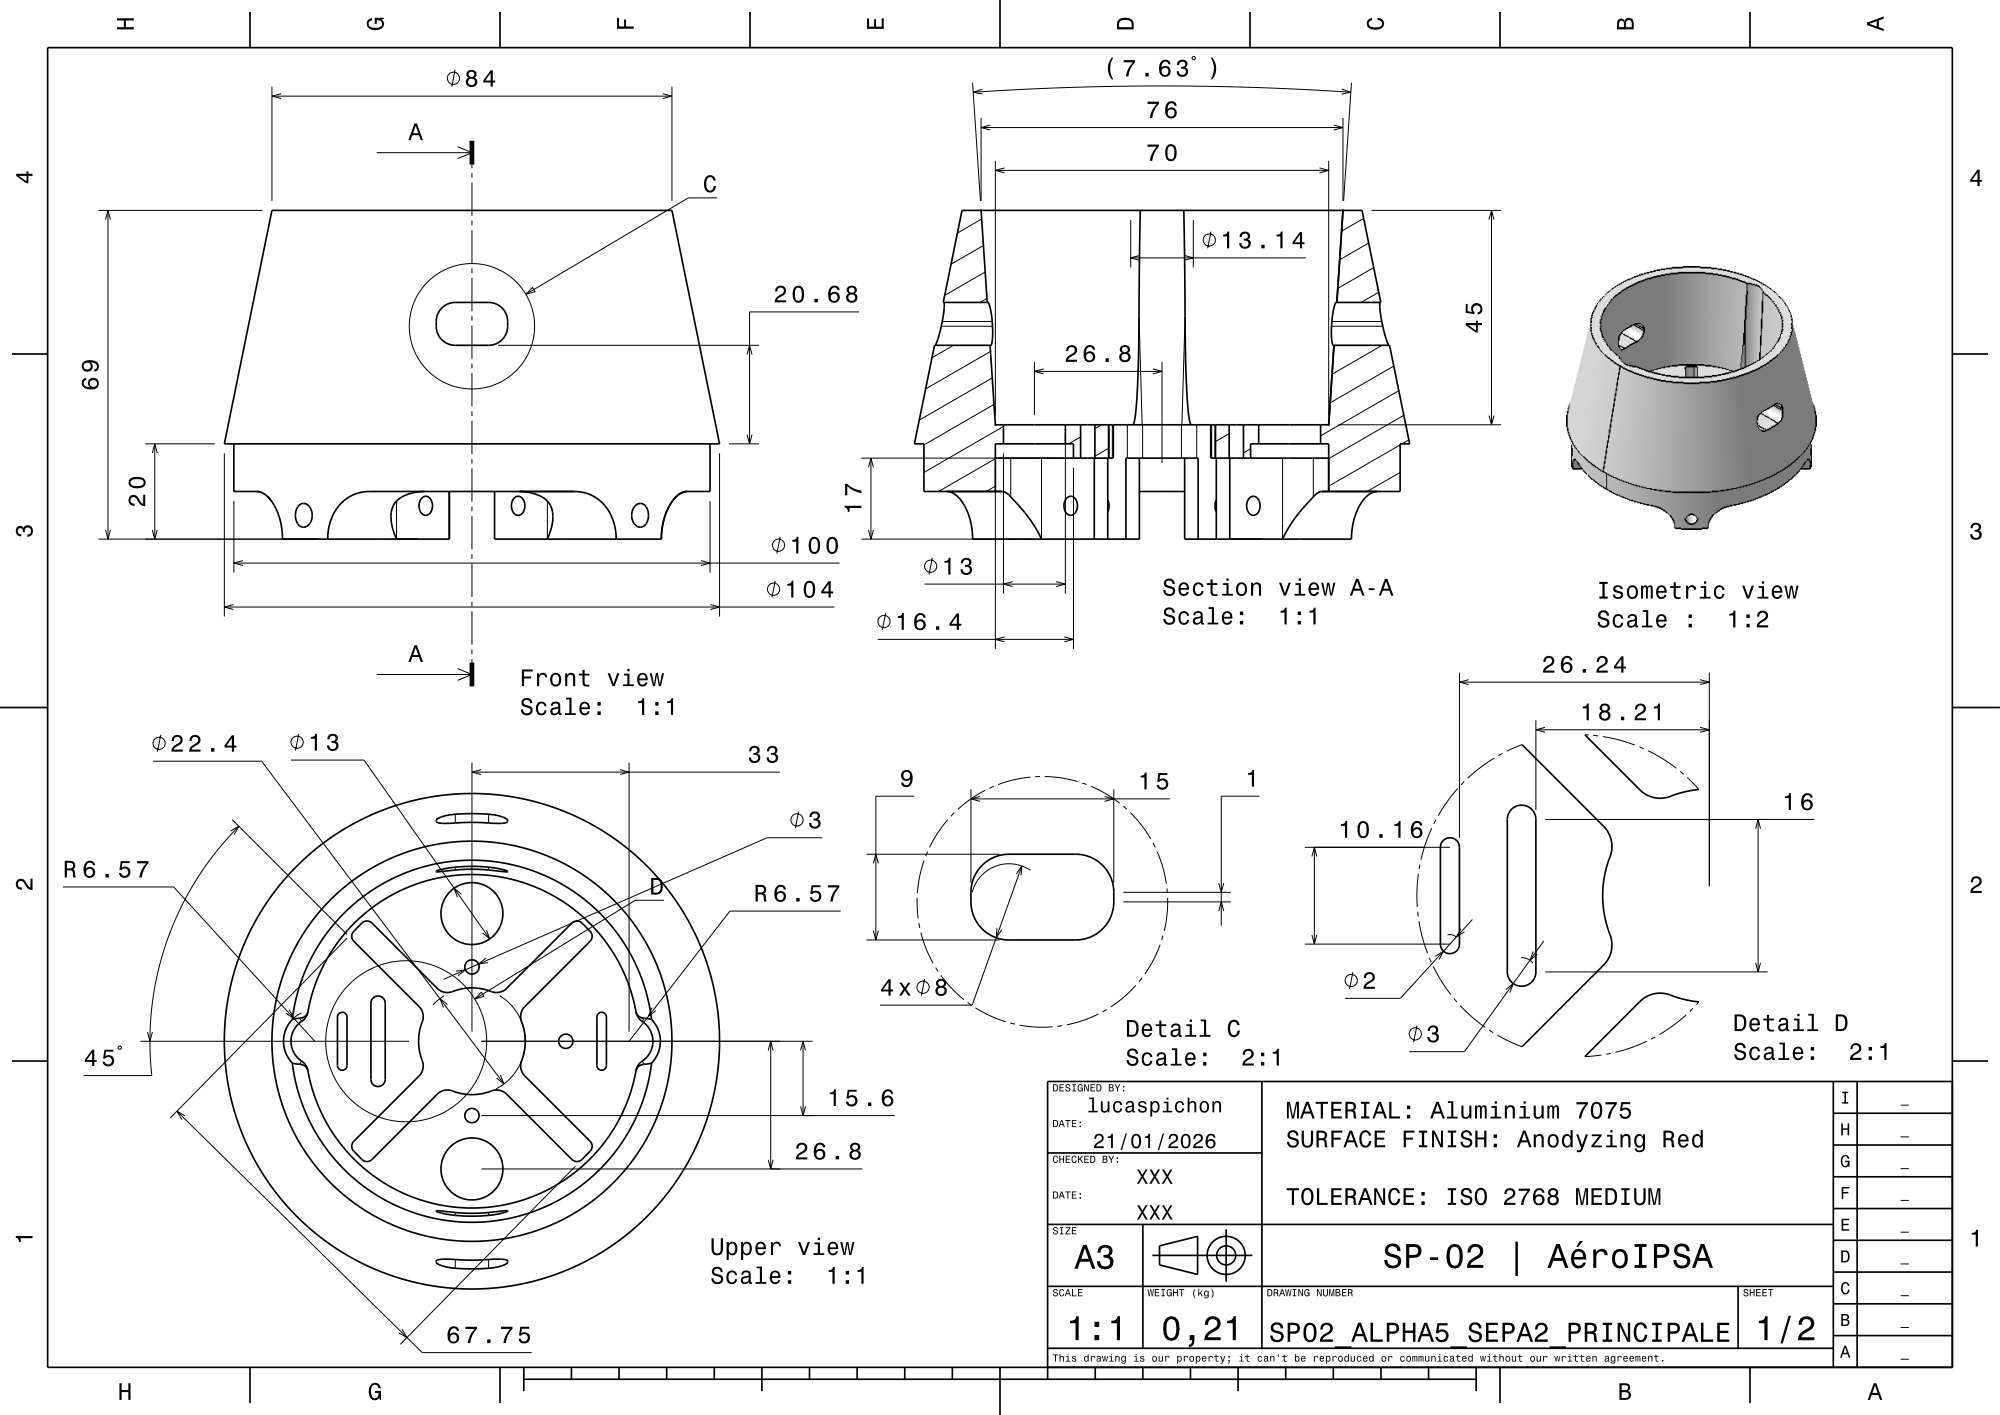
[picture p374: page 1]
