povdoigt/SP-02/CATIA/CATIA_vol/Drawings/Alpha_sepa_principale_Calque_2.pdf

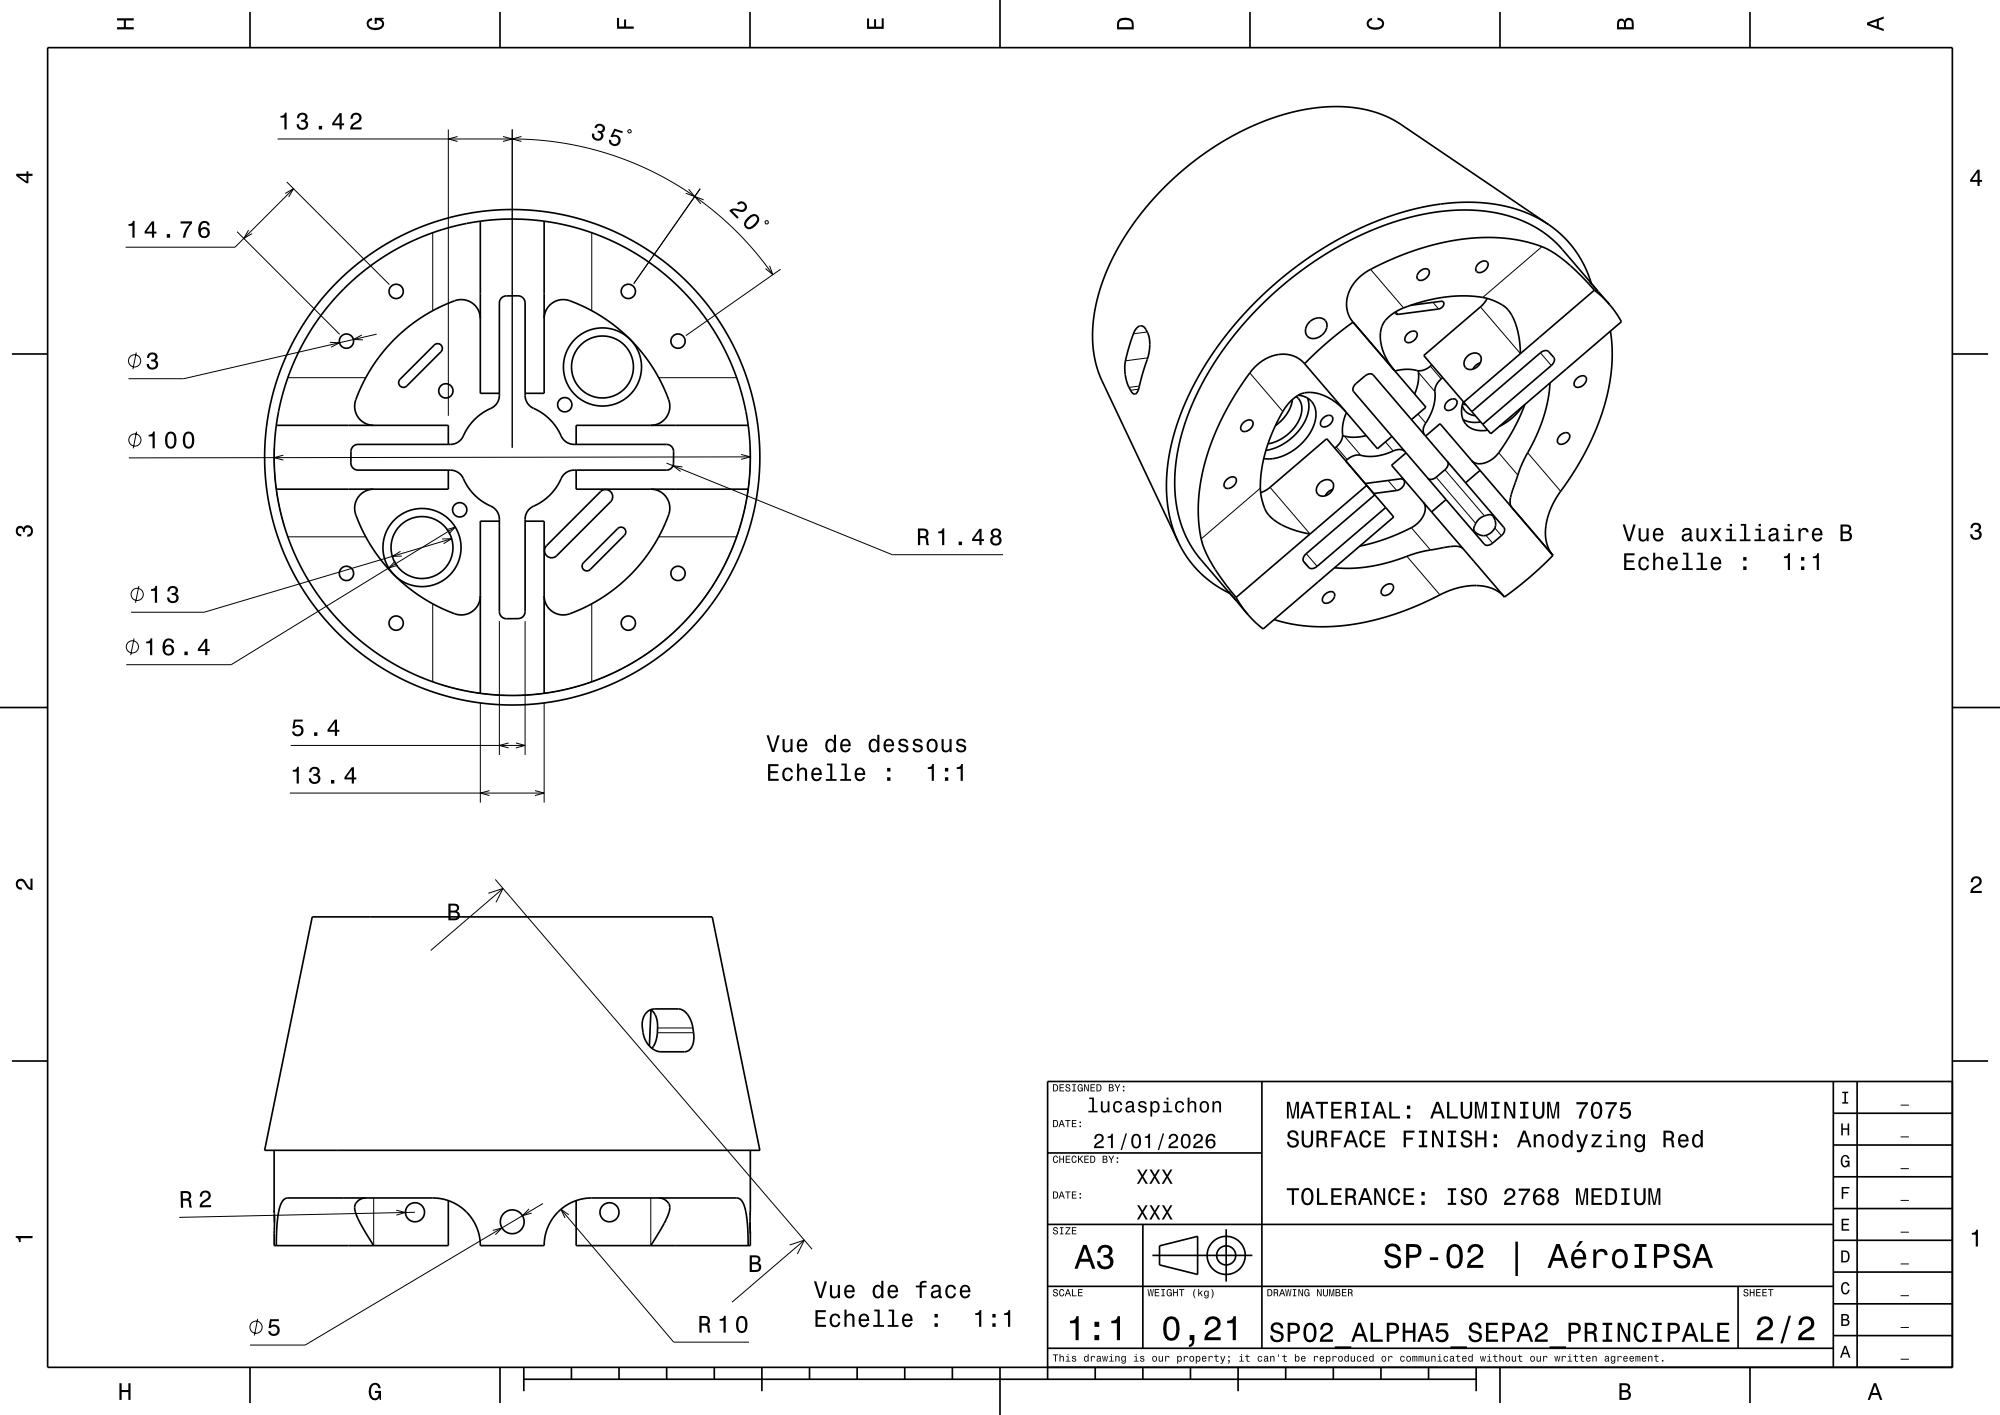
[picture p375: page 1]
