povdoigt/SP-02/CATIA/CATIA_vol/Drawings/Beta_bague_retenue.pdf

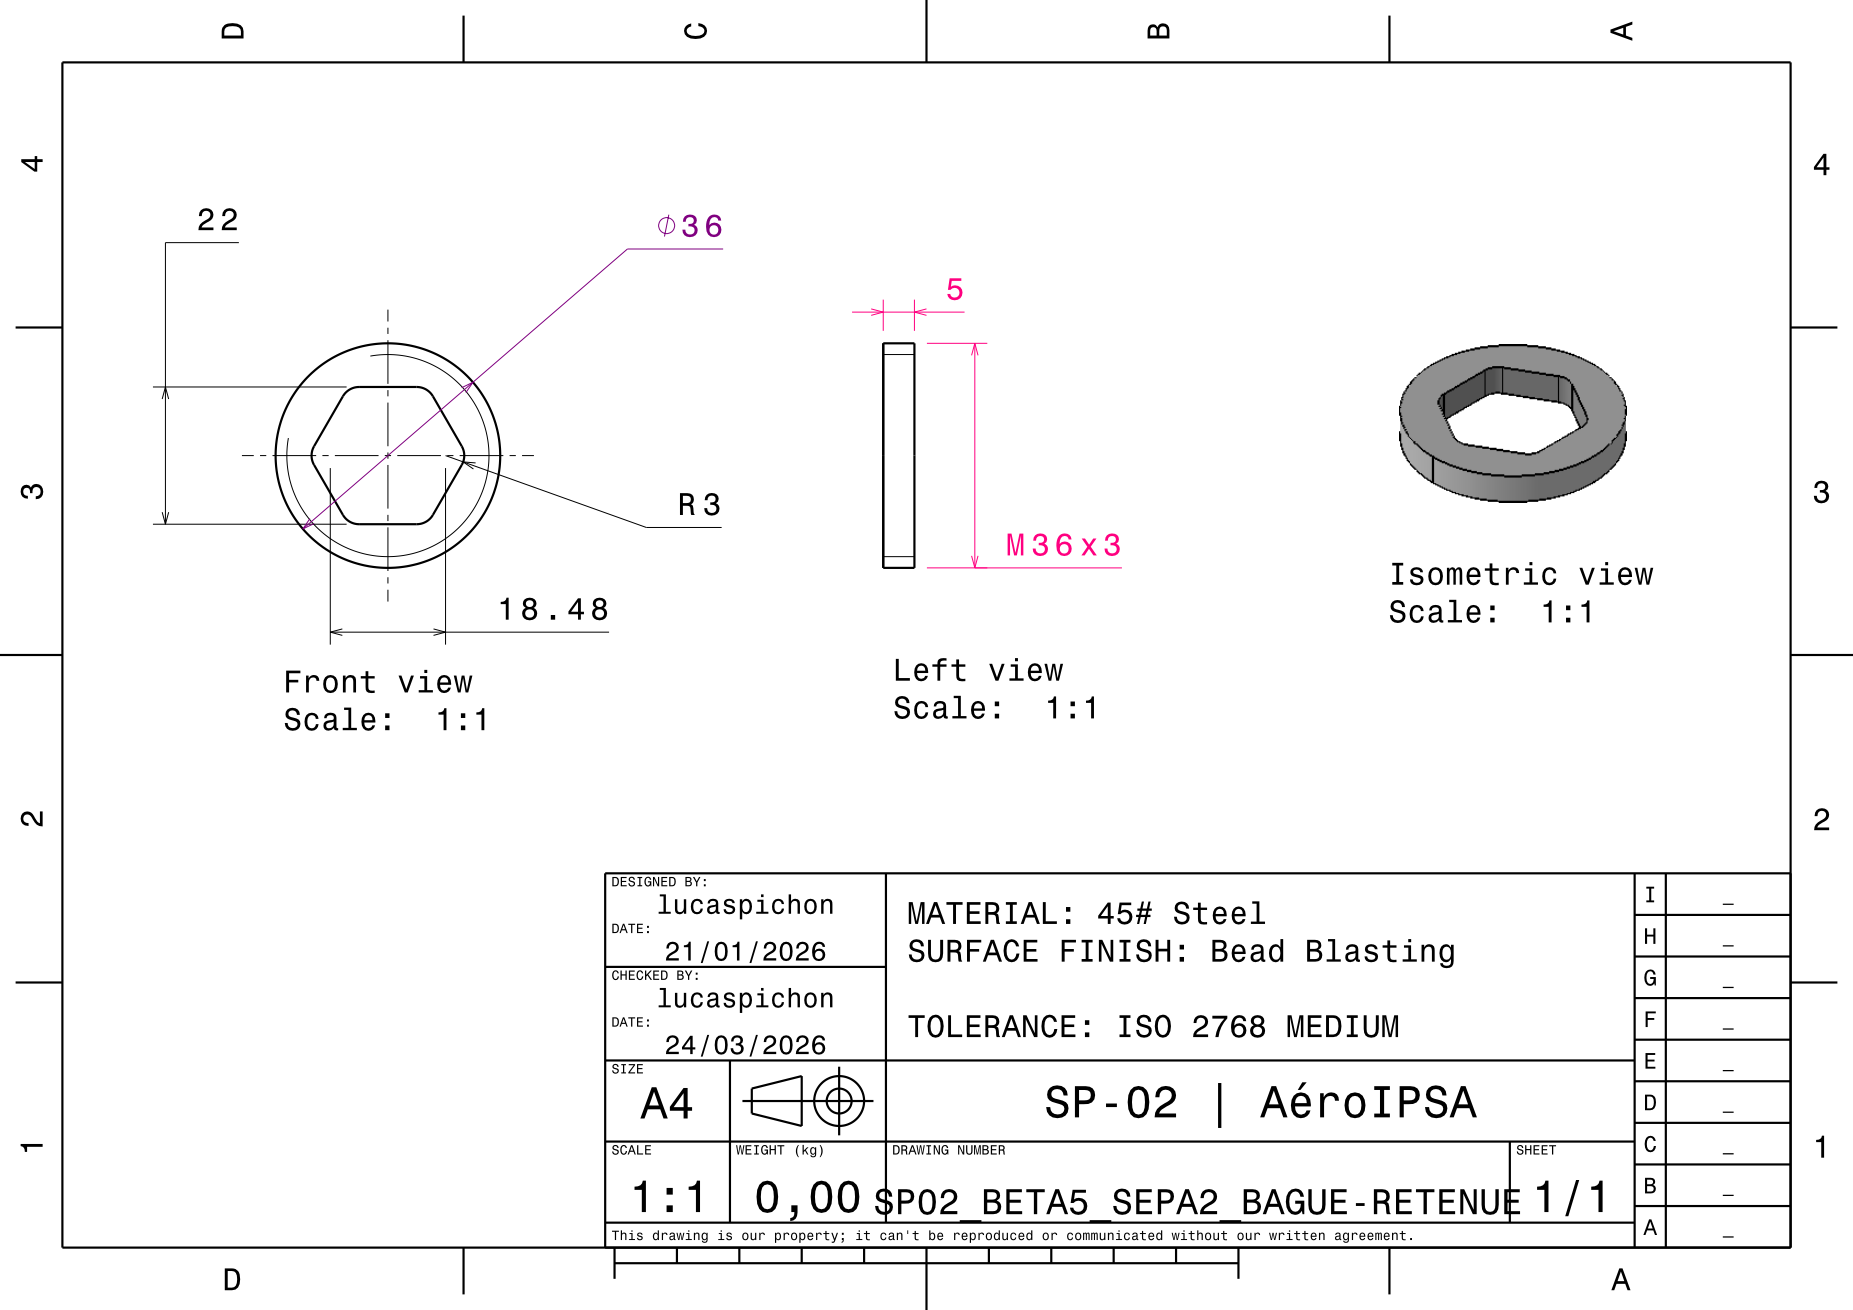
[picture p376: page 1]
