povdoigt/SP-02/CATIA/CATIA_vol/Drawings/Patron_Moule_Cage_Para1.pdf

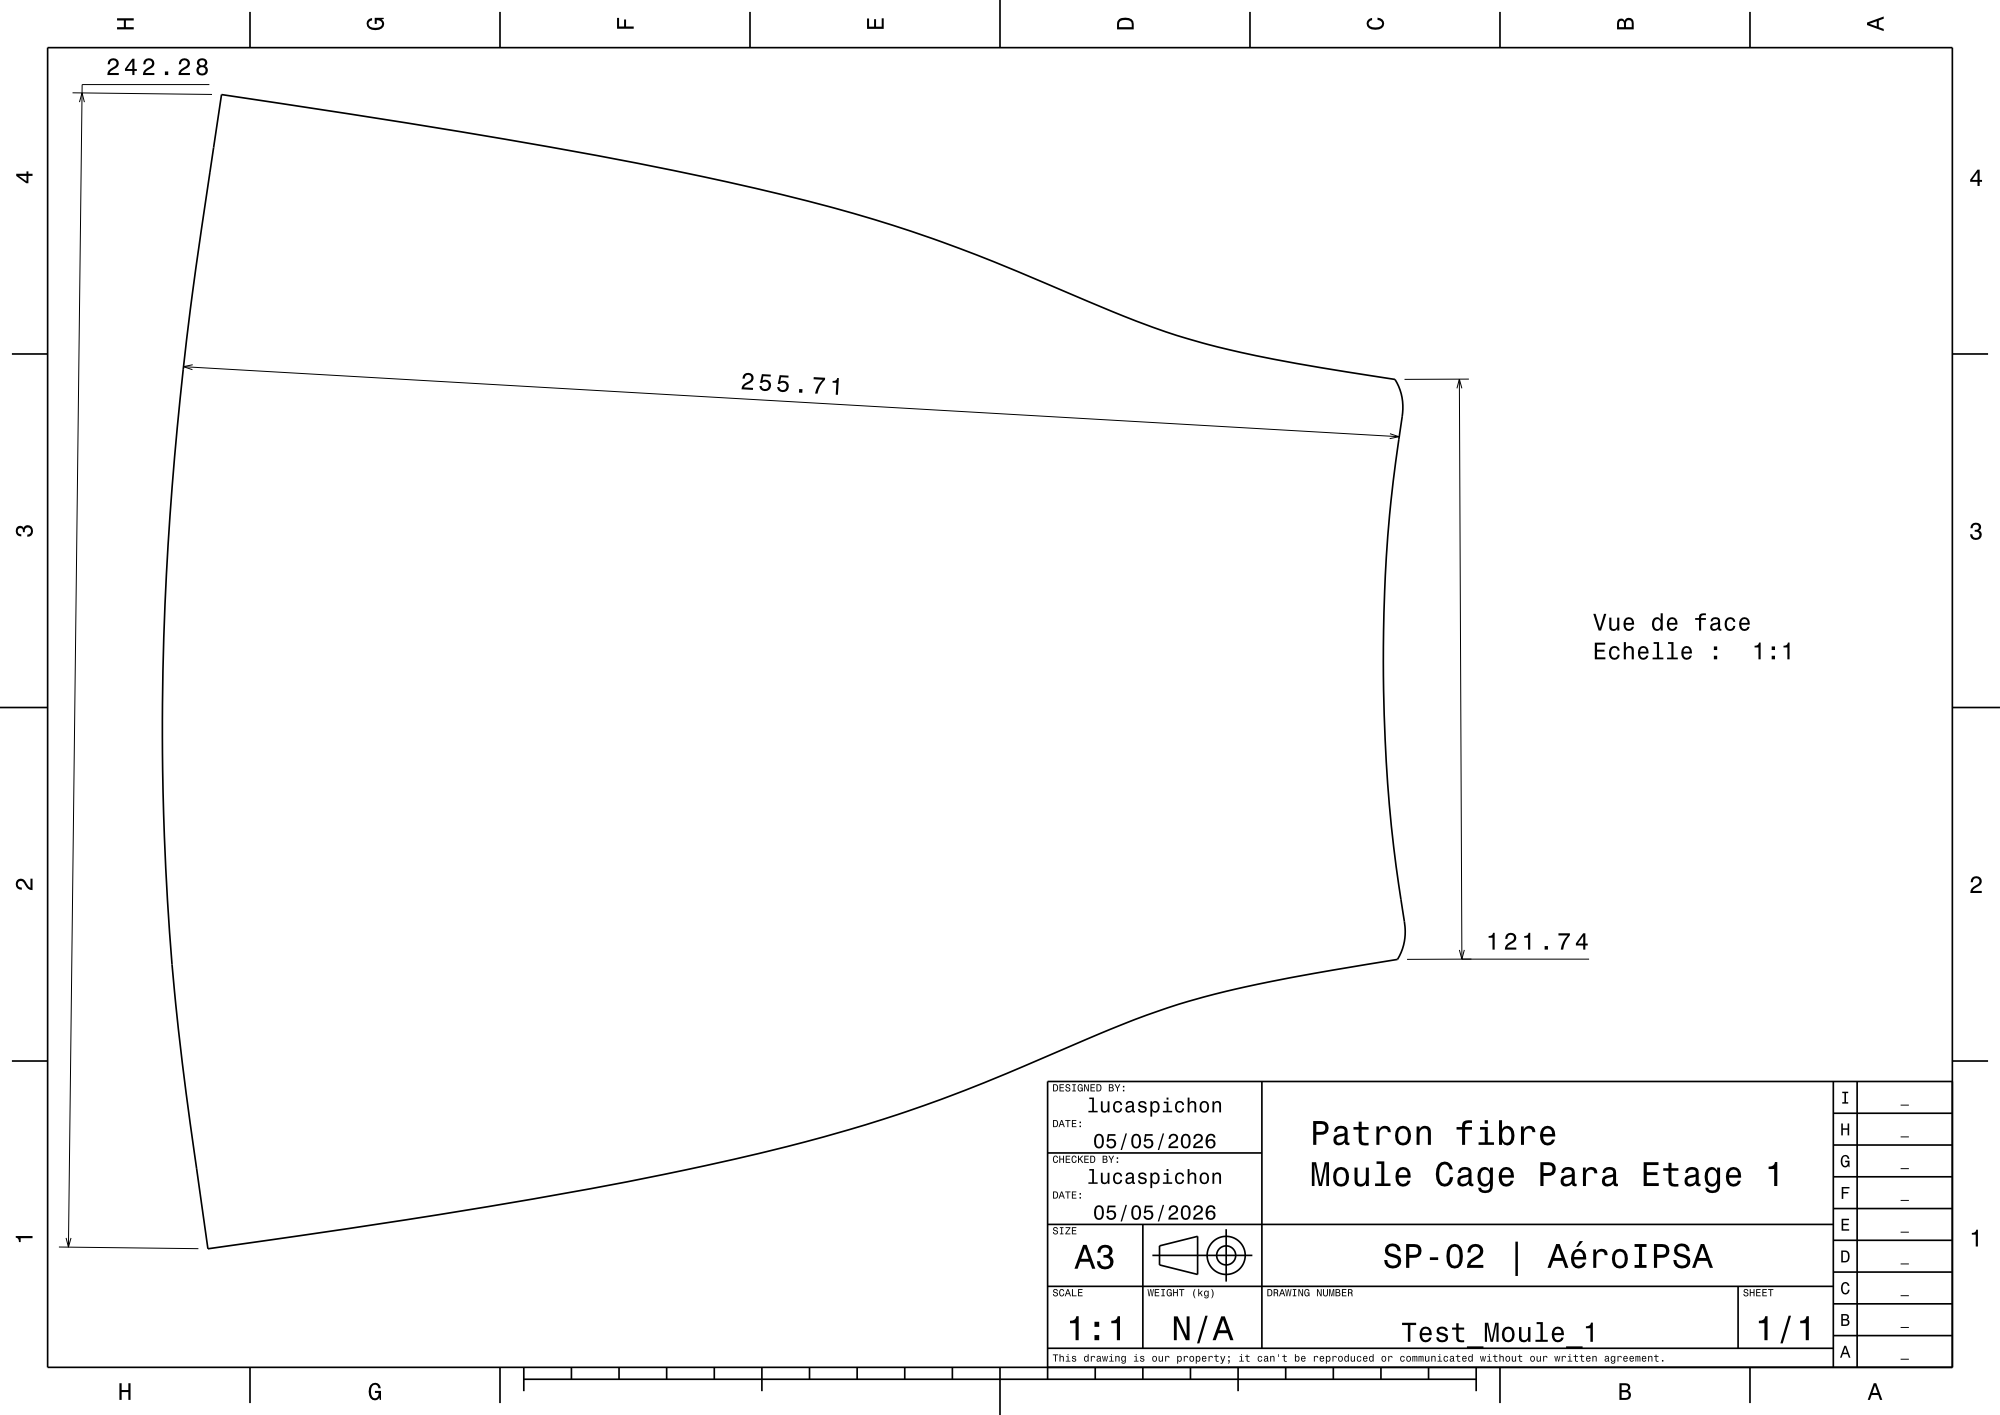
[picture p377: page 1]
