povdoigt/SP-02/CATIA/CATIA_vol/Drawings/Patron_Moule_Coiffe.pdf

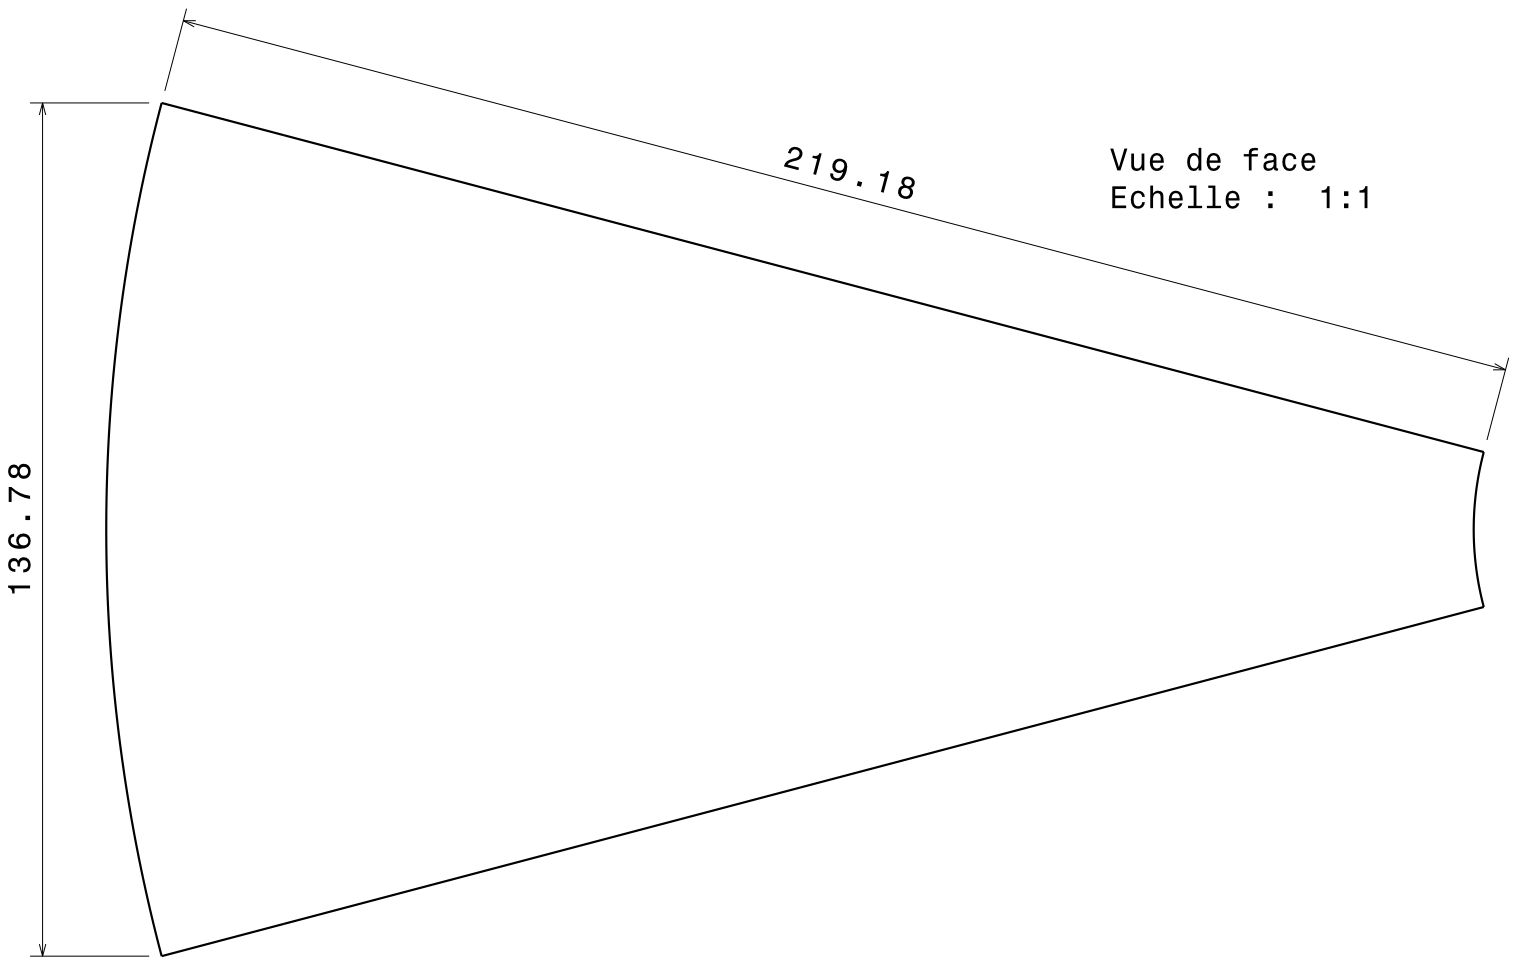
[picture p378: page 1]
