povdoigt/SP-02/CATIA/CATIA_vol/Drawings/SP-02_ALPHA5_SEPA2_Principale.pdf

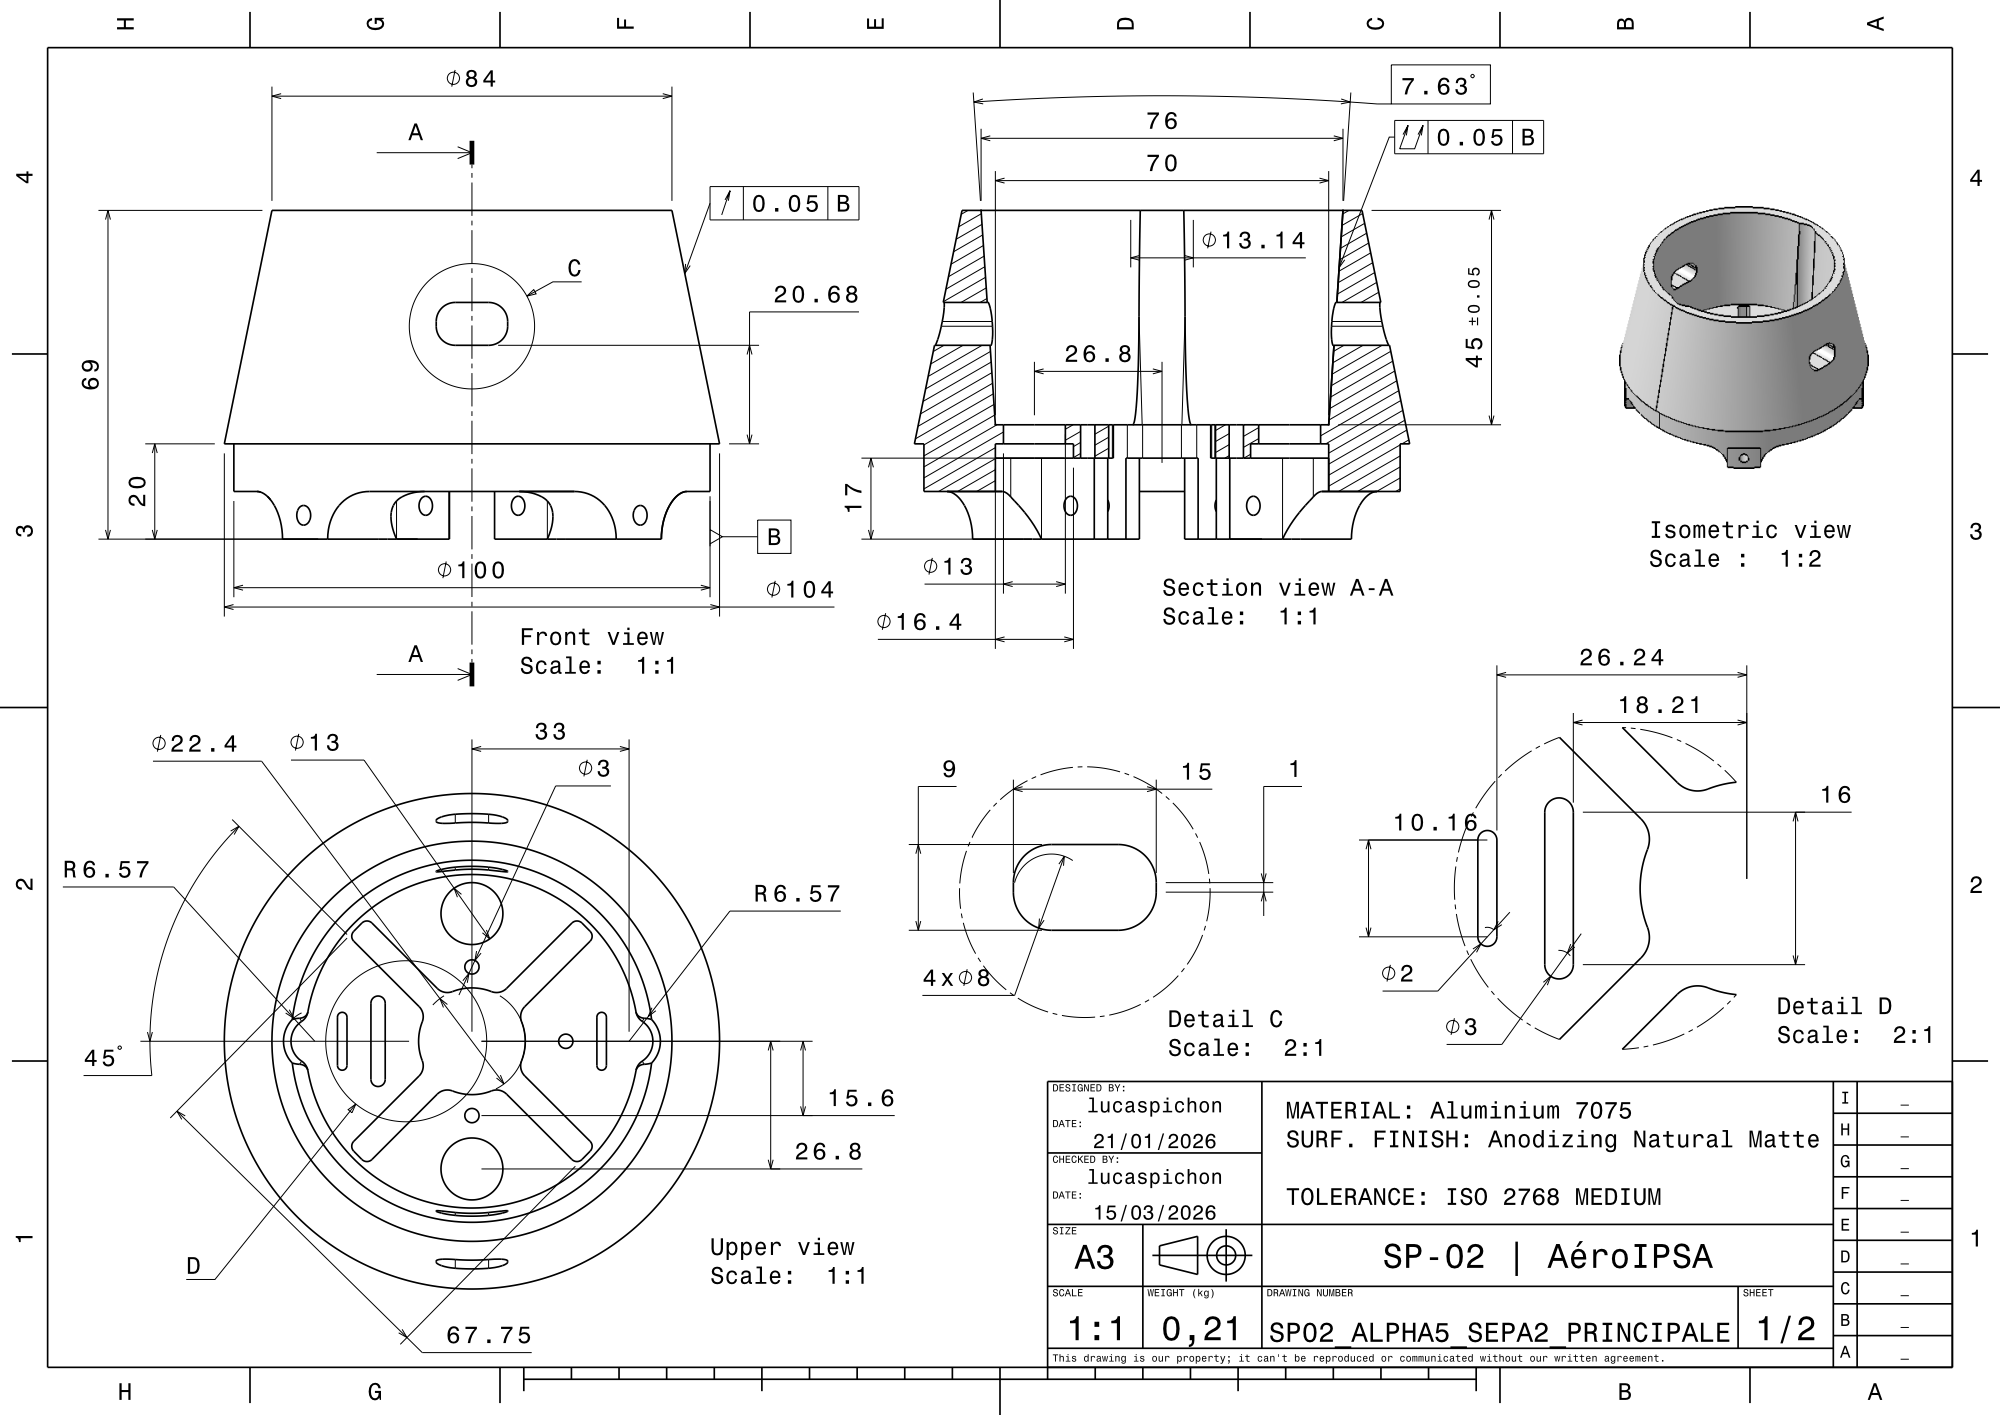
[picture p379: page 1]

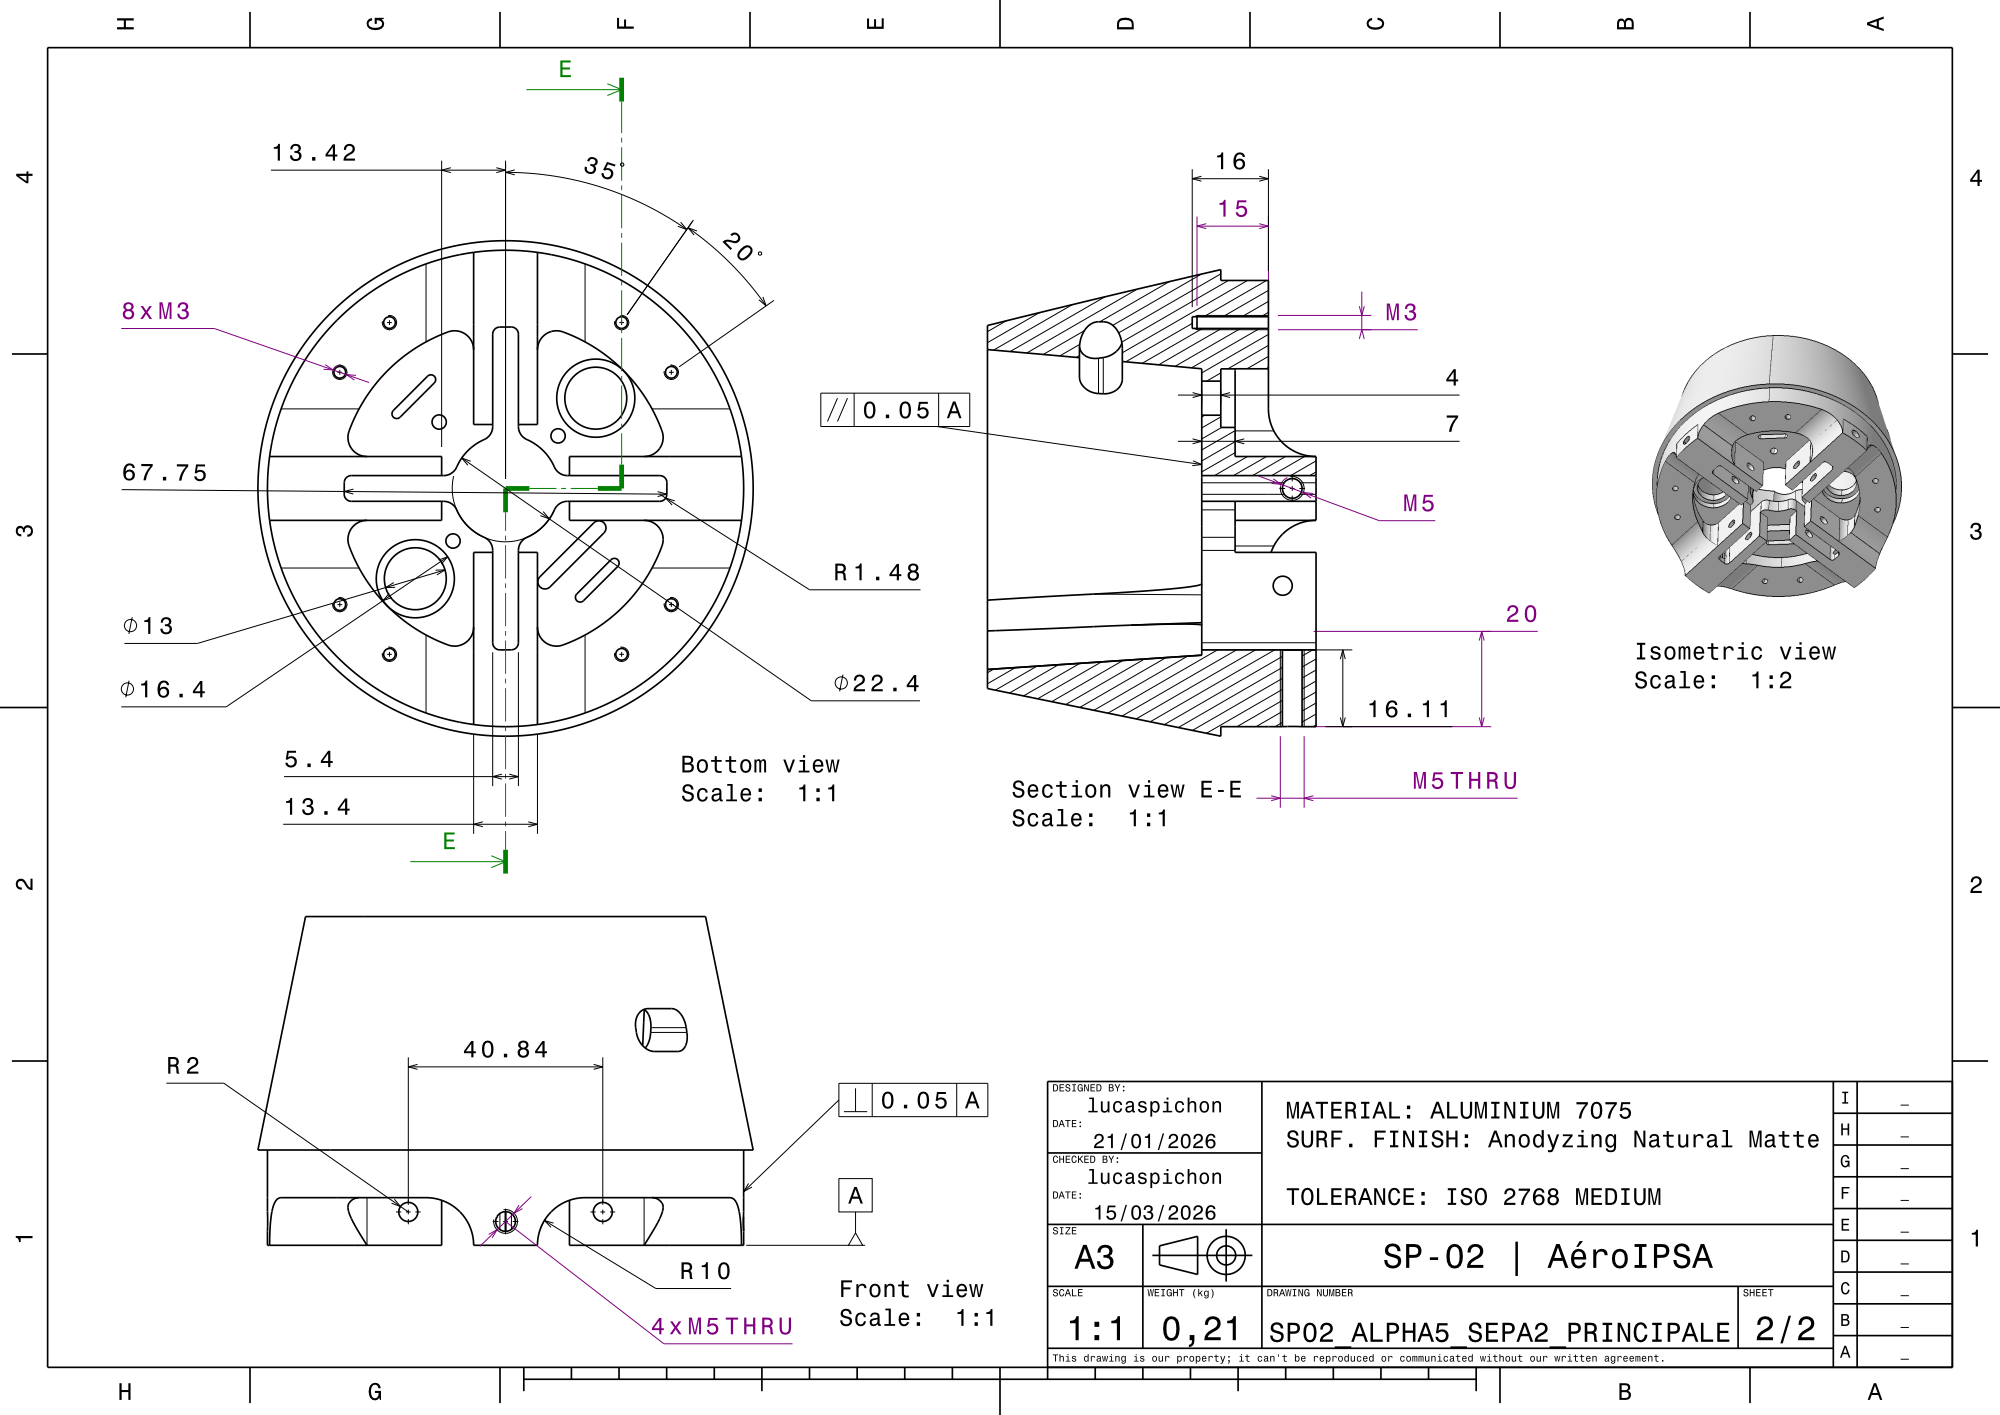
[picture p380: page 2]
