povdoigt/SP-02/CATIA/CATIA_vol/Usinage/Drawing coupleur.pdf

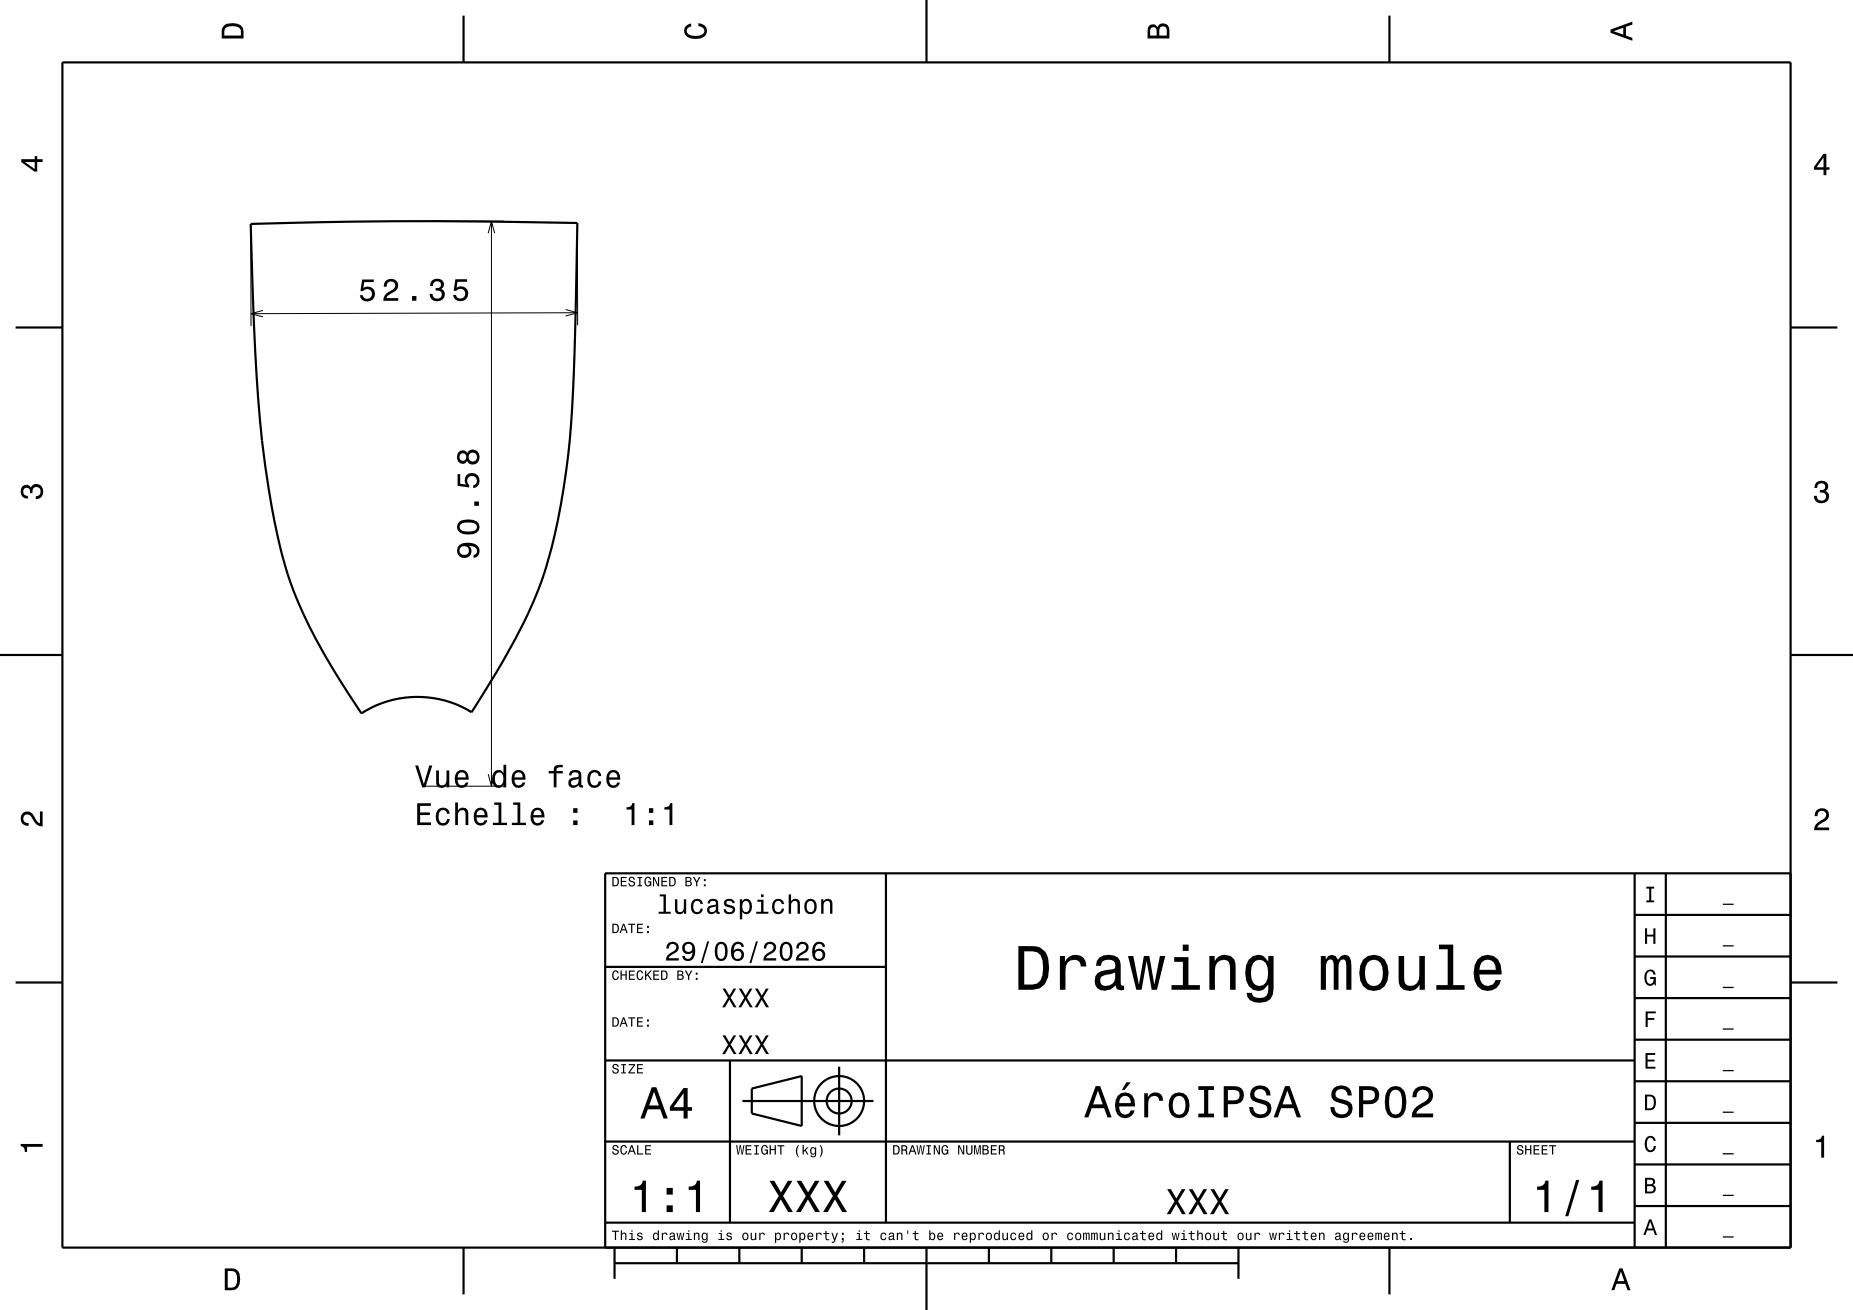
[picture p381: page 1]
