povdoigt/SP-02/CATIA/CATIA_vol/Drawings/Beta_crochet_trappe.pdf

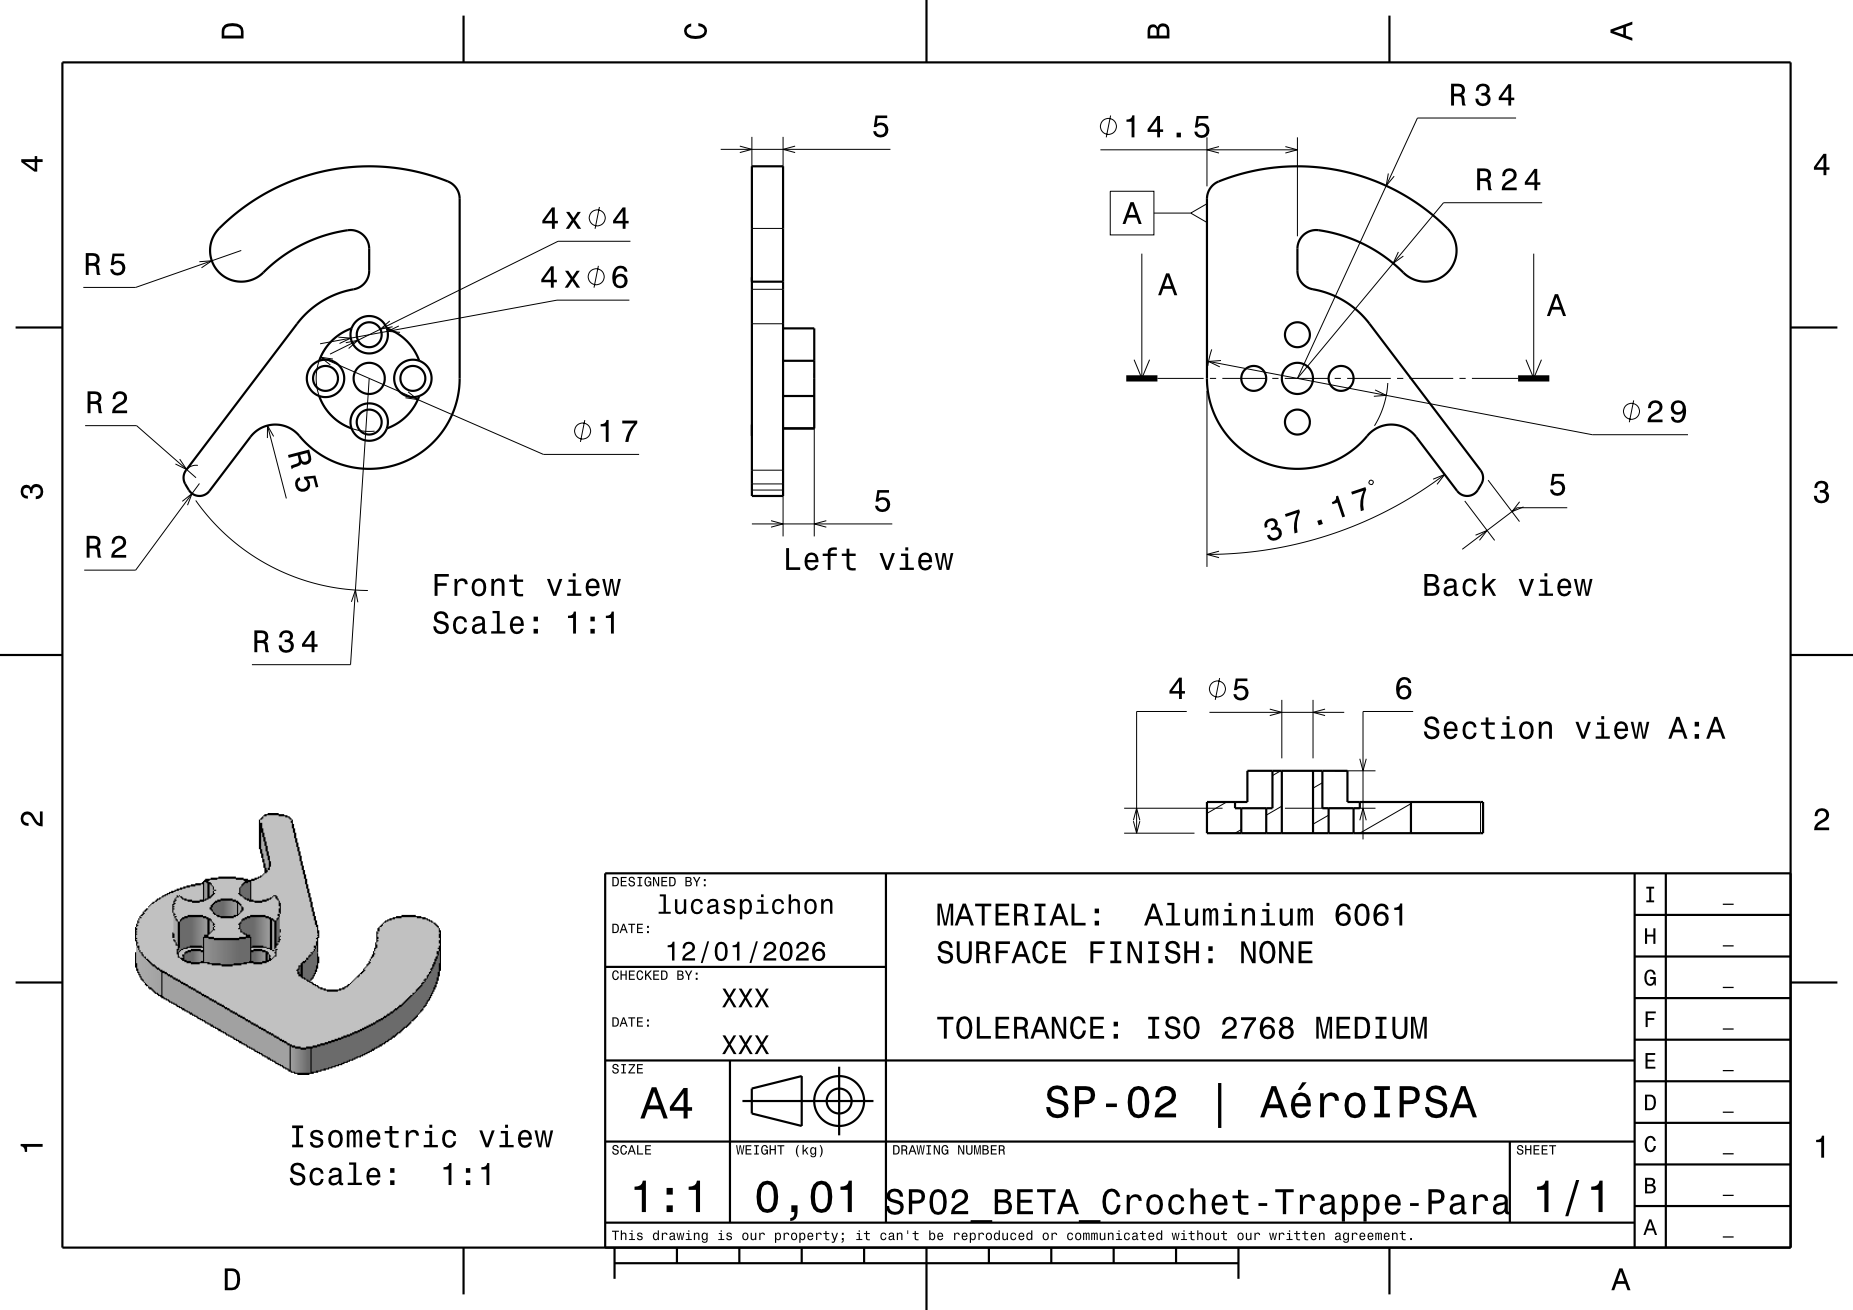
[picture p382: page 1]
