povdoigt/SP-02/CATIA/CATIA_vol/Drawings/Beta_pointe_coiffe.pdf

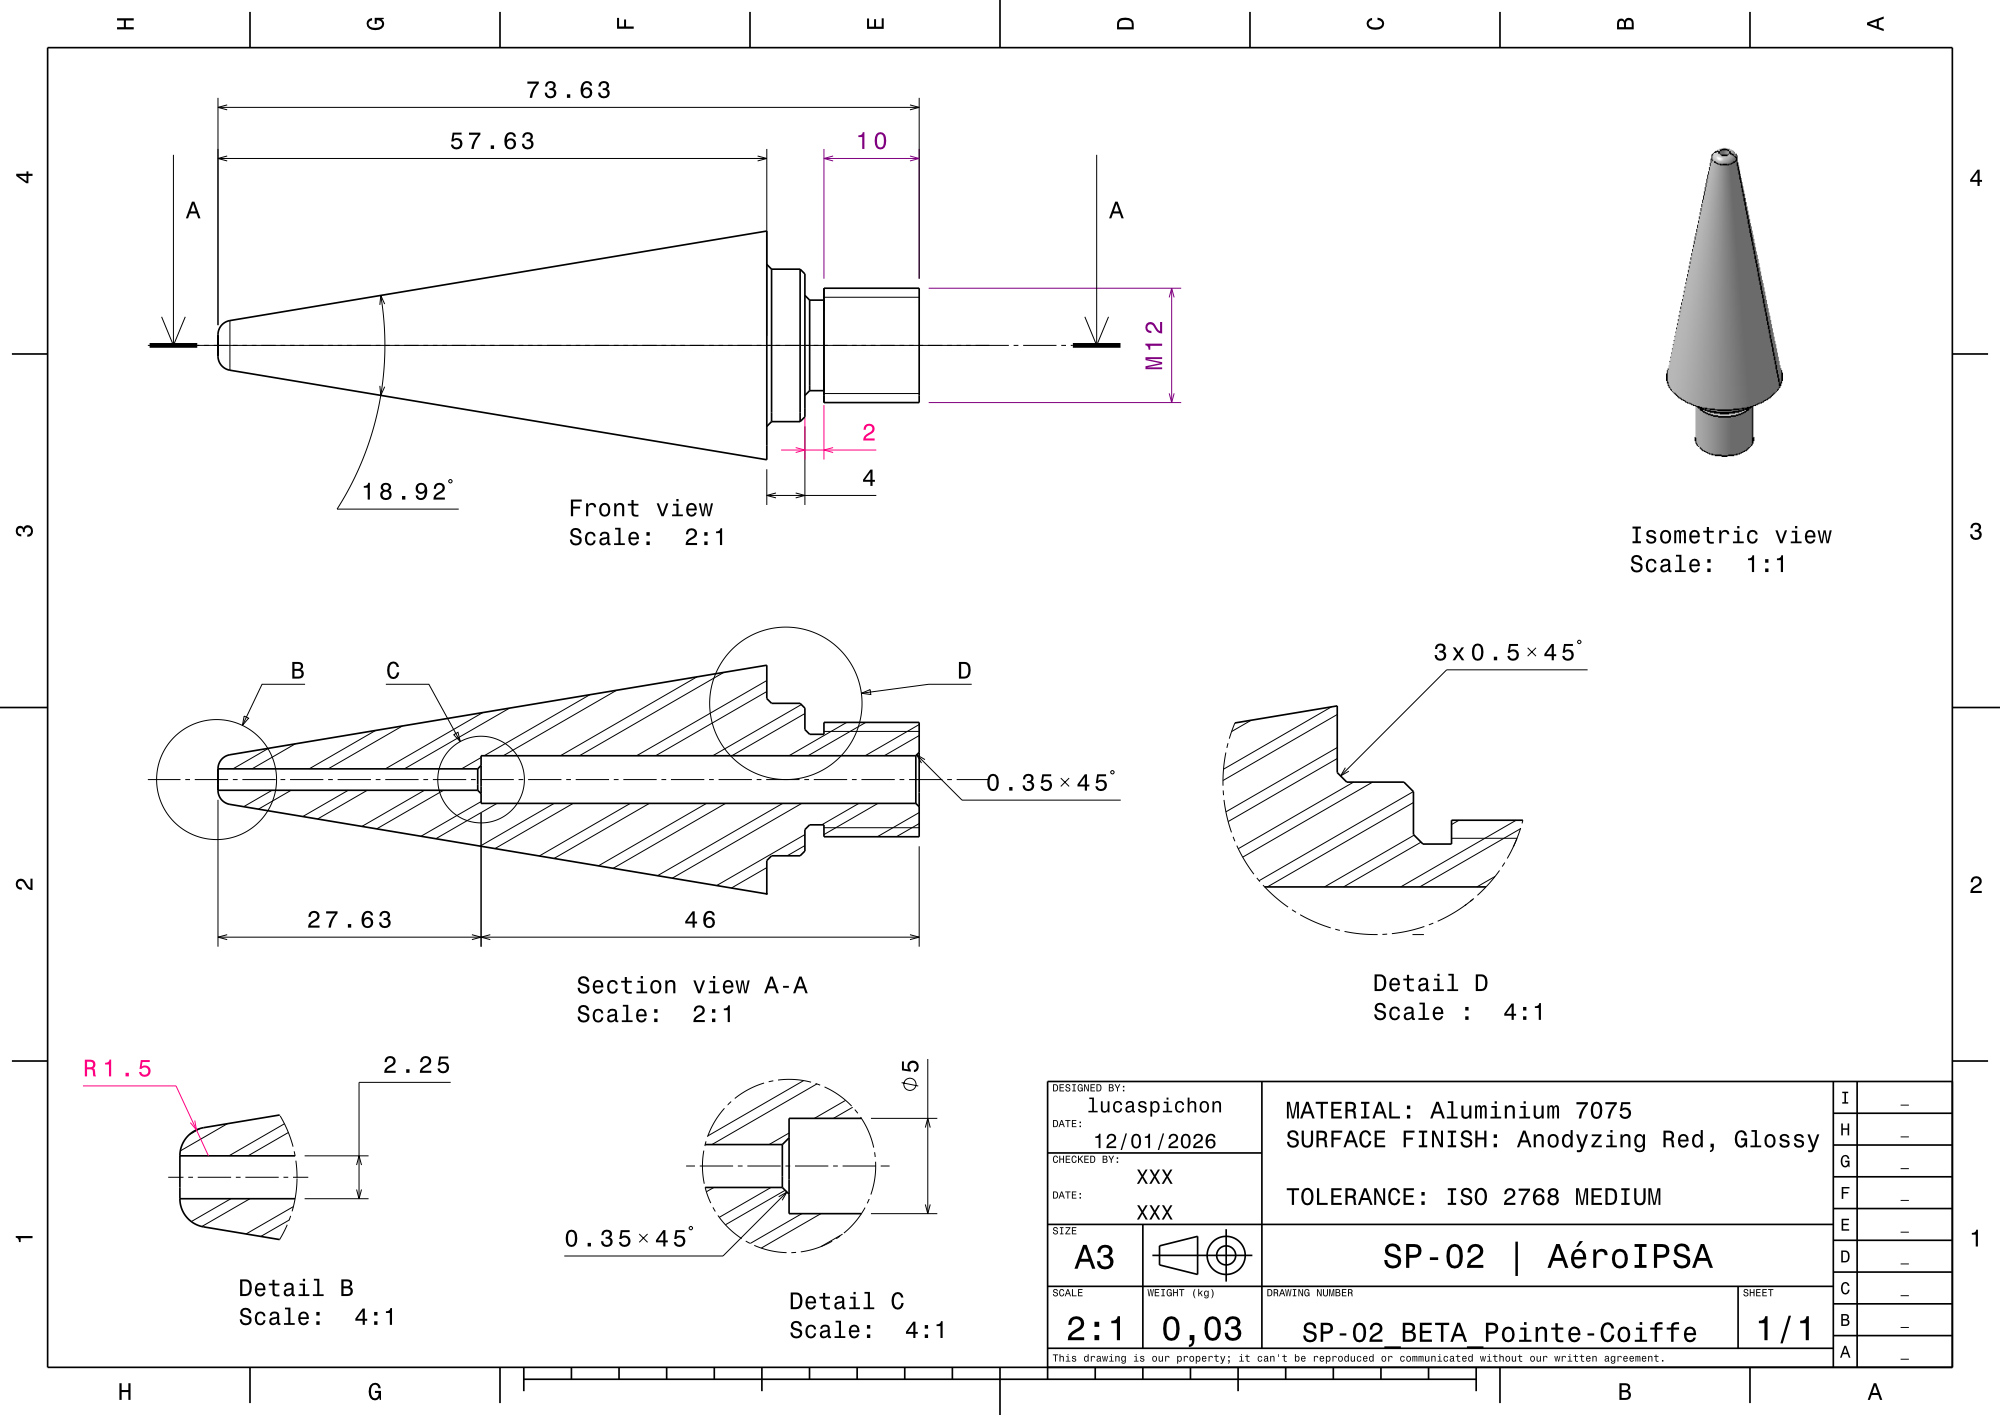
[picture p383: page 1]
