povdoigt/SP-02/CATIA/CATIA_vol/Drawings/Beta_sepa_plaque_retenue.pdf

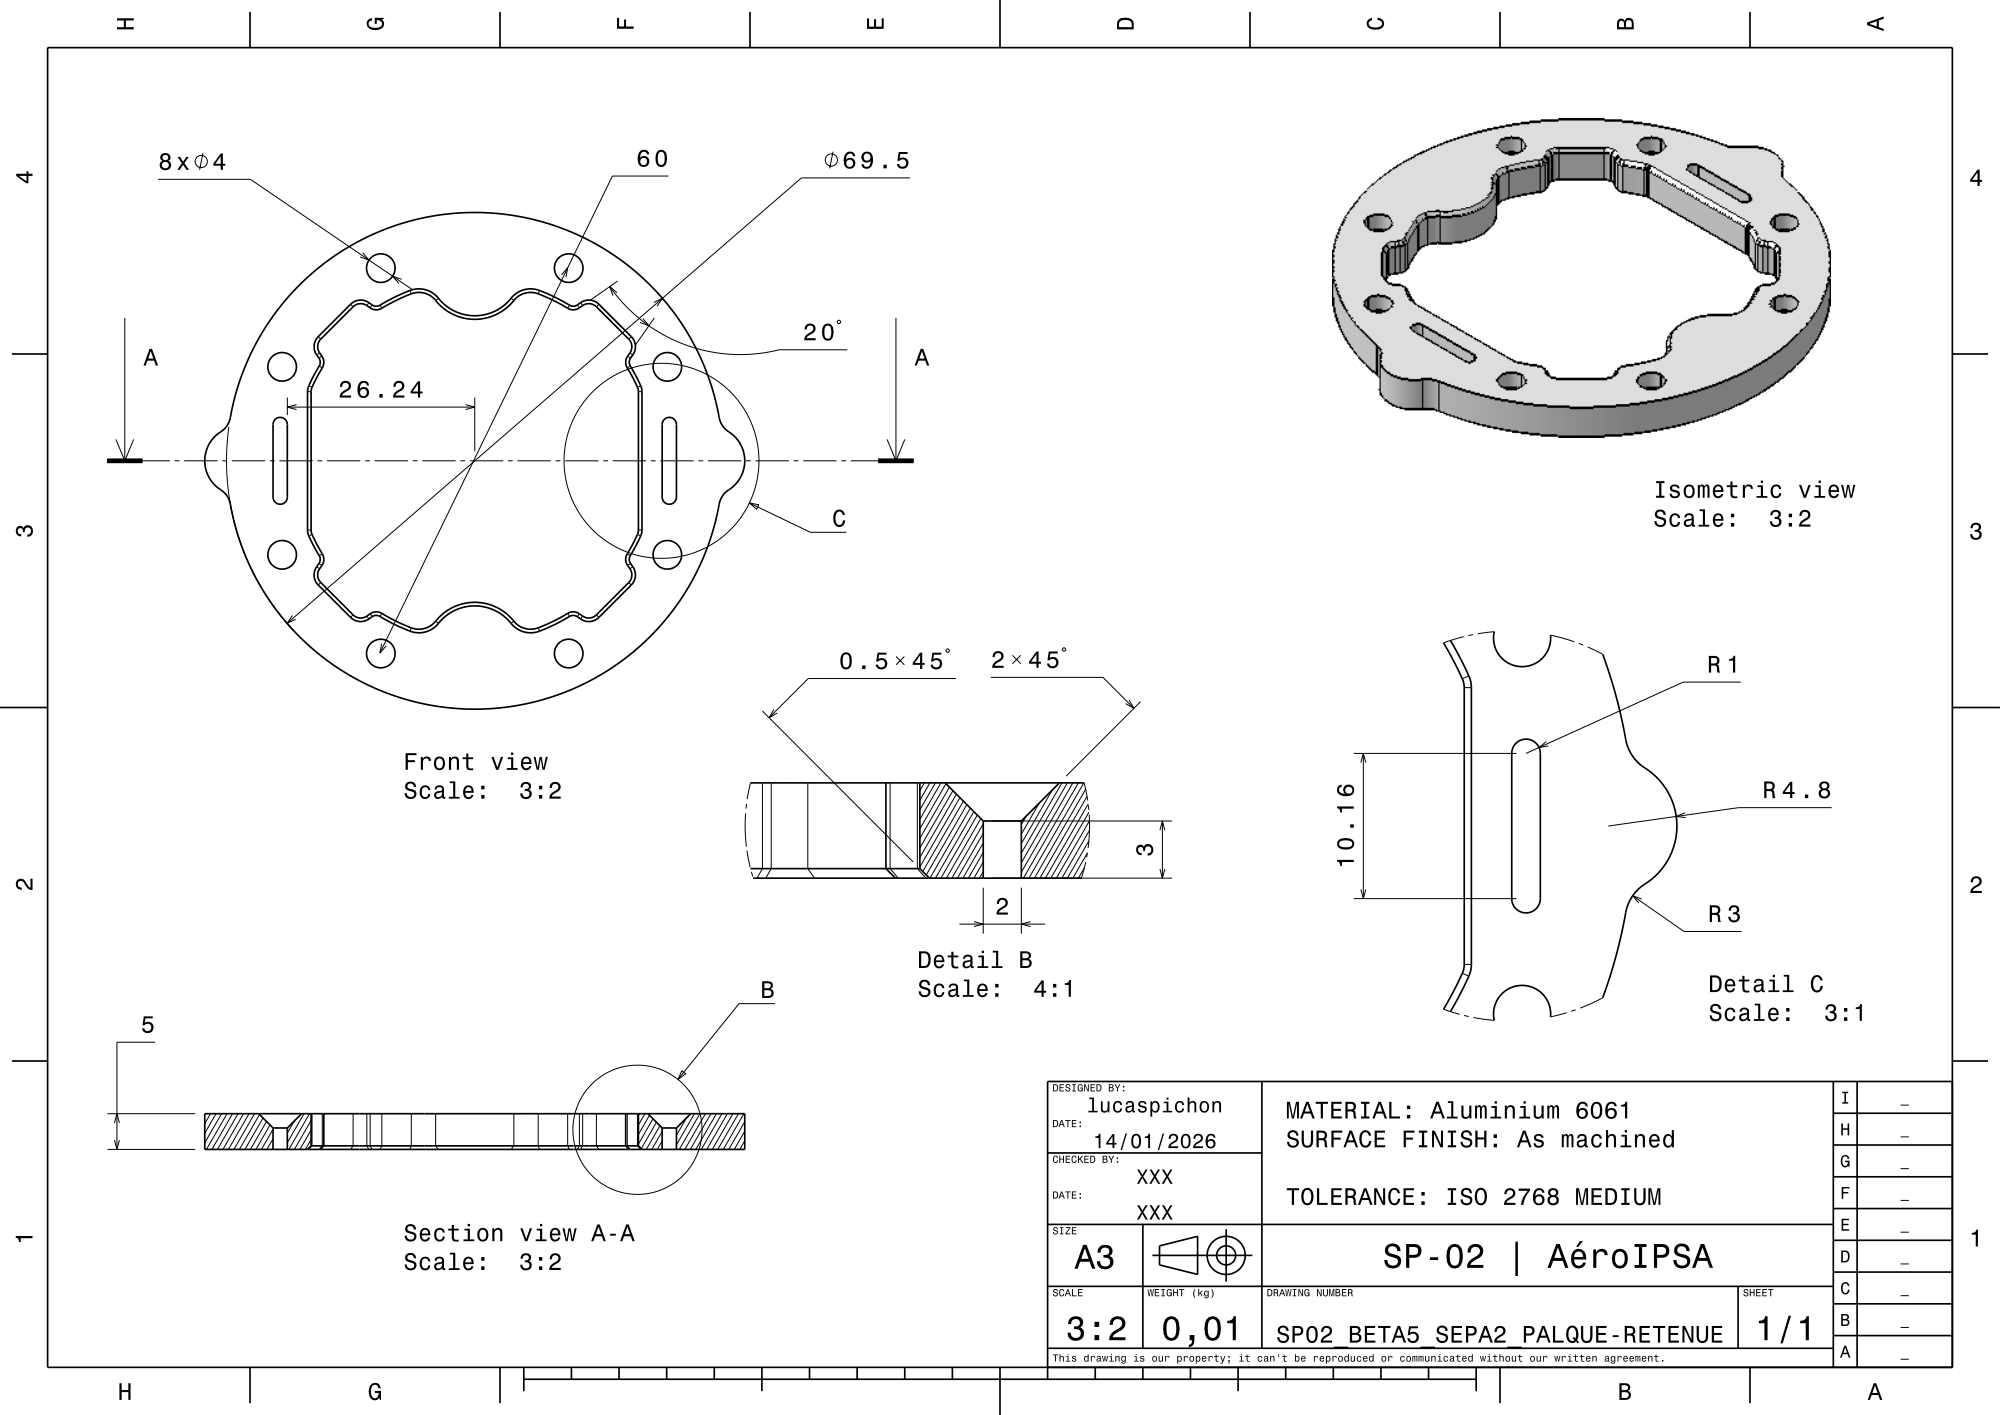
[picture p384: page 1]
