povdoigt/SP-02/CATIA/CATIA_vol/Drawings/Beta_sepa_principale_Calque_1.pdf

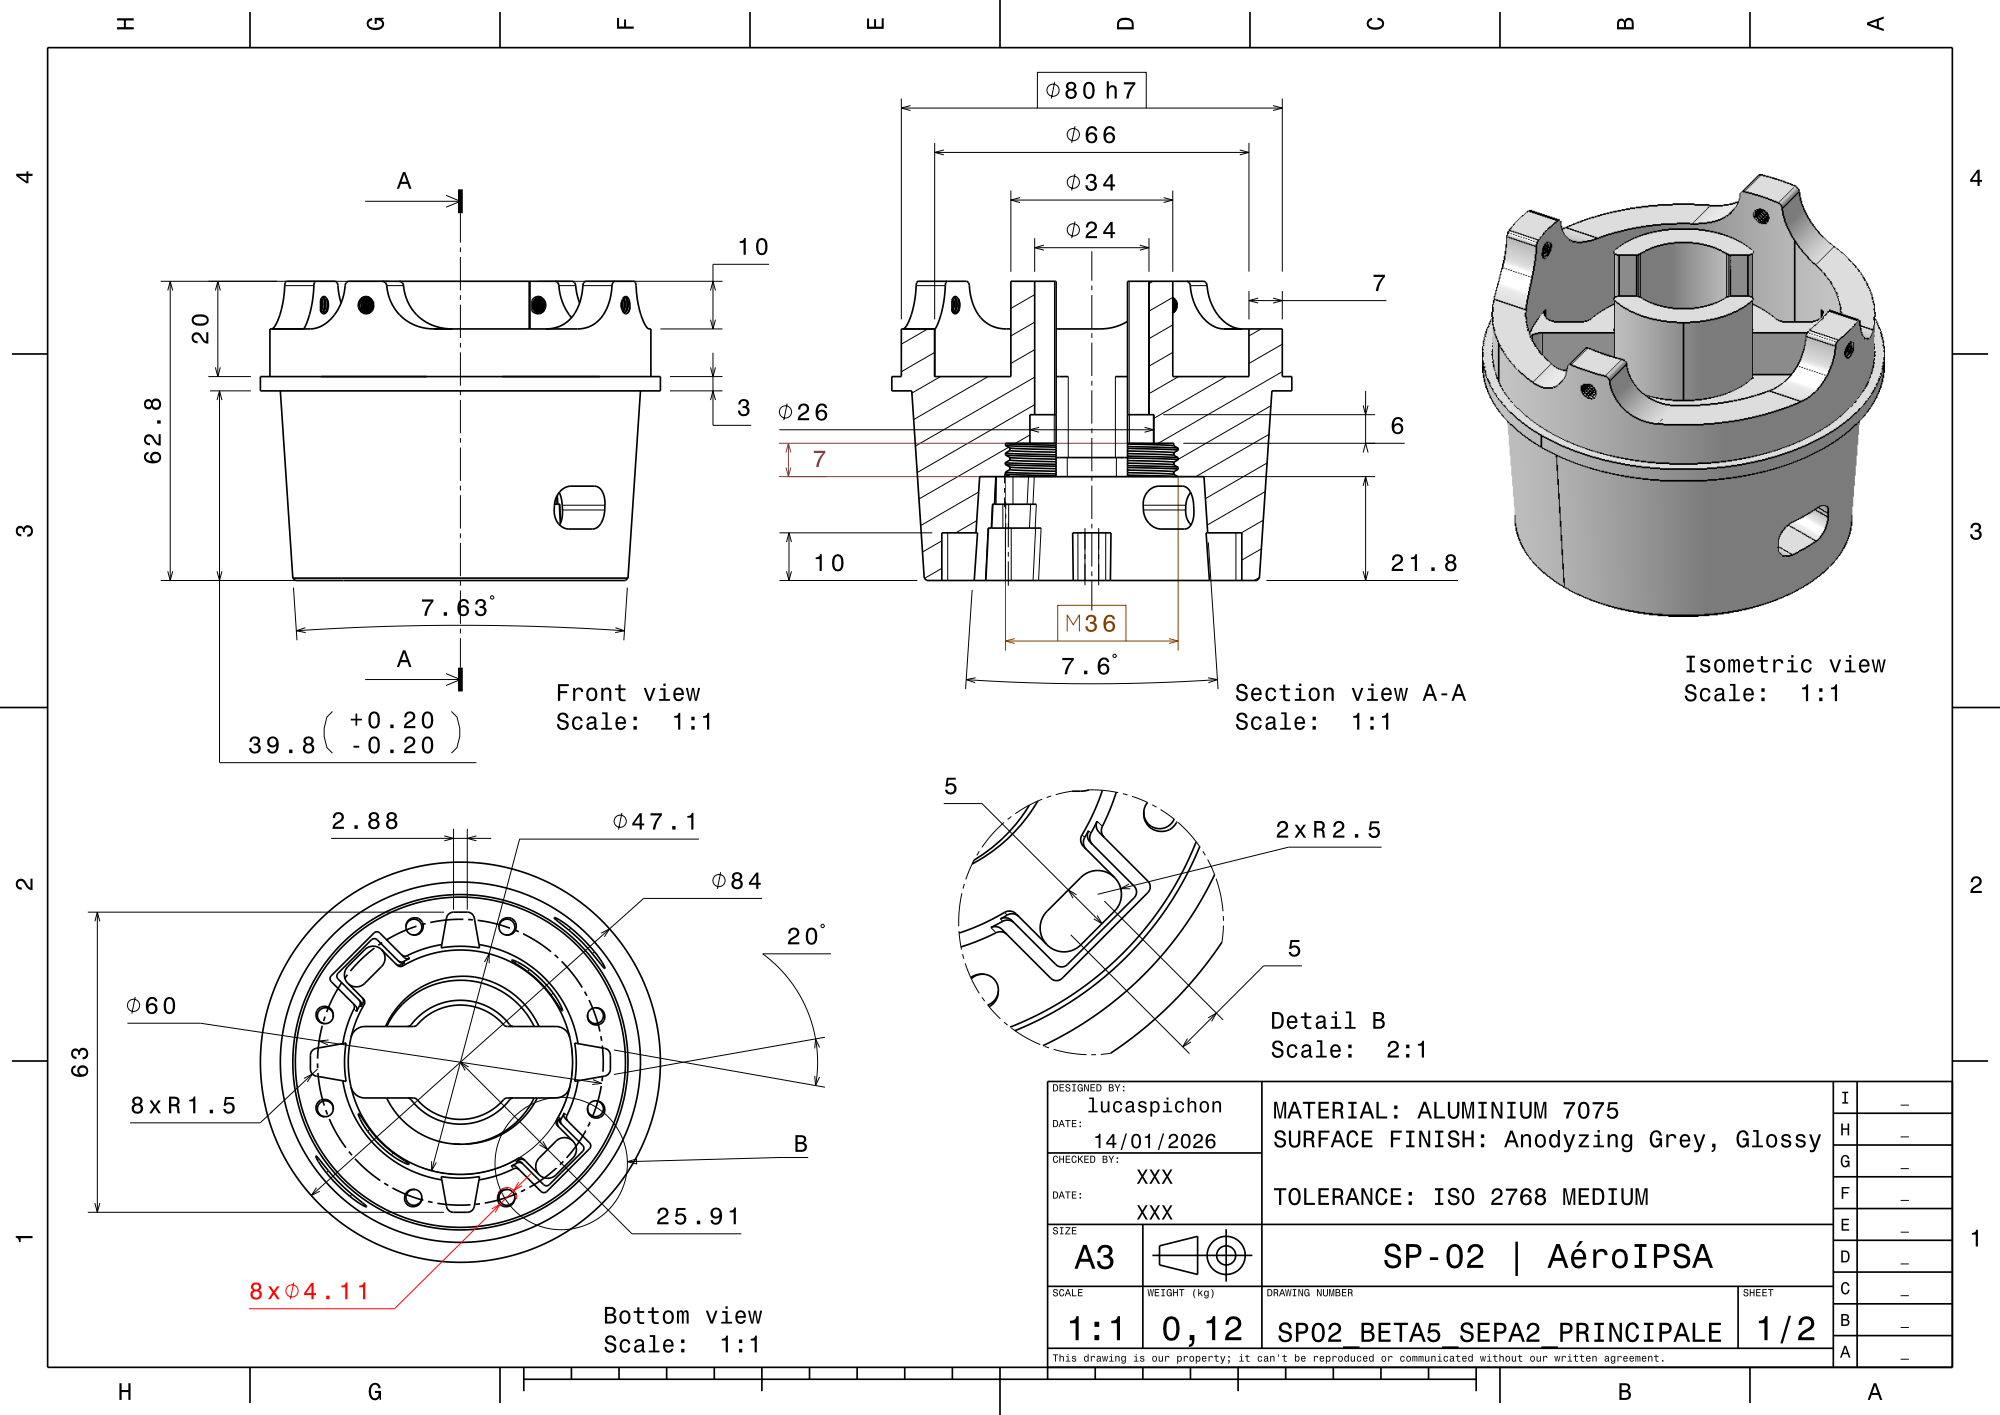
[picture p385: page 1]

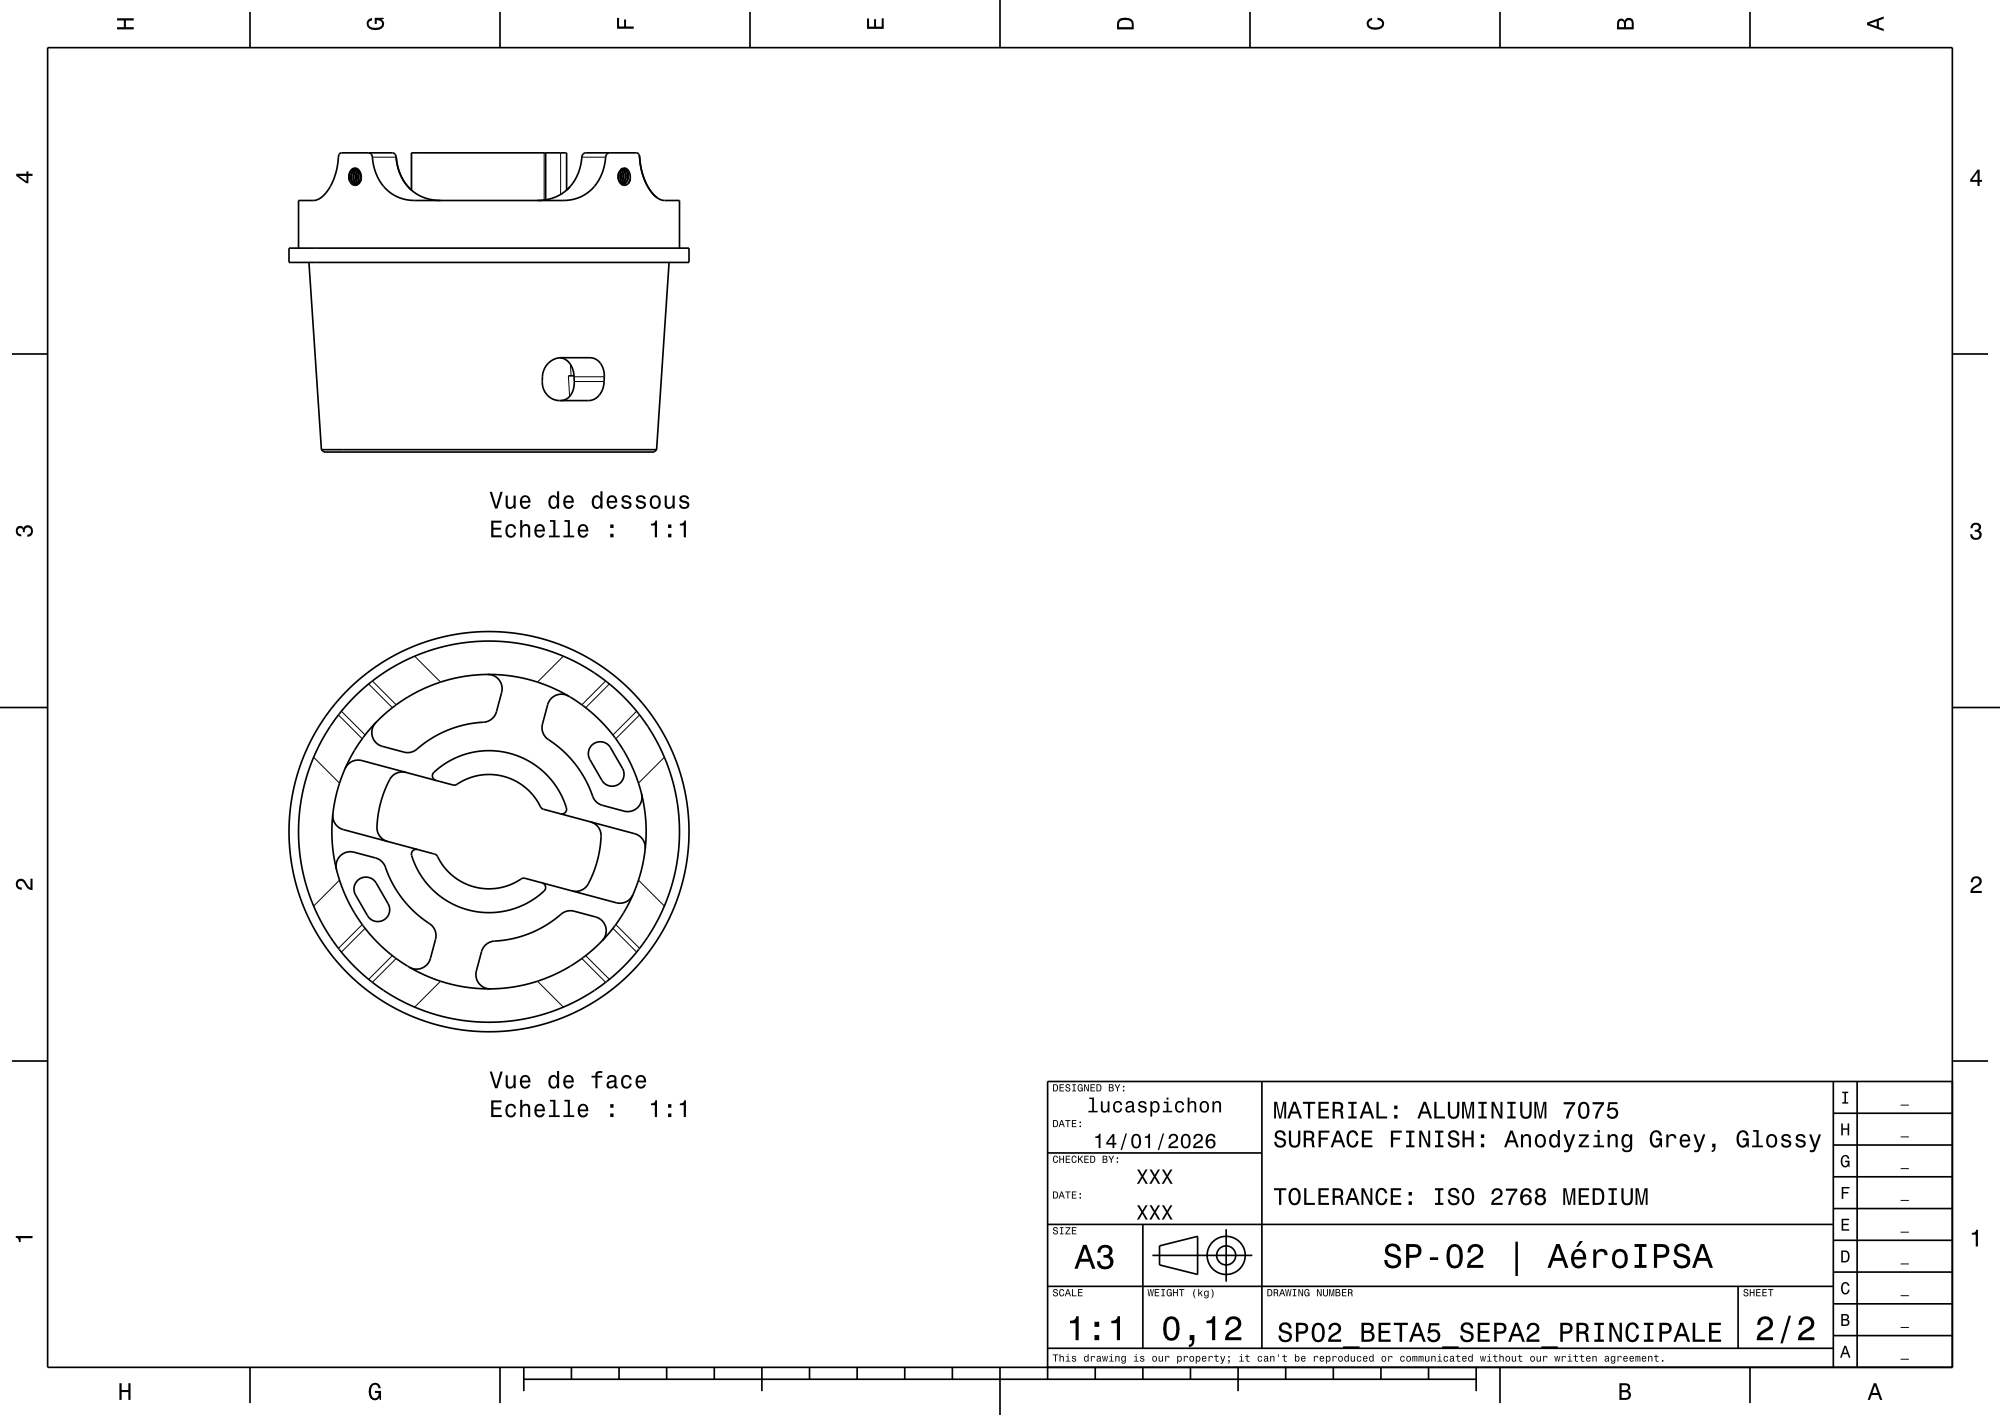
[picture p386: page 2]
