povdoigt/SP-02/PMI/repport/figures/Schema_AF.pdf

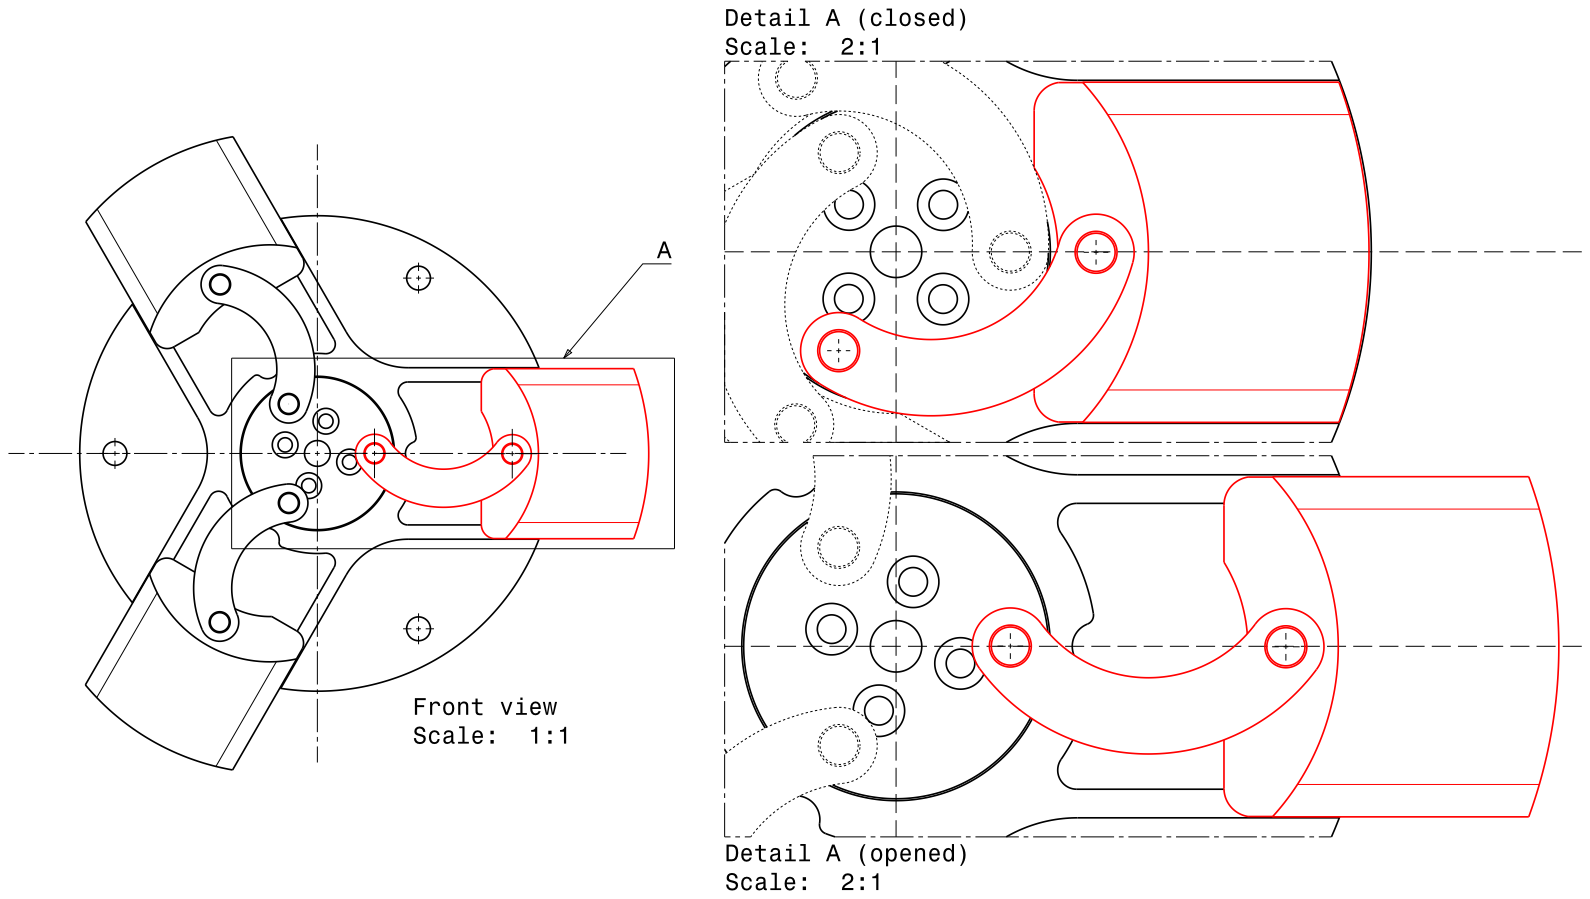
[picture p387: page 1]
