povdoigt/SP-02/PMI/repport/figures/SP02_ALPHA_AF_BLOC_DRAW.pdf

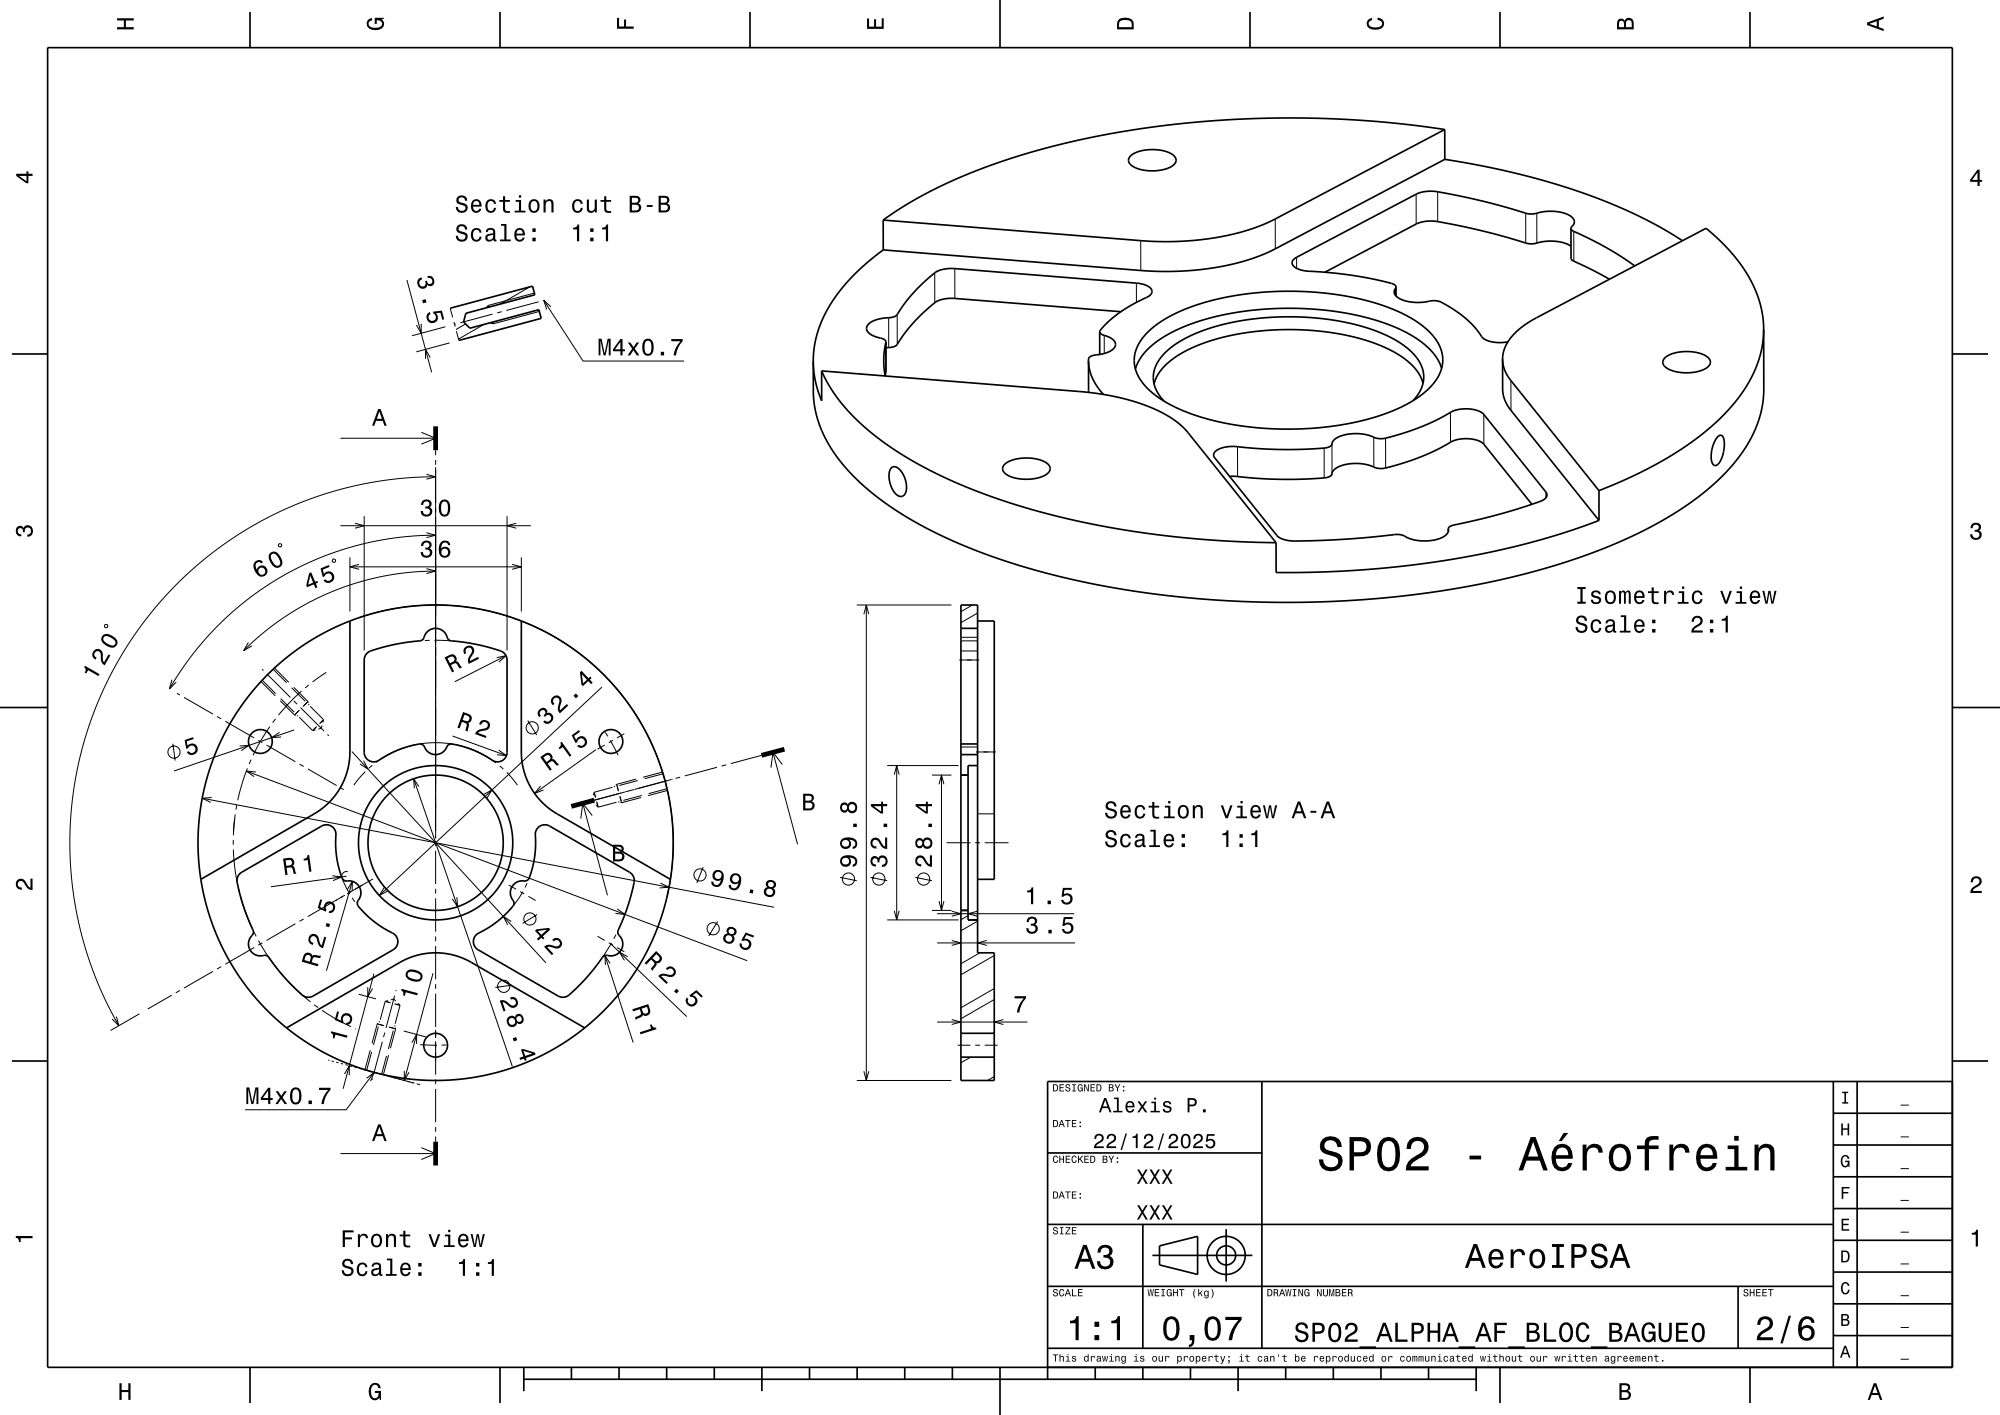
[picture p388: page 2]

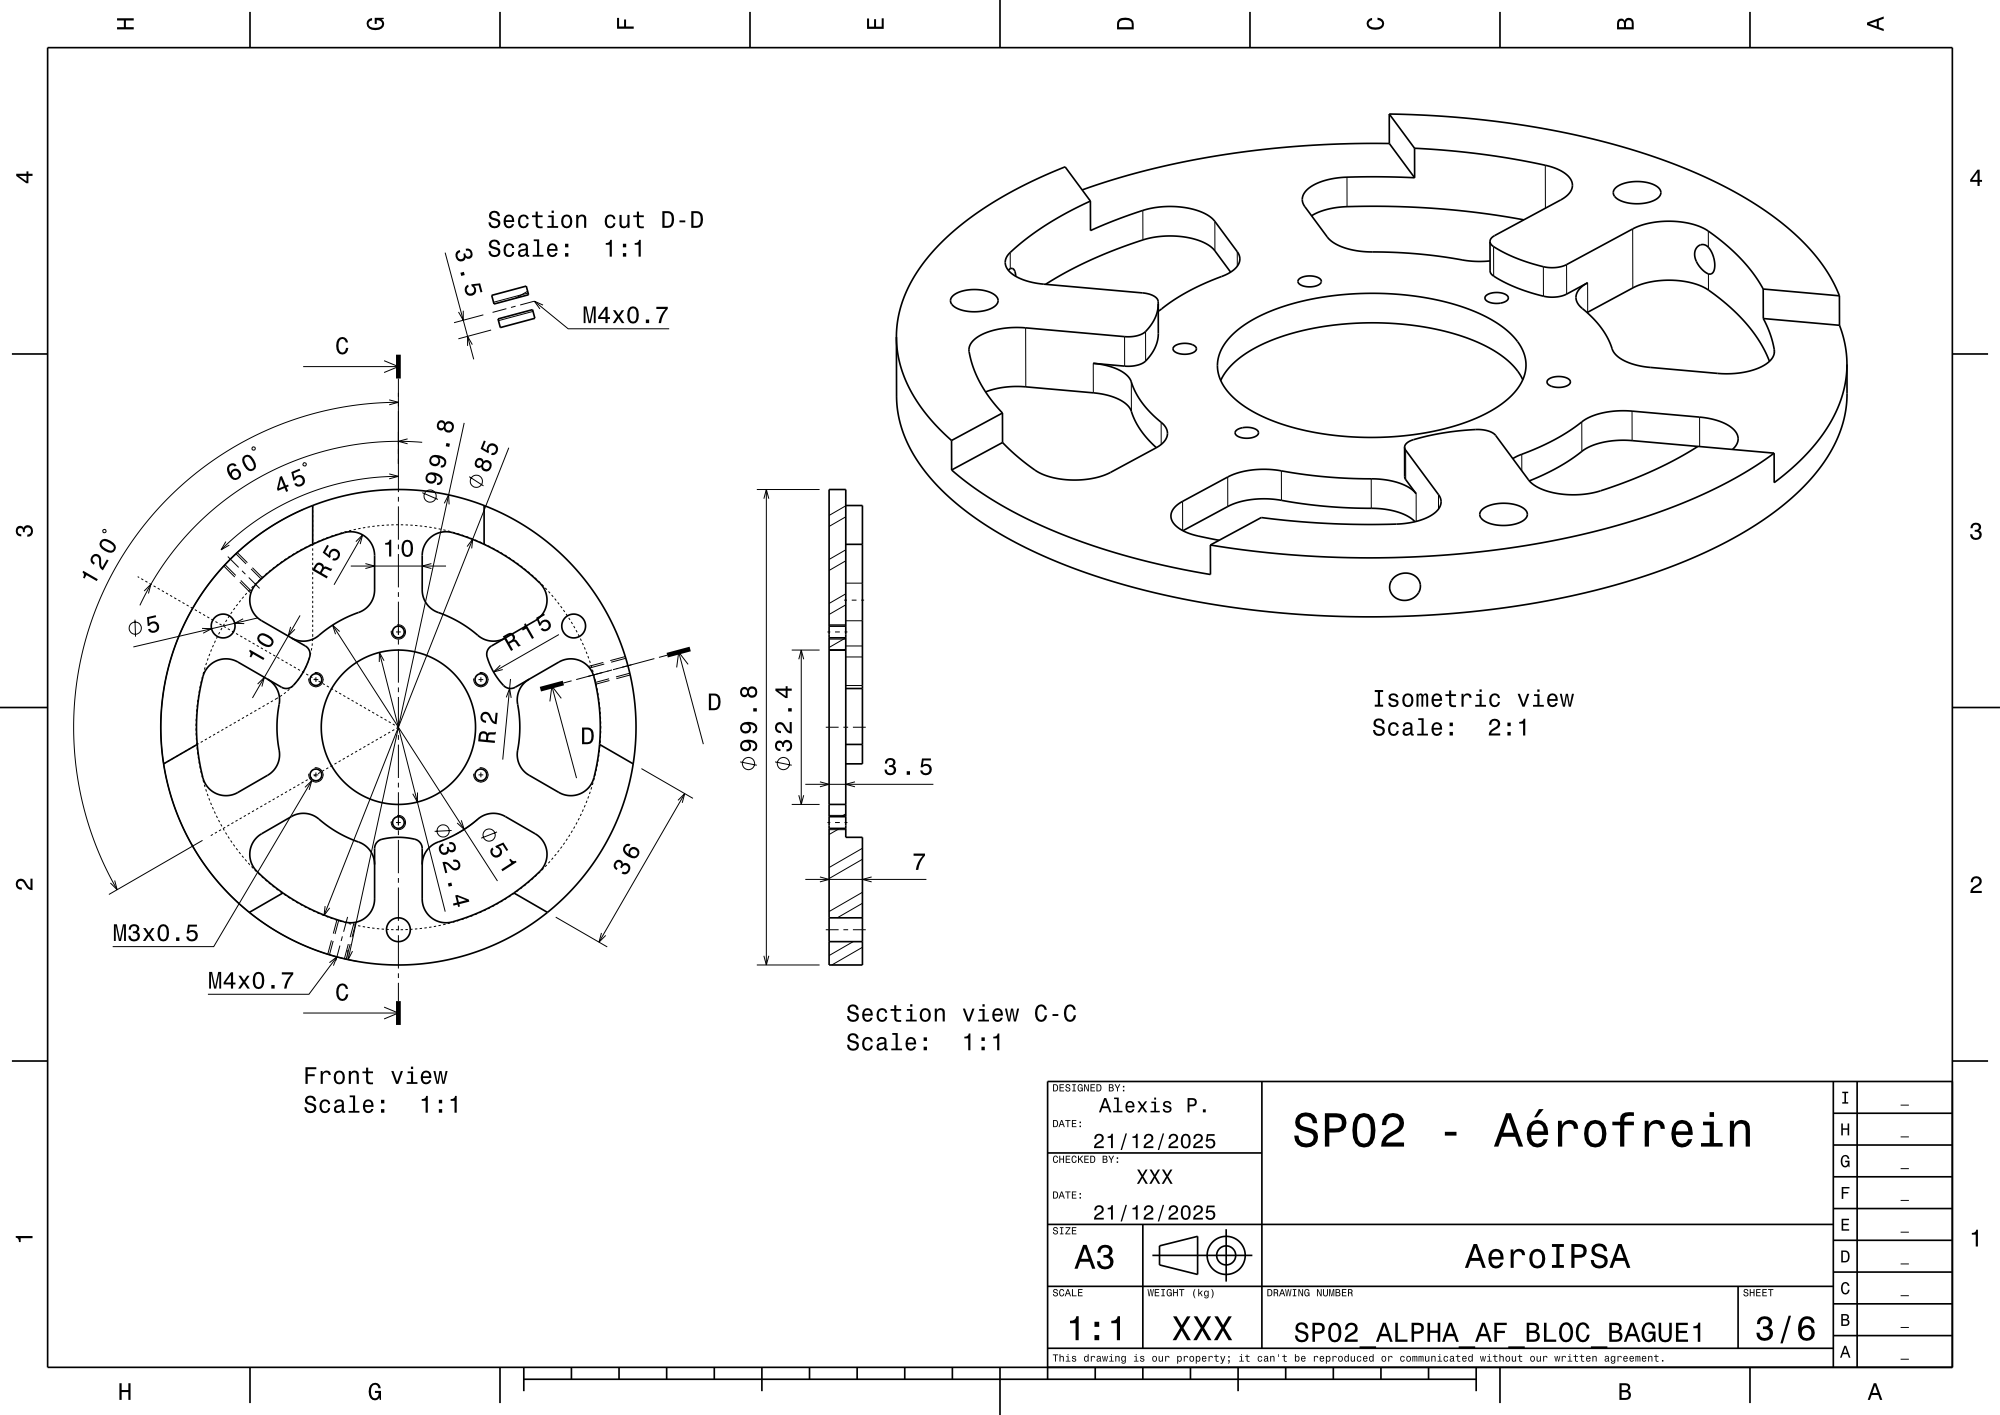
[picture p389: page 3]

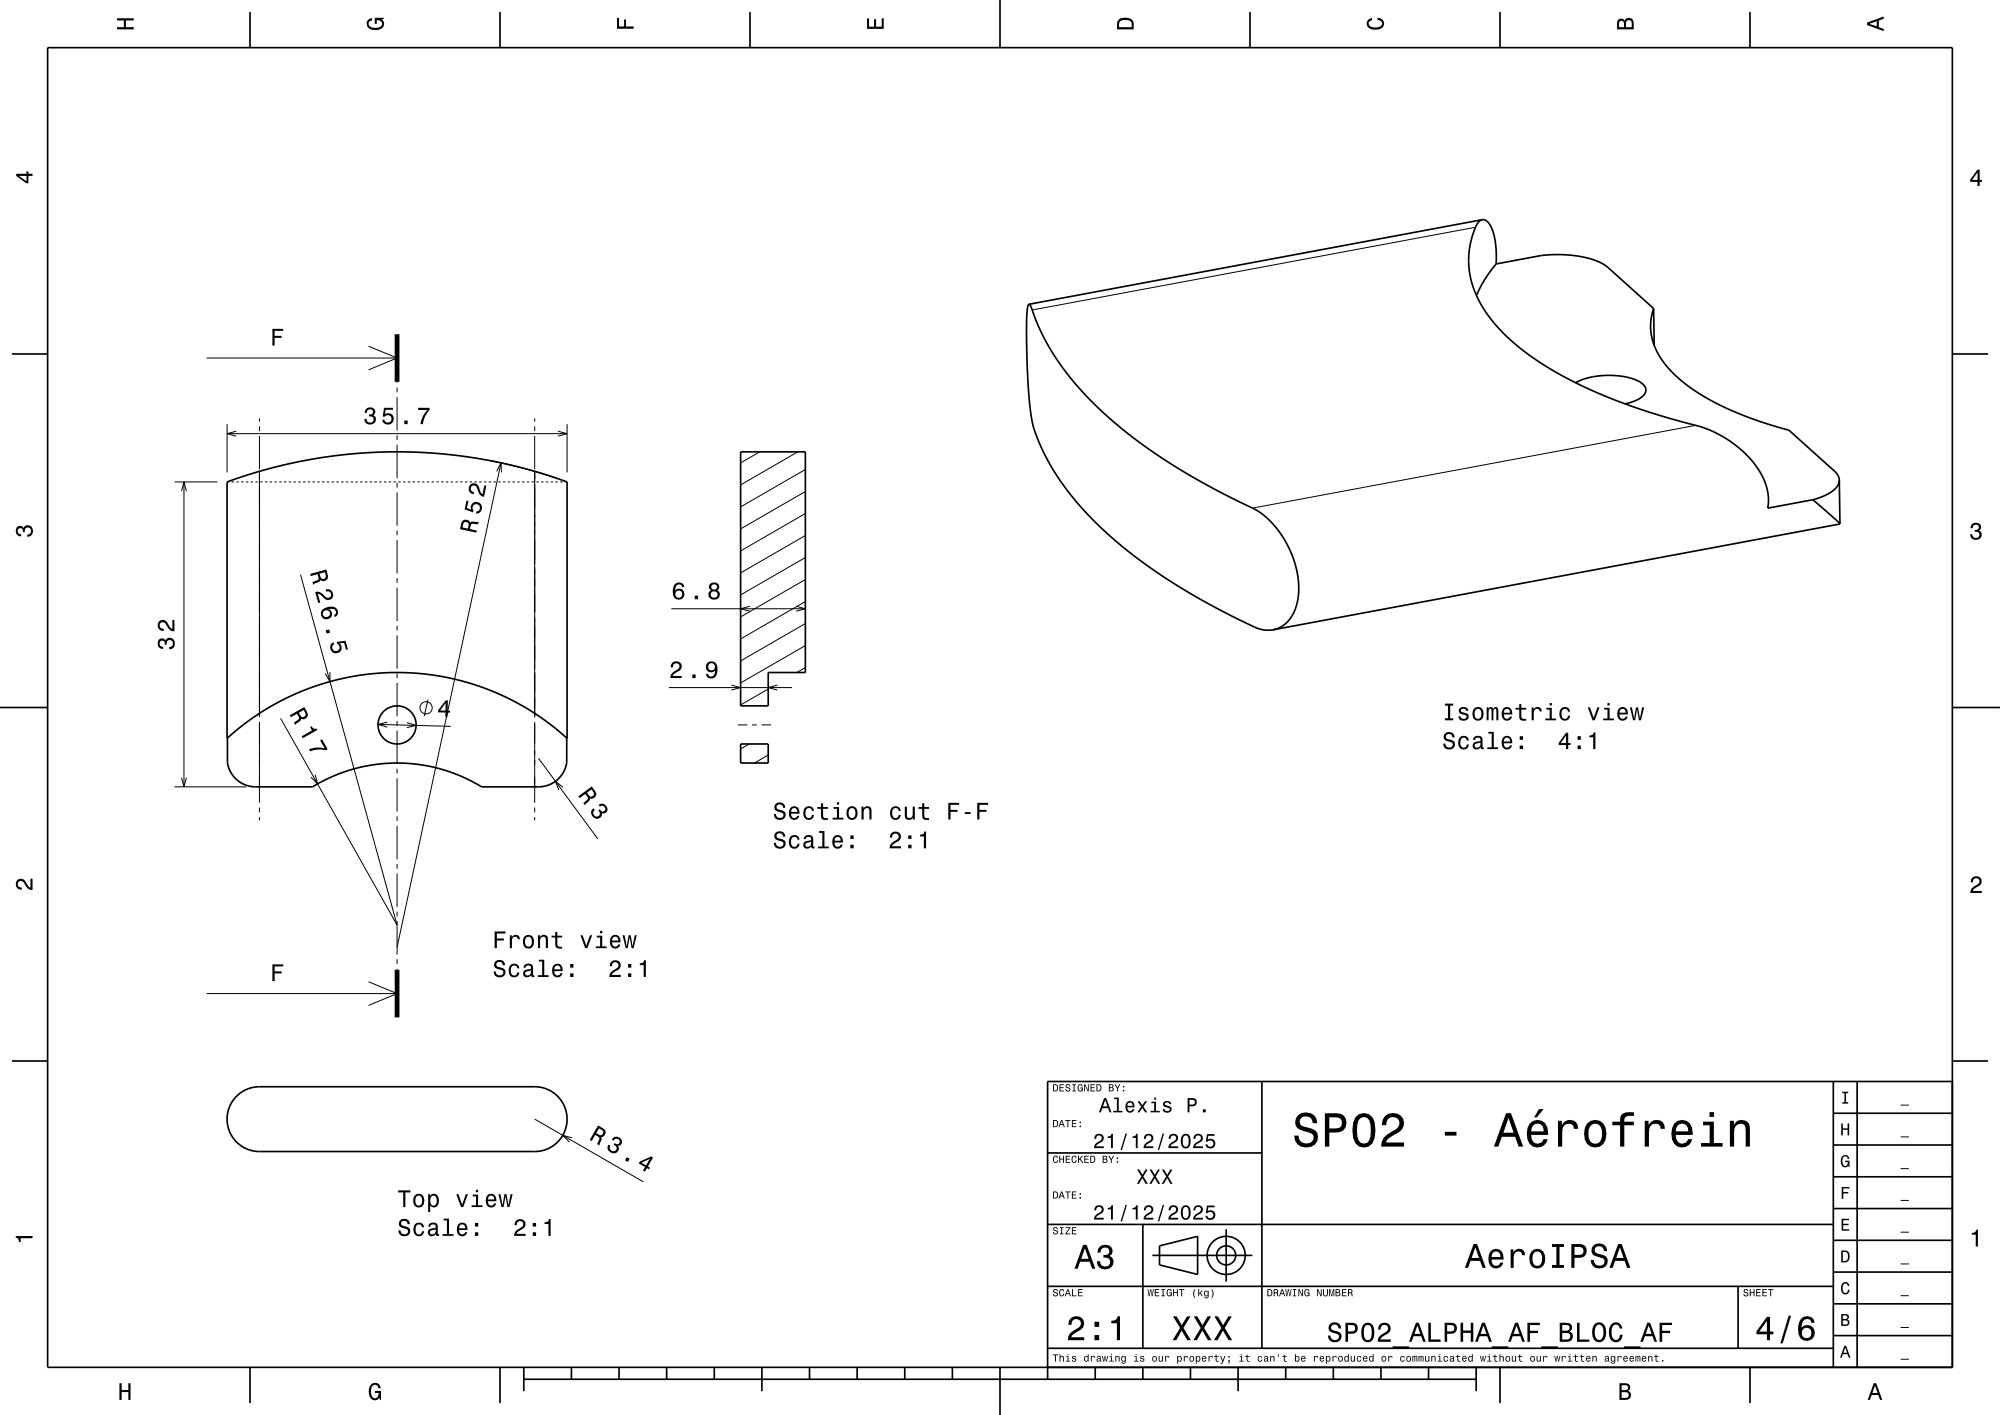
[picture p390: page 4]

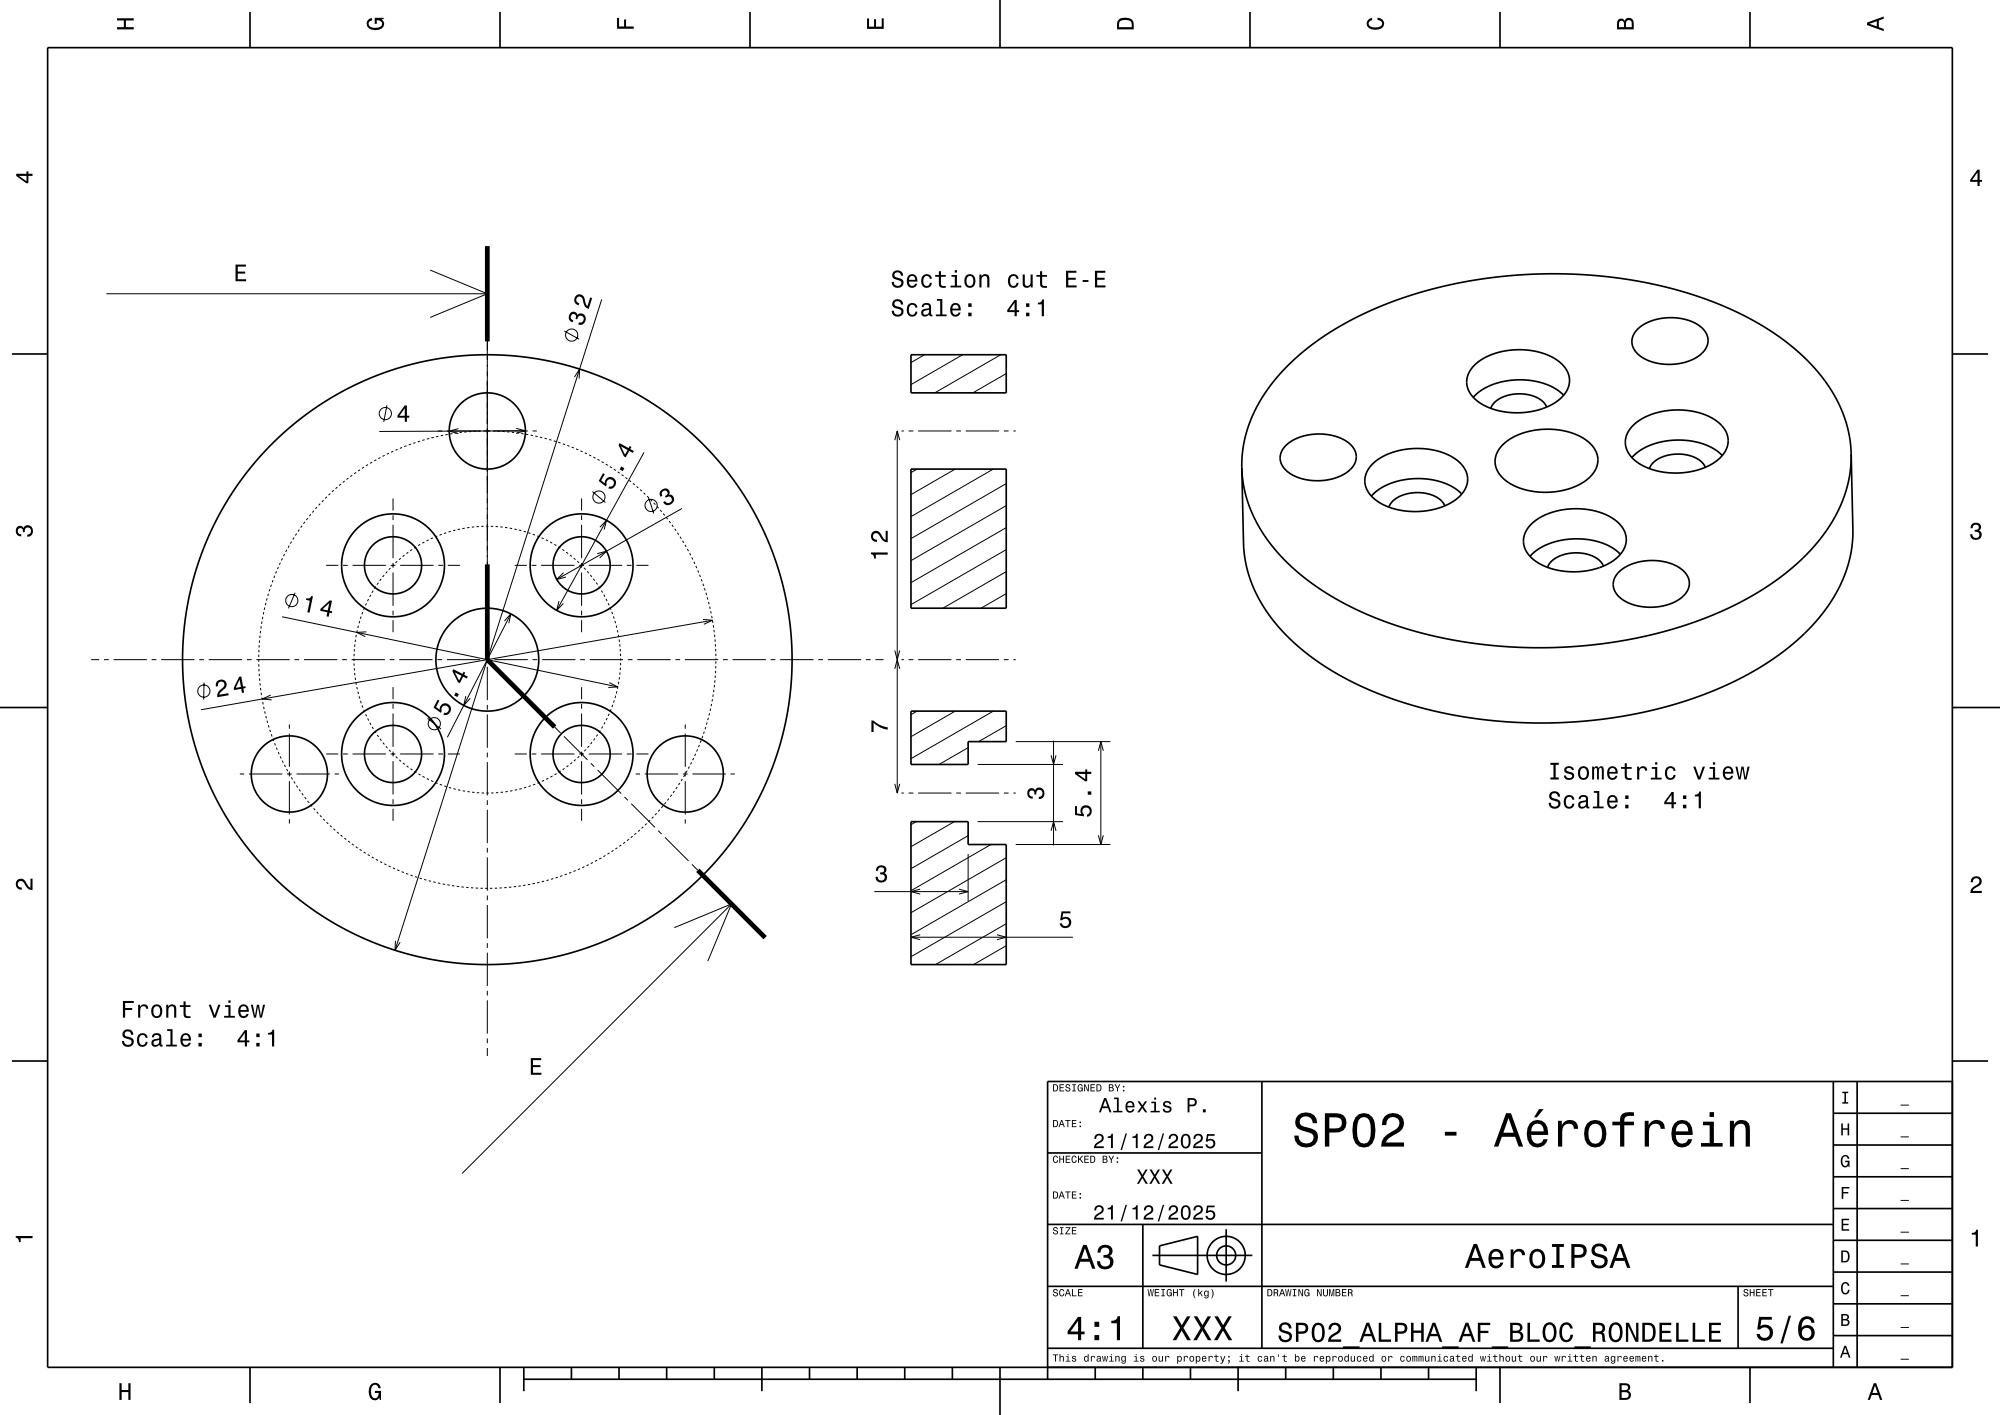
[picture p391: page 5]

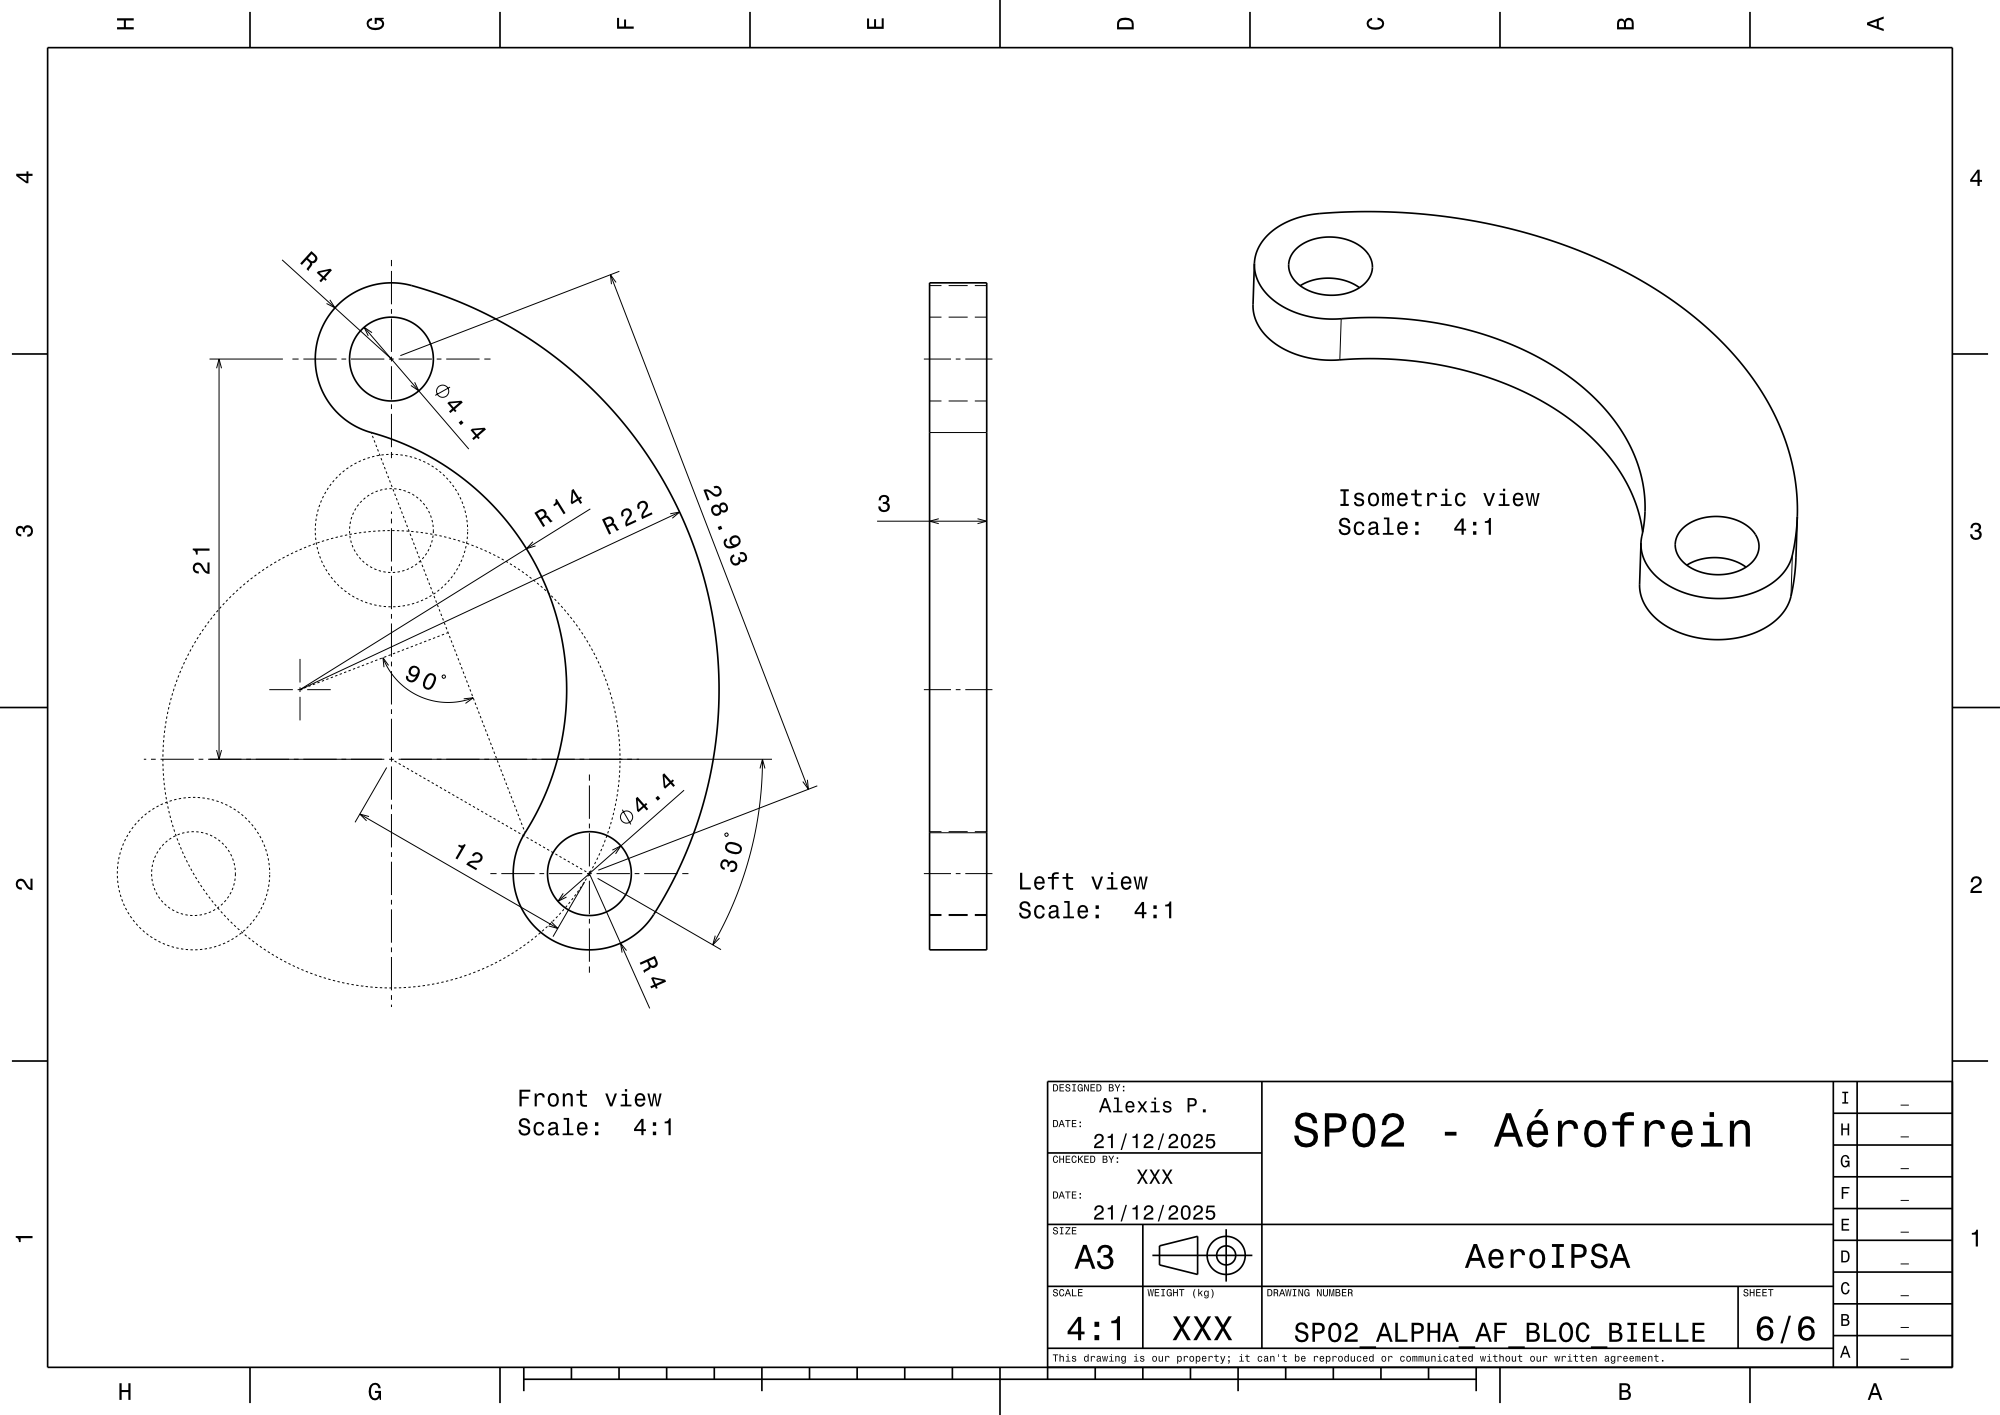
[picture p392: page 6]
