povdoigt/SP-02/(list of files, drawings)

Other design files:
CATIA/CATIA_vol/Carte_elec_finales/PCB_PCB_SP02_CAMERA_V3_2026-04-20.json
