povdoigt/SP-02/KODE/SEQUENCEUR/TEST1/Core/Src/usart.c

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
/* Includes ------------------------------------------------------------------*/
#include "usart.h"

/* USER CODE BEGIN 0 */

#include "STS.h"
#include "project.h"
// #include "WT901B.h"
// #include "event_uart.h"

/* USER CODE END 0 */

UART_HandleTypeDef huart1;
UART_HandleTypeDef huart2;
UART_HandleTypeDef huart3;
UART_HandleTypeDef huart4;
DMA_HandleTypeDef hdma_usart4_rx;
DMA_HandleTypeDef hdma_usart4_tx;

/* USART1 init function */

void MX_USART1_UART_Init(void)
{

  huart1.Instance = USART1;
  huart1.Init.BaudRate = 9600;
  huart1.Init.WordLength = UART_WORDLENGTH_8B;
  huart1.Init.StopBits = UART_STOPBITS_1;
  huart1.Init.Parity = UART_PARITY_NONE;
  huart1.Init.Mode = UART_MODE_TX_RX;
  huart1.Init.HwFlowCtl = UART_HWCONTROL_NONE;
  huart1.Init.OverSampling = UART_OVERSAMPLING_16;
  huart1.Init.OneBitSampling = UART_ONE_BIT_SAMPLE_DISABLE;
  huart1.AdvancedInit.AdvFeatureInit = UART_ADVFEATURE_NO_INIT;
  if (HAL_UART_Init(&huart1) != HAL_OK)
  {
    Error_Handler();
  }
}
/* USART2 init function */

void MX_USART2_UART_Init(void)
{

  huart2.Instance = USART2;
  huart2.Init.BaudRate = 115200;
  huart2.Init.WordLength = UART_WORDLENGTH_8B;
  huart2.Init.StopBits = UART_STOPBITS_1;
  huart2.Init.Parity = UART_PARITY_NONE;
  huart2.Init.Mode = UART_MODE_TX_RX;
  huart2.Init.HwFlowCtl = UART_HWCONTROL_NONE;
  huart2.Init.OverSampling = UART_OVERSAMPLING_16;
  huart2.Init.OneBitSampling = UART_ONE_BIT_SAMPLE_DISABLE;
  huart2.AdvancedInit.AdvFeatureInit = UART_ADVFEATURE_NO_INIT;
  if (HAL_HalfDuplex_Init(&huart2) != HAL_OK)
  {
    Error_Handler();
  }
}
/* USART3 init function */

void MX_USART3_UART_Init(void)
{

  huart3.Instance = USART3;
  huart3.Init.BaudRate = 115200;
  huart3.Init.WordLength = UART_WORDLENGTH_8B;
  huart3.Init.StopBits = UART_STOPBITS_1;
  huart3.Init.Parity = UART_PARITY_NONE;
  huart3.Init.Mode = UART_MODE_TX_RX;
  huart3.Init.HwFlowCtl = UART_HWCONTROL_NONE;
  huart3.Init.OverSampling = UART_OVERSAMPLING_16;
  huart3.Init.OneBitSampling = UART_ONE_BIT_SAMPLE_DISABLE;
  huart3.AdvancedInit.AdvFeatureInit = UART_ADVFEATURE_NO_INIT;
  if (HAL_HalfDuplex_Init(&huart3) != HAL_OK)
  {
    Error_Handler();
  }
}
/* USART4 init function */

void MX_USART4_UART_Init(void)
{

  huart4.Instance = USART4;
  huart4.Init.BaudRate = 115200;
  huart4.Init.WordLength = UART_WORDLENGTH_8B;
  huart4.Init.StopBits = UART_STOPBITS_1;
  huart4.Init.Parity = UART_PARITY_NONE;
  huart4.Init.Mode = UART_MODE_TX_RX;
  huart4.Init.HwFlowCtl = UART_HWCONTROL_NONE;
  huart4.Init.OverSampling = UART_OVERSAMPLING_16;
  huart4.Init.OneBitSampling = UART_ONE_BIT_SAMPLE_DISABLE;
  huart4.AdvancedInit.AdvFeatureInit = UART_ADVFEATURE_SWAP_INIT;
  huart4.AdvancedInit.Swap = UART_ADVFEATURE_SWAP_ENABLE;
  if (HAL_UART_Init(&huart4) != HAL_OK)
  {
    Error_Handler();
  }
}

void HAL_UART_MspInit(UART_HandleTypeDef* uartHandle)
{

  GPIO_InitTypeDef GPIO_InitStruct = {0};
  if(uartHandle->Instance==USART1)
  {
    /* USART1 clock enable */
    __HAL_RCC_USART1_CLK_ENABLE();

    __HAL_RCC_GPIOB_CLK_ENABLE();
    /**USART1 GPIO Configuration
    PB6     ------> USART1_TX
    PB7     ------> USART1_RX
    */
    GPIO_InitStruct.Pin = RX_WT_Pin|TX_WT_Pin;
    GPIO_InitStruct.Mode = GPIO_MODE_AF_PP;
    GPIO_InitStruct.Pull = GPIO_NOPULL;
    GPIO_InitStruct.Speed = GPIO_SPEED_FREQ_HIGH;
    GPIO_InitStruct.Alternate = GPIO_AF0_USART1;
    HAL_GPIO_Init(GPIOB, &GPIO_InitStruct);

    /* USART1 interrupt Init */
    HAL_NVIC_SetPriority(USART1_IRQn, 0, 0);
    HAL_NVIC_EnableIRQ(USART1_IRQn);
  }
  else if(uartHandle->Instance==USART2)
  {
    /* USART2 clock enable */
    __HAL_RCC_USART2_CLK_ENABLE();

    __HAL_RCC_GPIOA_CLK_ENABLE();
    /**USART2 GPIO Configuration
    PA2     ------> USART2_TX
    */
    GPIO_InitStruct.Pin = DATA_SM2_Pin;
    GPIO_InitStruct.Mode = GPIO_MODE_AF_OD;
    GPIO_InitStruct.Pull = GPIO_PULLUP;
    GPIO_InitStruct.Speed = GPIO_SPEED_FREQ_HIGH;
    GPIO_InitStruct.Alternate = GPIO_AF1_USART2;
    HAL_GPIO_Init(DATA_SM2_GPIO_Port, &GPIO_InitStruct);

    /* USART2 interrupt Init */
    HAL_NVIC_SetPriority(USART2_IRQn, 0, 0);
    HAL_NVIC_EnableIRQ(USART2_IRQn);
  }
  else if(uartHandle->Instance==USART3)
  {
    /* USART3 clock enable */
    __HAL_RCC_USART3_CLK_ENABLE();

    __HAL_RCC_GPIOC_CLK_ENABLE();
    /**USART3 GPIO Configuration
    PC4     ------> USART3_TX
    */
    GPIO_InitStruct.Pin = DATA_SM1_Pin;
    GPIO_InitStruct.Mode = GPIO_MODE_AF_OD;
    GPIO_InitStruct.Pull = GPIO_PULLUP;
    GPIO_InitStruct.Speed = GPIO_SPEED_FREQ_HIGH;
    GPIO_InitStruct.Alternate = GPIO_AF1_USART3;
    HAL_GPIO_Init(DATA_SM1_GPIO_Port, &GPIO_InitStruct);

    /* USART3 interrupt Init */
    HAL_NVIC_SetPriority(USART3_4_IRQn, 0, 0);
    HAL_NVIC_EnableIRQ(USART3_4_IRQn);
  }
  else if(uartHandle->Instance==USART4)
  {
    /* USART4 clock enable */
    __HAL_RCC_USART4_CLK_ENABLE();

    __HAL_RCC_GPIOA_CLK_ENABLE();
    /**USART4 GPIO Configuration
    PA0     ------> USART4_TX
    PA1     ------> USART4_RX
    */
    GPIO_InitStruct.Pin = TX_OUT_Pin|RX_OUT_Pin;
    GPIO_InitStruct.Mode = GPIO_MODE_AF_PP;
    GPIO_InitStruct.Pull = GPIO_NOPULL;
    GPIO_InitStruct.Speed = GPIO_SPEED_FREQ_HIGH;
    GPIO_InitStruct.Alternate = GPIO_AF4_USART4;
    HAL_GPIO_Init(GPIOA, &GPIO_InitStruct);

    /* USART4 DMA Init */
    /* USART4_RX Init */
    hdma_usart4_rx.Instance = DMA1_Channel6;
    hdma_usart4_rx.Init.Direction = DMA_PERIPH_TO_MEMORY;
    hdma_usart4_rx.Init.PeriphInc = DMA_PINC_DISABLE;
    hdma_usart4_rx.Init.MemInc = DMA_MINC_ENABLE;
    hdma_usart4_rx.Init.PeriphDataAlignment = DMA_PDATAALIGN_BYTE;
    hdma_usart4_rx.Init.MemDataAlignment = DMA_MDATAALIGN_BYTE;
    hdma_usart4_rx.Init.Mode = DMA_CIRCULAR;
    hdma_usart4_rx.Init.Priority = DMA_PRIORITY_LOW;
    if (HAL_DMA_Init(&hdma_usart4_rx) != HAL_OK)
    {
      Error_Handler();
    }

    __HAL_LINKDMA(uartHandle,hdmarx,hdma_usart4_rx);

    /* USART4_TX Init */
    hdma_usart4_tx.Instance = DMA1_Channel7;
    hdma_usart4_tx.Init.Direction = DMA_MEMORY_TO_PERIPH;
    hdma_usart4_tx.Init.PeriphInc = DMA_PINC_DISABLE;
    hdma_usart4_tx.Init.MemInc = DMA_MINC_ENABLE;
    hdma_usart4_tx.Init.PeriphDataAlignment = DMA_PDATAALIGN_BYTE;
    hdma_usart4_tx.Init.MemDataAlignment = DMA_MDATAALIGN_BYTE;
    hdma_usart4_tx.Init.Mode = DMA_CIRCULAR;
    hdma_usart4_tx.Init.Priority = DMA_PRIORITY_LOW;
    if (HAL_DMA_Init(&hdma_usart4_tx) != HAL_OK)
    {
      Error_Handler();
    }

    __HAL_LINKDMA(uartHandle,hdmatx,hdma_usart4_tx);

    /* USART4 interrupt Init */
    HAL_NVIC_SetPriority(USART3_4_IRQn, 0, 0);
    HAL_NVIC_EnableIRQ(USART3_4_IRQn);
  }
}

void HAL_UART_MspDeInit(UART_HandleTypeDef* uartHandle)
{

  if(uartHandle->Instance==USART1)
  {
    /* Peripheral clock disable */
    __HAL_RCC_USART1_CLK_DISABLE();

    /**USART1 GPIO Configuration
    PB6     ------> USART1_TX
    PB7     ------> USART1_RX
    */
    HAL_GPIO_DeInit(GPIOB, RX_WT_Pin|TX_WT_Pin);

    /* USART1 interrupt Deinit */
    HAL_NVIC_DisableIRQ(USART1_IRQn);
  }
  else if(uartHandle->Instance==USART2)
  {
    /* Peripheral clock disable */
    __HAL_RCC_USART2_CLK_DISABLE();

    /**USART2 GPIO Configuration
    PA2     ------> USART2_TX
    */
    HAL_GPIO_DeInit(DATA_SM2_GPIO_Port, DATA_SM2_Pin);

    /* USART2 interrupt Deinit */
    HAL_NVIC_DisableIRQ(USART2_IRQn);
  }
  else if(uartHandle->Instance==USART3)
  {
    /* Peripheral clock disable */
    __HAL_RCC_USART3_CLK_DISABLE();

    /**USART3 GPIO Configuration
    PC4     ------> USART3_TX
    */
    HAL_GPIO_DeInit(DATA_SM1_GPIO_Port, DATA_SM1_Pin);

    /* USART3 interrupt Deinit */
  /* USER CODE BEGIN USART3:USART3_4_IRQn disable */
    /**
    * Uncomment the line below to disable the "USART3_4_IRQn" interrupt
    * Be aware, disabling shared interrupt may affect other IPs
    */
    /* HAL_NVIC_DisableIRQ(USART3_4_IRQn); */
  /* USER CODE END USART3:USART3_4_IRQn disable */

  }
  else if(uartHandle->Instance==USART4)
  {
    /* Peripheral clock disable */
    __HAL_RCC_USART4_CLK_DISABLE();

    /**USART4 GPIO Configuration
    PA0     ------> USART4_TX
    PA1     ------> USART4_RX
    */
    HAL_GPIO_DeInit(GPIOA, TX_OUT_Pin|RX_OUT_Pin);

    /* USART4 DMA DeInit */
    HAL_DMA_DeInit(uartHandle->hdmarx);
    HAL_DMA_DeInit(uartHandle->hdmatx);

    /* USART4 interrupt Deinit */
  /* USER CODE BEGIN USART4:USART3_4_IRQn disable */
    /**
    * Uncomment the line below to disable the "USART3_4_IRQn" interrupt
    * Be aware, disabling shared interrupt may affect other IPs
    */
    /* HAL_NVIC_DisableIRQ(USART3_4_IRQn); */
  /* USER CODE END USART4:USART3_4_IRQn disable */

  }
}

/* USER CODE BEGIN 1 */

#ifdef USART1
  UART_buffer_t uart_buffer_1 = { 0 };
#endif
#ifdef USART2
  UART_buffer_t uart_buffer_2 = { 0 };
#endif
#ifdef USART3
  UART_buffer_t uart_buffer_3 = { 0 };
#endif
#ifdef USART4
  UART_buffer_t uart_buffer_4 = { 0 };
#endif
#ifdef USART5
  UART_buffer_t uart_buffer_5 = { 0 };
#endif

void UART_get_buffer(UART_HandleTypeDef *huart, UART_buffer_t **buffer_obj_ptr) {
#ifdef USART1
  if (huart->Instance == USART1) {
    *buffer_obj_ptr = &uart_buffer_1;
  } else
#endif
#ifdef USART2
  if (huart->Instance == USART2) {
    *buffer_obj_ptr = &uart_buffer_2;
  } else
#endif
#ifdef USART3
  if (huart->Instance == USART3) {
    *buffer_obj_ptr = &uart_buffer_3;
  } else
#endif
#ifdef USART4
  if (huart->Instance == USART4) {
    *buffer_obj_ptr = &uart_buffer_4;
  } else
#endif
#ifdef USART5
  if (huart->Instance == USART5) {
    *buffer_obj_ptr = &uart_buffer_5;
  } else
#endif
  {
    *buffer_obj_ptr = NULL; // Unknown USART instance
  }
}


void HAL_UARTEx_RxEventCallback(UART_HandleTypeDef *huart, uint16_t Size) {

  if (huart_sts_port1.huart == huart) {
    STS_UART_Port_Callback_RX_IRQHandler(&huart_sts_port1, Size);
  }

  if (huart_sts_port2.huart == huart) {
    STS_UART_Port_Callback_RX_IRQHandler(&huart_sts_port2, Size);
  }

  // if (wt901b.huart == huart) {
  //   HAL_UART_AbortReceive_IT(huart);
  //   // HAL_UART_Abort_IT(huart); // Dont work if not aborted for some reason...
  //   WT901B_UART_Callback_RX_IRQHandler(&wt901b, Size);
  // }

  // if (event_uart_producer.huart == huart) {
  //   // HAL_UART_AbortReceive_IT(huart);
  //   event_uart_callback();
  // }

  UART_buffer_t *buffer_obj;
  UART_get_buffer(huart, &buffer_obj);
  if (buffer_obj != NULL) {
    // HAL_UART_Transmit(&huart2, buffer_obj->rx_buffer, Size, HAL_MAX_DELAY); // Echo received data for debugging
    HAL_UARTEx_ReceiveToIdle_IT(huart, buffer_obj->rx_buffer, buffer_obj->rx_length);
  }
}

// void HAL_UART_RxCpltCallback(UART_HandleTypeDef *huart) {
//   if (huart->Instance == USART4) {
//     uart_apex_callback(); // Call the user-defined callback function for USART4 data reception
//   }
// }

/* USER CODE END 1 */
