povdoigt/SP-02/(commit log)

2025-10-19 Add all Alexis' files
    [ALPHA.CATPart, ALPHA.CATProduct, ALPHA_BAGUE_RAPPELLE.CATPart, ALPHA_BETA.CATProduct, ALPHA_PROPU.CATPart, ALPHA_SEPA.CATProduct, ALPHA_SEPA_BIELLE.CATPart, ALPHA_SEPA_BIELLE.stl]
2025-10-27 Ouiiii euhh j'm'appelle Malooooo euhhhh
    [alpha.xlsx, alpha_beta.xlsx, beta.xlsx, centre_masse.xlsx]
2025-10-27 Stabtraj mis à jour
    [alpha.xlsx, alpha_beta_actif.xlsx, alpha_beta_passif.xlsx, alpha_vol_actif.xlsx, alpha_vol_passif.xlsx, beta_actif.xlsx, beta_passif_moteur.xlsx, beta_passif_vide.xlsx]
2025-11-10 Update stabilito
    [alpha.xlsx, alpha_beta_actif.xlsx, alpha_beta_passif.xlsx, alpha_vol_actif.xlsx, alpha_vol_passif.xlsx, beta_actif.xlsx, beta_passif_moteur.xlsx, beta_passif_vide.xlsx]
2025-11-11 Baisse la qualité des images
2025-11-15 CATIA + rapport update
    [SP02.CATProduct, SP02_ALPHA.CATProduct, SP02_ALPHA_BAGUE_1.CATPart, SP02_ALPHA_RETREINT.CATPart, SP02_ALPHA_RETREINT.CATProduct, SP02_ALPHA_RETREINT_COMPLEMENT.CATPart, SP02_ALPHA_RETREINT_FIBRE.CATPart, SP02_ALPHA_TUBE.CATPart]
2025-11-15 Ajout des AF
    [SP02.CATProduct, SP02_ALPHA.CATProduct, SP02_ALPHA_AF_BLOC.CATProduct, SP02_ALPHA_AF_BLOC_AF.CATPart, SP02_ALPHA_AF_BLOC_BAGUE0.CATPart, SP02_ALPHA_AF_BLOC_BAGUE1.CATPart, SP02_ALPHA_AF_BLOC_BIELLE.CATPart, SP02_ALPHA_AF_BLOC_RONDELLE.CATPart]
2025-11-18 Update Alexis (AF + code servo)
    [SP02_ALPHA_AF_BLOC.CATProduct, SP02_ALPHA_AF_BLOC_AF.CATPart, SP02_ALPHA_AF_BLOC_AF.stp, SP02_ALPHA_AF_BLOC_BAGUE0.CATPart, SP02_ALPHA_AF_BLOC_BAGUE0.stp, SP02_ALPHA_AF_BLOC_BAGUE1.CATPart, SP02_ALPHA_AF_BLOC_BAGUE1.stp, SP02_ALPHA_AF_BLOC_BIELLE.CATPart]
2025-11-19 Assemblage assemblé en sous-assemblage
    (tkt la cavale aux Valaques avala l'eau du lac et l'eau du lac lava la cavale aux Valaques)
    [Bague centrale .CATPart, Bague centrale _1.CATPart, Bague exeterieur.CATPart, Billes.CATPart, Coiffe-Alpha.CATPart, Document.CATPart, Fabrication_retrein.CATProduct, Maintien-Pointe-Coiffe.CATPart]
2025-11-20 Update AF CATIA
    [SP02_ALPHA_AF_BLOC.CATProduct, SP02_ALPHA_AF_BLOC_AF.CATPart, SP02_ALPHA_AF_BLOC_AF.stp, SP02_ALPHA_AF_BLOC_BAGUE0.CATPart, SP02_ALPHA_AF_BLOC_RONDELLE.CATPart, SP02_ALPHA_AF_BLOC_RONDELLE.stp]
2025-11-20 ADD STM32 PROJECT
2025-11-20 Document sequencer architecture and functionality
    Added detailed description of the sequencers used in the SP-02 rocket, including hardware architecture, operational principles, and compliance with Fusex requirements.
2025-11-21 WORK ON STM32 KODE
2025-11-23 Quelques correction du document de suivit + travaille sur chap2
2025-11-25 Retournement de l'image
2025-11-25 dernier commit de la série méca
2025-11-25 quelques modif (AF catia + doc)
    [SP02_ALPHA_AF_BLOC.CATProduct, SP02_ALPHA_AF_BLOC_AF.CATPart, SP02_ALPHA_AF_BLOC_BAGUE0.CATPart, SP02_ALPHA_AF_BLOC_BAGUE1.CATPart, SP02_ALPHA_AF_BLOC_BIELLE.CATPart, SP02_ALPHA_AF_BLOC_RONDELLE.CATPart, ST3215_Servo.CATPart]
2025-11-26 Update bibliography, glossary, and various sections for SP-02 project report
    - Added new references for AéroIPSA and updated existing entries in biblio.bib.
    - Expanded glossary with definitions for Fusex, Minif, and Cansat.
    - Revised Introduction section to clarify project objectives and compliance with CDC.
    - Enhanced presentation of AéroIPSA and its activities in the generalities section.
    - Improved descriptions of recent projects influencing SP-02 in the experience feedback section.
    - Updated financing and partners section for clarity on budget contributions.
    - Refined safety analysis sections to align with CDC requirements and added detailed risk assessments.
    - Adjusted mechanical and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
2025-11-27 photo de doss changé
2025-11-29 encore une correction du dossier de def
2025-11-29 Update de la partie sur les aérofrein (ddf)
2025-11-30 DDF Ajout partie stabilite
    [alpha_beta_actif.xlsx, alpha_beta_passif.xlsx, alpha_vol_actif.xlsx, alpha_vol_passif.xlsx, beta_actif.xlsx, beta_passif_moteur.xlsx, beta_passif_vide.xlsx]
2025-11-30 ajout des nom + titre change
2025-12-07 Update du code du servomoteur
2025-12-17 update code + catia_AF + stabtraj + openrocket
    [SP02_ALPHA_AF_BLOC.CATProduct, SP02_ALPHA_AF_BLOC.stp, SP02_ALPHA_AF_BLOC_AF.CATPart, SP02_ALPHA_AF_BLOC_BAGUE0.CATPart, SP02_ALPHA_AF_BLOC_RONDELLE.CATPart, alpha_beta_actif.xlsx, beta_actif.xlsx]
2025-12-25 Bcp de changement en CATIA (new_catia) pour les AF + le KODE du servomoteur + OpenRocket et Stabtraj et l'ajout du document de suiit dans le rapport de PMI.
    [SP02_ALPHA_AF_BLOC.CATProduct, SP02_ALPHA_AF_BLOC_AF.CATPart, SP02_ALPHA_AF_BLOC_BAGUE0.CATPart, SP02_ALPHA_AF_BLOC_BAGUE1.CATPart, SP02_ALPHA_AF_BLOC_BIELLE.CATPart, SP02_ALPHA_AF_BLOC_RONDELLE.CATPart, alpha_beta_actif.xlsx, beta_actif.xlsx]
2025-12-25 Schéma des af en rouge
2026-01-10 Update CATIA models and STEP files, add code.c
    Updated several CATIA part, product, and drawing files. Deleted obsolete STEP and PDF files, updated multiple STEP files, and added a new empty code.c file.
    [SP02_ALPHA_AF_BLOC.CATProduct, SP02_ALPHA_AF_BLOC.stp, SP02_ALPHA_AF_BLOC_AF.CATPart, SP02_ALPHA_AF_BLOC_AF.stp, SP02_ALPHA_AF_BLOC_BAGUE0.stp, SP02_ALPHA_AF_BLOC_BAGUE1.stp, SP02_ALPHA_AF_BLOC_BIELLE.stp, SP02_ALPHA_AF_BLOC_RONDELLE.stp]
2026-01-17 Update SP02_ALPHA_AF parts and add KR variants
    Modified several CATIA part and STEP files for SP02_ALPHA_AF, including geometry updates to BLOC_AF, BLOC_BIELLE, and BLOC_RONDELLE. Added new KR variant files (SP02_ALPHA_AF_BLOC_AF_KR.CATPart and .stp), a new support assembly, and updated the related PDF documentation.
    [Part1.CATPart, SP02_ALPHA_AF_BLOC_AF.CATPart, SP02_ALPHA_AF_BLOC_AF.stp, SP02_ALPHA_AF_BLOC_AF_KR.CATPart, SP02_ALPHA_AF_BLOC_AF_KR.stp, SP02_ALPHA_AF_BLOC_BIELLE.CATPart, SP02_ALPHA_AF_BLOC_BIELLE.stp, SP02_ALPHA_AF_BLOC_RONDELLE.CATPart]
2026-01-19 Ajout d'une nouvelle version du rapport de PMI
2026-01-20 Correction des termes "séparation à froide" et "séparation à chaude" dans le rapport PMI ET2
2026-01-24 DERNIERE LIGNE DROITE (1)
    [SP02_ALPHA_AF_BLOC_BIELLE.CATPart, SP02_ALPHA_AF_BLOC_RONDELLE.CATPart, SP02_ALPHA_AF_BLOC_RONDELLE.stp, bague1.CATPart, bague1.stp, bague2.CATPart, bague2.stp]
2026-02-28 big merge
    [Bague centrale _1.CATPart, Bague exeterieur.CATPart, Bague exeterieur_1.CATPart, Billes.CATPart, Billes_1.CATPart, Board~Of2H.CATPart, BottomCopper~Of2H.CATPart, BottomSilkscreen~Of2H.CATPart]
2026-03-22 Some change on catia
    [SP02_ALPHA_AF_BLOC_AF.stp, SP02_BETA5_SEPA2_PRINCIPALE v10002.CATPart, SP02_BETA5_SEPA2_PRINCIPALE v10002.stp]
2026-04-22 update uart and improve doc
2026-04-24 Ajout d'une photo de la carte condensateur
2026-05-04 Docs + maj stabtraj
    [alpha_beta_actif.xlsx, alpha_beta_passif.xlsx, alpha_vol_actif.xlsx, alpha_vol_passif.xlsx, beta_actif.xlsx, beta_passif_moteur.xlsx, beta_passif_vide.xlsx]
2026-05-09 update v3_38
    [alpha.xlsx, alpha_beta_actif.xlsx, alpha_beta_passif.xlsx, alpha_vol_actif.xlsx, alpha_vol_passif.xlsx, beta_actif.xlsx, beta_passif_moteur.xlsx, beta_passif_vide.xlsx]
2026-05-09 Refactor USART buffer definitions and update UART initialization in main.c; adjust project paths in CMakeLists.txt
2026-05-28 update uart 1 irq
2026-07-09 CATIA Version C'Space
    [2_Cellules_Li-ion.CATPart, 3D_PCB_PCB_SP02_APEX_EX_2026-04-20_2026-04-20.CATProduct, 3D_PCB_PCB_SP02_APEX_EX_2026-04-20_2026-04-20.step, 3D_PCB_PCB_SP02_Allumage_V2_2025-12-22_2025-12-22.step, 3D_PCB_PCB_SP02_IHF_2_V1_2026-04-19_2026-04-19.CATProduct, 3D_PCB_PCB_SP02_IHF_2_V1_2026-04-19_2026-04-19.step, 3D_PCB_PCB_SP02_sequenceur_Maxou_2026-04-19_2026-04-19.CATProduct, Alpha_Maintien_Cable_Cage.C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]
