povdoigt/SP-02/(notices)

Notices in the files:
KODE/SEQUENCEUR/TEST1/Core/Inc/usart.h:
Copyright (c) 2026 STMicroelectronics.
All rights reserved.
This software is licensed under terms that can be found in the LICENSE file
KODE/STM32_TEST/Core/Src/main.c:
Copyright (c) 2025 STMicroelectronics.
PMI/repport_FinalVersion/PMI_ET2_rapport.pdf:
Figure 1.5 – Décollage d’une fusée expérimentale au C’Space 2024. ©CNES/C’Space/Thomas Labois
1.5 Décollage d’une fusée expérimentale au C’Space 2024. ©CNES/C’Space/Thomas Labois . | 15
